Jonathon-Reilly/Kicad/README.md

# Basic Kicad Electronis Development Folder

This git repository contains a collection of information, tools and part librarys for setting up a basic PCB development envoirment
 using the open source EDA KiCad.

It includes content of official repositorys, personal creations as well as third party librarys.

My Content is licenced under the GPL V3.

All included or imported content is subject to its resprective licencing.
