Jonathon-Reilly/Kicad/kicad-resources/kicad-librarys/README.md

# Kicad-Librarys
**************

This Folder contains all library subfolders for symbols,footprints and 3D modells both user created and official kicad repository.

Official repository folders are name kicad-* and are added in via git submodule.

User created libray folders  are simply named for the resprective content (symbols,footprint,3D,templates).

Library folders of third partys are preceeded by the third partys name.
