Jonathon-Reilly/Kicad/kicad-resources/kicad-tools/eagle-to-kicad/examples/OLINUXINO/A10-A20-OLINUXINO-MICRO-4GB_Rev_D/kicad_files/report.txt

Info: Reading netlist file "/home/laudas/eagle/eagle-lbr2kicad/examples/OLINUXINO/A10-A20-OLINUXINO-MICRO-4GB_Rev_D/kicad_files/A10-A20-OLINUXINO-MICRO-4GB_Rev_D.net".

Info: Using references to match components and footprints.

* Warning: component 'VP_52': board footprint 'VPAC4', netlist footprint 'VPAD_VPAC4'

* Warning: component 'VP_53': board footprint 'VPAC3', netlist footprint 'VPAD_VPAC3'

* Warning: component 'VP_51': board footprint 'VPAC3', netlist footprint 'VPAD_VPAC3'

* Warning: component 'VP_50': board footprint 'VPAC3', netlist footprint 'VPAD_VPAC3'

* Warning: component 'VP_43': board footprint 'VPAC2', netlist footprint 'VPAD_VPAC2'

* Warning: component 'VP_8': board footprint 'VPAC1', netlist footprint 'VPAD_VPAC1'

* Warning: component 'VP_35': board footprint 'VPAC1', netlist footprint 'VPAD_VPAC1'

* Warning: component 'VP_17': board footprint 'VPAC1', netlist footprint 'VPAD_VPAC1'

* Warning: component 'VP_26': board footprint 'VPAC1', netlist footprint 'VPAD_VPAC1'

* Warning: component 'VP_29': board footprint 'VPAC0', netlist footprint 'VPAD_VPAC0'

* Warning: component 'VP_22': board footprint 'VPAC0', netlist footprint 'VPAD_VPAC0'

* Warning: component 'VP_23': board footprint 'VPAC0', netlist footprint 'VPAD_VPAC0'

* Warning: component 'VP_24': board footprint 'VPAC0', netlist footprint 'VPAD_VPAC0'

* Warning: component 'VP_25': board footprint 'VPAC0', netlist footprint 'VPAD_VPAC0'

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

* Warning: component 'FET2': board footprint 'SOT23', netlist footprint 'PENKO_SOT23'

* Warning: component 'FET3': board footprint 'SOT23', netlist footprint 'PENKO_SOT23'

* Warning: component 'FET4': board footprint 'SOT23', netlist footprint 'PENKO_SOT23'

* Warning: component 'UART0': board footprint 'HN1X4', netlist footprint 'PENKO_HN1X4'

* Warning: component '5V_PWR233': board footprint 'DW02S', netlist footprint 'PENKO_DW02S'

* Warning: component '5V_SATA_PWR233': board footprint 'DW02S', netlist footprint 'PENKO_DW02S'

* Warning: component 'LIPO_BAT233': board footprint 'DW02R', netlist footprint 'PENKO_DW02R'

* Warning: component 'U8': board footprint 'TSOP48', netlist footprint 'OLIMEX_IC_TSOP48'

* Warning: component 'U1': board footprint 'TFBGA441', netlist footprint 'OLIMEX_IC_TFBGA441'

* Warning: component 'U16': board footprint 'SOT23-6', netlist footprint 'OLIMEX_IC_SOT23-6'

* Warning: component 'U15': board footprint 'SOT23-5', netlist footprint 'OLIMEX_IC_SOT23-5'

* Warning: component 'U13': board footprint 'SOT23-5', netlist footprint 'OLIMEX_IC_SOT23-5'

* Warning: component 'U11': board footprint 'SOT23-5', netlist footprint 'OLIMEX_IC_SOT23-5'

* Warning: component 'U10': board footprint 'SOT23-5', netlist footprint 'OLIMEX_IC_SOT23-5'

* Warning: component 'U9': board footprint 'SOT23-5', netlist footprint 'OLIMEX_IC_SOT23-5'

* Warning: component 'U14': board footprint 'SOIC8', netlist footprint 'OLIMEX_IC_SOIC8'

* Warning: component 'U22': board footprint 'SLP2510P8', netlist footprint 'OLIMEX_IC_SLP2510P8'

* Warning: component 'U17': board footprint 'SLP2510P8', netlist footprint 'OLIMEX_IC_SLP2510P8'

* Warning: component 'U23': board footprint 'SLP2510P8', netlist footprint 'OLIMEX_IC_SLP2510P8'

* Warning: component 'U12': board footprint 'QFN48', netlist footprint 'OLIMEX_IC_QFN48'

* Warning: component 'U7': board footprint 'LQFP48', netlist footprint 'OLIMEX_IC_LQFP48'

* Warning: component 'U3': board footprint 'FBGA96_MEM', netlist footprint 'OLIMEX_IC_FBGA96_MEM'

* Warning: component 'U2': board footprint 'FBGA96_MEM', netlist footprint 'OLIMEX_IC_FBGA96_MEM'

* Warning: component 'VR1': board footprint 'SOT-23-5', netlist footprint 'OLIMEX_DISCRET_SOT-23-5'

* Warning: component 'RM4': board footprint 'R_MATRIX_4_0402_25X625', netlist footprint 'OLIMEX_DISCRET_R_MATRIX_4_0402_25X625'

* Warning: component 'RM5': board footprint 'R_MATRIX_4_0402_25X625', netlist footprint 'OLIMEX_DISCRET_R_MATRIX_4_0402_25X625'

* Warning: component 'RM6': board footprint 'R_MATRIX_4_0402_25X625', netlist footprint 'OLIMEX_DISCRET_R_MATRIX_4_0402_25X625'

* Warning: component 'RM7': board footprint 'R_MATRIX_4_0402_25X625', netlist footprint 'OLIMEX_DISCRET_R_MATRIX_4_0402_25X625'

* Warning: component 'RM8': board footprint 'R_MATRIX_4_0402_25X625', netlist footprint 'OLIMEX_DISCRET_R_MATRIX_4_0402_25X625'

* Warning: component 'RM19': board footprint 'R_MATRIX_4_0402_25X625', netlist footprint 'OLIMEX_DISCRET_R_MATRIX_4_0402_25X625'

* Warning: component 'RM3': board footprint 'R_MATRIX_4_0402_25X625', netlist footprint 'OLIMEX_DISCRET_R_MATRIX_4_0402_25X625'

* Warning: component 'RM2': board footprint 'R_MATRIX_4_0402_25X625', netlist footprint 'OLIMEX_DISCRET_R_MATRIX_4_0402_25X625'

* Warning: component 'RM16': board footprint 'R_MATRIX_4_0402_25X625', netlist footprint 'OLIMEX_DISCRET_R_MATRIX_4_0402_25X625'

* Warning: component 'RM17': board footprint 'R_MATRIX_4_0402_25X625', netlist footprint 'OLIMEX_DISCRET_R_MATRIX_4_0402_25X625'

* Warning: component 'RM18': board footprint 'R_MATRIX_4_0402_25X625', netlist footprint 'OLIMEX_DISCRET_R_MATRIX_4_0402_25X625'

* Warning: component 'RM1': board footprint 'R_MATRIX_4_0402_25X625', netlist footprint 'OLIMEX_DISCRET_R_MATRIX_4_0402_25X625'

* Warning: component 'RM21': board footprint 'R_MATRIX_4_0402_25X625', netlist footprint 'OLIMEX_DISCRET_R_MATRIX_4_0402_25X625'

* Warning: component 'RM20': board footprint 'R_MATRIX_4_0402_25X625', netlist footprint 'OLIMEX_DISCRET_R_MATRIX_4_0402_25X625'

* Warning: component 'RM9': board footprint 'R_MATRIX_4', netlist footprint 'OLIMEX_DISCRET_R_MATRIX_4'

* Warning: component 'RM10': board footprint 'R_MATRIX_4', netlist footprint 'OLIMEX_DISCRET_R_MATRIX_4'

* Warning: component 'RM13': board footprint 'R_MATRIX_4', netlist footprint 'OLIMEX_DISCRET_R_MATRIX_4'

* Warning: component 'RM14': board footprint 'R_MATRIX_4', netlist footprint 'OLIMEX_DISCRET_R_MATRIX_4'

* Warning: component 'RM15': board footprint 'R_MATRIX_4', netlist footprint 'OLIMEX_DISCRET_R_MATRIX_4'

* Warning: component 'RM25': board footprint 'R_MATRIX_4', netlist footprint 'OLIMEX_DISCRET_R_MATRIX_4'

* Warning: component 'RM24': board footprint 'R_MATRIX_4', netlist footprint 'OLIMEX_DISCRET_R_MATRIX_4'

* Warning: component 'D5': board footprint 'DO214AA', netlist footprint 'OLIMEX_DISCRET_DO214AA'

* Warning: component 'L13': board footprint 'CD32', netlist footprint 'OLIMEX_DISCRET_CD32'

* Warning: component 'L21': board footprint 'CD32', netlist footprint 'OLIMEX_DISCRET_CD32'

* Warning: component 'L20': board footprint 'CD32', netlist footprint 'OLIMEX_DISCRET_CD32'

* Warning: component 'L18': board footprint 'CD32', netlist footprint 'OLIMEX_DISCRET_CD32'

* Warning: component 'L14': board footprint 'CD32', netlist footprint 'OLIMEX_DISCRET_CD32'

* Warning: component 'L12': board footprint 'CD32', netlist footprint 'OLIMEX_DISCRET_CD32'

* Warning: component 'L19': board footprint '8X8MM_3131', netlist footprint 'OLIMEX_DISCRET_8X8MM_3131'

* Warning: component 'R24': board footprint '0603_0R', netlist footprint 'OLIMEX_DISCRET_0603_0R'

* Warning: component 'R34': board footprint '0603_0R', netlist footprint 'OLIMEX_DISCRET_0603_0R'

* Warning: component 'R69': board footprint '0603_0R', netlist footprint 'OLIMEX_DISCRET_0603_0R'

* Warning: component 'R87': board footprint '0603_0R', netlist footprint 'OLIMEX_DISCRET_0603_0R'

* Warning: component 'USB_HOST233': board footprint 'USB_TWO_LEVEL', netlist footprint 'OLIMEX_CONNECTORS_USB_TWO_LEVEL'

* Warning: component 'USB_OTG233': board footprint 'USB_MINI_9PIN', netlist footprint 'OLIMEX_CONNECTORS_USB_MINI_9PIN'

* Warning: component 'SD/MMC1': board footprint 'TFC-WPAPR-08', netlist footprint 'OLIMEX_CONNECTORS_TFC-WPAPR-08'

* Warning: component 'SD/MMC2': board footprint 'SD_CARD', netlist footprint 'OLIMEX_CONNECTORS_SD_CARD'

* Warning: component 'SATA233': board footprint 'SATA-PWA-07', netlist footprint 'OLIMEX_CONNECTORS_SATA-PWA-07'

* Warning: component 'LAN233': board footprint 'RJLBC-060TC1_MILLING', netlist footprint 'OLIMEX_CONNECTORS_RJLBC-060TC1_MILLING'

* Warning: component 'HDMI233': board footprint 'HDMI-SWM-19', netlist footprint 'OLIMEX_CONNECTORS_HDMI-SWM-19'

* Warning: component 'NAND_E233': board footprint 'SJ_1_SMALLER_CLOSE_10MILS', netlist footprint 'JUMPER_SJ_1_SMALLER_CLOSE_10MILS'

* Warning: component '5V_E_SATA233': board footprint 'SJ_1_SMALLER', netlist footprint 'JUMPER_SJ_1_SMALLER'

* Warning: component 'VPS+233': board footprint 'SJ_1_SMALLER', netlist footprint 'JUMPER_SJ_1_SMALLER'

* Warning: component 'VPS-233': board footprint 'SJ_1_SMALLER', netlist footprint 'JUMPER_SJ_1_SMALLER'

* Warning: component '5V_E233': board footprint 'SJ_1_SMALLER', netlist footprint 'JUMPER_SJ_1_SMALLER'

* Warning: component 'MIC2': board footprint 'JP1', netlist footprint 'JUMPER_JP1'

* Warning: component 'GND_PIN233': board footprint 'TEST_PAD40%2f70%2fSQUARE', netlist footprint 'GOGO_TEST_PAD40_70_SQUARE'

* Warning: component 'GND233': board footprint 'TESTPAD_40-ROUND', netlist footprint 'GOGO_TESTPAD_40-ROUND'

* Warning: component '5VEXT233': board footprint 'TESTPAD_40-ROUND', netlist footprint 'GOGO_TESTPAD_40-ROUND'

* Warning: component 'IPSOUT233': board footprint 'TESTPAD_40-ROUND', netlist footprint 'GOGO_TESTPAD_40-ROUND'

* Warning: component '+5V233': board footprint 'TESTPAD_40-ROUND', netlist footprint 'GOGO_TESTPAD_40-ROUND'

* Warning: component '3.3V233': board footprint 'TESTPAD_40-ROUND', netlist footprint 'GOGO_TESTPAD_40-ROUND'

* Warning: component 'BAT233': board footprint 'TESTPAD_40-ROUND', netlist footprint 'GOGO_TESTPAD_40-ROUND'

* Warning: component '3.0VA233': board footprint 'TESTPAD_40-ROUND', netlist footprint 'GOGO_TESTPAD_40-ROUND'

* Warning: component '2.5V233': board footprint 'TESTPAD_40-ROUND', netlist footprint 'GOGO_TESTPAD_40-ROUND'

* Warning: component '1.5V233': board footprint 'TESTPAD_40-ROUND', netlist footprint 'GOGO_TESTPAD_40-ROUND'

* Warning: component '1.2V_INT233': board footprint 'TESTPAD_40-ROUND', netlist footprint 'GOGO_TESTPAD_40-ROUND'

* Warning: component '1.2V_CPU233': board footprint 'TESTPAD_40-ROUND', netlist footprint 'GOGO_TESTPAD_40-ROUND'

* Warning: component 'ODT1': board footprint 'TESTPAD_40-ROUND', netlist footprint 'GOGO_TESTPAD_40-ROUND'

* Warning: component 'SCKE1': board footprint 'TESTPAD_40-ROUND', netlist footprint 'GOGO_TESTPAD_40-ROUND'

* Warning: component 'ENTER233': board footprint 'SW_TAKT3X4', netlist footprint 'GOGO_SW_TAKT3X4'

* Warning: component 'MENU233': board footprint 'SW_TAKT3X4', netlist footprint 'GOGO_SW_TAKT3X4'

* Warning: component 'ESC233': board footprint 'SW_TAKT3X4', netlist footprint 'GOGO_SW_TAKT3X4'

* Warning: component 'PWR_BUT233': board footprint 'SW_TAKT3X4', netlist footprint 'GOGO_SW_TAKT3X4'

* Warning: component 'VOL+233': board footprint 'SW_TAKT3X4', netlist footprint 'GOGO_SW_TAKT3X4'

* Warning: component 'HOME233': board footprint 'SW_TAKT3X4', netlist footprint 'GOGO_SW_TAKT3X4'

* Warning: component 'VOL-233': board footprint 'SW_TAKT3X4', netlist footprint 'GOGO_SW_TAKT3X4'

* Warning: component 'SEARCH233': board footprint 'SW_TAKT3X4', netlist footprint 'GOGO_SW_TAKT3X4'

* Warning: component 'RESET233': board footprint 'SW_TAKT3X4', netlist footprint 'GOGO_SW_TAKT3X4'

* Warning: component 'RECOVERY233': board footprint 'SW_TAKT3X4', netlist footprint 'GOGO_SW_TAKT3X4'

* Warning: component 'D3': board footprint 'SOD-123', netlist footprint 'GOGO_SOD-123'

* Warning: component 'D1': board footprint 'SOD-123', netlist footprint 'GOGO_SOD-123'

* Warning: component 'U6': board footprint 'SO-08MN', netlist footprint 'GOGO_SO-08MN'

* Warning: component 'PWR233': board footprint 'PWR_JACK_UNI_MILLING', netlist footprint 'GOGO_PWR_JACK_UNI_MILLING'

* Warning: component 'HEADPHONES233': board footprint 'PJ-W47S-05D2-LF_5PIN_V2', netlist footprint 'GOGO_PJ-W47S-05D2-LF_5PIN_V2'

* Warning: component 'MIC_IN233': board footprint 'PJ-W47S-05D2-LF_5PIN_V2', netlist footprint 'GOGO_PJ-W47S-05D2-LF_5PIN_V2'

* Warning: component 'D4': board footprint 'MLL-41', netlist footprint 'GOGO_MLL-41'

* Warning: component 'FUSE1': board footprint '1206', netlist footprint 'GOGO_1206'

* Warning: component 'CHGLED233': board footprint 'LED-0603', netlist footprint 'DOUBLE-SIDE_LED-0603'

* Warning: component 'PWR_LED233': board footprint 'LED-0603', netlist footprint 'DOUBLE-SIDE_LED-0603'

* Warning: component 'LED1': board footprint 'LED-0603', netlist footprint 'DOUBLE-SIDE_LED-0603'

* Warning: component 'VGA233': board footprint 'CON1.27MM-6-SMALL_ICSP', netlist footprint 'DOUBLE-SIDE_CON1.27MM-6-SMALL_ICSP'

* Warning: component 'Q2': board footprint 'TC26H_3_REPAIR_SMD', netlist footprint 'CRYSTAL_TC26H_3_REPAIR_SMD'

* Warning: component 'Q3': board footprint 'HCX-4S', netlist footprint 'CRYSTAL_HCX-4S'

* Warning: component 'Q1': board footprint 'HCX-4S', netlist footprint 'CRYSTAL_HCX-4S'

* Warning: component 'LCD_CON233': board footprint 'ML40-MALE(GBH-254-SMT-40)', netlist footprint 'CON-HARTING-ML_ML40-MALE(GBH-254-SMT-40)'

* Warning: component 'GPIO-1': board footprint 'ML40-MALE(GBH-254-SMT-40)', netlist footprint 'CON-HARTING-ML_ML40-MALE(GBH-254-SMT-40)'

* Warning: component 'GPIO-2': board footprint 'ML40-MALE(GBH-254-SMT-40)', netlist footprint 'CON-HARTING-ML_ML40-MALE(GBH-254-SMT-40)'

* Warning: component 'GPIO-3': board footprint 'ML40-MALE(GBH-254-SMT-40)', netlist footprint 'CON-HARTING-ML_ML40-MALE(GBH-254-SMT-40)'

* Warning: component 'UEXT2': board footprint 'ML10_S', netlist footprint 'CON-HARTING-ML_ML10_S'

* Warning: component 'UEXT1': board footprint 'ML10_S', netlist footprint 'CON-HARTING-ML_ML10_S'

Info: Checking netlist component footprint "+5V233:/55DE2AE3:GOGO_TESTPAD_40-ROUND".

Info: Changing component path "+5V233:" to "/55DE2AE3".

Changing component "+5V233:/55DE2AE3" pin "1" net name from "+5V" to "/+5V".

Info: Checking netlist component footprint "1.2V_CPU233:/55DE2BAB:GOGO_TESTPAD_40-ROUND".

Info: Changing component path "1.2V_CPU233:" to "/55DE2BAB".

Changing component "1.2V_CPU233:/55DE2BAB" pin "1" net name from "VCC/2" to "/VCC/2".

Info: Checking netlist component footprint "1.2V_INT233:/55DE2C73:GOGO_TESTPAD_40-ROUND".

Info: Changing component path "1.2V_INT233:" to "/55DE2C73".

Changing component "1.2V_INT233:/55DE2C73" pin "1" net name from "VCCINT" to "/VCCINT".

Info: Checking netlist component footprint "1.5V233:/55DE2D3B:GOGO_TESTPAD_40-ROUND".

Info: Changing component path "1.5V233:" to "/55DE2D3B".

Changing component "1.5V233:/55DE2D3B" pin "1" net name from "V+" to "/V+".

Info: Checking netlist component footprint "2.5V233:/55DE2F93:GOGO_TESTPAD_40-ROUND".

Info: Changing component path "2.5V233:" to "/55DE2F93".

Changing component "2.5V233:/55DE2F93" pin "1" net name from "VDD" to "/VDD".

Info: Checking netlist component footprint "3.0VA233:/55DE305B:GOGO_TESTPAD_40-ROUND".

Info: Changing component path "3.0VA233:" to "/55DE305B".

Changing component "3.0VA233:/55DE305B" pin "1" net name from "VPP" to "/VPP".

Info: Checking netlist component footprint "3.3V233:/55DE3123:GOGO_TESTPAD_40-ROUND".

Info: Changing component path "3.3V233:" to "/55DE3123".

Changing component "3.3V233:/55DE3123" pin "1" net name from "VCC" to "/VCC".

Info: Checking netlist component footprint "5VEXT233:/55DE31EB:GOGO_TESTPAD_40-ROUND".

Info: Changing component path "5VEXT233:" to "/55DE31EB".

Changing component "5VEXT233:/55DE31EB" pin "1" net name from "+15V" to "/+15V".

Info: Checking netlist component footprint "5V_E233:/55DE32B3:JUMPER_SJ_1_SMALLER".

Info: Changing component path "5V_E233:" to "/55DE32B3".

Changing component "5V_E233:/55DE32B3" pin "1" net name from "+15V" to "/+15V".

Changing component "5V_E233:/55DE32B3" pin "2" net name from "+5V" to "/+5V".

Info: Checking netlist component footprint "5V_E_SATA233:/55DE337B:JUMPER_SJ_1_SMALLER".

Changing component "5V_E_SATA233:" value from "" to "~".

Info: Changing component path "5V_E_SATA233:" to "/55DE337B".

Changing component "5V_E_SATA233:/55DE337B" pin "1" net name from "+5V" to "/+5V".

Changing component "5V_E_SATA233:/55DE337B" pin "2" net name from "N$24" to "/N$24".

Info: Checking netlist component footprint "5V_PWR233:/55DE3443:PENKO_DW02S".

Info: Changing component path "5V_PWR233:" to "/55DE3443".

Changing component "5V_PWR233:/55DE3443" pin "1" net name from "+5V" to "/+5V".

Changing component "5V_PWR233:/55DE3443" pin "2" net name from "GND" to "/GND".

Info: Checking netlist component footprint "5V_SATA_PWR233:/55DE350B:PENKO_DW02S".

Info: Changing component path "5V_SATA_PWR233:" to "/55DE350B".

Changing component "5V_SATA_PWR233:/55DE350B" pin "1" net name from "N$24" to "/N$24".

Changing component "5V_SATA_PWR233:/55DE350B" pin "2" net name from "GND" to "/GND".

Info: Checking netlist component footprint "BAT233:/55DE35D3:GOGO_TESTPAD_40-ROUND".

Info: Changing component path "BAT233:" to "/55DE35D3".

Changing component "BAT233:/55DE35D3" pin "1" net name from "+24V" to "/+24V".

Info: Checking netlist component footprint "C1:/55DE369B:RCL_C0603_DWS".

Info: Changing component path "C1:" to "/55DE369B".

Changing component "C1:/55DE369B" pin "1" net name from "V+" to "/V+".

Changing component "C1:/55DE369B" pin "2" net name from "CPU-REF" to "/CPU-REF".

Info: Checking netlist component footprint "C2:/55DE3763:RCL_C0402_TI".

Info: Changing component path "C2:" to "/55DE3763".

Changing component "C2:/55DE3763" pin "1" net name from "GND" to "/GND".

Changing component "C2:/55DE3763" pin "2" net name from "V+" to "/V+".

Info: Checking netlist component footprint "C3:/55DE382B:RCL_C0402_TI".

Info: Changing component path "C3:" to "/55DE382B".

Changing component "C3:/55DE382B" pin "1" net name from "GND" to "/GND".

Changing component "C3:/55DE382B" pin "2" net name from "V+" to "/V+".

Info: Checking netlist component footprint "C4:/55DE38F3:RCL_C0603_DWS".

Info: Changing component path "C4:" to "/55DE38F3".

Changing component "C4:/55DE38F3" pin "1" net name from "GND" to "/GND".

Changing component "C4:/55DE38F3" pin "2" net name from "V+" to "/V+".

Info: Checking netlist component footprint "C5:/55DE39BB:RCL_C0402_TI".

Info: Changing component path "C5:" to "/55DE39BB".

Changing component "C5:/55DE39BB" pin "1" net name from "GND" to "/GND".

Changing component "C5:/55DE39BB" pin "2" net name from "V+" to "/V+".

Info: Checking netlist component footprint "C6:/55DE3A83:RCL_C0603_DWS".

Info: Changing component path "C6:" to "/55DE3A83".

Changing component "C6:/55DE3A83" pin "1" net name from "GND" to "/GND".

Changing component "C6:/55DE3A83" pin "2" net name from "V+" to "/V+".

Info: Checking netlist component footprint "C7:/55DE3B4B:RCL_C0402_TI".

Info: Changing component path "C7:" to "/55DE3B4B".

Changing component "C7:/55DE3B4B" pin "1" net name from "GND" to "/GND".

Changing component "C7:/55DE3B4B" pin "2" net name from "V+" to "/V+".

Info: Checking netlist component footprint "C8:/55DE3C13:RCL_C0603_DWS".

Info: Changing component path "C8:" to "/55DE3C13".

Changing component "C8:/55DE3C13" pin "1" net name from "GND" to "/GND".

Changing component "C8:/55DE3C13" pin "2" net name from "V+" to "/V+".

Info: Checking netlist component footprint "C9:/55DE3CDB:RCL_C0603_DWS".

Info: Changing component path "C9:" to "/55DE3CDB".

Changing component "C9:/55DE3CDB" pin "1" net name from "GND" to "/GND".

Changing component "C9:/55DE3CDB" pin "2" net name from "V+" to "/V+".

Info: Checking netlist component footprint "C10:/55DE3DA3:RCL_C0402_TI".

Info: Changing component path "C10:" to "/55DE3DA3".

Changing component "C10:/55DE3DA3" pin "1" net name from "GND" to "/GND".

Changing component "C10:/55DE3DA3" pin "2" net name from "V+" to "/V+".

Info: Checking netlist component footprint "C11:/55DE3E6B:RCL_C0402_TI".

Info: Changing component path "C11:" to "/55DE3E6B".

Changing component "C11:/55DE3E6B" pin "1" net name from "GND" to "/GND".

Changing component "C11:/55DE3E6B" pin "2" net name from "V+" to "/V+".

Info: Checking netlist component footprint "C12:/55DE3F33:RCL_C0603_DWS".

Info: Changing component path "C12:" to "/55DE3F33".

Changing component "C12:/55DE3F33" pin "1" net name from "GND" to "/GND".

Changing component "C12:/55DE3F33" pin "2" net name from "CPU-REF" to "/CPU-REF".

Info: Checking netlist component footprint "C13:/55DE3FFB:RCL_C0603_DWS".

Info: Changing component path "C13:" to "/55DE3FFB".

Changing component "C13:/55DE3FFB" pin "1" net name from "GND" to "/GND".

Changing component "C13:/55DE3FFB" pin "2" net name from "N$197" to "/N$197".

Info: Checking netlist component footprint "C14:/55DE40C3:RCL_C0402_TI".

Info: Changing component path "C14:" to "/55DE40C3".

Changing component "C14:/55DE40C3" pin "1" net name from "GND" to "/GND".

Changing component "C14:/55DE40C3" pin "2" net name from "N$197" to "/N$197".

Info: Checking netlist component footprint "C15:/55DE418B:RCL_C0402_TI".

Info: Changing component path "C15:" to "/55DE418B".

Changing component "C15:/55DE418B" pin "1" net name from "GND" to "/GND".

Changing component "C15:/55DE418B" pin "2" net name from "N$197" to "/N$197".

Info: Checking netlist component footprint "C16:/55DE4253:RCL_C0603_DWS".

Info: Changing component path "C16:" to "/55DE4253".

Changing component "C16:/55DE4253" pin "1" net name from "GND" to "/GND".

Changing component "C16:/55DE4253" pin "2" net name from "N$197" to "/N$197".

Info: Checking netlist component footprint "C17:/55DE431B:RCL_C0603_DWS".

Info: Changing component path "C17:" to "/55DE431B".

Changing component "C17:/55DE431B" pin "1" net name from "V+" to "/V+".

Changing component "C17:/55DE431B" pin "2" net name from "DDR_VREF" to "/DDR_VREF".

Info: Checking netlist component footprint "C18:/55DE43E3:RCL_C0402_TI".

Info: Changing component path "C18:" to "/55DE43E3".

Changing component "C18:/55DE43E3" pin "1" net name from "GND" to "/GND".

Changing component "C18:/55DE43E3" pin "2" net name from "VCCINT" to "/VCCINT".

Info: Checking netlist component footprint "C19:/55DE44AB:RCL_C0402_TI".

Info: Changing component path "C19:" to "/55DE44AB".

Changing component "C19:/55DE44AB" pin "1" net name from "GND" to "/GND".

Changing component "C19:/55DE44AB" pin "2" net name from "VCCINT" to "/VCCINT".

Info: Checking netlist component footprint "C20:/55DE4573:RCL_C0603_DWS".

Info: Changing component path "C20:" to "/55DE4573".

Changing component "C20:/55DE4573" pin "1" net name from "GND" to "/GND".

Changing component "C20:/55DE4573" pin "2" net name from "VCCINT" to "/VCCINT".

Info: Checking netlist component footprint "C21:/55DE463B:RCL_C0402_TI".

Info: Changing component path "C21:" to "/55DE463B".

Changing component "C21:/55DE463B" pin "1" net name from "GND" to "/GND".

Changing component "C21:/55DE463B" pin "2" net name from "VCCINT" to "/VCCINT".

Info: Checking netlist component footprint "C22:/55DE4703:RCL_C0402_TI".

Info: Changing component path "C22:" to "/55DE4703".

Changing component "C22:/55DE4703" pin "1" net name from "GND" to "/GND".

Changing component "C22:/55DE4703" pin "2" net name from "VCCINT" to "/VCCINT".

Info: Checking netlist component footprint "C23:/55DE47CB:RCL_C0402_TI".

Info: Changing component path "C23:" to "/55DE47CB".

Changing component "C23:/55DE47CB" pin "1" net name from "GND" to "/GND".

Changing component "C23:/55DE47CB" pin "2" net name from "VCCINT" to "/VCCINT".

Info: Checking netlist component footprint "C24:/55DE4893:RCL_C0402_TI".

Info: Changing component path "C24:" to "/55DE4893".

Changing component "C24:/55DE4893" pin "1" net name from "GND" to "/GND".

Changing component "C24:/55DE4893" pin "2" net name from "VCCINT" to "/VCCINT".

Info: Checking netlist component footprint "C25:/55DE495B:RCL_C0402_TI".

Info: Changing component path "C25:" to "/55DE495B".

Changing component "C25:/55DE495B" pin "1" net name from "GND" to "/GND".

Changing component "C25:/55DE495B" pin "2" net name from "VCCINT" to "/VCCINT".

Info: Checking netlist component footprint "C26:/55DE4A23:RCL_C0402_TI".

Info: Changing component path "C26:" to "/55DE4A23".

Changing component "C26:/55DE4A23" pin "1" net name from "GND" to "/GND".

Changing component "C26:/55DE4A23" pin "2" net name from "VCCINT" to "/VCCINT".

Info: Checking netlist component footprint "C27:/55DE4AEB:RCL_C0402_TI".

Info: Changing component path "C27:" to "/55DE4AEB".

Changing component "C27:/55DE4AEB" pin "1" net name from "GND" to "/GND".

Changing component "C27:/55DE4AEB" pin "2" net name from "VCCINT" to "/VCCINT".

Info: Checking netlist component footprint "C28:/55DE4BB3:RCL_C0603_DWS".

Info: Changing component path "C28:" to "/55DE4BB3".

Changing component "C28:/55DE4BB3" pin "1" net name from "GND" to "/GND".

Changing component "C28:/55DE4BB3" pin "2" net name from "V+" to "/V+".

Info: Checking netlist component footprint "C29:/55DE4C7B:RCL_C0603_DWS".

Info: Changing component path "C29:" to "/55DE4C7B".

Changing component "C29:/55DE4C7B" pin "1" net name from "GND" to "/GND".

Changing component "C29:/55DE4C7B" pin "2" net name from "V+" to "/V+".

Info: Checking netlist component footprint "C30:/55DE4D43:RCL_C0603_DWS".

Info: Changing component path "C30:" to "/55DE4D43".

Changing component "C30:/55DE4D43" pin "1" net name from "GND" to "/GND".

Changing component "C30:/55DE4D43" pin "2" net name from "V+" to "/V+".

Info: Checking netlist component footprint "C31:/55DE4E0B:RCL_C0603_DWS".

Info: Changing component path "C31:" to "/55DE4E0B".

Changing component "C31:/55DE4E0B" pin "1" net name from "GND" to "/GND".

Changing component "C31:/55DE4E0B" pin "2" net name from "V+" to "/V+".

Info: Checking netlist component footprint "C32:/55DE4ED3:RCL_C0603_DWS".

Info: Changing component path "C32:" to "/55DE4ED3".

Changing component "C32:/55DE4ED3" pin "1" net name from "GND" to "/GND".

Changing component "C32:/55DE4ED3" pin "2" net name from "V+" to "/V+".

Info: Checking netlist component footprint "C33:/55DE4F9B:RCL_C0603_DWS".

Info: Changing component path "C33:" to "/55DE4F9B".

Changing component "C33:/55DE4F9B" pin "1" net name from "GND" to "/GND".

Changing component "C33:/55DE4F9B" pin "2" net name from "V+" to "/V+".

Info: Checking netlist component footprint "C34:/55DE5063:RCL_C0603_DWS".

Info: Changing component path "C34:" to "/55DE5063".

Changing component "C34:/55DE5063" pin "1" net name from "GND" to "/GND".

Changing component "C34:/55DE5063" pin "2" net name from "V+" to "/V+".

Info: Checking netlist component footprint "C35:/55DE512B:RCL_C0603_DWS".

Info: Changing component path "C35:" to "/55DE512B".

Changing component "C35:/55DE512B" pin "1" net name from "GND" to "/GND".

Changing component "C35:/55DE512B" pin "2" net name from "DDR_VREF" to "/DDR_VREF".

Info: Checking netlist component footprint "C36:/55DE51F3:RCL_C0603_DWS".

Info: Changing component path "C36:" to "/55DE51F3".

Changing component "C36:/55DE51F3" pin "1" net name from "GND" to "/GND".

Changing component "C36:/55DE51F3" pin "2" net name from "V+" to "/V+".

Info: Checking netlist component footprint "C37:/55DE52BB:RCL_C0603_DWS".

Info: Changing component path "C37:" to "/55DE52BB".

Changing component "C37:/55DE52BB" pin "1" net name from "GND" to "/GND".

Changing component "C37:/55DE52BB" pin "2" net name from "V+" to "/V+".

Info: Checking netlist component footprint "C38:/55DE5383:RCL_C0603_DWS".

Info: Changing component path "C38:" to "/55DE5383".

Changing component "C38:/55DE5383" pin "1" net name from "GND" to "/GND".

Changing component "C38:/55DE5383" pin "2" net name from "V+" to "/V+".

Info: Checking netlist component footprint "C39:/55DE544B:RCL_C0603_DWS".

Info: Changing component path "C39:" to "/55DE544B".

Changing component "C39:/55DE544B" pin "1" net name from "GND" to "/GND".

Changing component "C39:/55DE544B" pin "2" net name from "V+" to "/V+".

Info: Checking netlist component footprint "C40:/55DE5513:RCL_C0603_DWS".

Info: Changing component path "C40:" to "/55DE5513".

Changing component "C40:/55DE5513" pin "1" net name from "GND" to "/GND".

Changing component "C40:/55DE5513" pin "2" net name from "V+" to "/V+".

Info: Checking netlist component footprint "C41:/55DE55DB:RCL_C0603_DWS".

Info: Changing component path "C41:" to "/55DE55DB".

Changing component "C41:/55DE55DB" pin "1" net name from "GND" to "/GND".

Changing component "C41:/55DE55DB" pin "2" net name from "V+" to "/V+".

Info: Checking netlist component footprint "C42:/55DE56A3:RCL_C0603_DWS".

Info: Changing component path "C42:" to "/55DE56A3".

Changing component "C42:/55DE56A3" pin "1" net name from "GND" to "/GND".

Changing component "C42:/55DE56A3" pin "2" net name from "V+" to "/V+".

Info: Checking netlist component footprint "C43:/55DE576B:RCL_C0603_DWS".

Info: Changing component path "C43:" to "/55DE576B".

Changing component "C43:/55DE576B" pin "1" net name from "GND" to "/GND".

Changing component "C43:/55DE576B" pin "2" net name from "V+" to "/V+".

Info: Checking netlist component footprint "C44:/55DE5833:RCL_C0603_DWS".

Info: Changing component path "C44:" to "/55DE5833".

Changing component "C44:/55DE5833" pin "1" net name from "GND" to "/GND".

Changing component "C44:/55DE5833" pin "2" net name from "V+" to "/V+".

Info: Checking netlist component footprint "C45:/55DE58FB:RCL_C0603_DWS".

Info: Changing component path "C45:" to "/55DE58FB".

Changing component "C45:/55DE58FB" pin "1" net name from "GND" to "/GND".

Changing component "C45:/55DE58FB" pin "2" net name from "V+" to "/V+".

Info: Checking netlist component footprint "C46:/55DE59C3:RCL_C0603_DWS".

Info: Changing component path "C46:" to "/55DE59C3".

Changing component "C46:/55DE59C3" pin "1" net name from "GND" to "/GND".

Changing component "C46:/55DE59C3" pin "2" net name from "V+" to "/V+".

Info: Checking netlist component footprint "C47:/55DE5A8B:RCL_C0603_DWS".

Info: Changing component path "C47:" to "/55DE5A8B".

Changing component "C47:/55DE5A8B" pin "1" net name from "GND" to "/GND".

Changing component "C47:/55DE5A8B" pin "2" net name from "V+" to "/V+".

Info: Checking netlist component footprint "C48:/55DE5B53:RCL_C0603_DWS".

Info: Changing component path "C48:" to "/55DE5B53".

Changing component "C48:/55DE5B53" pin "1" net name from "GND" to "/GND".

Changing component "C48:/55DE5B53" pin "2" net name from "V+" to "/V+".

Info: Checking netlist component footprint "C49:/55DE5C1B:RCL_C0603_DWS".

Info: Changing component path "C49:" to "/55DE5C1B".

Changing component "C49:/55DE5C1B" pin "1" net name from "GND" to "/GND".

Changing component "C49:/55DE5C1B" pin "2" net name from "V+" to "/V+".

Info: Checking netlist component footprint "C50:/55DE5CE3:RCL_C0603_DWS".

Info: Changing component path "C50:" to "/55DE5CE3".

Changing component "C50:/55DE5CE3" pin "1" net name from "GND" to "/GND".

Changing component "C50:/55DE5CE3" pin "2" net name from "V+" to "/V+".

Info: Checking netlist component footprint "C51:/55DE5DAB:RCL_C0603_DWS".

Info: Changing component path "C51:" to "/55DE5DAB".

Changing component "C51:/55DE5DAB" pin "1" net name from "GND" to "/GND".

Changing component "C51:/55DE5DAB" pin "2" net name from "V+" to "/V+".

Info: Checking netlist component footprint "C52:/55DE5E73:RCL_C0603_DWS".

Info: Changing component path "C52:" to "/55DE5E73".

Changing component "C52:/55DE5E73" pin "1" net name from "GND" to "/GND".

Changing component "C52:/55DE5E73" pin "2" net name from "V+" to "/V+".

Info: Checking netlist component footprint "C53:/55DE5F3B:RCL_C0603_DWS".

Info: Changing component path "C53:" to "/55DE5F3B".

Changing component "C53:/55DE5F3B" pin "1" net name from "GND" to "/GND".

Changing component "C53:/55DE5F3B" pin "2" net name from "V+" to "/V+".

Info: Checking netlist component footprint "C54:/55DE6003:RCL_C0603_DWS".

Info: Changing component path "C54:" to "/55DE6003".

Changing component "C54:/55DE6003" pin "1" net name from "GND" to "/GND".

Changing component "C54:/55DE6003" pin "2" net name from "V+" to "/V+".

Info: Checking netlist component footprint "C55:/55DE60CB:RCL_C0603_DWS".

Info: Changing component path "C55:" to "/55DE60CB".

Changing component "C55:/55DE60CB" pin "1" net name from "GND" to "/GND".

Changing component "C55:/55DE60CB" pin "2" net name from "V+" to "/V+".

Info: Checking netlist component footprint "C56:/55DE6193:RCL_C0603_DWS".

Info: Changing component path "C56:" to "/55DE6193".

Changing component "C56:/55DE6193" pin "1" net name from "GND" to "/GND".

Changing component "C56:/55DE6193" pin "2" net name from "SD_VCC1" to "/SD_VCC1".

Info: Checking netlist component footprint "C57:/55DE625B:RCL_C0402_TI".

Info: Changing component path "C57:" to "/55DE625B".

Changing component "C57:/55DE625B" pin "1" net name from "GND" to "/GND".

Changing component "C57:/55DE625B" pin "2" net name from "VCC/2" to "/VCC/2".

Info: Checking netlist component footprint "C58:/55DE6323:RCL_C0603_DWS".

Info: Changing component path "C58:" to "/55DE6323".

Changing component "C58:/55DE6323" pin "1" net name from "GND" to "/GND".

Changing component "C58:/55DE6323" pin "2" net name from "VCC/2" to "/VCC/2".

Info: Checking netlist component footprint "C59:/55DE63EB:RCL_C0402_TI".

Info: Changing component path "C59:" to "/55DE63EB".

Changing component "C59:/55DE63EB" pin "1" net name from "GND" to "/GND".

Changing component "C59:/55DE63EB" pin "2" net name from "VCC/2" to "/VCC/2".

Info: Checking netlist component footprint "C60:/55DE64B3:RCL_C0402_TI".

Info: Changing component path "C60:" to "/55DE64B3".

Changing component "C60:/55DE64B3" pin "1" net name from "GND" to "/GND".

Changing component "C60:/55DE64B3" pin "2" net name from "VCC/2" to "/VCC/2".

Info: Checking netlist component footprint "C61:/55DE657B:RCL_C0402_TI".

Info: Changing component path "C61:" to "/55DE657B".

Changing component "C61:/55DE657B" pin "1" net name from "GND" to "/GND".

Changing component "C61:/55DE657B" pin "2" net name from "VCC/2" to "/VCC/2".

Info: Checking netlist component footprint "C62:/55DE6643:RCL_C0402_TI".

Info: Changing component path "C62:" to "/55DE6643".

Changing component "C62:/55DE6643" pin "1" net name from "GND" to "/GND".

Changing component "C62:/55DE6643" pin "2" net name from "VCC/2" to "/VCC/2".

Info: Checking netlist component footprint "C63:/55DE670B:RCL_C0603_DWS".

Info: Changing component path "C63:" to "/55DE670B".

Changing component "C63:/55DE670B" pin "1" net name from "GND" to "/GND".

Changing component "C63:/55DE670B" pin "2" net name from "N$21" to "/N$21".

Info: Checking netlist component footprint "C64:/55DE67D3:RCL_C0603_DWS".

Info: Changing component path "C64:" to "/55DE67D3".

Changing component "C64:/55DE67D3" pin "1" net name from "GND" to "/GND".

Changing component "C64:/55DE67D3" pin "2" net name from "N$21" to "/N$21".

Info: Checking netlist component footprint "C65:/55DE689B:RCL_C0603_DWS".

Info: Changing component path "C65:" to "/55DE689B".

Changing component "C65:/55DE689B" pin "1" net name from "GND" to "/GND".

Changing component "C65:/55DE689B" pin "2" net name from "N$67" to "/N$67".

Info: Checking netlist component footprint "C66:/55DE6963:RCL_C0603_DWS".

Info: Changing component path "C66:" to "/55DE6963".

Changing component "C66:/55DE6963" pin "1" net name from "GND" to "/GND".

Changing component "C66:/55DE6963" pin "2" net name from "N$67" to "/N$67".

Info: Checking netlist component footprint "C67:/55DE6A2B:RCL_C0603_DWS".

Info: Changing component path "C67:" to "/55DE6A2B".

Changing component "C67:/55DE6A2B" pin "1" net name from "GND" to "/GND".

Changing component "C67:/55DE6A2B" pin "2" net name from "N$67" to "/N$67".

Info: Checking netlist component footprint "C68:/55DE6AF3:RCL_C0402_TI".

Info: Changing component path "C68:" to "/55DE6AF3".

Changing component "C68:/55DE6AF3" pin "1" net name from "GND" to "/GND".

Changing component "C68:/55DE6AF3" pin "2" net name from "VCC" to "/VCC".

Info: Checking netlist component footprint "C69:/55DE6BBB:RCL_C0402_TI".

Info: Changing component path "C69:" to "/55DE6BBB".

Changing component "C69:/55DE6BBB" pin "1" net name from "GND" to "/GND".

Changing component "C69:/55DE6BBB" pin "2" net name from "VCC" to "/VCC".

Info: Checking netlist component footprint "C70:/55DE6C83:RCL_C0402_TI".

Info: Changing component path "C70:" to "/55DE6C83".

Changing component "C70:/55DE6C83" pin "1" net name from "GND" to "/GND".

Changing component "C70:/55DE6C83" pin "2" net name from "VCC" to "/VCC".

Info: Checking netlist component footprint "C71:/55DE6D4B:RCL_C0603_DWS".

Info: Changing component path "C71:" to "/55DE6D4B".

Changing component "C71:/55DE6D4B" pin "1" net name from "GND" to "/GND".

Changing component "C71:/55DE6D4B" pin "2" net name from "CPU-REF" to "/CPU-REF".

Info: Checking netlist component footprint "C72:/55DE6E13:RCL_C0603_DWS".

Info: Changing component path "C72:" to "/55DE6E13".

Changing component "C72:/55DE6E13" pin "1" net name from "GND" to "/GND".

Changing component "C72:/55DE6E13" pin "2" net name from "XTALI1" to "/XTALI1".

Info: Checking netlist component footprint "C73:/55DE6EDB:RCL_C0603_DWS".

Info: Changing component path "C73:" to "/55DE6EDB".

Changing component "C73:/55DE6EDB" pin "1" net name from "GND" to "/GND".

Changing component "C73:/55DE6EDB" pin "2" net name from "XTALO1" to "/XTALO1".

Info: Checking netlist component footprint "C74:/55DE6FA3:RCL_C0603_DWS".

Info: Changing component path "C74:" to "/55DE6FA3".

Changing component "C74:/55DE6FA3" pin "1" net name from "N$55" to "/N$55".

Changing component "C74:/55DE6FA3" pin "2" net name from "GND" to "/GND".

Info: Checking netlist component footprint "C75:/55DE706B:RCL_C0603_DWS".

Info: Changing component path "C75:" to "/55DE706B".

Changing component "C75:/55DE706B" pin "1" net name from "N$56" to "/N$56".

Changing component "C75:/55DE706B" pin "2" net name from "GND" to "/GND".

Info: Checking netlist component footprint "C76:/55DE7133:RCL_C0603_DWS".

Info: Changing component path "C76:" to "/55DE7133".

Changing component "C76:/55DE7133" pin "1" net name from "N$56" to "/N$56".

Changing component "C76:/55DE7133" pin "2" net name from "GND" to "/GND".

Info: Checking netlist component footprint "C77:/55DE71FB:RCL_C0402_TI".

Info: Changing component path "C77:" to "/55DE71FB".

Changing component "C77:/55DE71FB" pin "1" net name from "GND" to "/GND".

Changing component "C77:/55DE71FB" pin "2" net name from "VCC" to "/VCC".

Info: Checking netlist component footprint "C78:/55DE72C3:RCL_C0402_TI".

Info: Changing component path "C78:" to "/55DE72C3".

Changing component "C78:/55DE72C3" pin "1" net name from "GND" to "/GND".

Changing component "C78:/55DE72C3" pin "2" net name from "VCC" to "/VCC".

Info: Checking netlist component footprint "C79:/55DE738B:RCL_C0402_TI".

Info: Changing component path "C79:" to "/55DE738B".

Changing component "C79:/55DE738B" pin "1" net name from "GND" to "/GND".

Changing component "C79:/55DE738B" pin "2" net name from "VCC" to "/VCC".

Info: Checking netlist component footprint "C80:/55DE7453:RCL_C0402_TI".

Info: Changing component path "C80:" to "/55DE7453".

Changing component "C80:/55DE7453" pin "1" net name from "GND" to "/GND".

Changing component "C80:/55DE7453" pin "2" net name from "VCC" to "/VCC".

Info: Checking netlist component footprint "C81:/55DE751B:RCL_C0603_DWS".

Info: Changing component path "C81:" to "/55DE751B".

Changing component "C81:/55DE751B" pin "1" net name from "GND" to "/GND".

Changing component "C81:/55DE751B" pin "2" net name from "VCC" to "/VCC".

Info: Checking netlist component footprint "C82:/55DE75E3:RCL_C0402_TI".

Info: Changing component path "C82:" to "/55DE75E3".

Changing component "C82:/55DE75E3" pin "1" net name from "GND" to "/GND".

Changing component "C82:/55DE75E3" pin "2" net name from "VCC" to "/VCC".

Info: Checking netlist component footprint "C83:/55DE76AB:RCL_C0402_TI".

Info: Changing component path "C83:" to "/55DE76AB".

Changing component "C83:/55DE76AB" pin "1" net name from "GND" to "/GND".

Changing component "C83:/55DE76AB" pin "2" net name from "VCC" to "/VCC".

Info: Checking netlist component footprint "C84:/55DE7773:RCL_C0402_TI".

Info: Changing component path "C84:" to "/55DE7773".

Changing component "C84:/55DE7773" pin "1" net name from "GND" to "/GND".

Changing component "C84:/55DE7773" pin "2" net name from "VCC" to "/VCC".

Info: Checking netlist component footprint "C85:/55DE783B:RCL_C0402_TI".

Info: Changing component path "C85:" to "/55DE783B".

Changing component "C85:/55DE783B" pin "1" net name from "GND" to "/GND".

Changing component "C85:/55DE783B" pin "2" net name from "VCC" to "/VCC".

Info: Checking netlist component footprint "C86:/55DE7903:RCL_C0402_TI".

Info: Changing component path "C86:" to "/55DE7903".

Changing component "C86:/55DE7903" pin "1" net name from "GND" to "/GND".

Changing component "C86:/55DE7903" pin "2" net name from "LDO3_2.8V" to "/LDO3_2.8V".

Info: Checking netlist component footprint "C87:/55DE79CB:RCL_C0402_TI".

Info: Changing component path "C87:" to "/55DE79CB".

Changing component "C87:/55DE79CB" pin "1" net name from "GND" to "/GND".

Changing component "C87:/55DE79CB" pin "2" net name from "LDO4_2.8V" to "/LDO4_2.8V".

Info: Checking netlist component footprint "C88:/55DE7A93:RCL_C0603_DWS".

Info: Changing component path "C88:" to "/55DE7A93".

Changing component "C88:/55DE7A93" pin "1" net name from "GND" to "/GND".

Changing component "C88:/55DE7A93" pin "2" net name from "N$124" to "/N$124".

Info: Checking netlist component footprint "C89:/55DE7B5B:RCL_C0603_DWS".

Info: Changing component path "C89:" to "/55DE7B5B".

Changing component "C89:/55DE7B5B" pin "1" net name from "GND" to "/GND".

Changing component "C89:/55DE7B5B" pin "2" net name from "VCC" to "/VCC".

Info: Checking netlist component footprint "C90:/55DE7C23:RCL_C0603_DWS".

Info: Changing component path "C90:" to "/55DE7C23".

Changing component "C90:/55DE7C23" pin "1" net name from "GND" to "/GND".

Changing component "C90:/55DE7C23" pin "2" net name from "VCC" to "/VCC".

Info: Checking netlist component footprint "C91:/55DE7CEB:RCL_C0603_DWS".

Info: Changing component path "C91:" to "/55DE7CEB".

Changing component "C91:/55DE7CEB" pin "1" net name from "GND" to "/GND".

Changing component "C91:/55DE7CEB" pin "2" net name from "RESET_N" to "/RESET_N".

Info: Checking netlist component footprint "C92:/55DE7DB3:RCL_C0603_DWS".

Info: Changing component path "C92:" to "/55DE7DB3".

Changing component "C92:/55DE7DB3" pin "1" net name from "GND" to "/GND".

Changing component "C92:/55DE7DB3" pin "2" net name from "N$32" to "/N$32".

Info: Checking netlist component footprint "C93:/55DE7E7B:RCL_C0603_DWS".

Info: Changing component path "C93:" to "/55DE7E7B".

Changing component "C93:/55DE7E7B" pin "1" net name from "GND" to "/GND".

Changing component "C93:/55DE7E7B" pin "2" net name from "N$56" to "/N$56".

Info: Checking netlist component footprint "C94:/55DE7F43:RCL_C0603_DWS".

Info: Changing component path "C94:" to "/55DE7F43".

Changing component "C94:/55DE7F43" pin "1" net name from "GND" to "/GND".

Changing component "C94:/55DE7F43" pin "2" net name from "RESET_N" to "/RESET_N".

Info: Checking netlist component footprint "C95:/55DE800B:RCL_C0603_DWS".

Info: Changing component path "C95:" to "/55DE800B".

Changing component "C95:/55DE800B" pin "1" net name from "GND" to "/GND".

Changing component "C95:/55DE800B" pin "2" net name from "N$47" to "/N$47".

Info: Checking netlist component footprint "C96:/55DE80D3:RCL_C0603_DWS".

Info: Changing component path "C96:" to "/55DE80D3".

Changing component "C96:/55DE80D3" pin "1" net name from "GND" to "/GND".

Changing component "C96:/55DE80D3" pin "2" net name from "N$33" to "/N$33".

Info: Checking netlist component footprint "C97:/55DE819B:RCL_C0603_DWS".

Info: Changing component path "C97:" to "/55DE819B".

Changing component "C97:/55DE819B" pin "1" net name from "GND" to "/GND".

Changing component "C97:/55DE819B" pin "2" net name from "N$86" to "/N$86".

Info: Checking netlist component footprint "C98:/55DE8263:RCL_C0603_DWS".

Info: Changing component path "C98:" to "/55DE8263".

Changing component "C98:/55DE8263" pin "1" net name from "GND" to "/GND".

Changing component "C98:/55DE8263" pin "2" net name from "N$116" to "/N$116".

Info: Checking netlist component footprint "C99:/55DE832B:RCL_C0603_DWS".

Info: Changing component path "C99:" to "/55DE832B".

Changing component "C99:/55DE832B" pin "1" net name from "GND" to "/GND".

Changing component "C99:/55DE832B" pin "2" net name from "XTALI" to "/XTALI".

Info: Checking netlist component footprint "C100:/55DE83F3:RCL_C0603_DWS".

Info: Changing component path "C100:" to "/55DE83F3".

Changing component "C100:/55DE83F3" pin "1" net name from "GND" to "/GND".

Changing component "C100:/55DE83F3" pin "2" net name from "XTALO" to "/XTALO".

Info: Checking netlist component footprint "C101:/55DE84BB:RCL_C0603_DWS".

Info: Changing component path "C101:" to "/55DE84BB".

Changing component "C101:/55DE84BB" pin "1" net name from "GND" to "/GND".

Changing component "C101:/55DE84BB" pin "2" net name from "VDD_RTC" to "/VDD_RTC".

Info: Checking netlist component footprint "C102:/55DE8583:RCL_C0402_TI".

Info: Changing component path "C102:" to "/55DE8583".

Changing component "C102:/55DE8583" pin "1" net name from "GND" to "/GND".

Changing component "C102:/55DE8583" pin "2" net name from "VDD_RTC" to "/VDD_RTC".

Info: Checking netlist component footprint "C103:/55DE864B:RCL_C0603_DWS".

Info: Changing component path "C103:" to "/55DE864B".

Changing component "C103:/55DE864B" pin "1" net name from "GND" to "/GND".

Changing component "C103:/55DE864B" pin "2" net name from "SD_VCC" to "/SD_VCC".

Info: Checking netlist component footprint "C104:/55DE8713:RCL_C0603_DWS".

Info: Changing component path "C104:" to "/55DE8713".

Changing component "C104:/55DE8713" pin "1" net name from "GND" to "/GND".

Changing component "C104:/55DE8713" pin "2" net name from "SD_VCC" to "/SD_VCC".

Info: Checking netlist component footprint "C105:/55DE87DB:RCL_C0603_DWS".

Info: Changing component path "C105:" to "/55DE87DB".

Changing component "C105:/55DE87DB" pin "1" net name from "GND" to "/GND".

Changing component "C105:/55DE87DB" pin "2" net name from "N$85" to "/N$85".

Info: Checking netlist component footprint "C106:/55DE88A3:RCL_C0402_TI".

Info: Changing component path "C106:" to "/55DE88A3".

Changing component "C106:/55DE88A3" pin "1" net name from "GND" to "/GND".

Changing component "C106:/55DE88A3" pin "2" net name from "N$85" to "/N$85".

Info: Checking netlist component footprint "C107:/55DE896B:RCL_C0402_TI".

Info: Changing component path "C107:" to "/55DE896B".

Changing component "C107:/55DE896B" pin "1" net name from "GND" to "/GND".

Changing component "C107:/55DE896B" pin "2" net name from "N$115" to "/N$115".

Info: Checking netlist component footprint "C108:/55DE8A33:RCL_C0402_TI".

Info: Changing component path "C108:" to "/55DE8A33".

Changing component "C108:/55DE8A33" pin "1" net name from "GND" to "/GND".

Changing component "C108:/55DE8A33" pin "2" net name from "N$121" to "/N$121".

Info: Checking netlist component footprint "C109:/55DE8AFB:RCL_C0603_DWS".

Info: Changing component path "C109:" to "/55DE8AFB".

Changing component "C109:/55DE8AFB" pin "1" net name from "GND" to "/GND".

Changing component "C109:/55DE8AFB" pin "2" net name from "VPP" to "/VPP".

Info: Checking netlist component footprint "C110:/55DE8BC3:RCL_C0603_DWS".

Info: Changing component path "C110:" to "/55DE8BC3".

Changing component "C110:/55DE8BC3" pin "1" net name from "MICM" to "/MICM".

Changing component "C110:/55DE8BC3" pin "2" net name from "N$133" to "/N$133".

Info: Checking netlist component footprint "C111:/55DE8C8B:RCL_C0603_DWS".

Info: Changing component path "C111:" to "/55DE8C8B".

Changing component "C111:/55DE8C8B" pin "1" net name from "GNDA" to "/GNDA".

Changing component "C111:/55DE8C8B" pin "2" net name from "N$176" to "/N$176".

Info: Checking netlist component footprint "C112:/55DE8D53:RCL_C0603_DWS".

Info: Changing component path "C112:" to "/55DE8D53".

Changing component "C112:/55DE8D53" pin "1" net name from "GNDA" to "/GNDA".

Changing component "C112:/55DE8D53" pin "2" net name from "N$176" to "/N$176".

Info: Checking netlist component footprint "C113:/55DE8E1B:RCL_C0603_DWS".

Info: Changing component path "C113:" to "/55DE8E1B".

Changing component "C113:/55DE8E1B" pin "1" net name from "GNDA" to "/GNDA".

Changing component "C113:/55DE8E1B" pin "2" net name from "N$122" to "/N$122".

Info: Checking netlist component footprint "C114:/55DE8EE3:RCL_C0603_DWS".

Info: Changing component path "C114:" to "/55DE8EE3".

Changing component "C114:/55DE8EE3" pin "1" net name from "GNDA" to "/GNDA".

Changing component "C114:/55DE8EE3" pin "2" net name from "N$122" to "/N$122".

Info: Checking netlist component footprint "C115:/55DE8FAB:RCL_C0603_DWS".

Info: Changing component path "C115:" to "/55DE8FAB".

Changing component "C115:/55DE8FAB" pin "1" net name from "GND" to "/GND".

Changing component "C115:/55DE8FAB" pin "2" net name from "SD_VCC1" to "/SD_VCC1".

Info: Checking netlist component footprint "C116:/55DE9073:RCL_C0603_DWS".

Info: Changing component path "C116:" to "/55DE9073".

Changing component "C116:/55DE9073" pin "1" net name from "N$20" to "/N$20".

Changing component "C116:/55DE9073" pin "2" net name from "GND" to "/GND".

Info: Checking netlist component footprint "C117:/55DE913B:RCL_C0603_DWS".

Info: Changing component path "C117:" to "/55DE913B".

Changing component "C117:/55DE913B" pin "1" net name from "GND" to "/GND".

Changing component "C117:/55DE913B" pin "2" net name from "VCC" to "/VCC".

Info: Checking netlist component footprint "C118:/55DE9203:RCL_C0603_DWS".

Info: Changing component path "C118:" to "/55DE9203".

Changing component "C118:/55DE9203" pin "1" net name from "GND" to "/GND".

Changing component "C118:/55DE9203" pin "2" net name from "VCC" to "/VCC".

Info: Checking netlist component footprint "C119:/55DE92CB:RCL_C0603_DWS".

Info: Changing component path "C119:" to "/55DE92CB".

Changing component "C119:/55DE92CB" pin "1" net name from "GND" to "/GND".

Changing component "C119:/55DE92CB" pin "2" net name from "VCC" to "/VCC".

Info: Checking netlist component footprint "C120:/55DE9393:RCL_C0603_DWS".

Info: Changing component path "C120:" to "/55DE9393".

Changing component "C120:/55DE9393" pin "1" net name from "GND" to "/GND".

Changing component "C120:/55DE9393" pin "2" net name from "N$1" to "/N$1".

Info: Checking netlist component footprint "C121:/55DE945B:RCL_C0603_DWS".

Info: Changing component path "C121:" to "/55DE945B".

Changing component "C121:/55DE945B" pin "1" net name from "GND" to "/GND".

Changing component "C121:/55DE945B" pin "2" net name from "N$1" to "/N$1".

Info: Checking netlist component footprint "C122:/55DE9523:RCL_C0603_DWS".

Info: Changing component path "C122:" to "/55DE9523".

Changing component "C122:/55DE9523" pin "1" net name from "USB0-VBUSDET" to "/USB0-VBUSDET".

Changing component "C122:/55DE9523" pin "2" net name from "GND" to "/GND".

Info: Checking netlist component footprint "C123:/55DE95EB:RCL_E2_5-6_3".

Info: Changing component path "C123:" to "/55DE95EB".

Changing component "C123:/55DE95EB" pin "-" net name from "GND" to "/GND".

Changing component "C123:/55DE95EB" pin "+" net name from "N$100" to "/N$100".

Info: Checking netlist component footprint "C124:/55DE96B3:RCL_C0603_DWS".

Info: Changing component path "C124:" to "/55DE96B3".

Changing component "C124:/55DE96B3" pin "1" net name from "+5V_OTG_PWR" to "/+5V_OTG_PWR".

Changing component "C124:/55DE96B3" pin "2" net name from "GND" to "/GND".

Info: Checking netlist component footprint "C125:/55DE977B:RCL_C0603_DWS".

Info: Changing component path "C125:" to "/55DE977B".

Changing component "C125:/55DE977B" pin "1" net name from "+5V" to "/+5V".

Changing component "C125:/55DE977B" pin "2" net name from "GND" to "/GND".

Info: Checking netlist component footprint "C126:/55DE9843:RCL_E2_5-6_3".

Info: Changing component path "C126:" to "/55DE9843".

Changing component "C126:/55DE9843" pin "-" net name from "GND" to "/GND".

Changing component "C126:/55DE9843" pin "+" net name from "N$192" to "/N$192".

Info: Checking netlist component footprint "C127:/55DE990B:RCL_C0603_DWS".

Info: Changing component path "C127:" to "/55DE990B".

Changing component "C127:/55DE990B" pin "1" net name from "GND" to "/GND".

Changing component "C127:/55DE990B" pin "2" net name from "TPX1" to "/TPX1".

Info: Checking netlist component footprint "C128:/55DE99D3:RCL_C0603_DWS".

Info: Changing component path "C128:" to "/55DE99D3".

Changing component "C128:/55DE99D3" pin "1" net name from "+5V" to "/+5V".

Changing component "C128:/55DE99D3" pin "2" net name from "GND" to "/GND".

Info: Checking netlist component footprint "C129:/55DE9A9B:RCL_C0603_DWS".

Info: Changing component path "C129:" to "/55DE9A9B".

Changing component "C129:/55DE9A9B" pin "1" net name from "GND" to "/GND".

Changing component "C129:/55DE9A9B" pin "2" net name from "TPX2" to "/TPX2".

Info: Checking netlist component footprint "C130:/55DE9B63:RCL_C0603_DWS".

Info: Changing component path "C130:" to "/55DE9B63".

Changing component "C130:/55DE9B63" pin "1" net name from "N$111" to "/N$111".

Changing component "C130:/55DE9B63" pin "2" net name from "GND" to "/GND".

Info: Checking netlist component footprint "C131:/55DE9C2B:RCL_C0603_DWS".

Info: Changing component path "C131:" to "/55DE9C2B".

Changing component "C131:/55DE9C2B" pin "1" net name from "GND" to "/GND".

Changing component "C131:/55DE9C2B" pin "2" net name from "TPY1" to "/TPY1".

Info: Checking netlist component footprint "C132:/55DE9CF3:RCL_C0603_DWS".

Info: Changing component path "C132:" to "/55DE9CF3".

Changing component "C132:/55DE9CF3" pin "1" net name from "GND" to "/GND".

Changing component "C132:/55DE9CF3" pin "2" net name from "TPY2" to "/TPY2".

Info: Checking netlist component footprint "C133:/55DE9DBB:RCL_C0603_DWS".

Info: Changing component path "C133:" to "/55DE9DBB".

Changing component "C133:/55DE9DBB" pin "1" net name from "GND" to "/GND".

Changing component "C133:/55DE9DBB" pin "2" net name from "N$102" to "/N$102".

Info: Checking netlist component footprint "C134:/55DE9E83:RCL_C0402_TI".

Info: Changing component path "C134:" to "/55DE9E83".

Changing component "C134:/55DE9E83" pin "1" net name from "GND" to "/GND".

Changing component "C134:/55DE9E83" pin "2" net name from "N$102" to "/N$102".

Info: Checking netlist component footprint "C135:/55DE9F4B:RCL_E2_5-6_3".

Info: Changing component path "C135:" to "/55DE9F4B".

Changing component "C135:/55DE9F4B" pin "-" net name from "GND" to "/GND".

Changing component "C135:/55DE9F4B" pin "+" net name from "N$195" to "/N$195".

Info: Checking netlist component footprint "C136:/55DEA013:RCL_C0603_DWS".

Info: Changing component path "C136:" to "/55DEA013".

Changing component "C136:/55DEA013" pin "1" net name from "+5V" to "/+5V".

Changing component "C136:/55DEA013" pin "2" net name from "GND" to "/GND".

Info: Checking netlist component footprint "C137:/55DEA0DB:RCL_C0603_DWS".

Info: Changing component path "C137:" to "/55DEA0DB".

Changing component "C137:/55DEA0DB" pin "1" net name from "N$194" to "/N$194".

Changing component "C137:/55DEA0DB" pin "2" net name from "GND" to "/GND".

Info: Checking netlist component footprint "C138:/55DEA1A3:RCL_C0603_DWS".

Info: Changing component path "C138:" to "/55DEA1A3".

Changing component "C138:/55DEA1A3" pin "1" net name from "GND" to "/GND".

Changing component "C138:/55DEA1A3" pin "2" net name from "N$105" to "/N$105".

Info: Checking netlist component footprint "C139:/55DEA26B:RCL_C0402_TI".

Info: Changing component path "C139:" to "/55DEA26B".

Changing component "C139:/55DEA26B" pin "1" net name from "GND" to "/GND".

Changing component "C139:/55DEA26B" pin "2" net name from "N$105" to "/N$105".

Info: Checking netlist component footprint "C140:/55DEA333:RCL_C0402_TI".

Info: Changing component path "C140:" to "/55DEA333".

Changing component "C140:/55DEA333" pin "1" net name from "SATA-TXP" to "/SATA-TXP".

Changing component "C140:/55DEA333" pin "2" net name from "N$106" to "/N$106".

Info: Checking netlist component footprint "C141:/55DEA3FB:RCL_C0402_TI".

Info: Changing component path "C141:" to "/55DEA3FB".

Changing component "C141:/55DEA3FB" pin "1" net name from "SATA-TXM" to "/SATA-TXM".

Changing component "C141:/55DEA3FB" pin "2" net name from "N$112" to "/N$112".

Info: Checking netlist component footprint "C142:/55DEA4C3:RCL_C0402_TI".

Info: Changing component path "C142:" to "/55DEA4C3".

Changing component "C142:/55DEA4C3" pin "1" net name from "SATA-RXM" to "/SATA-RXM".

Changing component "C142:/55DEA4C3" pin "2" net name from "N$113" to "/N$113".

Info: Checking netlist component footprint "C143:/55DEA58B:RCL_C0402_TI".

Info: Changing component path "C143:" to "/55DEA58B".

Changing component "C143:/55DEA58B" pin "1" net name from "SATA-RXP" to "/SATA-RXP".

Changing component "C143:/55DEA58B" pin "2" net name from "N$114" to "/N$114".

Info: Checking netlist component footprint "C144:/55DEA653:RCL_C0603_DWS".

Info: Changing component path "C144:" to "/55DEA653".

Changing component "C144:/55DEA653" pin "1" net name from "N$14" to "/N$14".

Changing component "C144:/55DEA653" pin "2" net name from "GND" to "/GND".

Info: Checking netlist component footprint "C145:/55DEA71B:RCL_C0603_DWS".

Info: Changing component path "C145:" to "/55DEA71B".

Changing component "C145:/55DEA71B" pin "1" net name from "GND" to "/GND".

Changing component "C145:/55DEA71B" pin "2" net name from "IPSOUT" to "/IPSOUT".

Info: Checking netlist component footprint "C146:/55DEA7E3:RCL_C0603_DWS".

Info: Changing component path "C146:" to "/55DEA7E3".

Changing component "C146:/55DEA7E3" pin "1" net name from "GND" to "/GND".

Changing component "C146:/55DEA7E3" pin "2" net name from "N$9" to "/N$9".

Info: Checking netlist component footprint "C147:/55DEA8AB:RCL_C0603_DWS".

Info: Changing component path "C147:" to "/55DEA8AB".

Changing component "C147:/55DEA8AB" pin "1" net name from "MICM" to "/MICM".

Changing component "C147:/55DEA8AB" pin "2" net name from "N$187" to "/N$187".

Info: Checking netlist component footprint "C148:/55DEA973:RCL_C0603_DWS".

Info: Changing component path "C148:" to "/55DEA973".

Changing component "C148:/55DEA973" pin "1" net name from "MICM" to "/MICM".

Changing component "C148:/55DEA973" pin "2" net name from "VMIC" to "/VMIC".

Info: Checking netlist component footprint "C149:/55DEAA3B:RCL_C0603_DWS".

Info: Changing component path "C149:" to "/55DEAA3B".

Changing component "C149:/55DEAA3B" pin "1" net name from "GND" to "/GND".

Changing component "C149:/55DEAA3B" pin "2" net name from "N$134" to "/N$134".

Info: Checking netlist component footprint "C150:/55DEAB03:RCL_C0603_DWS".

Info: Changing component path "C150:" to "/55DEAB03".

Changing component "C150:/55DEAB03" pin "1" net name from "N$128" to "/N$128".

Changing component "C150:/55DEAB03" pin "2" net name from "+24V" to "/+24V".

Info: Checking netlist component footprint "C151:/55DEABCB:RCL_C0603_DWS".

Info: Changing component path "C151:" to "/55DEABCB".

Changing component "C151:/55DEABCB" pin "1" net name from "N$128" to "/N$128".

Changing component "C151:/55DEABCB" pin "2" net name from "GND" to "/GND".

Info: Checking netlist component footprint "C152:/55DEAC93:RCL_C0603_DWS".

Info: Changing component path "C152:" to "/55DEAC93".

Changing component "C152:/55DEAC93" pin "1" net name from "+24V" to "/+24V".

Changing component "C152:/55DEAC93" pin "2" net name from "GND" to "/GND".

Info: Checking netlist component footprint "C153:/55DEAD5B:RCL_C0402_TI".

Info: Changing component path "C153:" to "/55DEAD5B".

Changing component "C153:/55DEAD5B" pin "1" net name from "N$79" to "/N$79".

Changing component "C153:/55DEAD5B" pin "2" net name from "GND" to "/GND".

Info: Checking netlist component footprint "C154:/55DEAE23:RCL_C0402_TI".

Info: Changing component path "C154:" to "/55DEAE23".

Changing component "C154:/55DEAE23" pin "1" net name from "N$80" to "/N$80".

Changing component "C154:/55DEAE23" pin "2" net name from "GND" to "/GND".

Info: Checking netlist component footprint "C155:/55DEAEEB:RCL_C0402_TI".

Info: Changing component path "C155:" to "/55DEAEEB".

Changing component "C155:/55DEAEEB" pin "1" net name from "N$78" to "/N$78".

Changing component "C155:/55DEAEEB" pin "2" net name from "GND" to "/GND".

Info: Checking netlist component footprint "C156:/55DEAFB3:RCL_C0603_DWS".

Info: Changing component path "C156:" to "/55DEAFB3".

Changing component "C156:/55DEAFB3" pin "1" net name from "IPSOUT" to "/IPSOUT".

Changing component "C156:/55DEAFB3" pin "2" net name from "GND" to "/GND".

Info: Checking netlist component footprint "C157:/55DEB07B:RCL_C0603_DWS".

Info: Changing component path "C157:" to "/55DEB07B".

Changing component "C157:/55DEB07B" pin "1" net name from "GND" to "/GND".

Changing component "C157:/55DEB07B" pin "2" net name from "N$78" to "/N$78".

Info: Checking netlist component footprint "C158:/55DEB143:RCL_C0603_DWS".

Info: Changing component path "C158:" to "/55DEB143".

Changing component "C158:/55DEB143" pin "1" net name from "GND" to "/GND".

Changing component "C158:/55DEB143" pin "2" net name from "N$135" to "/N$135".

Info: Checking netlist component footprint "C159:/55DEB20B:RCL_C0603_DWS".

Info: Changing component path "C159:" to "/55DEB20B".

Changing component "C159:/55DEB20B" pin "1" net name from "VCC/2" to "/VCC/2".

Changing component "C159:/55DEB20B" pin "2" net name from "GND" to "/GND".

Info: Checking netlist component footprint "C160:/55DEB2D3:RCL_C0603_DWS".

Info: Changing component path "C160:" to "/55DEB2D3".

Changing component "C160:/55DEB2D3" pin "1" net name from "VCC/2" to "/VCC/2".

Changing component "C160:/55DEB2D3" pin "2" net name from "GND" to "/GND".

Info: Checking netlist component footprint "C161:/55DEB39B:RCL_C0603_DWS".

Info: Changing component path "C161:" to "/55DEB39B".

Changing component "C161:/55DEB39B" pin "1" net name from "N$16" to "/N$16".

Changing component "C161:/55DEB39B" pin "2" net name from "MICIN1" to "/MICIN1".

Info: Checking netlist component footprint "C162:/55DEB463:RCL_C0603_DWS".

Info: Changing component path "C162:" to "/55DEB463".

Changing component "C162:/55DEB463" pin "1" net name from "IPSOUT" to "/IPSOUT".

Changing component "C162:/55DEB463" pin "2" net name from "GND" to "/GND".

Info: Checking netlist component footprint "C163:/55DEB52B:RCL_C0603_DWS".

Info: Changing component path "C163:" to "/55DEB52B".

Changing component "C163:/55DEB52B" pin "1" net name from "GND" to "/GND".

Changing component "C163:/55DEB52B" pin "2" net name from "N$16" to "/N$16".

Info: Checking netlist component footprint "C164:/55DEB5F3:RCL_C0603_DWS".

Info: Changing component path "C164:" to "/55DEB5F3".

Changing component "C164:/55DEB5F3" pin "1" net name from "VCCINT" to "/VCCINT".

Changing component "C164:/55DEB5F3" pin "2" net name from "GND" to "/GND".

Info: Checking netlist component footprint "C165:/55DEB6BB:RCL_C0603_DWS".

Info: Changing component path "C165:" to "/55DEB6BB".

Changing component "C165:/55DEB6BB" pin "1" net name from "VCCINT" to "/VCCINT".

Changing component "C165:/55DEB6BB" pin "2" net name from "GND" to "/GND".

Info: Checking netlist component footprint "C166:/55DEB783:RCL_C0603_DWS".

Info: Changing component path "C166:" to "/55DEB783".

Changing component "C166:/55DEB783" pin "1" net name from "IPSOUT" to "/IPSOUT".

Changing component "C166:/55DEB783" pin "2" net name from "GND" to "/GND".

Info: Checking netlist component footprint "C167:/55DEB84B:RCL_C0603_DWS".

Info: Changing component path "C167:" to "/55DEB84B".

Changing component "C167:/55DEB84B" pin "1" net name from "GND" to "/GND".

Changing component "C167:/55DEB84B" pin "2" net name from "VINT" to "/VINT".

Info: Checking netlist component footprint "C168:/55DEB913:RCL_C0603_DWS".

Info: Changing component path "C168:" to "/55DEB913".

Changing component "C168:/55DEB913" pin "1" net name from "GND" to "/GND".

Changing component "C168:/55DEB913" pin "2" net name from "N$191" to "/N$191".

Info: Checking netlist component footprint "C169:/55DEB9DB:RCL_C0402_TI".

Info: Changing component path "C169:" to "/55DEB9DB".

Changing component "C169:/55DEB9DB" pin "1" net name from "GND" to "/GND".

Changing component "C169:/55DEB9DB" pin "2" net name from "N$191" to "/N$191".

Info: Checking netlist component footprint "C170:/55DEBAA3:RCL_C0603_DWS".

Info: Changing component path "C170:" to "/55DEBAA3".

Changing component "C170:/55DEBAA3" pin "1" net name from "GND" to "/GND".

Changing component "C170:/55DEBAA3" pin "2" net name from "N$44" to "/N$44".

Info: Checking netlist component footprint "C171:/55DEBB6B:RCL_C0603_DWS".

Info: Changing component path "C171:" to "/55DEBB6B".

Changing component "C171:/55DEBB6B" pin "1" net name from "GND" to "/GND".

Changing component "C171:/55DEBB6B" pin "2" net name from "N$34" to "/N$34".

Info: Checking netlist component footprint "C172:/55DEBC33:RCL_C0603_DWS".

Info: Changing component path "C172:" to "/55DEBC33".

Changing component "C172:/55DEBC33" pin "1" net name from "VDD_RTC" to "/VDD_RTC".

Changing component "C172:/55DEBC33" pin "2" net name from "GND" to "/GND".

Info: Checking netlist component footprint "C173:/55DEBCFB:RCL_C0603_DWS".

Info: Changing component path "C173:" to "/55DEBCFB".

Changing component "C173:/55DEBCFB" pin "1" net name from "GND" to "/GND".

Changing component "C173:/55DEBCFB" pin "2" net name from "N$196" to "/N$196".

Info: Checking netlist component footprint "C174:/55DEBDC3:RCL_C0603_DWS".

Info: Changing component path "C174:" to "/55DEBDC3".

Changing component "C174:/55DEBDC3" pin "1" net name from "GND" to "/GND".

Changing component "C174:/55DEBDC3" pin "2" net name from "N$132" to "/N$132".

Info: Checking netlist component footprint "C175:/55DEBE8B:RCL_C0402_TI".

Info: Changing component path "C175:" to "/55DEBE8B".

Changing component "C175:/55DEBE8B" pin "1" net name from "GND" to "/GND".

Changing component "C175:/55DEBE8B" pin "2" net name from "N$196" to "/N$196".

Info: Checking netlist component footprint "C176:/55DEBF53:RCL_C0603_DWS".

Info: Changing component path "C176:" to "/55DEBF53".

Changing component "C176:/55DEBF53" pin "1" net name from "GND" to "/GND".

Changing component "C176:/55DEBF53" pin "2" net name from "N$35" to "/N$35".

Info: Checking netlist component footprint "C177:/55DEC01B:RCL_C0603_DWS".

Info: Changing component path "C177:" to "/55DEC01B".

Changing component "C177:/55DEC01B" pin "1" net name from "GND" to "/GND".

Changing component "C177:/55DEC01B" pin "2" net name from "IPSOUT" to "/IPSOUT".

Info: Checking netlist component footprint "C178:/55DEC0E3:RCL_C0603_DWS".

Info: Changing component path "C178:" to "/55DEC0E3".

Changing component "C178:/55DEC0E3" pin "1" net name from "N$28" to "/N$28".

Changing component "C178:/55DEC0E3" pin "2" net name from "GND" to "/GND".

Info: Checking netlist component footprint "C179:/55DEC1AB:RCL_C0603_DWS".

Info: Changing component path "C179:" to "/55DEC1AB".

Changing component "C179:/55DEC1AB" pin "1" net name from "LDO3_2.8V" to "/LDO3_2.8V".

Changing component "C179:/55DEC1AB" pin "2" net name from "GND" to "/GND".

Info: Checking netlist component footprint "C180:/55DEC273:RCL_C0603_DWS".

Info: Changing component path "C180:" to "/55DEC273".

Changing component "C180:/55DEC273" pin "1" net name from "IPSOUT" to "/IPSOUT".

Changing component "C180:/55DEC273" pin "2" net name from "GND" to "/GND".

Info: Checking netlist component footprint "C181:/55DEC33B:RCL_C0603_DWS".

Info: Changing component path "C181:" to "/55DEC33B".

Changing component "C181:/55DEC33B" pin "1" net name from "GND" to "/GND".

Changing component "C181:/55DEC33B" pin "2" net name from "TVIN0" to "/TVIN0".

Info: Checking netlist component footprint "C182:/55DEC403:RCL_C0603_DWS".

Info: Changing component path "C182:" to "/55DEC403".

Changing component "C182:/55DEC403" pin "1" net name from "GND" to "/GND".

Changing component "C182:/55DEC403" pin "2" net name from "N$139" to "/N$139".

Info: Checking netlist component footprint "C183:/55DEC4CB:RCL_C0603_DWS".

Info: Changing component path "C183:" to "/55DEC4CB".

Changing component "C183:/55DEC4CB" pin "1" net name from "GND" to "/GND".

Changing component "C183:/55DEC4CB" pin "2" net name from "TVIN1" to "/TVIN1".

Info: Checking netlist component footprint "C184:/55DEC593:RCL_C0402_TI".

Info: Changing component path "C184:" to "/55DEC593".

Changing component "C184:/55DEC593" pin "1" net name from "N$222" to "/N$222".

Changing component "C184:/55DEC593" pin "2" net name from "GND" to "/GND".

Info: Checking netlist component footprint "C185:/55DEC65B:RCL_C0603_DWS".

Info: Changing component path "C185:" to "/55DEC65B".

Changing component "C185:/55DEC65B" pin "1" net name from "GND" to "/GND".

Changing component "C185:/55DEC65B" pin "2" net name from "TVIN2" to "/TVIN2".

Info: Checking netlist component footprint "C186:/55DEC723:RCL_C0603_DWS".

Info: Changing component path "C186:" to "/55DEC723".

Changing component "C186:/55DEC723" pin "1" net name from "GND" to "/GND".

Changing component "C186:/55DEC723" pin "2" net name from "N$222" to "/N$222".

Info: Checking netlist component footprint "C187:/55DEC7EB:RCL_C0603_DWS".

Info: Changing component path "C187:" to "/55DEC7EB".

Changing component "C187:/55DEC7EB" pin "1" net name from "LDO4_2.8V" to "/LDO4_2.8V".

Changing component "C187:/55DEC7EB" pin "2" net name from "GND" to "/GND".

Info: Checking netlist component footprint "C188:/55DEC8B3:RCL_C0603_DWS".

Info: Changing component path "C188:" to "/55DEC8B3".

Changing component "C188:/55DEC8B3" pin "1" net name from "GND" to "/GND".

Changing component "C188:/55DEC8B3" pin "2" net name from "TVIN3" to "/TVIN3".

Info: Checking netlist component footprint "C189:/55DEC97B:RCL_C0402_TI".

Info: Changing component path "C189:" to "/55DEC97B".

Changing component "C189:/55DEC97B" pin "1" net name from "N$221" to "/N$221".

Changing component "C189:/55DEC97B" pin "2" net name from "GND" to "/GND".

Info: Checking netlist component footprint "C190:/55DECA43:RCL_C0603_DWS".

Info: Changing component path "C190:" to "/55DECA43".

Changing component "C190:/55DECA43" pin "1" net name from "GND" to "/GND".

Changing component "C190:/55DECA43" pin "2" net name from "N$221" to "/N$221".

Info: Checking netlist component footprint "C191:/55DECB0B:RCL_C0402_TI".

Info: Changing component path "C191:" to "/55DECB0B".

Changing component "C191:/55DECB0B" pin "1" net name from "N$220" to "/N$220".

Changing component "C191:/55DECB0B" pin "2" net name from "GND" to "/GND".

Info: Checking netlist component footprint "C192:/55DECBD3:RCL_C0603_DWS".

Info: Changing component path "C192:" to "/55DECBD3".

Changing component "C192:/55DECBD3" pin "1" net name from "GND" to "/GND".

Changing component "C192:/55DECBD3" pin "2" net name from "N$42" to "/N$42".

Info: Checking netlist component footprint "C193:/55DECC9B:RCL_C0603_DWS".

Info: Changing component path "C193:" to "/55DECC9B".

Changing component "C193:/55DECC9B" pin "1" net name from "GND" to "/GND".

Changing component "C193:/55DECC9B" pin "2" net name from "N$220" to "/N$220".

Info: Checking netlist component footprint "C194:/55DECD63:RCL_C0603_DWS".

Info: Changing component path "C194:" to "/55DECD63".

Changing component "C194:/55DECD63" pin "1" net name from "IPSOUT" to "/IPSOUT".

Changing component "C194:/55DECD63" pin "2" net name from "GND" to "/GND".

Info: Checking netlist component footprint "C195:/55DECE2B:RCL_C0603_DWS".

Info: Changing component path "C195:" to "/55DECE2B".

Changing component "C195:/55DECE2B" pin "1" net name from "V+" to "/V+".

Changing component "C195:/55DECE2B" pin "2" net name from "N$19" to "/N$19".

Info: Checking netlist component footprint "C196:/55DECEF3:RCL_C0603_DWS".

Info: Changing component path "C196:" to "/55DECEF3".

Changing component "C196:/55DECEF3" pin "1" net name from "GND" to "/GND".

Changing component "C196:/55DECEF3" pin "2" net name from "N$223" to "/N$223".

Info: Checking netlist component footprint "C197:/55DECFBB:RCL_C0603_DWS".

Info: Changing component path "C197:" to "/55DECFBB".

Changing component "C197:/55DECFBB" pin "1" net name from "GND" to "/GND".

Changing component "C197:/55DECFBB" pin "2" net name from "N$24" to "/N$24".

Info: Checking netlist component footprint "C198:/55DED083:RCL_C0603_DWS".

Info: Changing component path "C198:" to "/55DED083".

Changing component "C198:/55DED083" pin "1" net name from "V+" to "/V+".

Changing component "C198:/55DED083" pin "2" net name from "GND" to "/GND".

Info: Checking netlist component footprint "C199:/55DED14B:RCL_C0603_DWS".

Info: Changing component path "C199:" to "/55DED14B".

Changing component "C199:/55DED14B" pin "1" net name from "V+" to "/V+".

Changing component "C199:/55DED14B" pin "2" net name from "GND" to "/GND".

Info: Checking netlist component footprint "C200:/55DED213:RCL_C0402_TI".

Info: Changing component path "C200:" to "/55DED213".

Changing component "C200:/55DED213" pin "1" net name from "N$46" to "/N$46".

Changing component "C200:/55DED213" pin "2" net name from "N$50" to "/N$50".

Info: Checking netlist component footprint "C201:/55DED2DB:RCL_C0603_DWS".

Info: Changing component path "C201:" to "/55DED2DB".

Changing component "C201:/55DED2DB" pin "1" net name from "N$60" to "/N$60".

Changing component "C201:/55DED2DB" pin "2" net name from "N$61" to "/N$61".

Info: Checking netlist component footprint "C202:/55DED3A3:RCL_E5-10_5".

Info: Changing component path "C202:" to "/55DED3A3".

Changing component "C202:/55DED3A3" pin "+" net name from "N$31" to "/N$31".

Changing component "C202:/55DED3A3" pin "-" net name from "GND" to "/GND".

Info: Checking netlist component footprint "C203:/55DED46B:RCL_C0603_DWS".

Info: Changing component path "C203:" to "/55DED46B".

Changing component "C203:/55DED46B" pin "1" net name from "N$36" to "/N$36".

Changing component "C203:/55DED46B" pin "2" net name from "GND" to "/GND".

Info: Checking netlist component footprint "C204:/55DED533:RCL_C0603_DWS".

Info: Changing component path "C204:" to "/55DED533".

Changing component "C204:/55DED533" pin "1" net name from "+15V" to "/+15V".

Changing component "C204:/55DED533" pin "2" net name from "GND" to "/GND".

Info: Checking netlist component footprint "C205:/55DED5FB:RCL_C0603_DWS".

Info: Changing component path "C205:" to "/55DED5FB".

Changing component "C205:/55DED5FB" pin "1" net name from "+15V" to "/+15V".

Changing component "C205:/55DED5FB" pin "2" net name from "GND" to "/GND".

Info: Checking netlist component footprint "C206:/55DED6C3:RCL_C0603_DWS".

Info: Changing component path "C206:" to "/55DED6C3".

Changing component "C206:/55DED6C3" pin "1" net name from "N$23" to "/N$23".

Changing component "C206:/55DED6C3" pin "2" net name from "GND" to "/GND".

Info: Checking netlist component footprint "C207:/55DED78B:RCL_C0603_DWS".

Info: Changing component path "C207:" to "/55DED78B".

Changing component "C207:/55DED78B" pin "1" net name from "IPSOUT" to "/IPSOUT".

Changing component "C207:/55DED78B" pin "2" net name from "GND" to "/GND".

Info: Checking netlist component footprint "C208:/55DED853:RCL_C0603_DWS".

Info: Changing component path "C208:" to "/55DED853".

Changing component "C208:/55DED853" pin "1" net name from "VCC" to "/VCC".

Changing component "C208:/55DED853" pin "2" net name from "N$66" to "/N$66".

Info: Checking netlist component footprint "C209:/55DED91B:RCL_C0603_DWS".

Info: Changing component path "C209:" to "/55DED91B".

Changing component "C209:/55DED91B" pin "1" net name from "GND" to "/GND".

Changing component "C209:/55DED91B" pin "2" net name from "+24V" to "/+24V".

Info: Checking netlist component footprint "C210:/55DED9E3:RCL_C0603_DWS".

Info: Changing component path "C210:" to "/55DED9E3".

Changing component "C210:/55DED9E3" pin "1" net name from "GND" to "/GND".

Changing component "C210:/55DED9E3" pin "2" net name from "IPSOUT" to "/IPSOUT".

Info: Checking netlist component footprint "C211:/55DEDAAB:RCL_C0603_DWS".

Info: Changing component path "C211:" to "/55DEDAAB".

Changing component "C211:/55DEDAAB" pin "1" net name from "VCC" to "/VCC".

Changing component "C211:/55DEDAAB" pin "2" net name from "GND" to "/GND".

Info: Checking netlist component footprint "C212:/55DEDB73:RCL_C0603_DWS".

Info: Changing component path "C212:" to "/55DEDB73".

Changing component "C212:/55DEDB73" pin "1" net name from "VCC" to "/VCC".

Changing component "C212:/55DEDB73" pin "2" net name from "GND" to "/GND".

Info: Checking netlist component footprint "C213:/55DEDC3B:RCL_C0603_DWS".

Info: Changing component path "C213:" to "/55DEDC3B".

Changing component "C213:/55DEDC3B" pin "1" net name from "GND" to "/GND".

Changing component "C213:/55DEDC3B" pin "2" net name from "N$24" to "/N$24".

Info: Checking netlist component footprint "C214:/55DEDD03:RCL_C0603_DWS".

Info: Changing component path "C214:" to "/55DEDD03".

Changing component "C214:/55DEDD03" pin "1" net name from "GND" to "/GND".

Changing component "C214:/55DEDD03" pin "2" net name from "+5V" to "/+5V".

Info: Checking netlist component footprint "C215:/55DEDDCB:RCL_C0603_DWS".

Info: Changing component path "C215:" to "/55DEDDCB".

Changing component "C215:/55DEDDCB" pin "1" net name from "GND" to "/GND".

Changing component "C215:/55DEDDCB" pin "2" net name from "+5V" to "/+5V".

Info: Checking netlist component footprint "C216:/55DEDE93:RCL_C0603_DWS".

Info: Changing component path "C216:" to "/55DEDE93".

Changing component "C216:/55DEDE93" pin "1" net name from "N$17" to "/N$17".

Changing component "C216:/55DEDE93" pin "2" net name from "GND" to "/GND".

Info: Checking netlist component footprint "C218:/55DEDF5B:RCL_C0603_DWS".

Info: Changing component path "C218:" to "/55DEDF5B".

Changing component "C218:/55DEDF5B" pin "1" net name from "LRADC0" to "/LRADC0".

Changing component "C218:/55DEDF5B" pin "2" net name from "GND" to "/GND".

Info: Checking netlist component footprint "C219:/55DEE023:RCL_C0603_DWS".

Info: Changing component path "C219:" to "/55DEE023".

Changing component "C219:/55DEE023" pin "1" net name from "VCC" to "/VCC".

Changing component "C219:/55DEE023" pin "2" net name from "GND" to "/GND".

Info: Checking netlist component footprint "C220:/55DEE0EB:RCL_C0603_DWS".

Info: Changing component path "C220:" to "/55DEE0EB".

Changing component "C220:/55DEE0EB" pin "1" net name from "VDD" to "/VDD".

Changing component "C220:/55DEE0EB" pin "2" net name from "GND" to "/GND".

Info: Checking netlist component footprint "C221:/55DEE1B3:RCL_C0603_DWS".

Info: Changing component path "C221:" to "/55DEE1B3".

Changing component "C221:/55DEE1B3" pin "1" net name from "VDD" to "/VDD".

Changing component "C221:/55DEE1B3" pin "2" net name from "GND" to "/GND".

Info: Checking netlist component footprint "C224:/55DEE27B:RCL_C0603_DWS".

Info: Changing component path "C224:" to "/55DEE27B".

Changing component "C224:/55DEE27B" pin "1" net name from "GND" to "/GND".

Changing component "C224:/55DEE27B" pin "2" net name from "V+" to "/V+".

Info: Checking netlist component footprint "C225:/55DEE343:RCL_C0603_DWS".

Info: Changing component path "C225:" to "/55DEE343".

Changing component "C225:/55DEE343" pin "1" net name from "GND" to "/GND".

Changing component "C225:/55DEE343" pin "2" net name from "V+" to "/V+".

Info: Checking netlist component footprint "C226:/55DEE40B:RCL_C0603_DWS".

Info: Changing component path "C226:" to "/55DEE40B".

Changing component "C226:/55DEE40B" pin "1" net name from "GND" to "/GND".

Changing component "C226:/55DEE40B" pin "2" net name from "V+" to "/V+".

Info: Checking netlist component footprint "C227:/55DEE4D3:RCL_C0603_DWS".

Info: Changing component path "C227:" to "/55DEE4D3".

Changing component "C227:/55DEE4D3" pin "1" net name from "GND" to "/GND".

Changing component "C227:/55DEE4D3" pin "2" net name from "V+" to "/V+".

Info: Checking netlist component footprint "C228:/55DEE59B:RCL_C0603_DWS".

Info: Changing component path "C228:" to "/55DEE59B".

Changing component "C228:/55DEE59B" pin "1" net name from "GND" to "/GND".

Changing component "C228:/55DEE59B" pin "2" net name from "V+" to "/V+".

Info: Checking netlist component footprint "C229:/55DEE663:RCL_C0603_DWS".

Info: Changing component path "C229:" to "/55DEE663".

Changing component "C229:/55DEE663" pin "1" net name from "GND" to "/GND".

Changing component "C229:/55DEE663" pin "2" net name from "V+" to "/V+".

Info: Checking netlist component footprint "C230:/55DEE72B:RCL_C0603_DWS".

Info: Changing component path "C230:" to "/55DEE72B".

Changing component "C230:/55DEE72B" pin "1" net name from "GND" to "/GND".

Changing component "C230:/55DEE72B" pin "2" net name from "V+" to "/V+".

Info: Checking netlist component footprint "C231:/55DEE7F3:RCL_C0603_DWS".

Info: Changing component path "C231:" to "/55DEE7F3".

Changing component "C231:/55DEE7F3" pin "1" net name from "GND" to "/GND".

Changing component "C231:/55DEE7F3" pin "2" net name from "V+" to "/V+".

Info: Checking netlist component footprint "C232:/55DEE8BB:RCL_C0603_DWS".

Info: Changing component path "C232:" to "/55DEE8BB".

Changing component "C232:/55DEE8BB" pin "1" net name from "GND" to "/GND".

Changing component "C232:/55DEE8BB" pin "2" net name from "V+" to "/V+".

Info: Checking netlist component footprint "CHGLED233:/55DEE983:DOUBLE-SIDE_LED-0603".

Info: Changing component path "CHGLED233:" to "/55DEE983".

Changing component "CHGLED233:/55DEE983" pin "C" net name from "N$43" to "/N$43".

Changing component "CHGLED233:/55DEE983" pin "A" net name from "IPSOUT" to "/IPSOUT".

Info: Checking netlist component footprint "D1:/55DEEA4B:GOGO_SOD-123".

Info: Changing component path "D1:" to "/55DEEA4B".

Changing component "D1:/55DEEA4B" pin "C" net name from "N$10" to "/N$10".

Changing component "D1:/55DEEA4B" pin "A" net name from "VCC" to "/VCC".

Info: Checking netlist component footprint "D3:/55DEEB13:GOGO_SOD-123".

Info: Changing component path "D3:" to "/55DEEB13".

Changing component "D3:/55DEEB13" pin "C" net name from "N$7" to "/N$7".

Changing component "D3:/55DEEB13" pin "A" net name from "UART0-RX" to "/UART0-RX".

Info: Checking netlist component footprint "D4:/55DEEBDB:GOGO_MLL-41".

Info: Changing component path "D4:" to "/55DEEBDB".

Changing component "D4:/55DEEBDB" pin "K" net name from "+5V" to "/+5V".

Changing component "D4:/55DEEBDB" pin "A" net name from "+15V" to "/+15V".

Info: Checking netlist component footprint "D5:/55DEECA3:OLIMEX_DISCRET_DO214AA".

Info: Changing component path "D5:" to "/55DEECA3".

Changing component "D5:/55DEECA3" pin "C" net name from "N$31" to "/N$31".

Changing component "D5:/55DEECA3" pin "A" net name from "GND" to "/GND".

Info: Checking netlist component footprint "D6:/55DEED6B:SEMICON-SMD-IPC_MELF-MLL41".

Info: Changing component path "D6:" to "/55DEED6B".

Changing component "D6:/55DEED6B" pin "1" net name from "N$23" to "/N$23".

Changing component "D6:/55DEED6B" pin "2" net name from "N$123" to "/N$123".

Info: Checking netlist component footprint "ENTER233:/55DEEE33:GOGO_SW_TAKT3X4".

Info: Changing component path "ENTER233:" to "/55DEEE33".

Changing component "ENTER233:/55DEEE33" pin "1_1" net name from "ENTER_BUT" to "/ENTER_BUT".

Changing component "ENTER233:/55DEEE33" pin "2_1" net name from "GND" to "/GND".

Info: Checking netlist component footprint "ESC233:/55DEEEFB:GOGO_SW_TAKT3X4".

Info: Changing component path "ESC233:" to "/55DEEEFB".

Changing component "ESC233:/55DEEEFB" pin "1_1" net name from "ESC_BUT" to "/ESC_BUT".

Changing component "ESC233:/55DEEEFB" pin "2_1" net name from "GND" to "/GND".

Info: Checking netlist component footprint "FET1:/55DEEFC3:PENKO_SOT23".

Info: Changing component path "FET1:" to "/55DEEFC3".

Changing component "FET1:/55DEEFC3" pin "3" net name from "N$23" to "/N$23".

Changing component "FET1:/55DEEFC3" pin "2" net name from "+5V" to "/+5V".

Changing component "FET1:/55DEEFC3" pin "1" net name from "+15V" to "/+15V".

Info: Checking netlist component footprint "FET2:/55DEF08B:PENKO_SOT23".

Info: Changing component path "FET2:" to "/55DEF08B".

Changing component "FET2:/55DEF08B" pin "3" net name from "VGA_VSYNC" to "/VGA_VSYNC".

Changing component "FET2:/55DEF08B" pin "2" net name from "GND" to "/GND".

Changing component "FET2:/55DEF08B" pin "1" net name from "N$11" to "/N$11".

Info: Checking netlist component footprint "FET3:/55DEF153:PENKO_SOT23".

Info: Changing component path "FET3:" to "/55DEF153".

Changing component "FET3:/55DEF153" pin "3" net name from "VGA_HSYNC" to "/VGA_HSYNC".

Changing component "FET3:/55DEF153" pin "2" net name from "GND" to "/GND".

Changing component "FET3:/55DEF153" pin "1" net name from "N$27" to "/N$27".

Info: Checking netlist component footprint "FET4:/55DEF21B:PENKO_SOT23".

Info: Changing component path "FET4:" to "/55DEF21B".

Changing component "FET4:/55DEF21B" pin "3" net name from "N$24" to "/N$24".

Changing component "FET4:/55DEF21B" pin "2" net name from "+5V" to "/+5V".

Changing component "FET4:/55DEF21B" pin "1" net name from "N$18" to "/N$18".

Info: Checking netlist component footprint "FUSE1:/55DEF2E3:GOGO_1206".

Info: Changing component path "FUSE1:" to "/55DEF2E3".

Changing component "FUSE1:/55DEF2E3" pin "1" net name from "+5V" to "/+5V".

Changing component "FUSE1:/55DEF2E3" pin "2" net name from "HDMI_5V_SOURCE" to "/HDMI_5V_SOURCE".

Info: Checking netlist component footprint "GND233:/55DF3C53:GOGO_TESTPAD_40-ROUND".

Info: Changing component path "GND233:" to "/55DF3C53".

Changing component "GND233:/55DF3C53" pin "1" net name from "GND" to "/GND".

Info: Checking netlist component footprint "GND_PIN233:/55DF3D1B:GOGO_TEST_PAD40_70_SQUARE".

Info: Changing component path "GND_PIN233:" to "/55DF3D1B".

Changing component "GND_PIN233:/55DF3D1B" pin "P$1" net name from "GND" to "/GND".

Info: Checking netlist component footprint "GPIO-1:/55DF3DE3:CON-HARTING-ML_ML40-MALE(GBH-254-SMT-40)".

Info: Changing component path "GPIO-1:" to "/55DF3DE3".

Changing component "GPIO-1:/55DF3DE3" pin "1" net name from "+5V" to "/+5V".

Changing component "GPIO-1:/55DF3DE3" pin "2" net name from "GND" to "/GND".

Changing component "GPIO-1:/55DF3DE3" pin "3" net name from "VCC" to "/VCC".

Changing component "GPIO-1:/55DF3DE3" pin "4" net name from "GND" to "/GND".

Changing component "GPIO-1:/55DF3DE3" pin "5" net name from "PG0" to "/PG0".

Changing component "GPIO-1:/55DF3DE3" pin "6" net name from "VOL+_BUT" to "/VOL+_BUT".

Changing component "GPIO-1:/55DF3DE3" pin "7" net name from "PG1" to "/PG1".

Changing component "GPIO-1:/55DF3DE3" pin "8" net name from "VOL-_BUT" to "/VOL-_BUT".

Changing component "GPIO-1:/55DF3DE3" pin "9" net name from "PG2" to "/PG2".

Changing component "GPIO-1:/55DF3DE3" pin "10" net name from "MENU_BUT" to "/MENU_BUT".

Changing component "GPIO-1:/55DF3DE3" pin "11" net name from "PG3" to "/PG3".

Changing component "GPIO-1:/55DF3DE3" pin "12" net name from "SEARCH_BUT" to "/SEARCH_BUT".

Changing component "GPIO-1:/55DF3DE3" pin "13" net name from "PG4" to "/PG4".

Changing component "GPIO-1:/55DF3DE3" pin "14" net name from "HOME_BUT" to "/HOME_BUT".

Changing component "GPIO-1:/55DF3DE3" pin "15" net name from "PG5" to "/PG5".

Changing component "GPIO-1:/55DF3DE3" pin "16" net name from "ESC_BUT" to "/ESC_BUT".

Changing component "GPIO-1:/55DF3DE3" pin "17" net name from "PG6" to "/PG6".

Changing component "GPIO-1:/55DF3DE3" pin "18" net name from "ENTER_BUT" to "/ENTER_BUT".

Changing component "GPIO-1:/55DF3DE3" pin "19" net name from "PG7" to "/PG7".

Changing component "GPIO-1:/55DF3DE3" pin "20" net name from "TVOUT3" to "/TVOUT3".

Changing component "GPIO-1:/55DF3DE3" pin "21" net name from "PG8" to "/PG8".

Changing component "GPIO-1:/55DF3DE3" pin "22" net name from "TVIN0" to "/TVIN0".

Changing component "GPIO-1:/55DF3DE3" pin "23" net name from "PG9" to "/PG9".

Changing component "GPIO-1:/55DF3DE3" pin "24" net name from "TVIN1" to "/TVIN1".

Changing component "GPIO-1:/55DF3DE3" pin "25" net name from "PG10" to "/PG10".

Changing component "GPIO-1:/55DF3DE3" pin "26" net name from "TVIN2" to "/TVIN2".

Changing component "GPIO-1:/55DF3DE3" pin "27" net name from "PG11" to "/PG11".

Changing component "GPIO-1:/55DF3DE3" pin "28" net name from "TVIN3" to "/TVIN3".

Changing component "GPIO-1:/55DF3DE3" pin "29" net name from "VGA_HSYNC" to "/VGA_HSYNC".

Changing component "GPIO-1:/55DF3DE3" pin "30" net name from "LINEINR" to "/LINEINR".

Changing component "GPIO-1:/55DF3DE3" pin "31" net name from "VGA_VSYNC" to "/VGA_VSYNC".

Changing component "GPIO-1:/55DF3DE3" pin "32" net name from "LINEINL" to "/LINEINL".

Changing component "GPIO-1:/55DF3DE3" pin "33" net name from "VGA-G" to "/VGA-G".

Changing component "GPIO-1:/55DF3DE3" pin "34" net name from "FMINR" to "/FMINR".

Changing component "GPIO-1:/55DF3DE3" pin "35" net name from "VGA-B" to "/VGA-B".

Changing component "GPIO-1:/55DF3DE3" pin "36" net name from "FMINL" to "/FMINL".

Changing component "GPIO-1:/55DF3DE3" pin "37" net name from "VGA-R" to "/VGA-R".

Changing component "GPIO-1:/55DF3DE3" pin "38" net name from "MIC1OUTP" to "/MIC1OUTP".

Changing component "GPIO-1:/55DF3DE3" pin "39" net name from "LRADC1" to "/LRADC1".

Changing component "GPIO-1:/55DF3DE3" pin "40" net name from "MIC1OUTN" to "/MIC1OUTN".

Info: Checking netlist component footprint "GPIO-2:/55DF3EAB:CON-HARTING-ML_ML40-MALE(GBH-254-SMT-40)".

Info: Changing component path "GPIO-2:" to "/55DF3EAB".

Changing component "GPIO-2:/55DF3EAB" pin "1" net name from "+5V" to "/+5V".

Changing component "GPIO-2:/55DF3EAB" pin "2" net name from "GND" to "/GND".

Changing component "GPIO-2:/55DF3EAB" pin "3" net name from "VCC" to "/VCC".

Changing component "GPIO-2:/55DF3EAB" pin "4" net name from "GND" to "/GND".

Changing component "GPIO-2:/55DF3EAB" pin "5" net name from "TWI0-SCK" to "/TWI0-SCK".

Changing component "GPIO-2:/55DF3EAB" pin "6" net name from "PE0" to "/PE0".

Changing component "GPIO-2:/55DF3EAB" pin "7" net name from "TWI0-SDA" to "/TWI0-SDA".

Changing component "GPIO-2:/55DF3EAB" pin "8" net name from "PE1" to "/PE1".

Changing component "GPIO-2:/55DF3EAB" pin "9" net name from "PI0" to "/PI0".

Changing component "GPIO-2:/55DF3EAB" pin "10" net name from "PE2" to "/PE2".

Changing component "GPIO-2:/55DF3EAB" pin "11" net name from "PI1" to "/PI1".

Changing component "GPIO-2:/55DF3EAB" pin "12" net name from "PE3" to "/PE3".

Changing component "GPIO-2:/55DF3EAB" pin "13" net name from "PI2" to "/PI2".

Changing component "GPIO-2:/55DF3EAB" pin "14" net name from "PE4" to "/PE4".

Changing component "GPIO-2:/55DF3EAB" pin "15" net name from "PI3" to "/PI3".

Changing component "GPIO-2:/55DF3EAB" pin "16" net name from "PE5" to "/PE5".

Changing component "GPIO-2:/55DF3EAB" pin "17" net name from "PI10" to "/PI10".

Changing component "GPIO-2:/55DF3EAB" pin "18" net name from "PE6" to "/PE6".

Changing component "GPIO-2:/55DF3EAB" pin "19" net name from "PI11" to "/PI11".

Changing component "GPIO-2:/55DF3EAB" pin "20" net name from "PE7" to "/PE7".

Changing component "GPIO-2:/55DF3EAB" pin "21" net name from "PC3/NCE1" to "/PC3/NCE1".

Changing component "GPIO-2:/55DF3EAB" pin "22" net name from "PE8" to "/PE8".

Changing component "GPIO-2:/55DF3EAB" pin "23" net name from "PC7/NRB1" to "/PC7/NRB1".

Changing component "GPIO-2:/55DF3EAB" pin "24" net name from "PE9" to "/PE9".

Changing component "GPIO-2:/55DF3EAB" pin "25" net name from "PC16" to "/PC16".

Changing component "GPIO-2:/55DF3EAB" pin "26" net name from "PE10" to "/PE10".

Changing component "GPIO-2:/55DF3EAB" pin "27" net name from "PC17" to "/PC17".

Changing component "GPIO-2:/55DF3EAB" pin "28" net name from "PE11" to "/PE11".

Changing component "GPIO-2:/55DF3EAB" pin "29" net name from "PC18" to "/PC18".

Changing component "GPIO-2:/55DF3EAB" pin "30" net name from "PI14" to "/PI14".

Changing component "GPIO-2:/55DF3EAB" pin "31" net name from "PC23" to "/PC23".

Changing component "GPIO-2:/55DF3EAB" pin "32" net name from "PI15" to "/PI15".

Changing component "GPIO-2:/55DF3EAB" pin "33" net name from "PC24/NQS" to "/PC24/NQS".

Changing component "GPIO-2:/55DF3EAB" pin "34" net name from "UART0-RX" to "/UART0-RX".

Changing component "GPIO-2:/55DF3EAB" pin "35" net name from "GPIO1" to "/GPIO1".

Changing component "GPIO-2:/55DF3EAB" pin "36" net name from "UART0-TX" to "/UART0-TX".

Changing component "GPIO-2:/55DF3EAB" pin "37" net name from "GPIO2" to "/GPIO2".

Changing component "GPIO-2:/55DF3EAB" pin "38" net name from "NMI_N" to "/NMI_N".

Changing component "GPIO-2:/55DF3EAB" pin "39" net name from "GPIO3" to "/GPIO3".

Changing component "GPIO-2:/55DF3EAB" pin "40" net name from "RESET_N" to "/RESET_N".

Info: Checking netlist component footprint "GPIO-3:/55DF3F73:CON-HARTING-ML_ML40-MALE(GBH-254-SMT-40)".

Info: Changing component path "GPIO-3:" to "/55DF3F73".

Changing component "GPIO-3:/55DF3F73" pin "1" net name from "+5V" to "/+5V".

Changing component "GPIO-3:/55DF3F73" pin "2" net name from "GND" to "/GND".

Changing component "GPIO-3:/55DF3F73" pin "3" net name from "VCC" to "/VCC".

Changing component "GPIO-3:/55DF3F73" pin "4" net name from "GND" to "/GND".

Changing component "GPIO-3:/55DF3F73" pin "5" net name from "PH0" to "/PH0".

Changing component "GPIO-3:/55DF3F73" pin "6" net name from "PB3" to "/PB3".

Changing component "GPIO-3:/55DF3F73" pin "7" net name from "PH2/LED" to "/PH2/LED".

Changing component "GPIO-3:/55DF3F73" pin "8" net name from "PB4" to "/PB4".

Changing component "GPIO-3:/55DF3F73" pin "9" net name from "PH7" to "/PH7".

Changing component "GPIO-3:/55DF3F73" pin "10" net name from "PB5" to "/PB5".

Changing component "GPIO-3:/55DF3F73" pin "11" net name from "PH9" to "/PH9".

Changing component "GPIO-3:/55DF3F73" pin "12" net name from "PB6" to "/PB6".

Changing component "GPIO-3:/55DF3F73" pin "13" net name from "PH10" to "/PH10".

Changing component "GPIO-3:/55DF3F73" pin "14" net name from "PB7" to "/PB7".

Changing component "GPIO-3:/55DF3F73" pin "15" net name from "PH11/SDC3-DET#" to "/PH11/SDC3-DET#".

Changing component "GPIO-3:/55DF3F73" pin "16" net name from "PB8/SATA-PWR-EN" to "/PB8/SATA-PWR-EN".

Changing component "GPIO-3:/55DF3F73" pin "17" net name from "PH12" to "/PH12".

Changing component "GPIO-3:/55DF3F73" pin "18" net name from "PB10" to "/PB10".

Changing component "GPIO-3:/55DF3F73" pin "19" net name from "PH13" to "/PH13".

Changing component "GPIO-3:/55DF3F73" pin "20" net name from "PB11" to "/PB11".

Changing component "GPIO-3:/55DF3F73" pin "21" net name from "PH14" to "/PH14".

Changing component "GPIO-3:/55DF3F73" pin "22" net name from "PB12" to "/PB12".

Changing component "GPIO-3:/55DF3F73" pin "23" net name from "PH15" to "/PH15".

Changing component "GPIO-3:/55DF3F73" pin "24" net name from "PB13" to "/PB13".

Changing component "GPIO-3:/55DF3F73" pin "25" net name from "PH16" to "/PH16".

Changing component "GPIO-3:/55DF3F73" pin "26" net name from "PB14" to "/PB14".

Changing component "GPIO-3:/55DF3F73" pin "27" net name from "PH17" to "/PH17".

Changing component "GPIO-3:/55DF3F73" pin "28" net name from "PB15" to "/PB15".

Changing component "GPIO-3:/55DF3F73" pin "29" net name from "PH18" to "/PH18".

Changing component "GPIO-3:/55DF3F73" pin "30" net name from "PB16" to "/PB16".

Changing component "GPIO-3:/55DF3F73" pin "31" net name from "PH19" to "/PH19".

Changing component "GPIO-3:/55DF3F73" pin "32" net name from "PB17" to "/PB17".

Changing component "GPIO-3:/55DF3F73" pin "33" net name from "PH20" to "/PH20".

Changing component "GPIO-3:/55DF3F73" pin "34" net name from "PH24" to "/PH24".

Changing component "GPIO-3:/55DF3F73" pin "35" net name from "PH21" to "/PH21".

Changing component "GPIO-3:/55DF3F73" pin "36" net name from "PH25" to "/PH25".

Changing component "GPIO-3:/55DF3F73" pin "37" net name from "PH22" to "/PH22".

Changing component "GPIO-3:/55DF3F73" pin "38" net name from "PH26" to "/PH26".

Changing component "GPIO-3:/55DF3F73" pin "39" net name from "PH23" to "/PH23".

Changing component "GPIO-3:/55DF3F73" pin "40" net name from "PH27" to "/PH27".

Info: Checking netlist component footprint "HDMI233:/55DF403B:OLIMEX_CONNECTORS_HDMI-SWM-19".

Info: Changing component path "HDMI233:" to "/55DF403B".

Changing component "HDMI233:/55DF403B" pin "SH1" net name from "GND" to "/GND".

Changing component "HDMI233:/55DF403B" pin "SH2" net name from "GND" to "/GND".

Changing component "HDMI233:/55DF403B" pin "SH4" net name from "GND" to "/GND".

Changing component "HDMI233:/55DF403B" pin "SH3" net name from "GND" to "/GND".

Changing component "HDMI233:/55DF403B" pin "1" net name from "HTX2P" to "/HTX2P".

Changing component "HDMI233:/55DF403B" pin "2" net name from "GND" to "/GND".

Changing component "HDMI233:/55DF403B" pin "3" net name from "HTX2N" to "/HTX2N".

Changing component "HDMI233:/55DF403B" pin "4" net name from "HTX1P" to "/HTX1P".

Changing component "HDMI233:/55DF403B" pin "5" net name from "GND" to "/GND".

Changing component "HDMI233:/55DF403B" pin "6" net name from "HTX1N" to "/HTX1N".

Changing component "HDMI233:/55DF403B" pin "7" net name from "HTX0P" to "/HTX0P".

Changing component "HDMI233:/55DF403B" pin "8" net name from "GND" to "/GND".

Changing component "HDMI233:/55DF403B" pin "9" net name from "HTX0N" to "/HTX0N".

Changing component "HDMI233:/55DF403B" pin "10" net name from "HTXCP" to "/HTXCP".

Changing component "HDMI233:/55DF403B" pin "11" net name from "GND" to "/GND".

Changing component "HDMI233:/55DF403B" pin "12" net name from "HTXCN" to "/HTXCN".

Changing component "HDMI233:/55DF403B" pin "13" net name from "HCEC" to "/HCEC".

Changing component "HDMI233:/55DF403B" pin "14" net name from "" to "Net-(HDMI233-Pad14)".

Changing component "HDMI233:/55DF403B" pin "15" net name from "HSCL" to "/HSCL".

Changing component "HDMI233:/55DF403B" pin "16" net name from "HSDA" to "/HSDA".

Changing component "HDMI233:/55DF403B" pin "17" net name from "GND" to "/GND".

Changing component "HDMI233:/55DF403B" pin "18" net name from "HDMI_5V_SOURCE" to "/HDMI_5V_SOURCE".

Changing component "HDMI233:/55DF403B" pin "19" net name from "HHPD" to "/HHPD".

Info: Checking netlist component footprint "HEADPHONES233:/55DF4103:GOGO_PJ-W47S-05D2-LF_5PIN_V2".

Info: Changing component path "HEADPHONES233:" to "/55DF4103".

Changing component "HEADPHONES233:/55DF4103" pin "1" net name from "" to "Net-(HEADPHONES233-Pad1)".

Changing component "HEADPHONES233:/55DF4103" pin "5" net name from "N$22" to "/N$22".

Changing component "HEADPHONES233:/55DF4103" pin "2" net name from "N$25" to "/N$25".

Changing component "HEADPHONES233:/55DF4103" pin "3" net name from "N$26" to "/N$26".

Changing component "HEADPHONES233:/55DF4103" pin "4" net name from "" to "Net-(HEADPHONES233-Pad4)".

Info: Checking netlist component footprint "HOME233:/55DF41CB:GOGO_SW_TAKT3X4".

Info: Changing component path "HOME233:" to "/55DF41CB".

Changing component "HOME233:/55DF41CB" pin "1_1" net name from "HOME_BUT" to "/HOME_BUT".

Changing component "HOME233:/55DF41CB" pin "2_1" net name from "GND" to "/GND".

Info: Checking netlist component footprint "IPSOUT233:/55DF4293:GOGO_TESTPAD_40-ROUND".

Info: Changing component path "IPSOUT233:" to "/55DF4293".

Changing component "IPSOUT233:/55DF4293" pin "1" net name from "IPSOUT" to "/IPSOUT".

Info: Checking netlist component footprint "L1:/55DF435B:RCL_L0805_5MIL_DWS".

Info: Changing component path "L1:" to "/55DF435B".

Changing component "L1:/55DF435B" pin "1" net name from "N$21" to "/N$21".

Changing component "L1:/55DF435B" pin "2" net name from "VCC" to "/VCC".

Info: Checking netlist component footprint "L2:/55DF4423:RCL_L0805_5MIL_DWS".

Info: Changing component path "L2:" to "/55DF4423".

Changing component "L2:/55DF4423" pin "1" net name from "N$67" to "/N$67".

Changing component "L2:/55DF4423" pin "2" net name from "VCC" to "/VCC".

Info: Checking netlist component footprint "L3:/55DF44EB:RCL_L0805_5MIL_DWS".

Info: Changing component path "L3:" to "/55DF44EB".

Changing component "L3:/55DF44EB" pin "1" net name from "N$55" to "/N$55".

Changing component "L3:/55DF44EB" pin "2" net name from "N$56" to "/N$56".

Info: Checking netlist component footprint "L4:/55DF45B3:RCL_L0805_5MIL_DWS".

Info: Changing component path "L4:" to "/55DF45B3".

Changing component "L4:/55DF45B3" pin "1" net name from "VCC" to "/VCC".

Changing component "L4:/55DF45B3" pin "2" net name from "SD_VCC" to "/SD_VCC".

Info: Checking netlist component footprint "L5:/55DF467B:RCL_L0805_5MIL_DWS".

Info: Changing component path "L5:" to "/55DF467B".

Changing component "L5:/55DF467B" pin "1" net name from "VCC" to "/VCC".

Changing component "L5:/55DF467B" pin "2" net name from "SD_VCC1" to "/SD_VCC1".

Info: Checking netlist component footprint "L6:/55DF4743:RCL_L0805_5MIL_DWS".

Info: Changing component path "L6:" to "/55DF4743".

Changing component "L6:/55DF4743" pin "1" net name from "+5V_OTG_PWR" to "/+5V_OTG_PWR".

Changing component "L6:/55DF4743" pin "2" net name from "N$100" to "/N$100".

Info: Checking netlist component footprint "L7:/55DF480B:RCL_L0805_5MIL_DWS".

Info: Changing component path "L7:" to "/55DF480B".

Changing component "L7:/55DF480B" pin "1" net name from "GND" to "/GND".

Changing component "L7:/55DF480B" pin "2" net name from "N$266" to "/N$266".

Info: Checking netlist component footprint "L8:/55DF48D3:RCL_L0805_5MIL_DWS".

Info: Changing component path "L8:" to "/55DF48D3".

Changing component "L8:/55DF48D3" pin "1" net name from "N$192" to "/N$192".

Changing component "L8:/55DF48D3" pin "2" net name from "N$111" to "/N$111".

Info: Checking netlist component footprint "L10:/55DF499B:RCL_L0805_5MIL_DWS".

Info: Changing component path "L10:" to "/55DF499B".

Changing component "L10:/55DF499B" pin "1" net name from "N$195" to "/N$195".

Changing component "L10:/55DF499B" pin "2" net name from "N$194" to "/N$194".

Info: Checking netlist component footprint "L11:/55DF4A63:RCL_L0805_5MIL_DWS".

Info: Changing component path "L11:" to "/55DF4A63".

Changing component "L11:/55DF4A63" pin "1" net name from "GND" to "/GND".

Changing component "L11:/55DF4A63" pin "2" net name from "N$193" to "/N$193".

Info: Checking netlist component footprint "L12:/55DF4B2B:OLIMEX_DISCRET_CD32".

Info: Changing component path "L12:" to "/55DF4B2B".

Changing component "L12:/55DF4B2B" pin "1" net name from "N$127" to "/N$127".

Changing component "L12:/55DF4B2B" pin "2" net name from "N$128" to "/N$128".

Info: Checking netlist component footprint "L13:/55DF4BF3:OLIMEX_DISCRET_CD32".

Info: Changing component path "L13:" to "/55DF4BF3".

Changing component "L13:/55DF4BF3" pin "1" net name from "N$130" to "/N$130".

Changing component "L13:/55DF4BF3" pin "2" net name from "VCC/2" to "/VCC/2".

Info: Checking netlist component footprint "L14:/55DF4CBB:OLIMEX_DISCRET_CD32".

Info: Changing component path "L14:" to "/55DF4CBB".

Changing component "L14:/55DF4CBB" pin "1" net name from "N$131" to "/N$131".

Changing component "L14:/55DF4CBB" pin "2" net name from "VCCINT" to "/VCCINT".

Info: Checking netlist component footprint "L15:/55DF4D83:RCL_L0805_5MIL_DWS".

Info: Changing component path "L15:" to "/55DF4D83".

Changing component "L15:/55DF4D83" pin "1" net name from "HPOUTR" to "/HPOUTR".

Changing component "L15:/55DF4D83" pin "2" net name from "N$26" to "/N$26".

Info: Checking netlist component footprint "L16:/55DF4E4B:RCL_L0805_5MIL_DWS".

Info: Changing component path "L16:" to "/55DF4E4B".

Changing component "L16:/55DF4E4B" pin "1" net name from "HPOUTL" to "/HPOUTL".

Changing component "L16:/55DF4E4B" pin "2" net name from "N$25" to "/N$25".

Info: Checking netlist component footprint "L17:/55DF4F13:RCL_L0805_5MIL_DWS".

Info: Changing component path "L17:" to "/55DF4F13".

Changing component "L17:/55DF4F13" pin "1" net name from "HPCOM" to "/HPCOM".

Changing component "L17:/55DF4F13" pin "2" net name from "N$22" to "/N$22".

Info: Checking netlist component footprint "L18:/55DF4FDB:OLIMEX_DISCRET_CD32".

Info: Changing component path "L18:" to "/55DF4FDB".

Changing component "L18:/55DF4FDB" pin "1" net name from "N$8" to "/N$8".

Changing component "L18:/55DF4FDB" pin "2" net name from "V+" to "/V+".

Info: Checking netlist component footprint "L19:/55DF50A3:OLIMEX_DISCRET_8X8MM_3131".

Info: Changing component path "L19:" to "/55DF50A3".

Changing component "L19:/55DF50A3" pin "1" net name from "N$50" to "/N$50".

Changing component "L19:/55DF50A3" pin "2" net name from "+15V" to "/+15V".

Info: Checking netlist component footprint "L20:/55DF516B:OLIMEX_DISCRET_CD32".

Info: Changing component path "L20:" to "/55DF516B".

Changing component "L20:/55DF516B" pin "1" net name from "IPSOUT" to "/IPSOUT".

Changing component "L20:/55DF516B" pin "2" net name from "N$123" to "/N$123".

Info: Checking netlist component footprint "L21:/55DF5233:OLIMEX_DISCRET_CD32".

Info: Changing component path "L21:" to "/55DF5233".

Changing component "L21:/55DF5233" pin "1" net name from "N$64" to "/N$64".

Changing component "L21:/55DF5233" pin "2" net name from "VCC" to "/VCC".

Info: Checking netlist component footprint "LAN233:/55DF52FB:OLIMEX_CONNECTORS_RJLBC-060TC1_MILLING".

Info: Changing component path "LAN233:" to "/55DF52FB".

Changing component "LAN233:/55DF52FB" pin "1" net name from "N$39" to "/N$39".

Changing component "LAN233:/55DF52FB" pin "3" net name from "N$56" to "/N$56".

Changing component "LAN233:/55DF52FB" pin "7" net name from "N$41" to "/N$41".

Changing component "LAN233:/55DF52FB" pin "2" net name from "N$40" to "/N$40".

Changing component "LAN233:/55DF52FB" pin "6" net name from "" to "Net-(LAN233-Pad6)".

Changing component "LAN233:/55DF52FB" pin "8" net name from "N$45" to "/N$45".

Changing component "LAN233:/55DF52FB" pin "KY" net name from "N$57" to "/N$57".

Changing component "LAN233:/55DF52FB" pin "AG" net name from "VCC" to "/VCC".

Changing component "LAN233:/55DF52FB" pin "AY" net name from "N$54" to "/N$54".

Changing component "LAN233:/55DF52FB" pin "KG" net name from "N$53" to "/N$53".

Changing component "LAN233:/55DF52FB" pin "GND1" net name from "GND" to "/GND".

Changing component "LAN233:/55DF52FB" pin "GND2" net name from "GND" to "/GND".

Info: Checking netlist component footprint "LCD_CON233:/55DF53C3:CON-HARTING-ML_ML40-MALE(GBH-254-SMT-40)".

Info: Changing component path "LCD_CON233:" to "/55DF53C3".

Changing component "LCD_CON233:/55DF53C3" pin "1" net name from "+5V" to "/+5V".

Changing component "LCD_CON233:/55DF53C3" pin "2" net name from "GND" to "/GND".

Changing component "LCD_CON233:/55DF53C3" pin "3" net name from "VCC" to "/VCC".

Changing component "LCD_CON233:/55DF53C3" pin "4" net name from "GND" to "/GND".

Changing component "LCD_CON233:/55DF53C3" pin "5" net name from "LCD_D16" to "/LCD_D16".

Changing component "LCD_CON233:/55DF53C3" pin "6" net name from "LCD_D17" to "/LCD_D17".

Changing component "LCD_CON233:/55DF53C3" pin "7" net name from "LCD_D18" to "/LCD_D18".

Changing component "LCD_CON233:/55DF53C3" pin "8" net name from "LCD_D19" to "/LCD_D19".

Changing component "LCD_CON233:/55DF53C3" pin "9" net name from "LCD_D20" to "/LCD_D20".

Changing component "LCD_CON233:/55DF53C3" pin "10" net name from "LCD_D21" to "/LCD_D21".

Changing component "LCD_CON233:/55DF53C3" pin "11" net name from "LCD_D22" to "/LCD_D22".

Changing component "LCD_CON233:/55DF53C3" pin "12" net name from "LCD_D23" to "/LCD_D23".

Changing component "LCD_CON233:/55DF53C3" pin "13" net name from "LCD_D8" to "/LCD_D8".

Changing component "LCD_CON233:/55DF53C3" pin "14" net name from "LCD_D9" to "/LCD_D9".

Changing component "LCD_CON233:/55DF53C3" pin "15" net name from "LCD_D10" to "/LCD_D10".

Changing component "LCD_CON233:/55DF53C3" pin "16" net name from "LCD_D11" to "/LCD_D11".

Changing component "LCD_CON233:/55DF53C3" pin "17" net name from "LCD_D12" to "/LCD_D12".

Changing component "LCD_CON233:/55DF53C3" pin "18" net name from "LCD_D13" to "/LCD_D13".

Changing component "LCD_CON233:/55DF53C3" pin "19" net name from "LCD_D14" to "/LCD_D14".

Changing component "LCD_CON233:/55DF53C3" pin "20" net name from "LCD_D15" to "/LCD_D15".

Changing component "LCD_CON233:/55DF53C3" pin "21" net name from "LCD_D0" to "/LCD_D0".

Changing component "LCD_CON233:/55DF53C3" pin "22" net name from "LCD_D1" to "/LCD_D1".

Changing component "LCD_CON233:/55DF53C3" pin "23" net name from "LCD_D2" to "/LCD_D2".

Changing component "LCD_CON233:/55DF53C3" pin "24" net name from "LCD_D3" to "/LCD_D3".

Changing component "LCD_CON233:/55DF53C3" pin "25" net name from "LCD_D4" to "/LCD_D4".

Changing component "LCD_CON233:/55DF53C3" pin "26" net name from "LCD_D5" to "/LCD_D5".

Changing component "LCD_CON233:/55DF53C3" pin "27" net name from "LCD_D6" to "/LCD_D6".

Changing component "LCD_CON233:/55DF53C3" pin "28" net name from "LCD_D7" to "/LCD_D7".

Changing component "LCD_CON233:/55DF53C3" pin "29" net name from "LCD_HSYNC" to "/LCD_HSYNC".

Changing component "LCD_CON233:/55DF53C3" pin "30" net name from "LCD_VSYNC" to "/LCD_VSYNC".

Changing component "LCD_CON233:/55DF53C3" pin "31" net name from "LCD_CLK" to "/LCD_CLK".

Changing component "LCD_CON233:/55DF53C3" pin "32" net name from "LCD_DE" to "/LCD_DE".

Changing component "LCD_CON233:/55DF53C3" pin "33" net name from "N$229" to "/N$229".

Changing component "LCD_CON233:/55DF53C3" pin "34" net name from "N$230" to "/N$230".

Changing component "LCD_CON233:/55DF53C3" pin "35" net name from "LCD_PWR" to "/LCD_PWR".

Changing component "LCD_CON233:/55DF53C3" pin "36" net name from "PB2/PWM0" to "/PB2/PWM0".

Changing component "LCD_CON233:/55DF53C3" pin "37" net name from "TPX1" to "/TPX1".

Changing component "LCD_CON233:/55DF53C3" pin "38" net name from "TPX2" to "/TPX2".

Changing component "LCD_CON233:/55DF53C3" pin "39" net name from "TPY1" to "/TPY1".

Changing component "LCD_CON233:/55DF53C3" pin "40" net name from "TPY2" to "/TPY2".

Info: Checking netlist component footprint "LED1:/55DF548B:DOUBLE-SIDE_LED-0603".

Info: Changing component path "LED1:" to "/55DF548B".

Changing component "LED1:/55DF548B" pin "C" net name from "GND" to "/GND".

Changing component "LED1:/55DF548B" pin "A" net name from "N$231" to "/N$231".

Info: Checking netlist component footprint "LIPO_BAT233:/55DF5553:PENKO_DW02R".

Info: Changing component path "LIPO_BAT233:" to "/55DF5553".

Changing component "LIPO_BAT233:/55DF5553" pin "1" net name from "+24V" to "/+24V".

Changing component "LIPO_BAT233:/55DF5553" pin "2" net name from "GND" to "/GND".

Info: Checking netlist component footprint "MENU233:/55DF561B:GOGO_SW_TAKT3X4".

Info: Changing component path "MENU233:" to "/55DF561B".

Changing component "MENU233:/55DF561B" pin "1_1" net name from "MENU_BUT" to "/MENU_BUT".

Changing component "MENU233:/55DF561B" pin "2_1" net name from "GND" to "/GND".

Info: Checking netlist component footprint "MIC2:/55DF56E3:JUMPER_JP1".

Info: Changing component path "MIC2:" to "/55DF56E3".

Changing component "MIC2:/55DF56E3" pin "1" net name from "MICIN2" to "/MICIN2".

Changing component "MIC2:/55DF56E3" pin "2" net name from "GNDA" to "/GNDA".

Info: Checking netlist component footprint "MIC_IN233:/55DF57AB:GOGO_PJ-W47S-05D2-LF_5PIN_V2".

Info: Changing component path "MIC_IN233:" to "/55DF57AB".

Changing component "MIC_IN233:/55DF57AB" pin "1" net name from "" to "Net-(MIC_IN233-Pad1)".

Changing component "MIC_IN233:/55DF57AB" pin "5" net name from "GND" to "/GND".

Changing component "MIC_IN233:/55DF57AB" pin "2" net name from "N$16" to "/N$16".

Changing component "MIC_IN233:/55DF57AB" pin "3" net name from "N$16" to "/N$16".

Changing component "MIC_IN233:/55DF57AB" pin "4" net name from "" to "Net-(MIC_IN233-Pad4)".

Info: Checking netlist component footprint "NAND_E233:/55DF5873:JUMPER_SJ_1_SMALLER_CLOSE_10MILS".

Info: Changing component path "NAND_E233:" to "/55DF5873".

Changing component "NAND_E233:/55DF5873" pin "1" net name from "N$232" to "/N$232".

Changing component "NAND_E233:/55DF5873" pin "2" net name from "NCE0" to "/NCE0".

Info: Checking netlist component footprint "ODT1:/55DF593B:GOGO_TESTPAD_40-ROUND".

Info: Changing component path "ODT1:" to "/55DF593B".

Changing component "ODT1:/55DF593B" pin "1" net name from "ODT1" to "/ODT1".

Info: Checking netlist component footprint "PWR233:/55DF66E7:GOGO_PWR_JACK_UNI_MILLING".

Info: Changing component path "PWR233:" to "/55DF66E7".

Changing component "PWR233:/55DF66E7" pin "+" net name from "N$31" to "/N$31".

Changing component "PWR233:/55DF66E7" pin "-" net name from "GND" to "/GND".

Changing component "PWR233:/55DF66E7" pin "--" net name from "GND" to "/GND".

Info: Checking netlist component footprint "PWR_BUT233:/55DF67AF:GOGO_SW_TAKT3X4".

Info: Changing component path "PWR_BUT233:" to "/55DF67AF".

Changing component "PWR_BUT233:/55DF67AF" pin "1_1" net name from "N$38" to "/N$38".

Changing component "PWR_BUT233:/55DF67AF" pin "2_1" net name from "GND" to "/GND".

Info: Checking netlist component footprint "PWR_LED233:/55DF6877:DOUBLE-SIDE_LED-0603".

Info: Changing component path "PWR_LED233:" to "/55DF6877".

Changing component "PWR_LED233:/55DF6877" pin "C" net name from "GND" to "/GND".

Changing component "PWR_LED233:/55DF6877" pin "A" net name from "N$129" to "/N$129".

Info: Checking netlist component footprint "Q1:/55DF693F:CRYSTAL_HCX-4S".

Info: Changing component path "Q1:" to "/55DF693F".

Changing component "Q1:/55DF693F" pin "1" net name from "XTALO1" to "/XTALO1".

Changing component "Q1:/55DF693F" pin "2" net name from "XTALI1" to "/XTALI1".

Info: Checking netlist component footprint "Q2:/55DF6A07:CRYSTAL_TC26H_3_REPAIR_SMD".

Info: Changing component path "Q2:" to "/55DF6A07".

Changing component "Q2:/55DF6A07" pin "GND" net name from "GND" to "/GND".

Changing component "Q2:/55DF6A07" pin "1" net name from "N$86" to "/N$86".

Changing component "Q2:/55DF6A07" pin "2" net name from "N$116" to "/N$116".

Info: Checking netlist component footprint "Q3:/55DF6ACF:CRYSTAL_HCX-4S".

Info: Changing component path "Q3:" to "/55DF6ACF".

Changing component "Q3:/55DF6ACF" pin "1" net name from "XTALO" to "/XTALO".

Changing component "Q3:/55DF6ACF" pin "2" net name from "XTALI" to "/XTALI".

Info: Checking netlist component footprint "R1:/55DF6B97:RCL_R0603_5MIL_DWS".

Info: Changing component path "R1:" to "/55DF6B97".

Changing component "R1:/55DF6B97" pin "1" net name from "CPU-REF" to "/CPU-REF".

Changing component "R1:/55DF6B97" pin "2" net name from "V+" to "/V+".

Info: Checking netlist component footprint "R2:/55DF6C5F:RCL_R0603_5MIL_DWS".

Info: Changing component path "R2:" to "/55DF6C5F".

Changing component "R2:/55DF6C5F" pin "1" net name from "GND" to "/GND".

Changing component "R2:/55DF6C5F" pin "2" net name from "CPU-REF" to "/CPU-REF".

Info: Checking netlist component footprint "R3:/55DF6D27:RCL_R0603_5MIL_DWS".

Info: Changing component path "R3:" to "/55DF6D27".

Changing component "R3:/55DF6D27" pin "1" net name from "N$197" to "/N$197".

Changing component "R3:/55DF6D27" pin "2" net name from "VCCINT" to "/VCCINT".

Info: Checking netlist component footprint "R4:/55DF6DEF:RCL_R0603_5MIL_DWS".

Info: Changing component path "R4:" to "/55DF6DEF".

Changing component "R4:/55DF6DEF" pin "1" net name from "DDR3_RST" to "/DDR3_RST".

Changing component "R4:/55DF6DEF" pin "2" net name from "V+" to "/V+".

Info: Checking netlist component footprint "R5:/55DF6EB7:RCL_R0603_5MIL_DWS".

Info: Changing component path "R5:" to "/55DF6EB7".

Changing component "R5:/55DF6EB7" pin "1" net name from "DDR_VREF" to "/DDR_VREF".

Changing component "R5:/55DF6EB7" pin "2" net name from "CPU-REF" to "/CPU-REF".

Info: Checking netlist component footprint "R6:/55DF6F7F:RCL_R0603_5MIL_DWS".

Info: Changing component path "R6:" to "/55DF6F7F".

Changing component "R6:/55DF6F7F" pin "1" net name from "DDR_VREF" to "/DDR_VREF".

Changing component "R6:/55DF6F7F" pin "2" net name from "V+" to "/V+".

Info: Checking netlist component footprint "R7:/55DF7047:RCL_R0603_5MIL_DWS".

Info: Changing component path "R7:" to "/55DF7047".

Changing component "R7:/55DF7047" pin "1" net name from "GND" to "/GND".

Changing component "R7:/55DF7047" pin "2" net name from "N$3" to "/N$3".

Info: Checking netlist component footprint "R8:/55DF710F:RCL_R0603_5MIL_DWS".

Info: Changing component path "R8:" to "/55DF710F".

Changing component "R8:/55DF710F" pin "1" net name from "GND" to "/GND".

Changing component "R8:/55DF710F" pin "2" net name from "DDR_VREF" to "/DDR_VREF".

Info: Checking netlist component footprint "R9:/55DF71D7:RCL_R0603_5MIL_DWS".

Info: Changing component path "R9:" to "/55DF71D7".

Changing component "R9:/55DF71D7" pin "1" net name from "GND" to "/GND".

Changing component "R9:/55DF71D7" pin "2" net name from "N$5" to "/N$5".

Info: Checking netlist component footprint "R10:/55DF729F:RCL_R0603_5MIL_DWS".

Info: Changing component path "R10:" to "/55DF729F".

Changing component "R10:/55DF729F" pin "1" net name from "SDC3-CMD" to "/SDC3-CMD".

Changing component "R10:/55DF729F" pin "2" net name from "VCC" to "/VCC".

Info: Checking netlist component footprint "R11:/55DF7367:RCL_R0603_5MIL_DWS".

Info: Changing component path "R11:" to "/55DF7367".

Changing component "R11:/55DF7367" pin "1" net name from "SDC3-D3" to "/SDC3-D3".

Changing component "R11:/55DF7367" pin "2" net name from "VCC" to "/VCC".

Info: Checking netlist component footprint "R12:/55DF742F:RCL_R0402_TI".

Info: Changing component path "R12:" to "/55DF742F".

Changing component "R12:/55DF742F" pin "1" net name from "DDR3_RST" to "/DDR3_RST".

Changing component "R12:/55DF742F" pin "2" net name from "SRST" to "/SRST".

Info: Checking netlist component footprint "R13:/55DF74F7:RCL_R0603_5MIL_DWS".

Info: Changing component path "R13:" to "/55DF74F7".

Changing component "R13:/55DF74F7" pin "1" net name from "VCC" to "/VCC".

Changing component "R13:/55DF74F7" pin "2" net name from "TWI1-SCK" to "/TWI1-SCK".

Info: Checking netlist component footprint "R14:/55DF75BF:RCL_R0603_5MIL_DWS".

Info: Changing component path "R14:" to "/55DF75BF".

Changing component "R14:/55DF75BF" pin "1" net name from "TWI1-SDA" to "/TWI1-SDA".

Changing component "R14:/55DF75BF" pin "2" net name from "VCC" to "/VCC".

Info: Checking netlist component footprint "R15:/55DF7687:RCL_R0402_TI".

Info: Changing component path "R15:" to "/55DF7687".

Changing component "R15:/55DF7687" pin "1" net name from "DDR3_ODT" to "/DDR3_ODT".

Changing component "R15:/55DF7687" pin "2" net name from "ODT0" to "/ODT0".

Info: Checking netlist component footprint "R16:/55DF774F:RCL_R0603_5MIL_DWS".

Info: Changing component path "R16:" to "/55DF774F".

Changing component "R16:/55DF774F" pin "1" net name from "GND" to "/GND".

Changing component "R16:/55DF774F" pin "2" net name from "N$2" to "/N$2".

Info: Checking netlist component footprint "R17:/55DF7817:RCL_R0603_5MIL_DWS".

Info: Changing component path "R17:" to "/55DF7817".

Changing component "R17:/55DF7817" pin "1" net name from "+5V_OTG_PWR" to "/+5V_OTG_PWR".

Changing component "R17:/55DF7817" pin "2" net name from "GPIO1" to "/GPIO1".

Info: Checking netlist component footprint "R18:/55DF78DF:RCL_R0603_5MIL_DWS".

Info: Changing component path "R18:" to "/55DF78DF".

Changing component "R18:/55DF78DF" pin "1" net name from "VCC" to "/VCC".

Changing component "R18:/55DF78DF" pin "2" net name from "NRB0" to "/NRB0".

Info: Checking netlist component footprint "R19:/55DF79A7:RCL_R0603_5MIL_DWS".

Info: Changing component path "R19:" to "/55DF79A7".

Changing component "R19:/55DF79A7" pin "1" net name from "VCC" to "/VCC".

Changing component "R19:/55DF79A7" pin "2" net name from "N$232" to "/N$232".

Info: Checking netlist component footprint "R20:/55DF7A6F:RCL_R0603_5MIL_DWS".

Info: Changing component path "R20:" to "/55DF7A6F".

Changing component "R20:/55DF7A6F" pin "1" net name from "GND" to "/GND".

Changing component "R20:/55DF7A6F" pin "2" net name from "N$6" to "/N$6".

Info: Checking netlist component footprint "R21:/55DF7B37:RCL_R0603_5MIL_DWS".

Info: Changing component path "R21:" to "/55DF7B37".

Changing component "R21:/55DF7B37" pin "1" net name from "VCC" to "/VCC".

Changing component "R21:/55DF7B37" pin "2" net name from "N$124" to "/N$124".

Info: Checking netlist component footprint "R22:/55DF7BFF:RCL_R0603_5MIL_DWS".

Info: Changing component path "R22:" to "/55DF7BFF".

Changing component "R22:/55DF7BFF" pin "1" net name from "N$53" to "/N$53".

Changing component "R22:/55DF7BFF" pin "2" net name from "N$68" to "/N$68".

Info: Checking netlist component footprint "R23:/55DF7CC7:RCL_R0603_5MIL_DWS".

Info: Changing component path "R23:" to "/55DF7CC7".

Changing component "R23:/55DF7CC7" pin "1" net name from "N$84" to "/N$84".

Changing component "R23:/55DF7CC7" pin "2" net name from "VDD" to "/VDD".

Info: Checking netlist component footprint "R24:/55DF7D8F:OLIMEX_DISCRET_0603_0R".

Info: Changing component path "R24:" to "/55DF7D8F".

Changing component "R24:/55DF7D8F" pin "1" net name from "GND" to "/GND".

Changing component "R24:/55DF7D8F" pin "2" net name from "N$84" to "/N$84".

Info: Checking netlist component footprint "R25:/55DF7E57:RCL_R0603_5MIL_DWS".

Info: Changing component path "R25:" to "/55DF7E57".

Changing component "R25:/55DF7E57" pin "1" net name from "EPHY-RST#" to "/EPHY-RST#".

Changing component "R25:/55DF7E57" pin "2" net name from "N$32" to "/N$32".

Info: Checking netlist component footprint "R26:/55DF7F1F:RCL_R0603_5MIL_DWS".

Info: Changing component path "R26:" to "/55DF7F1F".

Changing component "R26:/55DF7F1F" pin "1" net name from "N$57" to "/N$57".

Changing component "R26:/55DF7F1F" pin "2" net name from "GND" to "/GND".

Info: Checking netlist component footprint "R27:/55DF7FE7:RCL_R0603_5MIL_DWS".

Info: Changing component path "R27:" to "/55DF7FE7".

Changing component "R27:/55DF7FE7" pin "1" net name from "NMI_N" to "/NMI_N".

Changing component "R27:/55DF7FE7" pin "2" net name from "N$10" to "/N$10".

Info: Checking netlist component footprint "R28:/55DF80AF:RCL_R0603_5MIL_DWS".

Info: Changing component path "R28:" to "/55DF80AF".

Changing component "R28:/55DF80AF" pin "1" net name from "RESET_N" to "/RESET_N".

Changing component "R28:/55DF80AF" pin "2" net name from "VCC" to "/VCC".

Info: Checking netlist component footprint "R29:/55DF8177:RCL_R0603_5MIL_DWS".

Info: Changing component path "R29:" to "/55DF8177".

Changing component "R29:/55DF8177" pin "1" net name from "SD0-D3" to "/SD0-D3".

Changing component "R29:/55DF8177" pin "2" net name from "VCC" to "/VCC".

Info: Checking netlist component footprint "R30:/55DF823F:RCL_R0603_5MIL_DWS".

Info: Changing component path "R30:" to "/55DF823F".

Changing component "R30:/55DF823F" pin "1" net name from "SD0-CMD" to "/SD0-CMD".

Changing component "R30:/55DF823F" pin "2" net name from "VCC" to "/VCC".

Info: Checking netlist component footprint "R31:/55DF8307:RCL_R0603_5MIL_DWS".

Info: Changing component path "R31:" to "/55DF8307".

Changing component "R31:/55DF8307" pin "1" net name from "N$85" to "/N$85".

Changing component "R31:/55DF8307" pin "2" net name from "VCC" to "/VCC".

Info: Checking netlist component footprint "R32:/55DF83CF:RCL_R0603_5MIL_DWS".

Info: Changing component path "R32:" to "/55DF83CF".

Changing component "R32:/55DF83CF" pin "1" net name from "PH2/LED" to "/PH2/LED".

Changing component "R32:/55DF83CF" pin "2" net name from "N$231" to "/N$231".

Info: Checking netlist component footprint "R33:/55DF8497:RCL_R0603_5MIL_DWS".

Info: Changing component path "R33:" to "/55DF8497".

Changing component "R33:/55DF8497" pin "1" net name from "N$58" to "/N$58".

Changing component "R33:/55DF8497" pin "2" net name from "GND" to "/GND".

Info: Checking netlist component footprint "R34:/55DF855F:OLIMEX_DISCRET_0603_0R".

Info: Changing component path "R34:" to "/55DF855F".

Changing component "R34:/55DF855F" pin "1" net name from "GNDA" to "/GNDA".

Changing component "R34:/55DF855F" pin "2" net name from "MICM" to "/MICM".

Info: Checking netlist component footprint "R35:/55DF8627:RCL_R0603_5MIL_DWS".

Info: Changing component path "R35:" to "/55DF8627".

Changing component "R35:/55DF8627" pin "1" net name from "N$190" to "/N$190".

Changing component "R35:/55DF8627" pin "2" net name from "GND" to "/GND".

Info: Checking netlist component footprint "R36:/55DF86EF:RCL_R0603_5MIL_DWS".

Info: Changing component path "R36:" to "/55DF86EF".

Changing component "R36:/55DF86EF" pin "1" net name from "N$176" to "/N$176".

Changing component "R36:/55DF86EF" pin "2" net name from "GNDA" to "/GNDA".

Info: Checking netlist component footprint "R37:/55DF87B7:RCL_R0603_5MIL_DWS".

Info: Changing component path "R37:" to "/55DF87B7".

Changing component "R37:/55DF87B7" pin "1" net name from "HSCL" to "/HSCL".

Changing component "R37:/55DF87B7" pin "2" net name from "+5V" to "/+5V".

Info: Checking netlist component footprint "R38:/55DF887F:RCL_R0603_5MIL_DWS".

Info: Changing component path "R38:" to "/55DF887F".

Changing component "R38:/55DF887F" pin "1" net name from "N$161" to "/N$161".

Changing component "R38:/55DF887F" pin "2" net name from "PH11/SDC3-DET#" to "/PH11/SDC3-DET#".

Info: Checking netlist component footprint "R39:/55DF8947:RCL_R0603_5MIL_DWS".

Info: Changing component path "R39:" to "/55DF8947".

Changing component "R39:/55DF8947" pin "1" net name from "HSDA" to "/HSDA".

Changing component "R39:/55DF8947" pin "2" net name from "+5V" to "/+5V".

Info: Checking netlist component footprint "R40:/55DF8A0F:RCL_R0603_5MIL_DWS".

Info: Changing component path "R40:" to "/55DF8A0F".

Changing component "R40:/55DF8A0F" pin "1" net name from "HHPD" to "/HHPD".

Changing component "R40:/55DF8A0F" pin "2" net name from "GND" to "/GND".

Info: Checking netlist component footprint "R41:/55DF8AD7:RCL_R0603_5MIL_DWS".

Info: Changing component path "R41:" to "/55DF8AD7".

Changing component "R41:/55DF8AD7" pin "1" net name from "+5V" to "/+5V".

Changing component "R41:/55DF8AD7" pin "2" net name from "VGA_VSYNC" to "/VGA_VSYNC".

Info: Checking netlist component footprint "R42:/55DF8B9F:RCL_R0603_5MIL_DWS".

Info: Changing component path "R42:" to "/55DF8B9F".

Changing component "R42:/55DF8B9F" pin "1" net name from "USB0-VBUSDET" to "/USB0-VBUSDET".

Changing component "R42:/55DF8B9F" pin "2" net name from "N$100" to "/N$100".

Info: Checking netlist component footprint "R43:/55DF8C67:RCL_R0603_5MIL_DWS".

Info: Changing component path "R43:" to "/55DF8C67".

Changing component "R43:/55DF8C67" pin "1" net name from "LCD_VSYNC" to "/LCD_VSYNC".

Changing component "R43:/55DF8C67" pin "2" net name from "N$11" to "/N$11".

Info: Checking netlist component footprint "R44:/55DF8D2F:RCL_R0603_5MIL_DWS".

Info: Changing component path "R44:" to "/55DF8D2F".

Changing component "R44:/55DF8D2F" pin "1" net name from "GND" to "/GND".

Changing component "R44:/55DF8D2F" pin "2" net name from "USB0-DRV" to "/USB0-DRV".

Info: Checking netlist component footprint "R45:/55DF8DF7:RCL_R0603_5MIL_DWS".

Info: Changing component path "R45:" to "/55DF8DF7".

Changing component "R45:/55DF8DF7" pin "1" net name from "GND" to "/GND".

Changing component "R45:/55DF8DF7" pin "2" net name from "N$99" to "/N$99".

Info: Checking netlist component footprint "R46:/55DF8EBF:RCL_R0603_5MIL_DWS".

Info: Changing component path "R46:" to "/55DF8EBF".

Changing component "R46:/55DF8EBF" pin "1" net name from "GND" to "/GND".

Changing component "R46:/55DF8EBF" pin "2" net name from "USB0-VBUSDET" to "/USB0-VBUSDET".

Info: Checking netlist component footprint "R47:/55DF8F87:RCL_R0603_5MIL_DWS".

Info: Changing component path "R47:" to "/55DF8F87".

Changing component "R47:/55DF8F87" pin "1" net name from "GND" to "/GND".

Changing component "R47:/55DF8F87" pin "2" net name from "USB1-DRV" to "/USB1-DRV".

Info: Checking netlist component footprint "R48:/55DF904F:RCL_R0603_5MIL_DWS".

Info: Changing component path "R48:" to "/55DF904F".

Changing component "R48:/55DF904F" pin "1" net name from "GND" to "/GND".

Changing component "R48:/55DF904F" pin "2" net name from "N$101" to "/N$101".

Info: Checking netlist component footprint "R49:/55DF9117:RCL_R0603_5MIL_DWS".

Info: Changing component path "R49:" to "/55DF9117".

Changing component "R49:/55DF9117" pin "1" net name from "N$229" to "/N$229".

Changing component "R49:/55DF9117" pin "2" net name from "PB3" to "/PB3".

Info: Checking netlist component footprint "R50:/55DF91DF:RCL_R0603_5MIL_DWS".

Info: Changing component path "R50:" to "/55DF91DF".

Changing component "R50:/55DF91DF" pin "1" net name from "N$230" to "/N$230".

Changing component "R50:/55DF91DF" pin "2" net name from "PB4" to "/PB4".

Info: Checking netlist component footprint "R51:/55DF92A7:RCL_R0603_5MIL_DWS".

Info: Changing component path "R51:" to "/55DF92A7".

Changing component "R51:/55DF92A7" pin "1" net name from "N$102" to "/N$102".

Changing component "R51:/55DF92A7" pin "2" net name from "VCC" to "/VCC".

Info: Checking netlist component footprint "R52:/55DF936F:RCL_R0603_5MIL_DWS".

Info: Changing component path "R52:" to "/55DF936F".

Changing component "R52:/55DF936F" pin "1" net name from "VCC" to "/VCC".

Changing component "R52:/55DF936F" pin "2" net name from "USB0-IDDET" to "/USB0-IDDET".

Info: Checking netlist component footprint "R53:/55DF9437:RCL_R0603_5MIL_DWS".

Info: Changing component path "R53:" to "/55DF9437".

Changing component "R53:/55DF9437" pin "1" net name from "N$105" to "/N$105".

Changing component "R53:/55DF9437" pin "2" net name from "VCCINT" to "/VCCINT".

Info: Checking netlist component footprint "R54:/55DF94FF:RCL_R0603_5MIL_DWS".

Info: Changing component path "R54:" to "/55DF94FF".

Changing component "R54:/55DF94FF" pin "1" net name from "GND" to "/GND".

Changing component "R54:/55DF94FF" pin "2" net name from "USB2-DRV" to "/USB2-DRV".

Info: Checking netlist component footprint "R55:/55DF95C7:RCL_R0603_5MIL_DWS".

Info: Changing component path "R55:" to "/55DF95C7".

Changing component "R55:/55DF95C7" pin "1" net name from "GND" to "/GND".

Changing component "R55:/55DF95C7" pin "2" net name from "N$137" to "/N$137".

Info: Checking netlist component footprint "R56:/55DF968F:RCL_R0603_5MIL_DWS".

Info: Changing component path "R56:" to "/55DF968F".

Changing component "R56:/55DF968F" pin "1" net name from "GPIO1" to "/GPIO1".

Changing component "R56:/55DF968F" pin "2" net name from "GND" to "/GND".

Info: Checking netlist component footprint "R57:/55DF9757:RCL_R0603_5MIL_DWS".

Info: Changing component path "R57:" to "/55DF9757".

Changing component "R57:/55DF9757" pin "1" net name from "N$187" to "/N$187".

Changing component "R57:/55DF9757" pin "2" net name from "VMIC" to "/VMIC".

Info: Checking netlist component footprint "R58:/55DF981F:RCL_R0603_5MIL_DWS".

Info: Changing component path "R58:" to "/55DF981F".

Changing component "R58:/55DF981F" pin "1" net name from "GND" to "/GND".

Changing component "R58:/55DF981F" pin "2" net name from "N$125" to "/N$125".

Info: Checking netlist component footprint "R59:/55DF98E7:RCL_R1206_5MIL_WS".

Info: Changing component path "R59:" to "/55DF98E7".

Changing component "R59:/55DF98E7" pin "1" net name from "N$128" to "/N$128".

Changing component "R59:/55DF98E7" pin "2" net name from "+24V" to "/+24V".

Info: Checking netlist component footprint "R60:/55DF99AF:RCL_R0603_5MIL_DWS".

Info: Changing component path "R60:" to "/55DF99AF".

Changing component "R60:/55DF99AF" pin "1" net name from "VCC" to "/VCC".

Changing component "R60:/55DF99AF" pin "2" net name from "N$78" to "/N$78".

Info: Checking netlist component footprint "R61:/55DF9A77:RCL_R0603_5MIL_DWS".

Info: Changing component path "R61:" to "/55DF9A77".

Changing component "R61:/55DF9A77" pin "1" net name from "N$187" to "/N$187".

Changing component "R61:/55DF9A77" pin "2" net name from "N$16" to "/N$16".

Info: Checking netlist component footprint "R62:/55DF9B3F:RCL_R0603_5MIL_DWS".

Info: Changing component path "R62:" to "/55DF9B3F".

Changing component "R62:/55DF9B3F" pin "1" net name from "N$134" to "/N$134".

Changing component "R62:/55DF9B3F" pin "2" net name from "+15V" to "/+15V".

Info: Checking netlist component footprint "R63:/55DF9C07:RCL_R0603_5MIL_DWS".

Info: Changing component path "R63:" to "/55DF9C07".

Changing component "R63:/55DF9C07" pin "1" net name from "N$135" to "/N$135".

Changing component "R63:/55DF9C07" pin "2" net name from "+5V_OTG_PWR" to "/+5V_OTG_PWR".

Info: Checking netlist component footprint "R64:/55DF9CCF:RCL_R0603_5MIL_DWS".

Info: Changing component path "R64:" to "/55DF9CCF".

Changing component "R64:/55DF9CCF" pin "1" net name from "GND" to "/GND".

Changing component "R64:/55DF9CCF" pin "2" net name from "N$119" to "/N$119".

Info: Checking netlist component footprint "R65:/55DF9D97:RCL_R0603_5MIL_DWS".

Info: Changing component path "R65:" to "/55DF9D97".

Changing component "R65:/55DF9D97" pin "1" net name from "N$43" to "/N$43".

Changing component "R65:/55DF9D97" pin "2" net name from "N$4" to "/N$4".

Info: Checking netlist component footprint "R66:/55DF9E5F:RCL_R0603_5MIL_DWS".

Info: Changing component path "R66:" to "/55DF9E5F".

Changing component "R66:/55DF9E5F" pin "1" net name from "N$191" to "/N$191".

Changing component "R66:/55DF9E5F" pin "2" net name from "VDD" to "/VDD".

Info: Checking netlist component footprint "R67:/55DF9F27:RCL_R0603_5MIL_DWS".

Info: Changing component path "R67:" to "/55DF9F27".

Changing component "R67:/55DF9F27" pin "1" net name from "GND" to "/GND".

Changing component "R67:/55DF9F27" pin "2" net name from "N$120" to "/N$120".

Info: Checking netlist component footprint "R68:/55DF9FEF:RCL_R0603_5MIL_DWS".

Info: Changing component path "R68:" to "/55DF9FEF".

Changing component "R68:/55DF9FEF" pin "1" net name from "N$196" to "/N$196".

Changing component "R68:/55DF9FEF" pin "2" net name from "VCCINT" to "/VCCINT".

Info: Checking netlist component footprint "R69:/55DFA0B7:OLIMEX_DISCRET_0603_0R".

Info: Changing component path "R69:" to "/55DFA0B7".

Changing component "R69:/55DFA0B7" pin "1" net name from "VPP" to "/VPP".

Changing component "R69:/55DFA0B7" pin "2" net name from "N$28" to "/N$28".

Info: Checking netlist component footprint "R70:/55DFA17F:RCL_R0603_5MIL_DWS".

Info: Changing component path "R70:" to "/55DFA17F".

Changing component "R70:/55DFA17F" pin "1" net name from "N$38" to "/N$38".

Changing component "R70:/55DFA17F" pin "2" net name from "N$139" to "/N$139".

Info: Checking netlist component footprint "R71:/55DFA247:RCL_R0603_5MIL_DWS".

Info: Changing component path "R71:" to "/55DFA247".

Changing component "R71:/55DFA247" pin "1" net name from "VDD" to "/VDD".

Changing component "R71:/55DFA247" pin "2" net name from "N$222" to "/N$222".

Info: Checking netlist component footprint "R72:/55DFA30F:RCL_R0603_5MIL_DWS".

Info: Changing component path "R72:" to "/55DFA30F".

Changing component "R72:/55DFA30F" pin "1" net name from "VCC" to "/VCC".

Changing component "R72:/55DFA30F" pin "2" net name from "N$221" to "/N$221".

Info: Checking netlist component footprint "R73:/55DFA3D7:RCL_R0603_5MIL_DWS".

Info: Changing component path "R73:" to "/55DFA3D7".

Changing component "R73:/55DFA3D7" pin "1" net name from "GND" to "/GND".

Changing component "R73:/55DFA3D7" pin "2" net name from "N$140" to "/N$140".

Info: Checking netlist component footprint "R74:/55DFA49F:RCL_R0603_5MIL_DWS".

Info: Changing component path "R74:" to "/55DFA49F".

Changing component "R74:/55DFA49F" pin "1" net name from "VCC" to "/VCC".

Changing component "R74:/55DFA49F" pin "2" net name from "N$220" to "/N$220".

Info: Checking netlist component footprint "R75:/55DFA567:RCL_R0603_5MIL_DWS".

Info: Changing component path "R75:" to "/55DFA567".

Changing component "R75:/55DFA567" pin "1" net name from "TWI0-SCK" to "/TWI0-SCK".

Changing component "R75:/55DFA567" pin "2" net name from "VCC" to "/VCC".

Info: Checking netlist component footprint "R76:/55DFA62F:RCL_R0603_5MIL_DWS".

Info: Changing component path "R76:" to "/55DFA62F".

Changing component "R76:/55DFA62F" pin "1" net name from "TWI0-SDA" to "/TWI0-SDA".

Changing component "R76:/55DFA62F" pin "2" net name from "VCC" to "/VCC".

Info: Checking netlist component footprint "R77:/55DFA6F7:RCL_R0603_5MIL_DWS".

Info: Changing component path "R77:" to "/55DFA6F7".

Changing component "R77:/55DFA6F7" pin "1" net name from "V+" to "/V+".

Changing component "R77:/55DFA6F7" pin "2" net name from "N$19" to "/N$19".

Info: Checking netlist component footprint "R78:/55DFA7BF:RCL_R0603_5MIL_DWS".

Info: Changing component path "R78:" to "/55DFA7BF".

Changing component "R78:/55DFA7BF" pin "1" net name from "N$19" to "/N$19".

Changing component "R78:/55DFA7BF" pin "2" net name from "GND" to "/GND".

Info: Checking netlist component footprint "R79:/55DFA887:RCL_R0603_5MIL_DWS".

Info: Changing component path "R79:" to "/55DFA887".

Changing component "R79:/55DFA887" pin "1" net name from "N$31" to "/N$31".

Changing component "R79:/55DFA887" pin "2" net name from "N$37" to "/N$37".

Info: Checking netlist component footprint "R80:/55DFA94F:RCL_R0603_5MIL_DWS".

Info: Changing component path "R80:" to "/55DFA94F".

Changing component "R80:/55DFA94F" pin "1" net name from "N$62" to "/N$62".

Changing component "R80:/55DFA94F" pin "2" net name from "+15V" to "/+15V".

Info: Checking netlist component footprint "R81:/55DFAA17:RCL_R0603_5MIL_DWS".

Info: Changing component path "R81:" to "/55DFAA17".

Changing component "R81:/55DFAA17" pin "1" net name from "+15V" to "/+15V".

Changing component "R81:/55DFAA17" pin "2" net name from "N$129" to "/N$129".

Info: Checking netlist component footprint "R82:/55DFAADF:RCL_R0603_5MIL_DWS".

Info: Changing component path "R82:" to "/55DFAADF".

Changing component "R82:/55DFAADF" pin "1" net name from "TWI1-SCK" to "/TWI1-SCK".

Changing component "R82:/55DFAADF" pin "2" net name from "VCC" to "/VCC".

Info: Checking netlist component footprint "R83:/55DFABA7:RCL_R0603_5MIL_DWS".

Info: Changing component path "R83:" to "/55DFABA7".

Changing component "R83:/55DFABA7" pin "1" net name from "TWI1-SDA" to "/TWI1-SDA".

Changing component "R83:/55DFABA7" pin "2" net name from "VCC" to "/VCC".

Info: Checking netlist component footprint "R84:/55DFAC6F:RCL_R0603_5MIL_DWS".

Info: Changing component path "R84:" to "/55DFAC6F".

Changing component "R84:/55DFAC6F" pin "1" net name from "SPI1-CS0" to "/SPI1-CS0".

Changing component "R84:/55DFAC6F" pin "2" net name from "VCC" to "/VCC".

Info: Checking netlist component footprint "R85:/55DFAD37:RCL_R0603_5MIL_DWS".

Info: Changing component path "R85:" to "/55DFAD37".

Changing component "R85:/55DFAD37" pin "1" net name from "N$61" to "/N$61".

Changing component "R85:/55DFAD37" pin "2" net name from "GND" to "/GND".

Info: Checking netlist component footprint "R86:/55DFADFF:RCL_R0603_5MIL_DWS".

Info: Changing component path "R86:" to "/55DFADFF".

Changing component "R86:/55DFADFF" pin "1" net name from "N$62" to "/N$62".

Changing component "R86:/55DFADFF" pin "2" net name from "GND" to "/GND".

Info: Checking netlist component footprint "R87:/55DFAEC7:OLIMEX_DISCRET_0603_0R".

Info: Changing component path "R87:" to "/55DFAEC7".

Changing component "R87:/55DFAEC7" pin "1" net name from "GND" to "/GND".

Changing component "R87:/55DFAEC7" pin "2" net name from "GNDA" to "/GNDA".

Info: Checking netlist component footprint "R88:/55DFAF8F:RCL_R0603_5MIL_DWS".

Info: Changing component path "R88:" to "/55DFAF8F".

Changing component "R88:/55DFAF8F" pin "1" net name from "N$126" to "/N$126".

Changing component "R88:/55DFAF8F" pin "2" net name from "N$23" to "/N$23".

Info: Checking netlist component footprint "R89:/55DFB057:RCL_R0603_5MIL_DWS".

Info: Changing component path "R89:" to "/55DFB057".

Changing component "R89:/55DFB057" pin "1" net name from "VCC" to "/VCC".

Changing component "R89:/55DFB057" pin "2" net name from "N$66" to "/N$66".

Info: Checking netlist component footprint "R90:/55DFB11F:RCL_R0603_5MIL_DWS".

Info: Changing component path "R90:" to "/55DFB11F".

Changing component "R90:/55DFB11F" pin "1" net name from "N$126" to "/N$126".

Changing component "R90:/55DFB11F" pin "2" net name from "GND" to "/GND".

Info: Checking netlist component footprint "R91:/55DFB1E7:RCL_R0603_5MIL_DWS".

Info: Changing component path "R91:" to "/55DFB1E7".

Changing component "R91:/55DFB1E7" pin "1" net name from "VPP" to "/VPP".

Changing component "R91:/55DFB1E7" pin "2" net name from "LRADC0" to "/LRADC0".

Info: Checking netlist component footprint "R92:/55DFB2AF:RCL_R0603_5MIL_DWS".

Info: Changing component path "R92:" to "/55DFB2AF".

Changing component "R92:/55DFB2AF" pin "1" net name from "N$66" to "/N$66".

Changing component "R92:/55DFB2AF" pin "2" net name from "GND" to "/GND".

Info: Checking netlist component footprint "R93:/55DFB377:RCL_R0603_5MIL_DWS".

Info: Changing component path "R93:" to "/55DFB377".

Changing component "R93:/55DFB377" pin "1" net name from "TWI2-SCK" to "/TWI2-SCK".

Changing component "R93:/55DFB377" pin "2" net name from "VCC" to "/VCC".

Info: Checking netlist component footprint "R94:/55DFB43F:RCL_R0603_5MIL_DWS".

Info: Changing component path "R94:" to "/55DFB43F".

Changing component "R94:/55DFB43F" pin "1" net name from "TWI2-SDA" to "/TWI2-SDA".

Changing component "R94:/55DFB43F" pin "2" net name from "VCC" to "/VCC".

Info: Checking netlist component footprint "R95:/55DFB507:RCL_R0603_5MIL_DWS".

Info: Changing component path "R95:" to "/55DFB507".

Changing component "R95:/55DFB507" pin "1" net name from "SPI2-CS0" to "/SPI2-CS0".

Changing component "R95:/55DFB507" pin "2" net name from "VCC" to "/VCC".

Info: Checking netlist component footprint "R96:/55DFB5CF:RCL_R0603_5MIL_DWS".

Info: Changing component path "R96:" to "/55DFB5CF".

Changing component "R96:/55DFB5CF" pin "1" net name from "LRADC0" to "/LRADC0".

Changing component "R96:/55DFB5CF" pin "2" net name from "VOL+_BUT" to "/VOL+_BUT".

Info: Checking netlist component footprint "R97:/55DFB697:RCL_R0603_5MIL_DWS".

Info: Changing component path "R97:" to "/55DFB697".

Changing component "R97:/55DFB697" pin "1" net name from "VOL+_BUT" to "/VOL+_BUT".

Changing component "R97:/55DFB697" pin "2" net name from "VOL-_BUT" to "/VOL-_BUT".

Info: Checking netlist component footprint "R98:/55DFB75F:RCL_R0603_5MIL_DWS".

Info: Changing component path "R98:" to "/55DFB75F".

Changing component "R98:/55DFB75F" pin "1" net name from "VOL-_BUT" to "/VOL-_BUT".

Changing component "R98:/55DFB75F" pin "2" net name from "MENU_BUT" to "/MENU_BUT".

Info: Checking netlist component footprint "R99:/55DFB827:RCL_R0603_5MIL_DWS".

Info: Changing component path "R99:" to "/55DFB827".

Changing component "R99:/55DFB827" pin "1" net name from "MENU_BUT" to "/MENU_BUT".

Changing component "R99:/55DFB827" pin "2" net name from "SEARCH_BUT" to "/SEARCH_BUT".

Info: Checking netlist component footprint "R100:/55DFB8EF:RCL_R0603_5MIL_DWS".

Info: Changing component path "R100:" to "/55DFB8EF".

Changing component "R100:/55DFB8EF" pin "1" net name from "SEARCH_BUT" to "/SEARCH_BUT".

Changing component "R100:/55DFB8EF" pin "2" net name from "HOME_BUT" to "/HOME_BUT".

Info: Checking netlist component footprint "R101:/55DFB9B7:RCL_R0603_5MIL_DWS".

Info: Changing component path "R101:" to "/55DFB9B7".

Changing component "R101:/55DFB9B7" pin "1" net name from "HOME_BUT" to "/HOME_BUT".

Changing component "R101:/55DFB9B7" pin "2" net name from "ESC_BUT" to "/ESC_BUT".

Info: Checking netlist component footprint "R102:/55DFBA7F:RCL_R0603_5MIL_DWS".

Info: Changing component path "R102:" to "/55DFBA7F".

Changing component "R102:/55DFBA7F" pin "1" net name from "ESC_BUT" to "/ESC_BUT".

Changing component "R102:/55DFBA7F" pin "2" net name from "ENTER_BUT" to "/ENTER_BUT".

Info: Checking netlist component footprint "R103:/55DFBB47:RCL_R0603_5MIL_DWS".

Info: Changing component path "R103:" to "/55DFBB47".

Changing component "R103:/55DFBB47" pin "1" net name from "LCD_HSYNC" to "/LCD_HSYNC".

Changing component "R103:/55DFBB47" pin "2" net name from "N$27" to "/N$27".

Info: Checking netlist component footprint "R104:/55DFBC0F:RCL_R0603_5MIL_DWS".

Info: Changing component path "R104:" to "/55DFBC0F".

Changing component "R104:/55DFBC0F" pin "1" net name from "+5V" to "/+5V".

Changing component "R104:/55DFBC0F" pin "2" net name from "VGA_HSYNC" to "/VGA_HSYNC".

Info: Checking netlist component footprint "R105:/55DFBCD7:RCL_R0603_5MIL_DWS".

Info: Changing component path "R105:" to "/55DFBCD7".

Changing component "R105:/55DFBCD7" pin "1" net name from "UART0-RX" to "/UART0-RX".

Changing component "R105:/55DFBCD7" pin "2" net name from "VCC" to "/VCC".

Info: Checking netlist component footprint "R106:/55DFBD9F:RCL_R0402_TI".

Info: Changing component path "R106:" to "/55DFBD9F".

Changing component "R106:/55DFBD9F" pin "1" net name from "SDQS0" to "/SDQS0".

Changing component "R106:/55DFBD9F" pin "2" net name from "DDR3_SDQS0" to "/DDR3_SDQS0".

Info: Checking netlist component footprint "R107:/55DFBE67:RCL_R0402_TI".

Info: Changing component path "R107:" to "/55DFBE67".

Changing component "R107:/55DFBE67" pin "1" net name from "SDQS0_N" to "/SDQS0_N".

Changing component "R107:/55DFBE67" pin "2" net name from "DDR3_SDQS0#" to "/DDR3_SDQS0#".

Info: Checking netlist component footprint "R108:/55DFBF2F:RCL_R0402_TI".

Info: Changing component path "R108:" to "/55DFBF2F".

Changing component "R108:/55DFBF2F" pin "1" net name from "SDQS1" to "/SDQS1".

Changing component "R108:/55DFBF2F" pin "2" net name from "DDR3_SDQS1" to "/DDR3_SDQS1".

Info: Checking netlist component footprint "R109:/55DFBFF7:RCL_R0402_TI".

Info: Changing component path "R109:" to "/55DFBFF7".

Changing component "R109:/55DFBFF7" pin "1" net name from "SDQS1_N" to "/SDQS1_N".

Changing component "R109:/55DFBFF7" pin "2" net name from "DDR3_SDQS1#" to "/DDR3_SDQS1#".

Info: Checking netlist component footprint "R110:/55DFC0BF:RCL_R0402_TI".

Info: Changing component path "R110:" to "/55DFC0BF".

Changing component "R110:/55DFC0BF" pin "1" net name from "SDQM0" to "/SDQM0".

Changing component "R110:/55DFC0BF" pin "2" net name from "DDR3_SDQM0" to "/DDR3_SDQM0".

Info: Checking netlist component footprint "R111:/55DFC187:RCL_R0402_TI".

Info: Changing component path "R111:" to "/55DFC187".

Changing component "R111:/55DFC187" pin "1" net name from "SDQM1" to "/SDQM1".

Changing component "R111:/55DFC187" pin "2" net name from "DDR3_SDQM1" to "/DDR3_SDQM1".

Info: Checking netlist component footprint "R112:/55DFC24F:RCL_R0402_TI".

Info: Changing component path "R112:" to "/55DFC24F".

Changing component "R112:/55DFC24F" pin "1" net name from "SDQM2" to "/SDQM2".

Changing component "R112:/55DFC24F" pin "2" net name from "DDR3_SDQM2" to "/DDR3_SDQM2".

Info: Checking netlist component footprint "R113:/55DFC317:RCL_R0402_TI".

Info: Changing component path "R113:" to "/55DFC317".

Changing component "R113:/55DFC317" pin "1" net name from "SDQM3" to "/SDQM3".

Changing component "R113:/55DFC317" pin "2" net name from "DDR3_SDQM3" to "/DDR3_SDQM3".

Info: Checking netlist component footprint "R114:/55DFC3DF:RCL_R0402_TI".

Info: Changing component path "R114:" to "/55DFC3DF".

Changing component "R114:/55DFC3DF" pin "1" net name from "SDQS2" to "/SDQS2".

Changing component "R114:/55DFC3DF" pin "2" net name from "DDR3_SDQS2" to "/DDR3_SDQS2".

Info: Checking netlist component footprint "R115:/55DFC4A7:RCL_R0402_TI".

Info: Changing component path "R115:" to "/55DFC4A7".

Changing component "R115:/55DFC4A7" pin "1" net name from "SDQS2_N" to "/SDQS2_N".

Changing component "R115:/55DFC4A7" pin "2" net name from "DDR3_SDQS2#" to "/DDR3_SDQS2#".

Info: Checking netlist component footprint "R116:/55DFC56F:RCL_R0402_TI".

Info: Changing component path "R116:" to "/55DFC56F".

Changing component "R116:/55DFC56F" pin "1" net name from "SDQS3" to "/SDQS3".

Changing component "R116:/55DFC56F" pin "2" net name from "DDR3_SDQS3" to "/DDR3_SDQS3".

Info: Checking netlist component footprint "R117:/55DFC637:RCL_R0402_TI".

Info: Changing component path "R117:" to "/55DFC637".

Changing component "R117:/55DFC637" pin "1" net name from "SDQS3_N" to "/SDQS3_N".

Changing component "R117:/55DFC637" pin "2" net name from "DDR3_SDQS3#" to "/DDR3_SDQS3#".

Info: Checking netlist component footprint "R118:/55DFC6FF:RCL_R0402_TI".

Info: Changing component path "R118:" to "/55DFC6FF".

Changing component "R118:/55DFC6FF" pin "1" net name from "CLK" to "/CLK".

Changing component "R118:/55DFC6FF" pin "2" net name from "SCK" to "/SCK".

Info: Checking netlist component footprint "R119:/55DFC7C7:RCL_R0402_TI".

Info: Changing component path "R119:" to "/55DFC7C7".

Changing component "R119:/55DFC7C7" pin "1" net name from "CLKN" to "/CLKN".

Changing component "R119:/55DFC7C7" pin "2" net name from "SCK#" to "/SCK#".

Info: Checking netlist component footprint "R120:/55DFC88F:RCL_R0603_5MIL_DWS".

Info: Changing component path "R120:" to "/55DFC88F".

Changing component "R120:/55DFC88F" pin "1" net name from "N$12" to "/N$12".

Changing component "R120:/55DFC88F" pin "2" net name from "GND" to "/GND".

Info: Checking netlist component footprint "R121:/55DFC957:RCL_R0603_5MIL_DWS".

Info: Changing component path "R121:" to "/55DFC957".

Changing component "R121:/55DFC957" pin "1" net name from "VCC" to "/VCC".

Changing component "R121:/55DFC957" pin "2" net name from "PC7/NRB1" to "/PC7/NRB1".

Info: Checking netlist component footprint "R122:/55DFCA1F:RCL_R0402_TI".

Info: Changing component path "R122:" to "/55DFCA1F".

Changing component "R122:/55DFCA1F" pin "1" net name from "NDQ0" to "/NDQ0".

Changing component "R122:/55DFCA1F" pin "2" net name from "TSD_D0" to "/TSD_D0".

Info: Checking netlist component footprint "R123:/55DFCAE7:RCL_R0402_TI".

Info: Changing component path "R123:" to "/55DFCAE7".

Changing component "R123:/55DFCAE7" pin "1" net name from "NDQ1" to "/NDQ1".

Changing component "R123:/55DFCAE7" pin "2" net name from "TSD_D1" to "/TSD_D1".

Info: Checking netlist component footprint "R124:/55DFCBAF:RCL_R0402_TI".

Info: Changing component path "R124:" to "/55DFCBAF".

Changing component "R124:/55DFCBAF" pin "1" net name from "NDQ2" to "/NDQ2".

Changing component "R124:/55DFCBAF" pin "2" net name from "TSD_D2" to "/TSD_D2".

Info: Checking netlist component footprint "R125:/55DFCC77:RCL_R0402_TI".

Info: Changing component path "R125:" to "/55DFCC77".

Changing component "R125:/55DFCC77" pin "1" net name from "VCC" to "/VCC".

Changing component "R125:/55DFCC77" pin "2" net name from "TSD_D2" to "/TSD_D2".

Info: Checking netlist component footprint "R126:/55DFCD3F:RCL_R0402_TI".

Info: Changing component path "R126:" to "/55DFCD3F".

Changing component "R126:/55DFCD3F" pin "1" net name from "NDQ3" to "/NDQ3".

Changing component "R126:/55DFCD3F" pin "2" net name from "TSD_D3" to "/TSD_D3".

Info: Checking netlist component footprint "R127:/55DFCE07:RCL_R0402_TI".

Info: Changing component path "R127:" to "/55DFCE07".

Changing component "R127:/55DFCE07" pin "1" net name from "PC7/NRB1" to "/PC7/NRB1".

Changing component "R127:/55DFCE07" pin "2" net name from "TSD_CLK" to "/TSD_CLK".

Info: Checking netlist component footprint "R128:/55DFCECF:RCL_R0402_TI".

Info: Changing component path "R128:" to "/55DFCECF".

Changing component "R128:/55DFCECF" pin "1" net name from "NRB0" to "/NRB0".

Changing component "R128:/55DFCECF" pin "2" net name from "TSD_CMD" to "/TSD_CMD".

Info: Checking netlist component footprint "R129:/55DFCF97:RCL_R0402_TI".

Info: Changing component path "R129:" to "/55DFCF97".

Changing component "R129:/55DFCF97" pin "1" net name from "PC24/NQS" to "/PC24/NQS".

Changing component "R129:/55DFCF97" pin "2" net name from "NAND_DQS" to "/NAND_DQS".

Info: Checking netlist component footprint "R130:/55DFD05F:RCL_R0402_TI".

Info: Changing component path "R130:" to "/55DFD05F".

Changing component "R130:/55DFD05F" pin "1" net name from "VCC" to "/VCC".

Changing component "R130:/55DFD05F" pin "2" net name from "N$20" to "/N$20".

Info: Checking netlist component footprint "R131:/55DFD127:RCL_R0402_TI".

Info: Changing component path "R131:" to "/55DFD127".

Changing component "R131:/55DFD127" pin "1" net name from "NRBO/NRB1" to "/NRBO/NRB1".

Changing component "R131:/55DFD127" pin "2" net name from "NRB0" to "/NRB0".

Info: Checking netlist component footprint "R132:/55DFD18C:RCL_R0402_TI".

Info: Changing component path "R132:" to "/55DFD18C".

Changing component "R132:/55DFD18C" pin "1" net name from "NRBO/NRB1" to "/NRBO/NRB1".

Changing component "R132:/55DFD18C" pin "2" net name from "PC7/NRB1" to "/PC7/NRB1".

Info: Checking netlist component footprint "R133:/55DFD254:RCL_R0402_TI".

Info: Changing component path "R133:" to "/55DFD254".

Changing component "R133:/55DFD254" pin "1" net name from "N$44" to "/N$44".

Changing component "R133:/55DFD254" pin "2" net name from "HPOUTR" to "/HPOUTR".

Info: Checking netlist component footprint "R134:/55DFD31C:RCL_R0402_TI".

Info: Changing component path "R134:" to "/55DFD31C".

Changing component "R134:/55DFD31C" pin "1" net name from "N$34" to "/N$34".

Changing component "R134:/55DFD31C" pin "2" net name from "HPOUTL" to "/HPOUTL".

Info: Checking netlist component footprint "R135:/55DFD3E4:RCL_R0402_TI".

Info: Changing component path "R135:" to "/55DFD3E4".

Changing component "R135:/55DFD3E4" pin "1" net name from "N$35" to "/N$35".

Changing component "R135:/55DFD3E4" pin "2" net name from "HPCOM" to "/HPCOM".

Info: Checking netlist component footprint "R136:/55DFD4AC:RCL_R0603_5MIL_DWS".

Info: Changing component path "R136:" to "/55DFD4AC".

Changing component "R136:/55DFD4AC" pin "1" net name from "N$17" to "/N$17".

Changing component "R136:/55DFD4AC" pin "2" net name from "PB8/SATA-PWR-EN" to "/PB8/SATA-PWR-EN".

Info: Checking netlist component footprint "R137:/55DFD574:RCL_R0603_5MIL_DWS".

Info: Changing component path "R137:" to "/55DFD574".

Changing component "R137:/55DFD574" pin "1" net name from "+5V" to "/+5V".

Changing component "R137:/55DFD574" pin "2" net name from "N$18" to "/N$18".

Info: Checking netlist component footprint "R138:/55DFD63C:RCL_R0603_5MIL_DWS".

Info: Changing component path "R138:" to "/55DFD63C".

Changing component "R138:/55DFD63C" pin "1" net name from "GND" to "/GND".

Changing component "R138:/55DFD63C" pin "2" net name from "N$17" to "/N$17".

Info: Checking netlist component footprint "RECOVERY233:/55DFD704:GOGO_SW_TAKT3X4".

Info: Changing component path "RECOVERY233:" to "/55DFD704".

Changing component "RECOVERY233:/55DFD704" pin "1_1" net name from "GND" to "/GND".

Changing component "RECOVERY233:/55DFD704" pin "2_1" net name from "UBOOT_SEL" to "/UBOOT_SEL".

Info: Checking netlist component footprint "RESET233:/55DFD7CC:GOGO_SW_TAKT3X4".

Info: Changing component path "RESET233:" to "/55DFD7CC".

Changing component "RESET233:/55DFD7CC" pin "1_1" net name from "IPSOUT" to "/IPSOUT".

Changing component "RESET233:/55DFD7CC" pin "2_1" net name from "N$140" to "/N$140".

Info: Checking netlist component footprint "RM1:/55DFD894:OLIMEX_DISCRET_R_MATRIX_4_0402_25X625".

Info: Changing component path "RM1:" to "/55DFD894".

Changing component "RM1:/55DFD894" pin "1.1" net name from "DQ7" to "/DQ7".

Changing component "RM1:/55DFD894" pin "1.2" net name from "SDQ7" to "/SDQ7".

Changing component "RM1:/55DFD894" pin "2.1" net name from "DQ0" to "/DQ0".

Changing component "RM1:/55DFD894" pin "2.2" net name from "SDQ0" to "/SDQ0".

Changing component "RM1:/55DFD894" pin "4.2" net name from "SDQ5" to "/SDQ5".

Changing component "RM1:/55DFD894" pin "4.1" net name from "DQ5" to "/DQ5".

Changing component "RM1:/55DFD894" pin "3.2" net name from "SDQ2" to "/SDQ2".

Changing component "RM1:/55DFD894" pin "3.1" net name from "DQ2" to "/DQ2".

Info: Checking netlist component footprint "RM2:/55DFDA88:OLIMEX_DISCRET_R_MATRIX_4_0402_25X625".

Info: Changing component path "RM2:" to "/55DFDA88".

Changing component "RM2:/55DFDA88" pin "1.1" net name from "DQ6" to "/DQ6".

Changing component "RM2:/55DFDA88" pin "1.2" net name from "SDQ6" to "/SDQ6".

Changing component "RM2:/55DFDA88" pin "2.1" net name from "DQ1" to "/DQ1".

Changing component "RM2:/55DFDA88" pin "2.2" net name from "SDQ1" to "/SDQ1".

Changing component "RM2:/55DFDA88" pin "4.2" net name from "SDQ4" to "/SDQ4".

Changing component "RM2:/55DFDA88" pin "4.1" net name from "DQ4" to "/DQ4".

Changing component "RM2:/55DFDA88" pin "3.2" net name from "SDQ3" to "/SDQ3".

Changing component "RM2:/55DFDA88" pin "3.1" net name from "DQ3" to "/DQ3".

Info: Checking netlist component footprint "RM3:/55DFDC7C:OLIMEX_DISCRET_R_MATRIX_4_0402_25X625".

Info: Changing component path "RM3:" to "/55DFDC7C".

Changing component "RM3:/55DFDC7C" pin "1.1" net name from "DQ15" to "/DQ15".

Changing component "RM3:/55DFDC7C" pin "1.2" net name from "SDQ15" to "/SDQ15".

Changing component "RM3:/55DFDC7C" pin "2.1" net name from "DQ8" to "/DQ8".

Changing component "RM3:/55DFDC7C" pin "2.2" net name from "SDQ8" to "/SDQ8".

Changing component "RM3:/55DFDC7C" pin "4.2" net name from "SDQ13" to "/SDQ13".

Changing component "RM3:/55DFDC7C" pin "4.1" net name from "DQ13" to "/DQ13".

Changing component "RM3:/55DFDC7C" pin "3.2" net name from "SDQ10" to "/SDQ10".

Changing component "RM3:/55DFDC7C" pin "3.1" net name from "DQ10" to "/DQ10".

Info: Checking netlist component footprint "RM4:/55DFDE70:OLIMEX_DISCRET_R_MATRIX_4_0402_25X625".

Info: Changing component path "RM4:" to "/55DFDE70".

Changing component "RM4:/55DFDE70" pin "1.1" net name from "DQ14" to "/DQ14".

Changing component "RM4:/55DFDE70" pin "1.2" net name from "SDQ14" to "/SDQ14".

Changing component "RM4:/55DFDE70" pin "2.1" net name from "DQ9" to "/DQ9".

Changing component "RM4:/55DFDE70" pin "2.2" net name from "SDQ9" to "/SDQ9".

Changing component "RM4:/55DFDE70" pin "4.2" net name from "SDQ12" to "/SDQ12".

Changing component "RM4:/55DFDE70" pin "4.1" net name from "DQ12" to "/DQ12".

Changing component "RM4:/55DFDE70" pin "3.2" net name from "SDQ11" to "/SDQ11".

Changing component "RM4:/55DFDE70" pin "3.1" net name from "DQ11" to "/DQ11".

Info: Checking netlist component footprint "RM5:/55DFE064:OLIMEX_DISCRET_R_MATRIX_4_0402_25X625".

Info: Changing component path "RM5:" to "/55DFE064".

Changing component "RM5:/55DFE064" pin "1.1" net name from "DQ23" to "/DQ23".

Changing component "RM5:/55DFE064" pin "1.2" net name from "SDQ23" to "/SDQ23".

Changing component "RM5:/55DFE064" pin "2.1" net name from "DQ16" to "/DQ16".

Changing component "RM5:/55DFE064" pin "2.2" net name from "SDQ16" to "/SDQ16".

Changing component "RM5:/55DFE064" pin "4.2" net name from "SDQ21" to "/SDQ21".

Changing component "RM5:/55DFE064" pin "4.1" net name from "DQ21" to "/DQ21".

Changing component "RM5:/55DFE064" pin "3.2" net name from "SDQ18" to "/SDQ18".

Changing component "RM5:/55DFE064" pin "3.1" net name from "DQ18" to "/DQ18".

Info: Checking netlist component footprint "RM6:/55DFE258:OLIMEX_DISCRET_R_MATRIX_4_0402_25X625".

Info: Changing component path "RM6:" to "/55DFE258".

Changing component "RM6:/55DFE258" pin "1.1" net name from "DQ22" to "/DQ22".

Changing component "RM6:/55DFE258" pin "1.2" net name from "SDQ22" to "/SDQ22".

Changing component "RM6:/55DFE258" pin "2.1" net name from "DQ17" to "/DQ17".

Changing component "RM6:/55DFE258" pin "2.2" net name from "SDQ17" to "/SDQ17".

Changing component "RM6:/55DFE258" pin "4.2" net name from "SDQ20" to "/SDQ20".

Changing component "RM6:/55DFE258" pin "4.1" net name from "DQ20" to "/DQ20".

Changing component "RM6:/55DFE258" pin "3.2" net name from "SDQ19" to "/SDQ19".

Changing component "RM6:/55DFE258" pin "3.1" net name from "DQ19" to "/DQ19".

Info: Checking netlist component footprint "RM7:/55DFE44C:OLIMEX_DISCRET_R_MATRIX_4_0402_25X625".

Info: Changing component path "RM7:" to "/55DFE44C".

Changing component "RM7:/55DFE44C" pin "1.1" net name from "DQ31" to "/DQ31".

Changing component "RM7:/55DFE44C" pin "1.2" net name from "SDQ31" to "/SDQ31".

Changing component "RM7:/55DFE44C" pin "2.1" net name from "DQ24" to "/DQ24".

Changing component "RM7:/55DFE44C" pin "2.2" net name from "SDQ24" to "/SDQ24".

Changing component "RM7:/55DFE44C" pin "4.2" net name from "SDQ29" to "/SDQ29".

Changing component "RM7:/55DFE44C" pin "4.1" net name from "DQ29" to "/DQ29".

Changing component "RM7:/55DFE44C" pin "3.2" net name from "SDQ26" to "/SDQ26".

Changing component "RM7:/55DFE44C" pin "3.1" net name from "DQ26" to "/DQ26".

Info: Checking netlist component footprint "RM8:/55DFE640:OLIMEX_DISCRET_R_MATRIX_4_0402_25X625".

Info: Changing component path "RM8:" to "/55DFE640".

Changing component "RM8:/55DFE640" pin "1.1" net name from "DQ30" to "/DQ30".

Changing component "RM8:/55DFE640" pin "1.2" net name from "SDQ30" to "/SDQ30".

Changing component "RM8:/55DFE640" pin "2.1" net name from "DQ25" to "/DQ25".

Changing component "RM8:/55DFE640" pin "2.2" net name from "SDQ25" to "/SDQ25".

Changing component "RM8:/55DFE640" pin "4.2" net name from "SDQ28" to "/SDQ28".

Changing component "RM8:/55DFE640" pin "4.1" net name from "DQ28" to "/DQ28".

Changing component "RM8:/55DFE640" pin "3.2" net name from "SDQ27" to "/SDQ27".

Changing component "RM8:/55DFE640" pin "3.1" net name from "DQ27" to "/DQ27".

Info: Checking netlist component footprint "RM9:/55DFE834:OLIMEX_DISCRET_R_MATRIX_4".

Info: Changing component path "RM9:" to "/55DFE834".

Changing component "RM9:/55DFE834" pin "1.1" net name from "VCC" to "/VCC".

Changing component "RM9:/55DFE834" pin "1.2" net name from "N$68" to "/N$68".

Changing component "RM9:/55DFE834" pin "2.1" net name from "GND" to "/GND".

Changing component "RM9:/55DFE834" pin "2.2" net name from "N$49" to "/N$49".

Changing component "RM9:/55DFE834" pin "4.2" net name from "N$54" to "/N$54".

Changing component "RM9:/55DFE834" pin "4.1" net name from "GND" to "/GND".

Changing component "RM9:/55DFE834" pin "3.2" net name from "N$51" to "/N$51".

Changing component "RM9:/55DFE834" pin "3.1" net name from "GND" to "/GND".

Info: Checking netlist component footprint "RM10:/55DFEA28:OLIMEX_DISCRET_R_MATRIX_4".

Info: Changing component path "RM10:" to "/55DFEA28".

Changing component "RM10:/55DFEA28" pin "1.1" net name from "EMDIO" to "/EMDIO".

Changing component "RM10:/55DFEA28" pin "1.2" net name from "VCC" to "/VCC".

Changing component "RM10:/55DFEA28" pin "2.1" net name from "N$32" to "/N$32".

Changing component "RM10:/55DFEA28" pin "2.2" net name from "VCC" to "/VCC".

Changing component "RM10:/55DFEA28" pin "3.2" net name from "GND" to "/GND".

Changing component "RM10:/55DFEA28" pin "3.1" net name from "N$13" to "/N$13".

Info: Checking netlist component footprint "RM13:/55DFEBB8:OLIMEX_DISCRET_R_MATRIX_4".

Info: Changing component path "RM13:" to "/55DFEBB8".

Changing component "RM13:/55DFEBB8" pin "1.1" net name from "N$33" to "/N$33".

Changing component "RM13:/55DFEBB8" pin "1.2" net name from "N$45" to "/N$45".

Changing component "RM13:/55DFEBB8" pin "2.1" net name from "N$33" to "/N$33".

Changing component "RM13:/55DFEBB8" pin "2.2" net name from "N$41" to "/N$41".

Changing component "RM13:/55DFEBB8" pin "4.2" net name from "N$39" to "/N$39".

Changing component "RM13:/55DFEBB8" pin "4.1" net name from "N$47" to "/N$47".

Changing component "RM13:/55DFEBB8" pin "3.2" net name from "N$40" to "/N$40".

Changing component "RM13:/55DFEBB8" pin "3.1" net name from "N$47" to "/N$47".

Info: Checking netlist component footprint "RM14:/55DFEDAC:OLIMEX_DISCRET_R_MATRIX_4".

Info: Changing component path "RM14:" to "/55DFEDAC".

Changing component "RM14:/55DFEDAC" pin "1.1" net name from "VCC" to "/VCC".

Changing component "RM14:/55DFEDAC" pin "1.2" net name from "SD0-D2" to "/SD0-D2".

Changing component "RM14:/55DFEDAC" pin "2.1" net name from "VCC" to "/VCC".

Changing component "RM14:/55DFEDAC" pin "2.2" net name from "SD0-D0" to "/SD0-D0".

Changing component "RM14:/55DFEDAC" pin "4.2" net name from "SD0-DET#" to "/SD0-DET#".

Changing component "RM14:/55DFEDAC" pin "4.1" net name from "VCC" to "/VCC".

Changing component "RM14:/55DFEDAC" pin "3.2" net name from "SD0-D1" to "/SD0-D1".

Changing component "RM14:/55DFEDAC" pin "3.1" net name from "VCC" to "/VCC".

Info: Checking netlist component footprint "RM15:/55DFEFA0:OLIMEX_DISCRET_R_MATRIX_4".

Info: Changing component path "RM15:" to "/55DFEFA0".

Changing component "RM15:/55DFEFA0" pin "1.1" net name from "SDC3-D1" to "/SDC3-D1".

Changing component "RM15:/55DFEFA0" pin "1.2" net name from "VCC" to "/VCC".

Changing component "RM15:/55DFEFA0" pin "2.1" net name from "SDC3-D0" to "/SDC3-D0".

Changing component "RM15:/55DFEFA0" pin "2.2" net name from "VCC" to "/VCC".

Changing component "RM15:/55DFEFA0" pin "4.2" net name from "VCC" to "/VCC".

Changing component "RM15:/55DFEFA0" pin "4.1" net name from "PH11/SDC3-DET#" to "/PH11/SDC3-DET#".

Changing component "RM15:/55DFEFA0" pin "3.2" net name from "VCC" to "/VCC".

Changing component "RM15:/55DFEFA0" pin "3.1" net name from "SDC3-D2" to "/SDC3-D2".

Info: Checking netlist component footprint "RM16:/55DFF194:OLIMEX_DISCRET_R_MATRIX_4_0402_25X625".

Info: Changing component path "RM16:" to "/55DFF194".

Changing component "RM16:/55DFF194" pin "1.1" net name from "DDR3_SA13" to "/DDR3_SA13".

Changing component "RM16:/55DFF194" pin "1.2" net name from "SA13" to "/SA13".

Changing component "RM16:/55DFF194" pin "2.1" net name from "DDR3_SA4" to "/DDR3_SA4".

Changing component "RM16:/55DFF194" pin "2.2" net name from "SA4" to "/SA4".

Changing component "RM16:/55DFF194" pin "4.2" net name from "SA15" to "/SA15".

Changing component "RM16:/55DFF194" pin "4.1" net name from "DDR3_SA15" to "/DDR3_SA15".

Changing component "RM16:/55DFF194" pin "3.2" net name from "SA8" to "/SA8".

Changing component "RM16:/55DFF194" pin "3.1" net name from "DDR3_SA8" to "/DDR3_SA8".

Info: Checking netlist component footprint "RM17:/55DFF388:OLIMEX_DISCRET_R_MATRIX_4_0402_25X625".

Info: Changing component path "RM17:" to "/55DFF388".

Changing component "RM17:/55DFF388" pin "1.1" net name from "DDR3_SCS0" to "/DDR3_SCS0".

Changing component "RM17:/55DFF388" pin "1.2" net name from "SCS0" to "/SCS0".

Changing component "RM17:/55DFF388" pin "2.1" net name from "DDR3_SA6" to "/DDR3_SA6".

Changing component "RM17:/55DFF388" pin "2.2" net name from "SA6" to "/SA6".

Changing component "RM17:/55DFF388" pin "4.2" net name from "SA0" to "/SA0".

Changing component "RM17:/55DFF388" pin "4.1" net name from "DDR3_SA0" to "/DDR3_SA0".

Changing component "RM17:/55DFF388" pin "3.2" net name from "SA11" to "/SA11".

Changing component "RM17:/55DFF388" pin "3.1" net name from "DDR3_SA11" to "/DDR3_SA11".

Info: Checking netlist component footprint "RM18:/55DFF57C:OLIMEX_DISCRET_R_MATRIX_4_0402_25X625".

Info: Changing component path "RM18:" to "/55DFF57C".

Changing component "RM18:/55DFF57C" pin "1.1" net name from "DDR3_SWE" to "/DDR3_SWE".

Changing component "RM18:/55DFF57C" pin "1.2" net name from "WEN" to "/WEN".

Changing component "RM18:/55DFF57C" pin "2.1" net name from "DDR3_SRAS" to "/DDR3_SRAS".

Changing component "RM18:/55DFF57C" pin "2.2" net name from "RASN" to "/RASN".

Changing component "RM18:/55DFF57C" pin "4.2" net name from "SA2" to "/SA2".

Changing component "RM18:/55DFF57C" pin "4.1" net name from "DDR3_SA2" to "/DDR3_SA2".

Changing component "RM18:/55DFF57C" pin "3.2" net name from "CASN" to "/CASN".

Changing component "RM18:/55DFF57C" pin "3.1" net name from "DDR3_SCAS" to "/DDR3_SCAS".

Info: Checking netlist component footprint "RM19:/55DFF770:OLIMEX_DISCRET_R_MATRIX_4_0402_25X625".

Info: Changing component path "RM19:" to "/55DFF770".

Changing component "RM19:/55DFF770" pin "1.1" net name from "DDR3_SA12" to "/DDR3_SA12".

Changing component "RM19:/55DFF770" pin "1.2" net name from "SA12" to "/SA12".

Changing component "RM19:/55DFF770" pin "2.1" net name from "DDR3_SA9" to "/DDR3_SA9".

Changing component "RM19:/55DFF770" pin "2.2" net name from "SA9" to "/SA9".

Changing component "RM19:/55DFF770" pin "4.2" net name from "SA1" to "/SA1".

Changing component "RM19:/55DFF770" pin "4.1" net name from "DDR3_SA1" to "/DDR3_SA1".

Changing component "RM19:/55DFF770" pin "3.2" net name from "SA14" to "/SA14".

Changing component "RM19:/55DFF770" pin "3.1" net name from "DDR3_SA14" to "/DDR3_SA14".

Info: Checking netlist component footprint "RM20:/55DFF964:OLIMEX_DISCRET_R_MATRIX_4_0402_25X625".

Info: Changing component path "RM20:" to "/55DFF964".

Changing component "RM20:/55DFF964" pin "1.1" net name from "DDR3_SA7" to "/DDR3_SA7".

Changing component "RM20:/55DFF964" pin "1.2" net name from "SA7" to "/SA7".

Changing component "RM20:/55DFF964" pin "2.1" net name from "DDR3_SA3" to "/DDR3_SA3".

Changing component "RM20:/55DFF964" pin "2.2" net name from "SA3" to "/SA3".

Changing component "RM20:/55DFF964" pin "4.2" net name from "SA5" to "/SA5".

Changing component "RM20:/55DFF964" pin "4.1" net name from "DDR3_SA5" to "/DDR3_SA5".

Changing component "RM20:/55DFF964" pin "3.2" net name from "CKE" to "/CKE".

Changing component "RM20:/55DFF964" pin "3.1" net name from "SCKE0" to "/SCKE0".

Info: Checking netlist component footprint "RM21:/55DFFB58:OLIMEX_DISCRET_R_MATRIX_4_0402_25X625".

Info: Changing component path "RM21:" to "/55DFFB58".

Changing component "RM21:/55DFFB58" pin "1.1" net name from "DDR3_SBA0" to "/DDR3_SBA0".

Changing component "RM21:/55DFFB58" pin "1.2" net name from "BA0" to "/BA0".

Changing component "RM21:/55DFFB58" pin "2.1" net name from "DDR3_SBA2" to "/DDR3_SBA2".

Changing component "RM21:/55DFFB58" pin "2.2" net name from "BA2" to "/BA2".

Changing component "RM21:/55DFFB58" pin "4.2" net name from "BA1" to "/BA1".

Changing component "RM21:/55DFFB58" pin "4.1" net name from "DDR3_SBA1" to "/DDR3_SBA1".

Changing component "RM21:/55DFFB58" pin "3.2" net name from "SA10" to "/SA10".

Changing component "RM21:/55DFFB58" pin "3.1" net name from "DDR3_SA10" to "/DDR3_SA10".

Info: Checking netlist component footprint "RM24:/55DFFD4C:OLIMEX_DISCRET_R_MATRIX_4".

Info: Changing component path "RM24:" to "/55DFFD4C".

Changing component "RM24:/55DFFD4C" pin "2.1" net name from "GND" to "/GND".

Changing component "RM24:/55DFFD4C" pin "2.2" net name from "VGA-R" to "/VGA-R".

Changing component "RM24:/55DFFD4C" pin "4.2" net name from "VGA-G" to "/VGA-G".

Changing component "RM24:/55DFFD4C" pin "4.1" net name from "GND" to "/GND".

Changing component "RM24:/55DFFD4C" pin "3.2" net name from "VGA-B" to "/VGA-B".

Changing component "RM24:/55DFFD4C" pin "3.1" net name from "GND" to "/GND".

Info: Checking netlist component footprint "RM25:/55DFFEDC:OLIMEX_DISCRET_R_MATRIX_4".

Info: Changing component path "RM25:" to "/55DFFEDC".

Changing component "RM25:/55DFFEDC" pin "1.1" net name from "PB17" to "/PB17".

Changing component "RM25:/55DFFEDC" pin "1.2" net name from "VCC" to "/VCC".

Changing component "RM25:/55DFFEDC" pin "2.1" net name from "PB15" to "/PB15".

Changing component "RM25:/55DFFEDC" pin "2.2" net name from "VCC" to "/VCC".

Changing component "RM25:/55DFFEDC" pin "3.2" net name from "VCC" to "/VCC".

Changing component "RM25:/55DFFEDC" pin "3.1" net name from "PB14" to "/PB14".

Info: Checking netlist component footprint "SATA233:/55E0006C:OLIMEX_CONNECTORS_SATA-PWA-07".

Info: Changing component path "SATA233:" to "/55E0006C".

Changing component "SATA233:/55E0006C" pin "1" net name from "GND" to "/GND".

Changing component "SATA233:/55E0006C" pin "2" net name from "N$106" to "/N$106".

Changing component "SATA233:/55E0006C" pin "3" net name from "N$112" to "/N$112".

Changing component "SATA233:/55E0006C" pin "4" net name from "GND" to "/GND".

Changing component "SATA233:/55E0006C" pin "5" net name from "N$113" to "/N$113".

Changing component "SATA233:/55E0006C" pin "6" net name from "N$114" to "/N$114".

Changing component "SATA233:/55E0006C" pin "7" net name from "GND" to "/GND".

Info: Checking netlist component footprint "SCKE1:/55E00134:GOGO_TESTPAD_40-ROUND".

Info: Changing component path "SCKE1:" to "/55E00134".

Changing component "SCKE1:/55E00134" pin "1" net name from "SCKE1" to "/SCKE1".

Info: Checking netlist component footprint "SD/MMC1:/55E001FC:OLIMEX_CONNECTORS_TFC-WPAPR-08".

Info: Changing component path "SD/MMC1:" to "/55E001FC".

Changing component "SD/MMC1:/55E001FC" pin "8" net name from "SD0-D1" to "/SD0-D1".

Changing component "SD/MMC1:/55E001FC" pin "7" net name from "SD0-D0" to "/SD0-D0".

Changing component "SD/MMC1:/55E001FC" pin "6" net name from "GND" to "/GND".

Changing component "SD/MMC1:/55E001FC" pin "5" net name from "SD0-CLK" to "/SD0-CLK".

Changing component "SD/MMC1:/55E001FC" pin "4" net name from "SD_VCC" to "/SD_VCC".

Changing component "SD/MMC1:/55E001FC" pin "3" net name from "SD0-CMD" to "/SD0-CMD".

Changing component "SD/MMC1:/55E001FC" pin "2" net name from "SD0-D3" to "/SD0-D3".

Changing component "SD/MMC1:/55E001FC" pin "1" net name from "SD0-D2" to "/SD0-D2".

Changing component "SD/MMC1:/55E001FC" pin "10" net name from "N$58" to "/N$58".

Changing component "SD/MMC1:/55E001FC" pin "11" net name from "N$58" to "/N$58".

Changing component "SD/MMC1:/55E001FC" pin "12" net name from "N$58" to "/N$58".

Changing component "SD/MMC1:/55E001FC" pin "13" net name from "N$58" to "/N$58".

Changing component "SD/MMC1:/55E001FC" pin "9" net name from "SD0-DET#" to "/SD0-DET#".

Info: Checking netlist component footprint "SD/MMC2:/55E002C4:OLIMEX_CONNECTORS_SD_CARD".

Info: Changing component path "SD/MMC2:" to "/55E002C4".

Changing component "SD/MMC2:/55E002C4" pin "4" net name from "SD_VCC1" to "/SD_VCC1".

Changing component "SD/MMC2:/55E002C4" pin "5" net name from "SDC3-CLK" to "/SDC3-CLK".

Changing component "SD/MMC2:/55E002C4" pin "6" net name from "GND" to "/GND".

Changing component "SD/MMC2:/55E002C4" pin "7" net name from "SDC3-D0" to "/SDC3-D0".

Changing component "SD/MMC2:/55E002C4" pin "8" net name from "SDC3-D1" to "/SDC3-D1".

Changing component "SD/MMC2:/55E002C4" pin "WP" net name from "GND" to "/GND".

Changing component "SD/MMC2:/55E002C4" pin "3" net name from "GND" to "/GND".

Changing component "SD/MMC2:/55E002C4" pin "CD" net name from "N$161" to "/N$161".

Changing component "SD/MMC2:/55E002C4" pin "2" net name from "SDC3-CMD" to "/SDC3-CMD".

Changing component "SD/MMC2:/55E002C4" pin "1" net name from "SDC3-D3" to "/SDC3-D3".

Changing component "SD/MMC2:/55E002C4" pin "9" net name from "SDC3-D2" to "/SDC3-D2".

Changing component "SD/MMC2:/55E002C4" pin "SH1" net name from "GND" to "/GND".

Changing component "SD/MMC2:/55E002C4" pin "SH2" net name from "GND" to "/GND".

Info: Checking netlist component footprint "SEARCH233:/55E0038C:GOGO_SW_TAKT3X4".

Info: Changing component path "SEARCH233:" to "/55E0038C".

Changing component "SEARCH233:/55E0038C" pin "1_1" net name from "SEARCH_BUT" to "/SEARCH_BUT".

Changing component "SEARCH233:/55E0038C" pin "2_1" net name from "GND" to "/GND".

Info: Checking netlist component footprint "T1:/55E00454:SEMICON-SMD-IPC_SOT23".

Info: Changing component path "T1:" to "/55E00454".

Changing component "T1:/55E00454" pin "3" net name from "N$18" to "/N$18".

Changing component "T1:/55E00454" pin "2" net name from "GND" to "/GND".

Changing component "T1:/55E00454" pin "1" net name from "N$17" to "/N$17".

Info: Checking netlist component footprint "U1:/55E0051C:OLIMEX_IC_TFBGA441".

Info: Changing component path "U1:" to "/55E0051C".

Changing component "U1:/55E0051C" pin "A1" net name from "PH15" to "/PH15".

Changing component "U1:/55E0051C" pin "A2" net name from "PH13" to "/PH13".

Changing component "U1:/55E0051C" pin "A3" net name from "PH10" to "/PH10".

Changing component "U1:/55E0051C" pin "A4" net name from "USB1-DRV" to "/USB1-DRV".

Changing component "U1:/55E0051C" pin "A5" net name from "USB2-DRV" to "/USB2-DRV".

Changing component "U1:/55E0051C" pin "A6" net name from "PH0" to "/PH0".

Changing component "U1:/55E0051C" pin "A7" net name from "UART0-TX" to "/UART0-TX".

Changing component "U1:/55E0051C" pin "A8" net name from "TWI1-SCK" to "/TWI1-SCK".

Changing component "U1:/55E0051C" pin "A9" net name from "PB16" to "/PB16".

Changing component "U1:/55E0051C" pin "A10" net name from "PB14" to "/PB14".

Changing component "U1:/55E0051C" pin "A11" net name from "PB8/SATA-PWR-EN" to "/PB8/SATA-PWR-EN".

Changing component "U1:/55E0051C" pin "A12" net name from "PB6" to "/PB6".

Changing component "U1:/55E0051C" pin "A13" net name from "PB4" to "/PB4".

Changing component "U1:/55E0051C" pin "A14" net name from "PB2/PWM0" to "/PB2/PWM0".

Changing component "U1:/55E0051C" pin "A15" net name from "TWI0-SCK" to "/TWI0-SCK".

Changing component "U1:/55E0051C" pin "A16" net name from "SDC3-D2" to "/SDC3-D2".

Changing component "U1:/55E0051C" pin "A17" net name from "SDC3-D0" to "/SDC3-D0".

Changing component "U1:/55E0051C" pin "A18" net name from "SDC3-CMD" to "/SDC3-CMD".

Changing component "U1:/55E0051C" pin "A19" net name from "PI2" to "/PI2".

Changing component "U1:/55E0051C" pin "A20" net name from "PI0" to "/PI0".

Changing component "U1:/55E0051C" pin "A21" net name from "PE11" to "/PE11".

Changing component "U1:/55E0051C" pin "A22" net name from "PE9" to "/PE9".

Changing component "U1:/55E0051C" pin "A23" net name from "PE8" to "/PE8".

Changing component "U1:/55E0051C" pin "B1" net name from "PH16" to "/PH16".

Changing component "U1:/55E0051C" pin "B2" net name from "PH14" to "/PH14".

Changing component "U1:/55E0051C" pin "B3" net name from "PH11/SDC3-DET#" to "/PH11/SDC3-DET#".

Changing component "U1:/55E0051C" pin "B4" net name from "PH7" to "/PH7".

Changing component "U1:/55E0051C" pin "B5" net name from "USB0-IDDET" to "/USB0-IDDET".

Changing component "U1:/55E0051C" pin "B6" net name from "SD0-DET#" to "/SD0-DET#".

Changing component "U1:/55E0051C" pin "B7" net name from "UART0-RX" to "/UART0-RX".

Changing component "U1:/55E0051C" pin "B8" net name from "TWI1-SDA" to "/TWI1-SDA".

Changing component "U1:/55E0051C" pin "B9" net name from "PB17" to "/PB17".

Changing component "U1:/55E0051C" pin "B10" net name from "PB15" to "/PB15".

Changing component "U1:/55E0051C" pin "B11" net name from "PB13" to "/PB13".

Changing component "U1:/55E0051C" pin "B12" net name from "PB7" to "/PB7".

Changing component "U1:/55E0051C" pin "B13" net name from "PB5" to "/PB5".

Changing component "U1:/55E0051C" pin "B14" net name from "PB3" to "/PB3".

Changing component "U1:/55E0051C" pin "B15" net name from "TWI0-SDA" to "/TWI0-SDA".

Changing component "U1:/55E0051C" pin "B16" net name from "SDC3-D3" to "/SDC3-D3".

Changing component "U1:/55E0051C" pin "B17" net name from "SDC3-D1" to "/SDC3-D1".

Changing component "U1:/55E0051C" pin "B18" net name from "SDC3-CLK" to "/SDC3-CLK".

Changing component "U1:/55E0051C" pin "B19" net name from "PI3" to "/PI3".

Changing component "U1:/55E0051C" pin "B20" net name from "PI1" to "/PI1".

Changing component "U1:/55E0051C" pin "B21" net name from "PE10" to "/PE10".

Changing component "U1:/55E0051C" pin "B22" net name from "PE7" to "/PE7".

Changing component "U1:/55E0051C" pin "B23" net name from "PE6" to "/PE6".

Changing component "U1:/55E0051C" pin "C1" net name from "PH17" to "/PH17".

Changing component "U1:/55E0051C" pin "C2" net name from "PH18" to "/PH18".

Changing component "U1:/55E0051C" pin "C3" net name from "PH12" to "/PH12".

Changing component "U1:/55E0051C" pin "C4" net name from "LCD_PWR" to "/LCD_PWR".

Changing component "U1:/55E0051C" pin "C5" net name from "USB0-VBUSDET" to "/USB0-VBUSDET".

Changing component "U1:/55E0051C" pin "C6" net name from "PH2/LED" to "/PH2/LED".

Changing component "U1:/55E0051C" pin "C7" net name from "TWI2-SDA" to "/TWI2-SDA".

Changing component "U1:/55E0051C" pin "C8" net name from "TWI2-SCK" to "/TWI2-SCK".

Changing component "U1:/55E0051C" pin "C9" net name from "PB12" to "/PB12".

Changing component "U1:/55E0051C" pin "C10" net name from "PB11" to "/PB11".

Changing component "U1:/55E0051C" pin "C11" net name from "PB10" to "/PB10".

Changing component "U1:/55E0051C" pin "C12" net name from "USB0-DRV" to "/USB0-DRV".

Changing component "U1:/55E0051C" pin "C13" net name from "EPHY-RST#" to "/EPHY-RST#".

Changing component "U1:/55E0051C" pin "C14" net name from "RESET_N" to "/RESET_N".

Changing component "U1:/55E0051C" pin "C15" net name from "PI14" to "/PI14".

Changing component "U1:/55E0051C" pin "C16" net name from "UART6-TX" to "/UART6-TX".

Changing component "U1:/55E0051C" pin "C17" net name from "PI10" to "/PI10".

Changing component "U1:/55E0051C" pin "C18" net name from "PG11" to "/PG11".

Changing component "U1:/55E0051C" pin "C19" net name from "PG9" to "/PG9".

Changing component "U1:/55E0051C" pin "C20" net name from "PG7" to "/PG7".

Changing component "U1:/55E0051C" pin "C21" net name from "PG5" to "/PG5".

Changing component "U1:/55E0051C" pin "C22" net name from "PE5" to "/PE5".

Changing component "U1:/55E0051C" pin "C23" net name from "PE4" to "/PE4".

Changing component "U1:/55E0051C" pin "D1" net name from "PH19" to "/PH19".

Changing component "U1:/55E0051C" pin "D2" net name from "PH20" to "/PH20".

Changing component "U1:/55E0051C" pin "D3" net name from "PH21" to "/PH21".

Changing component "U1:/55E0051C" pin "D4" net name from "PH9" to "/PH9".

Changing component "U1:/55E0051C" pin "D5" net name from "ERXD3" to "/ERXD3".

Changing component "U1:/55E0051C" pin "D6" net name from "ERXD1" to "/ERXD1".

Changing component "U1:/55E0051C" pin "D7" net name from "ETXD3" to "/ETXD3".

Changing component "U1:/55E0051C" pin "D8" net name from "ETXD1" to "/ETXD1".

Changing component "U1:/55E0051C" pin "D9" net name from "ERXCK" to "/ERXCK".

Changing component "U1:/55E0051C" pin "D10" net name from "ERXDV" to "/ERXDV".

Changing component "U1:/55E0051C" pin "D11" net name from "EMDIO" to "/EMDIO".

Changing component "U1:/55E0051C" pin "D12" net name from "ETXCK" to "/ETXCK".

Changing component "U1:/55E0051C" pin "D13" net name from "ECOL" to "/ECOL".

Changing component "U1:/55E0051C" pin "D14" net name from "SPI1-MISO" to "/SPI1-MISO".

Changing component "U1:/55E0051C" pin "D15" net name from "PI15" to "/PI15".

Changing component "U1:/55E0051C" pin "D16" net name from "UART6-RX" to "/UART6-RX".

Changing component "U1:/55E0051C" pin "D17" net name from "PI11" to "/PI11".

Changing component "U1:/55E0051C" pin "D18" net name from "PG10" to "/PG10".

Changing component "U1:/55E0051C" pin "D19" net name from "PG8" to "/PG8".

Changing component "U1:/55E0051C" pin "D20" net name from "PG4" to "/PG4".

Changing component "U1:/55E0051C" pin "D21" net name from "PG3" to "/PG3".

Changing component "U1:/55E0051C" pin "D22" net name from "PE3" to "/PE3".

Changing component "U1:/55E0051C" pin "D23" net name from "PE2" to "/PE2".

Changing component "U1:/55E0051C" pin "E1" net name from "PH22" to "/PH22".

Changing component "U1:/55E0051C" pin "E2" net name from "PH23" to "/PH23".

Changing component "U1:/55E0051C" pin "E3" net name from "PH24" to "/PH24".

Changing component "U1:/55E0051C" pin "E4" net name from "PH25" to "/PH25".

Changing component "U1:/55E0051C" pin "E5" net name from "ERXD2" to "/ERXD2".

Changing component "U1:/55E0051C" pin "E6" net name from "ERXD0" to "/ERXD0".

Changing component "U1:/55E0051C" pin "E7" net name from "ETXD2" to "/ETXD2".

Changing component "U1:/55E0051C" pin "E8" net name from "ETXD0" to "/ETXD0".

Changing component "U1:/55E0051C" pin "E9" net name from "ERXERR" to "/ERXERR".

Changing component "U1:/55E0051C" pin "E10" net name from "EMDC" to "/EMDC".

Changing component "U1:/55E0051C" pin "E11" net name from "ETXEN" to "/ETXEN".

Changing component "U1:/55E0051C" pin "E12" net name from "ECRS" to "/ECRS".

Changing component "U1:/55E0051C" pin "E13" net name from "UART7-RX" to "/UART7-RX".

Changing component "U1:/55E0051C" pin "E14" net name from "UART7-TX" to "/UART7-TX".

Changing component "U1:/55E0051C" pin "E15" net name from "SPI1-MOSI" to "/SPI1-MOSI".

Changing component "U1:/55E0051C" pin "E16" net name from "SPI1-CLK" to "/SPI1-CLK".

Changing component "U1:/55E0051C" pin "E17" net name from "SPI1-CS0" to "/SPI1-CS0".

Changing component "U1:/55E0051C" pin "E18" net name from "LDO4_2.8V" to "/LDO4_2.8V".

Changing component "U1:/55E0051C" pin "E19" net name from "PG6" to "/PG6".

Changing component "U1:/55E0051C" pin "E20" net name from "PG2" to "/PG2".

Changing component "U1:/55E0051C" pin "E21" net name from "PG1" to "/PG1".

Changing component "U1:/55E0051C" pin "E22" net name from "PE1" to "/PE1".

Changing component "U1:/55E0051C" pin "E23" net name from "PE0" to "/PE0".

Changing component "U1:/55E0051C" pin "F1" net name from "N$86" to "/N$86".

Changing component "U1:/55E0051C" pin "F2" net name from "N$116" to "/N$116".

Changing component "U1:/55E0051C" pin "F3" net name from "PH26" to "/PH26".

Changing component "U1:/55E0051C" pin "F4" net name from "PH27" to "/PH27".

Changing component "U1:/55E0051C" pin "F5" net name from "NMI_N" to "/NMI_N".

Changing component "U1:/55E0051C" pin "F19" net name from "LDO3_2.8V" to "/LDO3_2.8V".

Changing component "U1:/55E0051C" pin "F20" net name from "PG0" to "/PG0".

Changing component "U1:/55E0051C" pin "F21" net name from "PC24/NQS" to "/PC24/NQS".

Changing component "U1:/55E0051C" pin "F22" net name from "PC18" to "/PC18".

Changing component "U1:/55E0051C" pin "F23" net name from "PC17" to "/PC17".

Changing component "U1:/55E0051C" pin "G1" net name from "DDR3_SDQM3" to "/DDR3_SDQM3".

Changing component "U1:/55E0051C" pin "G2" net name from "SDQ30" to "/SDQ30".

Changing component "U1:/55E0051C" pin "G3" net name from "GND" to "/GND".

Changing component "U1:/55E0051C" pin "G4" net name from "GND" to "/GND".

Changing component "U1:/55E0051C" pin "G5" net name from "V+" to "/V+".

Changing component "U1:/55E0051C" pin "G19" net name from "PC23" to "/PC23".

Changing component "U1:/55E0051C" pin "G20" net name from "NDQ7" to "/NDQ7".

Changing component "U1:/55E0051C" pin "G21" net name from "NDQ6" to "/NDQ6".

Changing component "U1:/55E0051C" pin "G22" net name from "NDQ3" to "/NDQ3".

Changing component "U1:/55E0051C" pin "G23" net name from "NDQ2" to "/NDQ2".

Changing component "U1:/55E0051C" pin "H1" net name from "SDQ25" to "/SDQ25".

Changing component "U1:/55E0051C" pin "H2" net name from "SDQ27" to "/SDQ27".

Changing component "U1:/55E0051C" pin "H3" net name from "CPU-REF" to "/CPU-REF".

Changing component "U1:/55E0051C" pin "H4" net name from "CPU-REF" to "/CPU-REF".

Changing component "U1:/55E0051C" pin "H5" net name from "V+" to "/V+".

Changing component "U1:/55E0051C" pin "H8" net name from "VCC" to "/VCC".

Changing component "U1:/55E0051C" pin "H9" net name from "VCC" to "/VCC".

Changing component "U1:/55E0051C" pin "H10" net name from "VCC" to "/VCC".

Changing component "U1:/55E0051C" pin "H11" net name from "VCC/2" to "/VCC/2".

Changing component "U1:/55E0051C" pin "H12" net name from "VCC/2" to "/VCC/2".

Changing component "U1:/55E0051C" pin "H13" net name from "VCC/2" to "/VCC/2".

Changing component "U1:/55E0051C" pin "H14" net name from "VCC/2" to "/VCC/2".

Changing component "U1:/55E0051C" pin "H15" net name from "VCC" to "/VCC".

Changing component "U1:/55E0051C" pin "H16" net name from "GND" to "/GND".

Changing component "U1:/55E0051C" pin "H19" net name from "VCC" to "/VCC".

Changing component "U1:/55E0051C" pin "H20" net name from "NDQ5" to "/NDQ5".

Changing component "U1:/55E0051C" pin "H21" net name from "NDQ4" to "/NDQ4".

Changing component "U1:/55E0051C" pin "H22" net name from "NDQ1" to "/NDQ1".

Changing component "U1:/55E0051C" pin "H23" net name from "NDQ0" to "/NDQ0".

Changing component "U1:/55E0051C" pin "J1" net name from "SDQ28" to "/SDQ28".

Changing component "U1:/55E0051C" pin "J2" net name from "DDR3_SDQS3#" to "/DDR3_SDQS3#".

Changing component "U1:/55E0051C" pin "J3" net name from "ODT1" to "/ODT1".

Changing component "U1:/55E0051C" pin "J4" net name from "SCKE1" to "/SCKE1".

Changing component "U1:/55E0051C" pin "J5" net name from "GND" to "/GND".

Changing component "U1:/55E0051C" pin "J8" net name from "VCC" to "/VCC".

Changing component "U1:/55E0051C" pin "J9" net name from "VCC" to "/VCC".

Changing component "U1:/55E0051C" pin "J10" net name from "VCC" to "/VCC".

Changing component "U1:/55E0051C" pin "J11" net name from "GND" to "/GND".

Changing component "U1:/55E0051C" pin "J12" net name from "VCC/2" to "/VCC/2".

Changing component "U1:/55E0051C" pin "J13" net name from "VCC/2" to "/VCC/2".

Changing component "U1:/55E0051C" pin "J14" net name from "VCC" to "/VCC".

Changing component "U1:/55E0051C" pin "J15" net name from "VCCINT" to "/VCCINT".

Changing component "U1:/55E0051C" pin "J16" net name from "VCCINT" to "/VCCINT".

Changing component "U1:/55E0051C" pin "J19" net name from "VCC" to "/VCC".

Changing component "U1:/55E0051C" pin "J20" net name from "SPI2-MISO" to "/SPI2-MISO".

Changing component "U1:/55E0051C" pin "J21" net name from "SPI2-MOSI" to "/SPI2-MOSI".

Changing component "U1:/55E0051C" pin "J22" net name from "PC7/NRB1" to "/PC7/NRB1".

Changing component "U1:/55E0051C" pin "J23" net name from "NRB0" to "/NRB0".

Changing component "U1:/55E0051C" pin "K1" net name from "DDR3_SDQS3" to "/DDR3_SDQS3".

Changing component "U1:/55E0051C" pin "K2" net name from "SDQ31" to "/SDQ31".

Changing component "U1:/55E0051C" pin "K3" net name from "DDR3_SBA0" to "/DDR3_SBA0".

Changing component "U1:/55E0051C" pin "K4" net name from "DDR3_SBA2" to "/DDR3_SBA2".

Changing component "U1:/55E0051C" pin "K5" net name from "GND" to "/GND".

Changing component "U1:/55E0051C" pin "K8" net name from "VDD_RTC" to "/VDD_RTC".

Changing component "U1:/55E0051C" pin "K9" net name from "VCCINT" to "/VCCINT".

Changing component "U1:/55E0051C" pin "K10" net name from "VCCINT" to "/VCCINT".

Changing component "U1:/55E0051C" pin "K11" net name from "GND" to "/GND".

Changing component "U1:/55E0051C" pin "K12" net name from "GND" to "/GND".

Changing component "U1:/55E0051C" pin "K13" net name from "GND" to "/GND".

Changing component "U1:/55E0051C" pin "K14" net name from "GND" to "/GND".

Changing component "U1:/55E0051C" pin "K15" net name from "VCCINT" to "/VCCINT".

Changing component "U1:/55E0051C" pin "K16" net name from "N$105" to "/N$105".

Changing component "U1:/55E0051C" pin "K19" net name from "SD0-D2" to "/SD0-D2".

Changing component "U1:/55E0051C" pin "K20" net name from "SD0-D3" to "/SD0-D3".

Changing component "U1:/55E0051C" pin "K21" net name from "SPI2-CLK" to "/SPI2-CLK".

Changing component "U1:/55E0051C" pin "K22" net name from "NRE" to "/NRE".

Changing component "U1:/55E0051C" pin "K23" net name from "NCE0" to "/NCE0".

Changing component "U1:/55E0051C" pin "L1" net name from "SDQ24" to "/SDQ24".

Changing component "U1:/55E0051C" pin "L2" net name from "SDQ26" to "/SDQ26".

Changing component "U1:/55E0051C" pin "L3" net name from "DDR3_SA10" to "/DDR3_SA10".

Changing component "U1:/55E0051C" pin "L4" net name from "DDR3_SBA1" to "/DDR3_SBA1".

Changing component "U1:/55E0051C" pin "L5" net name from "V+" to "/V+".

Changing component "U1:/55E0051C" pin "L8" net name from "VCCINT" to "/VCCINT".

Changing component "U1:/55E0051C" pin "L9" net name from "VCCINT" to "/VCCINT".

Changing component "U1:/55E0051C" pin "L10" net name from "GND" to "/GND".

Changing component "U1:/55E0051C" pin "L11" net name from "GND" to "/GND".

Changing component "U1:/55E0051C" pin "L12" net name from "GND" to "/GND".

Changing component "U1:/55E0051C" pin "L13" net name from "GND" to "/GND".

Changing component "U1:/55E0051C" pin "L14" net name from "GND" to "/GND".

Changing component "U1:/55E0051C" pin "L15" net name from "N$102" to "/N$102".

Changing component "U1:/55E0051C" pin "L16" net name from "N$102" to "/N$102".

Changing component "U1:/55E0051C" pin "L19" net name from "SD0-CMD" to "/SD0-CMD".

Changing component "U1:/55E0051C" pin "L20" net name from "SD0-CLK" to "/SD0-CLK".

Changing component "U1:/55E0051C" pin "L21" net name from "SPI2-CS0" to "/SPI2-CS0".

Changing component "U1:/55E0051C" pin "L22" net name from "PC3/NCE1" to "/PC3/NCE1".

Changing component "U1:/55E0051C" pin "L23" net name from "NCLE" to "/NCLE".

Changing component "U1:/55E0051C" pin "M1" net name from "SDQ29" to "/SDQ29".

Changing component "U1:/55E0051C" pin "M2" net name from "SDQ23" to "/SDQ23".

Changing component "U1:/55E0051C" pin "M3" net name from "DDR3_SA7" to "/DDR3_SA7".

Changing component "U1:/55E0051C" pin "M4" net name from "DDR3_SA3" to "/DDR3_SA3".

Changing component "U1:/55E0051C" pin "M5" net name from "V+" to "/V+".

Changing component "U1:/55E0051C" pin "M8" net name from "N$197" to "/N$197".

Changing component "U1:/55E0051C" pin "M9" net name from "GND" to "/GND".

Changing component "U1:/55E0051C" pin "M10" net name from "GND" to "/GND".

Changing component "U1:/55E0051C" pin "M11" net name from "GND" to "/GND".

Changing component "U1:/55E0051C" pin "M12" net name from "GND" to "/GND".

Changing component "U1:/55E0051C" pin "M13" net name from "GND" to "/GND".

Changing component "U1:/55E0051C" pin "M14" net name from "GND" to "/GND".

Changing component "U1:/55E0051C" pin "M15" net name from "N$196" to "/N$196".

Changing component "U1:/55E0051C" pin "M16" net name from "N$196" to "/N$196".

Changing component "U1:/55E0051C" pin "M19" net name from "SD0-D0" to "/SD0-D0".

Changing component "U1:/55E0051C" pin "M20" net name from "SD0-D1" to "/SD0-D1".

Changing component "U1:/55E0051C" pin "M21" net name from "PC16" to "/PC16".

Changing component "U1:/55E0051C" pin "M22" net name from "NALE" to "/NALE".

Changing component "U1:/55E0051C" pin "M23" net name from "NWE" to "/NWE".

Changing component "U1:/55E0051C" pin "N1" net name from "SDQ16" to "/SDQ16".

Changing component "U1:/55E0051C" pin "N2" net name from "SDQ18" to "/SDQ18".

Changing component "U1:/55E0051C" pin "N3" net name from "SCKE0" to "/SCKE0".

Changing component "U1:/55E0051C" pin "N4" net name from "DDR3_SA5" to "/DDR3_SA5".

Changing component "U1:/55E0051C" pin "N5" net name from "GND" to "/GND".

Changing component "U1:/55E0051C" pin "N8" net name from "ADBG" to "/ADBG".

Changing component "U1:/55E0051C" pin "N9" net name from "N$197" to "/N$197".

Changing component "U1:/55E0051C" pin "N10" net name from "GND" to "/GND".

Changing component "U1:/55E0051C" pin "N11" net name from "GND" to "/GND".

Changing component "U1:/55E0051C" pin "N12" net name from "GND" to "/GND".

Changing component "U1:/55E0051C" pin "N13" net name from "GND" to "/GND".

Changing component "U1:/55E0051C" pin "N14" net name from "GND" to "/GND".

Changing component "U1:/55E0051C" pin "N15" net name from "N$191" to "/N$191".

Changing component "U1:/55E0051C" pin "N16" net name from "N$191" to "/N$191".

Changing component "U1:/55E0051C" pin "N19" net name from "VCC" to "/VCC".

Changing component "U1:/55E0051C" pin "N20" net name from "UDM0" to "/UDM0".

Changing component "U1:/55E0051C" pin "N21" net name from "UDP0" to "/UDP0".

Changing component "U1:/55E0051C" pin "N22" net name from "XTALO" to "/XTALO".

Changing component "U1:/55E0051C" pin "N23" net name from "XTALI" to "/XTALI".

Changing component "U1:/55E0051C" pin "P1" net name from "SDQ21" to "/SDQ21".

Changing component "U1:/55E0051C" pin "P2" net name from "DDR3_SDQS2#" to "/DDR3_SDQS2#".

Changing component "U1:/55E0051C" pin "P3" net name from "DDR3_SA12" to "/DDR3_SA12".

Changing component "U1:/55E0051C" pin "P4" net name from "DDR3_SA9" to "/DDR3_SA9".

Changing component "U1:/55E0051C" pin "P5" net name from "GND" to "/GND".

Changing component "U1:/55E0051C" pin "P8" net name from "SDBG0" to "/SDBG0".

Changing component "U1:/55E0051C" pin "P9" net name from "N$197" to "/N$197".

Changing component "U1:/55E0051C" pin "P10" net name from "GND" to "/GND".

Changing component "U1:/55E0051C" pin "P11" net name from "GND" to "/GND".

Changing component "U1:/55E0051C" pin "P12" net name from "GND" to "/GND".

Changing component "U1:/55E0051C" pin "P13" net name from "GND" to "/GND".

Changing component "U1:/55E0051C" pin "P14" net name from "GND" to "/GND".

Changing component "U1:/55E0051C" pin "P15" net name from "GND" to "/GND".

Changing component "U1:/55E0051C" pin "P16" net name from "N$85" to "/N$85".

Changing component "U1:/55E0051C" pin "P19" net name from "" to "Net-(U1-PadP19)".

Changing component "U1:/55E0051C" pin "P20" net name from "UDM1" to "/UDM1".

Changing component "U1:/55E0051C" pin "P21" net name from "UDP1" to "/UDP1".

Changing component "U1:/55E0051C" pin "P22" net name from "HHPD" to "/HHPD".

Changing component "U1:/55E0051C" pin "P23" net name from "HCEC" to "/HCEC".

Changing component "U1:/55E0051C" pin "R1" net name from "DDR3_SDQS2" to "/DDR3_SDQS2".

Changing component "U1:/55E0051C" pin "R2" net name from "DDR3_SDQM2" to "/DDR3_SDQM2".

Changing component "U1:/55E0051C" pin "R3" net name from "DDR3_SA14" to "/DDR3_SA14".

Changing component "U1:/55E0051C" pin "R4" net name from "DDR3_SA1" to "/DDR3_SA1".

Changing component "U1:/55E0051C" pin "R5" net name from "V+" to "/V+".

Changing component "U1:/55E0051C" pin "R8" net name from "SDBG1" to "/SDBG1".

Changing component "U1:/55E0051C" pin "R9" net name from "VCCINT" to "/VCCINT".

Changing component "U1:/55E0051C" pin "R10" net name from "VCCINT" to "/VCCINT".

Changing component "U1:/55E0051C" pin "R11" net name from "GND" to "/GND".

Changing component "U1:/55E0051C" pin "R12" net name from "GND" to "/GND".

Changing component "U1:/55E0051C" pin "R13" net name from "GND" to "/GND".

Changing component "U1:/55E0051C" pin "R14" net name from "N$79" to "/N$79".

Changing component "U1:/55E0051C" pin "R15" net name from "N$121" to "/N$121".

Changing component "U1:/55E0051C" pin "R16" net name from "" to "Net-(U1-PadR16)".

Changing component "U1:/55E0051C" pin "R19" net name from "" to "Net-(U1-PadR19)".

Changing component "U1:/55E0051C" pin "R20" net name from "UDM2" to "/UDM2".

Changing component "U1:/55E0051C" pin "R21" net name from "UDP2" to "/UDP2".

Changing component "U1:/55E0051C" pin "R22" net name from "HSDA" to "/HSDA".

Changing component "U1:/55E0051C" pin "R23" net name from "HSCL" to "/HSCL".

Changing component "U1:/55E0051C" pin "T1" net name from "SDQ22" to "/SDQ22".

Changing component "U1:/55E0051C" pin "T2" net name from "SDQ17" to "/SDQ17".

Changing component "U1:/55E0051C" pin "T3" net name from "DDR3_SWE" to "/DDR3_SWE".

Changing component "U1:/55E0051C" pin "T4" net name from "DDR3_SRAS" to "/DDR3_SRAS".

Changing component "U1:/55E0051C" pin "T5" net name from "V+" to "/V+".

Changing component "U1:/55E0051C" pin "T8" net name from "VCCINT" to "/VCCINT".

Changing component "U1:/55E0051C" pin "T9" net name from "N$84" to "/N$84".

Changing component "U1:/55E0051C" pin "T10" net name from "N$190" to "/N$190".

Changing component "U1:/55E0051C" pin "T11" net name from "GND" to "/GND".

Changing component "U1:/55E0051C" pin "T12" net name from "GND" to "/GND".

Changing component "U1:/55E0051C" pin "T13" net name from "N$78" to "/N$78".

Changing component "U1:/55E0051C" pin "T14" net name from "N$80" to "/N$80".

Changing component "U1:/55E0051C" pin "T15" net name from "" to "Net-(U1-PadT15)".

Changing component "U1:/55E0051C" pin "T16" net name from "N$115" to "/N$115".

Changing component "U1:/55E0051C" pin "T19" net name from "VPP" to "/VPP".

Changing component "U1:/55E0051C" pin "T20" net name from "SATA-TXP" to "/SATA-TXP".

Changing component "U1:/55E0051C" pin "T21" net name from "SATA-TXM" to "/SATA-TXM".

Changing component "U1:/55E0051C" pin "T22" net name from "HTX2N" to "/HTX2N".

Changing component "U1:/55E0051C" pin "T23" net name from "HTX2P" to "/HTX2P".

Changing component "U1:/55E0051C" pin "U1" net name from "SDQ19" to "/SDQ19".

Changing component "U1:/55E0051C" pin "U2" net name from "SDQ20" to "/SDQ20".

Changing component "U1:/55E0051C" pin "U3" net name from "DDR3_SCAS" to "/DDR3_SCAS".

Changing component "U1:/55E0051C" pin "U4" net name from "DDR3_SA2" to "/DDR3_SA2".

Changing component "U1:/55E0051C" pin "U5" net name from "GND" to "/GND".

Changing component "U1:/55E0051C" pin "U19" net name from "GND" to "/GND".

Changing component "U1:/55E0051C" pin "U20" net name from "SATA-RXM" to "/SATA-RXM".

Changing component "U1:/55E0051C" pin "U21" net name from "SATA-RXP" to "/SATA-RXP".

Changing component "U1:/55E0051C" pin "U22" net name from "HTX1N" to "/HTX1N".

Changing component "U1:/55E0051C" pin "U23" net name from "HTX1P" to "/HTX1P".

Changing component "U1:/55E0051C" pin "V1" net name from "SCK" to "/SCK".

Changing component "U1:/55E0051C" pin "V2" net name from "SCK#" to "/SCK#".

Changing component "U1:/55E0051C" pin "V3" net name from "DDR3_SCS0" to "/DDR3_SCS0".

Changing component "U1:/55E0051C" pin "V4" net name from "DDR3_SA6" to "/DDR3_SA6".

Changing component "U1:/55E0051C" pin "V5" net name from "GND" to "/GND".

Changing component "U1:/55E0051C" pin "V19" net name from "GND" to "/GND".

Changing component "U1:/55E0051C" pin "V20" net name from "N$176" to "/N$176".

Changing component "U1:/55E0051C" pin "V21" net name from "N$119" to "/N$119".

Changing component "U1:/55E0051C" pin "V22" net name from "HTX0N" to "/HTX0N".

Changing component "U1:/55E0051C" pin "V23" net name from "HTX0P" to "/HTX0P".

Changing component "U1:/55E0051C" pin "W1" net name from "DDR3_SDQM1" to "/DDR3_SDQM1".

Changing component "U1:/55E0051C" pin "W2" net name from "SDQ14" to "/SDQ14".

Changing component "U1:/55E0051C" pin "W3" net name from "DDR3_SA11" to "/DDR3_SA11".

Changing component "U1:/55E0051C" pin "W4" net name from "DDR3_SA0" to "/DDR3_SA0".

Changing component "U1:/55E0051C" pin "W5" net name from "V+" to "/V+".

Changing component "U1:/55E0051C" pin "W6" net name from "V+" to "/V+".

Changing component "U1:/55E0051C" pin "W7" net name from "V+" to "/V+".

Changing component "U1:/55E0051C" pin "W8" net name from "UBOOT_SEL" to "/UBOOT_SEL".

Changing component "U1:/55E0051C" pin "W9" net name from "GND" to "/GND".

Changing component "U1:/55E0051C" pin "W10" net name from "GND" to "/GND".

Changing component "U1:/55E0051C" pin "W11" net name from "GND" to "/GND".

Changing component "U1:/55E0051C" pin "W12" net name from "VCC" to "/VCC".

Changing component "U1:/55E0051C" pin "W13" net name from "VCC" to "/VCC".

Changing component "U1:/55E0051C" pin "W14" net name from "VCC" to "/VCC".

Changing component "U1:/55E0051C" pin "W15" net name from "N$221" to "/N$221".

Changing component "U1:/55E0051C" pin "W16" net name from "N$220" to "/N$220".

Changing component "U1:/55E0051C" pin "W17" net name from "N$222" to "/N$222".

Changing component "U1:/55E0051C" pin "W18" net name from "GND" to "/GND".

Changing component "U1:/55E0051C" pin "W19" net name from "HPOUTR" to "/HPOUTR".

Changing component "U1:/55E0051C" pin "W20" net name from "N$133" to "/N$133".

Changing component "U1:/55E0051C" pin "W21" net name from "N$122" to "/N$122".

Changing component "U1:/55E0051C" pin "W22" net name from "HTXCN" to "/HTXCN".

Changing component "U1:/55E0051C" pin "W23" net name from "HTXCP" to "/HTXCP".

Changing component "U1:/55E0051C" pin "AA1" net name from "SDQ12" to "/SDQ12".

Changing component "U1:/55E0051C" pin "AA2" net name from "DDR3_SDQS1#" to "/DDR3_SDQS1#".

Changing component "U1:/55E0051C" pin "AA3" net name from "DDR3_SA8" to "/DDR3_SA8".

Changing component "U1:/55E0051C" pin "AA4" net name from "DDR3_SA15" to "/DDR3_SA15".

Changing component "U1:/55E0051C" pin "AA5" net name from "ODT0" to "/ODT0".

Changing component "U1:/55E0051C" pin "AA6" net name from "SRST" to "/SRST".

Changing component "U1:/55E0051C" pin "AA7" net name from "N$2" to "/N$2".

Changing component "U1:/55E0051C" pin "AA8" net name from "CPU-REF" to "/CPU-REF".

Changing component "U1:/55E0051C" pin "AA9" net name from "LCD_DE" to "/LCD_DE".

Changing component "U1:/55E0051C" pin "AA10" net name from "LCD_D21" to "/LCD_D21".

Changing component "U1:/55E0051C" pin "AA11" net name from "LCD_D19" to "/LCD_D19".

Changing component "U1:/55E0051C" pin "AA12" net name from "LCD_D17" to "/LCD_D17".

Changing component "U1:/55E0051C" pin "AA13" net name from "LCD_D15" to "/LCD_D15".

Changing component "U1:/55E0051C" pin "AA14" net name from "LCD_D13" to "/LCD_D13".

Changing component "U1:/55E0051C" pin "AA15" net name from "LCD_D11" to "/LCD_D11".

Changing component "U1:/55E0051C" pin "AA16" net name from "N$42" to "/N$42".

Changing component "U1:/55E0051C" pin "AA17" net name from "TVIN2" to "/TVIN2".

Changing component "U1:/55E0051C" pin "AA18" net name from "GND" to "/GND".

Changing component "U1:/55E0051C" pin "AA19" net name from "HPCOM" to "/HPCOM".

Changing component "U1:/55E0051C" pin "AA20" net name from "HPCOM" to "/HPCOM".

Changing component "U1:/55E0051C" pin "AA21" net name from "VMIC" to "/VMIC".

Changing component "U1:/55E0051C" pin "AA22" net name from "TPX2" to "/TPX2".

Changing component "U1:/55E0051C" pin "AA23" net name from "TPY2" to "/TPY2".

Changing component "U1:/55E0051C" pin "Y1" net name from "SDQ9" to "/SDQ9".

Changing component "U1:/55E0051C" pin "Y2" net name from "SDQ11" to "/SDQ11".

Changing component "U1:/55E0051C" pin "Y3" net name from "DDR3_SA13" to "/DDR3_SA13".

Changing component "U1:/55E0051C" pin "Y4" net name from "DDR3_SA4" to "/DDR3_SA4".

Changing component "U1:/55E0051C" pin "Y5" net name from "CPU-REF" to "/CPU-REF".

Changing component "U1:/55E0051C" pin "Y6" net name from "V+" to "/V+".

Changing component "U1:/55E0051C" pin "Y7" net name from "GND" to "/GND".

Changing component "U1:/55E0051C" pin "Y8" net name from "GND" to "/GND".

Changing component "U1:/55E0051C" pin "Y9" net name from "LCD_CLK" to "/LCD_CLK".

Changing component "U1:/55E0051C" pin "Y10" net name from "LCD_D20" to "/LCD_D20".

Changing component "U1:/55E0051C" pin "Y11" net name from "LCD_D18" to "/LCD_D18".

Changing component "U1:/55E0051C" pin "Y12" net name from "LCD_D16" to "/LCD_D16".

Changing component "U1:/55E0051C" pin "Y13" net name from "LCD_D14" to "/LCD_D14".

Changing component "U1:/55E0051C" pin "Y14" net name from "LCD_D12" to "/LCD_D12".

Changing component "U1:/55E0051C" pin "Y15" net name from "LCD_D10" to "/LCD_D10".

Changing component "U1:/55E0051C" pin "Y16" net name from "N$223" to "/N$223".

Changing component "U1:/55E0051C" pin "Y17" net name from "TVIN3" to "/TVIN3".

Changing component "U1:/55E0051C" pin "Y18" net name from "GND" to "/GND".

Changing component "U1:/55E0051C" pin "Y19" net name from "HPOUTL" to "/HPOUTL".

Changing component "U1:/55E0051C" pin "Y20" net name from "FMINL" to "/FMINL".

Changing component "U1:/55E0051C" pin "Y21" net name from "FMINR" to "/FMINR".

Changing component "U1:/55E0051C" pin "Y22" net name from "TPX1" to "/TPX1".

Changing component "U1:/55E0051C" pin "Y23" net name from "TPY1" to "/TPY1".

Changing component "U1:/55E0051C" pin "AB1" net name from "DDR3_SDQS1" to "/DDR3_SDQS1".

Changing component "U1:/55E0051C" pin "AB2" net name from "SDQ8" to "/SDQ8".

Changing component "U1:/55E0051C" pin "AB3" net name from "SDQ13" to "/SDQ13".

Changing component "U1:/55E0051C" pin "AB4" net name from "SDQ0" to "/SDQ0".

Changing component "U1:/55E0051C" pin "AB5" net name from "SDQ5" to "/SDQ5".

Changing component "U1:/55E0051C" pin "AB6" net name from "DDR3_SDQS0" to "/DDR3_SDQS0".

Changing component "U1:/55E0051C" pin "AB7" net name from "SDQ6" to "/SDQ6".

Changing component "U1:/55E0051C" pin "AB8" net name from "SDQ3" to "/SDQ3".

Changing component "U1:/55E0051C" pin "AB9" net name from "LCD_HSYNC" to "/LCD_HSYNC".

Changing component "U1:/55E0051C" pin "AB10" net name from "LCD_D22" to "/LCD_D22".

Changing component "U1:/55E0051C" pin "AB11" net name from "LCD_D8" to "/LCD_D8".

Changing component "U1:/55E0051C" pin "AB12" net name from "LCD_D6" to "/LCD_D6".

Changing component "U1:/55E0051C" pin "AB13" net name from "LCD_D4" to "/LCD_D4".

Changing component "U1:/55E0051C" pin "AB14" net name from "LCD_D2" to "/LCD_D2".

Changing component "U1:/55E0051C" pin "AB15" net name from "LCD_D0" to "/LCD_D0".

Changing component "U1:/55E0051C" pin "AB16" net name from "VGA-B" to "/VGA-B".

Changing component "U1:/55E0051C" pin "AB17" net name from "TVOUT3" to "/TVOUT3".

Changing component "U1:/55E0051C" pin "AB18" net name from "TVIN1" to "/TVIN1".

Changing component "U1:/55E0051C" pin "AB19" net name from "VCC" to "/VCC".

Changing component "U1:/55E0051C" pin "AB20" net name from "LINEINL" to "/LINEINL".

Changing component "U1:/55E0051C" pin "AB21" net name from "LINEINR" to "/LINEINR".

Changing component "U1:/55E0051C" pin "AB22" net name from "LRADC1" to "/LRADC1".

Changing component "U1:/55E0051C" pin "AB23" net name from "LRADC0" to "/LRADC0".

Changing component "U1:/55E0051C" pin "AC1" net name from "SDQ15" to "/SDQ15".

Changing component "U1:/55E0051C" pin "AC2" net name from "SDQ10" to "/SDQ10".

Changing component "U1:/55E0051C" pin "AC3" net name from "SDQ7" to "/SDQ7".

Changing component "U1:/55E0051C" pin "AC4" net name from "SDQ2" to "/SDQ2".

Changing component "U1:/55E0051C" pin "AC5" net name from "DDR3_SDQS0#" to "/DDR3_SDQS0#".

Changing component "U1:/55E0051C" pin "AC6" net name from "DDR3_SDQM0" to "/DDR3_SDQM0".

Changing component "U1:/55E0051C" pin "AC7" net name from "SDQ1" to "/SDQ1".

Changing component "U1:/55E0051C" pin "AC8" net name from "SDQ4" to "/SDQ4".

Changing component "U1:/55E0051C" pin "AC9" net name from "LCD_VSYNC" to "/LCD_VSYNC".

Changing component "U1:/55E0051C" pin "AC10" net name from "LCD_D23" to "/LCD_D23".

Changing component "U1:/55E0051C" pin "AC11" net name from "LCD_D9" to "/LCD_D9".

Changing component "U1:/55E0051C" pin "AC12" net name from "LCD_D7" to "/LCD_D7".

Changing component "U1:/55E0051C" pin "AC13" net name from "LCD_D5" to "/LCD_D5".

Changing component "U1:/55E0051C" pin "AC14" net name from "LCD_D3" to "/LCD_D3".

Changing component "U1:/55E0051C" pin "AC15" net name from "LCD_D1" to "/LCD_D1".

Changing component "U1:/55E0051C" pin "AC16" net name from "VGA-G" to "/VGA-G".

Changing component "U1:/55E0051C" pin "AC17" net name from "VGA-R" to "/VGA-R".

Changing component "U1:/55E0051C" pin "AC18" net name from "TVIN0" to "/TVIN0".

Changing component "U1:/55E0051C" pin "AC19" net name from "N$1" to "/N$1".

Changing component "U1:/55E0051C" pin "AC20" net name from "MICIN1" to "/MICIN1".

Changing component "U1:/55E0051C" pin "AC21" net name from "MICIN2" to "/MICIN2".

Changing component "U1:/55E0051C" pin "AC22" net name from "MIC1OUTP" to "/MIC1OUTP".

Changing component "U1:/55E0051C" pin "AC23" net name from "MIC1OUTN" to "/MIC1OUTN".

Info: Checking netlist component footprint "U2:/55E005E4:OLIMEX_IC_FBGA96_MEM".

Info: Changing component path "U2:" to "/55E005E4".

Changing component "U2:/55E005E4" pin "A1" net name from "V+" to "/V+".

Changing component "U2:/55E005E4" pin "A2" net name from "DQ13" to "/DQ13".

Changing component "U2:/55E005E4" pin "A3" net name from "DQ15" to "/DQ15".

Changing component "U2:/55E005E4" pin "A7" net name from "DQ12" to "/DQ12".

Changing component "U2:/55E005E4" pin "A8" net name from "V+" to "/V+".

Changing component "U2:/55E005E4" pin "A9" net name from "GND" to "/GND".

Changing component "U2:/55E005E4" pin "B1" net name from "GND" to "/GND".

Changing component "U2:/55E005E4" pin "B2" net name from "V+" to "/V+".

Changing component "U2:/55E005E4" pin "B3" net name from "GND" to "/GND".

Changing component "U2:/55E005E4" pin "B7" net name from "SDQS1_N" to "/SDQS1_N".

Changing component "U2:/55E005E4" pin "B8" net name from "DQ14" to "/DQ14".

Changing component "U2:/55E005E4" pin "B9" net name from "GND" to "/GND".

Changing component "U2:/55E005E4" pin "C1" net name from "V+" to "/V+".

Changing component "U2:/55E005E4" pin "C2" net name from "DQ11" to "/DQ11".

Changing component "U2:/55E005E4" pin "C3" net name from "DQ9" to "/DQ9".

Changing component "U2:/55E005E4" pin "C7" net name from "SDQS1" to "/SDQS1".

Changing component "U2:/55E005E4" pin "C8" net name from "DQ10" to "/DQ10".

Changing component "U2:/55E005E4" pin "C9" net name from "V+" to "/V+".

Changing component "U2:/55E005E4" pin "D1" net name from "GND" to "/GND".

Changing component "U2:/55E005E4" pin "D2" net name from "V+" to "/V+".

Changing component "U2:/55E005E4" pin "D3" net name from "SDQM1" to "/SDQM1".

Changing component "U2:/55E005E4" pin "D7" net name from "DQ8" to "/DQ8".

Changing component "U2:/55E005E4" pin "D8" net name from "GND" to "/GND".

Changing component "U2:/55E005E4" pin "D9" net name from "V+" to "/V+".

Changing component "U2:/55E005E4" pin "E1" net name from "GND" to "/GND".

Changing component "U2:/55E005E4" pin "E2" net name from "GND" to "/GND".

Changing component "U2:/55E005E4" pin "E3" net name from "DQ0" to "/DQ0".

Changing component "U2:/55E005E4" pin "E7" net name from "SDQM0" to "/SDQM0".

Changing component "U2:/55E005E4" pin "E8" net name from "GND" to "/GND".

Changing component "U2:/55E005E4" pin "E9" net name from "V+" to "/V+".

Changing component "U2:/55E005E4" pin "F1" net name from "V+" to "/V+".

Changing component "U2:/55E005E4" pin "F2" net name from "DQ2" to "/DQ2".

Changing component "U2:/55E005E4" pin "F3" net name from "SDQS0" to "/SDQS0".

Changing component "U2:/55E005E4" pin "F7" net name from "DQ1" to "/DQ1".

Changing component "U2:/55E005E4" pin "F8" net name from "DQ3" to "/DQ3".

Changing component "U2:/55E005E4" pin "F9" net name from "GND" to "/GND".

Changing component "U2:/55E005E4" pin "G1" net name from "GND" to "/GND".

Changing component "U2:/55E005E4" pin "G2" net name from "DQ6" to "/DQ6".

Changing component "U2:/55E005E4" pin "G3" net name from "SDQS0_N" to "/SDQS0_N".

Changing component "U2:/55E005E4" pin "G7" net name from "V+" to "/V+".

Changing component "U2:/55E005E4" pin "G8" net name from "GND" to "/GND".

Changing component "U2:/55E005E4" pin "G9" net name from "GND" to "/GND".

Changing component "U2:/55E005E4" pin "H1" net name from "DDR_VREF" to "/DDR_VREF".

Changing component "U2:/55E005E4" pin "H2" net name from "V+" to "/V+".

Changing component "U2:/55E005E4" pin "H3" net name from "DQ4" to "/DQ4".

Changing component "U2:/55E005E4" pin "H7" net name from "DQ7" to "/DQ7".

Changing component "U2:/55E005E4" pin "H8" net name from "DQ5" to "/DQ5".

Changing component "U2:/55E005E4" pin "H9" net name from "V+" to "/V+".

Changing component "U2:/55E005E4" pin "J1" net name from "" to "Net-(U2-PadJ1)".

Changing component "U2:/55E005E4" pin "J2" net name from "GND" to "/GND".

Changing component "U2:/55E005E4" pin "J3" net name from "RASN" to "/RASN".

Changing component "U2:/55E005E4" pin "J7" net name from "CLK" to "/CLK".

Changing component "U2:/55E005E4" pin "J8" net name from "GND" to "/GND".

Changing component "U2:/55E005E4" pin "J9" net name from "" to "Net-(U2-PadJ9)".

Changing component "U2:/55E005E4" pin "K1" net name from "DDR3_ODT" to "/DDR3_ODT".

Changing component "U2:/55E005E4" pin "K2" net name from "V+" to "/V+".

Changing component "U2:/55E005E4" pin "K3" net name from "CASN" to "/CASN".

Changing component "U2:/55E005E4" pin "K7" net name from "CLKN" to "/CLKN".

Changing component "U2:/55E005E4" pin "K8" net name from "V+" to "/V+".

Changing component "U2:/55E005E4" pin "K9" net name from "CKE" to "/CKE".

Changing component "U2:/55E005E4" pin "L1" net name from "" to "Net-(U2-PadL1)".

Changing component "U2:/55E005E4" pin "L2" net name from "SCS0" to "/SCS0".

Changing component "U2:/55E005E4" pin "L3" net name from "WEN" to "/WEN".

Changing component "U2:/55E005E4" pin "L7" net name from "SA10" to "/SA10".

Changing component "U2:/55E005E4" pin "L8" net name from "N$3" to "/N$3".

Changing component "U2:/55E005E4" pin "L9" net name from "" to "Net-(U2-PadL9)".

Changing component "U2:/55E005E4" pin "M1" net name from "GND" to "/GND".

Changing component "U2:/55E005E4" pin "M2" net name from "BA0" to "/BA0".

Changing component "U2:/55E005E4" pin "M3" net name from "BA2" to "/BA2".

Changing component "U2:/55E005E4" pin "M7" net name from "SA15" to "/SA15".

Changing component "U2:/55E005E4" pin "M8" net name from "DDR_VREF" to "/DDR_VREF".

Changing component "U2:/55E005E4" pin "M9" net name from "GND" to "/GND".

Changing component "U2:/55E005E4" pin "N1" net name from "V+" to "/V+".

Changing component "U2:/55E005E4" pin "N2" net name from "SA3" to "/SA3".

Changing component "U2:/55E005E4" pin "N3" net name from "SA0" to "/SA0".

Changing component "U2:/55E005E4" pin "N7" net name from "SA12" to "/SA12".

Changing component "U2:/55E005E4" pin "N8" net name from "BA1" to "/BA1".

Changing component "U2:/55E005E4" pin "N9" net name from "V+" to "/V+".

Changing component "U2:/55E005E4" pin "P1" net name from "GND" to "/GND".

Changing component "U2:/55E005E4" pin "P2" net name from "SA5" to "/SA5".

Changing component "U2:/55E005E4" pin "P3" net name from "SA2" to "/SA2".

Changing component "U2:/55E005E4" pin "P7" net name from "SA1" to "/SA1".

Changing component "U2:/55E005E4" pin "P8" net name from "SA4" to "/SA4".

Changing component "U2:/55E005E4" pin "P9" net name from "GND" to "/GND".

Changing component "U2:/55E005E4" pin "R1" net name from "V+" to "/V+".

Changing component "U2:/55E005E4" pin "R2" net name from "SA7" to "/SA7".

Changing component "U2:/55E005E4" pin "R3" net name from "SA9" to "/SA9".

Changing component "U2:/55E005E4" pin "R7" net name from "SA11" to "/SA11".

Changing component "U2:/55E005E4" pin "R8" net name from "SA6" to "/SA6".

Changing component "U2:/55E005E4" pin "R9" net name from "V+" to "/V+".

Changing component "U2:/55E005E4" pin "T1" net name from "GND" to "/GND".

Changing component "U2:/55E005E4" pin "T2" net name from "DDR3_RST" to "/DDR3_RST".

Changing component "U2:/55E005E4" pin "T3" net name from "SA13" to "/SA13".

Changing component "U2:/55E005E4" pin "T7" net name from "SA14" to "/SA14".

Changing component "U2:/55E005E4" pin "T8" net name from "SA8" to "/SA8".

Changing component "U2:/55E005E4" pin "T9" net name from "GND" to "/GND".

Info: Checking netlist component footprint "U3:/55E006AC:OLIMEX_IC_FBGA96_MEM".

Info: Changing component path "U3:" to "/55E006AC".

Changing component "U3:/55E006AC" pin "A1" net name from "V+" to "/V+".

Changing component "U3:/55E006AC" pin "A2" net name from "DQ29" to "/DQ29".

Changing component "U3:/55E006AC" pin "A3" net name from "DQ31" to "/DQ31".

Changing component "U3:/55E006AC" pin "A7" net name from "DQ28" to "/DQ28".

Changing component "U3:/55E006AC" pin "A8" net name from "V+" to "/V+".

Changing component "U3:/55E006AC" pin "A9" net name from "GND" to "/GND".

Changing component "U3:/55E006AC" pin "B1" net name from "GND" to "/GND".

Changing component "U3:/55E006AC" pin "B2" net name from "V+" to "/V+".

Changing component "U3:/55E006AC" pin "B3" net name from "GND" to "/GND".

Changing component "U3:/55E006AC" pin "B7" net name from "SDQS3_N" to "/SDQS3_N".

Changing component "U3:/55E006AC" pin "B8" net name from "DQ30" to "/DQ30".

Changing component "U3:/55E006AC" pin "B9" net name from "GND" to "/GND".

Changing component "U3:/55E006AC" pin "C1" net name from "V+" to "/V+".

Changing component "U3:/55E006AC" pin "C2" net name from "DQ27" to "/DQ27".

Changing component "U3:/55E006AC" pin "C3" net name from "DQ25" to "/DQ25".

Changing component "U3:/55E006AC" pin "C7" net name from "SDQS3" to "/SDQS3".

Changing component "U3:/55E006AC" pin "C8" net name from "DQ26" to "/DQ26".

Changing component "U3:/55E006AC" pin "C9" net name from "V+" to "/V+".

Changing component "U3:/55E006AC" pin "D1" net name from "GND" to "/GND".

Changing component "U3:/55E006AC" pin "D2" net name from "V+" to "/V+".

Changing component "U3:/55E006AC" pin "D3" net name from "SDQM3" to "/SDQM3".

Changing component "U3:/55E006AC" pin "D7" net name from "DQ24" to "/DQ24".

Changing component "U3:/55E006AC" pin "D8" net name from "GND" to "/GND".

Changing component "U3:/55E006AC" pin "D9" net name from "V+" to "/V+".

Changing component "U3:/55E006AC" pin "E1" net name from "GND" to "/GND".

Changing component "U3:/55E006AC" pin "E2" net name from "GND" to "/GND".

Changing component "U3:/55E006AC" pin "E3" net name from "DQ16" to "/DQ16".

Changing component "U3:/55E006AC" pin "E7" net name from "SDQM2" to "/SDQM2".

Changing component "U3:/55E006AC" pin "E8" net name from "GND" to "/GND".

Changing component "U3:/55E006AC" pin "E9" net name from "V+" to "/V+".

Changing component "U3:/55E006AC" pin "F1" net name from "V+" to "/V+".

Changing component "U3:/55E006AC" pin "F2" net name from "DQ18" to "/DQ18".

Changing component "U3:/55E006AC" pin "F3" net name from "SDQS2" to "/SDQS2".

Changing component "U3:/55E006AC" pin "F7" net name from "DQ17" to "/DQ17".

Changing component "U3:/55E006AC" pin "F8" net name from "DQ19" to "/DQ19".

Changing component "U3:/55E006AC" pin "F9" net name from "GND" to "/GND".

Changing component "U3:/55E006AC" pin "G1" net name from "GND" to "/GND".

Changing component "U3:/55E006AC" pin "G2" net name from "DQ22" to "/DQ22".

Changing component "U3:/55E006AC" pin "G3" net name from "SDQS2_N" to "/SDQS2_N".

Changing component "U3:/55E006AC" pin "G7" net name from "V+" to "/V+".

Changing component "U3:/55E006AC" pin "G8" net name from "GND" to "/GND".

Changing component "U3:/55E006AC" pin "G9" net name from "GND" to "/GND".

Changing component "U3:/55E006AC" pin "H1" net name from "DDR_VREF" to "/DDR_VREF".

Changing component "U3:/55E006AC" pin "H2" net name from "V+" to "/V+".

Changing component "U3:/55E006AC" pin "H3" net name from "DQ20" to "/DQ20".

Changing component "U3:/55E006AC" pin "H7" net name from "DQ23" to "/DQ23".

Changing component "U3:/55E006AC" pin "H8" net name from "DQ21" to "/DQ21".

Changing component "U3:/55E006AC" pin "H9" net name from "V+" to "/V+".

Changing component "U3:/55E006AC" pin "J1" net name from "" to "Net-(U3-PadJ1)".

Changing component "U3:/55E006AC" pin "J2" net name from "GND" to "/GND".

Changing component "U3:/55E006AC" pin "J3" net name from "RASN" to "/RASN".

Changing component "U3:/55E006AC" pin "J7" net name from "CLK" to "/CLK".

Changing component "U3:/55E006AC" pin "J8" net name from "GND" to "/GND".

Changing component "U3:/55E006AC" pin "J9" net name from "" to "Net-(U3-PadJ9)".

Changing component "U3:/55E006AC" pin "K1" net name from "DDR3_ODT" to "/DDR3_ODT".

Changing component "U3:/55E006AC" pin "K2" net name from "V+" to "/V+".

Changing component "U3:/55E006AC" pin "K3" net name from "CASN" to "/CASN".

Changing component "U3:/55E006AC" pin "K7" net name from "CLKN" to "/CLKN".

Changing component "U3:/55E006AC" pin "K8" net name from "V+" to "/V+".

Changing component "U3:/55E006AC" pin "K9" net name from "CKE" to "/CKE".

Changing component "U3:/55E006AC" pin "L1" net name from "" to "Net-(U3-PadL1)".

Changing component "U3:/55E006AC" pin "L2" net name from "SCS0" to "/SCS0".

Changing component "U3:/55E006AC" pin "L3" net name from "WEN" to "/WEN".

Changing component "U3:/55E006AC" pin "L7" net name from "SA10" to "/SA10".

Changing component "U3:/55E006AC" pin "L8" net name from "N$5" to "/N$5".

Changing component "U3:/55E006AC" pin "L9" net name from "" to "Net-(U3-PadL9)".

Changing component "U3:/55E006AC" pin "M1" net name from "GND" to "/GND".

Changing component "U3:/55E006AC" pin "M2" net name from "BA0" to "/BA0".

Changing component "U3:/55E006AC" pin "M3" net name from "BA2" to "/BA2".

Changing component "U3:/55E006AC" pin "M7" net name from "SA15" to "/SA15".

Changing component "U3:/55E006AC" pin "M8" net name from "DDR_VREF" to "/DDR_VREF".

Changing component "U3:/55E006AC" pin "M9" net name from "GND" to "/GND".

Changing component "U3:/55E006AC" pin "N1" net name from "V+" to "/V+".

Changing component "U3:/55E006AC" pin "N2" net name from "SA3" to "/SA3".

Changing component "U3:/55E006AC" pin "N3" net name from "SA0" to "/SA0".

Changing component "U3:/55E006AC" pin "N7" net name from "SA12" to "/SA12".

Changing component "U3:/55E006AC" pin "N8" net name from "BA1" to "/BA1".

Changing component "U3:/55E006AC" pin "N9" net name from "V+" to "/V+".

Changing component "U3:/55E006AC" pin "P1" net name from "GND" to "/GND".

Changing component "U3:/55E006AC" pin "P2" net name from "SA5" to "/SA5".

Changing component "U3:/55E006AC" pin "P3" net name from "SA2" to "/SA2".

Changing component "U3:/55E006AC" pin "P7" net name from "SA1" to "/SA1".

Changing component "U3:/55E006AC" pin "P8" net name from "SA4" to "/SA4".

Changing component "U3:/55E006AC" pin "P9" net name from "GND" to "/GND".

Changing component "U3:/55E006AC" pin "R1" net name from "V+" to "/V+".

Changing component "U3:/55E006AC" pin "R2" net name from "SA7" to "/SA7".

Changing component "U3:/55E006AC" pin "R3" net name from "SA9" to "/SA9".

Changing component "U3:/55E006AC" pin "R7" net name from "SA11" to "/SA11".

Changing component "U3:/55E006AC" pin "R8" net name from "SA6" to "/SA6".

Changing component "U3:/55E006AC" pin "R9" net name from "V+" to "/V+".

Changing component "U3:/55E006AC" pin "T1" net name from "GND" to "/GND".

Changing component "U3:/55E006AC" pin "T2" net name from "DDR3_RST" to "/DDR3_RST".

Changing component "U3:/55E006AC" pin "T3" net name from "SA13" to "/SA13".

Changing component "U3:/55E006AC" pin "T7" net name from "SA14" to "/SA14".

Changing component "U3:/55E006AC" pin "T8" net name from "SA8" to "/SA8".

Changing component "U3:/55E006AC" pin "T9" net name from "GND" to "/GND".

Info: Checking netlist component footprint "U6:/55E00774:GOGO_SO-08MN".

Info: Changing component path "U6:" to "/55E00774".

Changing component "U6:/55E00774" pin "2" net name from "GND" to "/GND".

Changing component "U6:/55E00774" pin "7" net name from "GND" to "/GND".

Changing component "U6:/55E00774" pin "1" net name from "GND" to "/GND".

Changing component "U6:/55E00774" pin "3" net name from "GND" to "/GND".

Changing component "U6:/55E00774" pin "4" net name from "GND" to "/GND".

Changing component "U6:/55E00774" pin "8" net name from "VCC" to "/VCC".

Changing component "U6:/55E00774" pin "6" net name from "TWI1-SCK" to "/TWI1-SCK".

Changing component "U6:/55E00774" pin "5" net name from "TWI1-SDA" to "/TWI1-SDA".

Info: Checking netlist component footprint "U7:/55E0083C:OLIMEX_IC_LQFP48".

Info: Changing component path "U7:" to "/55E0083C".

Changing component "U7:/55E0083C" pin "1" net name from "ECOL" to "/ECOL".

Changing component "U7:/55E0083C" pin "2" net name from "ETXEN" to "/ETXEN".

Changing component "U7:/55E0083C" pin "3" net name from "ETXD3" to "/ETXD3".

Changing component "U7:/55E0083C" pin "4" net name from "ETXD2" to "/ETXD2".

Changing component "U7:/55E0083C" pin "5" net name from "ETXD1" to "/ETXD1".

Changing component "U7:/55E0083C" pin "6" net name from "ETXD0" to "/ETXD0".

Changing component "U7:/55E0083C" pin "7" net name from "ETXCK" to "/ETXCK".

Changing component "U7:/55E0083C" pin "8" net name from "N$55" to "/N$55".

Changing component "U7:/55E0083C" pin "9" net name from "N$68" to "/N$68".

Changing component "U7:/55E0083C" pin "10" net name from "N$49" to "/N$49".

Changing component "U7:/55E0083C" pin "11" net name from "GND" to "/GND".

Changing component "U7:/55E0083C" pin "12" net name from "N$51" to "/N$51".

Changing component "U7:/55E0083C" pin "13" net name from "N$54" to "/N$54".

Changing component "U7:/55E0083C" pin "14" net name from "N$67" to "/N$67".

Changing component "U7:/55E0083C" pin "15" net name from "N$13" to "/N$13".

Changing component "U7:/55E0083C" pin "16" net name from "ERXCK" to "/ERXCK".

Changing component "U7:/55E0083C" pin "17" net name from "GND" to "/GND".

Changing component "U7:/55E0083C" pin "18" net name from "ERXD3" to "/ERXD3".

Changing component "U7:/55E0083C" pin "19" net name from "ERXD2" to "/ERXD2".

Changing component "U7:/55E0083C" pin "20" net name from "ERXD1" to "/ERXD1".

Changing component "U7:/55E0083C" pin "21" net name from "ERXD0" to "/ERXD0".

Changing component "U7:/55E0083C" pin "22" net name from "ERXDV" to "/ERXDV".

Changing component "U7:/55E0083C" pin "23" net name from "ECRS" to "/ECRS".

Changing component "U7:/55E0083C" pin "24" net name from "ERXERR" to "/ERXERR".

Changing component "U7:/55E0083C" pin "25" net name from "EMDC" to "/EMDC".

Changing component "U7:/55E0083C" pin "26" net name from "EMDIO" to "/EMDIO".

Changing component "U7:/55E0083C" pin "27" net name from "" to "Net-(U7-Pad27)".

Changing component "U7:/55E0083C" pin "28" net name from "N$6" to "/N$6".

Changing component "U7:/55E0083C" pin "29" net name from "GND" to "/GND".

Changing component "U7:/55E0083C" pin "30" net name from "N$45" to "/N$45".

Changing component "U7:/55E0083C" pin "31" net name from "N$41" to "/N$41".

Changing component "U7:/55E0083C" pin "32" net name from "N$56" to "/N$56".

Changing component "U7:/55E0083C" pin "33" net name from "N$40" to "/N$40".

Changing component "U7:/55E0083C" pin "34" net name from "N$39" to "/N$39".

Changing component "U7:/55E0083C" pin "35" net name from "GND" to "/GND".

Changing component "U7:/55E0083C" pin "36" net name from "N$21" to "/N$21".

Changing component "U7:/55E0083C" pin "37" net name from "VCC" to "/VCC".

Changing component "U7:/55E0083C" pin "38" net name from "VCC" to "/VCC".

Changing component "U7:/55E0083C" pin "39" net name from "VCC" to "/VCC".

Changing component "U7:/55E0083C" pin "40" net name from "GND" to "/GND".

Changing component "U7:/55E0083C" pin "41" net name from "VCC" to "/VCC".

Changing component "U7:/55E0083C" pin "42" net name from "N$32" to "/N$32".

Changing component "U7:/55E0083C" pin "43" net name from "GND" to "/GND".

Changing component "U7:/55E0083C" pin "44" net name from "VCC" to "/VCC".

Changing component "U7:/55E0083C" pin "45" net name from "GND" to "/GND".

Changing component "U7:/55E0083C" pin "46" net name from "XTALI1" to "/XTALI1".

Changing component "U7:/55E0083C" pin "47" net name from "XTALO1" to "/XTALO1".

Changing component "U7:/55E0083C" pin "48" net name from "N$67" to "/N$67".

Info: Checking netlist component footprint "U8:/55E00904:OLIMEX_IC_TSOP48".

Info: Changing component path "U8:" to "/55E00904".

Changing component "U8:/55E00904" pin "1" net name from "VCC" to "/VCC".

Changing component "U8:/55E00904" pin "2" net name from "GND" to "/GND".

Changing component "U8:/55E00904" pin "3" net name from "" to "Net-(U8-Pad3)".

Changing component "U8:/55E00904" pin "4" net name from "PC7/NRB1" to "/PC7/NRB1".

Changing component "U8:/55E00904" pin "5" net name from "PC7/NRB1" to "/PC7/NRB1".

Changing component "U8:/55E00904" pin "6" net name from "NRBO/NRB1" to "/NRBO/NRB1".

Changing component "U8:/55E00904" pin "7" net name from "NRB0" to "/NRB0".

Changing component "U8:/55E00904" pin "8" net name from "NRE" to "/NRE".

Changing component "U8:/55E00904" pin "9" net name from "N$232" to "/N$232".

Changing component "U8:/55E00904" pin "10" net name from "PC3/NCE1" to "/PC3/NCE1".

Changing component "U8:/55E00904" pin "11" net name from "" to "Net-(U8-Pad11)".

Changing component "U8:/55E00904" pin "12" net name from "VCC" to "/VCC".

Changing component "U8:/55E00904" pin "13" net name from "GND" to "/GND".

Changing component "U8:/55E00904" pin "14" net name from "" to "Net-(U8-Pad14)".

Changing component "U8:/55E00904" pin "15" net name from "" to "Net-(U8-Pad15)".

Changing component "U8:/55E00904" pin "16" net name from "NCLE" to "/NCLE".

Changing component "U8:/55E00904" pin "17" net name from "NALE" to "/NALE".

Changing component "U8:/55E00904" pin "18" net name from "NWE" to "/NWE".

Changing component "U8:/55E00904" pin "19" net name from "N$124" to "/N$124".

Changing component "U8:/55E00904" pin "20" net name from "" to "Net-(U8-Pad20)".

Changing component "U8:/55E00904" pin "21" net name from "" to "Net-(U8-Pad21)".

Changing component "U8:/55E00904" pin "22" net name from "" to "Net-(U8-Pad22)".

Changing component "U8:/55E00904" pin "23" net name from "GND" to "/GND".

Changing component "U8:/55E00904" pin "24" net name from "VCC" to "/VCC".

Changing component "U8:/55E00904" pin "25" net name from "GND" to "/GND".

Changing component "U8:/55E00904" pin "26" net name from "N$14" to "/N$14".

Changing component "U8:/55E00904" pin "27" net name from "TSD_D3" to "/TSD_D3".

Changing component "U8:/55E00904" pin "28" net name from "N$20" to "/N$20".

Changing component "U8:/55E00904" pin "29" net name from "NDQ0" to "/NDQ0".

Changing component "U8:/55E00904" pin "30" net name from "NDQ1" to "/NDQ1".

Changing component "U8:/55E00904" pin "31" net name from "NDQ2" to "/NDQ2".

Changing component "U8:/55E00904" pin "32" net name from "NDQ3" to "/NDQ3".

Changing component "U8:/55E00904" pin "33" net name from "TSD_CMD" to "/TSD_CMD".

Changing component "U8:/55E00904" pin "34" net name from "VCC" to "/VCC".

Changing component "U8:/55E00904" pin "35" net name from "NAND_DQS" to "/NAND_DQS".

Changing component "U8:/55E00904" pin "36" net name from "GND" to "/GND".

Changing component "U8:/55E00904" pin "37" net name from "VCC" to "/VCC".

Changing component "U8:/55E00904" pin "38" net name from "N$69" to "/N$69".

Changing component "U8:/55E00904" pin "39" net name from "VCC" to "/VCC".

Changing component "U8:/55E00904" pin "40" net name from "TSD_CLK" to "/TSD_CLK".

Changing component "U8:/55E00904" pin "41" net name from "NDQ4" to "/NDQ4".

Changing component "U8:/55E00904" pin "42" net name from "NDQ5" to "/NDQ5".

Changing component "U8:/55E00904" pin "43" net name from "NDQ6" to "/NDQ6".

Changing component "U8:/55E00904" pin "44" net name from "NDQ7" to "/NDQ7".

Changing component "U8:/55E00904" pin "45" net name from "TSD_D2" to "/TSD_D2".

Changing component "U8:/55E00904" pin "46" net name from "TSD_D1" to "/TSD_D1".

Changing component "U8:/55E00904" pin "47" net name from "TSD_D0" to "/TSD_D0".

Changing component "U8:/55E00904" pin "48" net name from "GND" to "/GND".

Info: Checking netlist component footprint "U9:/55E009CC:OLIMEX_IC_SOT23-5".

Info: Changing component path "U9:" to "/55E009CC".

Changing component "U9:/55E009CC" pin "1" net name from "N$100" to "/N$100".

Changing component "U9:/55E009CC" pin "2" net name from "GND" to "/GND".

Changing component "U9:/55E009CC" pin "3" net name from "N$99" to "/N$99".

Changing component "U9:/55E009CC" pin "4" net name from "USB0-DRV" to "/USB0-DRV".

Changing component "U9:/55E009CC" pin "5" net name from "+5V" to "/+5V".

Info: Checking netlist component footprint "U10:/55E00A94:OLIMEX_IC_SOT23-5".

Info: Changing component path "U10:" to "/55E00A94".

Changing component "U10:/55E00A94" pin "1" net name from "N$192" to "/N$192".

Changing component "U10:/55E00A94" pin "2" net name from "GND" to "/GND".

Changing component "U10:/55E00A94" pin "3" net name from "N$101" to "/N$101".

Changing component "U10:/55E00A94" pin "4" net name from "USB1-DRV" to "/USB1-DRV".

Changing component "U10:/55E00A94" pin "5" net name from "+5V" to "/+5V".

Info: Checking netlist component footprint "U11:/55E00B5C:OLIMEX_IC_SOT23-5".

Info: Changing component path "U11:" to "/55E00B5C".

Changing component "U11:/55E00B5C" pin "1" net name from "N$195" to "/N$195".

Changing component "U11:/55E00B5C" pin "2" net name from "GND" to "/GND".

Changing component "U11:/55E00B5C" pin "3" net name from "N$137" to "/N$137".

Changing component "U11:/55E00B5C" pin "4" net name from "USB2-DRV" to "/USB2-DRV".

Changing component "U11:/55E00B5C" pin "5" net name from "+5V" to "/+5V".

Info: Checking netlist component footprint "U12:/55E00C24:OLIMEX_IC_QFN48".

Info: Changing component path "U12:" to "/55E00C24".

Changing component "U12:/55E00C24" pin "N1" net name from "GND" to "Net-(U12-PadN1)".

Changing component "U12:/55E00C24" pin "N2" net name from "GND" to "Net-(U12-PadN1)".

Changing component "U12:/55E00C24" pin "N3" net name from "GND" to "Net-(U12-PadN1)".

Changing component "U12:/55E00C24" pin "N4" net name from "GND" to "Net-(U12-PadN1)".

Changing component "U12:/55E00C24" pin "N5" net name from "GND" to "Net-(U12-PadN1)".

Changing component "U12:/55E00C24" pin "N6" net name from "GND" to "Net-(U12-PadN1)".

Changing component "U12:/55E00C24" pin "N7" net name from "GND" to "Net-(U12-PadN1)".

Changing component "U12:/55E00C24" pin "N8" net name from "GND" to "Net-(U12-PadN1)".

Changing component "U12:/55E00C24" pin "N9" net name from "GND" to "Net-(U12-PadN1)".

Changing component "U12:/55E00C24" pin "N10" net name from "GND" to "Net-(U12-PadN1)".

Changing component "U12:/55E00C24" pin "N11" net name from "GND" to "Net-(U12-PadN1)".

Changing component "U12:/55E00C24" pin "N12" net name from "GND" to "Net-(U12-PadN1)".

Changing component "U12:/55E00C24" pin "N13" net name from "GND" to "Net-(U12-PadN1)".

Changing component "U12:/55E00C24" pin "N14" net name from "GND" to "Net-(U12-PadN1)".

Changing component "U12:/55E00C24" pin "N15" net name from "GND" to "Net-(U12-PadN1)".

Changing component "U12:/55E00C24" pin "N16" net name from "GND" to "Net-(U12-PadN1)".

Changing component "U12:/55E00C24" pin "N17" net name from "GND" to "Net-(U12-PadN1)".

Changing component "U12:/55E00C24" pin "1" net name from "TWI0-SDA" to "/TWI0-SDA".

Changing component "U12:/55E00C24" pin "2" net name from "TWI0-SCK" to "/TWI0-SCK".

Changing component "U12:/55E00C24" pin "3" net name from "GPIO3" to "/GPIO3".

Changing component "U12:/55E00C24" pin "4" net name from "N$140" to "/N$140".

Changing component "U12:/55E00C24" pin "5" net name from "GPIO2" to "/GPIO2".

Changing component "U12:/55E00C24" pin "6" net name from "USB0-DRV" to "/USB0-DRV".

Changing component "U12:/55E00C24" pin "7" net name from "IPSOUT" to "/IPSOUT".

Changing component "U12:/55E00C24" pin "8" net name from "N$130" to "/N$130".

Changing component "U12:/55E00C24" pin "9" net name from "GND" to "/GND".

Changing component "U12:/55E00C24" pin "10" net name from "VCC/2" to "/VCC/2".

Changing component "U12:/55E00C24" pin "11" net name from "LDO4_2.8V" to "/LDO4_2.8V".

Changing component "U12:/55E00C24" pin "12" net name from "N$28" to "/N$28".

Changing component "U12:/55E00C24" pin "13" net name from "IPSOUT" to "/IPSOUT".

Changing component "U12:/55E00C24" pin "14" net name from "IPSOUT" to "/IPSOUT".

Changing component "U12:/55E00C24" pin "15" net name from "N$131" to "/N$131".

Changing component "U12:/55E00C24" pin "16" net name from "GND" to "/GND".

Changing component "U12:/55E00C24" pin "17" net name from "VCCINT" to "/VCCINT".

Changing component "U12:/55E00C24" pin "18" net name from "GPIO1" to "/GPIO1".

Changing component "U12:/55E00C24" pin "19" net name from "N$9" to "/N$9".

Changing component "U12:/55E00C24" pin "20" net name from "EXTEN" to "/EXTEN".

Changing component "U12:/55E00C24" pin "21" net name from "IPSOUT" to "/IPSOUT".

Changing component "U12:/55E00C24" pin "22" net name from "GND" to "/GND".

Changing component "U12:/55E00C24" pin "23" net name from "N$120" to "/N$120".

Changing component "U12:/55E00C24" pin "24" net name from "N$132" to "/N$132".

Changing component "U12:/55E00C24" pin "25" net name from "RESET_N" to "/RESET_N".

Changing component "U12:/55E00C24" pin "26" net name from "VINT" to "/VINT".

Changing component "U12:/55E00C24" pin "27" net name from "N$12" to "/N$12".

Changing component "U12:/55E00C24" pin "28" net name from "VDD_RTC" to "/VDD_RTC".

Changing component "U12:/55E00C24" pin "29" net name from "" to "Net-(U12-Pad29)".

Changing component "U12:/55E00C24" pin "30" net name from "" to "Net-(U12-Pad30)".

Changing component "U12:/55E00C24" pin "31" net name from "+5V_OTG_PWR" to "/+5V_OTG_PWR".

Changing component "U12:/55E00C24" pin "32" net name from "+15V" to "/+15V".

Changing component "U12:/55E00C24" pin "33" net name from "+15V" to "/+15V".

Changing component "U12:/55E00C24" pin "34" net name from "IPSOUT" to "/IPSOUT".

Changing component "U12:/55E00C24" pin "35" net name from "IPSOUT" to "/IPSOUT".

Changing component "U12:/55E00C24" pin "36" net name from "N$4" to "/N$4".

Changing component "U12:/55E00C24" pin "37" net name from "N$125" to "/N$125".

Changing component "U12:/55E00C24" pin "38" net name from "+24V" to "/+24V".

Changing component "U12:/55E00C24" pin "39" net name from "+24V" to "/+24V".

Changing component "U12:/55E00C24" pin "40" net name from "IPSOUT" to "/IPSOUT".

Changing component "U12:/55E00C24" pin "41" net name from "LDO3_2.8V" to "/LDO3_2.8V".

Changing component "U12:/55E00C24" pin "42" net name from "+24V" to "/+24V".

Changing component "U12:/55E00C24" pin "43" net name from "N$128" to "/N$128".

Changing component "U12:/55E00C24" pin "44" net name from "IPSOUT" to "/IPSOUT".

Changing component "U12:/55E00C24" pin "45" net name from "N$127" to "/N$127".

Changing component "U12:/55E00C24" pin "46" net name from "GND" to "/GND".

Changing component "U12:/55E00C24" pin "47" net name from "N$139" to "/N$139".

Changing component "U12:/55E00C24" pin "48" net name from "NMI_N" to "/NMI_N".

Changing component "U12:/55E00C24" pin "VSS" net name from "GND" to "/GND".

Info: Checking netlist component footprint "U13:/55E00CEC:OLIMEX_IC_SOT23-5".

Info: Changing component path "U13:" to "/55E00CEC".

Changing component "U13:/55E00CEC" pin "1" net name from "VPP" to "/VPP".

Changing component "U13:/55E00CEC" pin "2" net name from "GND" to "/GND".

Changing component "U13:/55E00CEC" pin "3" net name from "N$8" to "/N$8".

Changing component "U13:/55E00CEC" pin "4" net name from "IPSOUT" to "/IPSOUT".

Changing component "U13:/55E00CEC" pin "5" net name from "N$19" to "/N$19".

Info: Checking netlist component footprint "U14:/55E00DB4:OLIMEX_IC_SOIC8".

Info: Changing component path "U14:" to "/55E00DB4".

Changing component "U14:/55E00DB4" pin "2" net name from "N$31" to "/N$31".

Changing component "U14:/55E00DB4" pin "7" net name from "N$37" to "/N$37".

Changing component "U14:/55E00DB4" pin "1" net name from "N$46" to "/N$46".

Changing component "U14:/55E00DB4" pin "3" net name from "N$50" to "/N$50".

Changing component "U14:/55E00DB4" pin "4" net name from "GND" to "/GND".

Changing component "U14:/55E00DB4" pin "8" net name from "N$36" to "/N$36".

Changing component "U14:/55E00DB4" pin "6" net name from "N$60" to "/N$60".

Changing component "U14:/55E00DB4" pin "5" net name from "N$62" to "/N$62".

Info: Checking netlist component footprint "U15:/55E00E7C:OLIMEX_IC_SOT23-5".

Info: Changing component path "U15:" to "/55E00E7C".

Changing component "U15:/55E00E7C" pin "1" net name from "EXTEN" to "/EXTEN".

Changing component "U15:/55E00E7C" pin "2" net name from "GND" to "/GND".

Changing component "U15:/55E00E7C" pin "3" net name from "N$64" to "/N$64".

Changing component "U15:/55E00E7C" pin "4" net name from "IPSOUT" to "/IPSOUT".

Changing component "U15:/55E00E7C" pin "5" net name from "N$66" to "/N$66".

Info: Checking netlist component footprint "U16:/55E00F44:OLIMEX_IC_SOT23-6".

Info: Changing component path "U16:" to "/55E00F44".

Changing component "U16:/55E00F44" pin "1" net name from "N$123" to "/N$123".

Changing component "U16:/55E00F44" pin "2" net name from "GND" to "/GND".

Changing component "U16:/55E00F44" pin "3" net name from "N$126" to "/N$126".

Changing component "U16:/55E00F44" pin "4" net name from "EXTEN" to "/EXTEN".

Changing component "U16:/55E00F44" pin "5" net name from "IPSOUT" to "/IPSOUT".

Changing component "U16:/55E00F44" pin "6" net name from "" to "Net-(U16-Pad6)".

Info: Checking netlist component footprint "U17:/55E0100C:OLIMEX_IC_SLP2510P8".

Info: Changing component path "U17:" to "/55E0100C".

Changing component "U17:/55E0100C" pin "1" net name from "HTX2P" to "/HTX2P".

Changing component "U17:/55E0100C" pin "2" net name from "HTX2N" to "/HTX2N".

Changing component "U17:/55E0100C" pin "4" net name from "HTX1P" to "/HTX1P".

Changing component "U17:/55E0100C" pin "5" net name from "HTX1N" to "/HTX1N".

Changing component "U17:/55E0100C" pin "10" net name from "HTX2P" to "/HTX2P".

Changing component "U17:/55E0100C" pin "9" net name from "HTX2N" to "/HTX2N".

Changing component "U17:/55E0100C" pin "7" net name from "HTX1P" to "/HTX1P".

Changing component "U17:/55E0100C" pin "6" net name from "HTX1N" to "/HTX1N".

Changing component "U17:/55E0100C" pin "3" net name from "GND" to "/GND".

Changing component "U17:/55E0100C" pin "8" net name from "GND" to "/GND".

Info: Checking netlist component footprint "U22:/55E010D4:OLIMEX_IC_SLP2510P8".

Info: Changing component path "U22:" to "/55E010D4".

Changing component "U22:/55E010D4" pin "1" net name from "HTX0P" to "/HTX0P".

Changing component "U22:/55E010D4" pin "2" net name from "HTX0N" to "/HTX0N".

Changing component "U22:/55E010D4" pin "4" net name from "HTXCP" to "/HTXCP".

Changing component "U22:/55E010D4" pin "5" net name from "HTXCN" to "/HTXCN".

Changing component "U22:/55E010D4" pin "10" net name from "HTX0P" to "/HTX0P".

Changing component "U22:/55E010D4" pin "9" net name from "HTX0N" to "/HTX0N".

Changing component "U22:/55E010D4" pin "7" net name from "HTXCP" to "/HTXCP".

Changing component "U22:/55E010D4" pin "6" net name from "HTXCN" to "/HTXCN".

Changing component "U22:/55E010D4" pin "3" net name from "GND" to "/GND".

Changing component "U22:/55E010D4" pin "8" net name from "GND" to "/GND".

Info: Checking netlist component footprint "U23:/55E0119C:OLIMEX_IC_SLP2510P8".

Info: Changing component path "U23:" to "/55E0119C".

Changing component "U23:/55E0119C" pin "1" net name from "HCEC" to "/HCEC".

Changing component "U23:/55E0119C" pin "2" net name from "HSCL" to "/HSCL".

Changing component "U23:/55E0119C" pin "4" net name from "HSDA" to "/HSDA".

Changing component "U23:/55E0119C" pin "5" net name from "HHPD" to "/HHPD".

Changing component "U23:/55E0119C" pin "10" net name from "HCEC" to "/HCEC".

Changing component "U23:/55E0119C" pin "9" net name from "HSCL" to "/HSCL".

Changing component "U23:/55E0119C" pin "7" net name from "HSDA" to "/HSDA".

Changing component "U23:/55E0119C" pin "6" net name from "HHPD" to "/HHPD".

Changing component "U23:/55E0119C" pin "3" net name from "GND" to "/GND".

Changing component "U23:/55E0119C" pin "8" net name from "GND" to "/GND".

Info: Checking netlist component footprint "UART0:/55E01264:PENKO_HN1X4".

Info: Changing component path "UART0:" to "/55E01264".

Changing component "UART0:/55E01264" pin "1" net name from "VCC" to "/VCC".

Changing component "UART0:/55E01264" pin "2" net name from "UART0-TX" to "/UART0-TX".

Changing component "UART0:/55E01264" pin "3" net name from "N$7" to "/N$7".

Changing component "UART0:/55E01264" pin "4" net name from "GND" to "/GND".

Info: Checking netlist component footprint "UEXT1:/55E0132C:CON-HARTING-ML_ML10_S".

Info: Changing component path "UEXT1:" to "/55E0132C".

Changing component "UEXT1:/55E0132C" pin "1" net name from "VCC" to "/VCC".

Changing component "UEXT1:/55E0132C" pin "2" net name from "GND" to "/GND".

Changing component "UEXT1:/55E0132C" pin "3" net name from "UART6-TX" to "/UART6-TX".

Changing component "UEXT1:/55E0132C" pin "4" net name from "UART6-RX" to "/UART6-RX".

Changing component "UEXT1:/55E0132C" pin "5" net name from "TWI2-SCK" to "/TWI2-SCK".

Changing component "UEXT1:/55E0132C" pin "6" net name from "TWI2-SDA" to "/TWI2-SDA".

Changing component "UEXT1:/55E0132C" pin "7" net name from "SPI2-MISO" to "/SPI2-MISO".

Changing component "UEXT1:/55E0132C" pin "8" net name from "SPI2-MOSI" to "/SPI2-MOSI".

Changing component "UEXT1:/55E0132C" pin "9" net name from "SPI2-CLK" to "/SPI2-CLK".

Changing component "UEXT1:/55E0132C" pin "10" net name from "SPI2-CS0" to "/SPI2-CS0".

Info: Checking netlist component footprint "UEXT2:/55E013F4:CON-HARTING-ML_ML10_S".

Info: Changing component path "UEXT2:" to "/55E013F4".

Changing component "UEXT2:/55E013F4" pin "1" net name from "VCC" to "/VCC".

Changing component "UEXT2:/55E013F4" pin "2" net name from "GND" to "/GND".

Changing component "UEXT2:/55E013F4" pin "3" net name from "UART7-TX" to "/UART7-TX".

Changing component "UEXT2:/55E013F4" pin "4" net name from "UART7-RX" to "/UART7-RX".

Changing component "UEXT2:/55E013F4" pin "5" net name from "TWI1-SCK" to "/TWI1-SCK".

Changing component "UEXT2:/55E013F4" pin "6" net name from "TWI1-SDA" to "/TWI1-SDA".

Changing component "UEXT2:/55E013F4" pin "7" net name from "SPI1-MISO" to "/SPI1-MISO".

Changing component "UEXT2:/55E013F4" pin "8" net name from "SPI1-MOSI" to "/SPI1-MOSI".

Changing component "UEXT2:/55E013F4" pin "9" net name from "SPI1-CLK" to "/SPI1-CLK".

Changing component "UEXT2:/55E013F4" pin "10" net name from "SPI1-CS0" to "/SPI1-CS0".

Info: Checking netlist component footprint "USB_HOST233:/55E014BC:OLIMEX_CONNECTORS_USB_TWO_LEVEL".

Info: Changing component path "USB_HOST233:" to "/55E014BC".

Changing component "USB_HOST233:/55E014BC" pin "2.2" net name from "UDM2" to "/UDM2".

Changing component "USB_HOST233:/55E014BC" pin "2.1" net name from "N$194" to "/N$194".

Changing component "USB_HOST233:/55E014BC" pin "2.3" net name from "UDP2" to "/UDP2".

Changing component "USB_HOST233:/55E014BC" pin "2.4" net name from "GND" to "/GND".

Changing component "USB_HOST233:/55E014BC" pin "1.2" net name from "UDM1" to "/UDM1".

Changing component "USB_HOST233:/55E014BC" pin "1.1" net name from "N$111" to "/N$111".

Changing component "USB_HOST233:/55E014BC" pin "1.3" net name from "UDP1" to "/UDP1".

Changing component "USB_HOST233:/55E014BC" pin "1.4" net name from "GND" to "/GND".

Changing component "USB_HOST233:/55E014BC" pin "GND1" net name from "N$193" to "/N$193".

Changing component "USB_HOST233:/55E014BC" pin "GND2" net name from "N$193" to "/N$193".

Changing component "USB_HOST233:/55E014BC" pin "GND4" net name from "N$193" to "/N$193".

Changing component "USB_HOST233:/55E014BC" pin "GND3" net name from "N$193" to "/N$193".

Info: Checking netlist component footprint "USB_OTG233:/55E01584:OLIMEX_CONNECTORS_USB_MINI_9PIN".

Info: Changing component path "USB_OTG233:" to "/55E01584".

Changing component "USB_OTG233:/55E01584" pin "VBUS" net name from "+5V_OTG_PWR" to "/+5V_OTG_PWR".

Changing component "USB_OTG233:/55E01584" pin "D-" net name from "UDM0" to "/UDM0".

Changing component "USB_OTG233:/55E01584" pin "D+" net name from "UDP0" to "/UDP0".

Changing component "USB_OTG233:/55E01584" pin "ID" net name from "USB0-IDDET" to "/USB0-IDDET".

Changing component "USB_OTG233:/55E01584" pin "GND" net name from "GND" to "/GND".

Changing component "USB_OTG233:/55E01584" pin "GND1" net name from "N$266" to "/N$266".

Changing component "USB_OTG233:/55E01584" pin "GND3" net name from "N$266" to "/N$266".

Changing component "USB_OTG233:/55E01584" pin "GND2" net name from "N$266" to "/N$266".

Changing component "USB_OTG233:/55E01584" pin "GND4" net name from "N$266" to "/N$266".

Info: Checking netlist component footprint "VGA233:/55E02A9C:DOUBLE-SIDE_CON1.27MM-6-SMALL_ICSP".

Info: Changing component path "VGA233:" to "/55E02A9C".

Changing component "VGA233:/55E02A9C" pin "3" net name from "VGA-G" to "/VGA-G".

Changing component "VGA233:/55E02A9C" pin "4" net name from "VGA_VSYNC" to "/VGA_VSYNC".

Changing component "VGA233:/55E02A9C" pin "2" net name from "VGA-B" to "/VGA-B".

Changing component "VGA233:/55E02A9C" pin "1" net name from "VGA-R" to "/VGA-R".

Changing component "VGA233:/55E02A9C" pin "5" net name from "VGA_HSYNC" to "/VGA_HSYNC".

Changing component "VGA233:/55E02A9C" pin "6" net name from "GND" to "/GND".

Info: Checking netlist component footprint "VOL+233:/55E02B64:GOGO_SW_TAKT3X4".

Info: Changing component path "VOL+233:" to "/55E02B64".

Changing component "VOL+233:/55E02B64" pin "1_1" net name from "VOL+_BUT" to "/VOL+_BUT".

Changing component "VOL+233:/55E02B64" pin "2_1" net name from "GND" to "/GND".

Info: Checking netlist component footprint "VOL-233:/55E02C2C:GOGO_SW_TAKT3X4".

Info: Changing component path "VOL-233:" to "/55E02C2C".

Changing component "VOL-233:/55E02C2C" pin "1_1" net name from "VOL-_BUT" to "/VOL-_BUT".

Changing component "VOL-233:/55E02C2C" pin "2_1" net name from "GND" to "/GND".

Info: Checking netlist component footprint "VPS+233:/55E02CF4:JUMPER_SJ_1_SMALLER".

Info: Changing component path "VPS+233:" to "/55E02CF4".

Changing component "VPS+233:/55E02CF4" pin "1" net name from "VCC" to "/VCC".

Changing component "VPS+233:/55E02CF4" pin "2" net name from "N$69" to "/N$69".

Info: Checking netlist component footprint "VPS-233:/55E02DBC:JUMPER_SJ_1_SMALLER".

Info: Changing component path "VPS-233:" to "/55E02DBC".

Changing component "VPS-233:/55E02DBC" pin "1" net name from "GND" to "/GND".

Changing component "VPS-233:/55E02DBC" pin "2" net name from "N$69" to "/N$69".

Info: Checking netlist component footprint "VP_0:/55E02E84:VPAD_VPAC0".

Info: Changing component path "VP_0:" to "/55E02E84".

Changing component "VP_0:/55E02E84" pin "VP" net name from "GND" to "/GND".

Info: Checking netlist component footprint "VP_1:/55E02F4C:VPAD_VPAC0".

Info: Changing component path "VP_1:" to "/55E02F4C".

Changing component "VP_1:/55E02F4C" pin "VP" net name from "GND" to "/GND".

Info: Checking netlist component footprint "VP_2:/55E03014:VPAD_VPAC0".

Info: Changing component path "VP_2:" to "/55E03014".

Changing component "VP_2:/55E03014" pin "VP" net name from "GND" to "/GND".

Info: Checking netlist component footprint "VP_3:/55E030DC:VPAD_VPAC0".

Info: Changing component path "VP_3:" to "/55E030DC".

Changing component "VP_3:/55E030DC" pin "VP" net name from "GND" to "/GND".

Info: Checking netlist component footprint "VP_4:/55E031A4:VPAD_VPAC0".

Info: Changing component path "VP_4:" to "/55E031A4".

Changing component "VP_4:/55E031A4" pin "VP" net name from "GND" to "/GND".

Info: Checking netlist component footprint "VP_5:/55E0326C:VPAD_VPAC0".

Info: Changing component path "VP_5:" to "/55E0326C".

Changing component "VP_5:/55E0326C" pin "VP" net name from "GND" to "/GND".

Info: Checking netlist component footprint "VP_6:/55E03334:VPAD_VPAC0".

Info: Changing component path "VP_6:" to "/55E03334".

Changing component "VP_6:/55E03334" pin "VP" net name from "GND" to "/GND".

Info: Checking netlist component footprint "VP_7:/55E033FC:VPAD_VPAC0".

Info: Changing component path "VP_7:" to "/55E033FC".

Changing component "VP_7:/55E033FC" pin "VP" net name from "GND" to "/GND".

Info: Checking netlist component footprint "VP_8:/55E034C4:VPAD_VPAC1".

Info: Changing component path "VP_8:" to "/55E034C4".

Changing component "VP_8:/55E034C4" pin "VP" net name from "GND" to "/GND".

Info: Checking netlist component footprint "VP_9:/55E0358C:VPAD_VPAC0".

Info: Changing component path "VP_9:" to "/55E0358C".

Changing component "VP_9:/55E0358C" pin "VP" net name from "GND" to "/GND".

Info: Checking netlist component footprint "VP_10:/55E03654:VPAD_VPAC0".

Info: Changing component path "VP_10:" to "/55E03654".

Changing component "VP_10:/55E03654" pin "VP" net name from "GND" to "/GND".

Info: Checking netlist component footprint "VP_11:/55E0371C:VPAD_VPAC0".

Info: Changing component path "VP_11:" to "/55E0371C".

Changing component "VP_11:/55E0371C" pin "VP" net name from "GND" to "/GND".

Info: Checking netlist component footprint "VP_12:/55E037E4:VPAD_VPAC0".

Info: Changing component path "VP_12:" to "/55E037E4".

Changing component "VP_12:/55E037E4" pin "VP" net name from "GND" to "/GND".

Info: Checking netlist component footprint "VP_13:/55E038AC:VPAD_VPAC0".

Info: Changing component path "VP_13:" to "/55E038AC".

Changing component "VP_13:/55E038AC" pin "VP" net name from "GND" to "/GND".

Info: Checking netlist component footprint "VP_14:/55E03974:VPAD_VPAC0".

Info: Changing component path "VP_14:" to "/55E03974".

Changing component "VP_14:/55E03974" pin "VP" net name from "GND" to "/GND".

Info: Checking netlist component footprint "VP_15:/55E03A3C:VPAD_VPAC0".

Info: Changing component path "VP_15:" to "/55E03A3C".

Changing component "VP_15:/55E03A3C" pin "VP" net name from "GND" to "/GND".

Info: Checking netlist component footprint "VP_16:/55E03B04:VPAD_VPAC0".

Info: Changing component path "VP_16:" to "/55E03B04".

Changing component "VP_16:/55E03B04" pin "VP" net name from "GND" to "/GND".

Info: Checking netlist component footprint "VP_17:/55E03BCC:VPAD_VPAC1".

Info: Changing component path "VP_17:" to "/55E03BCC".

Changing component "VP_17:/55E03BCC" pin "VP" net name from "GND" to "/GND".

Info: Checking netlist component footprint "VP_18:/55E03C94:VPAD_VPAC0".

Info: Changing component path "VP_18:" to "/55E03C94".

Changing component "VP_18:/55E03C94" pin "VP" net name from "GND" to "/GND".

Info: Checking netlist component footprint "VP_19:/55E03D5C:VPAD_VPAC0".

Info: Changing component path "VP_19:" to "/55E03D5C".

Changing component "VP_19:/55E03D5C" pin "VP" net name from "GND" to "/GND".

Info: Checking netlist component footprint "VP_20:/55E03E24:VPAD_VPAC0".

Info: Changing component path "VP_20:" to "/55E03E24".

Changing component "VP_20:/55E03E24" pin "VP" net name from "GND" to "/GND".

Info: Checking netlist component footprint "VP_21:/55E03EEC:VPAD_VPAC0".

Info: Changing component path "VP_21:" to "/55E03EEC".

Changing component "VP_21:/55E03EEC" pin "VP" net name from "GND" to "/GND".

Info: Checking netlist component footprint "VP_22:/55E03FB4:VPAD_VPAC0".

Info: Changing component path "VP_22:" to "/55E03FB4".

Changing component "VP_22:/55E03FB4" pin "VP" net name from "GND" to "/GND".

Info: Checking netlist component footprint "VP_23:/55E0407C:VPAD_VPAC0".

Info: Changing component path "VP_23:" to "/55E0407C".

Changing component "VP_23:/55E0407C" pin "VP" net name from "GND" to "/GND".

Info: Checking netlist component footprint "VP_24:/55E04144:VPAD_VPAC0".

Info: Changing component path "VP_24:" to "/55E04144".

Changing component "VP_24:/55E04144" pin "VP" net name from "GND" to "/GND".

Info: Checking netlist component footprint "VP_25:/55E0420C:VPAD_VPAC0".

Info: Changing component path "VP_25:" to "/55E0420C".

Changing component "VP_25:/55E0420C" pin "VP" net name from "GND" to "/GND".

Info: Checking netlist component footprint "VP_26:/55E042D4:VPAD_VPAC1".

Info: Changing component path "VP_26:" to "/55E042D4".

Changing component "VP_26:/55E042D4" pin "VP" net name from "GND" to "/GND".

Info: Checking netlist component footprint "VP_27:/55E0439C:VPAD_VPAC0".

Info: Changing component path "VP_27:" to "/55E0439C".

Changing component "VP_27:/55E0439C" pin "VP" net name from "GND" to "/GND".

Info: Checking netlist component footprint "VP_28:/55E04464:VPAD_VPAC0".

Info: Changing component path "VP_28:" to "/55E04464".

Changing component "VP_28:/55E04464" pin "VP" net name from "GND" to "/GND".

Info: Checking netlist component footprint "VP_29:/55E0452C:VPAD_VPAC0".

Info: Changing component path "VP_29:" to "/55E0452C".

Changing component "VP_29:/55E0452C" pin "VP" net name from "GND" to "/GND".

Info: Checking netlist component footprint "VP_30:/55E045F4:VPAD_VPAC0".

Info: Changing component path "VP_30:" to "/55E045F4".

Changing component "VP_30:/55E045F4" pin "VP" net name from "GND" to "/GND".

Info: Checking netlist component footprint "VP_31:/55E046BC:VPAD_VPAC0".

Info: Changing component path "VP_31:" to "/55E046BC".

Changing component "VP_31:/55E046BC" pin "VP" net name from "GND" to "/GND".

Info: Checking netlist component footprint "VP_32:/55E04784:VPAD_VPAC0".

Info: Changing component path "VP_32:" to "/55E04784".

Changing component "VP_32:/55E04784" pin "VP" net name from "GND" to "/GND".

Info: Checking netlist component footprint "VP_33:/55E0484C:VPAD_VPAC0".

Info: Changing component path "VP_33:" to "/55E0484C".

Changing component "VP_33:/55E0484C" pin "VP" net name from "GND" to "/GND".

Info: Checking netlist component footprint "VP_34:/55E04914:VPAD_VPAC0".

Info: Changing component path "VP_34:" to "/55E04914".

Changing component "VP_34:/55E04914" pin "VP" net name from "GND" to "/GND".

Info: Checking netlist component footprint "VP_35:/55E049DC:VPAD_VPAC1".

Info: Changing component path "VP_35:" to "/55E049DC".

Changing component "VP_35:/55E049DC" pin "VP" net name from "GND" to "/GND".

Info: Checking netlist component footprint "VP_36:/55E04AA4:VPAD_VPAC0".

Info: Changing component path "VP_36:" to "/55E04AA4".

Changing component "VP_36:/55E04AA4" pin "VP" net name from "GND" to "/GND".

Info: Checking netlist component footprint "VP_37:/55E04B6C:VPAD_VPAC0".

Info: Changing component path "VP_37:" to "/55E04B6C".

Changing component "VP_37:/55E04B6C" pin "VP" net name from "GND" to "/GND".

Info: Checking netlist component footprint "VP_38:/55E04C34:VPAD_VPAC0".

Info: Changing component path "VP_38:" to "/55E04C34".

Changing component "VP_38:/55E04C34" pin "VP" net name from "GND" to "/GND".

Info: Checking netlist component footprint "VP_39:/55E04CFC:VPAD_VPAC0".

Info: Changing component path "VP_39:" to "/55E04CFC".

Changing component "VP_39:/55E04CFC" pin "VP" net name from "GND" to "/GND".

Info: Checking netlist component footprint "VP_40:/55E04DC4:VPAD_VPAC0".

Info: Changing component path "VP_40:" to "/55E04DC4".

Changing component "VP_40:/55E04DC4" pin "VP" net name from "GND" to "/GND".

Info: Checking netlist component footprint "VP_41:/55E04E8C:VPAD_VPAC0".

Info: Changing component path "VP_41:" to "/55E04E8C".

Changing component "VP_41:/55E04E8C" pin "VP" net name from "GND" to "/GND".

Info: Checking netlist component footprint "VP_42:/55E04F54:VPAD_VPAC0".

Info: Changing component path "VP_42:" to "/55E04F54".

Changing component "VP_42:/55E04F54" pin "VP" net name from "GND" to "/GND".

Info: Checking netlist component footprint "VP_43:/55E0501C:VPAD_VPAC2".

Info: Changing component path "VP_43:" to "/55E0501C".

Changing component "VP_43:/55E0501C" pin "VP" net name from "GND" to "/GND".

Info: Checking netlist component footprint "VP_44:/55E050E4:VPAD_VPAC0".

Info: Changing component path "VP_44:" to "/55E050E4".

Changing component "VP_44:/55E050E4" pin "VP" net name from "GND" to "/GND".

Info: Checking netlist component footprint "VP_45:/55E051AC:VPAD_VPAC0".

Info: Changing component path "VP_45:" to "/55E051AC".

Changing component "VP_45:/55E051AC" pin "VP" net name from "GND" to "/GND".

Info: Checking netlist component footprint "VP_46:/55E05274:VPAD_VPAC0".

Info: Changing component path "VP_46:" to "/55E05274".

Changing component "VP_46:/55E05274" pin "VP" net name from "GND" to "/GND".

Info: Checking netlist component footprint "VP_47:/55E0533C:VPAD_VPAC0".

Info: Changing component path "VP_47:" to "/55E0533C".

Changing component "VP_47:/55E0533C" pin "VP" net name from "GND" to "/GND".

Info: Checking netlist component footprint "VP_48:/55E05404:VPAD_VPAC0".

Info: Changing component path "VP_48:" to "/55E05404".

Changing component "VP_48:/55E05404" pin "VP" net name from "GND" to "/GND".

Info: Checking netlist component footprint "VP_49:/55E054CC:VPAD_VPAC0".

Info: Changing component path "VP_49:" to "/55E054CC".

Changing component "VP_49:/55E054CC" pin "VP" net name from "GND" to "/GND".

Info: Checking netlist component footprint "VP_50:/55E05594:VPAD_VPAC3".

Info: Changing component path "VP_50:" to "/55E05594".

Changing component "VP_50:/55E05594" pin "VP" net name from "GND" to "/GND".

Info: Checking netlist component footprint "VP_51:/55E0565C:VPAD_VPAC3".

Info: Changing component path "VP_51:" to "/55E0565C".

Changing component "VP_51:/55E0565C" pin "VP" net name from "GND" to "/GND".

Info: Checking netlist component footprint "VP_52:/55E05724:VPAD_VPAC4".

Info: Changing component path "VP_52:" to "/55E05724".

Changing component "VP_52:/55E05724" pin "VP" net name from "GND" to "/GND".

Info: Checking netlist component footprint "VP_53:/55E057EC:VPAD_VPAC3".

Info: Changing component path "VP_53:" to "/55E057EC".

Changing component "VP_53:/55E057EC" pin "VP" net name from "GND" to "/GND".

Info: Checking netlist component footprint "VP_54:/55E058B4:VPAD_VPAC0".

Info: Changing component path "VP_54:" to "/55E058B4".

Changing component "VP_54:/55E058B4" pin "VP" net name from "GND" to "/GND".

Info: Checking netlist component footprint "VP_55:/55E0597C:VPAD_VPAC0".

Info: Changing component path "VP_55:" to "/55E0597C".

Changing component "VP_55:/55E0597C" pin "VP" net name from "GND" to "/GND".

Info: Checking netlist component footprint "VP_56:/55E05A44:VPAD_VPAC0".

Info: Changing component path "VP_56:" to "/55E05A44".

Changing component "VP_56:/55E05A44" pin "VP" net name from "N$15" to "/N$15".

Info: Checking netlist component footprint "VR1:/55E05B0C:OLIMEX_DISCRET_SOT-23-5".

Info: Changing component path "VR1:" to "/55E05B0C".

Changing component "VR1:/55E05B0C" pin "1" net name from "VCC" to "/VCC".

Changing component "VR1:/55E05B0C" pin "2" net name from "GND" to "/GND".

Changing component "VR1:/55E05B0C" pin "3" net name from "VCC" to "/VCC".

Changing component "VR1:/55E05B0C" pin "5" net name from "VDD" to "/VDD".

Warning: Copper zone (net name 'GND'): net has no pads connected.
Warning: Copper zone (net name 'GND'): net has no pads connected.
Warning: Copper zone (net name 'GND'): net has no pads connected.
Warning: Copper zone (net name 'GND'): net has no pads connected.
Warning: Copper zone (net name 'VCC'): net has no pads connected.
Warning: Copper zone (net name 'VCC'): net has no pads connected.
Warning: Copper zone (net name 'V+'): net has no pads connected.
Warning: Copper zone (net name 'VCC/2'): net has no pads connected.
Warning: Copper zone (net name 'VCCINT'): net has no pads connected.
