Jonathon-Reilly/Kicad/kicad-resources/kicad-tools/eagle-to-kicad/examples/OLINUXINO/iMX233-OLinuXino-Micro_Rev_D/kicad_files/report.txt

Info: Reading netlist file "/home/laudas/eagle/eagle-lbr2kicad/examples/OLINUXINO/iMX233-OLinuXino-Micro_Rev_D/kicad_files/iMX233-OLinuXino-Micro_Rev_D.net".

Info: Using references to match components and footprints.

* Warning: component 'D2': board footprint 'SOT23C(BAT54S)', netlist footprint 'SEMICON-SMD-IPC_SOT23C(BAT54S)'

* Warning: component 'D4': board footprint 'SOT23C', netlist footprint 'SEMICON-SMD-IPC_SOT23C'

* Warning: component 'T1': board footprint 'SOT23', netlist footprint 'SEMICON-SMD-IPC_SOT23'

* Warning: component 'T2': board footprint 'SOT23', netlist footprint 'SEMICON-SMD-IPC_SOT23'

* Warning: component 'R12': board footprint 'R0603_5MIL_DWS', netlist footprint 'RCL_R0603_5MIL_DWS'

* Warning: component 'R22': board footprint 'R0603_5MIL_DWS', netlist footprint 'RCL_R0603_5MIL_DWS'

* Warning: component 'R21': board footprint 'R0603_5MIL_DWS', netlist footprint 'RCL_R0603_5MIL_DWS'

* Warning: component 'R20': board footprint 'R0603_5MIL_DWS', netlist footprint 'RCL_R0603_5MIL_DWS'

* Warning: component 'R19': board footprint 'R0603_5MIL_DWS', netlist footprint 'RCL_R0603_5MIL_DWS'

* Warning: component 'R18': board footprint 'R0603_5MIL_DWS', netlist footprint 'RCL_R0603_5MIL_DWS'

* Warning: component 'R17': board footprint 'R0603_5MIL_DWS', netlist footprint 'RCL_R0603_5MIL_DWS'

* Warning: component 'R16': board footprint 'R0603_5MIL_DWS', netlist footprint 'RCL_R0603_5MIL_DWS'

* Warning: component 'R15': board footprint 'R0603_5MIL_DWS', netlist footprint 'RCL_R0603_5MIL_DWS'

* Warning: component 'R14': board footprint 'R0603_5MIL_DWS', netlist footprint 'RCL_R0603_5MIL_DWS'

* Warning: component 'R13': board footprint 'R0603_5MIL_DWS', netlist footprint 'RCL_R0603_5MIL_DWS'

* Warning: component 'R25': board footprint 'R0603_5MIL_DWS', netlist footprint 'RCL_R0603_5MIL_DWS'

* Warning: component 'R11': board footprint 'R0603_5MIL_DWS', netlist footprint 'RCL_R0603_5MIL_DWS'

* Warning: component 'R10': board footprint 'R0603_5MIL_DWS', netlist footprint 'RCL_R0603_5MIL_DWS'

* Warning: component 'R2': board footprint 'R0603_5MIL_DWS', netlist footprint 'RCL_R0603_5MIL_DWS'

* Warning: component 'R3': board footprint 'R0603_5MIL_DWS', netlist footprint 'RCL_R0603_5MIL_DWS'

* Warning: component 'R4': board footprint 'R0603_5MIL_DWS', netlist footprint 'RCL_R0603_5MIL_DWS'

* Warning: component 'R5': board footprint 'R0603_5MIL_DWS', netlist footprint 'RCL_R0603_5MIL_DWS'

* Warning: component 'R9': board footprint 'R0603_5MIL_DWS', netlist footprint 'RCL_R0603_5MIL_DWS'

* Warning: component 'R7': board footprint 'R0603_5MIL_DWS', netlist footprint 'RCL_R0603_5MIL_DWS'

* Warning: component 'R8': board footprint 'R0603_5MIL_DWS', netlist footprint 'RCL_R0603_5MIL_DWS'

* Warning: component 'L1': board footprint 'L7078', netlist footprint 'RCL_L7078'

* Warning: component 'L2': board footprint 'L0805_5MIL_DWS', netlist footprint 'RCL_L0805_5MIL_DWS'

* Warning: component 'L3': board footprint 'L0805_5MIL_DWS', netlist footprint 'RCL_L0805_5MIL_DWS'

* Warning: component 'L4': board footprint 'L0805_5MIL_DWS', netlist footprint 'RCL_L0805_5MIL_DWS'

* Warning: component 'C51': board footprint 'E2,5-6,3', netlist footprint 'RCL_E2_5-6_3'

* Warning: component 'C50': board footprint 'E2,5-6,3', netlist footprint 'RCL_E2_5-6_3'

* Warning: component 'C48': board footprint 'E2,5-6,3', netlist footprint 'RCL_E2_5-6_3'

* Warning: component 'C3': board footprint 'C1206', netlist footprint 'RCL_C1206'

* Warning: component 'C18': board footprint 'C0603_DWS', netlist footprint 'RCL_C0603_DWS'

* Warning: component 'C14': board footprint 'C0603_DWS', netlist footprint 'RCL_C0603_DWS'

* Warning: component 'C15': board footprint 'C0603_DWS', netlist footprint 'RCL_C0603_DWS'

* Warning: component 'C16': board footprint 'C0603_DWS', netlist footprint 'RCL_C0603_DWS'

* Warning: component 'C17': board footprint 'C0603_DWS', netlist footprint 'RCL_C0603_DWS'

* Warning: component 'C21': board footprint 'C0603_DWS', netlist footprint 'RCL_C0603_DWS'

* Warning: component 'C19': board footprint 'C0603_DWS', netlist footprint 'RCL_C0603_DWS'

* Warning: component 'C20': board footprint 'C0603_DWS', netlist footprint 'RCL_C0603_DWS'

* Warning: component 'C25': board footprint 'C0603_DWS', netlist footprint 'RCL_C0603_DWS'

* Warning: component 'C13': board footprint 'C0603_DWS', netlist footprint 'RCL_C0603_DWS'

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

* Warning: component 'U2': board footprint '66TSOP-II', netlist footprint 'OLIMEX_IC_66TSOP-II'

* Warning: component 'VR1': board footprint 'SOT-23-5', netlist footprint 'OLIMEX_DISCRET_SOT-23-5'

* Warning: component 'T3': board footprint 'SOT-23', netlist footprint 'OLIMEX_DISCRET_SOT-23'

* Warning: component 'T4': board footprint 'SOT-23', netlist footprint 'OLIMEX_DISCRET_SOT-23'

* Warning: component 'RM1': board footprint 'R_MATRIX_4', netlist footprint 'OLIMEX_DISCRET_R_MATRIX_4'

* Warning: component 'RM2': board footprint 'R_MATRIX_4', netlist footprint 'OLIMEX_DISCRET_R_MATRIX_4'

* Warning: component 'RM3': board footprint 'R_MATRIX_4', netlist footprint 'OLIMEX_DISCRET_R_MATRIX_4'

* Warning: component 'D3': board footprint 'DO214AA', netlist footprint 'OLIMEX_DISCRET_DO214AA'

* Warning: component 'R1': board footprint '0603_0R', netlist footprint 'OLIMEX_DISCRET_0603_0R'

* Warning: component 'R26': board footprint '0603_0R', netlist footprint 'OLIMEX_DISCRET_0603_0R'

* Warning: component 'R6': board footprint '0603_0R', netlist footprint 'OLIMEX_DISCRET_0603_0R'

* Warning: component 'COMPOSITE_VIDEO135': board footprint 'VIDEO_CINCH', netlist footprint 'OLIMEX_CONNECTORS_VIDEO_CINCH'

* Warning: component 'USB_HOST135': board footprint 'USB_PN87520_HOST_PTH', netlist footprint 'OLIMEX_CONNECTORS_USB_PN87520_HOST_PTH'

* Warning: component 'SD/MMC135': board footprint 'TFC-WPAPR-08', netlist footprint 'OLIMEX_CONNECTORS_TFC-WPAPR-08'

* Warning: component 'SDA_HW/SDA_SW135': board footprint 'SJ_2_SMALL', netlist footprint 'JUMPER_SJ_2_SMALL'

* Warning: component 'CS_SW/CS_HW135': board footprint 'SJ_2_SMALL', netlist footprint 'JUMPER_SJ_2_SMALL'

* Warning: component 'SCL_HW/SCL_SW135': board footprint 'SJ_2_SMALL', netlist footprint 'JUMPER_SJ_2_SMALL'

* Warning: component 'D01_H135': board footprint 'SJ_1_SMALLER', netlist footprint 'JUMPER_SJ_1_SMALLER'

* Warning: component 'D03_H135': board footprint 'SJ_1_SMALLER', netlist footprint 'JUMPER_SJ_1_SMALLER'

* Warning: component 'D02_H135': board footprint 'SJ_1_SMALLER', netlist footprint 'JUMPER_SJ_1_SMALLER'

* Warning: component '3.3V_E135': board footprint 'SJ_1_SMALLER', netlist footprint 'JUMPER_SJ_1_SMALLER'

* Warning: component 'D00_H135': board footprint 'SJ_1_SMALLER', netlist footprint 'JUMPER_SJ_1_SMALLER'

* Warning: component '5V_E135': board footprint 'SJ-CLOSE', netlist footprint 'JUMPER_SJ-CLOSE'

* Warning: component 'RESET135': board footprint 'SW-TAKT_6X3.5_SMD', netlist footprint 'GOGO_SW-TAKT_6X3.5_SMD'

* Warning: component 'RECOVERY135': board footprint 'SW-TAKT_6X3.5_SMD', netlist footprint 'GOGO_SW-TAKT_6X3.5_SMD'

* Warning: component 'POWER135': board footprint 'SW-TAKT_6X3.5_SMD', netlist footprint 'GOGO_SW-TAKT_6X3.5_SMD'

* Warning: component 'PWR135': board footprint 'PWR_JACK_UNI_MILLING', netlist footprint 'GOGO_PWR_JACK_UNI_MILLING'

* Warning: component 'D1': board footprint 'MLL-41', netlist footprint 'GOGO_MLL-41'

* Warning: component 'LED1': board footprint 'LED-0603', netlist footprint 'DOUBLE-SIDE_LED-0603'

* Warning: component 'Q1': board footprint 'HC49%2fSMD2_THIN', netlist footprint 'CRYSTAL_HC49_SMD2_THIN'

Info: Checking netlist component footprint "3.3V_E135:/55E28C3D:JUMPER_SJ_1_SMALLER".

Info: Changing component path "3.3V_E135:" to "/55E28C3D".

Changing component "3.3V_E135:/55E28C3D" pin "1" net name from "N$2" to "/N$2".

Info: Checking netlist component footprint "5V_E135:/55E28D05:JUMPER_SJ-CLOSE".

Info: Changing component path "5V_E135:" to "/55E28D05".

Changing component "5V_E135:/55E28D05" pin "1" net name from "N$3" to "/N$3".

Info: Checking netlist component footprint "C1:/55E28DCD:RCL_C0603_DWS".

Info: Changing component path "C1:" to "/55E28DCD".

Changing component "C1:/55E28DCD" pin "2" net name from "DCDC_VDDD" to "/DCDC_VDDD".

Info: Checking netlist component footprint "C2:/55E28E95:RCL_C0603_DWS".

Info: Changing component path "C2:" to "/55E28E95".

Changing component "C2:/55E28E95" pin "2" net name from "DCDC_VDDD" to "/DCDC_VDDD".

Info: Checking netlist component footprint "C3:/55E28F5D:RCL_C1206".

Info: Changing component path "C3:" to "/55E28F5D".

Info: Checking netlist component footprint "C4:/55E29025:RCL_C0603_DWS".

Info: Changing component path "C4:" to "/55E29025".

Changing component "C4:/55E29025" pin "1" net name from "N$38" to "/N$38".

Info: Checking netlist component footprint "C5:/55E290ED:RCL_C0603_DWS".

Info: Changing component path "C5:" to "/55E290ED".

Info: Checking netlist component footprint "C6:/55E291B5:RCL_C0603_DWS".

Info: Changing component path "C6:" to "/55E291B5".

Info: Checking netlist component footprint "C7:/55E2927D:RCL_C0603_DWS".

Info: Changing component path "C7:" to "/55E2927D".

Info: Checking netlist component footprint "C8:/55E29345:RCL_C0603_DWS".

Info: Changing component path "C8:" to "/55E29345".

Info: Checking netlist component footprint "C9:/55E2940D:RCL_C0603_DWS".

Info: Changing component path "C9:" to "/55E2940D".

Changing component "C9:/55E2940D" pin "2" net name from "VDD4P2" to "/VDD4P2".

Info: Checking netlist component footprint "C10:/55E294D5:RCL_C0603_DWS".

Info: Changing component path "C10:" to "/55E294D5".

Changing component "C10:/55E294D5" pin "2" net name from "VDD4P2" to "/VDD4P2".

Info: Checking netlist component footprint "C11:/55E2959D:RCL_C0603_DWS".

Info: Changing component path "C11:" to "/55E2959D".

Info: Checking netlist component footprint "C12:/55E29665:RCL_C0603_DWS".

Info: Changing component path "C12:" to "/55E29665".

Info: Checking netlist component footprint "C13:/55E2972D:RCL_C0603_DWS".

Info: Changing component path "C13:" to "/55E2972D".

Changing component "C13:/55E2972D" pin "2" net name from "DCDC_VDDD" to "/DCDC_VDDD".

Info: Checking netlist component footprint "C14:/55E297F5:RCL_C0603_DWS".

Info: Changing component path "C14:" to "/55E297F5".

Changing component "C14:/55E297F5" pin "2" net name from "DCDC_VDDD" to "/DCDC_VDDD".

Info: Checking netlist component footprint "C15:/55E298BD:RCL_C0603_DWS".

Info: Changing component path "C15:" to "/55E298BD".

Changing component "C15:/55E298BD" pin "2" net name from "DCDC_VDDIO" to "/DCDC_VDDIO".

Info: Checking netlist component footprint "C16:/55E29985:RCL_C0603_DWS".

Info: Changing component path "C16:" to "/55E29985".

Changing component "C16:/55E29985" pin "2" net name from "DCDC_VDDIO" to "/DCDC_VDDIO".

Info: Checking netlist component footprint "C17:/55E29A4D:RCL_C0603_DWS".

Info: Changing component path "C17:" to "/55E29A4D".

Changing component "C17:/55E29A4D" pin "2" net name from "DCDC_VDDA" to "/DCDC_VDDA".

Info: Checking netlist component footprint "C18:/55E29B15:RCL_C0603_DWS".

Info: Changing component path "C18:" to "/55E29B15".

Changing component "C18:/55E29B15" pin "2" net name from "DCDC_VDDA" to "/DCDC_VDDA".

Info: Checking netlist component footprint "C19:/55E29BDD:RCL_C0603_DWS".

Info: Changing component path "C19:" to "/55E29BDD".

Info: Checking netlist component footprint "C20:/55E29CA5:RCL_C0603_DWS".

Info: Changing component path "C20:" to "/55E29CA5".

Info: Checking netlist component footprint "C21:/55E29D6D:RCL_C0603_DWS".

Info: Changing component path "C21:" to "/55E29D6D".

Info: Checking netlist component footprint "C22:/55E29E35:RCL_C0603_DWS".

Info: Changing component path "C22:" to "/55E29E35".

Changing component "C22:/55E29E35" pin "2" net name from "VDDXTAL" to "/VDDXTAL".

Info: Checking netlist component footprint "C23:/55E29EFD:RCL_C0603_DWS".

Info: Changing component path "C23:" to "/55E29EFD".

Changing component "C23:/55E29EFD" pin "2" net name from "XTALI" to "/XTALI".

Info: Checking netlist component footprint "C24:/55E29FC5:RCL_C0603_DWS".

Info: Changing component path "C24:" to "/55E29FC5".

Changing component "C24:/55E29FC5" pin "2" net name from "XTALO" to "/XTALO".

Info: Checking netlist component footprint "C25:/55E2A08D:RCL_C0603_DWS".

Info: Changing component path "C25:" to "/55E2A08D".

Changing component "C25:/55E2A08D" pin "2" net name from "DCDC_VDDA" to "/DCDC_VDDA".

Info: Checking netlist component footprint "C26:/55E2A155:RCL_C0603_DWS".

Info: Changing component path "C26:" to "/55E2A155".

Changing component "C26:/55E2A155" pin "2" net name from "N$25" to "/N$25".

Info: Checking netlist component footprint "C27:/55E2A21D:RCL_C0603_DWS".

Info: Changing component path "C27:" to "/55E2A21D".

Info: Checking netlist component footprint "C28:/55E2A2E5:RCL_C0603_DWS".

Info: Changing component path "C28:" to "/55E2A2E5".

Info: Checking netlist component footprint "C29:/55E2A3AD:RCL_C0603_DWS".

Info: Changing component path "C29:" to "/55E2A3AD".

Changing component "C29:/55E2A3AD" pin "2" net name from "SD_VCC" to "/SD_VCC".

Info: Checking netlist component footprint "C30:/55E2A475:RCL_C0603_DWS".

Info: Changing component path "C30:" to "/55E2A475".

Info: Checking netlist component footprint "C31:/55E2A53D:RCL_C0603_DWS".

Info: Changing component path "C31:" to "/55E2A53D".

Info: Checking netlist component footprint "C32:/55E2A605:RCL_C0603_DWS".

Info: Changing component path "C32:" to "/55E2A605".

Info: Checking netlist component footprint "C33:/55E2A6CD:RCL_C0603_DWS".

Info: Changing component path "C33:" to "/55E2A6CD".

Info: Checking netlist component footprint "C34:/55E2A795:RCL_C0603_DWS".

Info: Changing component path "C34:" to "/55E2A795".

Info: Checking netlist component footprint "C35:/55E2A85D:RCL_C0603_DWS".

Info: Changing component path "C35:" to "/55E2A85D".

Info: Checking netlist component footprint "C36:/55E2A925:RCL_C0603_DWS".

Info: Changing component path "C36:" to "/55E2A925".

Info: Checking netlist component footprint "C37:/55E2A9ED:RCL_C0603_DWS".

Info: Changing component path "C37:" to "/55E2A9ED".

Info: Checking netlist component footprint "C38:/55E2AAB5:RCL_C0603_DWS".

Info: Changing component path "C38:" to "/55E2AAB5".

Changing component "C38:/55E2AAB5" pin "2" net name from "N$7" to "/N$7".

Info: Checking netlist component footprint "C39:/55E2AB7D:RCL_C0603_DWS".

Info: Changing component path "C39:" to "/55E2AB7D".

Changing component "C39:/55E2AB7D" pin "2" net name from "N$7" to "/N$7".

Info: Checking netlist component footprint "C40:/55E2AC45:RCL_C0603_DWS".

Info: Changing component path "C40:" to "/55E2AC45".

Info: Checking netlist component footprint "C41:/55E2AD0D:RCL_C0603_DWS".

Info: Changing component path "C41:" to "/55E2AD0D".

Info: Checking netlist component footprint "C42:/55E2ADD5:RCL_C0603_DWS".

Info: Changing component path "C42:" to "/55E2ADD5".

Changing component "C42:/55E2ADD5" pin "2" net name from "DCDC_VDDIO" to "/DCDC_VDDIO".

Info: Checking netlist component footprint "C43:/55E2AE9D:RCL_C0603_DWS".

Info: Changing component path "C43:" to "/55E2AE9D".

Info: Checking netlist component footprint "C44:/55E2AF65:RCL_C0603_DWS".

Info: Changing component path "C44:" to "/55E2AF65".

Changing component "C44:/55E2AF65" pin "2" net name from "SD_VCC" to "/SD_VCC".

Info: Checking netlist component footprint "C45:/55E2B02D:RCL_C0603_DWS".

Info: Changing component path "C45:" to "/55E2B02D".

Changing component "C45:/55E2B02D" pin "2" net name from "N$19" to "/N$19".

Info: Checking netlist component footprint "C46:/55E2B0F5:RCL_C0603_DWS".

Info: Changing component path "C46:" to "/55E2B0F5".

Changing component "C46:/55E2B0F5" pin "2" net name from "N$18" to "/N$18".

Info: Checking netlist component footprint "C47:/55E2B1BD:RCL_C0603_DWS".

Info: Changing component path "C47:" to "/55E2B1BD".

Info: Checking netlist component footprint "C48:/55E2B285:RCL_E2_5-6_3".

Info: Changing component path "C48:" to "/55E2B285".

Changing component "C48:/55E2B285" pin "+" net name from "+5V_HOST_PWR" to "/+5V_HOST_PWR".

Info: Checking netlist component footprint "C49:/55E2B34D:RCL_C0603_DWS".

Info: Changing component path "C49:" to "/55E2B34D".

Changing component "C49:/55E2B34D" pin "1" net name from "N$4" to "/N$4".

Info: Checking netlist component footprint "C50:/55E2B415:RCL_E2_5-6_3".

Info: Changing component path "C50:" to "/55E2B415".

Changing component "C50:/55E2B415" pin "+" net name from "N$3" to "/N$3".

Info: Checking netlist component footprint "C51:/55E2B4DD:RCL_E2_5-6_3".

Info: Changing component path "C51:" to "/55E2B4DD".

Changing component "C51:/55E2B4DD" pin "+" net name from "N$3" to "/N$3".

Info: Checking netlist component footprint "COMPOSITE_VIDEO135:/55E2B5A5:OLIMEX_CONNECTORS_VIDEO_CINCH".

Info: Changing component path "COMPOSITE_VIDEO135:" to "/55E2B5A5".

Changing component "COMPOSITE_VIDEO135:/55E2B5A5" pin "IO" net name from "N$4" to "/N$4".

Changing component "COMPOSITE_VIDEO135:/55E2B5A5" pin "GNG3" net name from "" to "GND".

Changing component "COMPOSITE_VIDEO135:/55E2B5A5" pin "GNG3" net name from "" to "GND".

Info: Checking netlist component footprint "CON1:/55E2B66D:PENKO_HN1X30".

Info: Changing component path "CON1:" to "/55E2B66D".

Changing component "CON1:/55E2B66D" pin "3" net name from "PIN1/LCD_D00" to "/PIN1/LCD_D00".

Changing component "CON1:/55E2B66D" pin "4" net name from "PIN2/LCD_D01" to "/PIN2/LCD_D01".

Changing component "CON1:/55E2B66D" pin "5" net name from "PIN3/LCD_D02" to "/PIN3/LCD_D02".

Changing component "CON1:/55E2B66D" pin "6" net name from "PIN4/LCD_D03" to "/PIN4/LCD_D03".

Changing component "CON1:/55E2B66D" pin "7" net name from "PIN5/LCD_D04" to "/PIN5/LCD_D04".

Changing component "CON1:/55E2B66D" pin "8" net name from "PIN6/LCD_D05" to "/PIN6/LCD_D05".

Changing component "CON1:/55E2B66D" pin "9" net name from "PIN7/LCD_D06" to "/PIN7/LCD_D06".

Changing component "CON1:/55E2B66D" pin "10" net name from "PIN8/LCD_D07" to "/PIN8/LCD_D07".

Changing component "CON1:/55E2B66D" pin "11" net name from "PIN9/LCD_D08/SSP2_MISO" to "/PIN9/LCD_D08/SSP2_MISO".

Changing component "CON1:/55E2B66D" pin "12" net name from "PIN10/LCD_D09" to "/PIN10/LCD_D09".

Changing component "CON1:/55E2B66D" pin "13" net name from "PIN11/LCD_D10" to "/PIN11/LCD_D10".

Changing component "CON1:/55E2B66D" pin "14" net name from "PIN12/LCD_D11" to "/PIN12/LCD_D11".

Changing component "CON1:/55E2B66D" pin "15" net name from "PIN13/LCD_D12" to "/PIN13/LCD_D12".

Changing component "CON1:/55E2B66D" pin "16" net name from "PIN14/LCD_D13" to "/PIN14/LCD_D13".

Changing component "CON1:/55E2B66D" pin "17" net name from "PIN15/LCD_D14" to "/PIN15/LCD_D14".

Changing component "CON1:/55E2B66D" pin "18" net name from "PIN16/LCD_D15" to "/PIN16/LCD_D15".

Changing component "CON1:/55E2B66D" pin "19" net name from "PIN17/LCD_D16" to "/PIN17/LCD_D16".

Changing component "CON1:/55E2B66D" pin "20" net name from "PIN18/LCD_D17/USB_EN" to "/PIN18/LCD_D17/USB_EN".

Changing component "CON1:/55E2B66D" pin "21" net name from "PIN19/LCD_DOTCLK" to "/PIN19/LCD_DOTCLK".

Changing component "CON1:/55E2B66D" pin "22" net name from "PIN20/LCD_VSYNC" to "/PIN20/LCD_VSYNC".

Changing component "CON1:/55E2B66D" pin "23" net name from "PIN21/LCD_HSYNC/I2C_SDA" to "/PIN21/LCD_HSYNC/I2C_SDA".

Changing component "CON1:/55E2B66D" pin "24" net name from "PIN22/LCD_EN/I2C_SCL" to "/PIN22/LCD_EN/I2C_SCL".

Changing component "CON1:/55E2B66D" pin "25" net name from "PIN23/LCD_DISP" to "/PIN23/LCD_DISP".

Changing component "CON1:/55E2B66D" pin "26" net name from "PIN24/LCD_WR" to "/PIN24/LCD_WR".

Changing component "CON1:/55E2B66D" pin "27" net name from "PIN25/LCD_RS" to "/PIN25/LCD_RS".

Changing component "CON1:/55E2B66D" pin "28" net name from "PIN26/LCD_CS" to "/PIN26/LCD_CS".

Changing component "CON1:/55E2B66D" pin "30" net name from "N$2" to "/N$2".

Info: Checking netlist component footprint "CON2:/55E2B735:PENKO_HN1X30".

Info: Changing component path "CON2:" to "/55E2B735".

Changing component "CON2:/55E2B735" pin "5" net name from "AUART1_TXD" to "/AUART1_TXD".

Changing component "CON2:/55E2B735" pin "6" net name from "AUART1_RXD" to "/AUART1_RXD".

Changing component "CON2:/55E2B735" pin "7" net name from "I2C_SCL" to "/I2C_SCL".

Changing component "CON2:/55E2B735" pin "8" net name from "I2C_SDA" to "/I2C_SDA".

Changing component "CON2:/55E2B735" pin "9" net name from "PIN9/LCD_D08/SSP2_MISO" to "/PIN9/LCD_D08/SSP2_MISO".

Changing component "CON2:/55E2B735" pin "10" net name from "SSP2_MOSI" to "/SSP2_MOSI".

Changing component "CON2:/55E2B735" pin "11" net name from "SSP2_SCK" to "/SSP2_SCK".

Changing component "CON2:/55E2B735" pin "12" net name from "N$14" to "/CS_UEXT_GPIO".

Changing component "CON2:/55E2B735" pin "13" net name from "PWM0/DUART_RXD" to "/PWM0/DUART_RXD".

Changing component "CON2:/55E2B735" pin "14" net name from "PWM1/DUART_TXD" to "/PWM1/DUART_TXD".

Changing component "CON2:/55E2B735" pin "15" net name from "SJTAG_PSW" to "/SJTAG_PSW".

Changing component "CON2:/55E2B735" pin "16" net name from "HPL" to "/HPL".

Changing component "CON2:/55E2B735" pin "17" net name from "HPR" to "/HPR".

Changing component "CON2:/55E2B735" pin "18" net name from "HP_VGND" to "/HP_VGND".

Changing component "CON2:/55E2B735" pin "19" net name from "LIN1_INL" to "/LIN1_INL".

Changing component "CON2:/55E2B735" pin "20" net name from "LIN1_INR" to "/LIN1_INR".

Changing component "CON2:/55E2B735" pin "21" net name from "PIN34/MIC" to "/PIN34/MIC".

Changing component "CON2:/55E2B735" pin "22" net name from "PIN33/LRADC0" to "/PIN33/LRADC0".

Changing component "CON2:/55E2B735" pin "23" net name from "PIN32/LRADC1" to "/PIN32/LRADC1".

Changing component "CON2:/55E2B735" pin "24" net name from "PIN31" to "/PIN31".

Changing component "CON2:/55E2B735" pin "25" net name from "PIN30" to "/PIN30".

Changing component "CON2:/55E2B735" pin "26" net name from "PIN29/SOFT_SCL" to "/PIN29/SOFT_SCL".

Changing component "CON2:/55E2B735" pin "27" net name from "PIN28/SOFT_SDA" to "/PIN28/SOFT_SDA".

Changing component "CON2:/55E2B735" pin "28" net name from "PIN27/PWM2" to "/PIN27/PWM2".

Info: Checking netlist component footprint "CS_SW/CS_HW135:/55E2B7FD:JUMPER_SJ_2_SMALL".

Info: Changing component path "CS_SW/CS_HW135:" to "/55E2B7FD".

Changing component "CS_SW/CS_HW135:/55E2B7FD" pin "1" net name from "CS_UEXT" to "/CS_UEXT".

Changing component "CS_SW/CS_HW135:/55E2B7FD" pin "2" net name from "N$14" to "/CS_UEXT_GPIO".

Changing component "CS_SW/CS_HW135:/55E2B7FD" pin "3" net name from "PIN12/LCD_D11" to "/PIN12/LCD_D11".

Info: Checking netlist component footprint "D00_H135:/55E2B8C5:JUMPER_SJ_1_SMALLER".

Info: Changing component path "D00_H135:" to "/55E2B8C5".

Changing component "D00_H135:/55E2B8C5" pin "1" net name from "N$105" to "/N$105".

Info: Checking netlist component footprint "D1:/55E2B98D:GOGO_MLL-41".

Info: Changing component path "D1:" to "/55E2B98D".

Changing component "D1:/55E2B98D" pin "K" net name from "VDD4P2" to "/VDD4P2".

Info: Checking netlist component footprint "D01_H135:/55E2BA55:JUMPER_SJ_1_SMALLER".

Info: Changing component path "D01_H135:" to "/55E2BA55".

Changing component "D01_H135:/55E2BA55" pin "1" net name from "N$104" to "/N$104".

Info: Checking netlist component footprint "D2:/55E2BB1D:SEMICON-SMD-IPC_SOT23C(BAT54S)".

Info: Changing component path "D2:" to "/55E2BB1D".

Changing component "D2:/55E2BB1D" pin "3" net name from "N$4" to "/N$4".

Info: Checking netlist component footprint "D02_H135:/55E2BBE5:JUMPER_SJ_1_SMALLER".

Info: Changing component path "D02_H135:" to "/55E2BBE5".

Changing component "D02_H135:/55E2BBE5" pin "1" net name from "N$103" to "/N$103".

Info: Checking netlist component footprint "D3:/55E2BCAD:OLIMEX_DISCRET_DO214AA".

Info: Changing component path "D3:" to "/55E2BCAD".

Changing component "D3:/55E2BCAD" pin "C" net name from "N$3" to "/N$3".

Info: Checking netlist component footprint "D03_H135:/55E2BD75:JUMPER_SJ_1_SMALLER".

Info: Changing component path "D03_H135:" to "/55E2BD75".

Changing component "D03_H135:/55E2BD75" pin "1" net name from "N$101" to "/N$101".

Info: Checking netlist component footprint "D4:/55E2BE3D:SEMICON-SMD-IPC_SOT23C".

Info: Changing component path "D4:" to "/55E2BE3D".

Changing component "D4:/55E2BE3D" pin "3" net name from "CS_UEXT_GPIO" to "/N$11".

Changing component "D4:/55E2BE3D" pin "2" net name from "PWM0/DUART_RXD" to "/PWM0/DUART_RXD".

Changing component "D4:/55E2BE3D" pin "1" net name from "" to "Net-(D4-Pad1)".

Info: Checking netlist component footprint "FET1:/55E2BF05:PENKO_SOT23".

Info: Changing component path "FET1:" to "/55E2BF05".

Changing component "FET1:/55E2BF05" pin "2" net name from "N$3" to "/N$3".

Changing component "FET1:/55E2BF05" pin "1" net name from "N$9" to "/N$12".

Info: Checking netlist component footprint "JTAG135:/55E2CFD1:PENKO_WU08S".

Info: Changing component path "JTAG135:" to "/55E2CFD1".

Changing component "JTAG135:/55E2CFD1" pin "4" net name from "SSP1_SCK" to "/SSP1_SCK".

Changing component "JTAG135:/55E2CFD1" pin "2" net name from "SSP1_DATA0" to "/SSP1_DATA0".

Changing component "JTAG135:/55E2CFD1" pin "1" net name from "SSP1_DATA1" to "/SSP1_DATA1".

Changing component "JTAG135:/55E2CFD1" pin "5" net name from "SD_VCC" to "/SD_VCC".

Changing component "JTAG135:/55E2CFD1" pin "6" net name from "SSP1_CMD" to "/SSP1_CMD".

Changing component "JTAG135:/55E2CFD1" pin "7" net name from "SSP1_DATA3" to "/SSP1_DATA3".

Changing component "JTAG135:/55E2CFD1" pin "8" net name from "SSP1_DATA2" to "/SSP1_DATA2".

Info: Checking netlist component footprint "L1:/55E2D099:RCL_L7078".

Info: Changing component path "L1:" to "/55E2D099".

Changing component "L1:/55E2D099" pin "1" net name from "N$19" to "/N$19".

Changing component "L1:/55E2D099" pin "2" net name from "N$18" to "/N$18".

Info: Checking netlist component footprint "L2:/55E2D161:RCL_L0805_5MIL_DWS".

Info: Changing component path "L2:" to "/55E2D161".

Changing component "L2:/55E2D161" pin "1" net name from "+5V_HOST_PWR" to "/+5V_HOST_PWR".

Changing component "L2:/55E2D161" pin "2" net name from "N$5" to "/N$5".

Info: Checking netlist component footprint "L3:/55E2D229:RCL_L0805_5MIL_DWS".

Info: Changing component path "L3:" to "/55E2D229".

Changing component "L3:/55E2D229" pin "2" net name from "N$266" to "/N$266".

Info: Checking netlist component footprint "L4:/55E2D2F1:RCL_L0805_5MIL_DWS".

Info: Changing component path "L4:" to "/55E2D2F1".

Changing component "L4:/55E2D2F1" pin "2" net name from "SD_VCC" to "/SD_VCC".

Info: Checking netlist component footprint "LED1:/55E2D3B9:DOUBLE-SIDE_LED-0603".

Info: Changing component path "LED1:" to "/55E2D3B9".

Changing component "LED1:/55E2D3B9" pin "C" net name from "N$42" to "/N$42".

Changing component "LED1:/55E2D3B9" pin "A" net name from "LED1" to "/LED1".

Info: Checking netlist component footprint "POWER135:/55E2D931:GOGO_SW-TAKT_6X3.5_SMD".

Info: Changing component path "POWER135:" to "/55E2D931".

Changing component "POWER135:/55E2D931" pin "P$1" net name from "N$1" to "/N$1".

Changing component "POWER135:/55E2D931" pin "P$2" net name from "SJTAG_PSW" to "/SJTAG_PSW".

Info: Checking netlist component footprint "PWR135:/55E2D9F9:GOGO_PWR_JACK_UNI_MILLING".

Info: Changing component path "PWR135:" to "/55E2D9F9".

Changing component "PWR135:/55E2D9F9" pin "+" net name from "N$3" to "/N$3".

Info: Checking netlist component footprint "Q1:/55E2DAC1:CRYSTAL_HC49_SMD2_THIN".

Info: Changing component path "Q1:" to "/55E2DAC1".

Changing component "Q1:/55E2DAC1" pin "1" net name from "XTALO" to "/XTALO".

Changing component "Q1:/55E2DAC1" pin "2" net name from "XTALI" to "/XTALI".

Info: Checking netlist component footprint "R1:/55E2DB89:OLIMEX_DISCRET_0603_0R".

Info: Changing component path "R1:" to "/55E2DB89".

Changing component "R1:/55E2DB89" pin "2" net name from "DCDC_VDDIO" to "/DCDC_VDDIO".

Info: Checking netlist component footprint "R2:/55E2DC51:RCL_R0603_5MIL_DWS".

Info: Changing component path "R2:" to "/55E2DC51".

Changing component "R2:/55E2DC51" pin "2" net name from "N$42" to "/N$42".

Info: Checking netlist component footprint "R3:/55E2DD19:RCL_R0603_5MIL_DWS".

Info: Changing component path "R3:" to "/55E2DD19".

Changing component "R3:/55E2DD19" pin "2" net name from "N$6" to "/N$6".

Info: Checking netlist component footprint "R4:/55E2DDE1:RCL_R0603_5MIL_DWS".

Info: Changing component path "R4:" to "/55E2DDE1".

Changing component "R4:/55E2DDE1" pin "2" net name from "PIN18/LCD_D17/USB_EN" to "/PIN18/LCD_D17/USB_EN".

Info: Checking netlist component footprint "R5:/55E2DEA9:RCL_R0603_5MIL_DWS".

Info: Changing component path "R5:" to "/55E2DEA9".

Changing component "R5:/55E2DEA9" pin "1" net name from "N$8" to "/N$9".

Info: Checking netlist component footprint "R6:/55E2DF71:OLIMEX_DISCRET_0603_0R".

Info: Changing component path "R6:" to "/55E2DF71".

Changing component "R6:/55E2DF71" pin "1" net name from "N$1" to "/N$1".

Changing component "R6:/55E2DF71" pin "2" net name from "VDDXTAL" to "/VDDXTAL".

Info: Checking netlist component footprint "R7:/55E2E039:RCL_R0603_5MIL_DWS".

Info: Changing component path "R7:" to "/55E2E039".

Changing component "R7:/55E2E039" pin "1" net name from "PSWITCH" to "/PSWITCH".

Changing component "R7:/55E2E039" pin "2" net name from "SJTAG_PSW" to "/SJTAG_PSW".

Info: Checking netlist component footprint "R8:/55E2E101:RCL_R0603_5MIL_DWS".

Info: Changing component path "R8:" to "/55E2E101".

Changing component "R8:/55E2E101" pin "1" net name from "N$38" to "/N$38".

Changing component "R8:/55E2E101" pin "2" net name from "SJTAG_PSW" to "/SJTAG_PSW".

Info: Checking netlist component footprint "R9:/55E2E1C9:RCL_R0603_5MIL_DWS".

Info: Changing component path "R9:" to "/55E2E1C9".

Changing component "R9:/55E2E1C9" pin "1" net name from "N$43" to "/N$43".

Changing component "R9:/55E2E1C9" pin "2" net name from "RESET" to "/RESET".

Info: Checking netlist component footprint "R10:/55E2E291:RCL_R0603_5MIL_DWS".

Info: Changing component path "R10:" to "/55E2E291".

Changing component "R10:/55E2E291" pin "1" net name from "N$43" to "/N$43".

Info: Checking netlist component footprint "R11:/55E2E359:RCL_R0603_5MIL_DWS".

Info: Changing component path "R11:" to "/55E2E359".

Changing component "R11:/55E2E359" pin "1" net name from "I2C_SCL" to "/I2C_SCL".

Info: Checking netlist component footprint "R12:/55E2E421:RCL_R0603_5MIL_DWS".

Info: Changing component path "R12:" to "/55E2E421".

Changing component "R12:/55E2E421" pin "1" net name from "I2C_SDA" to "/I2C_SDA".

Info: Checking netlist component footprint "R13:/55E2E4E9:RCL_R0603_5MIL_DWS".

Info: Changing component path "R13:" to "/55E2E4E9".

Changing component "R13:/55E2E4E9" pin "1" net name from "N$14" to "/CS_UEXT_GPIO".

Info: Checking netlist component footprint "R14:/55E2E5B1:RCL_R0603_5MIL_DWS".

Info: Changing component path "R14:" to "/55E2E5B1".

Changing component "R14:/55E2E5B1" pin "2" net name from "PIN6/LCD_D05" to "/PIN6/LCD_D05".

Info: Checking netlist component footprint "R15:/55E2E679:RCL_R0603_5MIL_DWS".

Info: Changing component path "R15:" to "/55E2E679".

Changing component "R15:/55E2E679" pin "2" net name from "PIN25/LCD_RS" to "/PIN25/LCD_RS".

Info: Checking netlist component footprint "R16:/55E2E741:RCL_R0603_5MIL_DWS".

Info: Changing component path "R16:" to "/55E2E741".

Changing component "R16:/55E2E741" pin "1" net name from "CS" to "/CS".

Info: Checking netlist component footprint "R17:/55E2E809:RCL_R0603_5MIL_DWS".

Info: Changing component path "R17:" to "/55E2E809".

Changing component "R17:/55E2E809" pin "1" net name from "CLKN" to "/CLKN".

Changing component "R17:/55E2E809" pin "2" net name from "CLK" to "/CLK".

Info: Checking netlist component footprint "R18:/55E2E8D1:RCL_R0603_5MIL_DWS".

Info: Changing component path "R18:" to "/55E2E8D1".

Changing component "R18:/55E2E8D1" pin "1" net name from "N$7" to "/N$7".

Info: Checking netlist component footprint "R19:/55E2E999:RCL_R0603_5MIL_DWS".

Info: Changing component path "R19:" to "/55E2E999".

Changing component "R19:/55E2E999" pin "2" net name from "N$7" to "/N$7".

Info: Checking netlist component footprint "R20:/55E2EA61:RCL_R0603_5MIL_DWS".

Info: Changing component path "R20:" to "/55E2EA61".

Changing component "R20:/55E2EA61" pin "1" net name from "SSP1_DATA3" to "/SSP1_DATA3".

Info: Checking netlist component footprint "R21:/55E2EB29:RCL_R0603_5MIL_DWS".

Info: Changing component path "R21:" to "/55E2EB29".

Changing component "R21:/55E2EB29" pin "1" net name from "SSP1_CMD" to "/SSP1_CMD".

Info: Checking netlist component footprint "R22:/55E2EBF1:RCL_R0603_5MIL_DWS".

Info: Changing component path "R22:" to "/55E2EBF1".

Changing component "R22:/55E2EBF1" pin "2" net name from "PWM0/DUART_RXD" to "/PWM0/DUART_RXD".

Info: Checking netlist component footprint "R25:/55E2ECB9:RCL_R0603_5MIL_DWS".

Info: Changing component path "R25:" to "/55E2ECB9".

Changing component "R25:/55E2ECB9" pin "2" net name from "N$9" to "/N$12".

Info: Checking netlist component footprint "R26:/55E2ED81:OLIMEX_DISCRET_0603_0R".

Info: Changing component path "R26:" to "/55E2ED81".

Changing component "R26:/55E2ED81" pin "1" net name from "VDAC1" to "/VDAC1".

Changing component "R26:/55E2ED81" pin "2" net name from "N$4" to "/N$4".

Info: Checking netlist component footprint "RECOVERY135:/55E2EE49:GOGO_SW-TAKT_6X3.5_SMD".

Info: Changing component path "RECOVERY135:" to "/55E2EE49".

Changing component "RECOVERY135:/55E2EE49" pin "P$1" net name from "N$8" to "/N$9".

Changing component "RECOVERY135:/55E2EE49" pin "P$2" net name from "SJTAG_PSW" to "/SJTAG_PSW".

Info: Checking netlist component footprint "RESET135:/55E2EF11:GOGO_SW-TAKT_6X3.5_SMD".

Info: Changing component path "RESET135:" to "/55E2EF11".

Changing component "RESET135:/55E2EF11" pin "P$1" net name from "RESET" to "/RESET".

Info: Checking netlist component footprint "RM1:/55E2EFD9:OLIMEX_DISCRET_R_MATRIX_4".

Info: Changing component path "RM1:" to "/55E2EFD9".

Changing component "RM1:/55E2EFD9" pin "1.2" net name from "SJTAG_PSW" to "/SJTAG_PSW".

Changing component "RM1:/55E2EFD9" pin "2.1" net name from "SSP1_DATA2" to "/SSP1_DATA2".

Changing component "RM1:/55E2EFD9" pin "4.1" net name from "SSP1_DATA0" to "/SSP1_DATA0".

Changing component "RM1:/55E2EFD9" pin "3.1" net name from "SSP1_DATA1" to "/SSP1_DATA1".

Info: Checking netlist component footprint "RM2:/55E2F1CD:OLIMEX_DISCRET_R_MATRIX_4".

Info: Changing component path "RM2:" to "/55E2F1CD".

Changing component "RM2:/55E2F1CD" pin "1.1" net name from "PIN1/LCD_D00" to "/PIN1/LCD_D00".

Changing component "RM2:/55E2F1CD" pin "2.1" net name from "PIN2/LCD_D01" to "/PIN2/LCD_D01".

Changing component "RM2:/55E2F1CD" pin "4.1" net name from "PIN4/LCD_D03" to "/PIN4/LCD_D03".

Changing component "RM2:/55E2F1CD" pin "3.1" net name from "PIN3/LCD_D02" to "/PIN3/LCD_D02".

Info: Checking netlist component footprint "RM3:/55E2F295:OLIMEX_DISCRET_R_MATRIX_4".

Info: Changing component path "RM3:" to "/55E2F295".

Changing component "RM3:/55E2F295" pin "1.1" net name from "N$105" to "/N$105".

Changing component "RM3:/55E2F295" pin "1.2" net name from "PIN1/LCD_D00" to "/PIN1/LCD_D00".

Changing component "RM3:/55E2F295" pin "2.1" net name from "N$104" to "/N$104".

Changing component "RM3:/55E2F295" pin "2.2" net name from "PIN2/LCD_D01" to "/PIN2/LCD_D01".

Changing component "RM3:/55E2F295" pin "4.2" net name from "PIN4/LCD_D03" to "/PIN4/LCD_D03".

Changing component "RM3:/55E2F295" pin "4.1" net name from "N$101" to "/N$101".

Changing component "RM3:/55E2F295" pin "3.2" net name from "PIN3/LCD_D02" to "/PIN3/LCD_D02".

Changing component "RM3:/55E2F295" pin "3.1" net name from "N$103" to "/N$103".

Info: Checking netlist component footprint "SCL_HW/SCL_SW135:/55E2F35D:JUMPER_SJ_2_SMALL".

Info: Changing component path "SCL_HW/SCL_SW135:" to "/55E2F35D".

Changing component "SCL_HW/SCL_SW135:/55E2F35D" pin "1" net name from "PIN22/LCD_EN/I2C_SCL" to "/PIN22/LCD_EN/I2C_SCL".

Changing component "SCL_HW/SCL_SW135:/55E2F35D" pin "2" net name from "I2C_SCL" to "/I2C_SCL".

Changing component "SCL_HW/SCL_SW135:/55E2F35D" pin "3" net name from "PIN29/SOFT_SCL" to "/PIN29/SOFT_SCL".

Info: Checking netlist component footprint "SD/MMC135:/55E2F425:OLIMEX_CONNECTORS_TFC-WPAPR-08".

Info: Changing component path "SD/MMC135:" to "/55E2F425".

Changing component "SD/MMC135:/55E2F425" pin "8" net name from "SSP1_DATA1" to "/SSP1_DATA1".

Changing component "SD/MMC135:/55E2F425" pin "7" net name from "SSP1_DATA0" to "/SSP1_DATA0".

Changing component "SD/MMC135:/55E2F425" pin "5" net name from "SSP1_SCK" to "/SSP1_SCK".

Changing component "SD/MMC135:/55E2F425" pin "4" net name from "SD_VCC" to "/SD_VCC".

Changing component "SD/MMC135:/55E2F425" pin "3" net name from "SSP1_CMD" to "/SSP1_CMD".

Changing component "SD/MMC135:/55E2F425" pin "2" net name from "SSP1_DATA3" to "/SSP1_DATA3".

Changing component "SD/MMC135:/55E2F425" pin "1" net name from "SSP1_DATA2" to "/SSP1_DATA2".

Changing component "SD/MMC135:/55E2F425" pin "10" net name from "" to "Net-(SD/MMC135-Pad10)".

Changing component "SD/MMC135:/55E2F425" pin "11" net name from "" to "Net-(SD/MMC135-Pad10)".

Changing component "SD/MMC135:/55E2F425" pin "12" net name from "" to "Net-(SD/MMC135-Pad10)".

Changing component "SD/MMC135:/55E2F425" pin "13" net name from "" to "Net-(SD/MMC135-Pad10)".

Changing component "SD/MMC135:/55E2F425" pin "9" net name from "" to "Net-(SD/MMC135-Pad9)".

Info: Checking netlist component footprint "SDA_HW/SDA_SW135:/55E2F4ED:JUMPER_SJ_2_SMALL".

Info: Changing component path "SDA_HW/SDA_SW135:" to "/55E2F4ED".

Changing component "SDA_HW/SDA_SW135:/55E2F4ED" pin "1" net name from "PIN21/LCD_HSYNC/I2C_SDA" to "/PIN21/LCD_HSYNC/I2C_SDA".

Changing component "SDA_HW/SDA_SW135:/55E2F4ED" pin "2" net name from "I2C_SDA" to "/I2C_SDA".

Changing component "SDA_HW/SDA_SW135:/55E2F4ED" pin "3" net name from "PIN28/SOFT_SDA" to "/PIN28/SOFT_SDA".

Info: Checking netlist component footprint "SJTAG135:/55E2F5B5:PENKO_HN1X4".

Info: Changing component path "SJTAG135:" to "/55E2F5B5".

Changing component "SJTAG135:/55E2F5B5" pin "3" net name from "SJTAG_PSW" to "/SJTAG_PSW".

Changing component "SJTAG135:/55E2F5B5" pin "4" net name from "DEBUG" to "/DEBUG".

Info: Checking netlist component footprint "T1:/55E2F67D:SEMICON-SMD-IPC_SOT23".

Info: Changing component path "T1:" to "/55E2F67D".

Changing component "T1:/55E2F67D" pin "3" net name from "XTALO" to "/XTALO".

Info: Checking netlist component footprint "T2:/55E2F745:SEMICON-SMD-IPC_SOT23".

Info: Changing component path "T2:" to "/55E2F745".

Changing component "T2:/55E2F745" pin "3" net name from "XTALI" to "/XTALI".

Changing component "T2:/55E2F745" pin "1" net name from "N$43" to "/N$43".

Info: Checking netlist component footprint "T3:/55E2F80D:OLIMEX_DISCRET_SOT-23".

Info: Changing component path "T3:" to "/55E2F80D".

Changing component "T3:/55E2F80D" pin "3" net name from "N$9" to "/N$12".

Changing component "T3:/55E2F80D" pin "2" net name from "N$3" to "/N$3".

Changing component "T3:/55E2F80D" pin "1" net name from "N$12" to "/N$14".

Info: Checking netlist component footprint "T4:/55E2F8D5:OLIMEX_DISCRET_SOT-23".

Info: Changing component path "T4:" to "/55E2F8D5".

Changing component "T4:/55E2F8D5" pin "3" net name from "N$12" to "/N$14".

Changing component "T4:/55E2F8D5" pin "1" net name from "RESET" to "/RESET".

Info: Checking netlist component footprint "U1:/55E2F99D:OLIMEX_IC_TQFP128LD".

Info: Changing component path "U1:" to "/55E2F99D".

Changing component "U1:/55E2F99D" pin "1" net name from "DCDC_VDDD" to "/DCDC_VDDD".

Changing component "U1:/55E2F99D" pin "2" net name from "PIN1/LCD_D00" to "/PIN1/LCD_D00".

Changing component "U1:/55E2F99D" pin "3" net name from "PIN2/LCD_D01" to "/PIN2/LCD_D01".

Changing component "U1:/55E2F99D" pin "4" net name from "PIN3/LCD_D02" to "/PIN3/LCD_D02".

Changing component "U1:/55E2F99D" pin "5" net name from "PIN4/LCD_D03" to "/PIN4/LCD_D03".

Changing component "U1:/55E2F99D" pin "6" net name from "PIN5/LCD_D04" to "/PIN5/LCD_D04".

Changing component "U1:/55E2F99D" pin "7" net name from "PIN6/LCD_D05" to "/PIN6/LCD_D05".

Changing component "U1:/55E2F99D" pin "8" net name from "PIN7/LCD_D06" to "/PIN7/LCD_D06".

Changing component "U1:/55E2F99D" pin "9" net name from "PIN8/LCD_D07" to "/PIN8/LCD_D07".

Changing component "U1:/55E2F99D" pin "10" net name from "PIN26/LCD_CS" to "/PIN26/LCD_CS".

Changing component "U1:/55E2F99D" pin "11" net name from "PIN22/LCD_EN/I2C_SCL" to "/PIN22/LCD_EN/I2C_SCL".

Changing component "U1:/55E2F99D" pin "12" net name from "PIN23/LCD_DISP" to "/PIN23/LCD_DISP".

Changing component "U1:/55E2F99D" pin "13" net name from "PIN24/LCD_WR" to "/PIN24/LCD_WR".

Changing component "U1:/55E2F99D" pin "14" net name from "PIN25/LCD_RS" to "/PIN25/LCD_RS".

Changing component "U1:/55E2F99D" pin "15" net name from "PIN21/LCD_HSYNC/I2C_SDA" to "/PIN21/LCD_HSYNC/I2C_SDA".

Changing component "U1:/55E2F99D" pin "16" net name from "PIN20/LCD_VSYNC" to "/PIN20/LCD_VSYNC".

Changing component "U1:/55E2F99D" pin "17" net name from "PIN19/LCD_DOTCLK" to "/PIN19/LCD_DOTCLK".

Changing component "U1:/55E2F99D" pin "19" net name from "PIN17/LCD_D16" to "/PIN17/LCD_D16".

Changing component "U1:/55E2F99D" pin "20" net name from "PIN18/LCD_D17/USB_EN" to "/PIN18/LCD_D17/USB_EN".

Changing component "U1:/55E2F99D" pin "21" net name from "SSP2_MOSI" to "/SSP2_MOSI".

Changing component "U1:/55E2F99D" pin "22" net name from "PIN9/LCD_D08/SSP2_MISO" to "/PIN9/LCD_D08/SSP2_MISO".

Changing component "U1:/55E2F99D" pin "23" net name from "PIN10/LCD_D09" to "/PIN10/LCD_D09".

Changing component "U1:/55E2F99D" pin "24" net name from "PIN11/LCD_D10" to "/PIN11/LCD_D10".

Changing component "U1:/55E2F99D" pin "25" net name from "PIN12/LCD_D11" to "/PIN12/LCD_D11".

Changing component "U1:/55E2F99D" pin "26" net name from "PIN14/LCD_D13" to "/PIN14/LCD_D13".

Changing component "U1:/55E2F99D" pin "27" net name from "PIN13/LCD_D12" to "/PIN13/LCD_D12".

Changing component "U1:/55E2F99D" pin "28" net name from "PIN16/LCD_D15" to "/PIN16/LCD_D15".

Changing component "U1:/55E2F99D" pin "29" net name from "PIN15/LCD_D14" to "/PIN15/LCD_D14".

Changing component "U1:/55E2F99D" pin "31" net name from "PIN28/SOFT_SDA" to "/PIN28/SOFT_SDA".

Changing component "U1:/55E2F99D" pin "32" net name from "CS_UEXT" to "/CS_UEXT".

Changing component "U1:/55E2F99D" pin "33" net name from "SSP2_SCK" to "/SSP2_SCK".

Changing component "U1:/55E2F99D" pin "34" net name from "PIN29/SOFT_SCL" to "/PIN29/SOFT_SCL".

Changing component "U1:/55E2F99D" pin "36" net name from "CLK" to "/CLK".

Changing component "U1:/55E2F99D" pin "37" net name from "CLKN" to "/CLKN".

Changing component "U1:/55E2F99D" pin "39" net name from "DQS0" to "/DQS0".

Changing component "U1:/55E2F99D" pin "40" net name from "DQS1" to "/DQS1".

Changing component "U1:/55E2F99D" pin "41" net name from "D0" to "/D0".

Changing component "U1:/55E2F99D" pin "42" net name from "D2" to "/D2".

Changing component "U1:/55E2F99D" pin "43" net name from "D1" to "/D1".

Changing component "U1:/55E2F99D" pin "44" net name from "D3" to "/D3".

Changing component "U1:/55E2F99D" pin "46" net name from "DQM0" to "/DQM0".

Changing component "U1:/55E2F99D" pin "47" net name from "D4" to "/D4".

Changing component "U1:/55E2F99D" pin "48" net name from "D5" to "/D5".

Changing component "U1:/55E2F99D" pin "49" net name from "D6" to "/D6".

Changing component "U1:/55E2F99D" pin "50" net name from "D7" to "/D7".

Changing component "U1:/55E2F99D" pin "51" net name from "D8" to "/D8".

Changing component "U1:/55E2F99D" pin "52" net name from "D9" to "/D9".

Changing component "U1:/55E2F99D" pin "54" net name from "D10" to "/D10".

Changing component "U1:/55E2F99D" pin "55" net name from "D11" to "/D11".

Changing component "U1:/55E2F99D" pin "56" net name from "DQM1" to "/DQM1".

Changing component "U1:/55E2F99D" pin "57" net name from "D12" to "/D12".

Changing component "U1:/55E2F99D" pin "58" net name from "D13" to "/D13".

Changing component "U1:/55E2F99D" pin "59" net name from "D15" to "/D15".

Changing component "U1:/55E2F99D" pin "60" net name from "D14" to "/D14".

Changing component "U1:/55E2F99D" pin "61" net name from "CASN" to "/CASN".

Changing component "U1:/55E2F99D" pin "62" net name from "RASN" to "/RASN".

Changing component "U1:/55E2F99D" pin "63" net name from "CS" to "/CS".

Changing component "U1:/55E2F99D" pin "64" net name from "A12" to "/A12".

Changing component "U1:/55E2F99D" pin "65" net name from "A11" to "/A11".

Changing component "U1:/55E2F99D" pin "66" net name from "A10" to "/A10".

Changing component "U1:/55E2F99D" pin "67" net name from "A9" to "/A9".

Changing component "U1:/55E2F99D" pin "68" net name from "A8" to "/A8".

Changing component "U1:/55E2F99D" pin "69" net name from "A7" to "/A7".

Changing component "U1:/55E2F99D" pin "70" net name from "A6" to "/A6".

Changing component "U1:/55E2F99D" pin "71" net name from "A5" to "/A5".

Changing component "U1:/55E2F99D" pin "72" net name from "A4" to "/A4".

Changing component "U1:/55E2F99D" pin "73" net name from "A3" to "/A3".

Changing component "U1:/55E2F99D" pin "74" net name from "A2" to "/A2".

Changing component "U1:/55E2F99D" pin "75" net name from "A1" to "/A1".

Changing component "U1:/55E2F99D" pin "76" net name from "A0" to "/A0".

Changing component "U1:/55E2F99D" pin "77" net name from "WEN" to "/WEN".

Changing component "U1:/55E2F99D" pin "78" net name from "CKE" to "/CKE".

Changing component "U1:/55E2F99D" pin "79" net name from "BA0" to "/BA0".

Changing component "U1:/55E2F99D" pin "80" net name from "BA1" to "/BA1".

Changing component "U1:/55E2F99D" pin "81" net name from "PIN30" to "/PIN30".

Changing component "U1:/55E2F99D" pin "82" net name from "PIN31" to "/PIN31".

Changing component "U1:/55E2F99D" pin "83" net name from "SSP1_CMD" to "/SSP1_CMD".

Changing component "U1:/55E2F99D" pin "84" net name from "SSP1_DATA0" to "/SSP1_DATA0".

Changing component "U1:/55E2F99D" pin "85" net name from "SSP1_DATA1" to "/SSP1_DATA1".

Changing component "U1:/55E2F99D" pin "86" net name from "SSP1_DATA2" to "/SSP1_DATA2".

Changing component "U1:/55E2F99D" pin "87" net name from "SSP1_DATA3" to "/SSP1_DATA3".

Changing component "U1:/55E2F99D" pin "88" net name from "LED1" to "/LED1".

Changing component "U1:/55E2F99D" pin "89" net name from "DEBUG" to "/DEBUG".

Changing component "U1:/55E2F99D" pin "90" net name from "SSP1_SCK" to "/SSP1_SCK".

Changing component "U1:/55E2F99D" pin "91" net name from "PIN27/PWM2" to "/PIN27/PWM2".

Changing component "U1:/55E2F99D" pin "93" net name from "DCDC_VDDD" to "/DCDC_VDDD".

Changing component "U1:/55E2F99D" pin "94" net name from "DCDC_VDDD" to "/DCDC_VDDD".

Changing component "U1:/55E2F99D" pin "95" net name from "DCDC_VDDIO" to "/DCDC_VDDIO".

Changing component "U1:/55E2F99D" pin "96" net name from "DCDC_VDDA" to "/DCDC_VDDA".

Changing component "U1:/55E2F99D" pin "97" net name from "N$18" to "/N$18".

Changing component "U1:/55E2F99D" pin "99" net name from "N$19" to "/N$19".

Changing component "U1:/55E2F99D" pin "101" net name from "VDD4P2" to "/VDD4P2".

Changing component "U1:/55E2F99D" pin "104" net name from "VDAC1" to "/VDAC1".

Changing component "U1:/55E2F99D" pin "107" net name from "PIN32/LRADC1" to "/PIN32/LRADC1".

Changing component "U1:/55E2F99D" pin "108" net name from "PIN33/LRADC0" to "/PIN33/LRADC0".

Changing component "U1:/55E2F99D" pin "109" net name from "HPR" to "/HPR".

Changing component "U1:/55E2F99D" pin "110" net name from "DCDC_VDDA" to "/DCDC_VDDA".

Changing component "U1:/55E2F99D" pin "111" net name from "HP_VGND" to "/HP_VGND".

Changing component "U1:/55E2F99D" pin "113" net name from "HPL" to "/HPL".

Changing component "U1:/55E2F99D" pin "114" net name from "LIN1_INR" to "/LIN1_INR".

Changing component "U1:/55E2F99D" pin "115" net name from "LIN1_INL" to "/LIN1_INL".

Changing component "U1:/55E2F99D" pin "116" net name from "PIN34/MIC" to "/PIN34/MIC".

Changing component "U1:/55E2F99D" pin "117" net name from "N$25" to "/N$25".

Changing component "U1:/55E2F99D" pin "119" net name from "PSWITCH" to "/PSWITCH".

Changing component "U1:/55E2F99D" pin "120" net name from "VDDXTAL" to "/VDDXTAL".

Changing component "U1:/55E2F99D" pin "121" net name from "XTALO" to "/XTALO".

Changing component "U1:/55E2F99D" pin "122" net name from "XTALI" to "/XTALI".

Changing component "U1:/55E2F99D" pin "123" net name from "USB_DM" to "/USB_DM".

Changing component "U1:/55E2F99D" pin "124" net name from "USB_DP" to "/USB_DP".

Changing component "U1:/55E2F99D" pin "125" net name from "PWM0/DUART_RXD" to "/PWM0/DUART_RXD".

Changing component "U1:/55E2F99D" pin "126" net name from "PWM1/DUART_TXD" to "/PWM1/DUART_TXD".

Changing component "U1:/55E2F99D" pin "127" net name from "AUART1_TXD" to "/AUART1_TXD".

Changing component "U1:/55E2F99D" pin "128" net name from "AUART1_RXD" to "/AUART1_RXD".

Info: Checking netlist component footprint "U2:/55E2FA65:OLIMEX_IC_66TSOP-II".

Info: Changing component path "U2:" to "/55E2FA65".

Changing component "U2:/55E2FA65" pin "2" net name from "D0" to "/D0".

Changing component "U2:/55E2FA65" pin "4" net name from "D1" to "/D1".

Changing component "U2:/55E2FA65" pin "5" net name from "D2" to "/D2".

Changing component "U2:/55E2FA65" pin "7" net name from "D3" to "/D3".

Changing component "U2:/55E2FA65" pin "8" net name from "D4" to "/D4".

Changing component "U2:/55E2FA65" pin "10" net name from "D5" to "/D5".

Changing component "U2:/55E2FA65" pin "11" net name from "D6" to "/D6".

Changing component "U2:/55E2FA65" pin "13" net name from "D7" to "/D7".

Changing component "U2:/55E2FA65" pin "14" net name from "" to "Net-(U2-Pad14)".

Changing component "U2:/55E2FA65" pin "16" net name from "DQS0" to "/DQS0".

Changing component "U2:/55E2FA65" pin "17" net name from "" to "Net-(U2-Pad17)".

Changing component "U2:/55E2FA65" pin "19" net name from "" to "Net-(U2-Pad19)".

Changing component "U2:/55E2FA65" pin "20" net name from "DQM0" to "/DQM0".

Changing component "U2:/55E2FA65" pin "21" net name from "WEN" to "/WEN".

Changing component "U2:/55E2FA65" pin "22" net name from "CASN" to "/CASN".

Changing component "U2:/55E2FA65" pin "23" net name from "RASN" to "/RASN".

Changing component "U2:/55E2FA65" pin "24" net name from "CS" to "/CS".

Changing component "U2:/55E2FA65" pin "25" net name from "" to "Net-(U2-Pad25)".

Changing component "U2:/55E2FA65" pin "26" net name from "BA0" to "/BA0".

Changing component "U2:/55E2FA65" pin "27" net name from "BA1" to "/BA1".

Changing component "U2:/55E2FA65" pin "28" net name from "A10" to "/A10".

Changing component "U2:/55E2FA65" pin "29" net name from "A0" to "/A0".

Changing component "U2:/55E2FA65" pin "30" net name from "A1" to "/A1".

Changing component "U2:/55E2FA65" pin "31" net name from "A2" to "/A2".

Changing component "U2:/55E2FA65" pin "32" net name from "A3" to "/A3".

Changing component "U2:/55E2FA65" pin "35" net name from "A4" to "/A4".

Changing component "U2:/55E2FA65" pin "36" net name from "A5" to "/A5".

Changing component "U2:/55E2FA65" pin "37" net name from "A6" to "/A6".

Changing component "U2:/55E2FA65" pin "38" net name from "A7" to "/A7".

Changing component "U2:/55E2FA65" pin "39" net name from "A8" to "/A8".

Changing component "U2:/55E2FA65" pin "40" net name from "A9" to "/A9".

Changing component "U2:/55E2FA65" pin "41" net name from "A11" to "/A11".

Changing component "U2:/55E2FA65" pin "42" net name from "A12" to "/A12".

Changing component "U2:/55E2FA65" pin "43" net name from "" to "Net-(U2-Pad43)".

Changing component "U2:/55E2FA65" pin "44" net name from "CKE" to "/CKE".

Changing component "U2:/55E2FA65" pin "45" net name from "CLK" to "/CLK".

Changing component "U2:/55E2FA65" pin "46" net name from "CLKN" to "/CLKN".

Changing component "U2:/55E2FA65" pin "47" net name from "DQM1" to "/DQM1".

Changing component "U2:/55E2FA65" pin "49" net name from "N$7" to "/N$7".

Changing component "U2:/55E2FA65" pin "50" net name from "" to "Net-(U2-Pad50)".

Changing component "U2:/55E2FA65" pin "51" net name from "DQS1" to "/DQS1".

Changing component "U2:/55E2FA65" pin "53" net name from "" to "Net-(U2-Pad53)".

Changing component "U2:/55E2FA65" pin "54" net name from "D8" to "/D8".

Changing component "U2:/55E2FA65" pin "56" net name from "D9" to "/D9".

Changing component "U2:/55E2FA65" pin "57" net name from "D10" to "/D10".

Changing component "U2:/55E2FA65" pin "59" net name from "D11" to "/D11".

Changing component "U2:/55E2FA65" pin "60" net name from "D12" to "/D12".

Changing component "U2:/55E2FA65" pin "62" net name from "D13" to "/D13".

Changing component "U2:/55E2FA65" pin "63" net name from "D14" to "/D14".

Changing component "U2:/55E2FA65" pin "65" net name from "D15" to "/D15".

Info: Checking netlist component footprint "U3:/55E2FB2D:OLIMEX_IC_SOT23-5".

Info: Changing component path "U3:" to "/55E2FB2D".

Changing component "U3:/55E2FB2D" pin "1" net name from "N$5" to "/N$5".

Changing component "U3:/55E2FB2D" pin "3" net name from "N$6" to "/N$6".

Changing component "U3:/55E2FB2D" pin "4" net name from "PIN18/LCD_D17/USB_EN" to "/PIN18/LCD_D17/USB_EN".

Info: Checking netlist component footprint "USB_HOST135:/55E2FBF5:OLIMEX_CONNECTORS_USB_PN87520_HOST_PTH".

Info: Changing component path "USB_HOST135:" to "/55E2FBF5".

Changing component "USB_HOST135:/55E2FBF5" pin "3" net name from "USB_DP" to "/USB_DP".

Changing component "USB_HOST135:/55E2FBF5" pin "2" net name from "USB_DM" to "/USB_DM".

Changing component "USB_HOST135:/55E2FBF5" pin "1" net name from "+5V_HOST_PWR" to "/+5V_HOST_PWR".

Changing component "USB_HOST135:/55E2FBF5" pin "P$1" net name from "N$266" to "/N$266".

Changing component "USB_HOST135:/55E2FBF5" pin "P$2" net name from "N$266" to "/N$266".

Info: Checking netlist component footprint "U_DEBUG135:/55E2FCBD:PENKO_HN1X4".

Info: Changing component path "U_DEBUG135:" to "/55E2FCBD".

Changing component "U_DEBUG135:/55E2FCBD" pin "1" net name from "CS_UEXT_GPIO" to "/N$11".

Changing component "U_DEBUG135:/55E2FCBD" pin "2" net name from "PWM1/DUART_TXD" to "/PWM1/DUART_TXD".

Changing component "U_DEBUG135:/55E2FCBD" pin "4" net name from "DEBUG" to "/DEBUG".

Info: Checking netlist component footprint "VR1:/55E30361:OLIMEX_DISCRET_SOT-23-5".

Info: Changing component path "VR1:" to "/55E30361".

Remove single pad net "Net-(D4-Pad1)" on "D4" pad '1'

Remove single pad net "Net-(SD/MMC135-Pad9)" on "SD/MMC135" pad '9'

Remove single pad net "Net-(U2-Pad14)" on "U2" pad '14'

Remove single pad net "Net-(U2-Pad17)" on "U2" pad '17'

Remove single pad net "Net-(U2-Pad19)" on "U2" pad '19'

Remove single pad net "Net-(U2-Pad25)" on "U2" pad '25'

Remove single pad net "Net-(U2-Pad43)" on "U2" pad '43'

Remove single pad net "Net-(U2-Pad50)" on "U2" pad '50'

Remove single pad net "Net-(U2-Pad53)" on "U2" pad '53'

Warning: Copper zone (net name ''): net has no pads connected.
