Jonathon-Reilly/Kicad/kicad-resources/kicad-tools/Freerouting/mit KiCad 4.0.3-stable.PNG

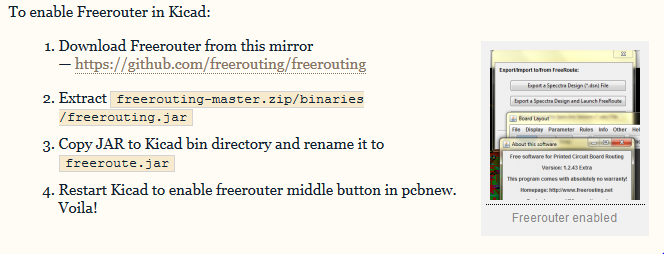
kicad-resources/kicad-tools/Freerouting/mit KiCad 4.0.3-stable.PNG
