Jonathon-Reilly/Kicad/kicad-resources/3D-cad-librarys/lumberg_2_5_MSF_03.stl

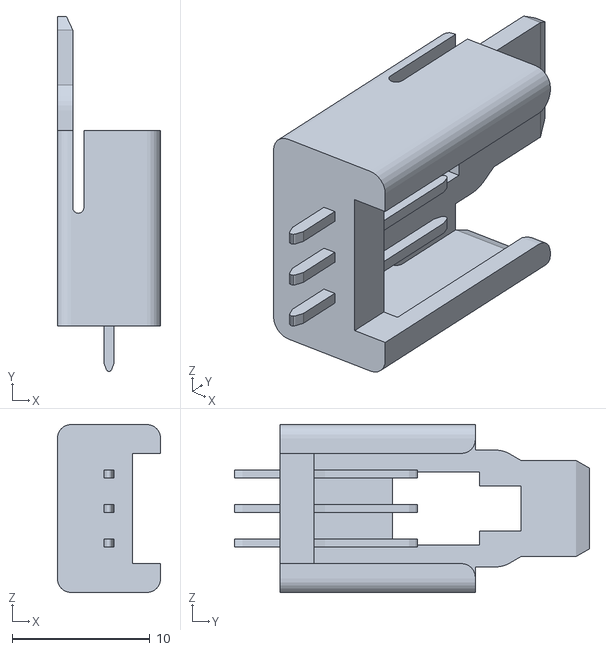
[picture p6: CAD file, 2017-08-08]
kicad-resources/3D-cad-librarys/lumberg_2_5_MSF_03.stl
7.50 x 25.8 x 12.2
