Jonathon-Reilly/Kicad/kicad-resources/kicad-librarys/o_shovah-3D/con-lumberg/lumberg_2_5_msfw_o_11.stp

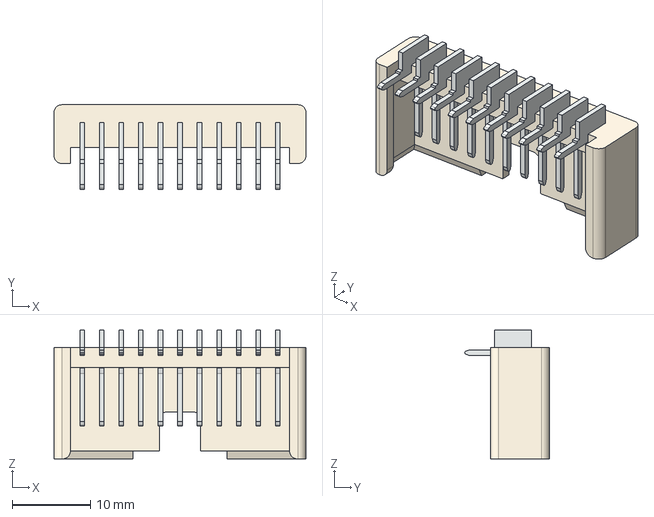
[picture p7: CAD file, 2017-08-08]
kicad-resources/kicad-librarys/o_shovah-3D/con-lumberg/lumberg_2_5_msfw_o_11.stp
32.2 x 10.8 x 16.4 mm
