Jonathon-Reilly/Kicad/kicad-resources/kicad-librarys/o_shovah-3D/connectors-[JS]/shfw10r_2stlf.stp

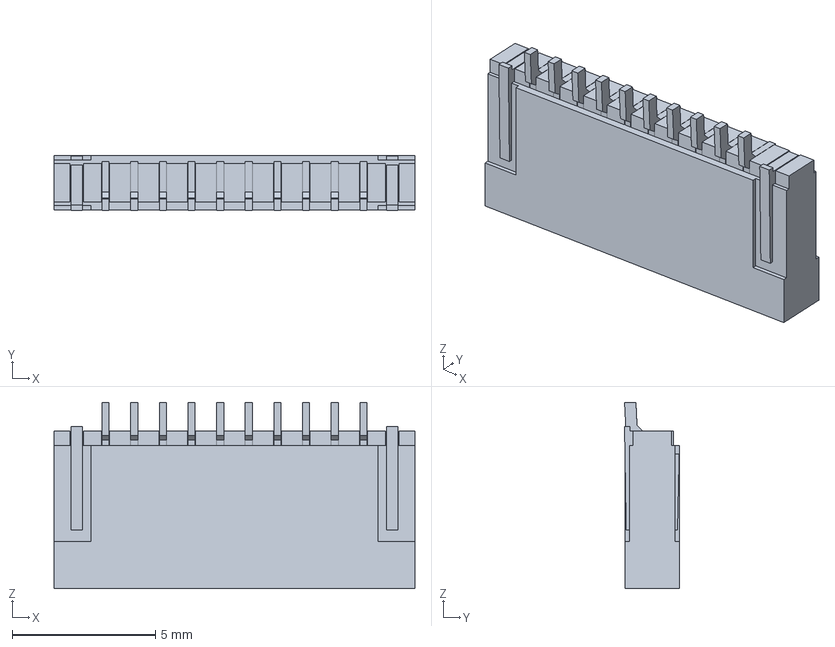
[picture p8: CAD file, 2018-03-31]
kicad-resources/kicad-librarys/o_shovah-3D/connectors-[JS]/shfw10r_2stlf.stp
12.6 x 1.92 x 6.50 mm
