Jonathon-Reilly/Kicad/kicad-resources/kicad-librarys/o_shovah-3D/crystals-[JS]/ceramic-resonator-smd-3mm2x1mm3-muratea-cstce.stp

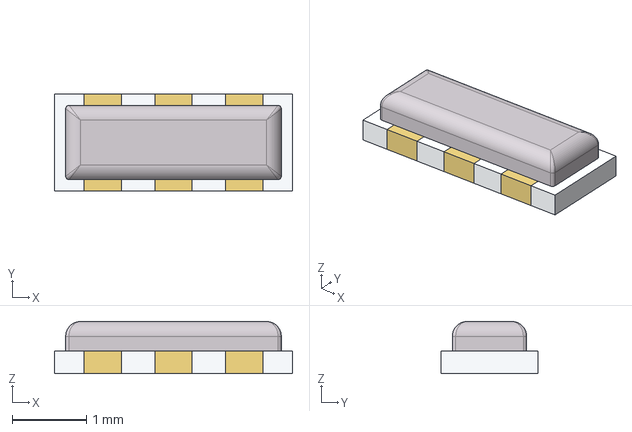
[picture p9: CAD file, 2017-08-08]
kicad-resources/kicad-librarys/o_shovah-3D/crystals-[JS]/ceramic-resonator-smd-3mm2x1mm3-muratea-cstce.stp
3.20 x 1.30 x 0.7 mm
