Jonathon-Reilly/Kicad/kicad-resources/kicad-librarys/o_shovah-3D/devices_[JS]/D2F_01FL.step

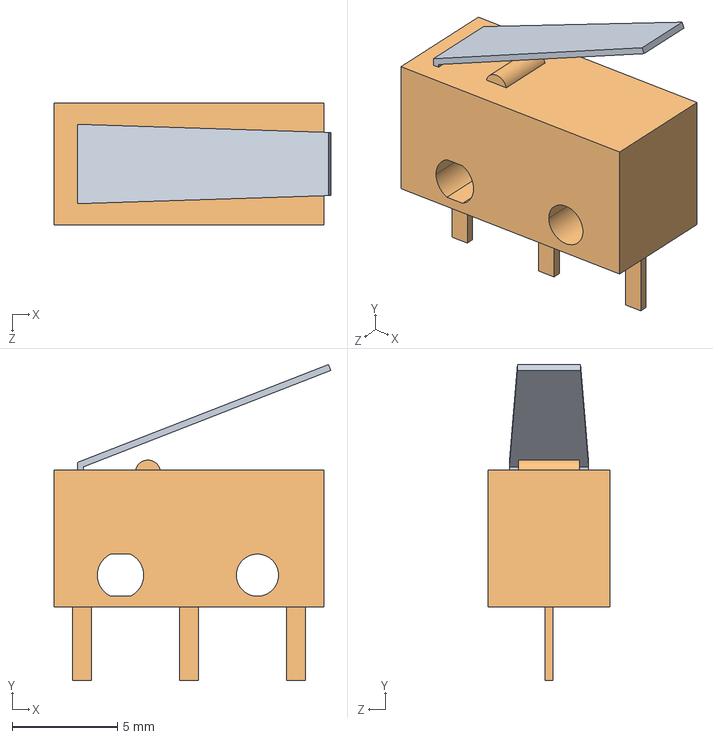
[picture p10: CAD file, 2018-03-31]
kicad-resources/kicad-librarys/o_shovah-3D/devices_[JS]/D2F_01FL.step
13.1 x 15.0 x 5.80 mm
D2F_01FL_ACTUATOR
D2F_01FL_BASE
