Jonathon-Reilly/Kicad/kicad-resources/kicad-librarys/o_shovah-3D/Ideale_Diode-[JS]/Ideale_Diode_25V_rev-00.stp

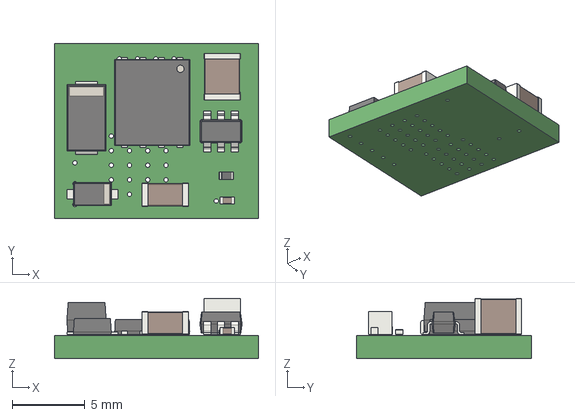
[picture p11: CAD file, 2018-03-31]
kicad-resources/kicad-librarys/o_shovah-3D/Ideale_Diode-[JS]/Ideale_Diode_25V_rev-00.stp
14.0 x 12.0 x 4.15 mm
