Jonathon-Reilly/Kicad/kicad-resources/kicad-librarys/o_shovah-3D/inductors_[JS]/1265.fcstd

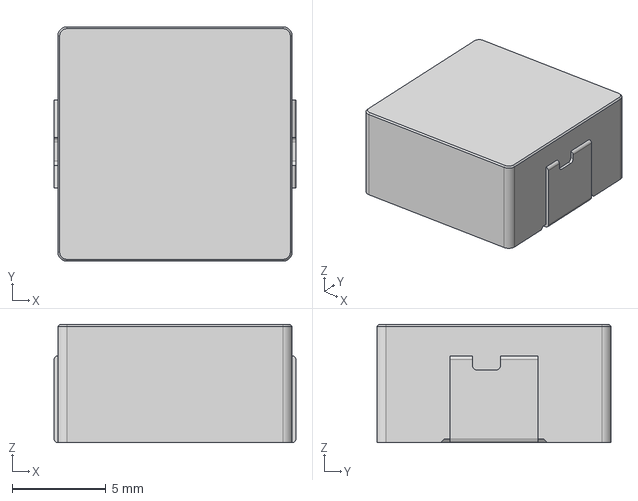
[picture p12: CAD file, 2017-08-08]
kicad-resources/kicad-librarys/o_shovah-3D/inductors_[JS]/1265.fcstd
12.9 x 12.5 x 6.30 mm
