Jonathon-Reilly/Kicad/kicad-resources/kicad-librarys/o_shovah-3D/JST-GH-[MS]/BM08B-GHS-TBT.STEP

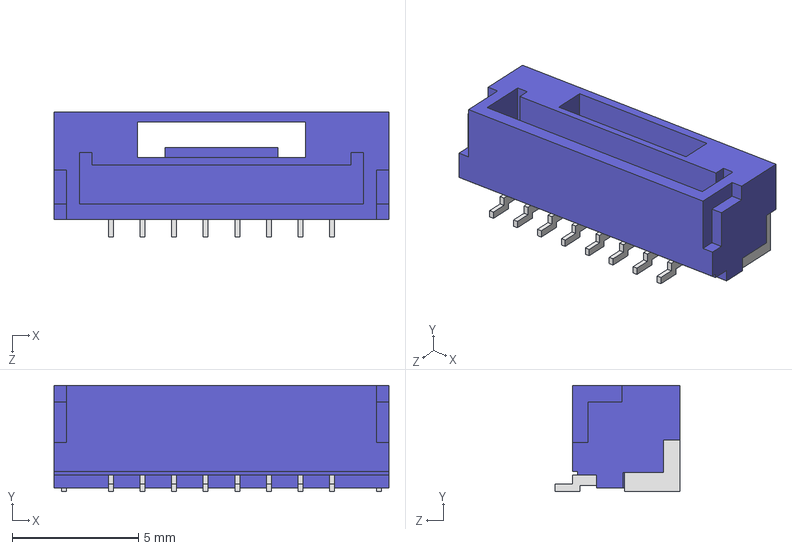
[picture p13: CAD file, 2017-10-23]
kicad-resources/kicad-librarys/o_shovah-3D/JST-GH-[MS]/BM08B-GHS-TBT.STEP
13.2 x 4.20 x 4.95 mm
