Jonathon-Reilly/Kicad/kicad-resources/kicad-librarys/o_shovah-3D/JST-PA-[JS]/B04B-PASK.STEP

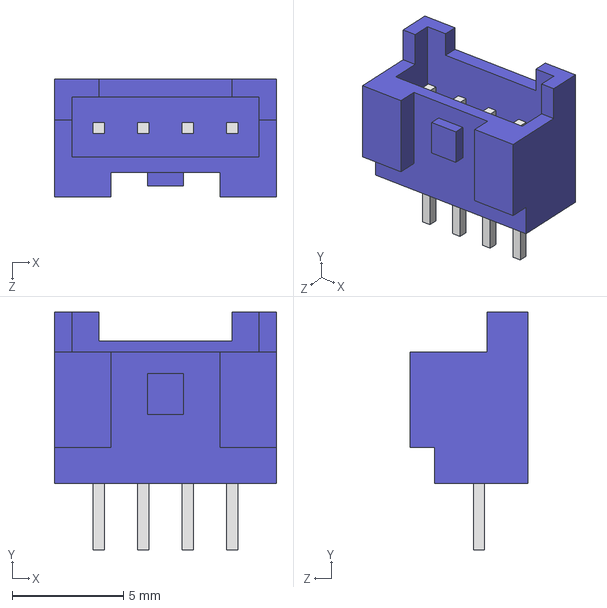
[picture p14: CAD file, 2018-03-06]
kicad-resources/kicad-librarys/o_shovah-3D/JST-PA-[JS]/B04B-PASK.STEP
10.0 x 10.7 x 5.30 mm
