Jonathon-Reilly/Kicad/kicad-resources/kicad-librarys/o_shovah-3D/Power-IC_[JS]/User Library-tsr-1.STEP

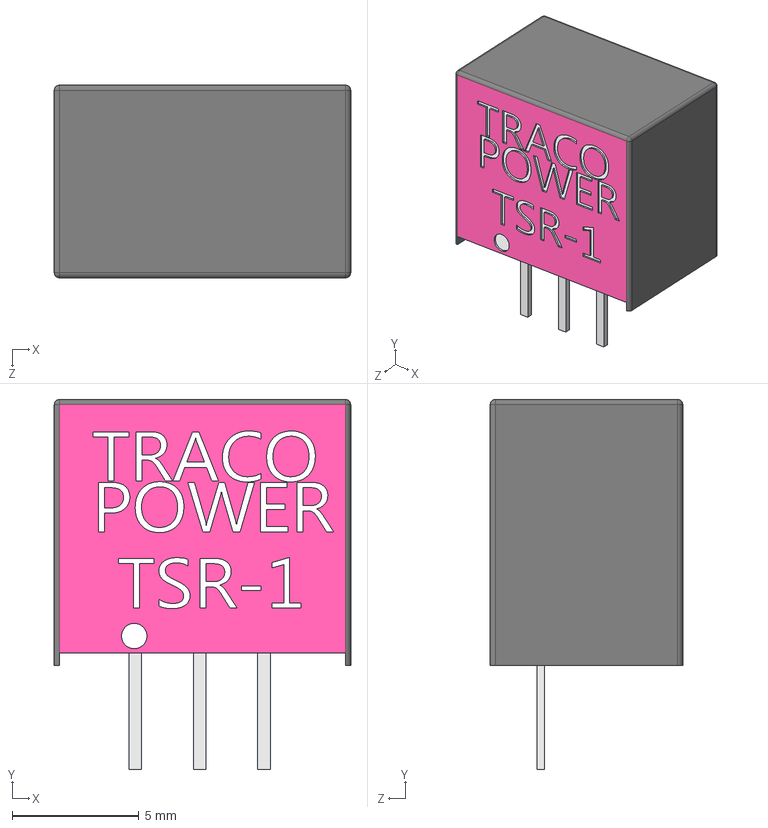
[picture p16: CAD file, 2018-03-31]
kicad-resources/kicad-librarys/o_shovah-3D/Power-IC_[JS]/User Library-tsr-1.STEP
11.7 x 14.6 x 7.60 mm
