Jonathon-Reilly/Kicad/kicad-resources/kicad-librarys/o_shovah-3D/PowerPole_[JS]/Powerpole 4P.stp

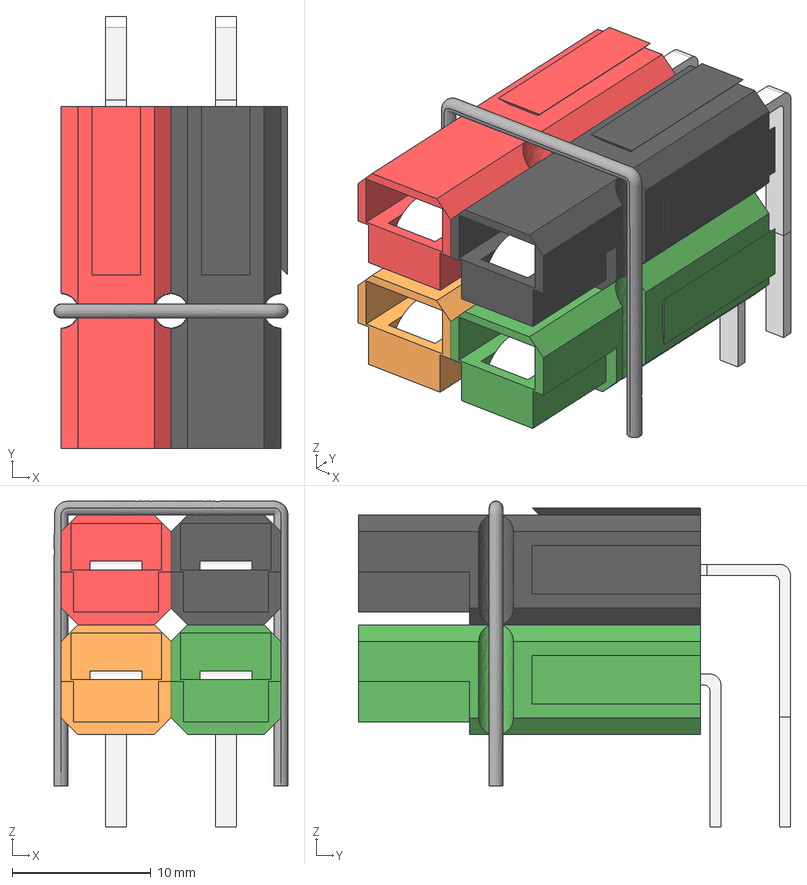
[picture p17: CAD file, 2018-03-31]
kicad-resources/kicad-librarys/o_shovah-3D/PowerPole_[JS]/Powerpole 4P.stp
16.8 x 31.1 x 23.5 mm
