Jonathon-Reilly/Kicad/kicad-resources/kicad-librarys/o_shovah-3D/UAV-Modules-[JS]/XT60 Stecker.stp

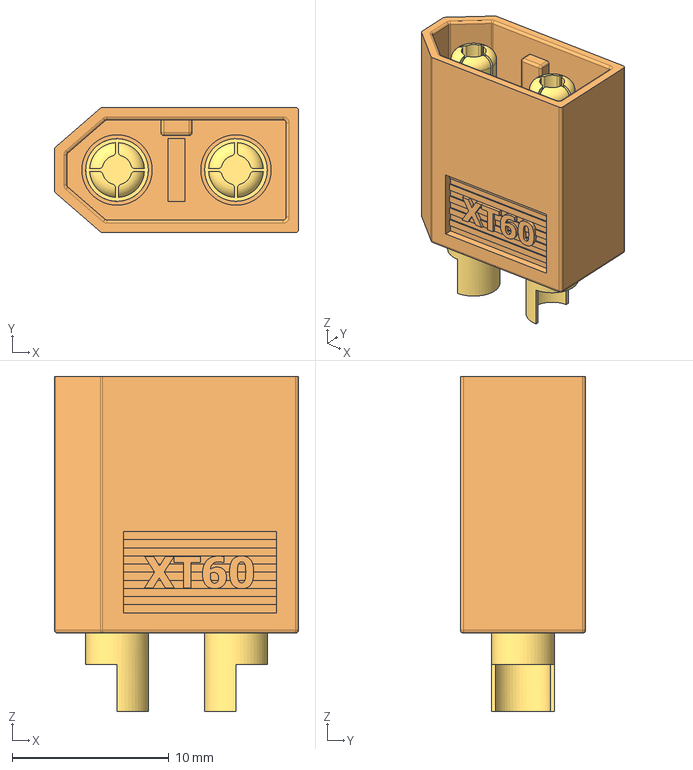
[picture p18: CAD file, 2017-10-13]
kicad-resources/kicad-librarys/o_shovah-3D/UAV-Modules-[JS]/XT60 Stecker.stp
15.6 x 8.00 x 21.4 mm
