Jonathon-Reilly/Kicad/kicad-resources/kicad-librarys/o_shovah-atomic-parts/pixhawk_2-cube/Pixhawk_2-Cube.stp

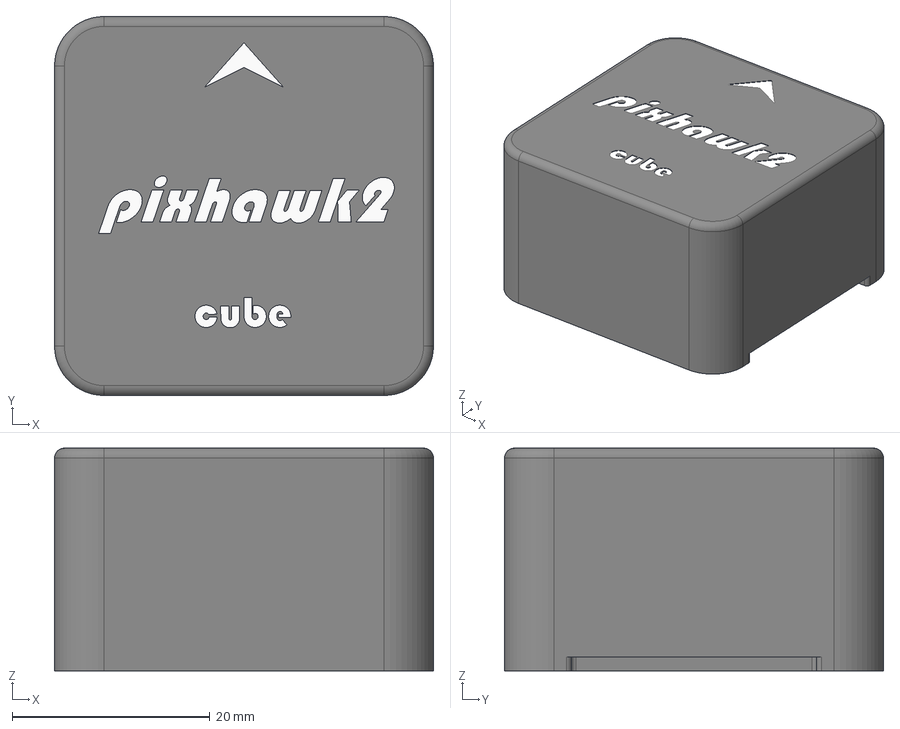
[picture p19: CAD file, 2018-03-31]
kicad-resources/kicad-librarys/o_shovah-atomic-parts/pixhawk_2-cube/Pixhawk_2-Cube.stp
38.3 x 38.3 x 22.5 mm
