Jonathon-Reilly/Kicad/kicad-resources/kicad-librarys/thirdparty-3D/web/3D-shapes/Conn_HRSE-SH12-xP-0.5-BOT/Conn_HRSE-SH12-15P-0.5-BOT.stp

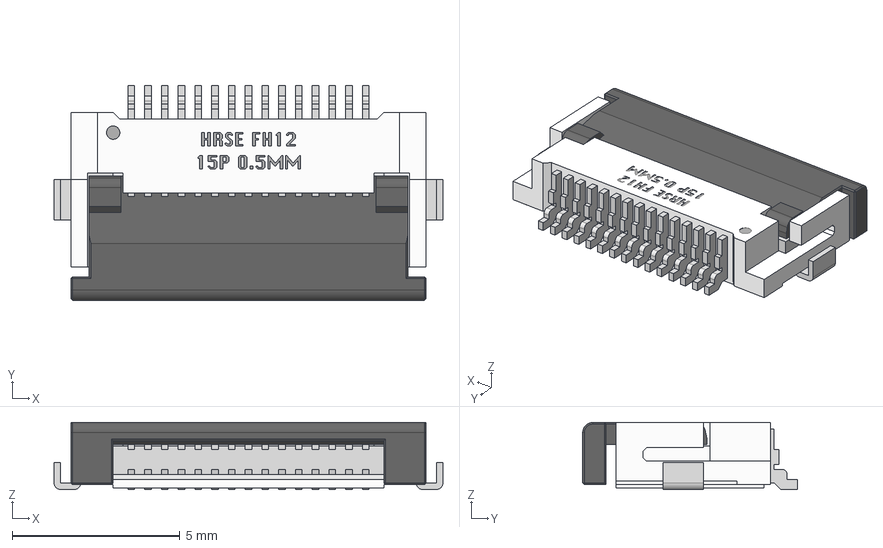
[picture p20: CAD file, 2018-03-31]
kicad-resources/kicad-librarys/thirdparty-3D/web/3D-shapes/Conn_HRSE-SH12-xP-0.5-BOT/Conn_HRSE-SH12-15P-0.5-BOT.stp
11.6 x 6.40 x 2.00 mm
