Jonathon-Reilly/Kicad/kicad-resources/kicad-librarys/thirdparty-3D/web/3D-shapes/Conn_JST-PH-xP-2.0-TOPandSIDE/Conn_PH-2.0_13P_TOP.stp

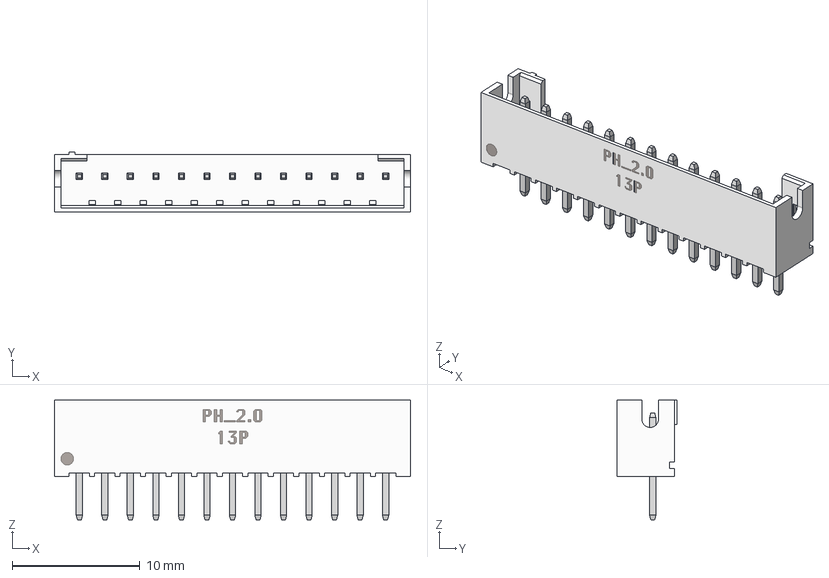
[picture p21: CAD file, 2018-03-31]
kicad-resources/kicad-librarys/thirdparty-3D/web/3D-shapes/Conn_JST-PH-xP-2.0-TOPandSIDE/Conn_PH-2.0_13P_TOP.stp
27.9 x 4.70 x 9.40 mm
