Jonathon-Reilly/Kicad/kicad-resources/kicad-librarys/thirdparty-3D/web/3D-shapes/Conn_others/Conn_USB-A-2.0_socket_right-angle.stp

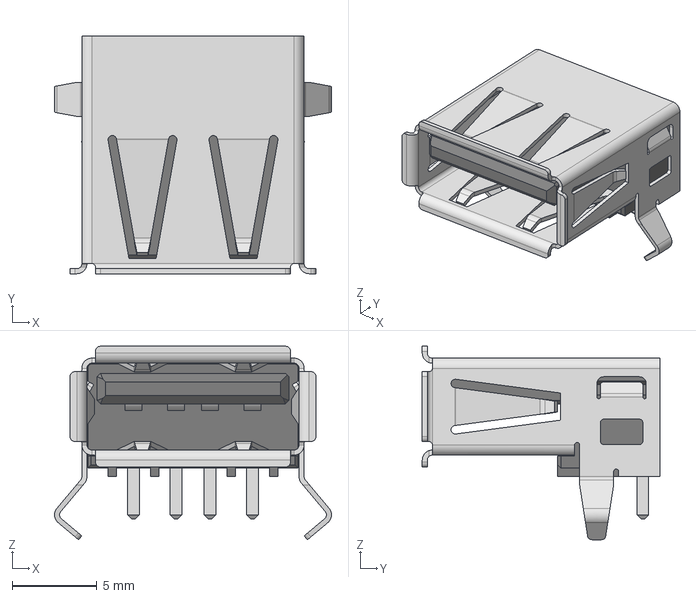
[picture p23: CAD file, 2018-03-31]
kicad-resources/kicad-librarys/thirdparty-3D/web/3D-shapes/Conn_others/Conn_USB-A-2.0_socket_right-angle.stp
16.3 x 14.0 x 11.4 mm
