Jonathon-Reilly/Kicad/kicad-resources/kicad-librarys/thirdparty-3D/web/3D-shapes/Conn_Universal-3.81-xP-TOPandSIDE/Conn_Universal-3.81-4P-SIDE.stp

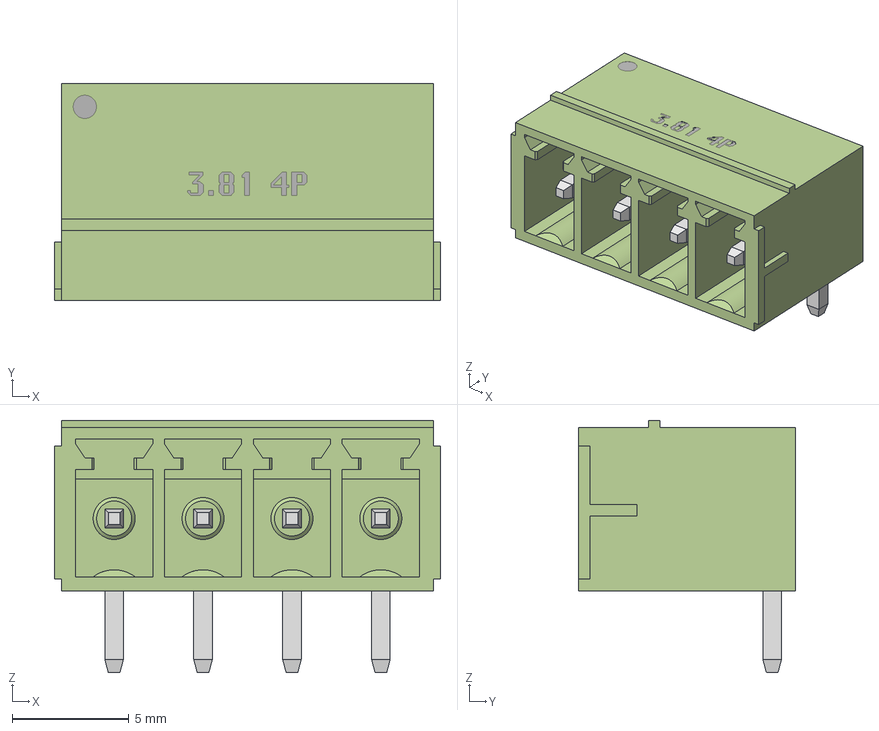
[picture p24: CAD file, 2018-03-31]
kicad-resources/kicad-librarys/thirdparty-3D/web/3D-shapes/Conn_Universal-3.81-xP-TOPandSIDE/Conn_Universal-3.81-4P-SIDE.stp
16.5 x 9.30 x 10.8 mm
