Jonathon-Reilly/Kicad/kicad-resources/kicad-librarys/thirdparty-3D/web/3D-shapes/Conn_Universal-5.08-xP-TOPandSIDE/Conn_Universal-5.08-6P-SIDE.stp

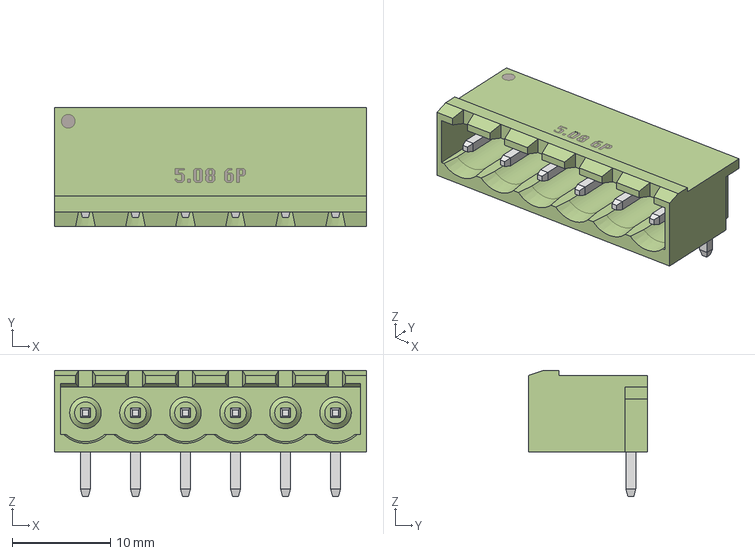
[picture p25: CAD file, 2018-03-31]
kicad-resources/kicad-librarys/thirdparty-3D/web/3D-shapes/Conn_Universal-5.08-xP-TOPandSIDE/Conn_Universal-5.08-6P-SIDE.stp
31.7 x 12.1 x 12.8 mm
