Jonathon-Reilly/Kicad/kicad-resources/kicad-librarys/thirdparty-3D/web/3D-shapes/Displays/Display_TJCTM24028-SPI.stp

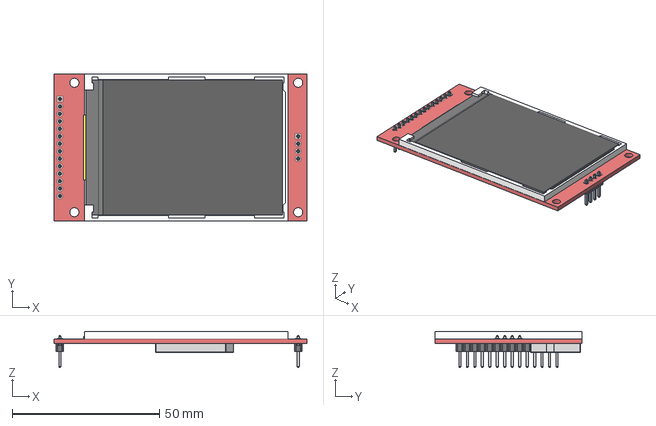
[picture p26: CAD file, 2018-03-31]
kicad-resources/kicad-librarys/thirdparty-3D/web/3D-shapes/Displays/Display_TJCTM24028-SPI.stp
86.0 x 50.0 x 12.3 mm
