Jonathon-Reilly/Kicad/kicad-resources/kicad-librarys/thirdparty-3D/web/3D-shapes/Modules/Module_LGA_2.5x2.5_Bosch-BME280.stp

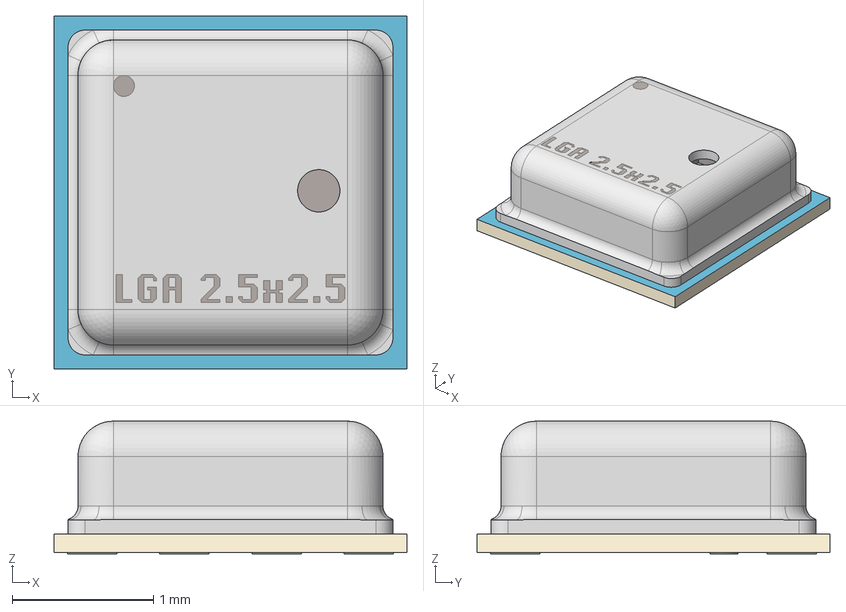
[picture p27: CAD file, 2018-03-31]
kicad-resources/kicad-librarys/thirdparty-3D/web/3D-shapes/Modules/Module_LGA_2.5x2.5_Bosch-BME280.stp
2.50 x 2.50 x 0.94 mm
