Jonathon-Reilly/Kicad/kicad-resources/kicad-librarys/thirdparty-3D/web/3D-shapes/SMD_DCDC-converters/RECOM_ROF-78Exx-0.5.stp

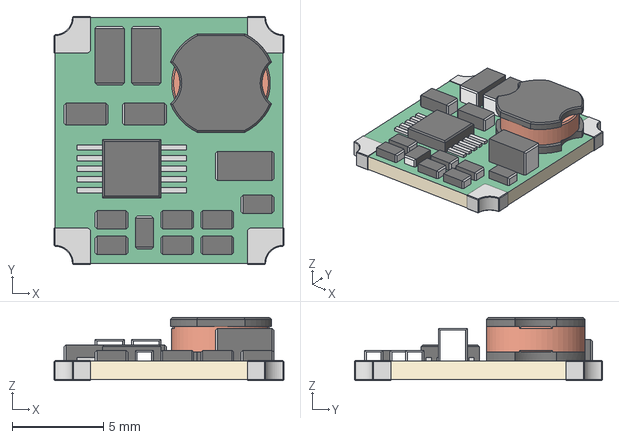
[picture p28: CAD file, 2018-03-31]
kicad-resources/kicad-librarys/thirdparty-3D/web/3D-shapes/SMD_DCDC-converters/RECOM_ROF-78Exx-0.5.stp
12.6 x 13.6 x 3.46 mm
