Jonathon-Reilly/Kicad/kicad-resources/kicad-librarys/thirdparty-3D/web/3D-shapes/SMD_Devices/Crystal_11.4x4.7x3.3.stp

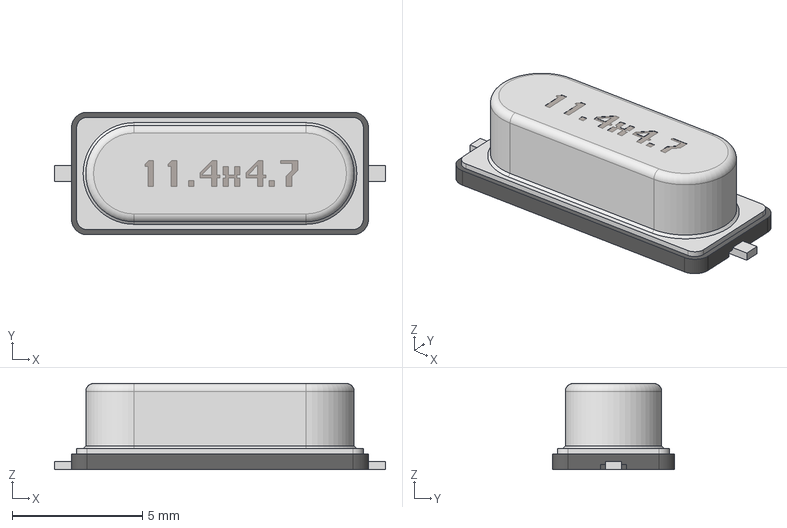
[picture p29: CAD file, 2018-03-31]
kicad-resources/kicad-librarys/thirdparty-3D/web/3D-shapes/SMD_Devices/Crystal_11.4x4.7x3.3.stp
12.7 x 4.70 x 3.30 mm
