Jonathon-Reilly/Kicad/kicad-resources/kicad-librarys/thirdparty-3D/web/3D-shapes/SMD_LEDs/PLCC-2.stp

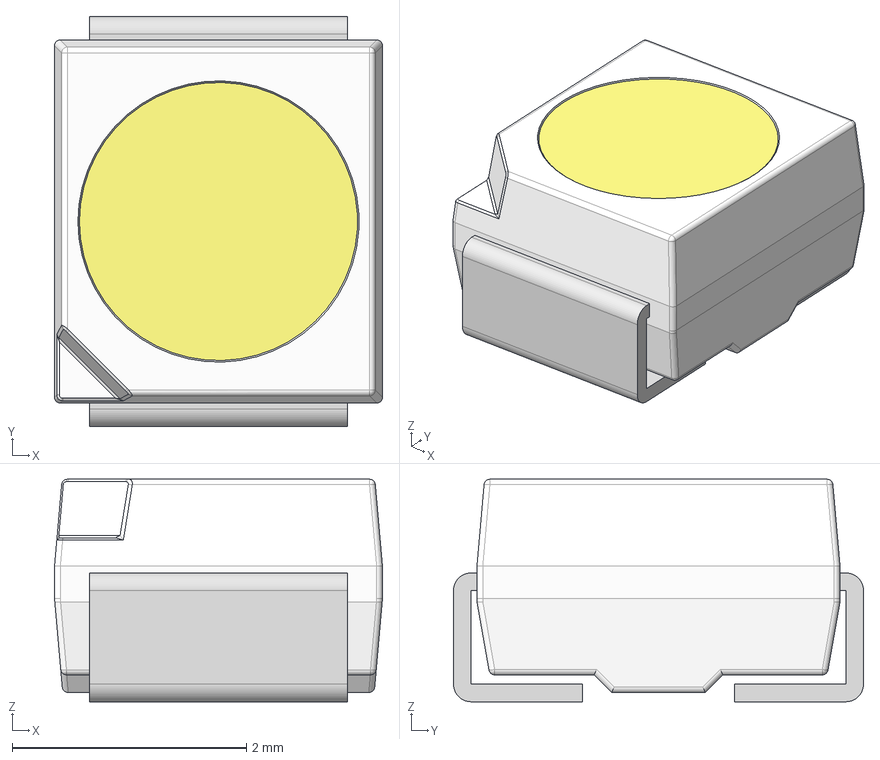
[picture p30: CAD file, 2018-03-31]
kicad-resources/kicad-librarys/thirdparty-3D/web/3D-shapes/SMD_LEDs/PLCC-2.stp
2.80 x 3.50 x 1.90 mm
