Jonathon-Reilly/Kicad/kicad-resources/kicad-librarys/thirdparty-3D/web/3D-shapes/SMD_SMDx_others/SO8-PowerPAK_wLABEL.stp

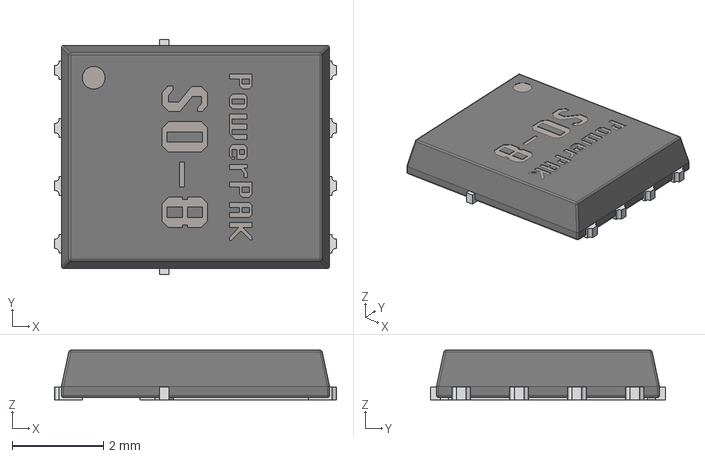
[picture p31: CAD file, 2018-03-31]
kicad-resources/kicad-librarys/thirdparty-3D/web/3D-shapes/SMD_SMDx_others/SO8-PowerPAK_wLABEL.stp
6.19 x 5.15 x 1.09 mm
