Jonathon-Reilly/Kicad/kicad-resources/kicad-librarys/thirdparty-3D/web/3D-shapes/SMD_SMx-series/SMC.stp

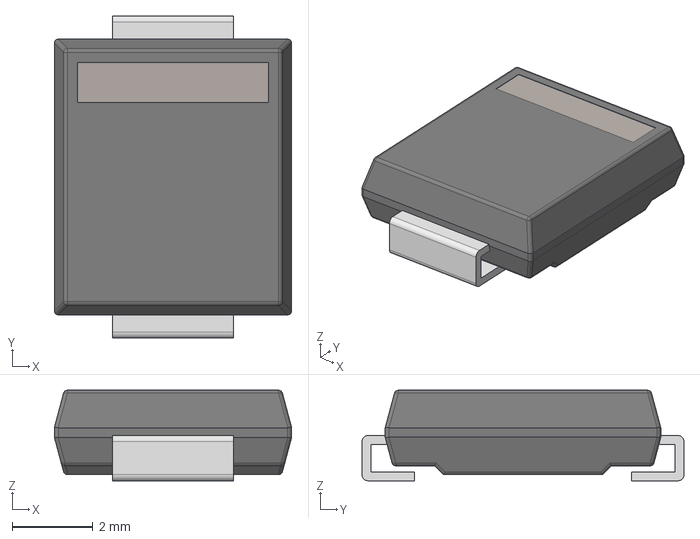
[picture p32: CAD file, 2018-03-31]
kicad-resources/kicad-librarys/thirdparty-3D/web/3D-shapes/SMD_SMx-series/SMC.stp
5.90 x 8.00 x 2.25 mm
