Jonathon-Reilly/Kicad/kicad-resources/kicad-librarys/thirdparty-3D/web/3D-shapes/SMD_SODx-series/SOD323F.stp

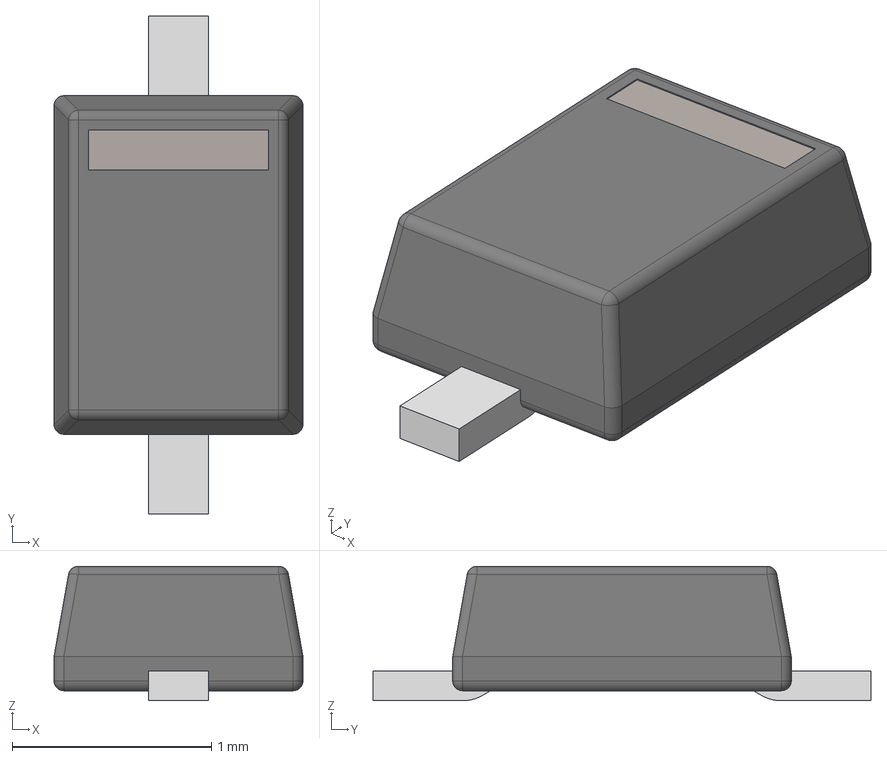
[picture p33: CAD file, 2018-03-31]
kicad-resources/kicad-librarys/thirdparty-3D/web/3D-shapes/SMD_SODx-series/SOD323F.stp
1.25 x 2.50 x 0.675 mm
