Jonathon-Reilly/Kicad/kicad-resources/kicad-librarys/thirdparty-3D/web/3D-shapes/SMD_SOTx-series/SOT23-3.stp

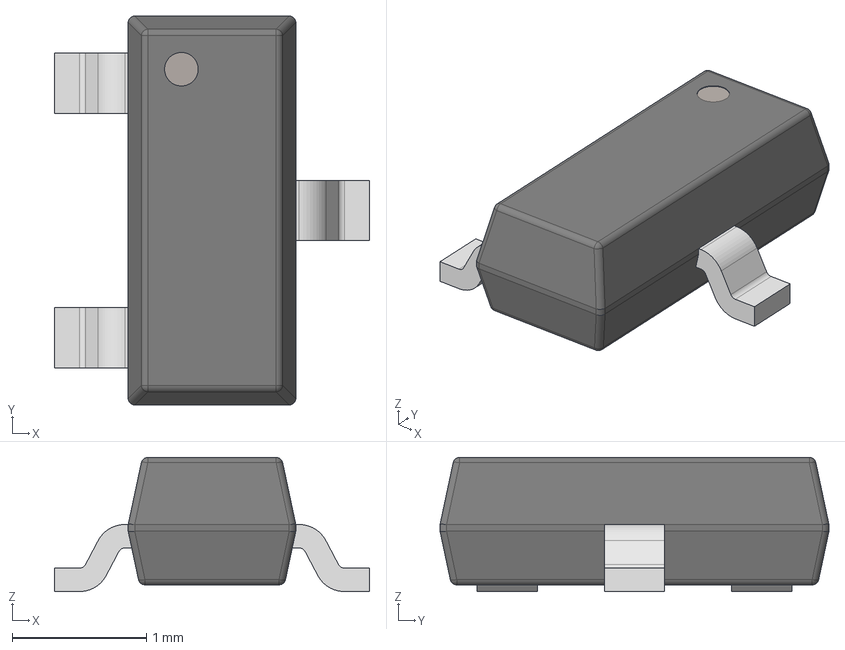
[picture p34: CAD file, 2018-03-31]
kicad-resources/kicad-librarys/thirdparty-3D/web/3D-shapes/SMD_SOTx-series/SOT23-3.stp
2.35 x 2.90 x 1.00 mm
