Jonathon-Reilly/Kicad/kicad-resources/kicad-librarys/thirdparty-3D/web/3D-shapes/Transformers/RM-8-LP_12pin.stp

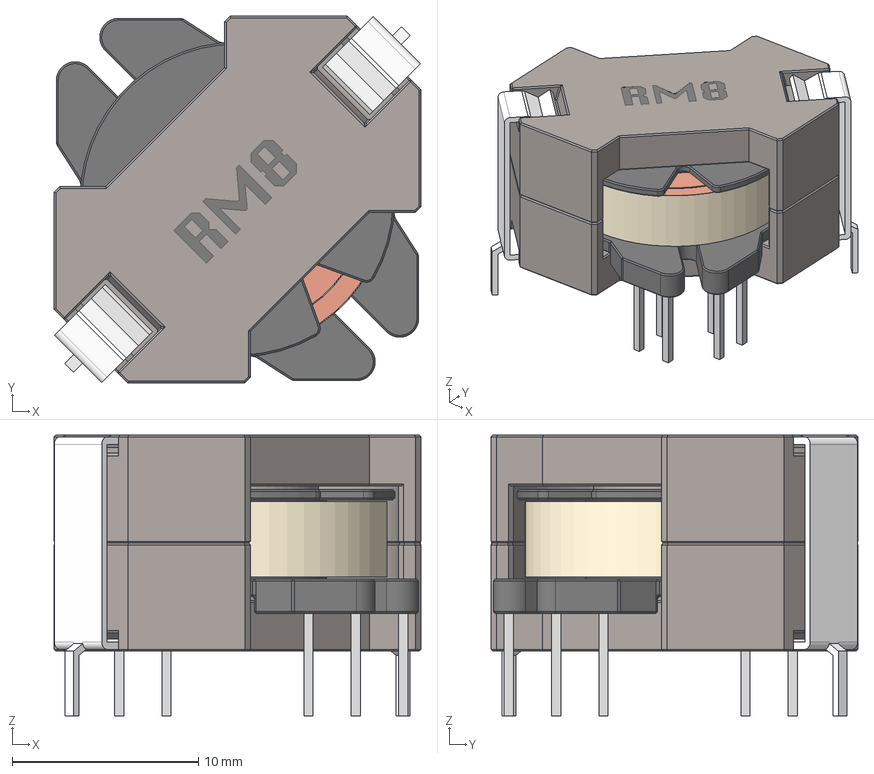
[picture p35: CAD file, 2018-03-31]
kicad-resources/kicad-librarys/thirdparty-3D/web/3D-shapes/Transformers/RM-8-LP_12pin.stp
19.7 x 19.7 x 15.1 mm
