Jonathon-Reilly/Kicad/kicad-resources/3D-cad-librarys/Lumberg_2_5_MSF_04.stl

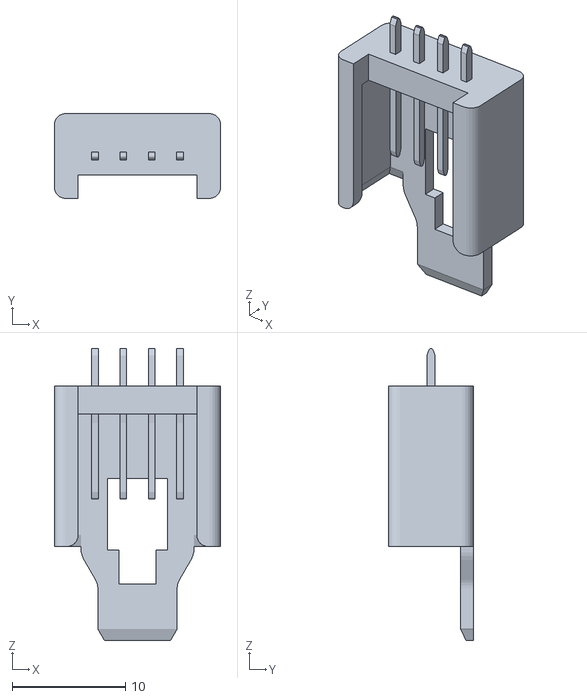
[picture p36: CAD file, 2017-08-08]
kicad-resources/3D-cad-librarys/Lumberg_2_5_MSF_04.stl
14.7 x 7.50 x 25.8
