Jonathon-Reilly/Kicad/kicad-resources/kicad-librarys/o_shovah-3D/con-lumberg/lumberg_2_5_msfw_o_03.stp

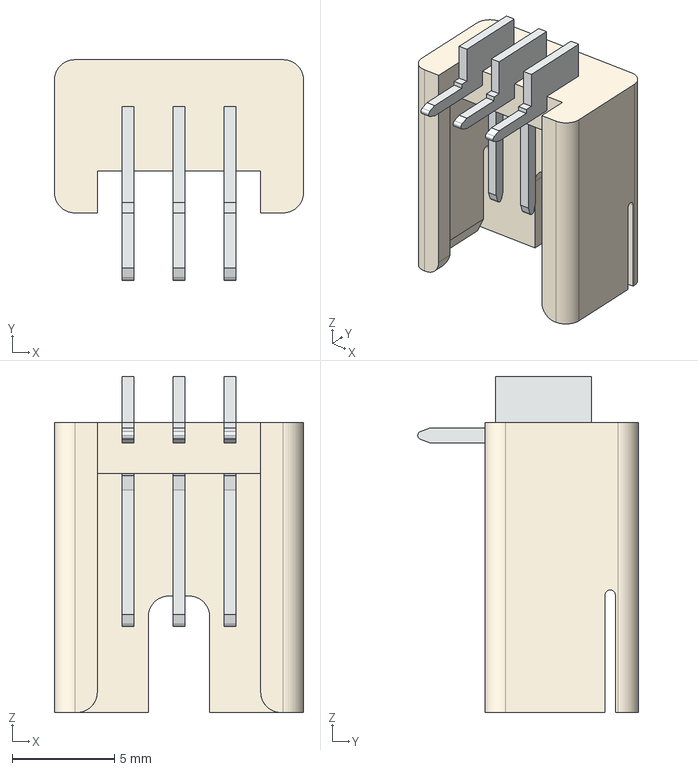
[picture p37: CAD file, 2017-08-08]
kicad-resources/kicad-librarys/o_shovah-3D/con-lumberg/lumberg_2_5_msfw_o_03.stp
12.2 x 10.8 x 16.4 mm
