Jonathon-Reilly/Kicad/kicad-resources/kicad-librarys/o_shovah-3D/devices_[JS]/D2F_01FL_A.step

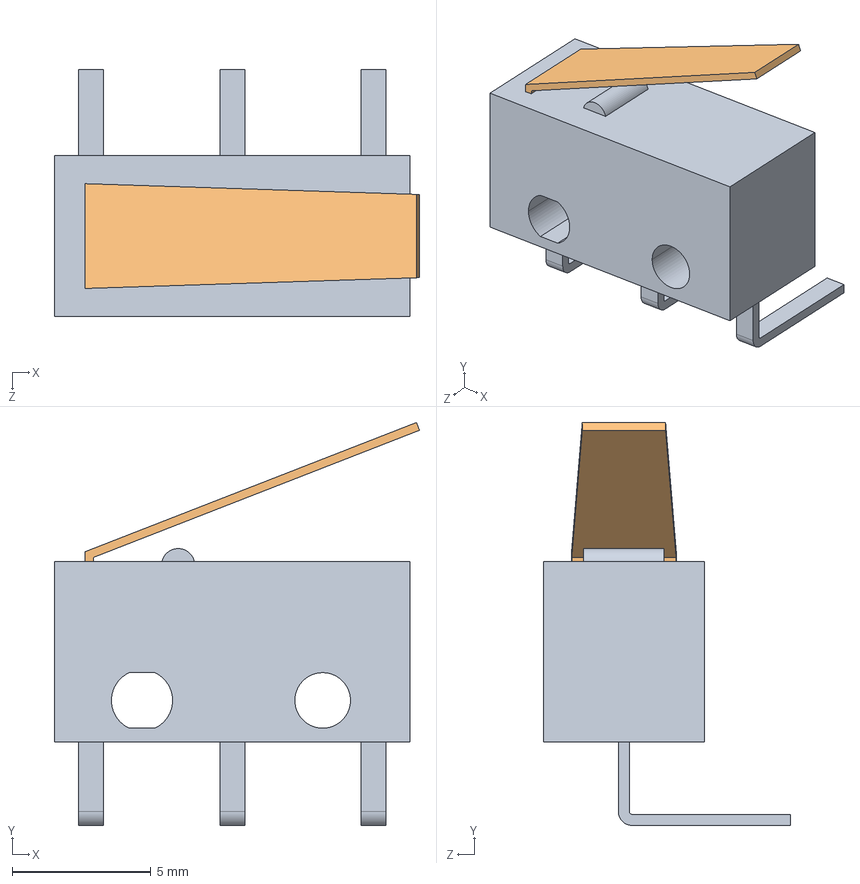
[picture p39: CAD file, 2018-03-31]
kicad-resources/kicad-librarys/o_shovah-3D/devices_[JS]/D2F_01FL_A.step
13.1 x 14.5 x 8.90 mm
D2F_01FL_A.BASE
D2F_01FL_A.ACTUATOR
