Jonathon-Reilly/Kicad/kicad-resources/kicad-librarys/o_shovah-3D/JST-PA-[JS]/S04B-PASK-2.STEP

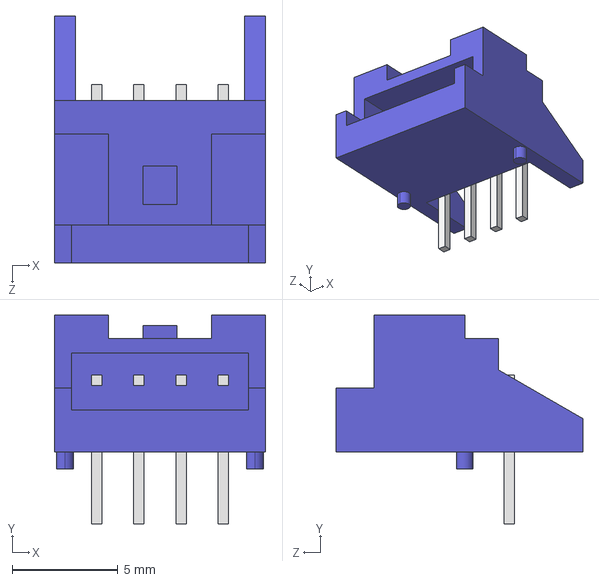
[picture p40: CAD file, 2018-02-26]
kicad-resources/kicad-librarys/o_shovah-3D/JST-PA-[JS]/S04B-PASK-2.STEP
10.0 x 9.90 x 11.7 mm
