Jonathon-Reilly/Kicad/kicad-resources/kicad-librarys/o_shovah-3D/JST-ZH-[MS]/B3B-ZR-3.4.STEP

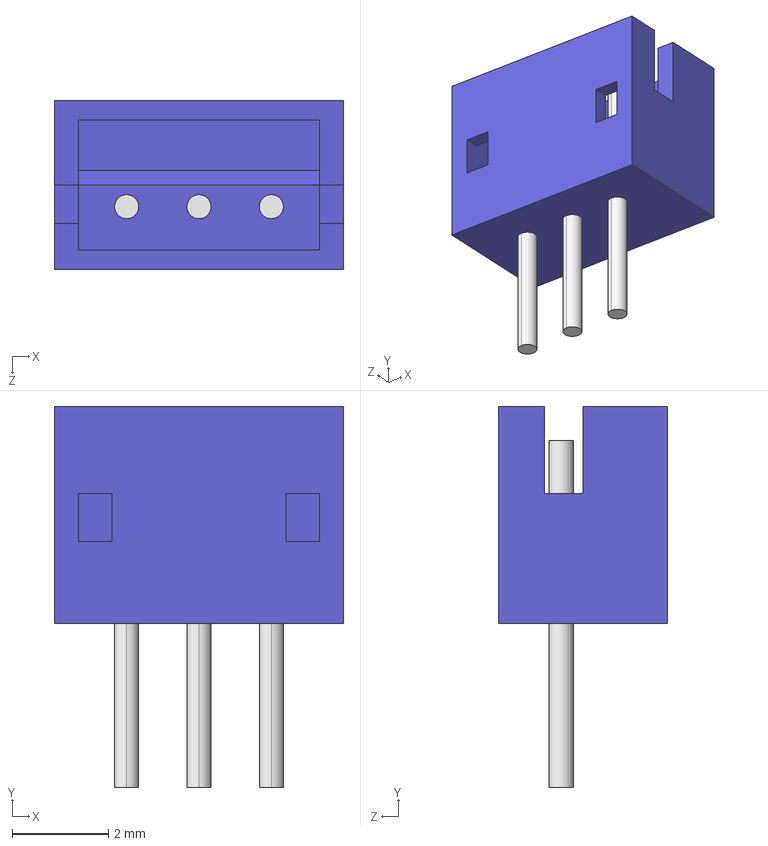
[picture p41: CAD file, 2017-10-18]
kicad-resources/kicad-librarys/o_shovah-3D/JST-ZH-[MS]/B3B-ZR-3.4.STEP
6.00 x 7.90 x 3.50 mm
