Jonathon-Reilly/Kicad/kicad-resources/kicad-librarys/o_shovah-3D/PowerPole_[JS]/Powerpole_2P.stp

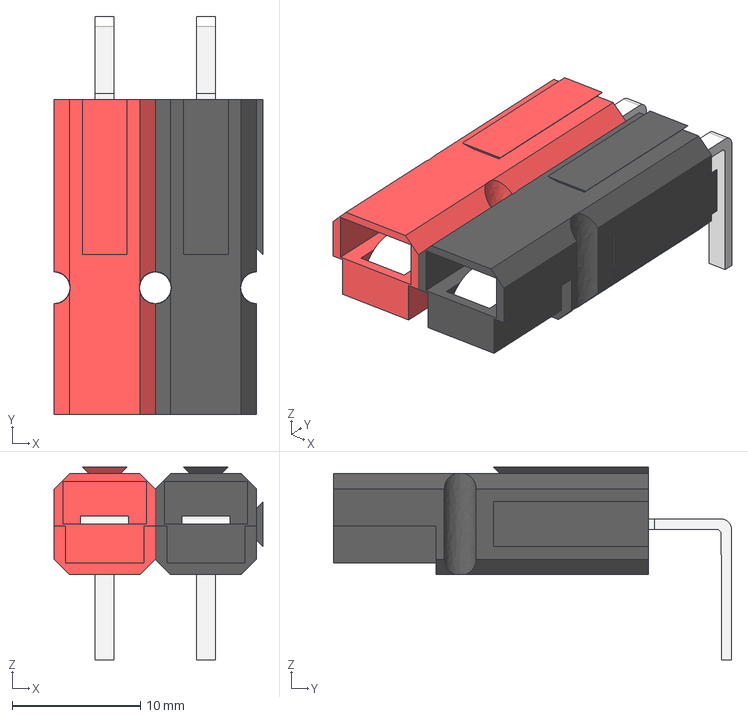
[picture p42: CAD file, 2017-08-08]
kicad-resources/kicad-librarys/o_shovah-3D/PowerPole_[JS]/Powerpole_2P.stp
16.3 x 31.1 x 15.0 mm
