Jonathon-Reilly/Kicad/kicad-resources/kicad-librarys/thirdparty-3D/web/3D-shapes/Conn_JST-SH-xP-1.0-TOPandSIDE/Conn_JST-SH-15P-1.0-TOP.stp

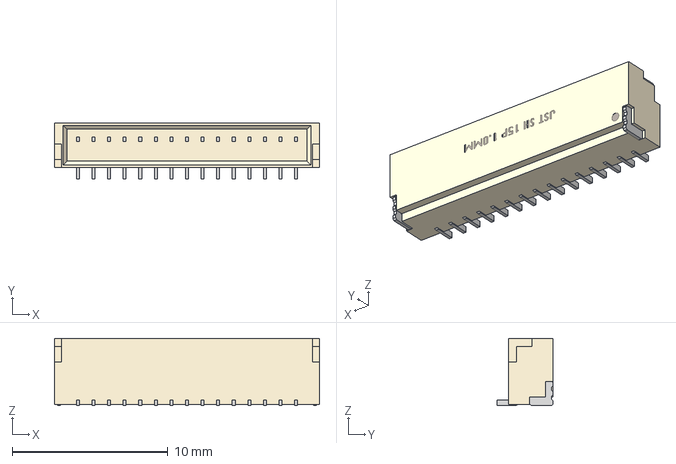
[picture p45: CAD file, 2018-03-31]
kicad-resources/kicad-librarys/thirdparty-3D/web/3D-shapes/Conn_JST-SH-xP-1.0-TOPandSIDE/Conn_JST-SH-15P-1.0-TOP.stp
17.0 x 3.60 x 4.30 mm
