Jonathon-Reilly/Kicad/kicad-resources/kicad-librarys/thirdparty-3D/web/3D-shapes/Conn_others/Conn_USB-micro-2.0_socket_right-angle.stp

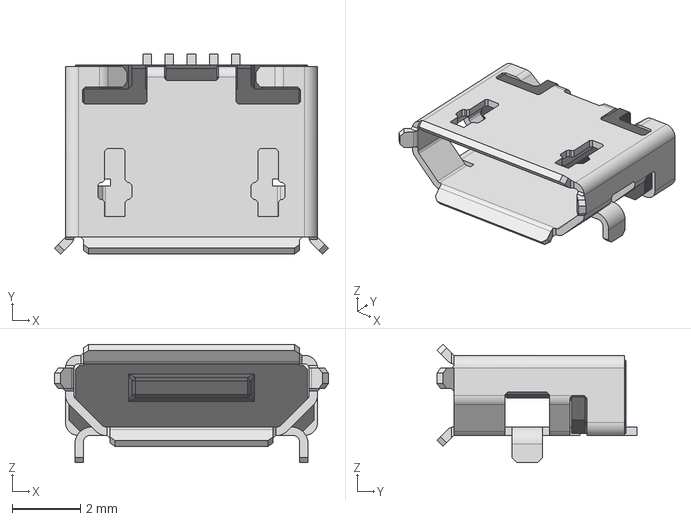
[picture p46: CAD file, 2018-03-31]
kicad-resources/kicad-librarys/thirdparty-3D/web/3D-shapes/Conn_others/Conn_USB-micro-2.0_socket_right-angle.stp
8.05 x 5.88 x 3.47 mm
