Jonathon-Reilly/Kicad/kicad-resources/kicad-librarys/thirdparty-3D/web/3D-shapes/Conn_Universal-3.81-xP-TOPandSIDE/Conn_Universal-3.81-6P-SIDE.stp

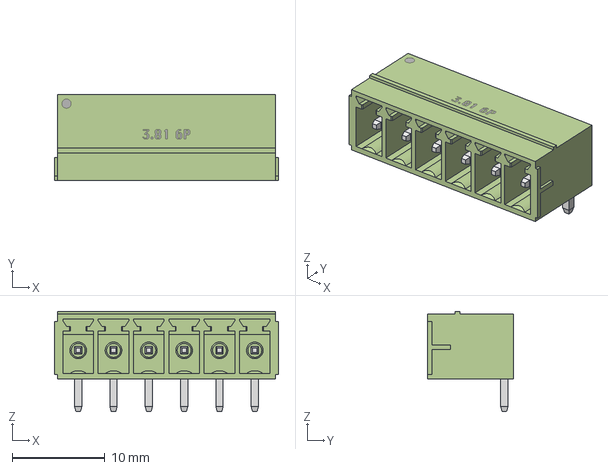
[picture p47: CAD file, 2018-03-31]
kicad-resources/kicad-librarys/thirdparty-3D/web/3D-shapes/Conn_Universal-3.81-xP-TOPandSIDE/Conn_Universal-3.81-6P-SIDE.stp
24.2 x 9.30 x 10.8 mm
