Jonathon-Reilly/Kicad/kicad-resources/kicad-librarys/thirdparty-3D/web/3D-shapes/Modules/Module_XBee-868LP.stp

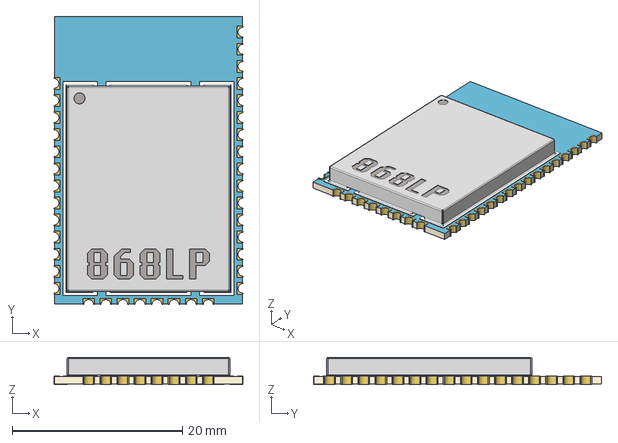
[picture p49: CAD file, 2018-03-31]
kicad-resources/kicad-librarys/thirdparty-3D/web/3D-shapes/Modules/Module_XBee-868LP.stp
22.2 x 33.8 x 3.20 mm
