Jonathon-Reilly/Kicad/kicad-resources/kicad-librarys/thirdparty-3D/web/3D-shapes/SMD_DCDC-converters/RECOM_R-78AAxx0.5-SMD_wLABEL.stp

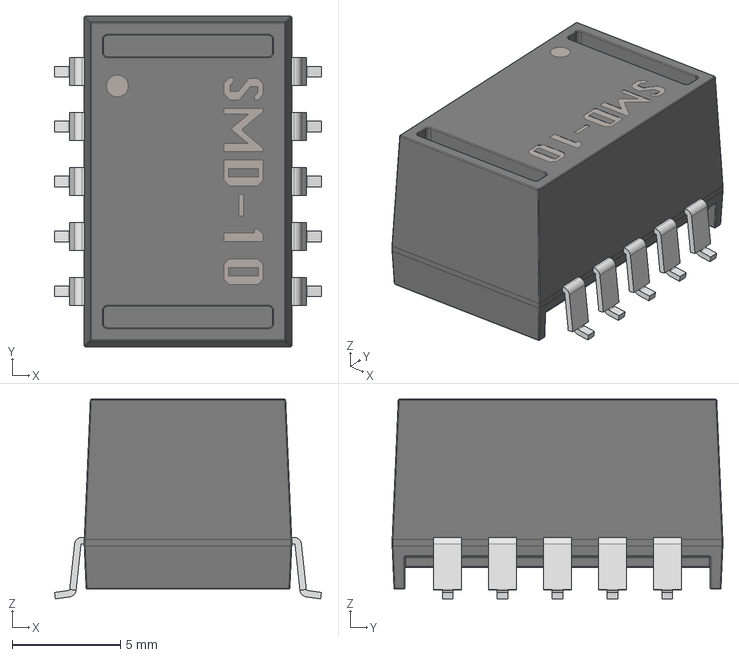
[picture p50: CAD file, 2018-03-31]
kicad-resources/kicad-librarys/thirdparty-3D/web/3D-shapes/SMD_DCDC-converters/RECOM_R-78AAxx0.5-SMD_wLABEL.stp
12.3 x 15.3 x 9.24 mm
