Jonathon-Reilly/Kicad/kicad-resources/kicad-librarys/thirdparty-3D/web/3D-shapes/SMD_Devices/MELF.stp

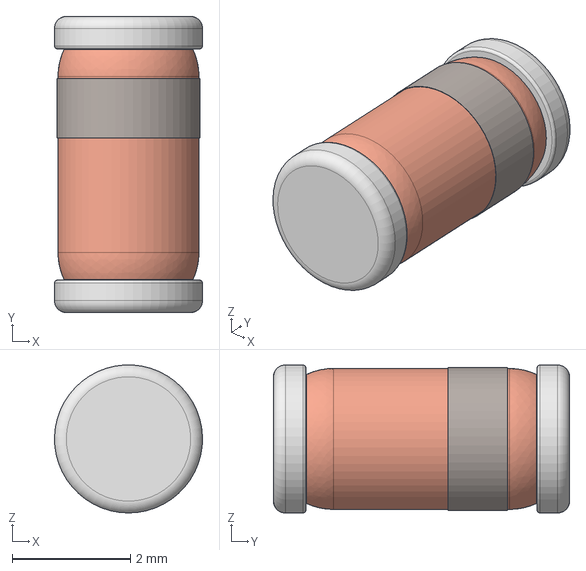
[picture p51: CAD file, 2018-03-31]
kicad-resources/kicad-librarys/thirdparty-3D/web/3D-shapes/SMD_Devices/MELF.stp
2.50 x 5.00 x 2.50 mm
