Jonathon-Reilly/Kicad/kicad-resources/kicad-librarys/thirdparty-3D/web/3D-shapes/SMD_SMDx_others/D2PAK-3_wLABEL.stp

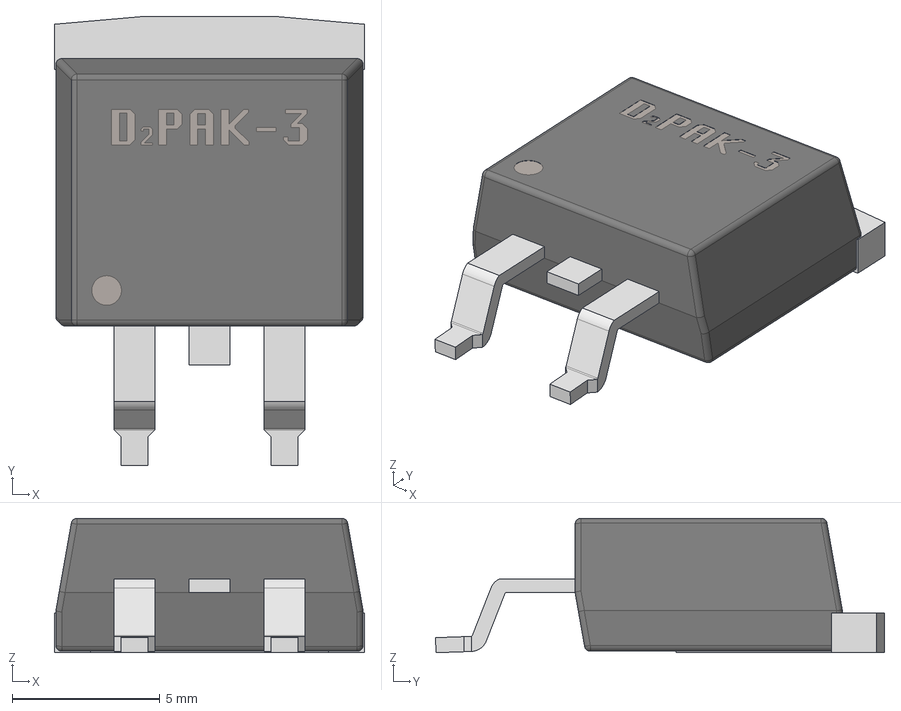
[picture p53: CAD file, 2018-03-31]
kicad-resources/kicad-librarys/thirdparty-3D/web/3D-shapes/SMD_SMDx_others/D2PAK-3_wLABEL.stp
10.5 x 15.2 x 4.55 mm
