Jonathon-Reilly/Kicad/kicad-resources/kicad-librarys/thirdparty-3D/web/3D-shapes/SMD_SMx-series/SMB_wLABEL.stp

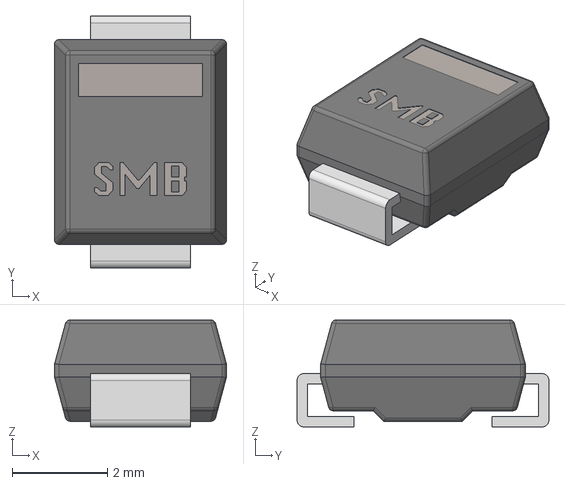
[picture p54: CAD file, 2018-03-31]
kicad-resources/kicad-librarys/thirdparty-3D/web/3D-shapes/SMD_SMx-series/SMB_wLABEL.stp
3.62 x 5.30 x 2.25 mm
