Jonathon-Reilly/Kicad/kicad-resources/kicad-librarys/thirdparty-3D/web/3D-shapes/SMD_SOTx-series/SOT457_wLABEL.stp

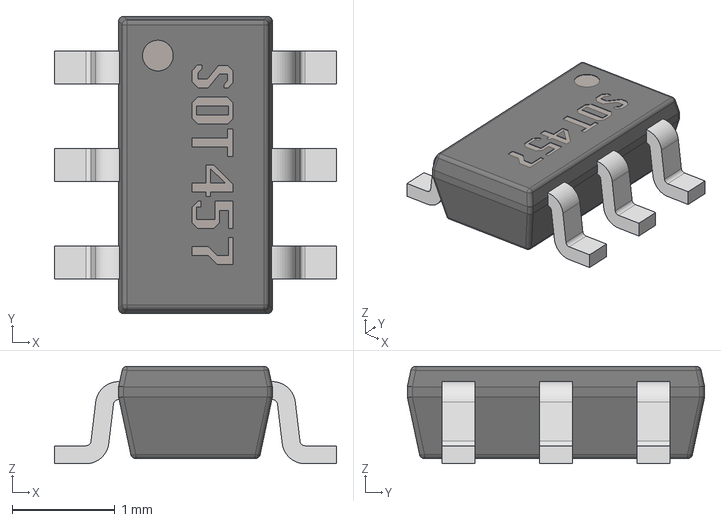
[picture p56: CAD file, 2018-03-31]
kicad-resources/kicad-librarys/thirdparty-3D/web/3D-shapes/SMD_SOTx-series/SOT457_wLABEL.stp
2.75 x 2.90 x 0.95 mm
