Jonathon-Reilly/Kicad/kicad-resources/kicad-librarys/thirdparty-3D/web/3D-shapes/Transformers/RM-5_6pin.stp

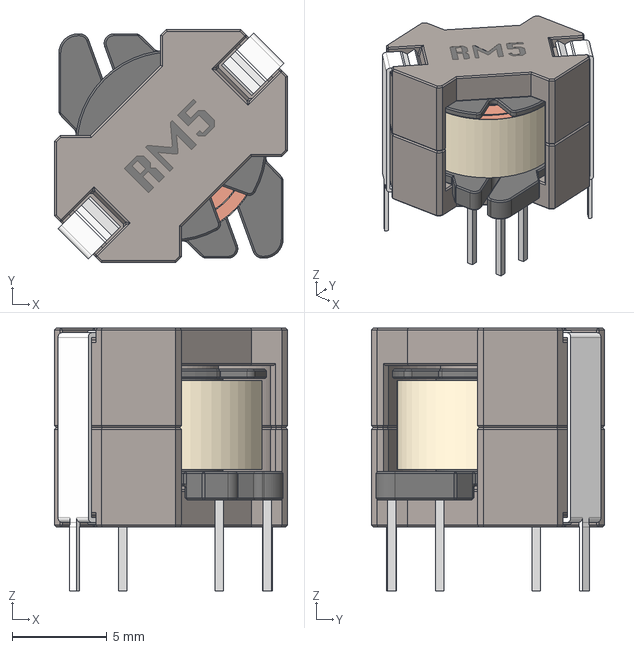
[picture p57: CAD file, 2018-03-31]
kicad-resources/kicad-librarys/thirdparty-3D/web/3D-shapes/Transformers/RM-5_6pin.stp
12.3 x 12.3 x 13.9 mm
