Jonathon-Reilly/Kicad/kicad-resources/3D-cad-librarys/XP_Power_IH0512D.stl

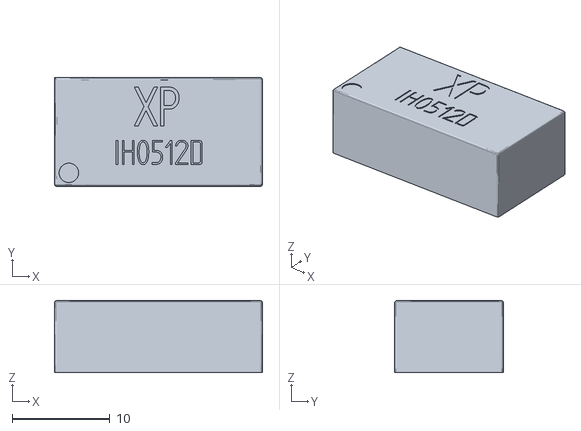
[picture p58: CAD file, 2017-08-08]
kicad-resources/3D-cad-librarys/XP_Power_IH0512D.stl
21.3 x 11.2 x 7.38
