Jonathon-Reilly/Kicad/kicad-resources/kicad-librarys/o_shovah-3D/con-lumberg/lumberg_2_5_msfw_o_10.stp

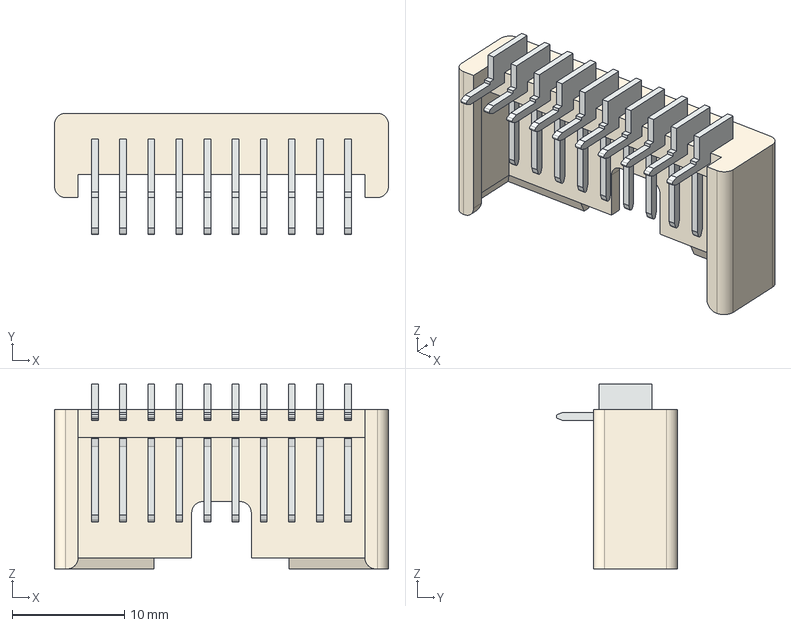
[picture p59: CAD file, 2017-08-08]
kicad-resources/kicad-librarys/o_shovah-3D/con-lumberg/lumberg_2_5_msfw_o_10.stp
29.7 x 10.8 x 16.5 mm
