Jonathon-Reilly/Kicad/kicad-resources/kicad-librarys/o_shovah-3D/connectors-[JS]/c-5-1634503-1-d-3d.stp

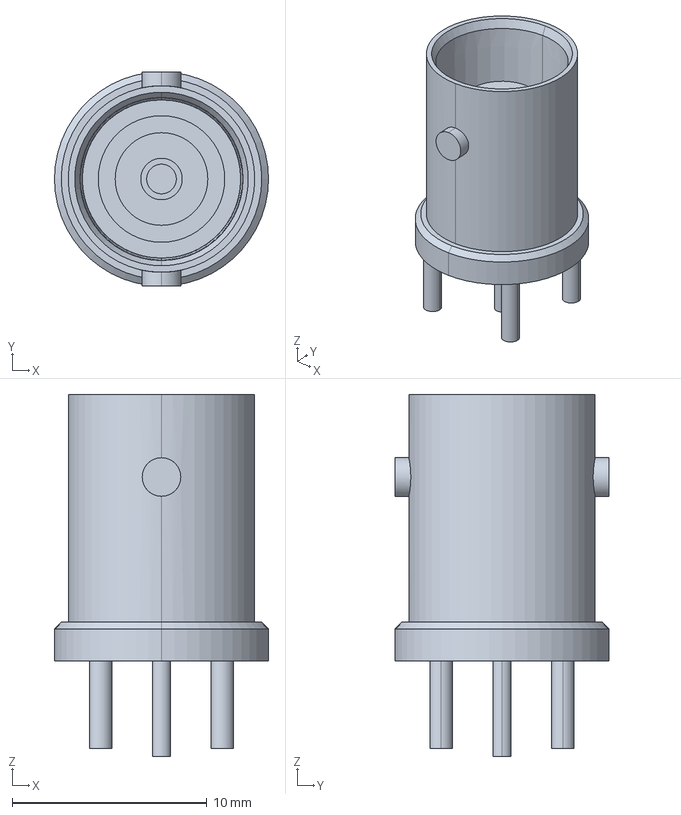
[picture p60: CAD file, 2018-03-31]
kicad-resources/kicad-librarys/o_shovah-3D/connectors-[JS]/c-5-1634503-1-d-3d.stp
11.0 x 11.0 x 18.6 mm
