Jonathon-Reilly/Kicad/kicad-resources/kicad-librarys/o_shovah-3D/devices_[JS]/PVSON-10.STEP

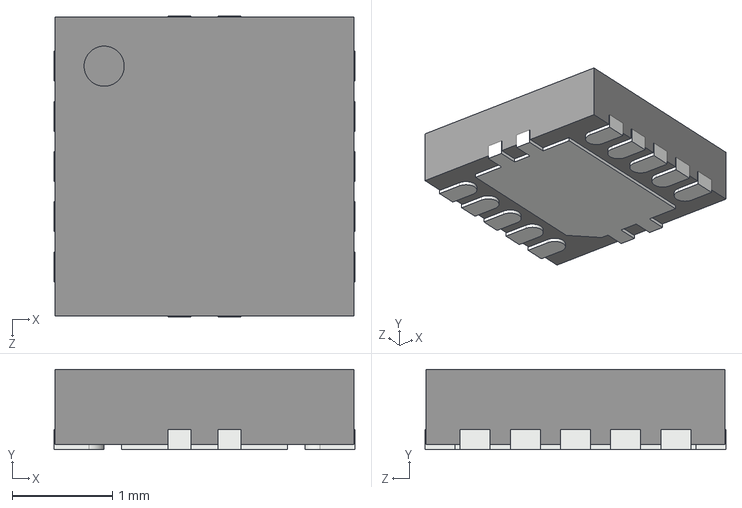
[picture p61: CAD file, 2018-03-31]
kicad-resources/kicad-librarys/o_shovah-3D/devices_[JS]/PVSON-10.STEP
3.00 x 0.8 x 3.00 mm
