Jonathon-Reilly/Kicad/kicad-resources/kicad-librarys/thirdparty-3D/web/3D-shapes/Conn_JST-SH-xP-1.0-TOPandSIDE/Conn_JST-SH-4P-1.0-SIDE.stp

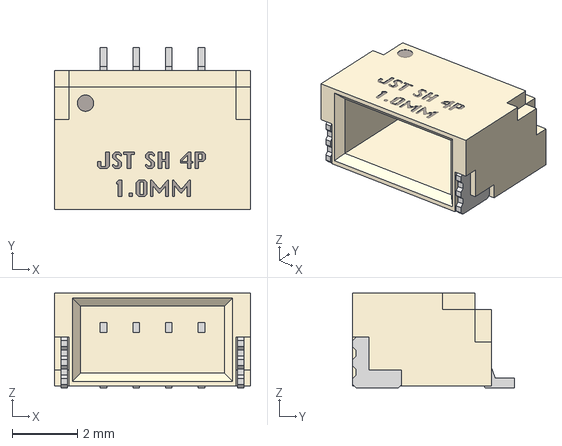
[picture p65: CAD file, 2018-03-31]
kicad-resources/kicad-librarys/thirdparty-3D/web/3D-shapes/Conn_JST-SH-xP-1.0-TOPandSIDE/Conn_JST-SH-4P-1.0-SIDE.stp
6.00 x 4.95 x 2.90 mm
