Jonathon-Reilly/Kicad/kicad-resources/kicad-librarys/thirdparty-3D/web/3D-shapes/Conn_Universal-3.81-xP-TOPandSIDE/Conn_Universal-3.81-8P-TOP.stp

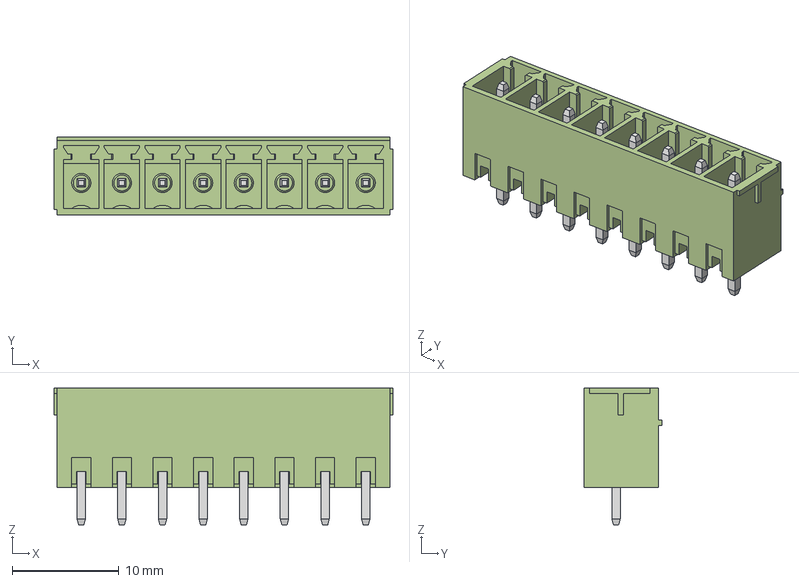
[picture p66: CAD file, 2018-03-31]
kicad-resources/kicad-librarys/thirdparty-3D/web/3D-shapes/Conn_Universal-3.81-xP-TOPandSIDE/Conn_Universal-3.81-8P-TOP.stp
31.8 x 7.30 x 12.8 mm
