Jonathon-Reilly/Kicad/kicad-resources/kicad-librarys/thirdparty-3D/web/3D-shapes/SMD_Devices/MELF_MINI.stp

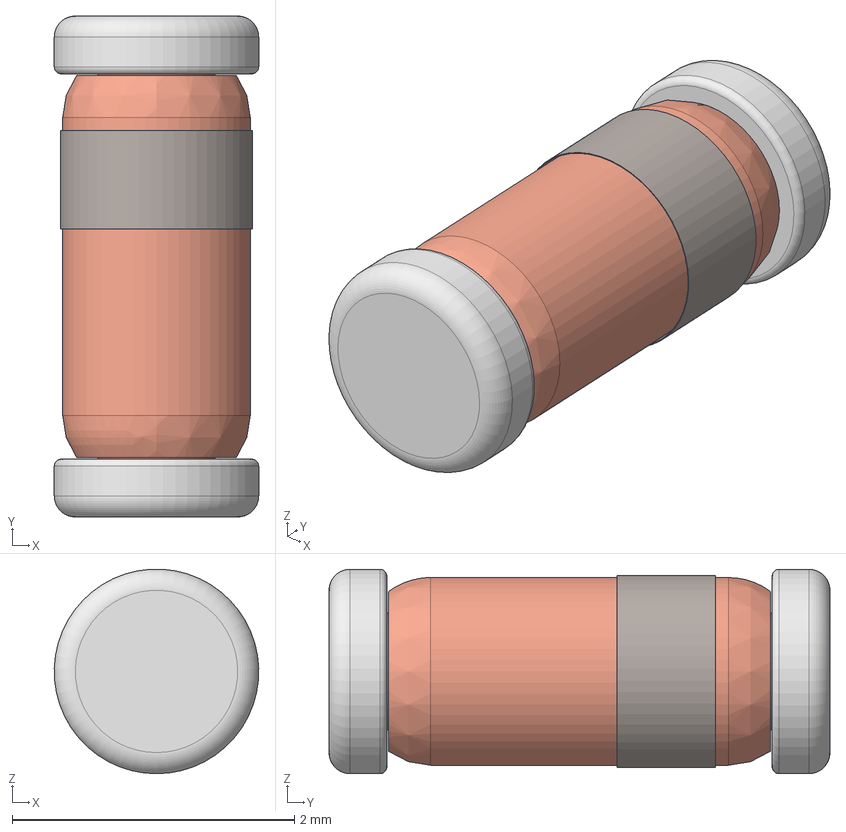
[picture p69: CAD file, 2018-03-31]
kicad-resources/kicad-librarys/thirdparty-3D/web/3D-shapes/SMD_Devices/MELF_MINI.stp
1.45 x 3.55 x 1.45 mm
