Jonathon-Reilly/Kicad/kicad-resources/kicad-librarys/thirdparty-3D/web/3D-shapes/SMD_LEDs/LED_0805.stp

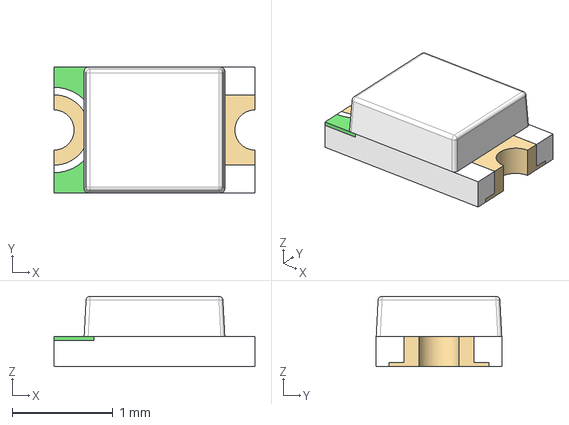
[picture p70: CAD file, 2018-03-06]
kicad-resources/kicad-librarys/thirdparty-3D/web/3D-shapes/SMD_LEDs/LED_0805.stp
2.00 x 1.25 x 0.7 mm
