Jonathon-Reilly/Kicad/kicad-resources/kicad-librarys/thirdparty-3D/web/3D-shapes/SMD_SMx-series/SMA.stp

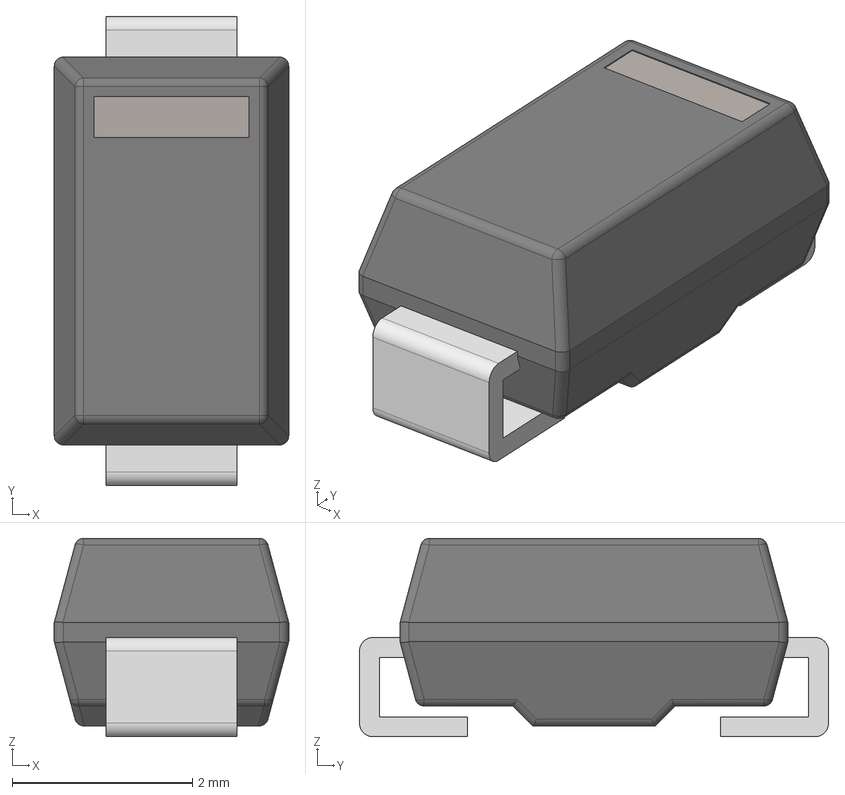
[picture p71: CAD file, 2018-03-31]
kicad-resources/kicad-librarys/thirdparty-3D/web/3D-shapes/SMD_SMx-series/SMA.stp
2.60 x 5.20 x 2.20 mm
