Jonathon-Reilly/Kicad/kicad-resources/kicad-librarys/thirdparty-3D/web/3D-shapes/SMD_SODx-series/SOD323.stp

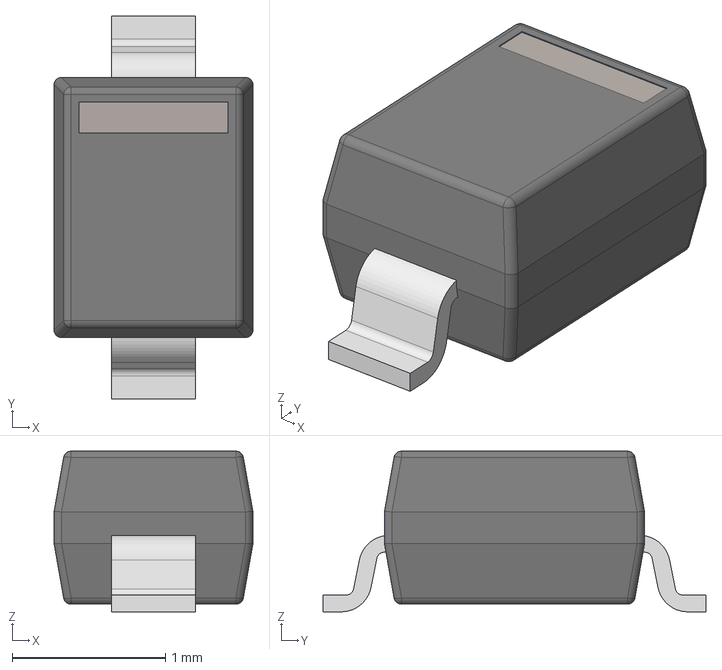
[picture p72: CAD file, 2018-03-31]
kicad-resources/kicad-librarys/thirdparty-3D/web/3D-shapes/SMD_SODx-series/SOD323.stp
1.30 x 2.50 x 1.05 mm
