Jonathon-Reilly/Kicad/kicad-resources/kicad-librarys/thirdparty-3D/web/3D-shapes/SMD_SOTx-series/SOT363_wLABEL.stp

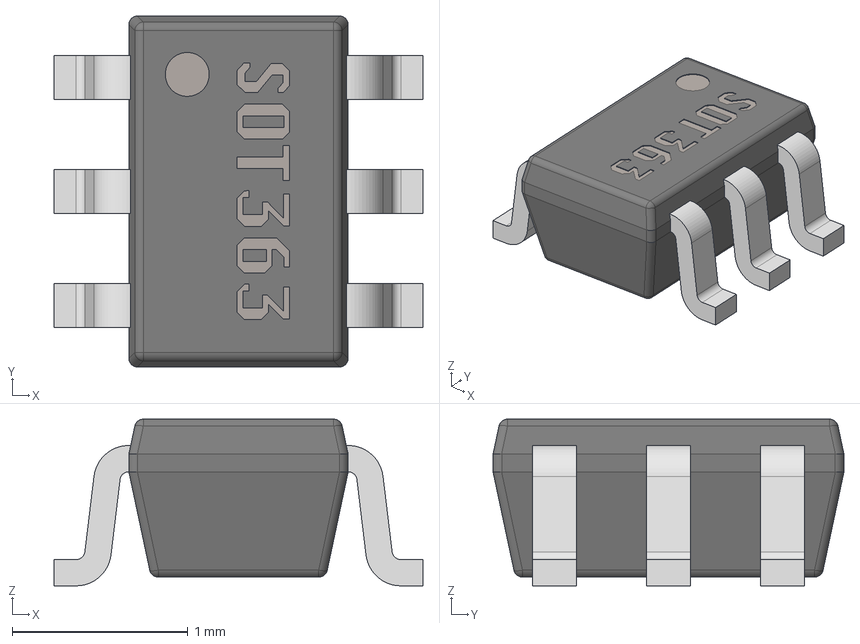
[picture p73: CAD file, 2018-03-31]
kicad-resources/kicad-librarys/thirdparty-3D/web/3D-shapes/SMD_SOTx-series/SOT363_wLABEL.stp
2.10 x 2.00 x 0.95 mm
