Jonathon-Reilly/Kicad/kicad-resources/kicad-librarys/thirdparty-3D/web/3D-shapes/Transformers/RM-8_12pin.stp

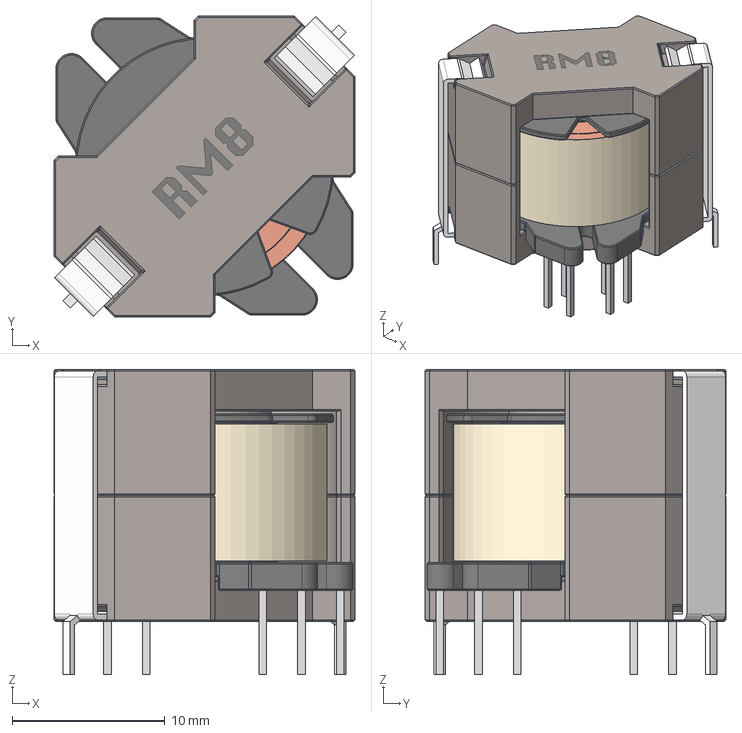
[picture p74: CAD file, 2018-03-31]
kicad-resources/kicad-librarys/thirdparty-3D/web/3D-shapes/Transformers/RM-8_12pin.stp
19.7 x 19.7 x 20.0 mm
