Jonathon-Reilly/Kicad/kicad-resources/kicad-librarys/o_shovah-3D/con-lumberg/lumberg_2_5_msf_o_11.stp

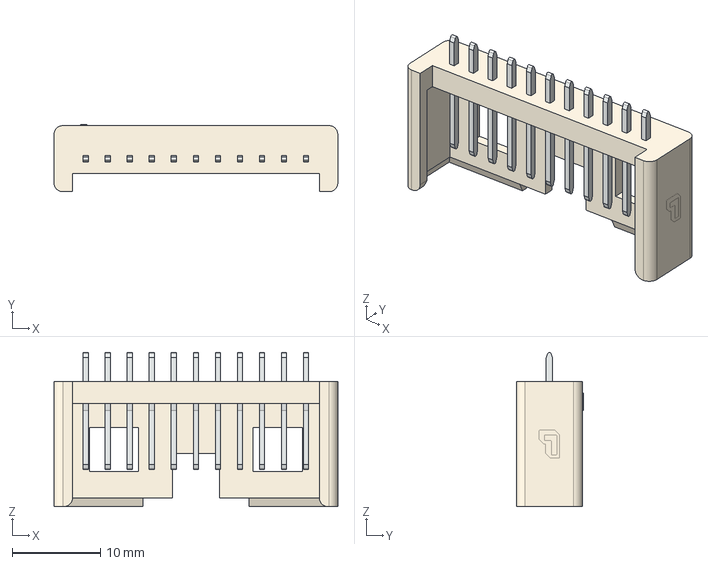
[picture p75: CAD file, 2017-08-08]
kicad-resources/kicad-librarys/o_shovah-3D/con-lumberg/lumberg_2_5_msf_o_11.stp
32.2 x 7.65 x 17.5 mm
