Jonathon-Reilly/Kicad/kicad-resources/kicad-librarys/thirdparty-3D/web/3D-shapes/Conn_Universal-3.81-xP-TOPandSIDE/Conn_Universal-3.81-7P-TOP.stp

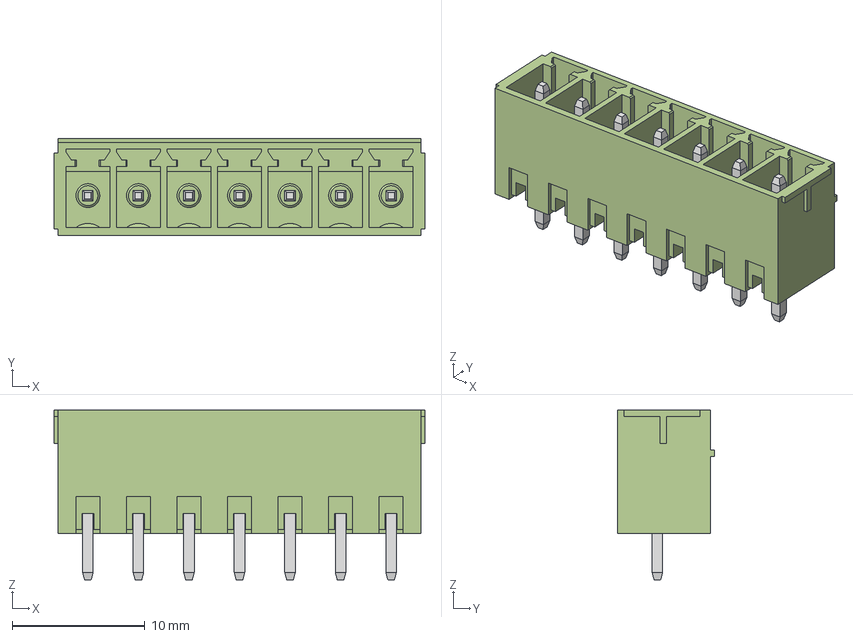
[picture p80: CAD file, 2018-03-31]
kicad-resources/kicad-librarys/thirdparty-3D/web/3D-shapes/Conn_Universal-3.81-xP-TOPandSIDE/Conn_Universal-3.81-7P-TOP.stp
28.0 x 7.30 x 12.8 mm
