Jonathon-Reilly/Kicad/kicad-resources/kicad-librarys/thirdparty-3D/web/3D-shapes/Modules/Module_AI-Thinkerer-ESP07.stp

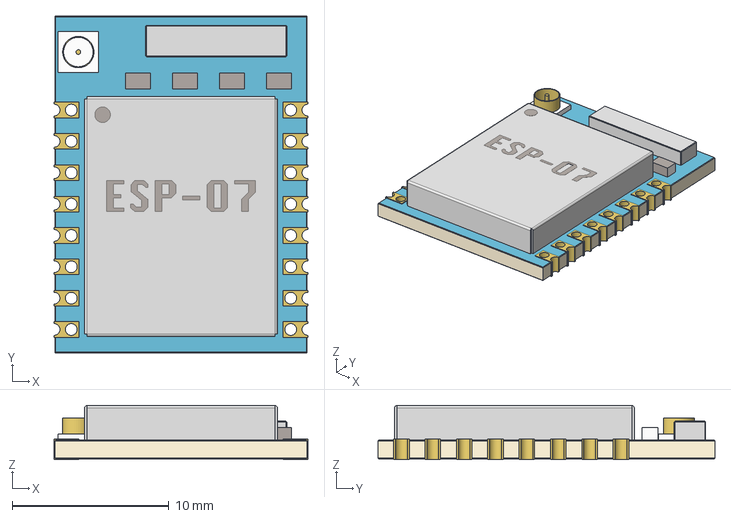
[picture p82: CAD file, 2018-03-31]
kicad-resources/kicad-librarys/thirdparty-3D/web/3D-shapes/Modules/Module_AI-Thinkerer-ESP07.stp
16.2 x 21.5 x 3.46 mm
