Jonathon-Reilly/Kicad/kicad-resources/kicad-librarys/thirdparty-3D/web/3D-shapes/SMD_Devices/Crystal_6.9x1.4x1.4.stp

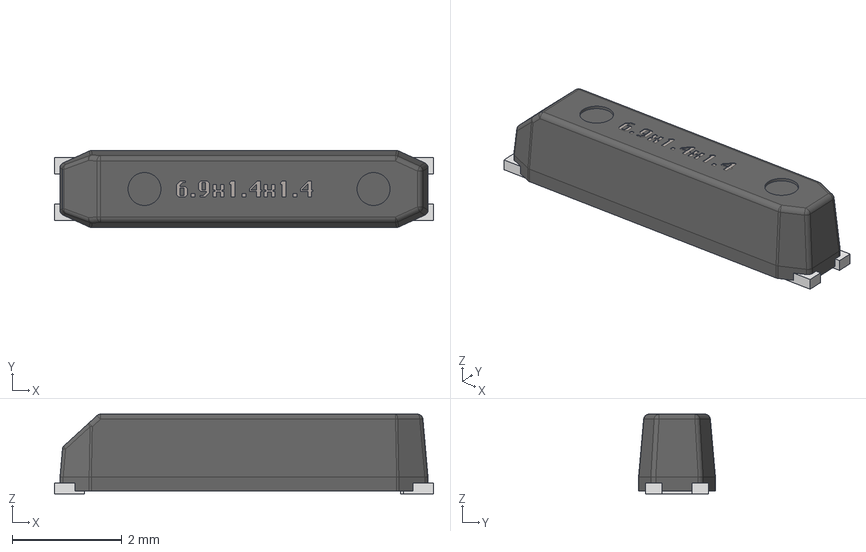
[picture p83: CAD file, 2018-03-31]
kicad-resources/kicad-librarys/thirdparty-3D/web/3D-shapes/SMD_Devices/Crystal_6.9x1.4x1.4.stp
6.90 x 1.40 x 1.45 mm
