Jonathon-Reilly/Kicad/kicad-resources/kicad-librarys/thirdparty-3D/web/3D-shapes/SMD_SMDx_others/DPAK-3.stp

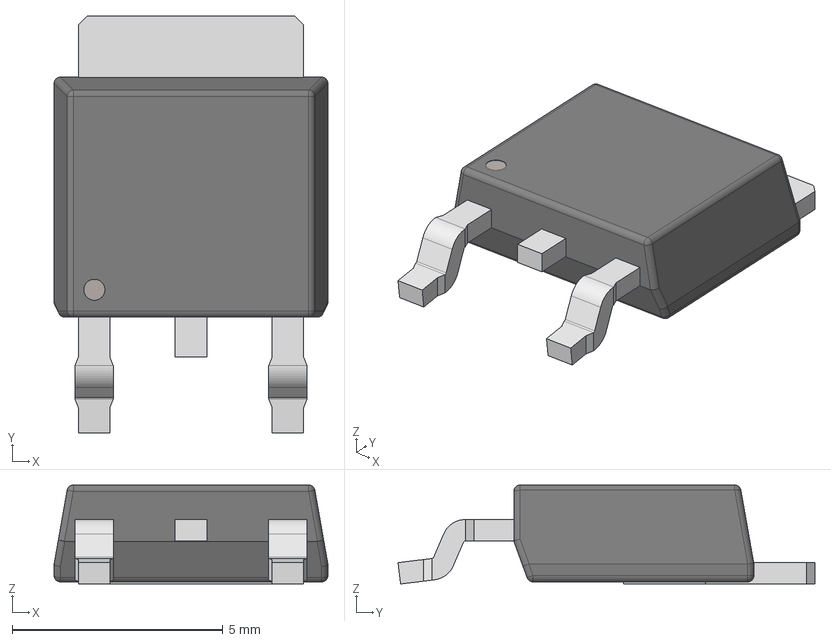
[picture p84: CAD file, 2018-03-31]
kicad-resources/kicad-librarys/thirdparty-3D/web/3D-shapes/SMD_SMDx_others/DPAK-3.stp
6.50 x 9.90 x 2.35 mm
