Jonathon-Reilly/Kicad/kicad-resources/kicad-librarys/thirdparty-3D/web/3D-shapes/Transformers/RM-7_8pin.stp

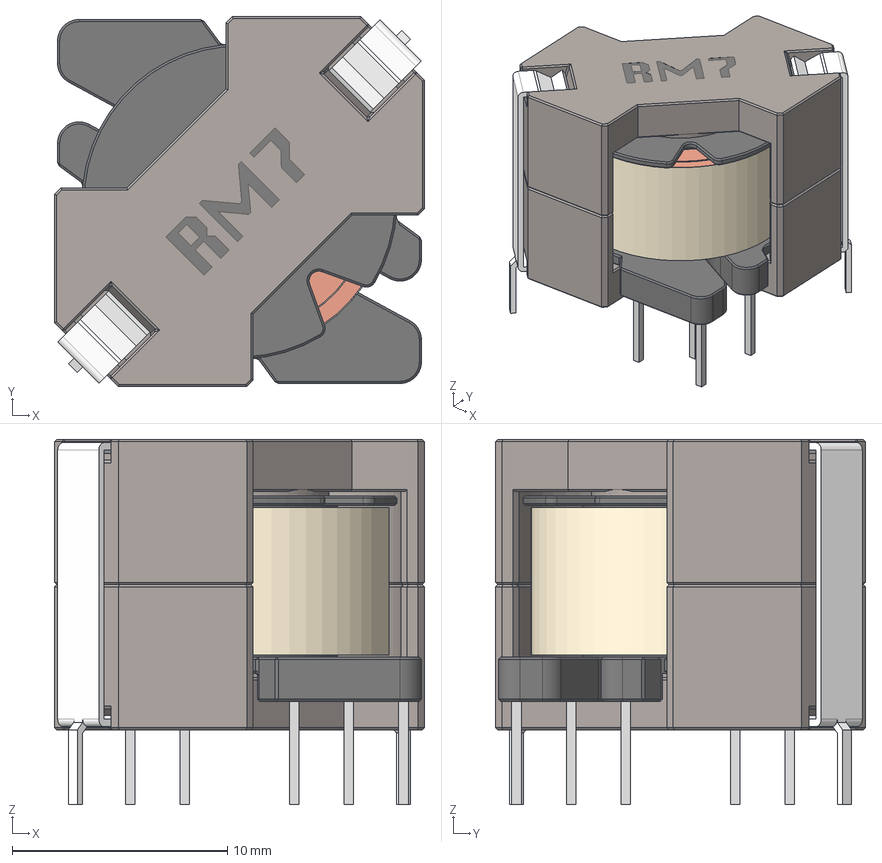
[picture p86: CAD file, 2018-03-31]
kicad-resources/kicad-librarys/thirdparty-3D/web/3D-shapes/Transformers/RM-7_8pin.stp
17.2 x 17.2 x 17.0 mm
