Jonathon-Reilly/Kicad/kicad-resources/kicad-librarys/o_shovah-3D/con-lumberg/lumberg_2_5_msf_o_05.stp

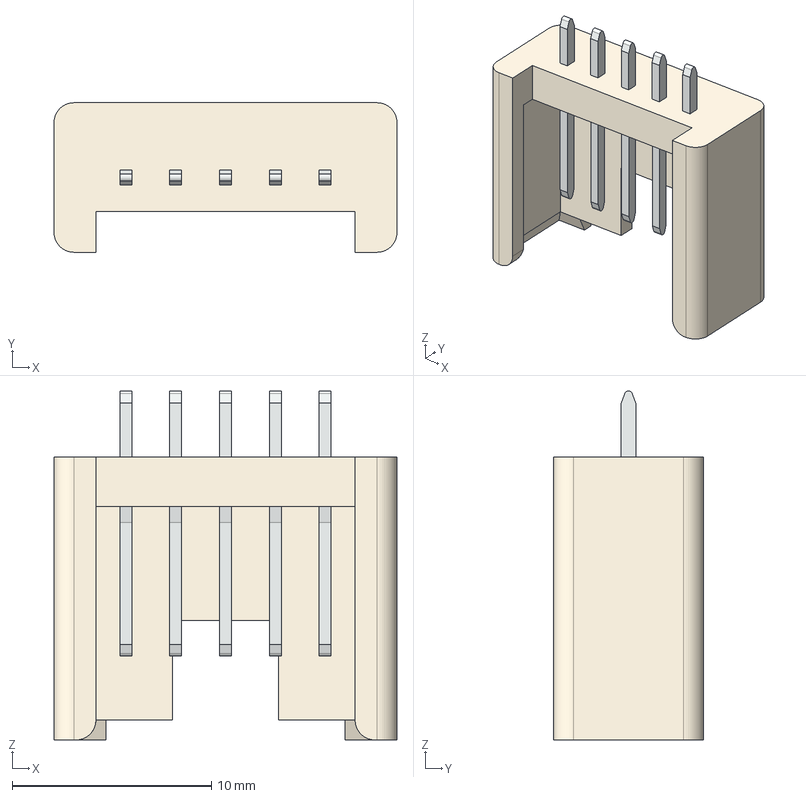
[picture p87: CAD file, 2017-08-08]
kicad-resources/kicad-librarys/o_shovah-3D/con-lumberg/lumberg_2_5_msf_o_05.stp
17.2 x 7.50 x 17.5 mm
