Jonathon-Reilly/Kicad/kicad-resources/kicad-librarys/o_shovah-3D/JST-PA-[JS]/B10B-PASK-1.STEP

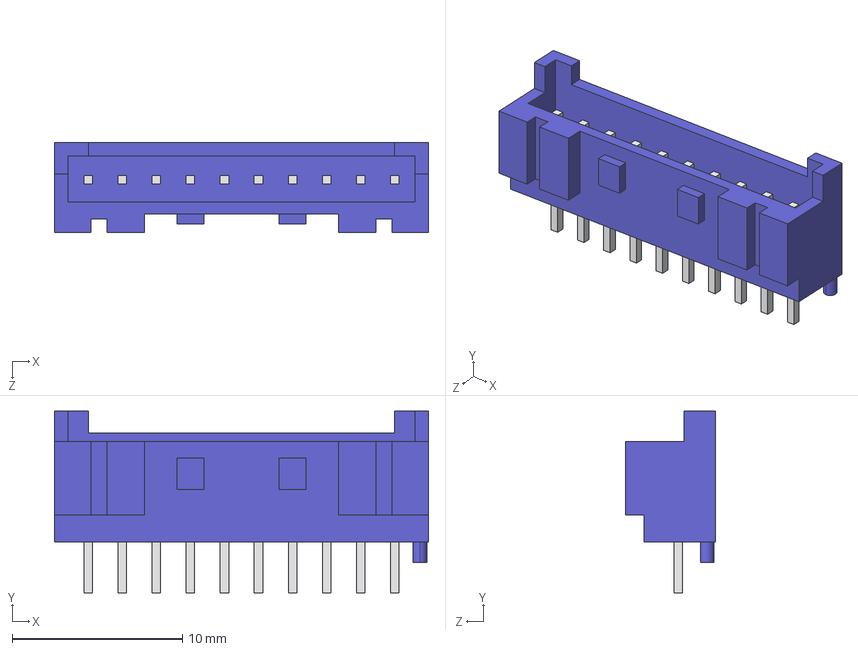
[picture p88: CAD file, 2017-10-18]
kicad-resources/kicad-librarys/o_shovah-3D/JST-PA-[JS]/B10B-PASK-1.STEP
22.0 x 10.7 x 5.30 mm
