Jonathon-Reilly/Kicad/kicad-resources/kicad-librarys/thirdparty-3D/web/3D-shapes/Conn_Universal-3.81-xP-TOPandSIDE/Conn_Universal-3.81-3P-TOP.stp

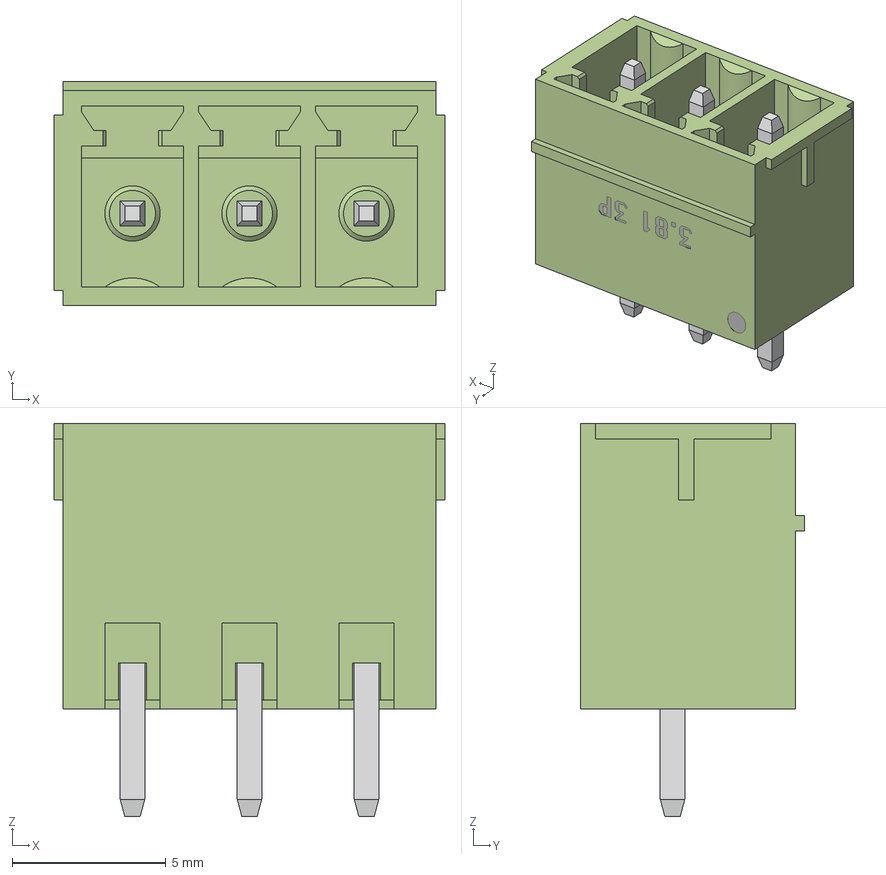
[picture p92: CAD file, 2018-03-31]
kicad-resources/kicad-librarys/thirdparty-3D/web/3D-shapes/Conn_Universal-3.81-xP-TOPandSIDE/Conn_Universal-3.81-3P-TOP.stp
12.7 x 7.30 x 12.8 mm
