Jonathon-Reilly/Kicad/kicad-resources/kicad-librarys/thirdparty-3D/web/3D-shapes/Conn_Universal-5.08-xP-TOPandSIDE/Conn_Universal-5.08-4P-TOP.stp

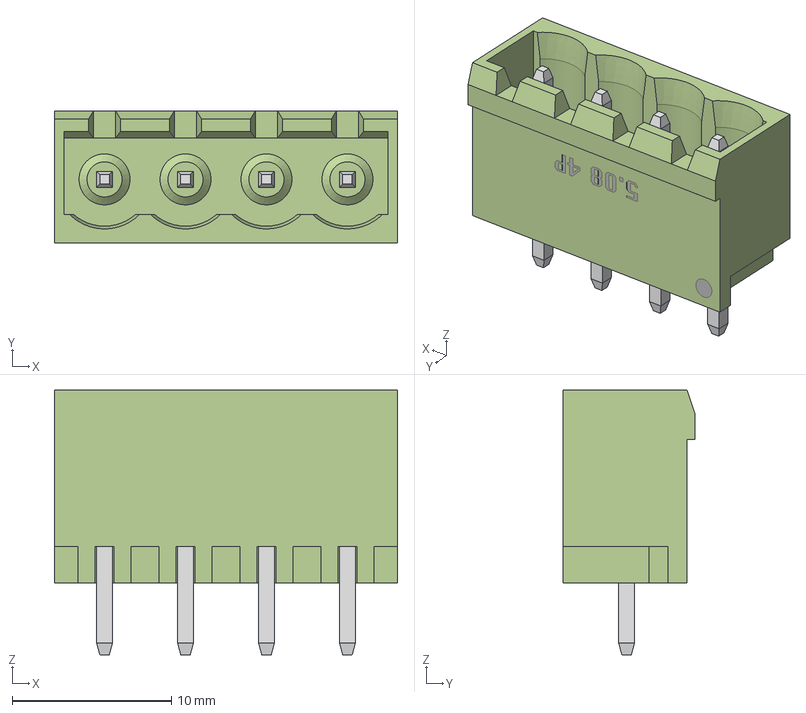
[picture p93: CAD file, 2018-03-31]
kicad-resources/kicad-librarys/thirdparty-3D/web/3D-shapes/Conn_Universal-5.08-xP-TOPandSIDE/Conn_Universal-5.08-4P-TOP.stp
21.5 x 8.30 x 16.6 mm
