Jonathon-Reilly/Kicad/kicad-resources/kicad-librarys/thirdparty-3D/web/3D-shapes/Modules/Module_Telit-SL869.stp

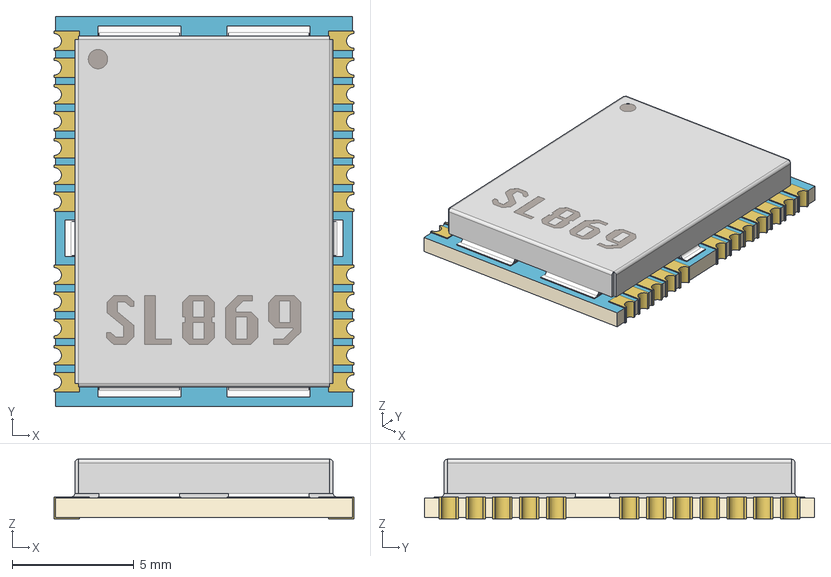
[picture p94: CAD file, 2018-03-31]
kicad-resources/kicad-librarys/thirdparty-3D/web/3D-shapes/Modules/Module_Telit-SL869.stp
12.3 x 16.0 x 2.45 mm
