Jonathon-Reilly/Kicad/kicad-resources/kicad-librarys/thirdparty-3D/web/3D-shapes/SMD_Devices/Crystal_3.2x2.5x1.0.stp

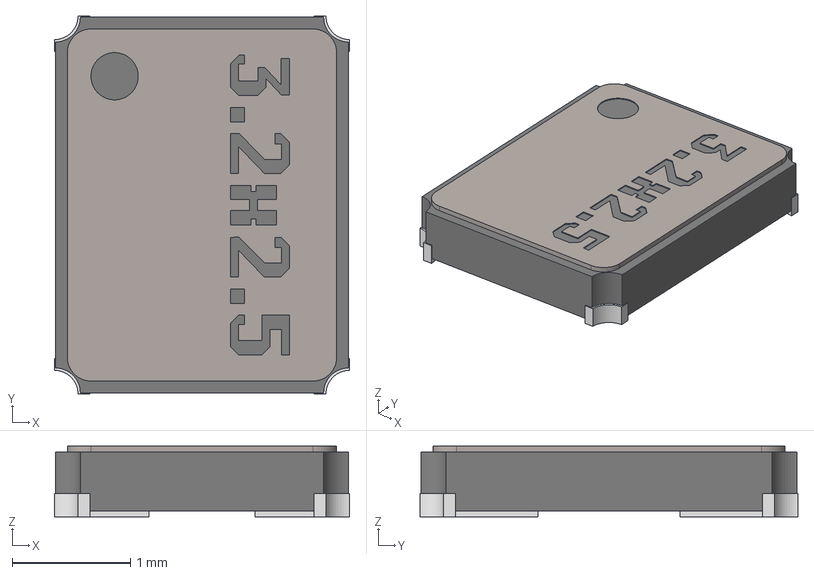
[picture p95: CAD file, 2018-03-31]
kicad-resources/kicad-librarys/thirdparty-3D/web/3D-shapes/SMD_Devices/Crystal_3.2x2.5x1.0.stp
2.50 x 3.20 x 0.6 mm
