Jonathon-Reilly/Kicad/kicad-resources/kicad-librarys/thirdparty-3D/web/3D-shapes/SMD_SMDx_others/VSSOP8-8P-0.50_wLABEL.stp

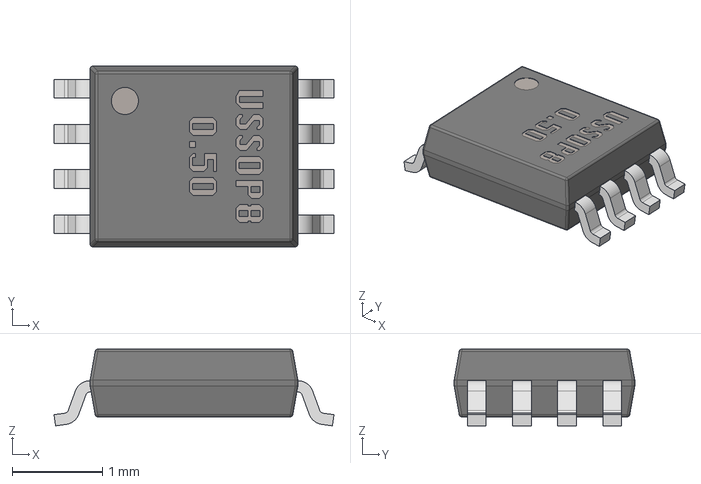
[picture p96: CAD file, 2018-03-31]
kicad-resources/kicad-librarys/thirdparty-3D/web/3D-shapes/SMD_SMDx_others/VSSOP8-8P-0.50_wLABEL.stp
3.10 x 2.00 x 0.85 mm
