Jonathon-Reilly/Kicad/kicad-resources/kicad-librarys/thirdparty-3D/web/3D-shapes/SMD_SODx-series/SOD123F.stp

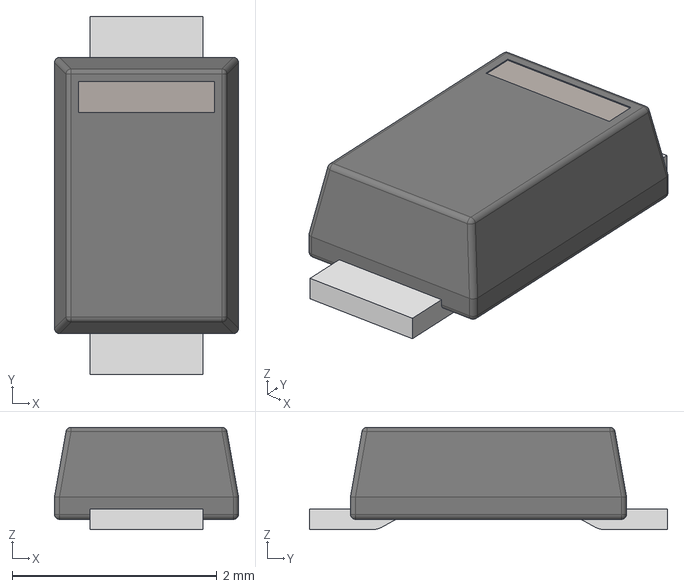
[picture p97: CAD file, 2018-03-31]
kicad-resources/kicad-librarys/thirdparty-3D/web/3D-shapes/SMD_SODx-series/SOD123F.stp
1.80 x 3.50 x 1.00 mm
