Jonathon-Reilly/Kicad/kicad-resources/kicad-librarys/thirdparty-3D/web/3D-shapes/SMD_SOTx-series/SOT89-5.stp

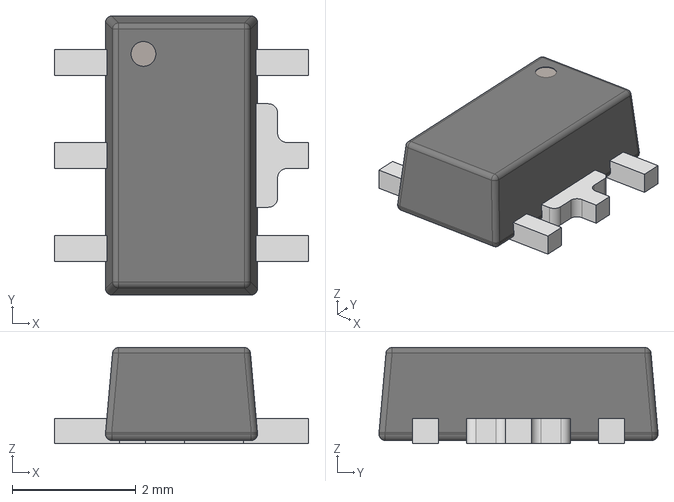
[picture p98: CAD file, 2018-03-31]
kicad-resources/kicad-librarys/thirdparty-3D/web/3D-shapes/SMD_SOTx-series/SOT89-5.stp
4.10 x 4.50 x 1.55 mm
