Jonathon-Reilly/Kicad/kicad-resources/kicad-librarys/thirdparty-3D/web/3D-shapes/Transformers/EFD20-10-7_8pin_pitch5mm.stp

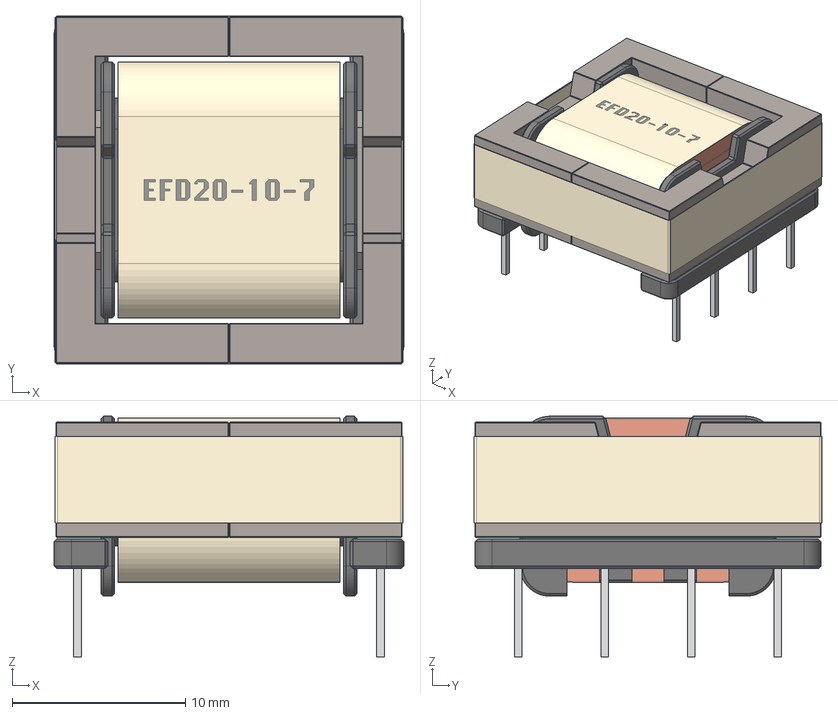
[picture p99: CAD file, 2018-03-31]
kicad-resources/kicad-librarys/thirdparty-3D/web/3D-shapes/Transformers/EFD20-10-7_8pin_pitch5mm.stp
20.2 x 20.1 x 13.9 mm
