Jonathon-Reilly/Kicad/kicad-resources/kicad-librarys/o_shovah-3D/JST-PA-[JS]/B09B-PASK-1.STEP

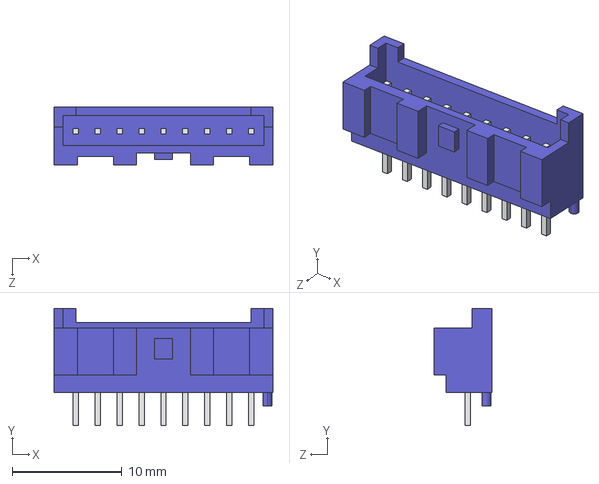
[picture p101: CAD file, 2017-10-18]
kicad-resources/kicad-librarys/o_shovah-3D/JST-PA-[JS]/B09B-PASK-1.STEP
20.0 x 10.7 x 5.30 mm
