Jonathon-Reilly/Kicad/kicad-resources/kicad-librarys/thirdparty-3D/web/3D-shapes/SMD_Devices/Switch.stp

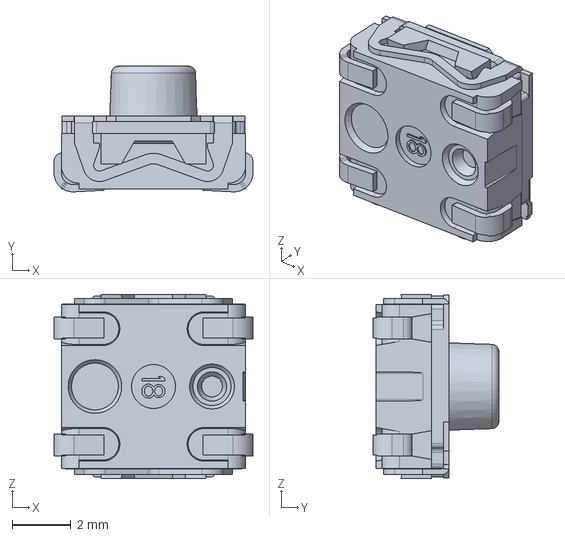
[picture p107: CAD file, 2018-03-06]
kicad-resources/kicad-librarys/thirdparty-3D/web/3D-shapes/SMD_Devices/Switch.stp
6.80 x 4.30 x 6.30 mm
