Jonathon-Reilly/Kicad/kicad-resources/kicad-librarys/thirdparty-3D/web/3D-shapes/SMD_SODx-series/SOD123_wLABEL.stp

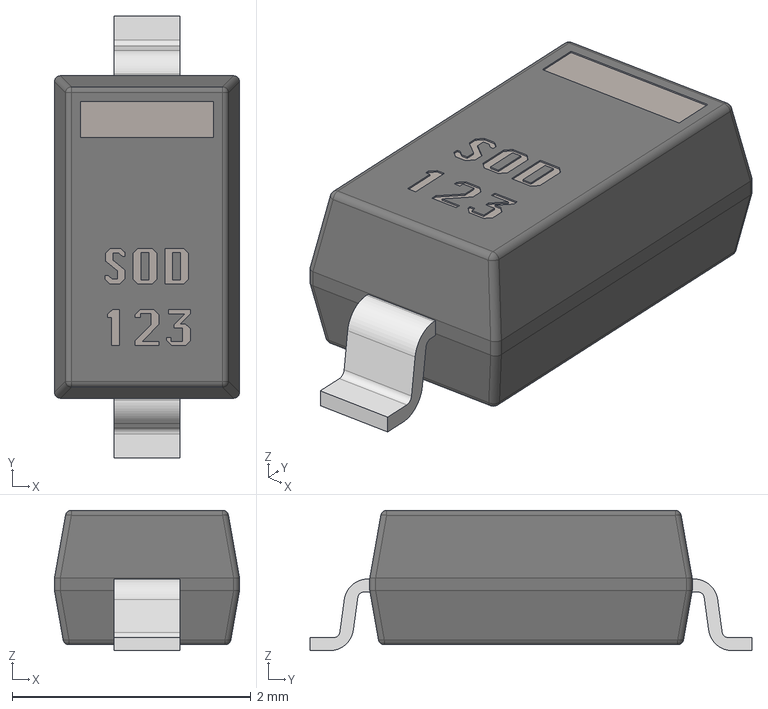
[picture p109: CAD file, 2018-03-31]
kicad-resources/kicad-librarys/thirdparty-3D/web/3D-shapes/SMD_SODx-series/SOD123_wLABEL.stp
1.55 x 3.70 x 1.18 mm
