Jonathon-Reilly/Kicad/kicad-resources/kicad-librarys/o_shovah-3D/JST-PA-[JS]/B03B-PASK-1.STEP

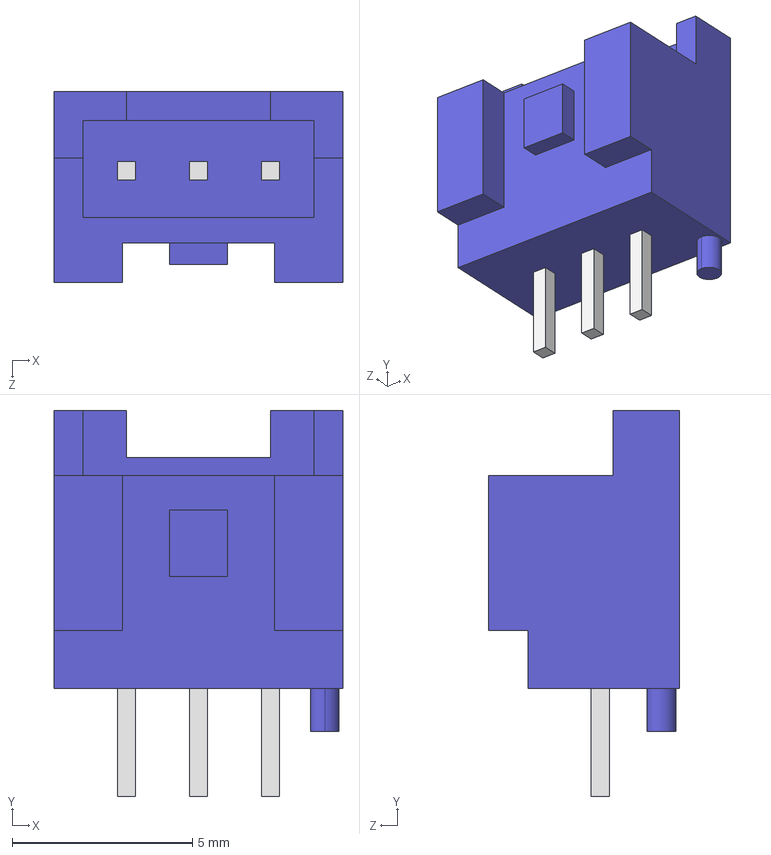
[picture p113: CAD file, 2017-10-18]
kicad-resources/kicad-librarys/o_shovah-3D/JST-PA-[JS]/B03B-PASK-1.STEP
8.00 x 10.7 x 5.30 mm
