Jonathon-Reilly/Kicad/kicad-resources/kicad-librarys/thirdparty-3D/web/3D-shapes/Transformers/EFD15-8-5_10pin_pitch3mm.stp

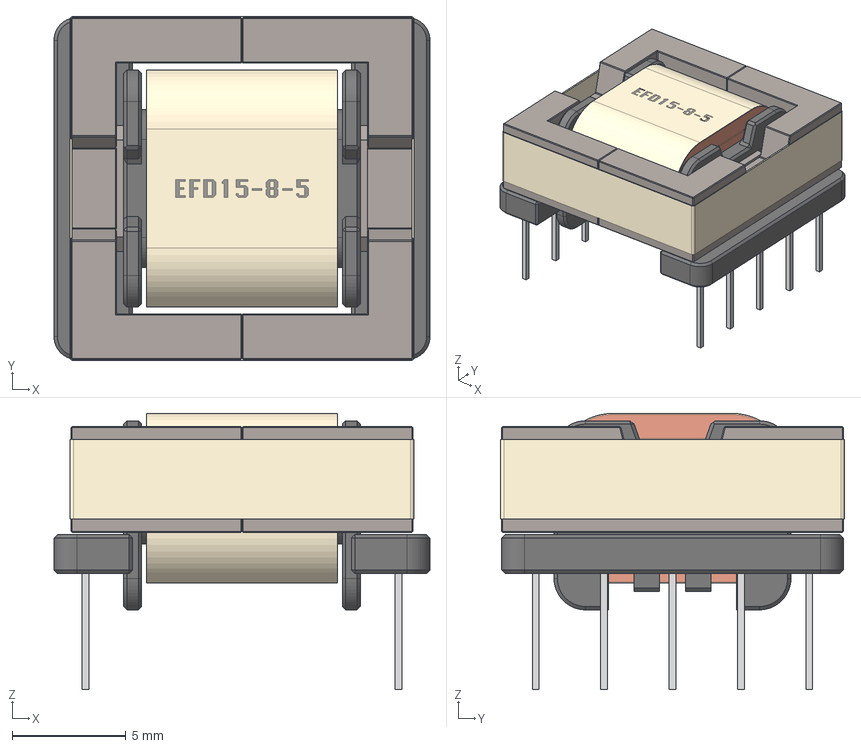
[picture p121: CAD file, 2018-03-31]
kicad-resources/kicad-librarys/thirdparty-3D/web/3D-shapes/Transformers/EFD15-8-5_10pin_pitch3mm.stp
16.5 x 15.1 x 12.1 mm
