Jonathon-Reilly/Kicad/kicad-resources/kicad-librarys/thirdparty-3D/web/3D-shapes/Transformers/RM-12-LP_12pin.stp

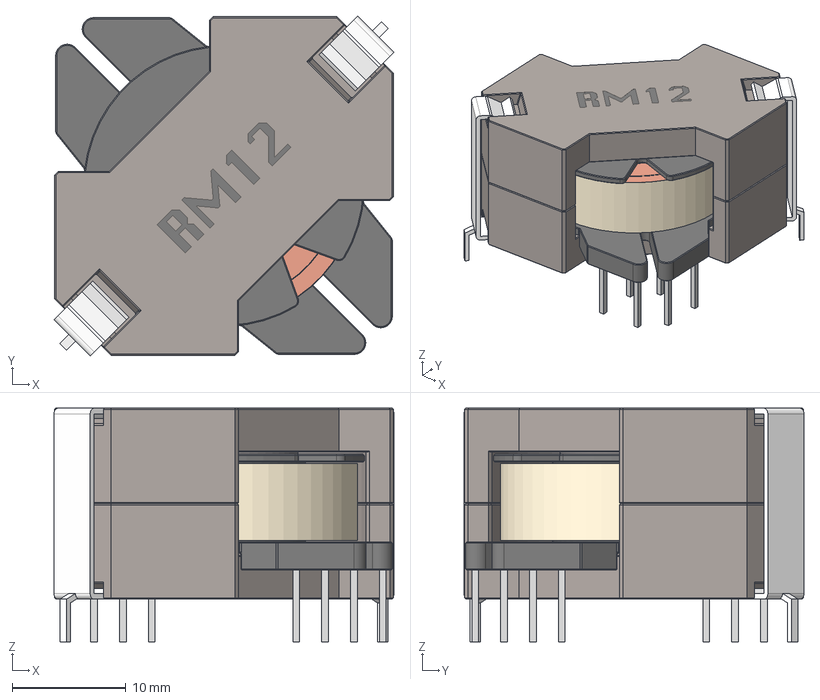
[picture p131: CAD file, 2018-03-31]
kicad-resources/kicad-librarys/thirdparty-3D/web/3D-shapes/Transformers/RM-12-LP_12pin.stp
29.9 x 29.9 x 20.6 mm
