Jonathon-Reilly/Kicad/kicad-resources/kicad-librarys/o_shovah-3D/JST-PA-[JS]/B02B-PAFYK-1A.STEP

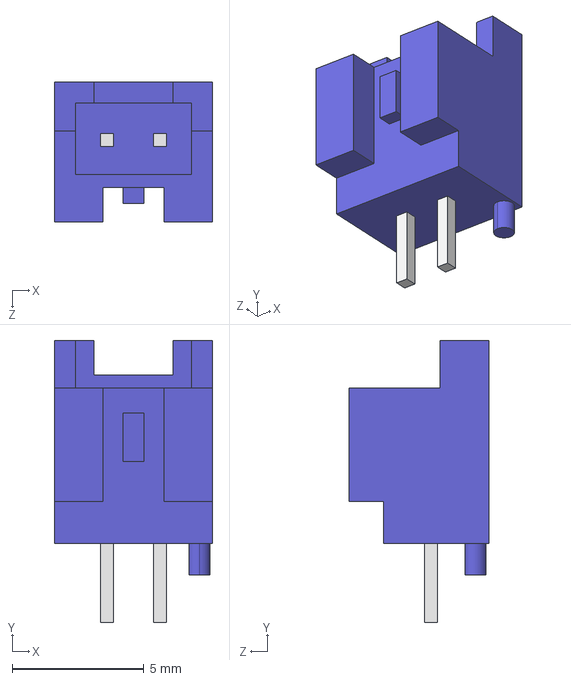
[picture p133: CAD file, 2017-10-13]
kicad-resources/kicad-librarys/o_shovah-3D/JST-PA-[JS]/B02B-PAFYK-1A.STEP
6.00 x 10.7 x 5.30 mm
