Jonathon-Reilly/Kicad/kicad-resources/kicad-librarys/thirdparty-3D/web/3D-shapes/SMD_SMDx_others/1212-8-PowerPAK_wLABEL.stp

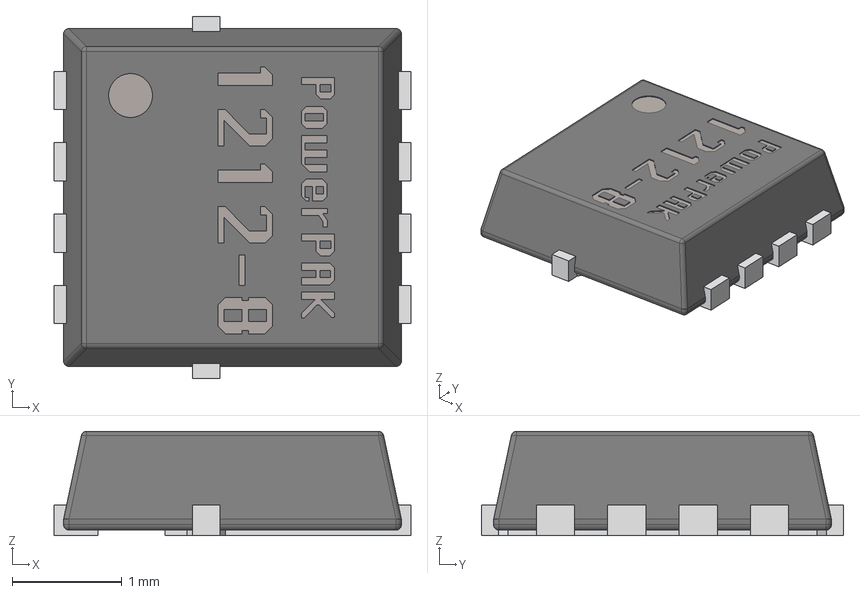
[picture p139: CAD file, 2018-03-31]
kicad-resources/kicad-librarys/thirdparty-3D/web/3D-shapes/SMD_SMDx_others/1212-8-PowerPAK_wLABEL.stp
3.25 x 3.30 x 0.95 mm
