Jonathon-Reilly/Kicad/kicad-resources/kicad-librarys/thirdparty-3D/web/3D-shapes/Transformers/EFD25-13-9_12pin_pitch4mm.stp

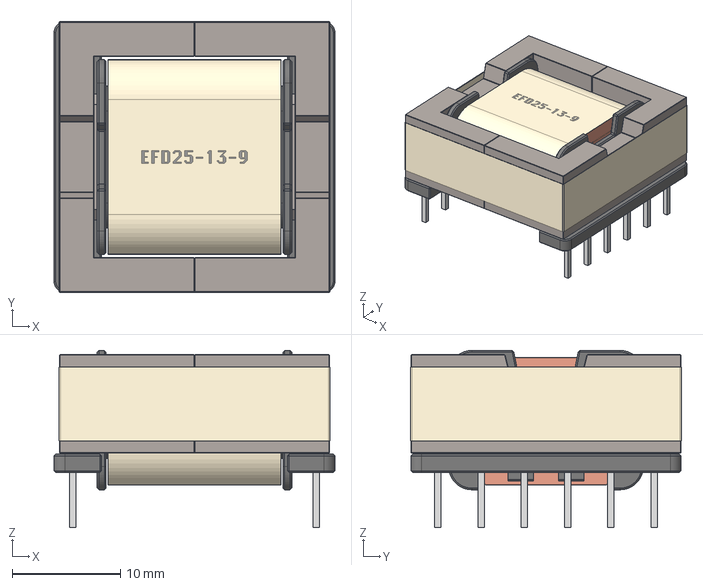
[picture p140: CAD file, 2018-03-31]
kicad-resources/kicad-librarys/thirdparty-3D/web/3D-shapes/Transformers/EFD25-13-9_12pin_pitch4mm.stp
26.0 x 25.1 x 16.4 mm
