Jonathon-Reilly/Kicad/kicad-resources/kicad-librarys/o_shovah-3D/JST-PA-[JS]/B04B-PASK-1.STEP

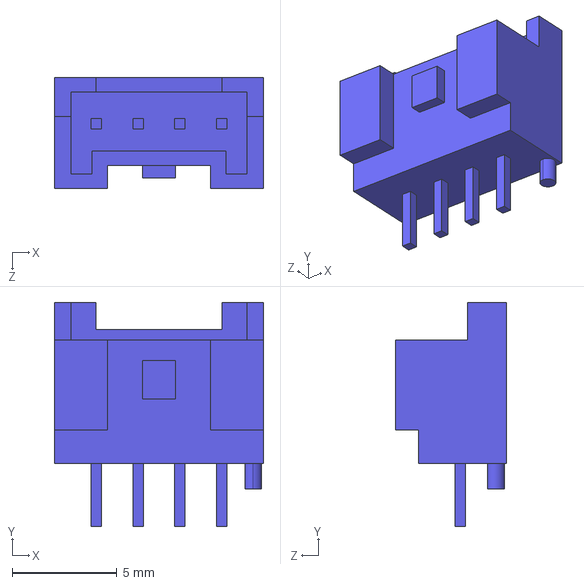
[picture p142: CAD file, 2017-10-13]
kicad-resources/kicad-librarys/o_shovah-3D/JST-PA-[JS]/B04B-PASK-1.STEP
10.0 x 10.7 x 5.30 mm
