Jonathon-Reilly/Kicad/(list of files, cad)

Other CAD files:
kicad-resources/kicad-librarys/o_shovah-3D/inductors_[JS]/SRP1265A.stp
kicad-resources/kicad-librarys/thirdparty-3D/web/3D-shapes/Displays/Display_TJCTM24028-SPI_wLABEL.stp
kicad-resources/kicad-librarys/thirdparty-3D/web/3D-shapes/SMD_DCDC-converters/RECOM_R-78AAxx0.5-SMD.stp
kicad-resources/kicad-librarys/thirdparty-3D/web/3D-shapes/SMD_SMDx_others/D2PAK-3.stp
kicad-resources/kicad-librarys/o_shovah-3D/connectors-[JS]/HFW_10_R-2ST_LF.step
kicad-resources/kicad-librarys/thirdparty-3D/web/3D-shapes/SMD_SMx-series/SMC_wLABEL.stp
kicad-resources/kicad-librarys/thirdparty-3D/web/3D-shapes/SMD_SODx-series/SOD323_wLABEL.stp
kicad-resources/kicad-librarys/thirdparty-3D/web/3D-shapes/SMD_SMx-series/SMB.stp
kicad-resources/kicad-librarys/thirdparty-3D/web/3D-shapes/SMD_SMx-series/SMA_wLABEL.stp
kicad-resources/kicad-librarys/thirdparty-3D/web/3D-shapes/SMD_SMDx_others/DPAK-3_wLABEL.stp
kicad-resources/kicad-librarys/thirdparty-3D/web/3D-shapes/SMD_SODx-series/SOD523.stp
kicad-resources/kicad-librarys/thirdparty-3D/web/3D-shapes/SMD_SODx-series/SOD123.stp
kicad-resources/kicad-librarys/thirdparty-3D/web/3D-shapes/SMD_SOTx-series/SOT23-4_wLABEL.stp
kicad-resources/kicad-librarys/o_shovah-3D/con-lumberg/lumberg_2_5_msf_03.stp
kicad-resources/kicad-librarys/o_shovah-3D/con-lumberg/lumberg_2_5_msf_04.stp
kicad-resources/kicad-librarys/o_shovah-3D/con-lumberg/lumberg_2_5_msf_05.stp
kicad-resources/kicad-librarys/o_shovah-3D/con-lumberg/lumberg_2_5_msf_07.stp
kicad-resources/kicad-librarys/o_shovah-3D/con-lumberg/lumberg_2_5_msf_08.stp
kicad-resources/kicad-librarys/o_shovah-3D/con-lumberg/lumberg_2_5_msf_09.stp
kicad-resources/kicad-librarys/o_shovah-3D/con-lumberg/lumberg_2_5_msf_10.stp
kicad-resources/kicad-librarys/o_shovah-3D/con-lumberg/lumberg_2_5_msf_11.stp
kicad-resources/kicad-librarys/o_shovah-3D/con-lumberg/lumberg_2_5_msf_12.stp
kicad-resources/kicad-librarys/o_shovah-3D/con-lumberg/lumberg_2_5_msf_o_02.stp
kicad-resources/kicad-librarys/o_shovah-3D/con-lumberg/lumberg_2_5_msf_o_03.stp
kicad-resources/kicad-librarys/o_shovah-3D/con-lumberg/lumberg_2_5_msf_o_04.stp
kicad-resources/kicad-librarys/o_shovah-3D/con-lumberg/lumberg_2_5_msf_o_07.stp
kicad-resources/kicad-librarys/o_shovah-3D/con-lumberg/lumberg_2_5_msf_o_08.stp
kicad-resources/kicad-librarys/o_shovah-3D/con-lumberg/lumberg_2_5_msf_o_09.stp
kicad-resources/kicad-librarys/o_shovah-3D/con-lumberg/lumberg_2_5_msf_o_10.stp
kicad-resources/kicad-librarys/o_shovah-3D/con-lumberg/lumberg_2_5_msf_o_12.stp
kicad-resources/kicad-librarys/o_shovah-3D/con-lumberg/lumberg_2_5_msf_o_14.stp
kicad-resources/kicad-librarys/o_shovah-3D/con-lumberg/lumberg_2_5_msfw_o_02.stp
kicad-resources/kicad-librarys/o_shovah-3D/con-lumberg/lumberg_2_5_msfw_o_04.stp
kicad-resources/kicad-librarys/o_shovah-3D/con-lumberg/lumberg_2_5_msfw_o_05.stp
kicad-resources/kicad-librarys/o_shovah-3D/con-lumberg/lumberg_2_5_msfw_o_06.stp
kicad-resources/kicad-librarys/o_shovah-3D/con-lumberg/lumberg_2_5_msfw_o_07.stp
kicad-resources/kicad-librarys/o_shovah-3D/con-lumberg/lumberg_2_5_msfw_o_09.stp
kicad-resources/kicad-librarys/o_shovah-3D/connectors-[JS]/694106106102.step
kicad-resources/kicad-librarys/o_shovah-3D/devices_[JS]/D2F-01FL-A.step
kicad-resources/kicad-librarys/o_shovah-3D/devices_[JS]/D2F-01FL.step
kicad-resources/kicad-librarys/thirdparty-3D/web/3D-shapes/Conn_HRSE-SH12-xP-0.5-BOT/Conn_HRSE-SH12-11P-0.5-BOT.stp
kicad-resources/kicad-librarys/thirdparty-3D/web/3D-shapes/Conn_HRSE-SH12-xP-0.5-BOT/Conn_HRSE-SH12-14P-0.5-BOT.stp
kicad-resources/kicad-librarys/thirdparty-3D/web/3D-shapes/Conn_HRSE-SH12-xP-0.5-BOT/Conn_HRSE-SH12-16P-0.5-BOT.stp
kicad-resources/kicad-librarys/thirdparty-3D/web/3D-shapes/Conn_HRSE-SH12-xP-0.5-BOT/Conn_HRSE-SH12-17-0.5-BOT.stp
kicad-resources/kicad-librarys/thirdparty-3D/web/3D-shapes/Conn_HRSE-SH12-xP-0.5-BOT/Conn_HRSE-SH12-19P-0.5-BOT.stp
kicad-resources/kicad-librarys/thirdparty-3D/web/3D-shapes/Conn_HRSE-SH12-xP-0.5-BOT/Conn_HRSE-SH12-20P-0.5-BOT.stp
kicad-resources/kicad-librarys/thirdparty-3D/web/3D-shapes/Conn_HRSE-SH12-xP-0.5-BOT/Conn_HRSE-SH12-24P-0.5-BOT.stp
kicad-resources/kicad-librarys/thirdparty-3D/web/3D-shapes/Conn_HRSE-SH12-xP-0.5-BOT/Conn_HRSE-SH12-26P-0.5-BOT.stp
kicad-resources/kicad-librarys/thirdparty-3D/web/3D-shapes/Conn_HRSE-SH12-xP-0.5-BOT/Conn_HRSE-SH12-28P-0.5-BOT.stp
kicad-resources/kicad-librarys/thirdparty-3D/web/3D-shapes/Conn_HRSE-SH12-xP-0.5-BOT/Conn_HRSE-SH12-30P-0.5-BOT.stp
kicad-resources/kicad-librarys/thirdparty-3D/web/3D-shapes/Conn_HRSE-SH12-xP-0.5-BOT/Conn_HRSE-SH12-32P-0.5-BOT.stp
kicad-resources/kicad-librarys/thirdparty-3D/web/3D-shapes/Conn_HRSE-SH12-xP-0.5-BOT/Conn_HRSE-SH12-34P-0.5-BOT.stp
kicad-resources/kicad-librarys/thirdparty-3D/web/3D-shapes/Conn_HRSE-SH12-xP-0.5-BOT/Conn_HRSE-SH12-35P-0.5-BOT.stp
kicad-resources/kicad-librarys/thirdparty-3D/web/3D-shapes/Conn_HRSE-SH12-xP-0.5-BOT/Conn_HRSE-SH12-36P-0.5-BOT.stp
kicad-resources/kicad-librarys/thirdparty-3D/web/3D-shapes/Conn_HRSE-SH12-xP-0.5-BOT/Conn_HRSE-SH12-45P-0.5-BOT.stp
kicad-resources/kicad-librarys/thirdparty-3D/web/3D-shapes/Conn_HRSE-SH12-xP-0.5-BOT/Conn_HRSE-SH12-50P-0.5-BOT.stp
kicad-resources/kicad-librarys/thirdparty-3D/web/3D-shapes/Conn_HRSE-SH12-xP-0.5-BOT/Conn_HRSE-SH12-8P-0.5-BOT.stp
kicad-resources/kicad-librarys/thirdparty-3D/web/3D-shapes/Conn_JST-PH-xP-2.0-TOPandSIDE/Conn_PH-2.0_12P_TOP.stp
kicad-resources/kicad-librarys/thirdparty-3D/web/3D-shapes/Conn_JST-PH-xP-2.0-TOPandSIDE/Conn_PH-2.0_14P_TOP.stp
kicad-resources/kicad-librarys/thirdparty-3D/web/3D-shapes/Conn_JST-PH-xP-2.0-TOPandSIDE/Conn_PH-2.0_15P_TOP.stp
kicad-resources/kicad-librarys/thirdparty-3D/web/3D-shapes/Conn_JST-PH-xP-2.0-TOPandSIDE/Conn_PH-2.0_16P_TOP.stp
kicad-resources/kicad-librarys/thirdparty-3D/web/3D-shapes/Conn_JST-PH-xP-2.0-TOPandSIDE/Conn_PH-2.0_5P_TOP.stp
kicad-resources/kicad-librarys/thirdparty-3D/web/3D-shapes/Conn_JST-PH-xP-2.0-TOPandSIDE/Conn_PH-2.0_7P_TOP.stp
kicad-resources/kicad-librarys/thirdparty-3D/web/3D-shapes/Conn_JST-SH-xP-1.0-TOPandSIDE/Conn_JST-SH-10P-1.0-SIDE.stp
kicad-resources/kicad-librarys/thirdparty-3D/web/3D-shapes/Conn_JST-SH-xP-1.0-TOPandSIDE/Conn_JST-SH-11P-1.0-TOP.stp
kicad-resources/kicad-librarys/thirdparty-3D/web/3D-shapes/Conn_JST-SH-xP-1.0-TOPandSIDE/Conn_JST-SH-12P-1.0-SIDE.stp
kicad-resources/kicad-librarys/thirdparty-3D/web/3D-shapes/Conn_JST-SH-xP-1.0-TOPandSIDE/Conn_JST-SH-13P-1.0-SIDE.stp
kicad-resources/kicad-librarys/thirdparty-3D/web/3D-shapes/Conn_JST-SH-xP-1.0-TOPandSIDE/Conn_JST-SH-13P-1.0-TOP.stp
kicad-resources/kicad-librarys/thirdparty-3D/web/3D-shapes/Conn_JST-SH-xP-1.0-TOPandSIDE/Conn_JST-SH-14P-1.0-SIDE.stp
kicad-resources/kicad-librarys/thirdparty-3D/web/3D-shapes/Conn_JST-SH-xP-1.0-TOPandSIDE/Conn_JST-SH-14P-1.0-TOP.stp
kicad-resources/kicad-librarys/thirdparty-3D/web/3D-shapes/Conn_JST-SH-xP-1.0-TOPandSIDE/Conn_JST-SH-15P-1.0-SIDE.stp
kicad-resources/kicad-librarys/thirdparty-3D/web/3D-shapes/Conn_JST-SH-xP-1.0-TOPandSIDE/Conn_JST-SH-2P-1.0-SIDE.stp
kicad-resources/kicad-librarys/thirdparty-3D/web/3D-shapes/Conn_JST-SH-xP-1.0-TOPandSIDE/Conn_JST-SH-2P-1.0-TOP.stp
kicad-resources/kicad-librarys/thirdparty-3D/web/3D-shapes/Conn_JST-SH-xP-1.0-TOPandSIDE/Conn_JST-SH-3P-1.0-SIDE.stp
kicad-resources/kicad-librarys/thirdparty-3D/web/3D-shapes/Conn_JST-SH-xP-1.0-TOPandSIDE/Conn_JST-SH-3P-1.0-TOP.stp
kicad-resources/kicad-librarys/thirdparty-3D/web/3D-shapes/Conn_JST-SH-xP-1.0-TOPandSIDE/Conn_JST-SH-5P-1.0-TOP.stp
kicad-resources/kicad-librarys/thirdparty-3D/web/3D-shapes/Conn_JST-SH-xP-1.0-TOPandSIDE/Conn_JST-SH-7P-1.0-SIDE.stp
kicad-resources/kicad-librarys/thirdparty-3D/web/3D-shapes/Conn_JST-SH-xP-1.0-TOPandSIDE/Conn_JST-SH-7P-1.0-TOP.stp
kicad-resources/kicad-librarys/thirdparty-3D/web/3D-shapes/Conn_JST-SH-xP-1.0-TOPandSIDE/Conn_JST-SH-8P-1.0-SIDE.stp
kicad-resources/kicad-librarys/thirdparty-3D/web/3D-shapes/Conn_JST-SH-xP-1.0-TOPandSIDE/Conn_JST-SH-8P-1.0-TOP.stp
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
