Jonathon-Reilly/Kicad/kicad-resources/kicad-tools/eagle-to-kicad/examples/OLINUXINO/iMX233-OLinuXino-NANO_Rev_B/kicad_files/iMX233-OLinuXino-NANO_Rev_B.kicad_pcb

## KiCad design kicad-resources/kicad-tools/eagle-to-kicad/examples/OLINUXINO/iMX233-OLinuXino-NANO_Rev_B/kicad_files/iMX233-OLinuXino-NANO_Rev_B.kicad_pcb (2017-08-08)

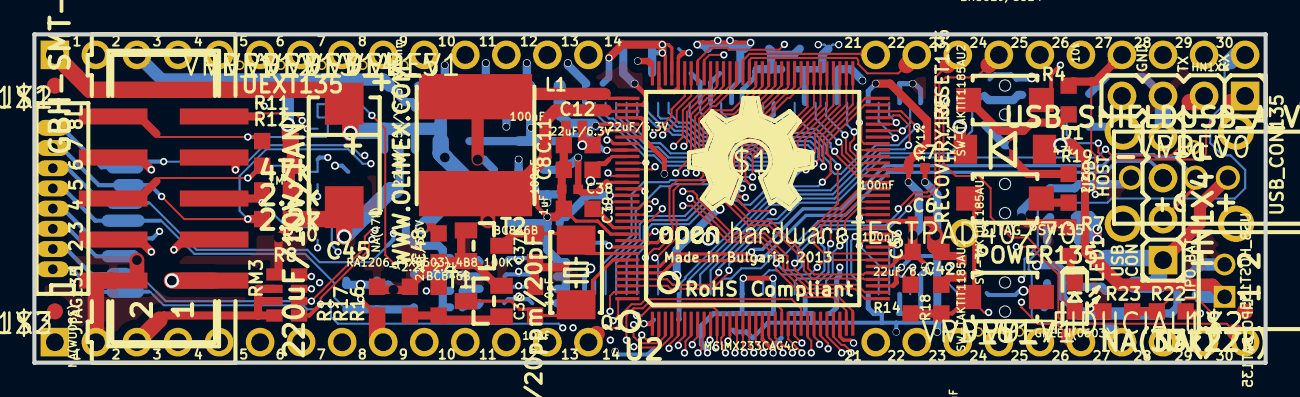
[picture p151: board iMX233-OLinuXino-NANO_Rev_B.kicad_pcb from above]

Board: 6 copper layers, 76.2 x 20.3 mm, 132 parts (0 on the bottom side), 136 nets.

Parts:
0, 3: Close; SJ_1_SMALLER
1, 2: Open; SJ_1_SMALLER
C1, C2, C3, C4, C5, C8, C9, C10, C11, C13, C15, C17, C26, C29, C31, C32, C40, C41, C43, C48, C49, C50, C51, C52, C53: 22uF/6.3V; C0603_DWS
C6, C7, C12, C14, C16, C18, C19, C20, C21, C22, C23, C24, C25, C27, C28, C30, C35, C38, C42: 100nF; C0402_TI
C33: NA(10pF); C0603_DWS
C34: 100pF; C0603_DWS
C36, C37: 10pF; C0603_DWS
C39: 1uF; C0603_DWS
C44: 47pF; C0603_DWS
C45: 220uF/10V/TANT; CT7343
C47: 100nF; C0603_DWS
CH/CS135: SCL_HW:Open/SCL_SW:Close; SJ_2_SMALLER
CON1, CON2: HN1X30_WITHOUT(15-20)
CSS/CSH135: CS_SW:Open/CS_HW:Close; SJ_2_SMALLER
D1: 1N5819/SS14; MLL-41
D2: BAT54C; SOT23C
D3: SMBJ6.0A; DO214AA
DH/DS135: SDA_HW:Open/SDA_SW:Close; SJ_2_SMALLER
JTAG135: NA(WU08S); WU08S
L1: 22uH/1.5A/YS75/7x8mm; L7078
L2: CL470nH/0805/1.76R/250mA; L0805_5MIL_DWS
L3: FB0805/600R/2A; L0805_5MIL_DWS
L4: FB0805/600R/200mA(201209-601); L0805_5MIL_DWS
LED1: GREEN(0603); LED-0603
LIPO_BAT135: CON2DW02R; DW02R
POWER135: SW-TAKTIT1185AU2; IT1185AU2
Q1: 4SB24.000F20E15/5x3.2mm/20ppm/20pF; HCX-4S
R1: NA(47k); R0603_5MIL_DWS
R2, R9, R19, R20, R21: 10k; R0603_5MIL_DWS
R3: NA(120R); R0603_5MIL_DWS
R4, R11: 47k; R0603_5MIL_DWS
R5, R6, R14, R18: 1k/1%; R0603_5MIL_DWS
R7, R10, R12, R16, R17: 2.2k; R0603_5MIL_DWS
R8: 1M; R0603_5MIL_DWS
R13: 4.7k; R0603_5MIL_DWS
R15: 0R(Board_Mounted); 0603_0R
R22: NA(22k); R0603_5MIL_DWS
R23: NA(33k); R0603_5MIL_DWS
RECOVERY135: SW-TAKTIT1185AU2; IT1185AU2
RESET135: SW-TAKTIT1185AU2; IT1185AU2
RM1: RA1206_(4X0603)_4B8_4.7K; R_MATRIX_4
RM2: RA1206_(4X0603)_4B8_47K; R_MATRIX_4
RM3: RA1206_(4X0603)_4B8_100K; R_MATRIX_4
SD135: MICRO_SD/MMC_NEW; TFR%2fC-MEM-CON
SJTAG_PSW135: TESTPAD40/70; TESTPAD
T1, T2: BC846B; SOT23
U1: HY5DU121622D(L)T(P)-J; 66TSOP-II
U2: MCIMX233CAG4C; TQFP128LD
U3: SY6280; SOT23-5
U$1, U$2, U$3, U$7, U$13, U$14: FIDUCIAL1X2; FIDUCIAL-1X2
U$4: ESD_SYMBOL
U$6: RECYCLE_BIN1%2f8
U$8: OLIMEX1_V
U$15: PB
U$18: LOGO-OPENHARDWARE_8X8
UEXT135: GBH-SMT-10; ML10_S
USB_CON135: HN1X4
USB_HOST135: USB_SHIELDUSB_A_VERTICAL; USB_A_VERTICAL_PTH
U_DEBUG135: HN1X4
VP_0: VPDEV0; VPAC0
VP_1, VP_2, VP_3, VP_4, VP_5, VP_6, VP_7: VPDEV1; VPAC1
VR1: AP1231-33; SOT-23-5

Connections:
+5V: C11.2, C12.2, C45.+, C47.1, C48.1, C49.1, C50.1, CON2.1, D3.C, R22.2, U2.102, U3.5, VR1.1, VR1.3
+24V: C29.2, C31.2, C32.2, C43.1, CON1.1, D1.A, LIPO_BAT135.1, U2.100, U2.103
/+5V_HOST_PWR: C52.1, C53.1, L3.1, USB_CON135.1, USB_HOST135.1
/A0: U1.29, U2.76
/A1: U1.30, U2.75
/A2: U1.31, U2.74
/A3: U1.32, U2.73
/A4: U1.35, U2.72
/A5: U1.36, U2.71
/A6: U1.37, U2.70
/A7: U1.38, U2.69
/A8: U1.39, U2.68
/A9: U1.40, U2.67
/A10: U1.28, U2.66
/A11: U1.41, U2.65
/A12: U1.42, U2.64
/AUART1_RXD: U2.128, UEXT135.4
/AUART1_TXD: U2.127, UEXT135.3
/BA0: U1.26, U2.79
/BA1: U1.27, U2.80
/CASN: U1.22, U2.61
/CKE: U1.44, U2.78
/CLK: R3.2, U1.45, U2.36
/CLKN: R3.1, U1.46, U2.37
/CS: R2.1, U1.24, U2.63
/CS_UEXT: CSS/CSH135.1, U2.32
/CS_UEXT_GPIO: CSS/CSH135.2, R11.1, UEXT135.10
/D0: U1.2, U2.41
/D1: U1.4, U2.43
/D2: U1.5, U2.42
/D3: U1.7, U2.44
/D4: U1.8, U2.47
/D5: U1.10, U2.48
/D6: U1.11, U2.49
/D7: U1.13, U2.50
/D8: U1.54, U2.51
/D9: U1.56, U2.52
/D10: U1.57, U2.54
/D11: U1.59, U2.55
/D12: U1.60, U2.57
/D13: U1.62, U2.58
/D14: U1.63, U2.60
/D15: U1.65, U2.59
/DCDC_VDDA: C26.2, C27.2, C38.2, U2.96, U2.110
/DCDC_VDDD: C1.2, C2.2, C13.2, C14.2, U2.1, U2.93, U2.94
/DEBUG: U2.89, U_DEBUG135.4
/DQM0: U1.20, U2.46
/DQM1: U1.47, U2.56
/DQS0: U1.16, U2.39
/DQS1: U1.51, U2.40
/HPL: CON2.7, U2.113
/HPR: CON2.8, U2.109
/HP_VGND: CON2.9, U2.111
/I2C_SCL: CH/CS135.2, R10.1, UEXT135.5
/I2C_SDA: DH/DS135.2, R12.1, UEXT135.6
/LED1: LED1.A, U2.88
/LIN1_INL: CON2.10, U2.115
/LIN1_INR: CON2.11, U2.114
/N$1: POWER135.1, R15.1
/N$3: L3.2, U3.1
/N$6: R20.2, U3.3
/N$7: C28.2, C30.2, R5.1, R6.2, U1.49
/N$9: R19.1, RECOVERY135.1
/N$11: D2.3, U_DEBUG135.1
/N$18: C33.2, L1.2, U2.97
/N$19: C34.2, L1.1, U2.99
/N$25: C39.2, U2.117
/N$38: C42.1, R18.1
/N$42: LED1.C, R7.2
/N$43: R16.1, R17.1, T1.1
/N$101: 3.1, RM1.4.1
/N$103: 2.1, RM1.3.1
/N$104: 1.1, RM1.2.1
/N$105: 0.1, RM1.1.1
/N$266: L4.2, USB_HOST135.P$3, USB_HOST135.P$4
/PIN1/LCD_D00: CON1.4, RM1.1.2, RM2.1.1, U2.2
/PIN2/LCD_D01: CON1.5, RM1.2.2, RM2.2.1, U2.3
/PIN3/LCD_D02: CON1.6, RM1.3.2, RM2.3.1, U2.4
/PIN4/LCD_D03: CON1.7, RM1.4.2, RM2.4.1, U2.5
/PIN5/LCD_D04: CON1.8, U2.6
/PIN6/LCD_D05: CON1.9, R1.2, U2.7
/PIN7/LCD_D06: CON1.10, U2.8
/PIN8/LCD_D07: CON1.11, U2.9
/PIN9/LCD_D08/SSP2_MISO: CON1.12, U2.22, UEXT135.7
/PIN10/LCD_D09: CON1.13, U2.23
/PIN11/LCD_D10: CON1.14, U2.24
/PIN12/LCD_D11: CON1.21, CSS/CSH135.3, U2.25
/PIN13/LCD_D12: CON1.22, U2.27
/PIN14/LCD_D13: CON1.23, U2.26
/PIN15/LCD_D14: CON1.24, U2.29
/PIN16/LCD_D15: CON1.25, U2.28
/PIN17/LCD_D16: CON1.26, U2.19
/PIN18/LCD_D17/USB_EN: CON1.27, R21.2, U2.20, U3.4
/PIN19/LCD_DOTCLK: CON2.30, U2.17
/PIN20/LCD_VSYNC: CON1.28, U2.16
/PIN21/LCD_HSYNC/I2C_SDA: CON1.29, DH/DS135.1, U2.15
/PIN22/LCD_EN/I2C_SCL: CH/CS135.1, CON1.30, U2.11
/PIN23/LCD_DISP: CON2.29, U2.12
/PIN24/LCD_WR: CON2.28, U2.13
/PIN25/LCD_RS: CON2.27, R4.2, U2.14
/PIN26/LCD_CS: CON2.26, U2.10
/PIN27/PWM2: CON2.25, U2.91
/PIN28/SOFT_SDA: CON2.24, DH/DS135.3, U2.31
/PIN29/SOFT_SCL: CH/CS135.3, CON2.23, U2.34
/PIN30: CON2.22, R22.1, R23.2, U2.81
/PIN31: CON2.21, U2.82
/PIN32/LRADC1: CON2.14, U2.107
/PIN33/LRADC0: CON2.13, U2.108
/PIN34/MIC: CON2.12, U2.116
/PSWITCH: R14.1, U2.119
/PWM0/DUART_RXD: CON2.4, D2.2, R13.2, U2.125
/PWM1/DUART_TXD: CON2.5, U2.126, U_DEBUG135.2
/RASN: U1.23, U2.62
/RESET: R16.2, RESET135.1
/SD_VCC: C40.2, C41.2, JTAG135.5, L2.2, SD135.4
/SJTAG_PSW: POWER135.2, R14.2, R18.2, RECOVERY135.2, RM3.1.2, SJTAG_PSW135.P$1
/SSP1_CMD: JTAG135.6, R9.1, SD135.3, U2.83
/SSP1_DATA0: JTAG135.2, RM3.3.2, SD135.7, U2.84
/SSP1_DATA1: JTAG135.1, RM3.4.2, SD135.8, U2.85
/SSP1_DATA2: JTAG135.8, RM3.2.2, SD135.1, U2.86
/SSP1_DATA3: JTAG135.7, R8.1, SD135.2, U2.87
/SSP1_SCK: JTAG135.4, SD135.5, U2.90
/SSP2_MOSI: U2.21, UEXT135.8
/SSP2_SCK: U2.33, UEXT135.9
/USB_DM: U2.123, USB_CON135.2, USB_HOST135.2
/USB_DP: U2.124, USB_CON135.3, USB_HOST135.3
/VDAC1: C44.1, CON2.6, U2.104
/VDD4P2: C9.2, C10.2, D1.K, U2.101
/VDDXTAL: C35.2, R15.2, U2.120
/WEN: U1.21, U2.77
/XTALI: C36.2, Q1.2, T1.3, U2.122
/XTALO: C37.2, Q1.1, T2.3, U2.121
GND: C1.1, C2.1, C3.1, C4.1, C5.1, C6.1, C7.1, C8.1, C9.1, C10.1, C11.1, C12.1, C13.1, C14.1, C15.1, C16.1, C17.1, C18.1, C19.1, C20.1, C21.1, C22.1, C23.1, C24.1, C25.1, C26.1, C27.1, C29.1, C30.1, C31.1, C32.1, C33.1, C34.1, C35.1, C36.1, C37.1, C38.1, C39.1, C40.1, C41.1, C42.2, C43.2, C44.2, C45.-, C47.2, C48.2, C49.2, C50.2, C51.2, C52.2, C53.2, CON1.2, CON2.2, D3.A, JTAG135.3, L4.1, LIPO_BAT135.2, R1.1, R6.1, R7.1, R8.2, R17.2, R20.1, R21.1, R23.1, RM2.1.2, RM2.2.2, RM2.3.2, RM2.4.2, RM3.1.1, SD135.6, T1.2, T2.1, T2.2, U1.6, U1.12, U1.34, U1.48, U1.52, U1.58, U1.64, U1.66, U2.30, U2.35, U2.98, U2.105, U2.112, U2.118, U3.2, UEXT135.2, USB_CON135.4, USB_HOST135.4, U_DEBUG135.3, VP_0.VP, VP_1.VP, VP_2.VP, VP_3.VP, VP_4.VP, VP_5.VP, VP_6.VP, VP_7.VP, VR1.2
V+: C5.2, C6.2, C7.2, C8.2, C18.2, C19.2, C20.2, C21.2, C22.2, C23.2, C24.2, C25.2, C28.1, R2.2, R5.2, U1.1, U1.3, U1.9, U1.15, U1.18, U1.33, U1.55, U1.61, U2.38, U2.45, U2.53, U2.106
VCC: 0.2, 1.2, 2.2, 3.2, C3.2, C4.2, C15.2, C16.2, C17.2, CON1.3, L2.1, R4.1, R9.2, R13.1, R19.2, RESET135.2, RM3.2.1, RM3.3.1, RM3.4.1, U2.18, U2.92, U2.95
VPP: C51.1, CON2.3, R10.2, R11.2, R12.2, UEXT135.1, VR1.5
