Jonathon-Reilly/Kicad/kicad-resources/kicad-tools/eagle-to-kicad/examples/RGB_LED_1.4/kicad_files/RGB LED 1.4.kicad_pcb

## KiCad design kicad-resources/kicad-tools/eagle-to-kicad/examples/RGB_LED_1.4/kicad_files/RGB LED 1.4.kicad_pcb (2017-08-08)

Schematic: RGB LED 1.4.sch

Parts:
C1, C2, C3: 0.1uF; CAP-PTH-SMALL
IC1, IC2, IC3: TLC9450NT; DIL28-3
JP2: ARDUINO POWER; 1X06_LOCK
JP3: ARDUINO ANALOG; 1X06_LOCK
JP4: ARDUINO D13-8; 1X08_LOCK
JP5: ARDUINO D7-0; 1X08_LOCK
JP11: 1X02_LOCK
JP12, JP13: 1X05_LOCK
JP20, JP21: 1X04_LOCK
LED11, LED12, LED13, LED14, LED21, LED22, LED23, LED24, LED31, LED32, LED33, LED34, LED41, LED42, LED43, LED44: LED-TRICOLOR-THROUGHHOLE
R1, R2, R3: 2K; 0309_12
R4: 10K; 0309_12
SW1, SW2, SW3: TACTILE-PTH
SWRESET45: RESET; TACTILE-PTH

Connections:
B11: IC3.28 (OUT0), LED11.GRN
B12: IC3.1 (OUT1), LED12.GRN
B13: IC3.2 (OUT2), LED13.GRN
B14: IC3.3 (OUT3), LED14.GRN
B21: IC3.4 (OUT4), LED21.GRN
B22: IC3.5 (OUT5), LED22.GRN
B23: IC3.6 (OUT6), LED23.GRN
B24: IC3.7 (OUT7), LED24.GRN
B31: IC3.8 (OUT8), LED31.GRN
B32: IC3.9 (OUT9), LED32.GRN
B33: IC3.10 (OUT10), LED33.GRN
B34: IC3.11 (OUT11), LED34.GRN
B41: IC3.12 (OUT12), LED41.GRN
B42: IC3.13 (OUT13), LED42.GRN
B43: IC3.14 (OUT14), LED43.GRN
B44: IC3.15 (OUT15), LED44.GRN
BLANK: IC1.23 (BLANK), IC2.23 (BLANK), IC3.23 (BLANK), JP4.3, JP21.3, R4.1
G11: IC2.28 (OUT0), LED11.BLU
G12: IC2.1 (OUT1), LED12.BLU
G13: IC2.2 (OUT2), LED13.BLU
G14: IC2.3 (OUT3), LED14.BLU
G21: IC2.4 (OUT4), LED21.BLU
G22: IC2.5 (OUT5), LED22.BLU
G23: IC2.6 (OUT6), LED23.BLU
G24: IC2.7 (OUT7), LED24.BLU
G31: IC2.8 (OUT8), LED31.BLU
G32: IC2.9 (OUT9), LED32.BLU
G33: IC2.10 (OUT10), LED33.BLU
G34: IC2.11 (OUT11), LED34.BLU
G41: IC2.12 (OUT12), LED41.BLU
G42: IC2.13 (OUT13), LED42.BLU
G43: IC2.14 (OUT14), LED43.BLU
G44: IC2.15 (OUT15), LED44.BLU
GND: C1.2, C2.2, C3.2, IC1.22 (GND), IC1.27 (VPRG), IC2.22 (GND), IC2.27 (VPRG), IC3.22 (GND), IC3.27 (VPRG), JP2.3, JP20.2, R1.1, R2.1, R3.1, SW1.3, SW1.4, SW2.3, SW2.4, SW3.3, SW3.4, SWRESET45.3, SWRESET45.4
GSCLK: IC1.18 (GSCLK), IC2.18 (GSCLK), IC3.18 (GSCLK), JP5.4, JP21.4
unnamed: IC1.17 (SOUT), IC2.26 (SIN)
unnamed: IC2.17 (SOUT), IC3.26 (SIN)
unnamed: JP12.3, SW1.1, SW1.2
unnamed: IC3.20 (IREF), R3.2
unnamed: IC2.20 (IREF), R2.2
unnamed: IC1.20 (IREF), R1.2
unnamed: JP12.4, SW2.1, SW2.2
unnamed: JP12.5, SW3.1, SW3.2
R11: IC1.28 (OUT0), LED11.RED
R12: IC1.1 (OUT1), LED12.RED
R13: IC1.2 (OUT2), LED13.RED
R14: IC1.3 (OUT3), LED14.RED
R21: IC1.4 (OUT4), LED21.RED
R22: IC1.5 (OUT5), LED22.RED
R23: IC1.6 (OUT6), LED23.RED
R24: IC1.7 (OUT7), LED24.RED
R31: IC1.8 (OUT8), LED31.RED
R32: IC1.9 (OUT9), LED32.RED
R33: IC1.10 (OUT10), LED33.RED
R34: IC1.11 (OUT11), LED34.RED
R41: IC1.12 (OUT12), LED41.RED
R42: IC1.13 (OUT13), LED42.RED
R43: IC1.14 (OUT14), LED43.RED
R44: IC1.15 (OUT15), LED44.RED
RESET: JP2.6, SWRESET45.1, SWRESET45.2
SCLK: IC1.25 (SCLK), IC2.25 (SCLK), IC3.25 (SCLK), JP12.2, JP21.1
SCLK_DEF: JP4.6, JP13.2
SIN: IC1.26 (SIN), JP12.1
SIN_DEF: JP4.4, JP13.1
SOUT: IC3.17 (SOUT), JP20.3
SW1_DEF: JP5.3, JP13.3
SW2_DEF: JP5.5, JP13.4
SW3_DEF: JP5.8, JP13.5
VCC: C1.1, C2.1, C3.1, IC1.19 (DCPRG), IC1.21 (VCC), IC2.19 (DCPRG), IC2.21 (VCC), IC3.19 (DCPRG), IC3.21 (VCC), JP2.4, JP11.1, JP20.4, R4.2
VLED: JP11.2, JP20.1, LED11.GND (A), LED12.GND (A), LED13.GND (A), LED14.GND (A), LED21.GND (A), LED22.GND (A), LED23.GND (A), LED24.GND (A), LED31.GND (A), LED32.GND (A), LED33.GND (A), LED34.GND (A), LED41.GND (A), LED42.GND (A), LED43.GND (A), LED44.GND (A)
XLAT: IC1.24 (XLAT), IC2.24 (XLAT), IC3.24 (XLAT), JP4.2, JP21.2

Notes on the sheet:
HTINK RGB Shield 1.3
(C) 2009, Ben Combee
Creative Commons Attribution-Share Alike 3.0 License
http://combee.net/rgbshield
Allows connecting other voltage to LEDs

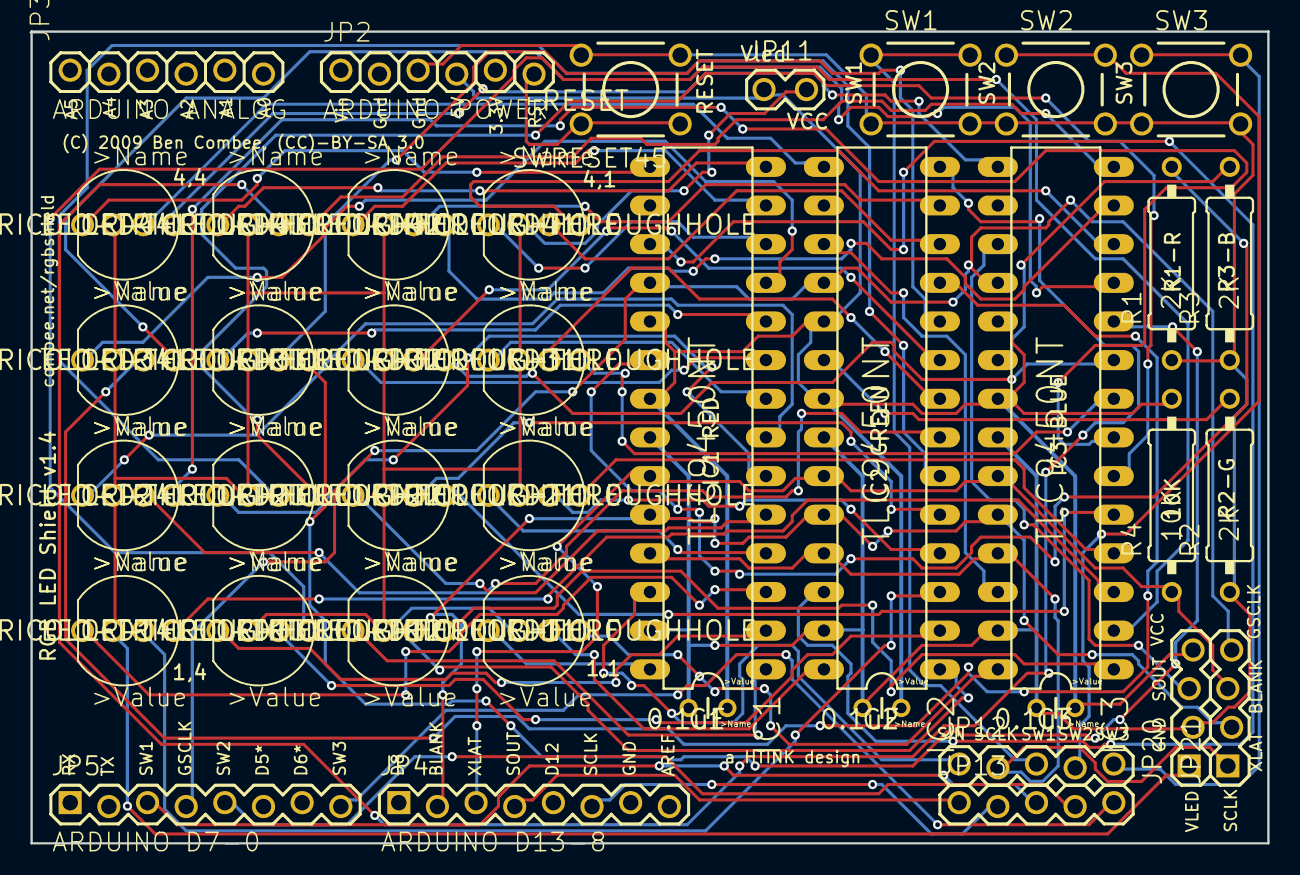
[picture p152: board RGB LED 1.4.kicad_pcb from above]

Board: 2 copper layers, 81.3 x 53.3 mm, 39 parts (0 on the bottom side), 71 nets.
