Jonathon-Reilly/Kicad/kicad-resources/kicad-tools/eagle-to-kicad/examples/OLINUXINO/iMX233-OLinuXino-Micro_Rev_D/kicad_files/iMX233-OLinuXino-Micro_Rev_D.kicad_pcb

## KiCad design kicad-resources/kicad-tools/eagle-to-kicad/examples/OLINUXINO/iMX233-OLinuXino-Micro_Rev_D/kicad_files/iMX233-OLinuXino-Micro_Rev_D.kicad_pcb (2017-08-08)

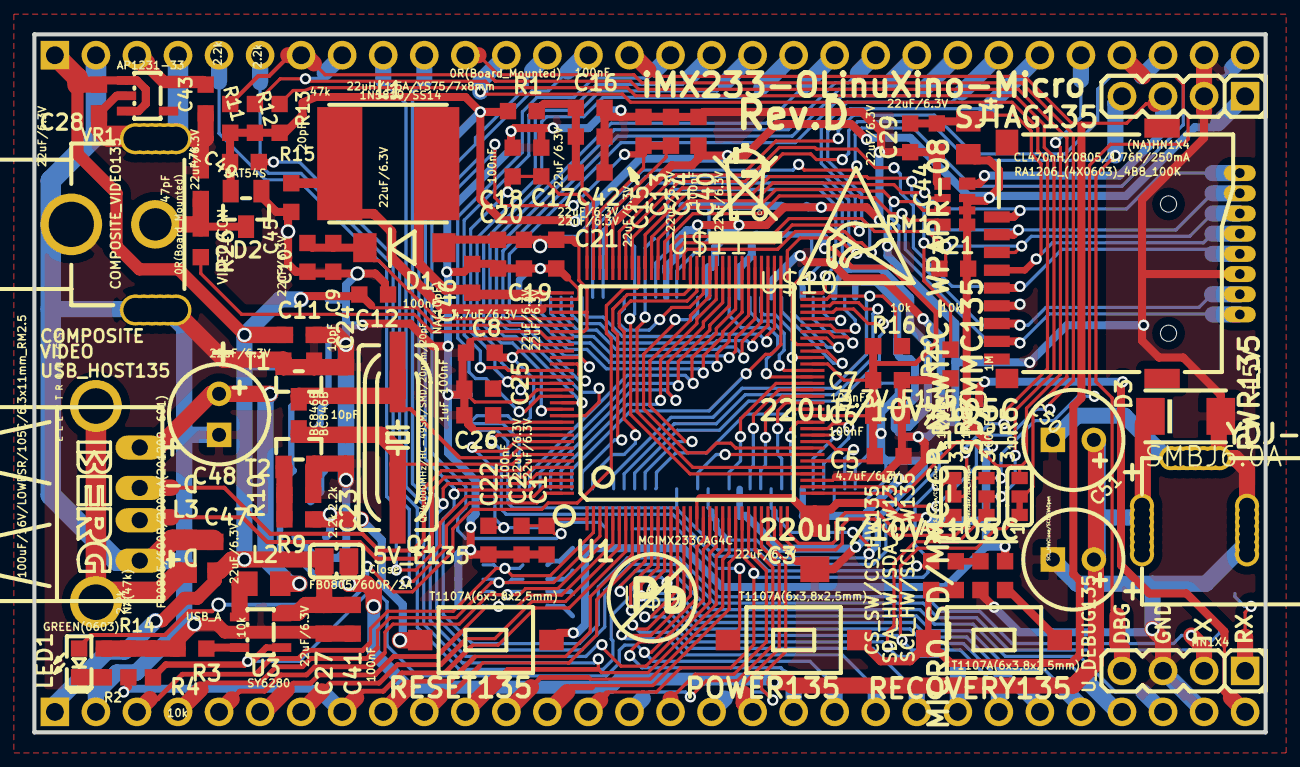
[picture p154: board iMX233-OLinuXino-Micro_Rev_D.kicad_pcb from above]

Board: 4 copper layers, 76.2 x 43.2 mm, 124 parts (0 on the bottom side), 143 nets.

Parts:
3.3V_E135: Open; SJ_1_SMALLER
5V_E135: Close; SJ-CLOSE
C1, C2, C9, C10, C11, C13, C15, C17, C19, C20, C21, C27, C28, C29, C40, C42, C43, C44, C47: 22uF/6.3V; C0603_DWS
C3: 22uF/6.3V; C1206
C4, C6, C7, C12, C14, C16, C18, C22, C25, C30, C31, C32, C33, C34, C35, C36, C37, C38, C39, C41: 100nF; C0603_DWS
C5, C8: 4.7uF/6.3V; C0603_DWS
C23, C24: 10pF; C0603_DWS
C26: 1uF; C0603_DWS
C45: 20pF; C0603_DWS
C46: NA(10pF); C0603_DWS
C48: 100uF/16V/LOWESR/105C/6.3x11mm_RM2.5; E2,5-6,3
C49: 47pF; C0603_DWS
C50, C51: 220uF/10V/105C; E2,5-6,3
COMPOSITE_VIDEO135: VIDEO_CON; VIDEO_CINCH
CON1, CON2: NA(HN1X30); HN1X30
CS_SW/CS_HW135: CS_SW:Open/CS_HW:Close; SJ_2_SMALL
D00_H135, D03_H135: Close; SJ_1_SMALLER
D1: 1N5819/SS14; MLL-41
D01_H135, D02_H135: Open; SJ_1_SMALLER
D2: BAT54S; SOT23C(BAT54S)
D3: SMBJ6.0A; DO214AA
D4: BAT54C; SOT23C
FET1: NA(IRLML6402); SOT23
JTAG135: NA(WU08S); WU08S
L1: 22uH/1.5A/YS75/7x8mm; L7078
L2: FB0805/600R/2A; L0805_5MIL_DWS
L3: FB0805/600R/200mA(201209-601); L0805_5MIL_DWS
L4: CL470nH/0805/1.76R/250mA; L0805_5MIL_DWS
LED1: GREEN(0603); LED-0603
POWER135: T1107A(6x3,8x2,5mm); SW-TAKT_6X3.5_SMD
PWR135: YDJ-1136; PWR_JACK_UNI_MILLING
Q1: Q24.000MHz/HC-49SM/SMD/20ppm/20pF; HC49%2fSMD2_THIN
R1, R6, R26: 0R(Board_Mounted); 0603_0R
R2, R9, R10, R11, R12: 2.2k; R0603_5MIL_DWS
R3, R4, R5, R16, R21: 10k; R0603_5MIL_DWS
R7, R8, R18, R19: 1k/1%; R0603_5MIL_DWS
R13, R15: 47k; R0603_5MIL_DWS
R14, R25: NA(47k); R0603_5MIL_DWS
R17: NA(120R); R0603_5MIL_DWS
R20: 1M; R0603_5MIL_DWS
R22: 4.7k; R0603_5MIL_DWS
RECOVERY135: T1107A(6x3,8x2,5mm); SW-TAKT_6X3.5_SMD
RESET135: T1107A(6x3,8x2,5mm); SW-TAKT_6X3.5_SMD
RM1: RA1206_(4X0603)_4B8_100K; R_MATRIX_4
RM2: RA1206_(4X0603)_4B8_47K; R_MATRIX_4
RM3: RA1206_(4X0603)_4B8_4.7K; R_MATRIX_4
SCL_HW/SCL_SW135: SCL_HW:Close/SCL_SW:Open; SJ_2_SMALL
SD/MMC135: MICRO_SD/MMC_CP_NEWTFC-WPAPR-08; TFC-WPAPR-08
SDA_HW/SDA_SW135: SDA_HW:Close/SDA_SW:Open; SJ_2_SMALL
SJTAG135: (NA)HN1X4; HN1X4
T1, T2: BC846B; SOT23
T3: NA(DTA114YKA); SOT-23
T4: NA(DTC114YKA); SOT-23
U1: MCIMX233CAG4C; TQFP128LD
U2: HY5DU121622D(L)T(P)-J; 66TSOP-II
U3: SY6280; SOT23-5
U$5: LOGO-OPENHARDWARE_8X8
U$8: OLIMEX1_V
U$9: PB
U$10: ESD_SYMBOL
U$11: RECYCLE_BIN1%2f8
U$12: ROHS
USB_HOST135: USB_A; USB_PN87520_HOST_PTH
U_DEBUG135: HN1X4
VR1: AP1231-33; SOT-23-5

Connections:
+5V: 5V_E135.2, C11.2, C12.2, C27.1, C28.1, C41.1, C47.1, CON1.1, CON2.1, FET1.3, U1.102, U3.5, VR1.1, VR1.3
+24V: C19.2, C20.2, C21.2, CON2.30, D1.A, U1.100, U1.103
/+5V_HOST_PWR: C48.+, L2.1, USB_HOST135.1
/A0: U1.76, U2.29
/A1: U1.75, U2.30
/A2: U1.74, U2.31
/A3: U1.73, U2.32
/A4: U1.72, U2.35
/A5: U1.71, U2.36
/A6: U1.70, U2.37
/A7: U1.69, U2.38
/A8: U1.68, U2.39
/A9: U1.67, U2.40
/A10: U1.66, U2.28
/A11: U1.65, U2.41
/A12: U1.64, U2.42
/AUART1_RXD: CON2.6, U1.128
/AUART1_TXD: CON2.5, U1.127
/BA0: U1.79, U2.26
/BA1: U1.80, U2.27
/CASN: U1.61, U2.22
/CKE: U1.78, U2.44
/CLK: R17.2, U1.36, U2.45
/CLKN: R17.1, U1.37, U2.46
/CS: R16.1, U1.63, U2.24
/CS_UEXT: CS_SW/CS_HW135.1, U1.32
/CS_UEXT_GPIO: CON2.12, CS_SW/CS_HW135.2, R13.1
/D0: U1.41, U2.2
/D1: U1.43, U2.4
/D2: U1.42, U2.5
/D3: U1.44, U2.7
/D4: U1.47, U2.8
/D5: U1.48, U2.10
/D6: U1.49, U2.11
/D7: U1.50, U2.13
/D8: U1.51, U2.54
/D9: U1.52, U2.56
/D10: U1.54, U2.57
/D11: U1.55, U2.59
/D12: U1.57, U2.60
/D13: U1.58, U2.62
/D14: U1.60, U2.63
/D15: U1.59, U2.65
/DCDC_VDDA: C17.2, C18.2, C25.2, U1.96, U1.110
/DCDC_VDDD: C1.2, C2.2, C13.2, C14.2, U1.1, U1.93, U1.94
/DCDC_VDDIO: C15.2, C16.2, C42.2, R1.2, U1.95
/DEBUG: SJTAG135.4, U1.89, U_DEBUG135.4
/DQM0: U1.46, U2.20
/DQM1: U1.56, U2.47
/DQS0: U1.39, U2.16
/DQS1: U1.40, U2.51
/HPL: CON2.16, U1.113
/HPR: CON2.17, U1.109
/HP_VGND: CON2.18, U1.111
/I2C_SCL: CON2.7, R11.1, SCL_HW/SCL_SW135.2
/I2C_SDA: CON2.8, R12.1, SDA_HW/SDA_SW135.2
/LED1: LED1.A, U1.88
/LIN1_INL: CON2.19, U1.115
/LIN1_INR: CON2.20, U1.114
/N$1: POWER135.P$1, R6.1
/N$2: 3.3V_E135.1, CON1.30
/N$3: 5V_E135.1, C50.+, C51.+, D3.C, FET1.2, PWR135.+, T3.2
/N$4: C49.1, COMPOSITE_VIDEO135.IO, D2.3, R26.2
/N$5: L2.2, U3.1
/N$6: R3.2, U3.3
/N$7: C38.2, C39.2, R18.1, R19.2, U2.49
/N$9: R5.1, RECOVERY135.P$1
/N$11: D4.3, U_DEBUG135.1
/N$12: FET1.1, R25.2, T3.3
/N$14: T3.1, T4.3
/N$18: C46.2, L1.2, U1.97
/N$19: C45.2, L1.1, U1.99
/N$25: C26.2, U1.117
/N$38: C4.1, R8.1
/N$42: LED1.C, R2.2
/N$43: R9.1, R10.1, T2.1
/N$101: D03_H135.1, RM3.4.1
/N$103: D02_H135.1, RM3.3.1
/N$104: D01_H135.1, RM3.2.1
/N$105: D00_H135.1, RM3.1.1
/N$266: L3.2, USB_HOST135.P$1, USB_HOST135.P$2
/PIN1/LCD_D00: CON1.3, RM2.1.1, RM3.1.2, U1.2
/PIN2/LCD_D01: CON1.4, RM2.2.1, RM3.2.2, U1.3
/PIN3/LCD_D02: CON1.5, RM2.3.1, RM3.3.2, U1.4
/PIN4/LCD_D03: CON1.6, RM2.4.1, RM3.4.2, U1.5
/PIN5/LCD_D04: CON1.7, U1.6
/PIN6/LCD_D05: CON1.8, R14.2, U1.7
/PIN7/LCD_D06: CON1.9, U1.8
/PIN8/LCD_D07: CON1.10, U1.9
/PIN9/LCD_D08/SSP2_MISO: CON1.11, CON2.9, U1.22
/PIN10/LCD_D09: CON1.12, U1.23
/PIN11/LCD_D10: CON1.13, U1.24
/PIN12/LCD_D11: CON1.14, CS_SW/CS_HW135.3, U1.25
/PIN13/LCD_D12: CON1.15, U1.27
/PIN14/LCD_D13: CON1.16, U1.26
/PIN15/LCD_D14: CON1.17, U1.29
/PIN16/LCD_D15: CON1.18, U1.28
/PIN17/LCD_D16: CON1.19, U1.19
/PIN18/LCD_D17/USB_EN: CON1.20, R4.2, U1.20, U3.4
/PIN19/LCD_DOTCLK: CON1.21, U1.17
/PIN20/LCD_VSYNC: CON1.22, U1.16
/PIN21/LCD_HSYNC/I2C_SDA: CON1.23, SDA_HW/SDA_SW135.1, U1.15
/PIN22/LCD_EN/I2C_SCL: CON1.24, SCL_HW/SCL_SW135.1, U1.11
/PIN23/LCD_DISP: CON1.25, U1.12
/PIN24/LCD_WR: CON1.26, U1.13
/PIN25/LCD_RS: CON1.27, R15.2, U1.14
/PIN26/LCD_CS: CON1.28, U1.10
/PIN27/PWM2: CON2.28, U1.91
/PIN28/SOFT_SDA: CON2.27, SDA_HW/SDA_SW135.3, U1.31
/PIN29/SOFT_SCL: CON2.26, SCL_HW/SCL_SW135.3, U1.34
/PIN30: CON2.25, U1.81
/PIN31: CON2.24, U1.82
/PIN32/LRADC1: CON2.23, U1.107
/PIN33/LRADC0: CON2.22, U1.108
/PIN34/MIC: CON2.21, U1.116
/PSWITCH: R7.1, U1.119
/PWM0/DUART_RXD: CON2.13, D4.2, R22.2, U1.125
/PWM1/DUART_TXD: CON2.14, U1.126, U_DEBUG135.2
/RASN: U1.62, U2.23
/RESET: R9.2, RESET135.P$1, T4.1
/SD_VCC: C29.2, C44.2, JTAG135.5, L4.2, SD/MMC135.4
/SJTAG_PSW: CON2.15, POWER135.P$2, R7.2, R8.2, RECOVERY135.P$2, RM1.1.2, SJTAG135.3
/SSP1_CMD: JTAG135.6, R21.1, SD/MMC135.3, U1.83
/SSP1_DATA0: JTAG135.2, RM1.4.1, SD/MMC135.7, U1.84
/SSP1_DATA1: JTAG135.1, RM1.3.1, SD/MMC135.8, U1.85
/SSP1_DATA2: JTAG135.8, RM1.2.1, SD/MMC135.1, U1.86
/SSP1_DATA3: JTAG135.7, R20.1, SD/MMC135.2, U1.87
/SSP1_SCK: JTAG135.4, SD/MMC135.5, U1.90
/SSP2_MOSI: CON2.10, U1.21
/SSP2_SCK: CON2.11, U1.33
/USB_DM: U1.123, USB_HOST135.2
/USB_DP: U1.124, USB_HOST135.3
/VDAC1: R26.1, U1.104
/VDD4P2: C9.2, C10.2, D1.K, U1.101
/VDDXTAL: C22.2, R6.2, U1.120
/WEN: U1.77, U2.21
/XTALI: C23.2, Q1.2, T2.3, U1.122
/XTALO: C24.2, Q1.1, T1.3, U1.121
GND: C1.1, C2.1, C3.1, C4.2, C5.1, C6.1, C7.1, C8.1, C9.1, C10.1, C11.1, C12.1, C13.1, C14.1, C15.1, C16.1, C17.1, C18.1, C19.1, C20.1, C21.1, C22.1, C23.1, C24.1, C25.1, C26.1, C27.2, C28.2, C29.1, C30.1, C31.1, C32.1, C33.1, C34.1, C35.1, C36.1, C37.1, C39.1, C40.1, C41.2, C42.1, C43.2, C44.1, C45.1, C46.1, C47.2, C48.-, C49.2, C50.-, C51.-, COMPOSITE_VIDEO135.GND1, COMPOSITE_VIDEO135.GND2, COMPOSITE_VIDEO135.GND3, COMPOSITE_VIDEO135.GNG3, CON1.2, CON1.29, CON2.2, CON2.4, CON2.29, D2.1, D3.A, JTAG135.3, L3.1, PWR135.-, PWR135.--, R2.1, R3.1, R4.1, R10.2, R14.1, R19.1, R20.2, R25.1, RM1.1.1, RM2.1.2, RM2.2.2, RM2.3.2, RM2.4.2, SD/MMC135.6, SJTAG135.2, T1.1, T1.2, T2.2, T4.2, U1.30, U1.35, U1.98, U1.105, U1.112, U1.118, U2.6, U2.12, U2.34, U2.48, U2.52, U2.58, U2.64, U2.66, U3.2, USB_HOST135.4, U_DEBUG135.3, VR1.2
unnamed: SD/MMC135.10, SD/MMC135.11, SD/MMC135.12, SD/MMC135.13
V+: C5.2, C6.2, C7.2, C8.2, C30.2, C31.2, C32.2, C33.2, C34.2, C35.2, C36.2, C37.2, C38.1, R16.2, R18.2, U1.38, U1.45, U1.53, U1.106, U2.1, U2.3, U2.9, U2.15, U2.18, U2.33, U2.55, U2.61
VCC: 3.3V_E135.2, C3.2, C40.2, D00_H135.2, D01_H135.2, D2.2, D02_H135.2, D03_H135.2, L4.1, R1.1, R5.2, R11.2, R12.2, R13.2, R15.1, R21.2, R22.1, RESET135.P$2, RM1.2.2, RM1.3.2, RM1.4.2, SJTAG135.1, U1.18, U1.92
VPP: C43.1, CON2.3, VR1.5
