Jonathon-Reilly/Kicad/kicad-resources/kicad-tools/eagle-to-kicad/examples/PIXHAWK/kicad_files/PX4FMUv2.4.kicad_pcb

## KiCad design kicad-resources/kicad-tools/eagle-to-kicad/examples/PIXHAWK/kicad_files/PX4FMUv2.4.kicad_pcb (2017-08-08)

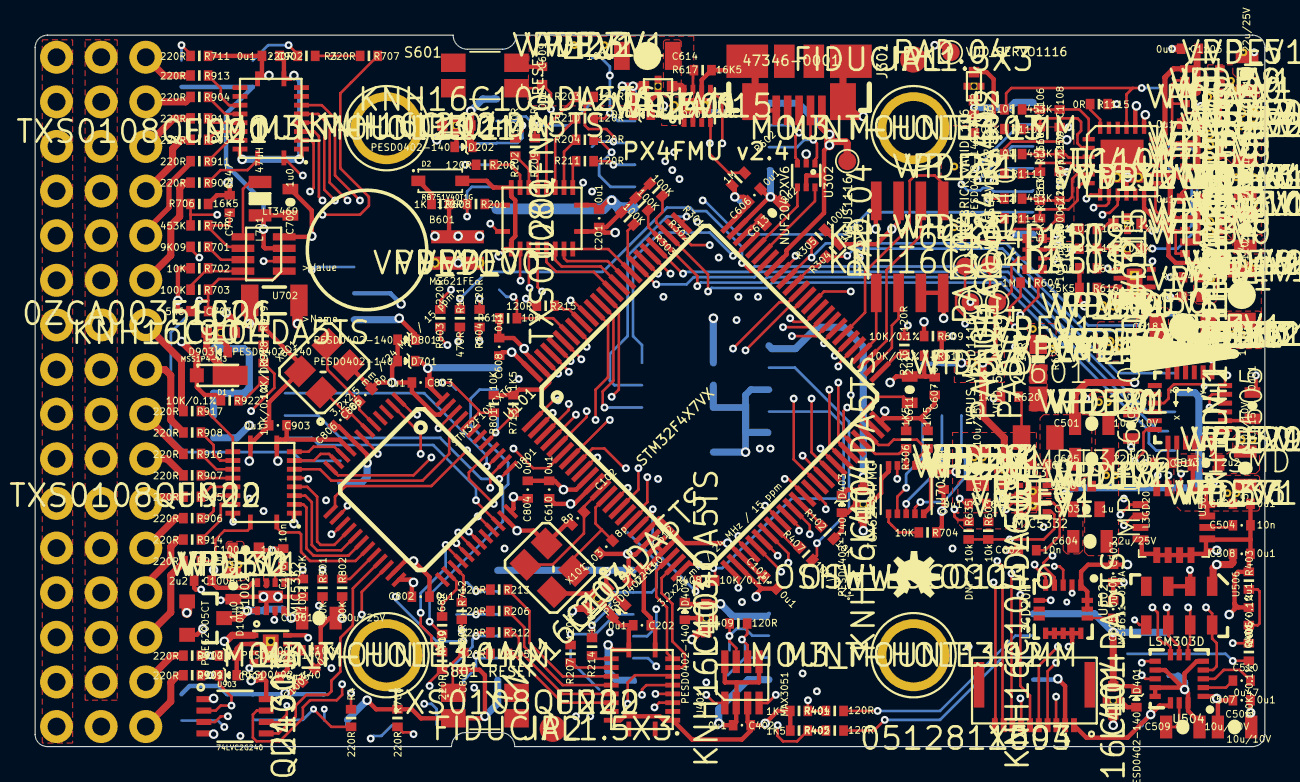
[picture p155: board PX4FMUv2.4.kicad_pcb from above]

Board: 6 copper layers, 70.0 x 40.5 mm, 354 parts (0 on the bottom side), 262 nets.

Parts:
!VBUS_VALID1116: PAD.04; PAD.04X.04
!VDD_BRICK_VALID1116: PAD.04; PAD.04X.04
!VDD_SERVO_VALID1116: PAD.04; PAD.04X.04
ADC_PR1116: PAD.04; PAD.04X.04
B601: MS621FE
C101, C201, C202, C401, C402, C502, C503, C507, C508, C514, C606, C607, C608, C609, C610, C612, C615, C616, C617, C701, C801, C802, C803, C804, C901, C902, C903, C1105, C1106, C1107: 0u1; 0402-CAP
C102, C103, C805, C806: 8p; 0402-CAP
C501, C506, C509, C511: 10u/10V; 0805-CAP
C504, C505, C602, C1002: 10n; 0402-CAP
C510, C704: 0u47; 0402-CAP
C512, C513, C611, C613: 2u2; 0603-CAP
C515: 0u01; 0603-CAP
C601, C1001: 10u/25V; 0805-CAP
C603: 1u; 0603-CAP
C604, C605, C1101, C1102, C1103: 22u/25V; 0805-CAP
C614, C618, C1104: 100u; 1206-CAP
C702, C1003: 1u0; 0603-CAP
C703: 5n6; 0402-CAP
C1004: 10u; 0603-CAP
C1005: 0u1F; 0402-CAP
C1008: 2u2; 0402-CAP
C1108, C1109, C1110: 1000p/25V; 0402-CAP
CAN_H1116: PAD.04; PAD.04X.04
CAN_L1116: PAD.04; PAD.04X.04
D1: MSS1P4-M3; MICROSMP
D2: RB751V40T1G; SOD323
D201, D202, D203, D401, D402, D403, D404, D701, D801, D901, D902, D903: PESD0402-140; 0402-TVS
D1001: PMEG2005CT; SOT23-3
F1001: 0ZCA0035FF2G; PTC-1206
FMU-BOOT1101: PAD.04; PAD.04X.04
GND1116, GND.1116: PAD.04; PAD.04X.04
IO-BOOT1101: PAD.04; PAD.04X.04
J201, J202, J203, J204, J601: DF13C-6P-1.25V
J301: 47346-0001; MOLEX-47346-0001
J302, J401, J405: DF13C-4P-1.25V
J402, J702: DF13C-3P-1.25V
J403: DF13C-7P-1.25V
J404: DF13C-5P-1.25V
J701: DF13C-2P-1.25V
J801: JST-ZH-3; JST-ZH-SMT-VERTICAL
J901: 3X16RA
JP1, JP2: FIDUCIAL1.5X3; FIDUCIAL-1.5X3
JX301, JX802: ARM_MINI_JTAG-SMT; FTSH-105-01-XXX-DV-K
JX801: HEADER-3X1BOARDEDGE-SHORT; HEADER_3X01_SMD_H_BOARD_EDGE_SHORT
L201, L202, L203, L401, L402, L403, L404, L603, L901, L1101, L1102: KNH16C104DA5TS; KYOCERA-KNH16-DA
L701: 47uH; 0805-IND
LED701, LED703: AMBER; 0603-LED
LED702, LED704: GREEN; 0603-LED
LED705: BLUE; 0603-LED
M3_MOUNT1101, M3_MOUNT1102, M3_MOUNT1103, M3_MOUNT1104: MOUNT-HOLE3.1MM; MOUNT-HOLE3.1
OSHW_LOGO1116: OSHW-LOGOS; OSHW-LOGO-S
Q601: MMBT3906LT1SMD; SOT23-BEC
R3, R4, R707, R708, R709, R711, R712, R803, R804, R902, R903, R904, R905, R906, R907, R908, R909, R910, R911, R912, R913, R914, R915, R916, R917: 220R; 0402-RES
R101: 470R; 0402-RES
R102, R611, R615, R702, R704, R801, R802, R901, R1002: 10K; 0402-RES
R201, R202, R203, R204, R205, R206, R207, R208, R209, R210, R211, R212, R213, R214, R215, R216, R404, R405, R409: 120R; 0402-RES
R301, R302, R303, R304, R305, R703, R1001: 100K; 0402-RES
R306, R307, R401, R402, R713: 1K5; 0402-RES
R403, R406, R407, R408, R609, R610, R918, R919, R922, R1101, R1102: 10K/0.1%; 0402-RES
R602, R604, R1103, R1104: 1M; 0402-RES
R603: 10k; 0402-RES
R608: 1K; 0402-RES
R616: 25K5; 0402-RES
R617, R706: 16K5; 0402-RES
R620: 1k8; 0402-RES
R621: 10R; 0603-RES
R635: DNP / 10k; 0402-RES
R701: 9K09; 0402-RES
R705, R1105, R1109, R1112: 453K; 0402-RES
R710: 68R; 0402-RES
R1106, R1110, R1113: 56K; 0402-RES
R1107, R1111, R1114: 105K; 0402-RES
R1115: 0R; 0402-RES
RN1101: 1M; EXB28V
S1RX1116, S1TX1116, S2RX1116, S2TX1116, S3RX1116, S3TX1116, S4RX1116, S4TX1116, S5_RX1116, S5_TX1116: PAD.04; PAD.04X.04
S601, S801: RESET; EVQP7J01K
U101: STM32F4X7VX; TQFP100
U102: FM25V01; SO08
U201, U202, U901, U902: TXS0108QFN20; QFN20-RGY
U301: 2908-05WB-MG; MICROSD
U302: NUF2042XV6; SOT563-6
U401: MAX3051; SOT23-8
U501: L3GD20; L3G4200DH-MAN
U502: L3GD20H; LGA-16L
U504: LSM303D; LGA-16L
U505: MPU-6000; QFN-24
U506: MS5611-01BA
U601, U602: BQ24315; QFN8-DSG
U603, U1002: MIC5332; MLF-8-EPAD
U701: TCA62724FMG; SON10
U702: LT3469; SOT23-8
U703: LRTB GFTG-T7AW-1+V7A7-29+R5T9-49-L; 6-PLCC
U801: STM32F10XCXT6; TQFP48
U903: 74LVC2G240; TSSOP8_SOT505-2
U1001: BQ24313; QFN8-DSG
U1101: LTC4417; MO-220
U1102, U1103, U1104: NTHD4102PT1G; 1206-8
VBUS1116: PAD.04; PAD.04X.04
VDDA_3V1101: PAD.04; PAD.04X.04
VDD_3V1101, VDD_5V_BRICK1116, VDD_5V_IN1116: PAD.04; PAD.04X.04
VDD_SERVO1116: PAD.04; PAD.04X.04
VP_0, VP_1, VP_2, VP_3, VP_33, VP_34, VP_35, VP_41, VP_42, VP_43, VP_51, VP_52, VP_53, VP_54, VP_55, VP_56, VP_57, VP_58, VP_59, VP_60, VP_61: VPDEV0; VPAC0
VP_4, VP_5, VP_6, VP_7, VP_8, VP_9, VP_10, VP_11, VP_12, VP_13, VP_14, VP_15, VP_16, VP_17, VP_18, VP_19, VP_20, VP_21, VP_22, VP_23, VP_24, VP_25, VP_26, VP_27, VP_28, VP_29, VP_30, VP_31, VP_32, VP_36, VP_37, VP_39, VP_40, VP_44, VP_45, VP_46, VP_47, VP_48, VP_49, VP_50: VPDEV1; VPAC1
VP_38: VPDEV2; VPAC2
X101, X801: 3.2x2.5 mm / 24 MHz / 15 ppm; OSCILLATOR-3.2X2.5
X503: 0512811094; 51281-1094

Connections:
!ACCEL_MAG_CS: U101.9, U504.8, X503.6
!BARO_CS: U101.88, U506.5
!FMU-LED_AMBER: R707.P$1, U101.43
!FRAM_CS: U101.57, U102.1
!GYRO_CS: U101.7, U501.5, U502.5, X503.7
!IO-LED_AMBER: R709.P$1, U801.28
!IO-LED_BLUE: R712.P$1, U801.27
!IO-LED_SAFETY: R710.P$2, U801.26
!MPU_CS: U101.17, U505.8
!SBUS_OUTPUT_EN: U801.40, U903.7
!SPI_EXT_NSS: J403.5, U101.3
!VBUS_VALID: !VBUS_VALID1116.P$1, RN1101.2, U101.15, U1101.P$9
!VDD_5V_HIPOWER_OC: R602.P$1, U101.41, U601.4
!VDD_5V_PERIPH_EN: R615.P$1, U101.67, U601.5, U602.5
!VDD_5V_PERIPH_OC: R604.P$1, U101.46, U602.4
!VDD_BRICK_VALID: !VDD_BRICK_VALID1116.P$1, RN1101.4, U101.91, U1101.P$7
!VDD_SERVO_VALID: !VDD_SERVO_VALID1116.P$1, RN1101.3, U101.93, U1101.P$8
ACCEL_DRDY: U101.90, U504.11, X503.3
ALARM: R701.P$2, U101.77
BATT_CURRENT_SENS: R1101.P$1, U101.26
BATT_CURRENT_SENS_PROT: J601.3, L1101.P$1, R1104.P$1
BATT_VOLTAGE_SENS: R1102.P$1, U101.25
BATT_VOLTAGE_SENS_PROT: J601.4, L1102.P$1, R1103.P$1
CAN1_RX: U101.81, U401.4
CAN1_TX: U101.82, U401.1
CAN2_RX: R216.P$1, U101.51
CAN2_TX: R215.P$1, U101.92
CAN_H: CAN_H1116.P$1, J405.2, R409.P$1, U401.7
CAN_L: CAN_L1116.P$1, J405.3, R409.P$2, U401.6
FMU-!RESET: C609.P$2, R635.P$1, S601.A1, U101.14, U603.3, U701.4
FMU-BOOT0: FMU-BOOT1101.P$1, R611.P$2, U101.94
FMU-CH1: U101.45, U901.7
FMU-CH1-PROT: J901.46, R913.P$2
FMU-CH2: U101.44, U901.6
FMU-CH3: U101.42, U901.5
FMU-CH4: U101.40, U901.4
FMU-CH5: U101.60, U901.3
FMU-CH6: U101.61, U901.1
FMU-CH6-PROT: J901.31, R902.P$2
FMU-I2C1_SCL: R401.P$1, R404.P$1, U101.95
FMU-I2C1_SDA: R402.P$1, R405.P$1, U101.96
FMU-I2C2_SCL: R306.P$1, U101.47, U701.3
FMU-I2C2_SDA: R307.P$1, U101.48, U701.2
FMU-SWCLK: JX301.4, U101.76
FMU-SWDIO: JX301.2, U101.72
FMU-SWO: JX301.6, U101.89
FMU-UART4_RX: U101.24, U202.8
FMU-UART4_TX: U101.23, U202.9
FMU-UART7_RX: U101.38, U202.4
FMU-UART7_TX: U101.39, U202.5
FMU-UART8_RX: U101.97, U202.6
FMU-UART8_TX: U101.98, U202.7
FMU-USART2_CTS: U101.84, U201.9
FMU-USART2_RTS: U101.85, U201.8
FMU-USART2_RX: U101.87, U201.6
FMU-USART2_TX: U101.86, U201.7
FMU-USART3_CTS: U101.58, U201.3
FMU-USART3_RTS: U101.59, U201.1
FMU-USART3_RX: U101.56, U201.4
FMU-USART3_TX: U101.55, U201.5
FMU-VDD_3V3: C101.P$1, C201.P$1, C202.P$1, C402.P$1, C603.P$1, C604.P$1, C606.P$1, C607.P$1, C608.P$1, C610.P$1, C612.P$1, C616.P$1, C701.P$1, C902.P$1, D2.A, JX301.1, R301.P$2, R302.P$2, R303.P$2, R304.P$2, R305.P$2, R306.P$2, R307.P$2, R401.P$2, R402.P$2, R602.P$2, R604.P$2, U101.11, U101.19, U101.21, U101.22, U101.28, U101.50, U101.75, U101.100, U102.3, U102.7, U102.8, U201.2, U201.10, U201.19, U202.2, U202.10, U202.19, U301.4, U401.3, U603.7, U701.1, U701.10, U901.2, U901.10, U901.19, VDD_3V1101.P$1
FMU-VDD_5V5: C601.P$1, C615.P$1, L603.P$2, R603.P$1, U603.1, U603.4
FMU_AUX_ADC1: R408.P$1, U101.18
FMU_AUX_ADC1_PROT: J404.4, R408.P$2
FMU_AUX_ADC2: R407.P$1, U101.33
FMU_AUX_ADC2_PROT: J404.2, R407.P$2
FRAM_MISO: U101.53, U102.2
FRAM_MOSI: U101.54, U102.5
FRAM_SCK: U101.52, U102.6
GND: B601.2, C101.P$2, C102.P$2, C103.P$1, C201.P$2, C202.P$2, C401.P$2, C402.P$2, C501.P$2, C502.P$2, C503.P$2, C504.P$2, C505.P$2, C506.P$2, C507.P$2, C508.P$2, C509.P$2, C511.P$2, C512.P$2, C513.P$2, C514.P$2, C515.P$2, C601.P$2, C602.P$1, C603.P$2, C604.P$2, C605.P$2, C606.P$2, C607.P$2, C608.P$2, C609.P$1, C610.P$2, C611.P$2, C612.P$2, C613.P$2, C614.P$2, C615.P$2, C616.P$2, C617.P$2, C618.P$2, C701.P$2, C702.P$2, C703.P$2, C704.P$2, C801.P$1, C802.P$2, C803.P$2, C804.P$2, C805.P$2, C806.P$1, C901.P$2, C902.P$2, C903.P$2, C1001.P$2, C1002.P$2, C1003.P$2, C1004.P$2, C1005.P$2, C1008.P$2, C1101.P$2, C1102.P$2, C1103.P$2, C1104.P$2, C1105.P$2, C1106.P$2, C1107.P$2, C1108.P$2, C1109.P$2, C1110.P$2, D201.A, D202.A, D203.A, D401.A, D402.A, D403.A, D404.A, D701.A, D801.A, D901.A, D902.A, D903.A, GND1116.P$1, GND.1116.P$1, J201.6, J202.6, J203.6, J204.6, J301.GND, J301.GND1, J301.GND2, J301.GND3, J301.GND4, J302.4, J401.4, J402.3, J403.7, J404.3, J404.5, J405.4, J601.5, J601.6, J701.2, J801.P$2, J901.3, J901.6, J901.9, J901.12, J901.15, J901.18, J901.21, J901.24, J901.27, J901.30, J901.33, J901.36, J901.39, J901.42, J901.45, J901.48, JX301.3, JX301.5, JX301.9, JX801.3, JX802.3, JX802.5, JX802.9, L201.P$3, L201.P$4, L201.P$5, L202.P$3, L202.P$4, L202.P$5, L203.P$3, L203.P$4, L203.P$5, L401.P$3, L401.P$4, L401.P$5, L402.P$3, L402.P$4, L402.P$5, L403.P$3, L403.P$4, L403.P$5, L404.P$3, L404.P$4, L404.P$5, L603.P$3, L603.P$4, L603.P$5, L901.P$3, L901.P$4, L901.P$5, L1101.P$3, L1101.P$4, L1101.P$5, L1102.P$3, L1102.P$4, L1102.P$5, R102.P$2, R403.P$1, R610.P$2, R611.P$1, R615.P$2, R616.P$2, R617.P$2, R621.1, R702.P$2, R704.P$1, R706.P$2, R708.P$1, R711.P$1, R713.P$2, R801.P$2, R802.P$2, R919.P$1, R1001.P$1, R1002.P$1, R1103.P$2, R1104.P$2, R1107.P$2, R1111.P$2, R1114.P$2, R1115.P$1, S601.B3, S801.B3, U101.10, U101.20, U101.27, U101.74, U101.99, U102.4, U201.11, U202.11, U301.6, U302.2, U401.2, U401.5, U401.8, U501.8, U501.9, U501.10, U501.11, U501.12, U501.13, U502.9, U502.10, U502.11, U502.12, U502.13, U504.5, U504.10, U504.12, U504.13, U504.16, U505.1, U505.18, U506.2, U506.3, U601.2, U601.6, U601.GND, U601.P$2, U601.P$3, U602.2, U602.6, U602.GND, U602.P$2, U602.P$3, U603.2, U603.GND, U701.5, U702.4, U801.8, U801.23, U801.35, U801.47, U901.11, U902.11, U903.1, U903.4, U1001.2, U1001.5, U1001.6, U1001.GND, U1001.P$2, U1001.P$3, U1002.2, U1002.GND, U1101.P$10, U1101.P$25, VP_0.VP, VP_1.VP, VP_2.VP, VP_3.VP, VP_4.VP, VP_5.VP, VP_6.VP, VP_7.VP, VP_8.VP, VP_9.VP, VP_10.VP, VP_11.VP, VP_12.VP, VP_13.VP, VP_14.VP, VP_15.VP, VP_16.VP, VP_17.VP, VP_18.VP, VP_19.VP, VP_20.VP, VP_21.VP, VP_22.VP, VP_23.VP, VP_24.VP, VP_25.VP, VP_26.VP, VP_27.VP, VP_28.VP, VP_29.VP, VP_30.VP, X101.2, X101.4, X503.2, X801.2, X801.4
GPIO_EXT_1: J403.6, U101.8
GYRO_DRDY: U101.35, U501.6, U502.6, X503.5
IO-!RESET: C801.P$2, S801.A1, U801.7, U1002.3
IO-!VDD_SERVO_IN_FAULT: U801.38, U1001.4
IO-BOOT0: IO-BOOT1101.P$1, R801.P$1, U801.44
IO-BOOT1: R802.P$1, U801.20
IO-CH1: U801.10, U902.9
IO-CH1-PROT: J901.28, R917.P$2
IO-CH2: U801.11, U902.8
IO-CH3: U801.45, U902.7
IO-CH4: U801.46, U902.6
IO-CH5: U801.16, U902.5
IO-CH6: U801.17, U902.4
IO-CH7: U801.18, U902.3
IO-CH8: U801.19, U902.1
IO-CH8-PROT: J901.7, R905.P$2
IO-SWCLK: JX802.4, U801.37
IO-SWDIO: JX802.2, U801.34
IO-SWO: JX802.6, U801.39
IO-USART1_RX: J801.P$3, JX801.2, U801.31
IO-USART1_TX: JX801.1, R101.P$2, U801.30
IO-VDD_3V3: C802.P$1, C803.P$1, C804.P$1, C901.P$1, C903.P$1, C1003.P$1, C1004.P$1, D701.C, J702.1, JX802.1, U801.9, U801.24, U801.36, U801.48, U902.2, U902.10, U902.19, U903.8, U1002.7, VP_31.VP, VP_32.VP
IO-VDD_5V5: C1001.P$1, C1005.P$1, D1001.3, J901.2, LED702.A, LED703.A, LED705.A, U1002.1, U1002.4
MAG_DRDY: U101.36, U504.9, X503.4
MPU_DRDY: U101.62, U505.12
unnamed: C103.P$2, U101.13, X101.1
unnamed: C102.P$1, U101.12, X101.3
unnamed: R918.P$2, R922.P$1
unnamed: D1001.2, U1001.8
unnamed: D201.C, J201.1, L201.P$2
unnamed: C509.P$1, U504.15
unnamed: LED704.C, R711.P$2
unnamed: C613.P$1, U101.73
unnamed: LED705.C, R712.P$2
unnamed: C510.P$1, U504.2
unnamed: C602.P$2, U603.6
unnamed: C611.P$1, U101.49
unnamed: R3.P$1, R707.P$2
unnamed: J203.4, R215.P$2
unnamed: R803.P$1, U801.12
unnamed: R804.P$1, U801.13
unnamed: C510.P$2, U504.3
unnamed: C806.P$2, U801.6, X801.1
unnamed: J203.5, R216.P$2
unnamed: R1001.P$2, U1001.7
unnamed: D2.C, R608.P$2
unnamed: C805.P$1, U801.5, X801.3
unnamed: R101.P$1, U101.69
unnamed: R705.P$2, R706.P$1, U702.2
unnamed: R702.P$1, R703.P$2, U702.8
unnamed: LED701.C, R3.P$2
unnamed: C703.P$1, J701.1, R703.P$1, U702.1
unnamed: R701.P$1, U702.7
unnamed: LED702.C, R708.P$2
unnamed: C505.P$1, U502.14
unnamed: J901.10, R914.P$2
unnamed: L701.P$2, U702.5
unnamed: J401.2, R404.P$2
unnamed: R616.P$1, U602.7
unnamed: C504.P$1, U501.14
unnamed: C704.P$1, R705.P$1, U702.6
unnamed: J401.3, R405.P$2
unnamed: D902.C, R901.P$2, R910.P$1, U903.3
unnamed: R4.P$1, R709.P$2
unnamed: LED703.C, R4.P$2
unnamed: D402.C, J403.1, L402.P$2
unnamed: D401.C, J401.1, J402.1, L401.P$2
unnamed: R905.P$1, U902.20
unnamed: R914.P$1, U902.18
unnamed: R906.P$1, U902.17
unnamed: D1001.1, F1001.2
unnamed: C1108.P$1, R1105.P$2, R1106.P$1, U1101.P$1
unnamed: D404.C, J405.1, L403.P$2
unnamed: R915.P$1, U902.16
unnamed: C512.P$1, U505.10
unnamed: C515.P$1, U505.20
unnamed: R907.P$1, U902.15
unnamed: R1106.P$2, R1107.P$1, U1101.P$2
unnamed: C1109.P$1, R1109.P$2, R1110.P$1, U1101.P$3
unnamed: R1110.P$2, R1111.P$1, U1101.P$4
unnamed: J702.2, R710.P$1
unnamed: R916.P$1, U902.14
unnamed: R908.P$1, U902.13
unnamed: R917.P$1, U902.12
unnamed: R902.P$1, U901.20
unnamed: R911.P$1, U901.18
unnamed: R903.P$1, U901.17
unnamed: R912.P$1, U901.16
unnamed: R904.P$1, U901.15
unnamed: R913.P$1, U901.14
unnamed: R1113.P$2, R1114.P$1, U1101.P$6
unnamed: J901.34, R911.P$2
unnamed: C1110.P$1, R1112.P$2, R1113.P$1, U1101.P$5
unnamed: R201.P$1, U201.20
unnamed: J901.13, R906.P$2
unnamed: J901.16, R915.P$2
unnamed: J901.19, R907.P$2
unnamed: J901.22, R916.P$2
unnamed: J901.25, R908.P$2
unnamed: J901.37, R903.P$2
unnamed: J901.40, R912.P$2
unnamed: J901.43, R904.P$2
unnamed: Q601.C, R621.2
unnamed: Q601.B, R620.P$1
unnamed: R208.P$1, U201.18
unnamed: R202.P$1, U201.17
unnamed: R209.P$1, U201.16
unnamed: R203.P$1, U201.15
unnamed: R210.P$1, U201.14
unnamed: R204.P$1, U201.13
unnamed: R211.P$1, U201.12
unnamed: R207.P$1, U202.13
unnamed: R214.P$1, U202.12
unnamed: R205.P$1, U202.17
unnamed: R212.P$1, U202.16
unnamed: R206.P$1, U202.15
unnamed: R213.P$1, U202.14
unnamed: R704.P$2, U701.6
unnamed: R617.P$1, U601.7
unnamed: C1105.P$1, U1101.P$18, U1102.P$1, U1102.P$3
unnamed: D403.C, J404.1, L404.P$2
unnamed: J901.4, R910.P$2
unnamed: D203.C, J203.1, J204.1, L203.P$2
unnamed: D202.C, J202.1, L202.P$2
unnamed: L1102.P$2, R1102.P$2
unnamed: L1101.P$2, R1101.P$2
unnamed: C1002.P$1, U1002.6
unnamed: R1115.P$2, U1101.P$24
unnamed: C1106.P$1, U1101.P$16, U1103.P$1, U1103.P$3
unnamed: C1107.P$1, U1101.P$14, U1104.P$1, U1104.P$3
unnamed: U1101.P$13, U1104.P$2, U1104.P$4
unnamed: D903.C, L901.P$1
unnamed: U1101.P$15, U1103.P$2, U1103.P$4
unnamed: U1101.P$17, U1102.P$2, U1102.P$4
OTG_DM1: J301.D-, J302.3, U302.1
OTG_DP1: J301.D+, J302.2, U302.3
OTG_FS_DM: U101.70, U302.6
OTG_FS_DP: U101.71, U302.4
PB2-BOOT1: R102.P$1, U101.37
PPM-SBUS-PROT: J901.1, R909.P$2
PPM_INPUT: D901.C, R909.P$1, U801.29, U903.2
PRESSURE_SENS: C401.P$1, R403.P$2, R406.P$1, U101.34
PRESSURE_SENS_IN: ADC_PR1116.P$1, J402.2, R406.P$2
RGB_LED_3: U701.9, U703.C1
RGB_LED_4: U701.8, U703.C2
RGB_LED_14: U701.7, U703.C3
RSSI_IN: R901.P$1, U801.15, U801.33
SAFETY: J702.3, R713.P$1, U801.41
SBUS_INPUT: U801.22, U903.6
SBUS_OUTPUT: U801.21, U903.5
SDIO_CK: U101.80, U301.5
SDIO_CMD: R303.P$1, U101.83, U301.3
SDIO_D0: R304.P$1, U101.65, U301.7
SDIO_D1: R305.P$1, U101.66, U301.8
SDIO_D2: R301.P$1, U101.78, U301.1
SDIO_D3: R302.P$1, U101.79, U301.2
SERIAL1_CTS: J201.4, R211.P$2
SERIAL1_RTS: J201.5, R204.P$2
SERIAL1_RX: J201.3, R203.P$2, S1RX1116.P$1
SERIAL1_TX: J201.2, R210.P$2, S1TX1116.P$1
SERIAL2_CTS: J202.4, R208.P$2
SERIAL2_RTS: J202.5, R201.P$2
SERIAL2_RX: J202.3, R202.P$2, S2RX1116.P$1
SERIAL2_TX: J202.2, R209.P$2, S2TX1116.P$1
SERIAL3_RX: J203.3, R207.P$2, S3RX1116.P$1
SERIAL3_TX: J203.2, R214.P$2, S3TX1116.P$1
SERIAL4_RX: J204.3, R206.P$2, S4RX1116.P$1
SERIAL4_TX: J204.2, R213.P$2, S4TX1116.P$1
SERIAL5_RX: J204.5, R205.P$2, S5_RX1116.P$1
SERIAL5_TX: J204.4, R212.P$2, S5_TX1116.P$1
SERIAL_FMU_TO_IO: R804.P$2, U101.63
SERIAL_IO_TO_FMU: R803.P$2, U101.64
SPI_EXT_MISO: J403.3, U101.4
SPI_EXT_MOSI: J403.4, U101.5
SPI_EXT_SCK: J403.2, U101.1
SPI_INT_MISO: U101.31, U501.4, U502.4, U504.7, U505.9, U506.6, X503.9
SPI_INT_MOSI: U101.32, U501.3, U502.3, U504.6, U505.24, U506.7, X503.8
SPI_INT_SCK: U101.30, U501.2, U502.2, U504.4, U505.23, U506.8, X503.10
VBAT: B601.1, R608.P$1, U101.6, U801.1
VBUS: C1103.P$1, J301.VBUS, J302.1, R1112.P$1, U101.68, U302.5, U1101.P$19, U1104.P$7, U1104.P$8, VBUS1116.P$1, VP_33.VP, VP_34.VP, VP_35.VP
VDD_3V3_SENSORS: C501.P$1, C502.P$1, C503.P$1, C506.P$1, C507.P$1, C508.P$1, C511.P$1, C513.P$1, C514.P$1, C605.P$1, C617.P$1, Q601.E, U501.1, U501.15, U501.16, U502.1, U502.15, U502.16, U504.1, U504.14, U505.13, U506.1, U603.8, VDDA_3V1101.P$1, VP_36.VP, VP_37.VP, X503.1
VDD_3V3_SENSORS_EN: R603.P$2, R620.P$2, R635.P$2, U101.2, U603.5
VDD_3V3_SPEKTRUM: C1008.P$1, D801.C, J801.P$1, U1002.8
VDD_3V3_SPEKTRUM_EN: R1002.P$2, U801.2, U1002.5
VDD_5V_BRICK: C1101.P$1, J601.1, J601.2, R1105.P$1, U1101.P$21, U1102.P$7, U1102.P$8, VDD_5V_BRICK1116.P$1, VP_38.VP, VP_39.VP, VP_40.VP
VDD_5V_HIPOWER: C614.P$1, L201.P$1, U601.8
VDD_5V_IN: C702.P$1, C1104.P$1, F1001.1, L603.P$1, L701.P$1, LED701.A, LED704.A, R609.P$2, RN1101.5, RN1101.6, RN1101.7, U601.1, U602.1, U702.3, U703.A1, U703.A2, U703.A3, U1101.P$12, U1102.P$5, U1102.P$6, U1103.P$5, U1103.P$6, U1104.P$5, U1104.P$6, VDD_5V_IN1116.P$1, VP_41.VP, VP_42.VP, VP_43.VP, VP_44.VP, VP_45.VP, VP_46.VP, VP_47.VP, VP_48.VP, VP_49.VP, VP_50.VP, VP_51.VP, VP_52.VP, VP_53.VP
VDD_5V_PERIPH: C618.P$1, L202.P$1, L203.P$1, L401.P$1, L402.P$1, L403.P$1, L404.P$1, U602.8, VP_54.VP, VP_55.VP, VP_56.VP, VP_57.VP, VP_58.VP
VDD_5V_SENS: R609.P$1, R610.P$1, U101.29
VDD_SERVO: C1102.P$1, J901.5, J901.8, J901.11, J901.14, J901.17, J901.20, J901.23, J901.26, J901.29, J901.32, J901.35, J901.38, J901.41, J901.44, J901.47, R922.P$2, R1109.P$1, U1101.P$20, U1103.P$7, U1103.P$8, VDD_SERVO1116.P$1, VP_59.VP, VP_60.VP, VP_61.VP
VDD_SERVO_IN: L901.P$2, U1001.1
VDD_SERVO_SENS: R918.P$1, R919.P$2, U801.14
