Jonathon-Reilly/Kicad/kicad-resources/kicad-tools/eagle-to-kicad/examples/PIXHAWK/eagle_original_files/PX4FMUv2.4.brd

## EAGLE design kicad-resources/kicad-tools/eagle-to-kicad/examples/PIXHAWK/eagle_original_files/PX4FMUv2.4.brd (2017-08-08)

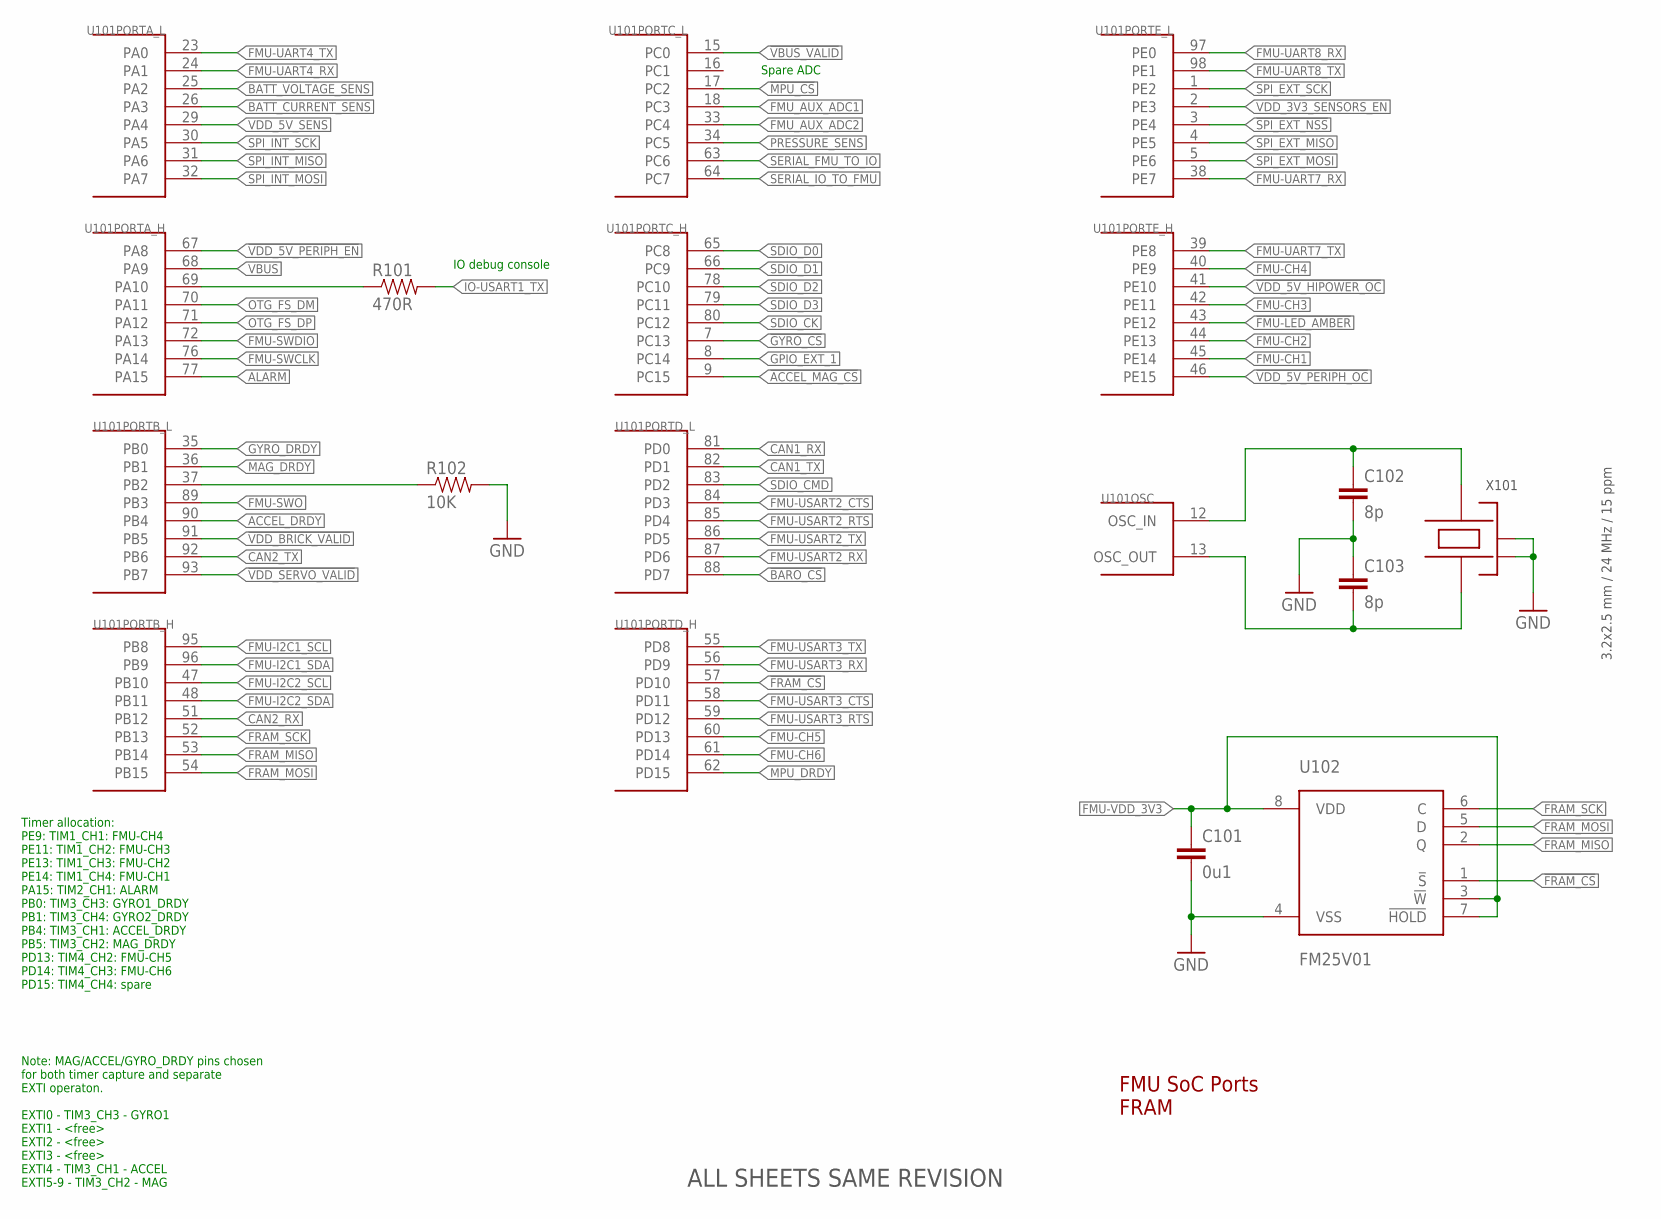
[picture p158: schematic PX4FMUv2.4.sch, sheet 1]

Parts:
C101: 0u1; 0402-CAP; PARTNO CC0402ZRY5V7BB104
C102, C103: 8p; 0402-CAP; PARTNO C1005C0G1H080C
R101: 470R; 0402-RES; PARTNO RC0402FR-07470RL
R102: 10K; 0402-RES; PARTNO RC0402FR-0710KL
U101: STM32F4X7VX; TQFP100; PARTNO STM32F427VI
U102: FM25V01; SO08; PARTNO FM25V01-G
X101: 3.2x2.5 mm / 24 MHz / 15 ppm; OSCILLATOR-3.2X2.5; PARTNO NX3225SA-24.000000MHZ

Connections:
!ACCEL_MAG_CS: U101.9 (PC15); also elsewhere on the board
!BARO_CS: U101.88 (PD7); also elsewhere on the board
!FMU-LED_AMBER: U101.43 (PE12); also elsewhere on the board
!FRAM_CS: U101.57 (PD10), U102.1 (!S)
!GYRO_CS: U101.7 (PC13); also elsewhere on the board
!MPU_CS: U101.17 (PC2); also elsewhere on the board
!SPI_EXT_NSS: U101.3 (PE4); also elsewhere on the board
!VBUS_VALID: U101.15 (PC0); also elsewhere on the board
!VDD_5V_HIPOWER_OC: U101.41 (PE10); also elsewhere on the board
!VDD_5V_PERIPH_EN: U101.67 (PA8); also elsewhere on the board
!VDD_5V_PERIPH_OC: U101.46 (PE15); also elsewhere on the board
!VDD_BRICK_VALID: U101.91 (PB5); also elsewhere on the board
!VDD_SERVO_VALID: U101.93 (PB7); also elsewhere on the board
ACCEL_DRDY: U101.90 (PB4); also elsewhere on the board
ALARM: U101.77 (PA15); also elsewhere on the board
BATT_CURRENT_SENS: U101.26 (PA3); also elsewhere on the board
BATT_VOLTAGE_SENS: U101.25 (PA2); also elsewhere on the board
CAN1_RX: U101.81 (PD0); also elsewhere on the board
CAN1_TX: U101.82 (PD1); also elsewhere on the board
CAN2_RX: U101.51 (PB12); also elsewhere on the board
CAN2_TX: U101.92 (PB6); also elsewhere on the board
FMU-CH1: U101.45 (PE14); also elsewhere on the board
FMU-CH2: U101.44 (PE13); also elsewhere on the board
FMU-CH3: U101.42 (PE11); also elsewhere on the board
FMU-CH4: U101.40 (PE9); also elsewhere on the board
FMU-CH5: U101.60 (PD13); also elsewhere on the board
FMU-CH6: U101.61 (PD14); also elsewhere on the board
FMU-I2C1_SCL: U101.95 (PB8); also elsewhere on the board
FMU-I2C1_SDA: U101.96 (PB9); also elsewhere on the board
FMU-I2C2_SCL: U101.47 (PB10); also elsewhere on the board
FMU-I2C2_SDA: U101.48 (PB11); also elsewhere on the board
FMU-SWCLK: U101.76 (PA14); also elsewhere on the board
FMU-SWDIO: U101.72 (PA13); also elsewhere on the board
FMU-SWO: U101.89 (PB3); also elsewhere on the board
FMU-UART4_RX: U101.24 (PA1); also elsewhere on the board
FMU-UART4_TX: U101.23 (PA0); also elsewhere on the board
FMU-UART7_RX: U101.38 (PE7); also elsewhere on the board
FMU-UART7_TX: U101.39 (PE8); also elsewhere on the board
FMU-UART8_RX: U101.97 (PE0); also elsewhere on the board
FMU-UART8_TX: U101.98 (PE1); also elsewhere on the board
FMU-USART2_CTS: U101.84 (PD3); also elsewhere on the board
FMU-USART2_RTS: U101.85 (PD4); also elsewhere on the board
FMU-USART2_RX: U101.87 (PD6); also elsewhere on the board
FMU-USART2_TX: U101.86 (PD5); also elsewhere on the board
FMU-USART3_CTS: U101.58 (PD11); also elsewhere on the board
FMU-USART3_RTS: U101.59 (PD12); also elsewhere on the board
FMU-USART3_RX: U101.56 (PD9); also elsewhere on the board
FMU-USART3_TX: U101.55 (PD8); also elsewhere on the board
FMU-VDD_3V3: C101.P$1 (1), U102.3 (!W), U102.7 (!HOLD), U102.8 (VDD); also elsewhere on the board
FMU_AUX_ADC1: U101.18 (PC3); also elsewhere on the board
FMU_AUX_ADC2: U101.33 (PC4); also elsewhere on the board
FRAM_MISO: U101.53 (PB14), U102.2 (Q)
FRAM_MOSI: U101.54 (PB15), U102.5 (D)
FRAM_SCK: U101.52 (PB13), U102.6 (C)
GND: C101.P$2 (2), C102.P$2 (2), C103.P$1 (1), R102.P$2 (2), U102.4 (VSS), X101.2 (NC_2), X101.4 (NC_4); also elsewhere on the board
GPIO_EXT_1: U101.8 (PC14); also elsewhere on the board
GYRO_DRDY: U101.35 (PB0); also elsewhere on the board
IO-USART1_TX: R101.P$2 (2); also elsewhere on the board
MAG_DRDY: U101.36 (PB1); also elsewhere on the board
MPU_DRDY: U101.62 (PD15); also elsewhere on the board
unnamed: C103.P$2 (2), U101.13 (OSC_OUT), X101.1
unnamed: C102.P$1 (1), U101.12 (OSC_IN), X101.3
unnamed: R101.P$1 (1), U101.69 (PA10)
OTG_FS_DM: U101.70 (PA11); also elsewhere on the board
OTG_FS_DP: U101.71 (PA12); also elsewhere on the board
PB2-BOOT1: R102.P$1 (1), U101.37 (PB2)
PRESSURE_SENS: U101.34 (PC5); also elsewhere on the board
SDIO_CK: U101.80 (PC12); also elsewhere on the board
SDIO_CMD: U101.83 (PD2); also elsewhere on the board
SDIO_D0: U101.65 (PC8); also elsewhere on the board
SDIO_D1: U101.66 (PC9); also elsewhere on the board
SDIO_D2: U101.78 (PC10); also elsewhere on the board
SDIO_D3: U101.79 (PC11); also elsewhere on the board
SERIAL_FMU_TO_IO: U101.63 (PC6); also elsewhere on the board
SERIAL_IO_TO_FMU: U101.64 (PC7); also elsewhere on the board
SPI_EXT_MISO: U101.4 (PE5); also elsewhere on the board
SPI_EXT_MOSI: U101.5 (PE6); also elsewhere on the board
SPI_EXT_SCK: U101.1 (PE2); also elsewhere on the board
SPI_INT_MISO: U101.31 (PA6); also elsewhere on the board
SPI_INT_MOSI: U101.32 (PA7); also elsewhere on the board
SPI_INT_SCK: U101.30 (PA5); also elsewhere on the board
VBUS: U101.68 (PA9); also elsewhere on the board
VDD_3V3_SENSORS_EN: U101.2 (PE3); also elsewhere on the board
VDD_5V_SENS: U101.29 (PA4); also elsewhere on the board

Notes on the sheet:
FMU SoC Ports FRAM
Note: MAG/ACCEL/GYRO_DRDY pins chosen for both timer capture and separate EXTI operaton. EXTI0 - TIM3_CH3 - GYRO1 EXTI1 - <free> EXTI2 - <free> EXTI3 - <free> EXTI4 - TIM3_CH1 - ACCEL EXTI5-9 - TIM3_CH2 - MAG
Timer allocation: PE9: TIM1_CH1: FMU-CH4 PE11: TIM1_CH2: FMU-CH3 PE13: TIM1_CH3: FMU-CH2 PE14: TIM1_CH4: FMU-CH1 PA15: TIM2_CH1: ALARM PB0: TIM3_CH3: GYRO1_DRDY PB1: TIM3_CH4: GYRO2_DRDY PB4: TIM3_CH1: ACCEL_DRDY PB5: TIM3_CH2: MAG_DRDY PD13: TIM4_CH2: FMU-CH5 PD14: TIM4_CH3: FMU-CH6 PD15: TIM4_CH4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
IO debug console
Spare ADC
ALL SHEETS SAME REVISION

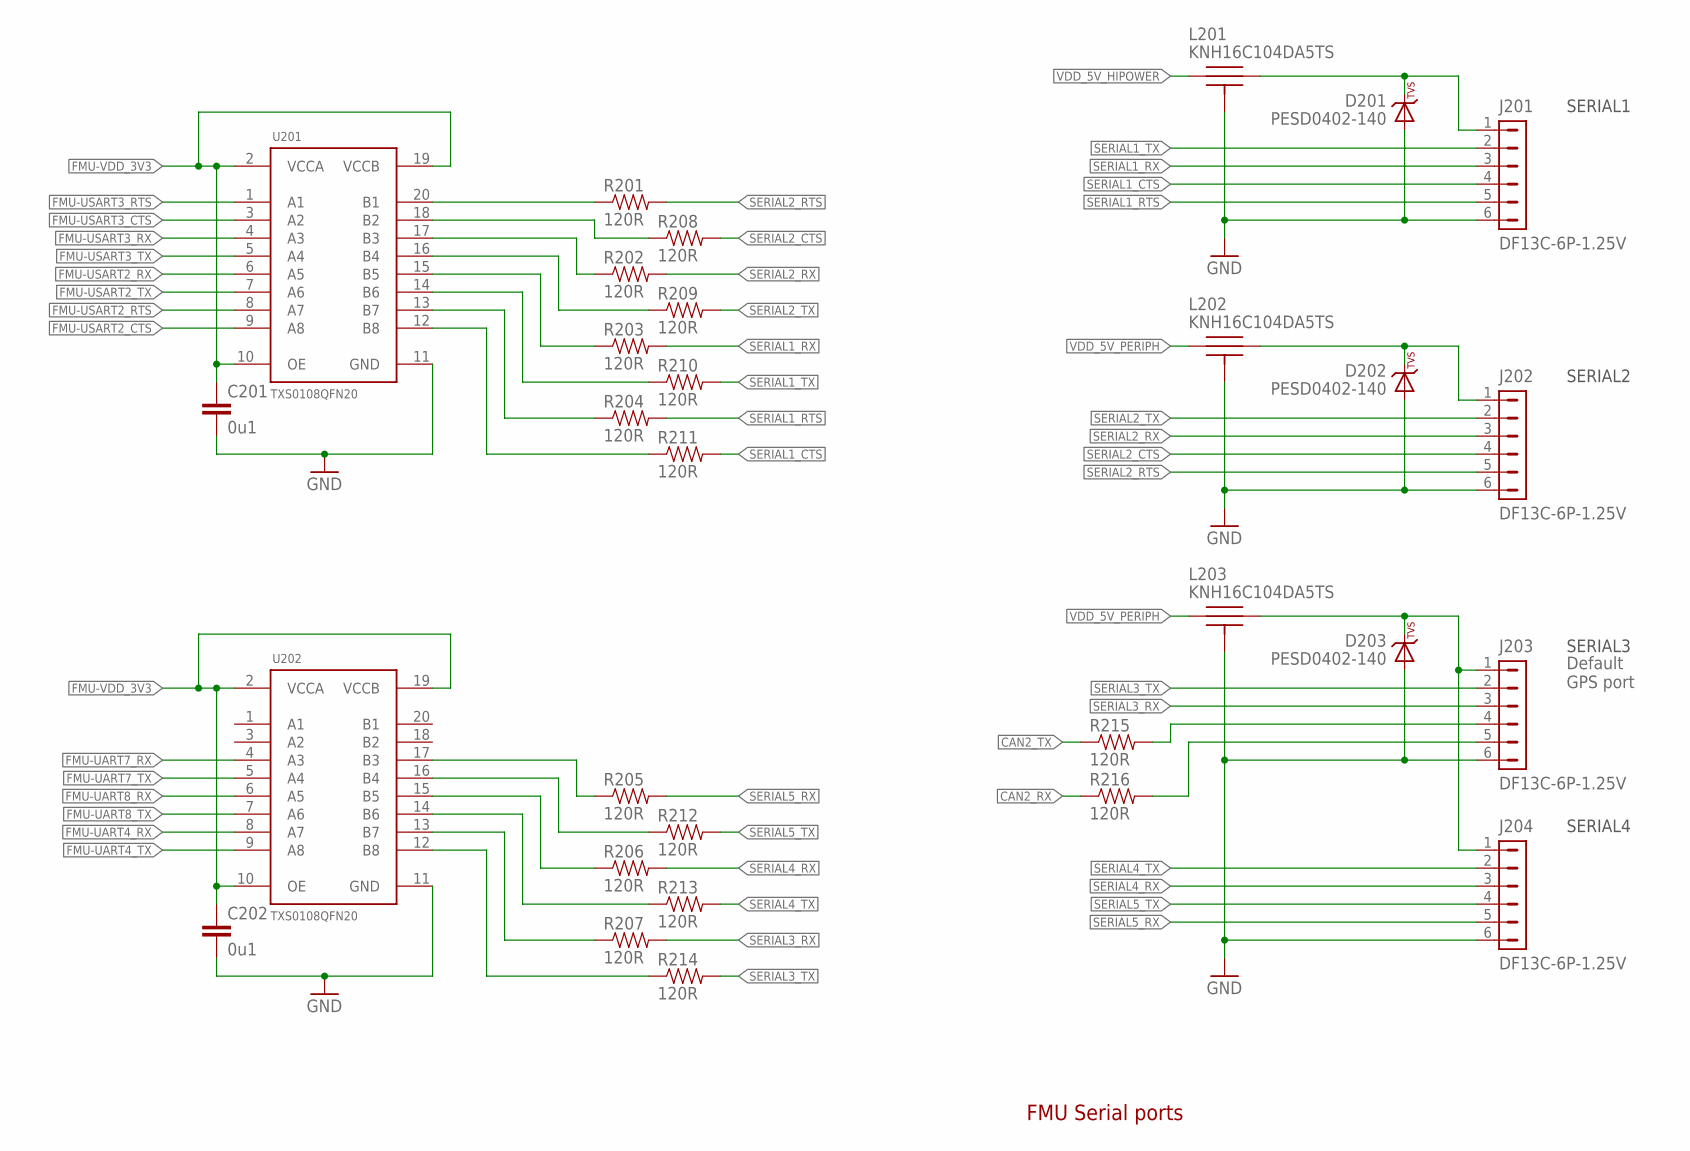
[picture p159: schematic PX4FMUv2.4.sch, sheet 2]

Parts:
C201, C202: 0u1; 0402-CAP; PARTNO CC0402ZRY5V7BB104
D201, D202, D203: PESD0402-140; 0402-TVS; PARTNO PESD0402-140
J201, J202, J203, J204: DF13C-6P-1.25V; PARTNO DF13C-6P-1.25V(20)
L201, L202, L203: KNH16C104DA5TS; KYOCERA-KNH16-DA; PARTNO KNH16C104DA5TS
R201, R202, R203, R204, R205, R206, R207, R208, R209, R210, R211, R212, R213, R214, R215, R216: 120R; 0402-RES; PARTNO RC0402FR-07120RL
U201, U202: TXS0108QFN20; QFN20-RGY; PARTNO TXS0108ERGYR

Connections:
CAN2_RX: R216.P$1 (1); also elsewhere on the board
CAN2_TX: R215.P$1 (1); also elsewhere on the board
FMU-UART4_RX: U202.8 (A7); also elsewhere on the board
FMU-UART4_TX: U202.9 (A8); also elsewhere on the board
FMU-UART7_RX: U202.4 (A3); also elsewhere on the board
FMU-UART7_TX: U202.5 (A4); also elsewhere on the board
FMU-UART8_RX: U202.6 (A5); also elsewhere on the board
FMU-UART8_TX: U202.7 (A6); also elsewhere on the board
FMU-USART2_CTS: U201.9 (A8); also elsewhere on the board
FMU-USART2_RTS: U201.8 (A7); also elsewhere on the board
FMU-USART2_RX: U201.6 (A5); also elsewhere on the board
FMU-USART2_TX: U201.7 (A6); also elsewhere on the board
FMU-USART3_CTS: U201.3 (A2); also elsewhere on the board
FMU-USART3_RTS: U201.1 (A1); also elsewhere on the board
FMU-USART3_RX: U201.4 (A3); also elsewhere on the board
FMU-USART3_TX: U201.5 (A4); also elsewhere on the board
FMU-VDD_3V3: C201.P$1 (1), C202.P$1 (1), U201.2 (VCCA), U201.10 (OE), U201.19 (VCCB), U202.2 (VCCA), U202.10 (OE), U202.19 (VCCB); also elsewhere on the board
GND: C201.P$2 (2), C202.P$2 (2), D201.A, D202.A, D203.A, J201.6, J202.6, J203.6, J204.6, L201.P$3, L201.P$4, L201.P$5, L202.P$3, L202.P$4, L202.P$5, L203.P$3, L203.P$4, L203.P$5, U201.11 (GND), U202.11 (GND); also elsewhere on the board
unnamed: D201.C, J201.1, L201.P$2
unnamed: J203.4, R215.P$2 (2)
unnamed: J203.5, R216.P$2 (2)
unnamed: R201.P$1 (1), U201.20 (B1)
unnamed: R208.P$1 (1), U201.18 (B2)
unnamed: R202.P$1 (1), U201.17 (B3)
unnamed: R209.P$1 (1), U201.16 (B4)
unnamed: R203.P$1 (1), U201.15 (B5)
unnamed: R210.P$1 (1), U201.14 (B6)
unnamed: R204.P$1 (1), U201.13 (B7)
unnamed: R211.P$1 (1), U201.12 (B8)
unnamed: R207.P$1 (1), U202.13 (B7)
unnamed: R214.P$1 (1), U202.12 (B8)
unnamed: R205.P$1 (1), U202.17 (B3)
unnamed: R212.P$1 (1), U202.16 (B4)
unnamed: R206.P$1 (1), U202.15 (B5)
unnamed: R213.P$1 (1), U202.14 (B6)
unnamed: D203.C, J203.1, J204.1, L203.P$2
unnamed: D202.C, J202.1, L202.P$2
SERIAL1_CTS: J201.4, R211.P$2 (2)
SERIAL1_RTS: J201.5, R204.P$2 (2)
SERIAL1_RX: J201.3, R203.P$2 (2); also elsewhere on the board
SERIAL1_TX: J201.2, R210.P$2 (2); also elsewhere on the board
SERIAL2_CTS: J202.4, R208.P$2 (2)
SERIAL2_RTS: J202.5, R201.P$2 (2)
SERIAL2_RX: J202.3, R202.P$2 (2); also elsewhere on the board
SERIAL2_TX: J202.2, R209.P$2 (2); also elsewhere on the board
SERIAL3_RX: J203.3, R207.P$2 (2); also elsewhere on the board
SERIAL3_TX: J203.2, R214.P$2 (2); also elsewhere on the board
SERIAL4_RX: J204.3, R206.P$2 (2); also elsewhere on the board
SERIAL4_TX: J204.2, R213.P$2 (2); also elsewhere on the board
SERIAL5_RX: J204.5, R205.P$2 (2); also elsewhere on the board
SERIAL5_TX: J204.4, R212.P$2 (2); also elsewhere on the board
VDD_5V_HIPOWER: L201.P$1; also elsewhere on the board
VDD_5V_PERIPH: L202.P$1, L203.P$1; also elsewhere on the board

Notes on the sheet:
FMU Serial ports
SERIAL2
SERIAL1
SERIAL3
SERIAL4
Default GPS port

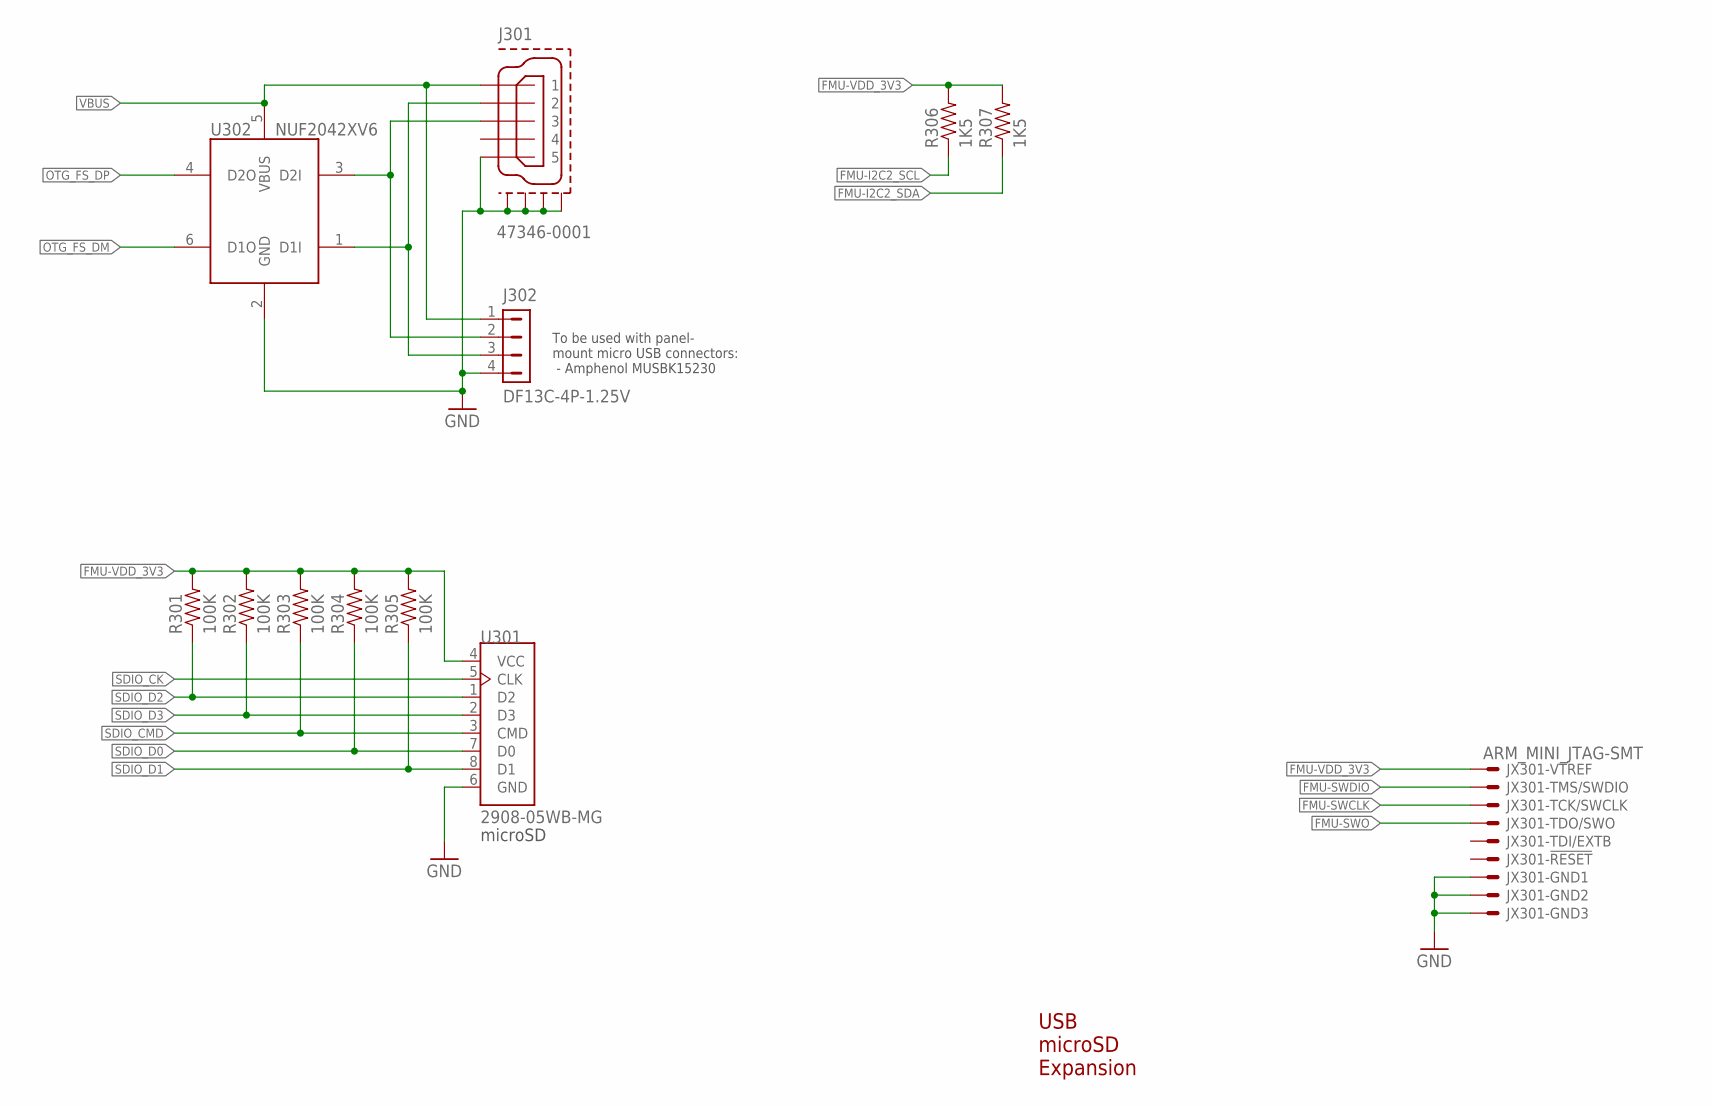
[picture p160: schematic PX4FMUv2.4.sch, sheet 3]

Parts:
J301: 47346-0001; MOLEX-47346-0001; PARTNO 47346-0001
J302: DF13C-4P-1.25V; PARTNO DF13C-4P-1.25V(20)
JX301: ARM_MINI_JTAG-SMT; FTSH-105-01-XXX-DV-K; PARTNO M50-3900542
R301, R302, R303, R304, R305: 100K; 0402-RES; PARTNO RC0402FR-07100KL
R306, R307: 1K5; 0402-RES; PARTNO RC0402FR-071K5L
U301: 2908-05WB-MG; MICROSD; PARTNO 2908-05WB-MG
U302: NUF2042XV6; SOT563-6; PARTNO NUF2042XV6T1G

Connections:
FMU-I2C2_SCL: R306.P$1 (1); also elsewhere on the board
FMU-I2C2_SDA: R307.P$1 (1); also elsewhere on the board
FMU-SWCLK: JX301.4; also elsewhere on the board
FMU-SWDIO: JX301.2; also elsewhere on the board
FMU-SWO: JX301.6; also elsewhere on the board
FMU-VDD_3V3: JX301.1, R301.P$2 (2), R302.P$2 (2), R303.P$2 (2), R304.P$2 (2), R305.P$2 (2), R306.P$2 (2), R307.P$2 (2), U301.4 (VCC); also elsewhere on the board
GND: J301.GND (5), J301.GND1, J301.GND2, J301.GND3, J301.GND4, J302.4, JX301.3, JX301.5, JX301.9, U301.6 (GND), U302.2 (GND); also elsewhere on the board
OTG_DM1: J301.D- (2), J302.3, U302.1 (D1I)
OTG_DP1: J301.D+ (3), J302.2, U302.3 (D2I)
OTG_FS_DM: U302.6 (D1O); also elsewhere on the board
OTG_FS_DP: U302.4 (D2O); also elsewhere on the board
SDIO_CK: U301.5 (CLK); also elsewhere on the board
SDIO_CMD: R303.P$1 (1), U301.3 (CMD); also elsewhere on the board
SDIO_D0: R304.P$1 (1), U301.7 (D0); also elsewhere on the board
SDIO_D1: R305.P$1 (1), U301.8 (D1); also elsewhere on the board
SDIO_D2: R301.P$1 (1), U301.1 (D2); also elsewhere on the board
SDIO_D3: R302.P$1 (1), U301.2 (D3); also elsewhere on the board
VBUS: J301.VBUS (1), J302.1, U302.5 (VBUS); also elsewhere on the board

Notes on the sheet:
USB microSD Expansion
microSD
To be used with panel- mount micro USB connectors: - Amphenol MUSBK15230

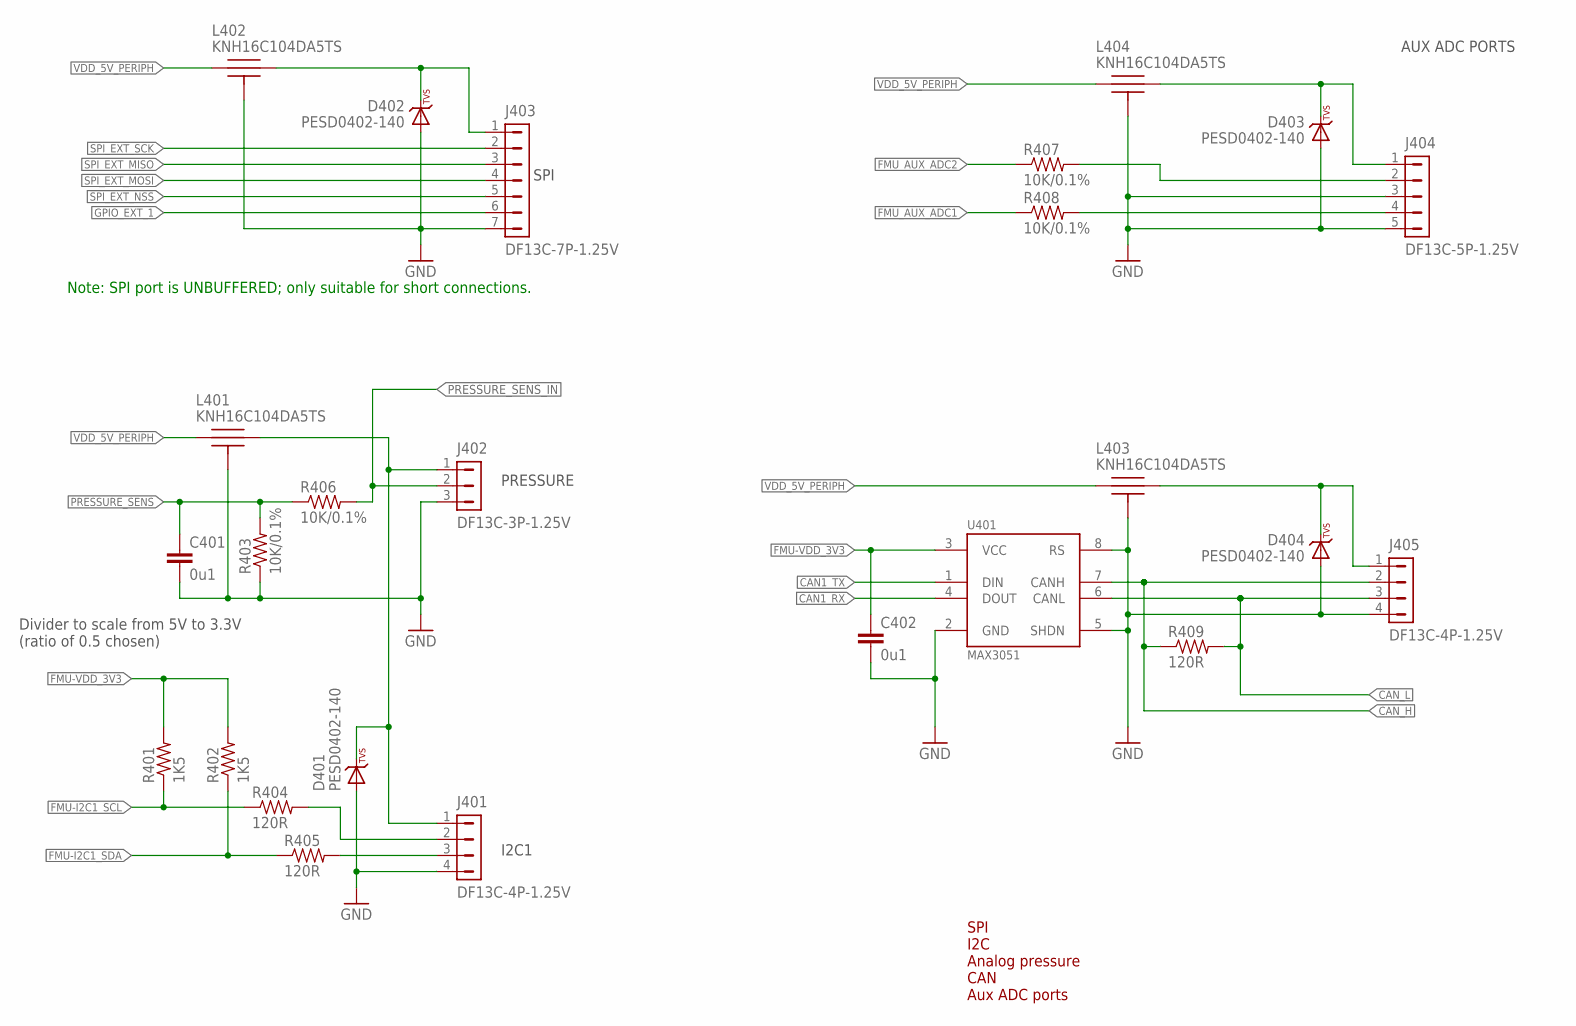
[picture p161: schematic PX4FMUv2.4.sch, sheet 4]

Parts:
C401, C402: 0u1; 0402-CAP; PARTNO CC0402ZRY5V7BB104
D401, D402, D403, D404: PESD0402-140; 0402-TVS; PARTNO PESD0402-140
J401, J405: DF13C-4P-1.25V; PARTNO DF13C-4P-1.25V(20)
J402: DF13C-3P-1.25V; PARTNO DF13C-3P-1.25V(20)
J403: DF13C-7P-1.25V; PARTNO DF13C-7P-1.25V(20)
J404: DF13C-5P-1.25V; PARTNO DF13C-5P-1.25V(20)
L401, L402, L403, L404: KNH16C104DA5TS; KYOCERA-KNH16-DA; PARTNO KNH16C104DA5TS
R401, R402: 1K5; 0402-RES; PARTNO RC0402FR-071K5L
R403, R406, R407, R408: 10K/0.1%; 0402-RES; PARTNO ERA-2AEB103X
R404, R405, R409: 120R; 0402-RES; PARTNO RC0402FR-07120RL
U401: MAX3051; SOT23-8; PARTNO MAX3051EKA

Connections:
!SPI_EXT_NSS: J403.5; also elsewhere on the board
CAN1_RX: U401.4 (DOUT); also elsewhere on the board
CAN1_TX: U401.1 (DIN); also elsewhere on the board
CAN_H: J405.2, R409.P$1 (1), U401.7 (CANH); also elsewhere on the board
CAN_L: J405.3, R409.P$2 (2), U401.6 (CANL); also elsewhere on the board
FMU-I2C1_SCL: R401.P$1 (1), R404.P$1 (1); also elsewhere on the board
FMU-I2C1_SDA: R402.P$1 (1), R405.P$1 (1); also elsewhere on the board
FMU-VDD_3V3: C402.P$1 (1), R401.P$2 (2), R402.P$2 (2), U401.3 (VCC); also elsewhere on the board
FMU_AUX_ADC1: R408.P$1 (1); also elsewhere on the board
FMU_AUX_ADC1_PROT: J404.4, R408.P$2 (2)
FMU_AUX_ADC2: R407.P$1 (1); also elsewhere on the board
FMU_AUX_ADC2_PROT: J404.2, R407.P$2 (2)
GND: C401.P$2 (2), C402.P$2 (2), D401.A, D402.A, D403.A, D404.A, J401.4, J402.3, J403.7, J404.3, J404.5, J405.4, L401.P$3, L401.P$4, L401.P$5, L402.P$3, L402.P$4, L402.P$5, L403.P$3, L403.P$4, L403.P$5, L404.P$3, L404.P$4, L404.P$5, R403.P$1 (1), U401.2 (GND), U401.5 (SHDN), U401.8 (RS); also elsewhere on the board
GPIO_EXT_1: J403.6; also elsewhere on the board
unnamed: J401.2, R404.P$2 (2)
unnamed: J401.3, R405.P$2 (2)
unnamed: D402.C, J403.1, L402.P$2
unnamed: D401.C, J401.1, J402.1, L401.P$2
unnamed: D404.C, J405.1, L403.P$2
unnamed: D403.C, J404.1, L404.P$2
PRESSURE_SENS: C401.P$1 (1), R403.P$2 (2), R406.P$1 (1); also elsewhere on the board
PRESSURE_SENS_IN: J402.2, R406.P$2 (2); also elsewhere on the board
SPI_EXT_MISO: J403.3; also elsewhere on the board
SPI_EXT_MOSI: J403.4; also elsewhere on the board
SPI_EXT_SCK: J403.2; also elsewhere on the board
VDD_5V_PERIPH: L401.P$1, L402.P$1, L403.P$1, L404.P$1; also elsewhere on the board

Notes on the sheet:
SPI
PRESSURE
I2C1
AUX ADC PORTS
SPI I2C Analog pressure CAN Aux ADC ports
Note: SPI port is UNBUFFERED; only suitable for short connections.
Divider to scale from 5V to 3.3V (ratio of 0.5 chosen)
