Jonathon-Reilly/Kicad/kicad-resources/kicad-tools/eagle-to-kicad/examples/PIXHAWK/eagle_original_files/PX4FMUv2.4.brd

## EAGLE design kicad-resources/kicad-tools/eagle-to-kicad/examples/PIXHAWK/eagle_original_files/PX4FMUv2.4.brd (continued)

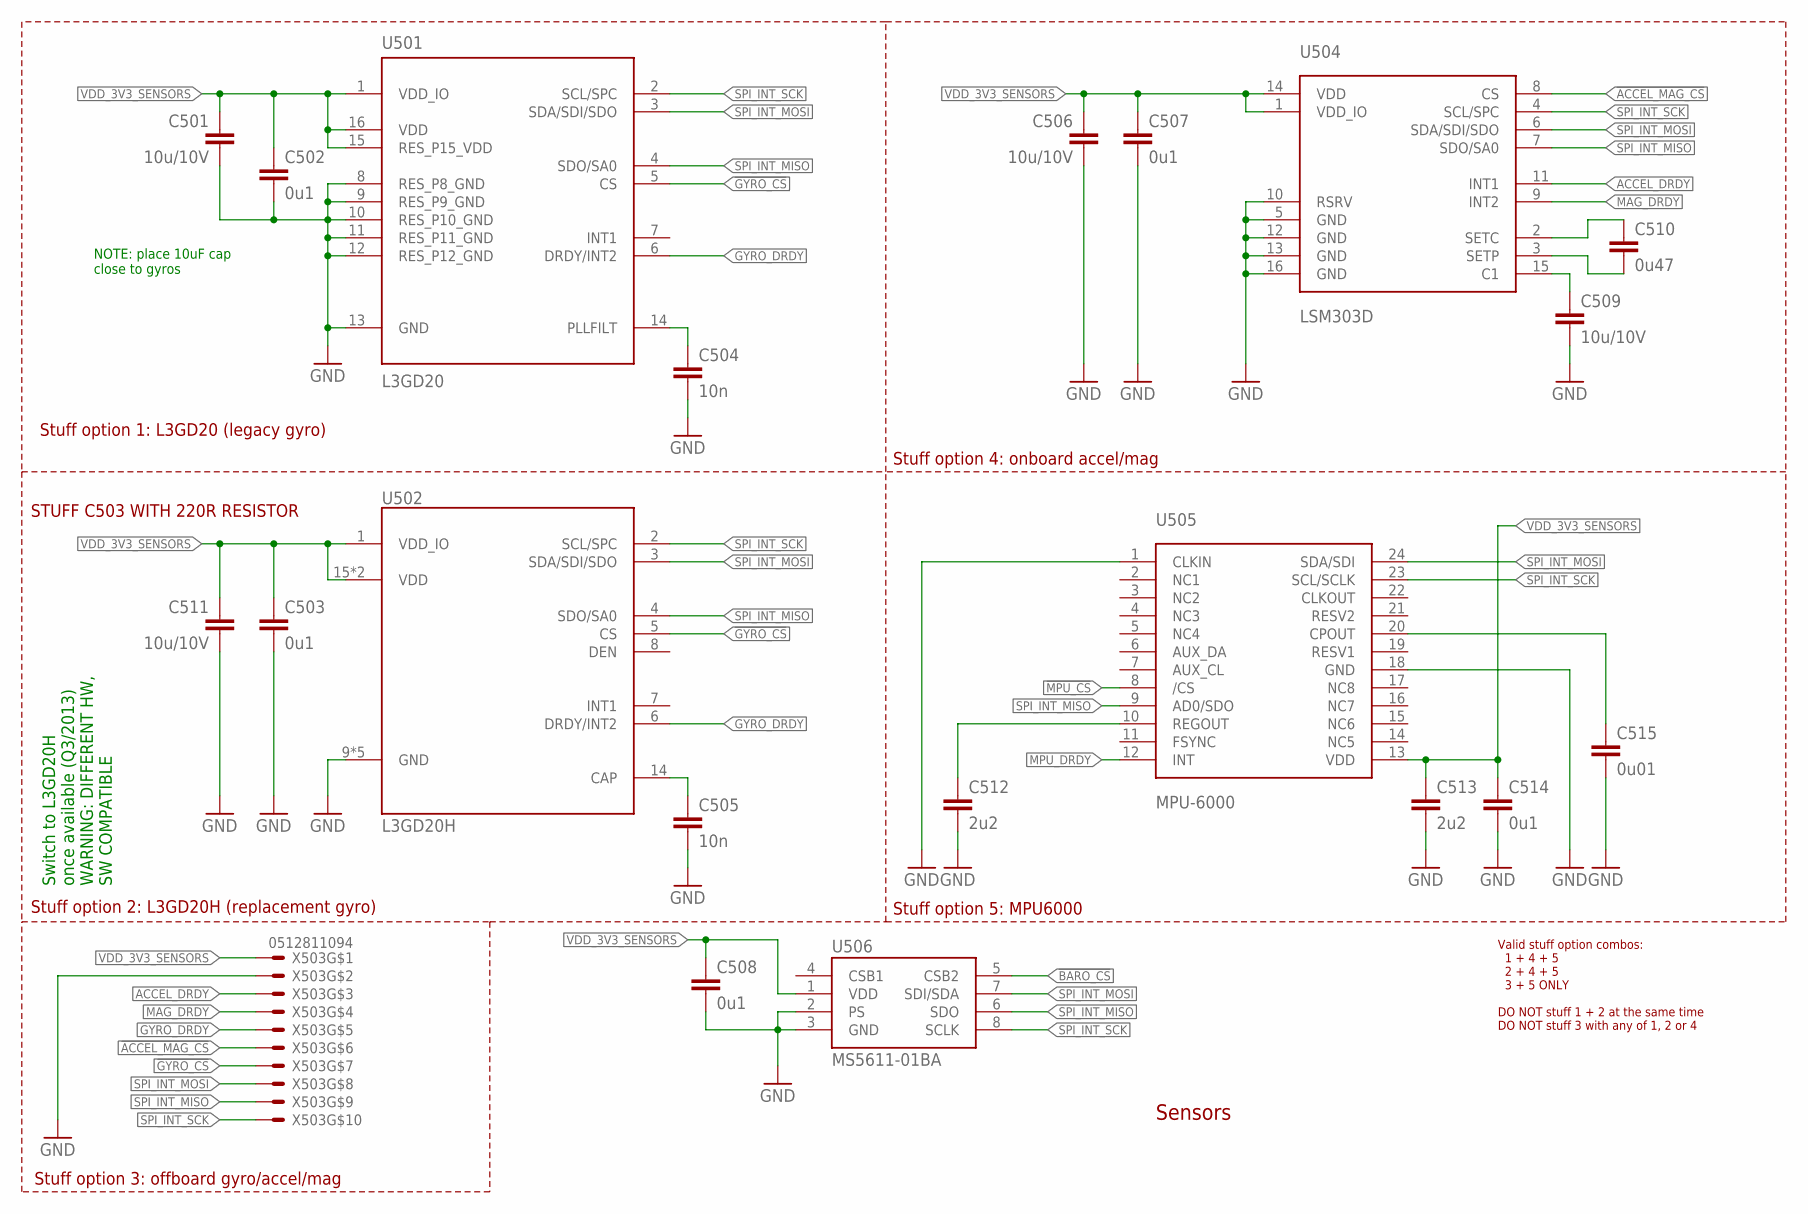
[picture p162: schematic PX4FMUv2.4.sch, sheet 5]

Parts:
C501, C506, C509, C511: 10u/10V; 0805-CAP; PARTNO CC0805ZKY5V6BB106
C502, C503, C507, C508, C514: 0u1; 0402-CAP; PARTNO CC0402ZRY5V7BB104
C504, C505: 10n; 0402-CAP; PARTNO CC0402KRX7R7BB103
C510: 0u47; 0402-CAP; PARTNO C1005X5R1C474K050BC
C512, C513: 2u2; 0603-CAP; PARTNO CC0402ZRY5V7BB104
C515: 0u01; 0603-CAP; PARTNO GRM155R71E103JA01J
U501: L3GD20; L3G4200DH-MAN; PARTNO L3GD20
U502: L3GD20H; LGA-16L; PARTNO L3GD20H
U504: LSM303D; LGA-16L; PARTNO LSM303D
U505: MPU-6000; QFN-24; PARTNO MPU-6000
U506: MS5611-01BA; PARTNO MS5611-01BA
X503: 0512811094; 51281-1094; PARTNO 0781191109

Connections:
!ACCEL_MAG_CS: U504.8 (CS), X503.6; also elsewhere on the board
!BARO_CS: U506.5 (CSB2); also elsewhere on the board
!GYRO_CS: U501.5 (CS), U502.5 (CS), X503.7; also elsewhere on the board
!MPU_CS: U505.8 (/CS); also elsewhere on the board
ACCEL_DRDY: U504.11 (INT1), X503.3; also elsewhere on the board
GND: C501.P$2 (2), C502.P$2 (2), C503.P$2 (2), C504.P$2 (2), C505.P$2 (2), C506.P$2 (2), C507.P$2 (2), C508.P$2 (2), C509.P$2 (2), C511.P$2 (2), C512.P$2 (2), C513.P$2 (2), C514.P$2 (2), C515.P$2 (2), U501.8 (RES_P8_GND), U501.9 (RES_P9_GND), U501.10 (RES_P10_GND), U501.11 (RES_P11_GND), U501.12 (RES_P12_GND), U501.13 (GND), U502.9 (GND), U502.10 (GND), U502.11 (GND), U502.12 (GND), U502.13 (GND), U504.5 (GND), U504.10 (RSRV), U504.12 (GND), U504.13 (GND), U504.16 (GND), U505.1 (CLKIN), U505.18 (GND), U506.2 (PS), U506.3 (GND), X503.2; also elsewhere on the board
GYRO_DRDY: U501.6 (DRDY/INT2), U502.6 (DRDY/INT2), X503.5; also elsewhere on the board
MAG_DRDY: U504.9 (INT2), X503.4; also elsewhere on the board
MPU_DRDY: U505.12 (INT); also elsewhere on the board
unnamed: C509.P$1 (1), U504.15 (C1)
unnamed: C510.P$1 (1), U504.2 (SETC)
unnamed: C510.P$2 (2), U504.3 (SETP)
unnamed: C505.P$1 (1), U502.14 (CAP)
unnamed: C504.P$1 (1), U501.14 (PLLFILT)
unnamed: C512.P$1 (1), U505.10 (REGOUT)
unnamed: C515.P$1 (1), U505.20 (CPOUT)
SPI_INT_MISO: U501.4 (SDO/SA0), U502.4 (SDO/SA0), U504.7 (SDO/SA0), U505.9 (AD0/SDO), U506.6 (SDO), X503.9; also elsewhere on the board
SPI_INT_MOSI: U501.3 (SDA/SDI/SDO), U502.3 (SDA/SDI/SDO), U504.6 (SDA/SDI/SDO), U505.24 (SDA/SDI), U506.7 (SDI/SDA), X503.8; also elsewhere on the board
SPI_INT_SCK: U501.2 (SCL/SPC), U502.2 (SCL/SPC), U504.4 (SCL/SPC), U505.23 (SCL/SCLK), U506.8 (SCLK), X503.10; also elsewhere on the board
VDD_3V3_SENSORS: C501.P$1 (1), C502.P$1 (1), C503.P$1 (1), C506.P$1 (1), C507.P$1 (1), C508.P$1 (1), C511.P$1 (1), C513.P$1 (1), C514.P$1 (1), U501.1 (VDD_IO), U501.15 (RES_P15_VDD), U501.16 (VDD), U502.1 (VDD_IO), U502.15 (VDD), U502.16 (VDD), U504.1 (VDD_IO), U504.14 (VDD), U505.13 (VDD), U506.1 (VDD), X503.1; also elsewhere on the board

Notes on the sheet:
Sensors
Switch to L3GD20H once available (Q3/2013) WARNING: DIFFERENT HW, SW COMPATIBLE
NOTE: place 10uF cap close to gyros
Stuff option 1: L3GD20 (legacy gyro)
Stuff option 2: L3GD20H (replacement gyro)
Stuff option 4: onboard accel/mag
Valid stuff option combos: 1 + 4 + 5 2 + 4 + 5 3 + 5 ONLY DO NOT stuff 1 + 2 at the same time DO NOT stuff 3 with any of 1, 2 or 4
Stuff option 5: MPU6000
Stuff option 3: offboard gyro/accel/mag
STUFF C503 WITH 220R RESISTOR

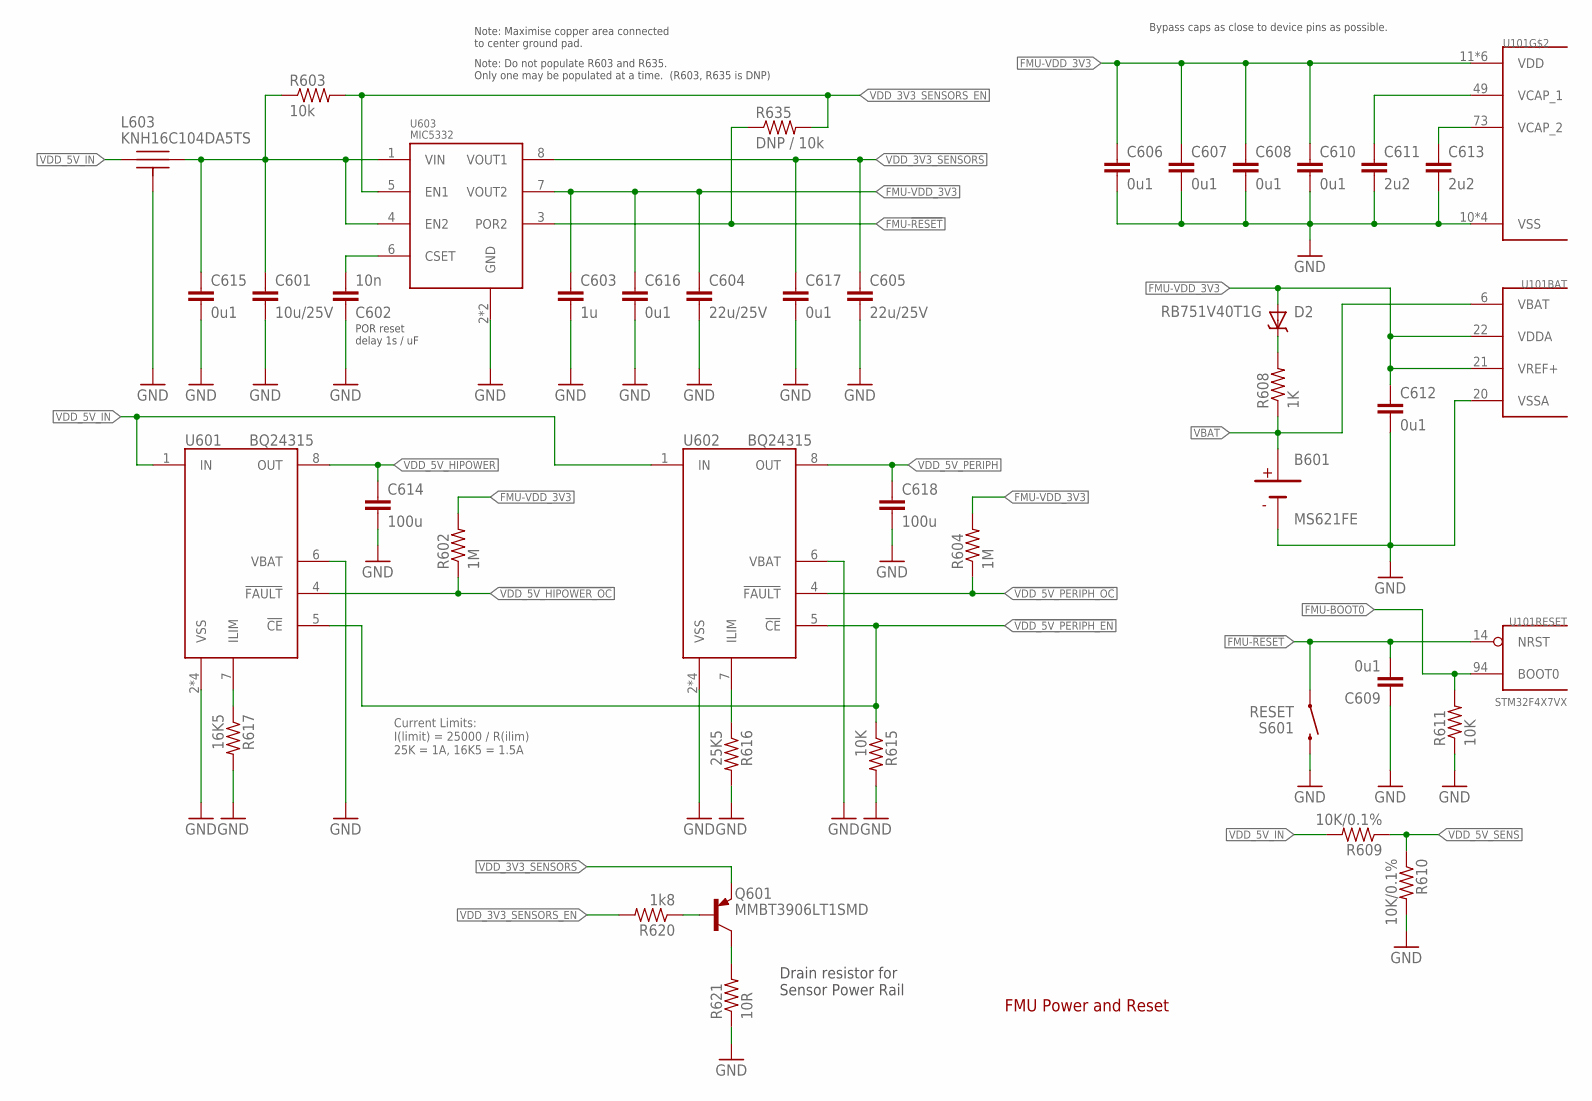
[picture p163: schematic PX4FMUv2.4.sch, sheet 6]

Parts:
B601: MS621FE; PARTNO MS621FE-FL11E
C601: 10u/25V; 0805-CAP; PARTNO CL21A106KAYNNNE
C602: 10n; 0402-CAP; PARTNO CC0402KRX7R7BB103
C603: 1u; 0603-CAP; PARTNO CC0603ZRY5V7BB105
C604, C605: 22u/25V; 0805-CAP; PARTNO CL21A226MAQNNNE
C606, C607, C608, C609, C610, C612, C615, C616, C617: 0u1; 0402-CAP; PARTNO CC0402ZRY5V7BB104
C611, C613: 2u2; 0603-CAP; PARTNO C1608Y5V1C225Z
C614, C618: 100u; 1206-CAP; PARTNO C3216X5R1A107M160AC
D2: RB751V40T1G; SOD323; PARTNO RB751V40T1G
L603: KNH16C104DA5TS; KYOCERA-KNH16-DA; PARTNO KNH16C104DA5TS
Q601: MMBT3906LT1SMD; SOT23-BEC; PARTNO MMBT 3906 LT1
R602, R604: 1M; 0402-RES; PARTNO RC0402FR-071ML
R603: 10k; 0402-RES; PARTNO RC0402FR-0710KL
R608: 1K; 0402-RES; PARTNO RC0402FR-071KL
R609, R610: 10K/0.1%; 0402-RES; PARTNO ERA-2AEB103X
R611, R615: 10K; 0402-RES; PARTNO RC0402FR-0710KL
R616: 25K5; 0402-RES; PARTNO RMCF0402FT25K5
R617: 16K5; 0402-RES; PARTNO RMCF0402FT16K5
R620: 1k8; 0402-RES; PARTNO RC1005F182CS
R621: 10R; 0603-RES; PARTNO RC1608J100CS
R635: DNP / 10k; 0402-RES; PARTNO RC0402FR-0710KL
S601: RESET; EVQP7J01K; PARTNO EVQP7J01K
U101: STM32F4X7VX; TQFP100; PARTNO STM32F427VI
U601, U602: BQ24315; QFN8-DSG; PARTNO BQ24315DSGR
U603: MIC5332; MLF-8-EPAD; PARTNO MIC5332-SSYMT

Connections:
!VDD_5V_HIPOWER_OC: R602.P$1 (1), U601.4 (!FAULT); also elsewhere on the board
!VDD_5V_PERIPH_EN: R615.P$1 (1), U601.5 (!CE), U602.5 (!CE); also elsewhere on the board
!VDD_5V_PERIPH_OC: R604.P$1 (1), U602.4 (!FAULT); also elsewhere on the board
FMU-!RESET: C609.P$2 (2), R635.P$1 (1), S601.A1 (1), U101.14 (NRST), U603.3 (POR2); also elsewhere on the board
FMU-BOOT0: R611.P$2 (2), U101.94 (BOOT0); also elsewhere on the board
FMU-VDD_3V3: C603.P$1 (1), C604.P$1 (1), C606.P$1 (1), C607.P$1 (1), C608.P$1 (1), C610.P$1 (1), C612.P$1 (1), C616.P$1 (1), D2.A, R602.P$2 (2), R604.P$2 (2), U101.11 (VDD), U101.19 (VDD), U101.21 (VREF+), U101.22 (VDDA), U101.28 (VDD), U101.50 (VDD), U101.75 (VDD), U101.100 (VDD), U603.7 (VOUT2); also elsewhere on the board
FMU-VDD_5V5: C601.P$1 (1), C615.P$1 (1), L603.P$2, R603.P$1 (1), U603.1 (VIN), U603.4 (EN2)
GND: B601.2 (NEG), C601.P$2 (2), C602.P$1 (1), C603.P$2 (2), C604.P$2 (2), C605.P$2 (2), C606.P$2 (2), C607.P$2 (2), C608.P$2 (2), C609.P$1 (1), C610.P$2 (2), C611.P$2 (2), C612.P$2 (2), C613.P$2 (2), C614.P$2 (2), C615.P$2 (2), C616.P$2 (2), C617.P$2 (2), C618.P$2 (2), L603.P$3, L603.P$4, L603.P$5, R610.P$2 (2), R611.P$1 (1), R615.P$2 (2), R616.P$2 (2), R617.P$2 (2), R621.1, S601.B3 (2), U101.10 (VSS), U101.20 (VSSA), U101.27 (VSS), U101.74 (VSS), U101.99 (VSS), U601.2 (VSS), U601.6 (VBAT), U601.GND (VSS), U601.P$2 (VSS), U601.P$3 (VSS), U602.2 (VSS), U602.6 (VBAT), U602.GND (VSS), U602.P$2 (VSS), U602.P$3 (VSS), U603.2 (GND), U603.GND; also elsewhere on the board
unnamed: C613.P$1 (1), U101.73 (VCAP_2)
unnamed: C602.P$2 (2), U603.6 (CSET)
unnamed: C611.P$1 (1), U101.49 (VCAP_1)
unnamed: D2.C, R608.P$2 (2)
unnamed: R616.P$1 (1), U602.7 (ILIM)
unnamed: Q601.C, R621.2
unnamed: Q601.B, R620.P$1 (1)
unnamed: R617.P$1 (1), U601.7 (ILIM)
VBAT: B601.1 (POS), R608.P$1 (1), U101.6 (VBAT); also elsewhere on the board
VDD_3V3_SENSORS: C605.P$1 (1), C617.P$1 (1), Q601.E, U603.8 (VOUT1); also elsewhere on the board
VDD_3V3_SENSORS_EN: R603.P$2 (2), R620.P$2 (2), R635.P$2 (2), U603.5 (EN1); also elsewhere on the board
VDD_5V_HIPOWER: C614.P$1 (1), U601.8 (OUT); also elsewhere on the board
VDD_5V_IN: L603.P$1, R609.P$2 (2), U601.1 (IN), U602.1 (IN); also elsewhere on the board
VDD_5V_PERIPH: C618.P$1 (1), U602.8 (OUT); also elsewhere on the board
VDD_5V_SENS: R609.P$1 (1), R610.P$1 (1); also elsewhere on the board

Notes on the sheet:
FMU Power and Reset
Bypass caps as close to device pins as possible.
Note: Maximise copper area connected to center ground pad.
POR reset delay 1s / uF
Current Limits: I(limit) = 25000 / R(ilim) 25K = 1A, 16K5 = 1.5A
Drain resistor for Sensor Power Rail
Note: Do not populate R603 and R635. Only one may be populated at a time. (R603, R635 is DNP)

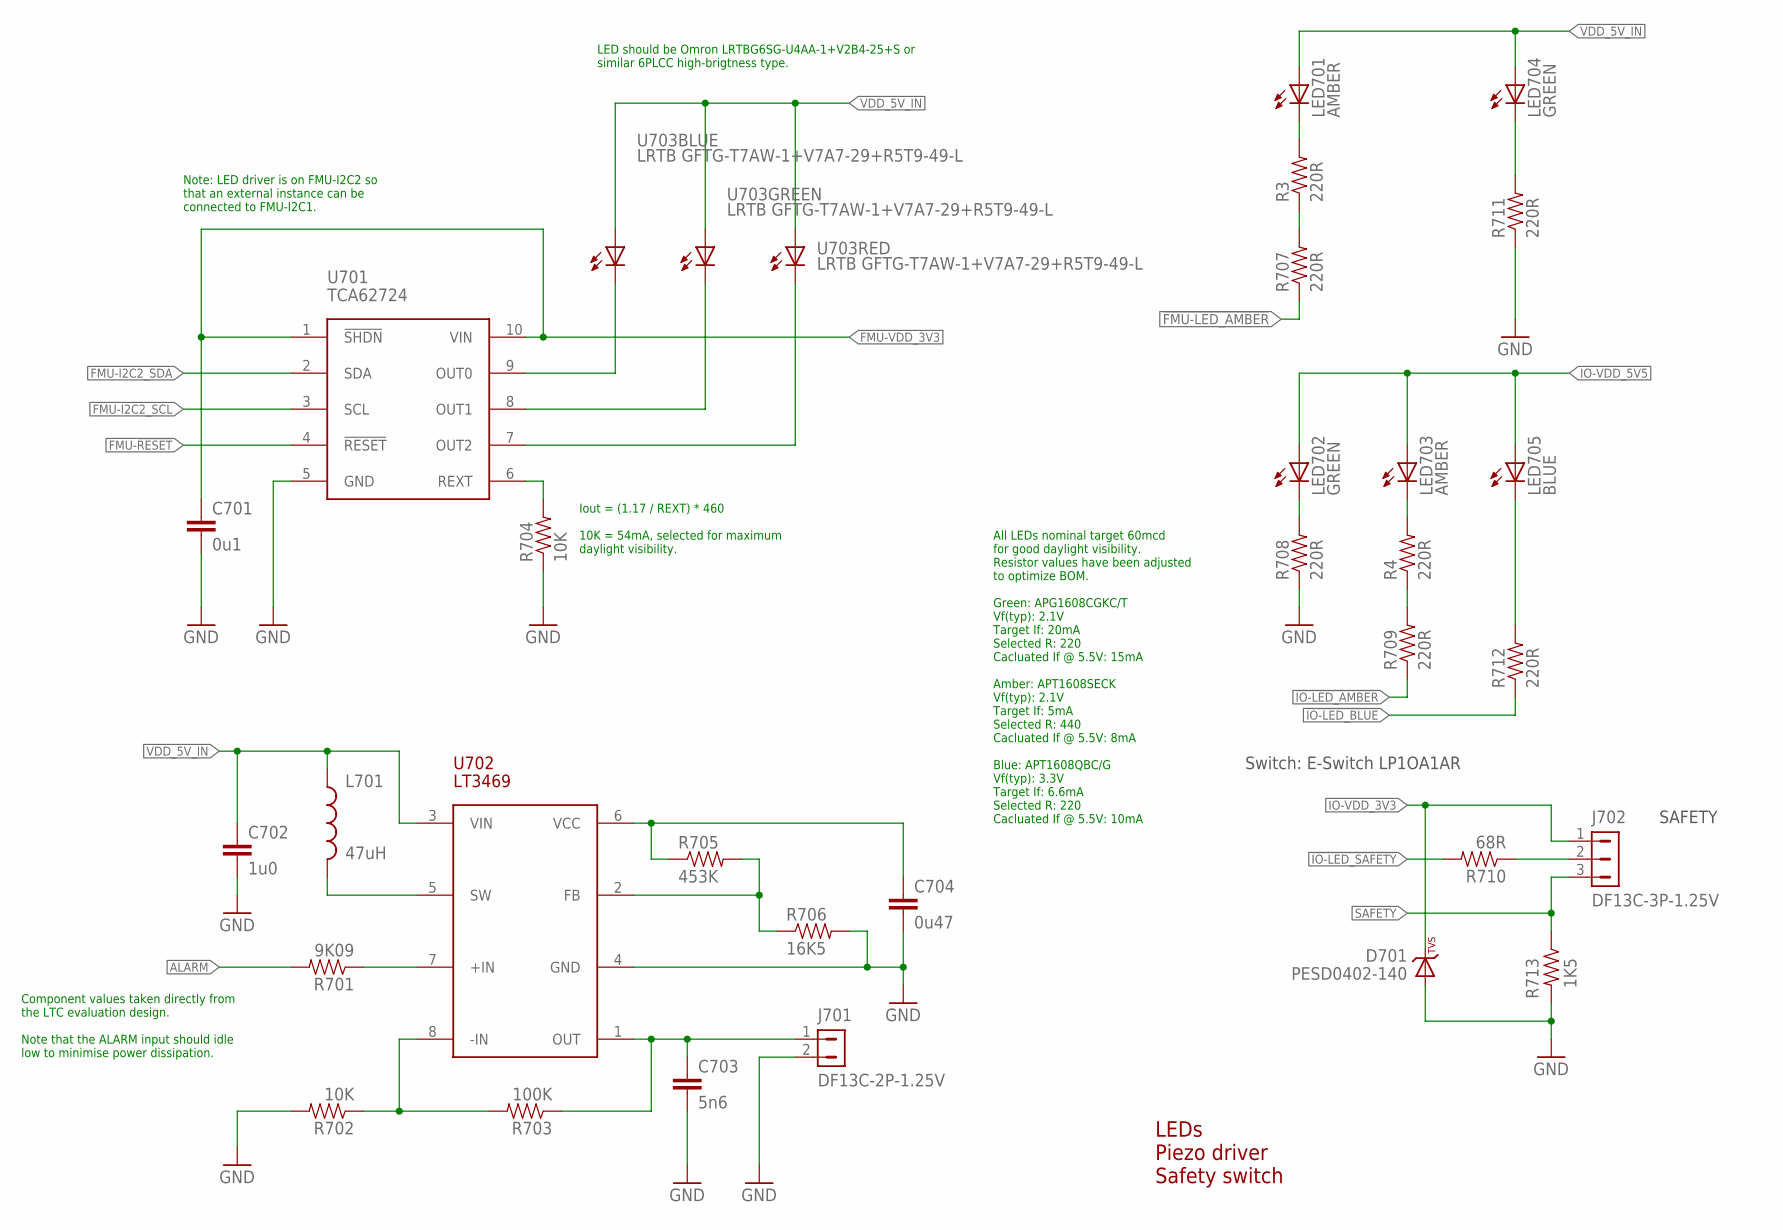
[picture p164: schematic PX4FMUv2.4.sch, sheet 7]

Parts:
C701: 0u1; 0402-CAP; PARTNO CC0402ZRY5V7BB104
C702: 1u0; 0603-CAP; PARTNO CC0603ZRY5V7BB105
C703: 5n6; 0402-CAP; PARTNO CC0402KRX7R7BB562
C704: 0u47; 0402-CAP; PARTNO C1005X5R1C474K050BC
D701: PESD0402-140; 0402-TVS; PARTNO PESD0402-140
J701: DF13C-2P-1.25V; PARTNO DF13C-2P-1.25V(20)
J702: DF13C-3P-1.25V; PARTNO DF13C-3P-1.25V(20)
L701: 47uH; 0805-IND; PARTNO MLZ2012M470W
LED701, LED703: AMBER; 0603-LED; PARTNO APTD1608SECK
LED702, LED704: GREEN; 0603-LED; PARTNO APTD1608CGCK
LED705: BLUE; 0603-LED; PARTNO APTD1608QBC/D
R3, R4, R707, R708, R709, R711, R712: 220R; 0402-RES; PARTNO RC0402FR-07220RL
R701: 9K09; 0402-RES; PARTNO RMCF0402FT9K09
R702, R704: 10K; 0402-RES; PARTNO RC0402FR-0710KL
R703: 100K; 0402-RES; PARTNO RC0402FR-07100KL
R705: 453K; 0402-RES; PARTNO RMCF0402FT453K
R706: 16K5; 0402-RES; PARTNO RMCF0402FT16K5
R710: 68R; 0402-RES; PARTNO ERJ-2GEJ680X
R713: 1K5; 0402-RES; PARTNO RC0402FR-071K5L
U701: TCA62724FMG; SON10; PARTNO TCA62724FMG
U702: LT3469; SOT23-8; PARTNO LT3469ETS8
U703: LRTB GFTG-T7AW-1+V7A7-29+R5T9-49-L; 6-PLCC; PARTNO LRTB GFTG-T7AW-1+V7A7-29+R5T9-49-L

Connections:
!FMU-LED_AMBER: R707.P$1 (1); also elsewhere on the board
!IO-LED_AMBER: R709.P$1 (1); also elsewhere on the board
!IO-LED_BLUE: R712.P$1 (1); also elsewhere on the board
!IO-LED_SAFETY: R710.P$2 (2); also elsewhere on the board
ALARM: R701.P$2 (2); also elsewhere on the board
FMU-!RESET: U701.4 (!RESET); also elsewhere on the board
FMU-I2C2_SCL: U701.3 (SCL); also elsewhere on the board
FMU-I2C2_SDA: U701.2 (SDA); also elsewhere on the board
FMU-VDD_3V3: C701.P$1 (1), U701.1 (!SHDN), U701.10 (VIN); also elsewhere on the board
GND: C701.P$2 (2), C702.P$2 (2), C703.P$2 (2), C704.P$2 (2), D701.A, J701.2, R702.P$2 (2), R704.P$1 (1), R706.P$2 (2), R708.P$1 (1), R711.P$1 (1), R713.P$2 (2), U701.5 (GND), U702.4 (GND); also elsewhere on the board
IO-VDD_3V3: D701.C, J702.1; also elsewhere on the board
IO-VDD_5V5: LED702.A, LED703.A, LED705.A; also elsewhere on the board
unnamed: LED704.C, R711.P$2 (2)
unnamed: LED705.C, R712.P$2 (2)
unnamed: R3.P$1 (1), R707.P$2 (2)
unnamed: R705.P$2 (2), R706.P$1 (1), U702.2 (FB)
unnamed: R702.P$1 (1), R703.P$2 (2), U702.8 (-IN)
unnamed: LED701.C, R3.P$2 (2)
unnamed: C703.P$1 (1), J701.1, R703.P$1 (1), U702.1 (OUT)
unnamed: R701.P$1 (1), U702.7 (+IN)
unnamed: LED702.C, R708.P$2 (2)
unnamed: L701.P$2 (2), U702.5 (SW)
unnamed: C704.P$1 (1), R705.P$1 (1), U702.6 (VCC)
unnamed: R4.P$1 (1), R709.P$2 (2)
unnamed: LED703.C, R4.P$2 (2)
unnamed: J702.2, R710.P$1 (1)
unnamed: R704.P$2 (2), U701.6 (REXT)
RGB_LED_3: U701.9 (OUT0), U703.C1 (C)
RGB_LED_4: U701.8 (OUT1), U703.C2 (C)
RGB_LED_14: U701.7 (OUT2), U703.C3 (C)
SAFETY: J702.3, R713.P$1 (1); also elsewhere on the board
VDD_5V_IN: C702.P$1 (1), L701.P$1 (1), LED701.A, LED704.A, U702.3 (VIN), U703.A1 (A), U703.A2 (A), U703.A3 (A); also elsewhere on the board

Notes on the sheet:
LEDs Piezo driver Safety switch
Switch: E-Switch LP1OA1AR
SAFETY
LED should be Omron LRTBG6SG-U4AA-1+V2B4-25+S or similar 6PLCC high-brigtness type.
Iout = (1.17 / REXT) * 460 10K = 54mA, selected for maximum daylight visibility.
Note: LED driver is on FMU-I2C2 so that an external instance can be connected to FMU-I2C1.
All LEDs nominal target 60mcd for good daylight visibility. Resistor values have been adjusted to optimize BOM. Green: APG1608CGKC/T Vf(typ): 2.1V Target If: 20mA Selected R: 220 Cacluated If @ 5.5V: 15mA Amber: APT1608SECK Vf(typ): 2.1V Target If: 5mA Selected R: 440 Cacluated If @ 5.5V: 8mA Blue: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
Component values taken directly from the LTC evaluation design. Note that the ALARM input should idle low to minimise power dissipation.

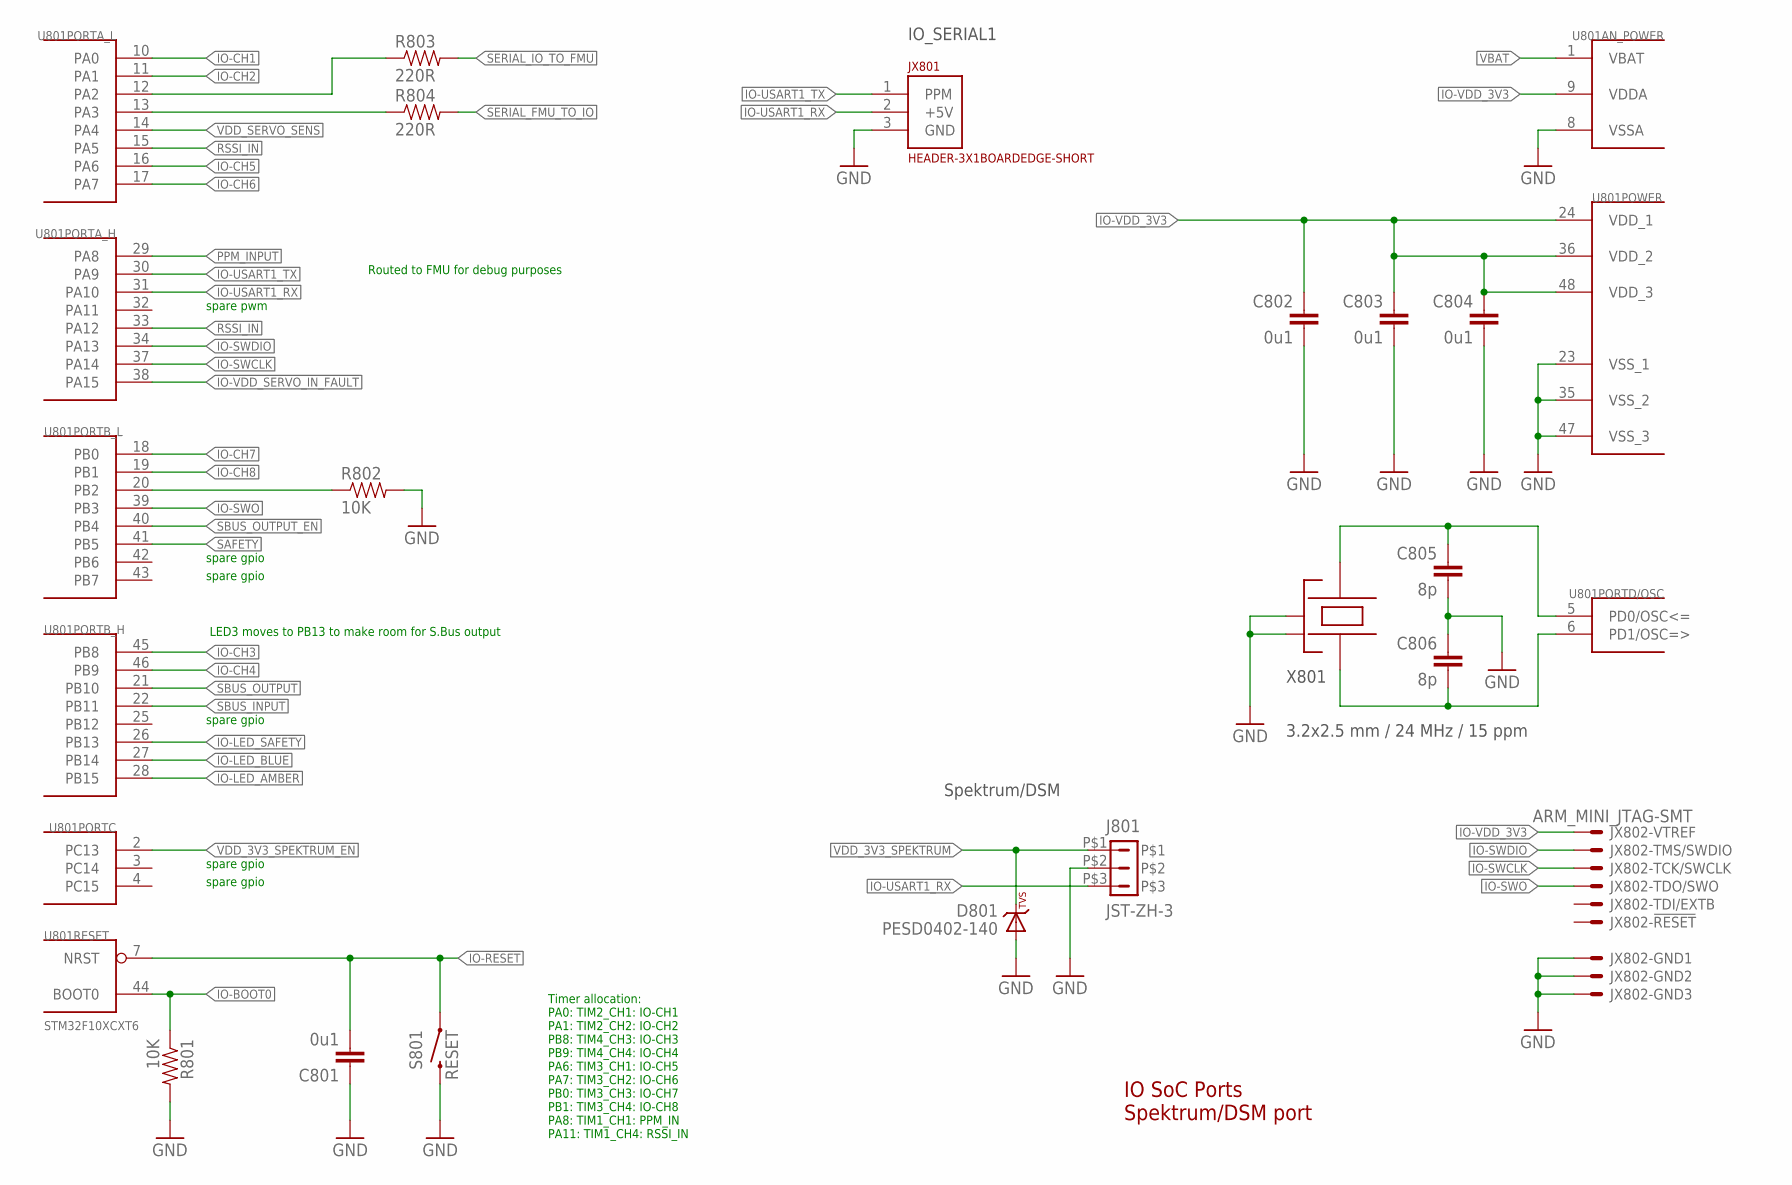
[picture p165: schematic PX4FMUv2.4.sch, sheet 8]

Parts:
C801, C802, C803, C804: 0u1; 0402-CAP; PARTNO CC0402ZRY5V7BB104
C805, C806: 8p; 0402-CAP; PARTNO C1005C0G1H080C
D801: PESD0402-140; 0402-TVS; PARTNO PESD0402-140
J801: JST-ZH-3; JST-ZH-SMT-VERTICAL; PARTNO B3B-ZR-SM4-TF (LF)(SN)(P)
JX801: HEADER-3X1BOARDEDGE-SHORT; HEADER_3X01_SMD_H_BOARD_EDGE_SHORT
JX802: ARM_MINI_JTAG-SMT; FTSH-105-01-XXX-DV-K; PARTNO M50-3900542
R801, R802: 10K; 0402-RES; PARTNO RC0402FR-0710KL
R803, R804: 220R; 0402-RES; PARTNO RC0402FR-07220RL
S801: RESET; EVQP7J01K; PARTNO EVQP7J01K
U801: STM32F10XCXT6; TQFP48; PARTNO STM32F100C8T6B
X801: 3.2x2.5 mm / 24 MHz / 15 ppm; OSCILLATOR-3.2X2.5; PARTNO NX3225SA-24.000000MHZ

Connections:
!IO-LED_AMBER: U801.28 (PB15); also elsewhere on the board
!IO-LED_BLUE: U801.27 (PB14); also elsewhere on the board
!IO-LED_SAFETY: U801.26 (PB13); also elsewhere on the board
!SBUS_OUTPUT_EN: U801.40 (PB4); also elsewhere on the board
GND: C801.P$1 (1), C802.P$2 (2), C803.P$2 (2), C804.P$2 (2), C805.P$2 (2), C806.P$1 (1), D801.A, J801.P$2, JX801.3 (GND), JX802.3, JX802.5, JX802.9, R801.P$2 (2), R802.P$2 (2), S801.B3 (2), U801.8 (VSSA), U801.23 (VSS_1), U801.35 (VSS_2), U801.47 (VSS_3), X801.2 (NC_2), X801.4 (NC_4); also elsewhere on the board
IO-!RESET: C801.P$2 (2), S801.A1 (1), U801.7 (NRST); also elsewhere on the board
IO-!VDD_SERVO_IN_FAULT: U801.38 (PA15); also elsewhere on the board
IO-BOOT0: R801.P$1 (1), U801.44 (BOOT0); also elsewhere on the board
IO-BOOT1: R802.P$1 (1), U801.20 (PB2)
IO-CH1: U801.10 (PA0); also elsewhere on the board
IO-CH2: U801.11 (PA1); also elsewhere on the board
IO-CH3: U801.45 (PB8); also elsewhere on the board
IO-CH4: U801.46 (PB9); also elsewhere on the board
IO-CH5: U801.16 (PA6); also elsewhere on the board
IO-CH6: U801.17 (PA7); also elsewhere on the board
IO-CH7: U801.18 (PB0); also elsewhere on the board
IO-CH8: U801.19 (PB1); also elsewhere on the board
IO-SWCLK: JX802.4, U801.37 (PA14)
IO-SWDIO: JX802.2, U801.34 (PA13)
IO-SWO: JX802.6, U801.39 (PB3)
IO-USART1_RX: J801.P$3, JX801.2 (+5V), U801.31 (PA10)
IO-USART1_TX: JX801.1 (PPM), U801.30 (PA9); also elsewhere on the board
IO-VDD_3V3: C802.P$1 (1), C803.P$1 (1), C804.P$1 (1), JX802.1, U801.9 (VDDA), U801.24 (VDD_1), U801.36 (VDD_2), U801.48 (VDD_3); also elsewhere on the board
unnamed: R803.P$1 (1), U801.12 (PA2)
unnamed: R804.P$1 (1), U801.13 (PA3)
unnamed: C806.P$2 (2), U801.6 (PD1/OSC=>), X801.1
unnamed: C805.P$1 (1), U801.5 (PD0/OSC<=), X801.3
PPM_INPUT: U801.29 (PA8); also elsewhere on the board
RSSI_IN: U801.15 (PA5), U801.33 (PA12); also elsewhere on the board
SAFETY: U801.41 (PB5); also elsewhere on the board
SBUS_INPUT: U801.22 (PB11); also elsewhere on the board
SBUS_OUTPUT: U801.21 (PB10); also elsewhere on the board
SERIAL_FMU_TO_IO: R804.P$2 (2); also elsewhere on the board
SERIAL_IO_TO_FMU: R803.P$2 (2); also elsewhere on the board
VBAT: U801.1 (VBAT); also elsewhere on the board
VDD_3V3_SPEKTRUM: D801.C, J801.P$1; also elsewhere on the board
VDD_3V3_SPEKTRUM_EN: U801.2 (PC13); also elsewhere on the board
VDD_SERVO_SENS: U801.14 (PA4); also elsewhere on the board

Notes on the sheet:
IO SoC Ports Spektrum/DSM port
LED3 moves to PB13 to make room for S.Bus output
Routed to FMU for debug purposes
IO_SERIAL1
Spektrum/DSM
Timer allocation: PA0: TIM2_CH1: IO-CH1 PA1: TIM2_CH2: IO-CH2 PB8: TIM4_CH3: IO-CH3 PB9: TIM4_CH4: IO-CH4 PA6: TIM3_CH1: IO-CH5 PA7: TIM3_CH2: IO-CH6 PB0: TIM3_CH3: IO-CH7 PB1: TIM3_CH4: IO-CH8 PA8: TIM1_CH1: PPM_IN PA11: TIM1_CH4: RSSI_IN
spare pwm
spare gpio

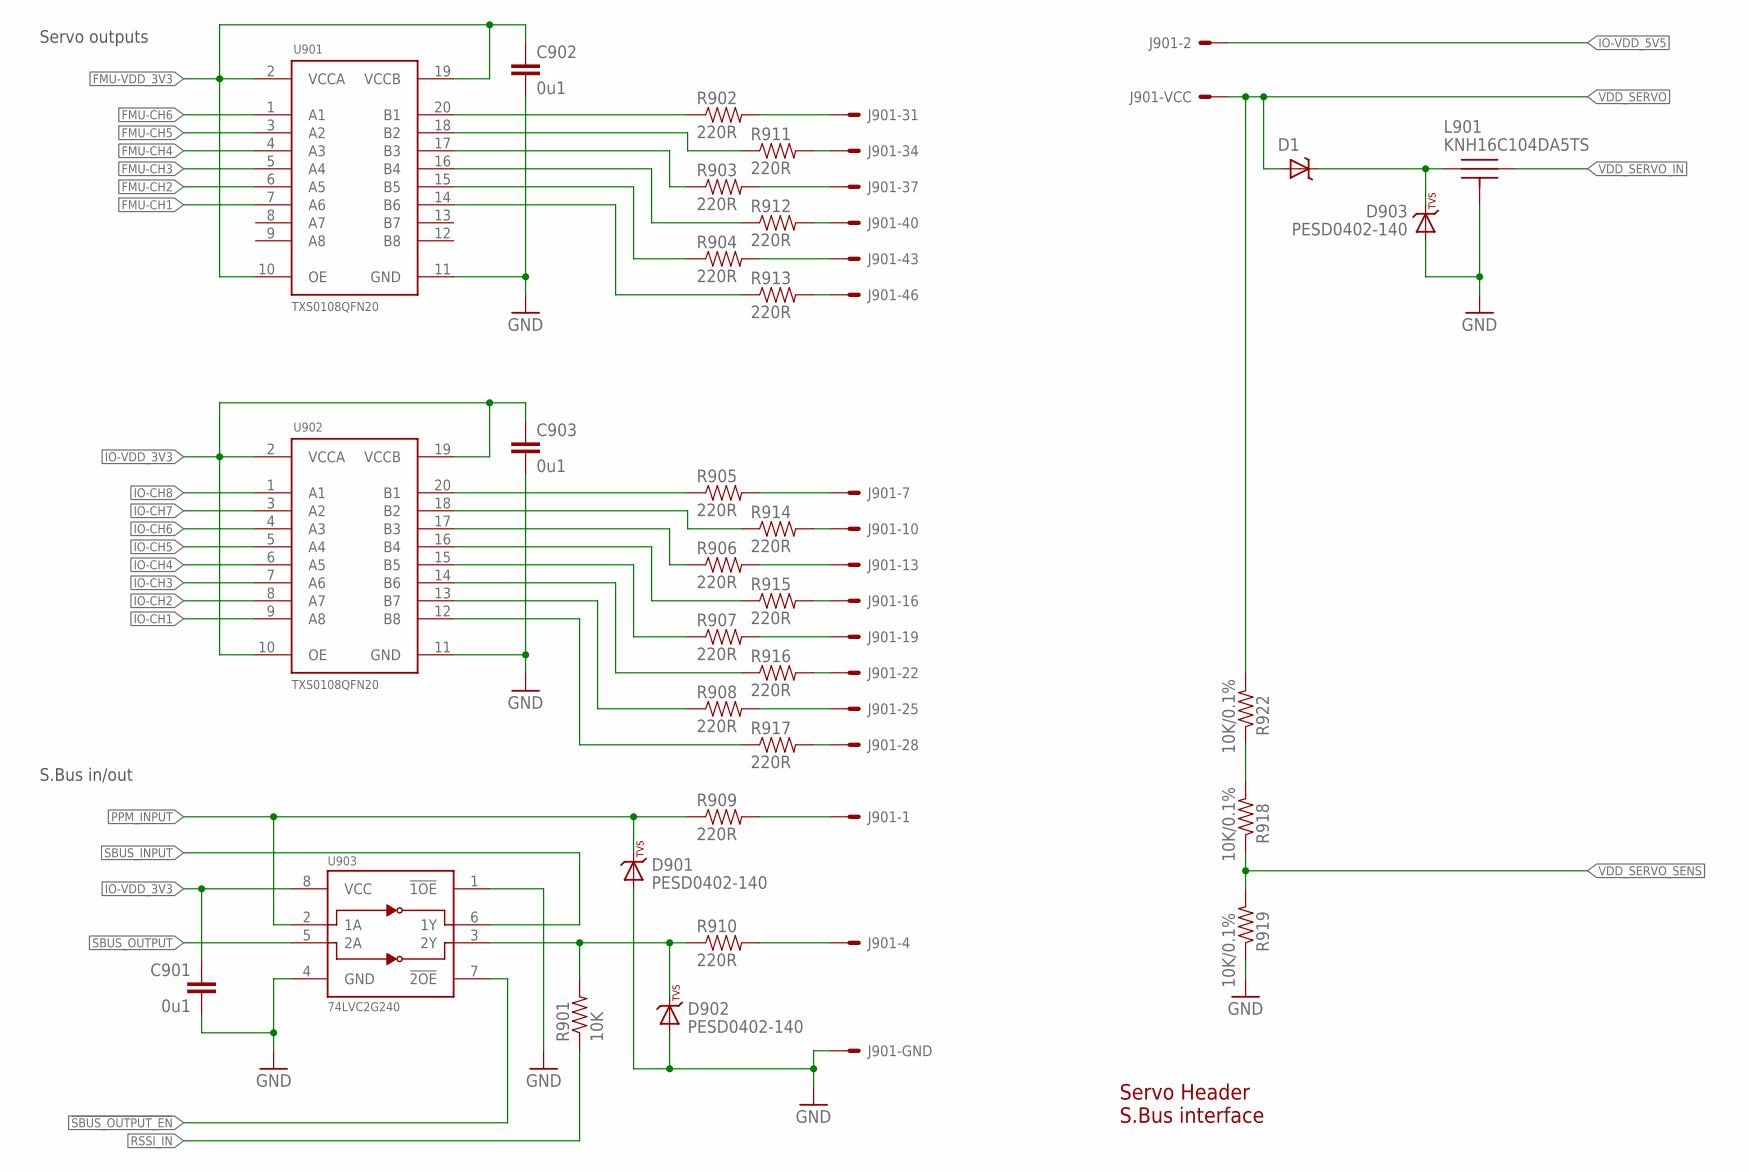
[picture p166: schematic PX4FMUv2.4.sch, sheet 9]

Parts:
C901, C902, C903: 0u1; 0402-CAP; PARTNO CC0402ZRY5V7BB104
D1: MSS1P4-M3; MICROSMP; PARTNO MSS1P4-M3/89A
D901, D902, D903: PESD0402-140; 0402-TVS; PARTNO PESD0402-140
J901: HEADER-3X163X16RA; 3X16RA
L901: KNH16C104DA5TS; KYOCERA-KNH16-DA; PARTNO KNH16C104DA5TS
R901: 10K; 0402-RES; PARTNO RC0402FR-0710KL
R902, R903, R904, R905, R906, R907, R908, R909, R910, R911, R912, R913, R914, R915, R916, R917: 220R; 0402-RES; PARTNO RC0402FR-07220RL
R918, R919, R922: 10K/0.1%; 0402-RES; PARTNO ERA-2AEB103X
U901, U902: TXS0108QFN20; QFN20-RGY; PARTNO TXS0108ERGYR
U903: 74LVC2G240; TSSOP8_SOT505-2; PARTNO 74LVC2G240DP,125

Connections:
!SBUS_OUTPUT_EN: U903.7 (!2OE); also elsewhere on the board
FMU-CH1: U901.7 (A6); also elsewhere on the board
FMU-CH1-PROT: J901.46, R913.P$2 (2)
FMU-CH2: U901.6 (A5); also elsewhere on the board
FMU-CH3: U901.5 (A4); also elsewhere on the board
FMU-CH4: U901.4 (A3); also elsewhere on the board
FMU-CH5: U901.3 (A2); also elsewhere on the board
FMU-CH6: U901.1 (A1); also elsewhere on the board
FMU-CH6-PROT: J901.31, R902.P$2 (2)
FMU-VDD_3V3: C902.P$1 (1), U901.2 (VCCA), U901.10 (OE), U901.19 (VCCB); also elsewhere on the board
GND: C901.P$2 (2), C902.P$2 (2), C903.P$2 (2), D901.A, D902.A, D903.A, J901.3, J901.6, J901.9, J901.12, J901.15, J901.18, J901.21, J901.24, J901.27, J901.30, J901.33, J901.36, J901.39, J901.42, J901.45, J901.48, L901.P$3, L901.P$4, L901.P$5, R919.P$1 (1), U901.11 (GND), U902.11 (GND), U903.1 (!1OE), U903.4 (GND); also elsewhere on the board
IO-CH1: U902.9 (A8); also elsewhere on the board
IO-CH1-PROT: J901.28, R917.P$2 (2)
IO-CH2: U902.8 (A7); also elsewhere on the board
IO-CH3: U902.7 (A6); also elsewhere on the board
IO-CH4: U902.6 (A5); also elsewhere on the board
IO-CH5: U902.5 (A4); also elsewhere on the board
IO-CH6: U902.4 (A3); also elsewhere on the board
IO-CH7: U902.3 (A2); also elsewhere on the board
IO-CH8: U902.1 (A1); also elsewhere on the board
IO-CH8-PROT: J901.7, R905.P$2 (2)
IO-VDD_3V3: C901.P$1 (1), C903.P$1 (1), U902.2 (VCCA), U902.10 (OE), U902.19 (VCCB), U903.8 (VCC); also elsewhere on the board
IO-VDD_5V5: J901.2; also elsewhere on the board
unnamed: R918.P$2 (2), R922.P$1 (1)
unnamed: J901.10, R914.P$2 (2)
unnamed: D902.C, R901.P$2 (2), R910.P$1 (1), U903.3 (2Y)
unnamed: R905.P$1 (1), U902.20 (B1)
unnamed: R914.P$1 (1), U902.18 (B2)
unnamed: R906.P$1 (1), U902.17 (B3)
unnamed: R915.P$1 (1), U902.16 (B4)
unnamed: R907.P$1 (1), U902.15 (B5)
unnamed: R916.P$1 (1), U902.14 (B6)
unnamed: R908.P$1 (1), U902.13 (B7)
unnamed: R917.P$1 (1), U902.12 (B8)
unnamed: R902.P$1 (1), U901.20 (B1)
unnamed: R911.P$1 (1), U901.18 (B2)
unnamed: R903.P$1 (1), U901.17 (B3)
unnamed: R912.P$1 (1), U901.16 (B4)
unnamed: R904.P$1 (1), U901.15 (B5)
unnamed: R913.P$1 (1), U901.14 (B6)
unnamed: J901.34, R911.P$2 (2)
unnamed: J901.13, R906.P$2 (2)
unnamed: J901.16, R915.P$2 (2)
unnamed: J901.19, R907.P$2 (2)
unnamed: J901.22, R916.P$2 (2)
unnamed: J901.25, R908.P$2 (2)
unnamed: J901.37, R903.P$2 (2)
unnamed: J901.40, R912.P$2 (2)
unnamed: J901.43, R904.P$2 (2)
unnamed: J901.4, R910.P$2 (2)
unnamed: D1.CATHODE (C), D903.C, L901.P$1
PPM-SBUS-PROT: J901.1, R909.P$2 (2)
PPM_INPUT: D901.C, R909.P$1 (1), U903.2 (1A); also elsewhere on the board
RSSI_IN: R901.P$1 (1); also elsewhere on the board
SBUS_INPUT: U903.6 (1Y); also elsewhere on the board
SBUS_OUTPUT: U903.5 (2A); also elsewhere on the board
VDD_SERVO: D1.ANODE (A), J901.5, J901.8, J901.11, J901.14, J901.17, J901.20, J901.23, J901.26, J901.29, J901.32, J901.35, J901.38, J901.41, J901.44, J901.47, R922.P$2 (2); also elsewhere on the board
VDD_SERVO_IN: L901.P$2; also elsewhere on the board
VDD_SERVO_SENS: R918.P$1 (1), R919.P$2 (2); also elsewhere on the board

Notes on the sheet:
Servo Header S.Bus interface
S.Bus in/out
Servo outputs
