Jonathon-Reilly/Kicad/kicad-resources/kicad-tools/eagle-to-kicad/examples/PIXHAWK/eagle_original_files/PX4FMUv2.4.brd

## EAGLE design kicad-resources/kicad-tools/eagle-to-kicad/examples/PIXHAWK/eagle_original_files/PX4FMUv2.4.brd (continued)

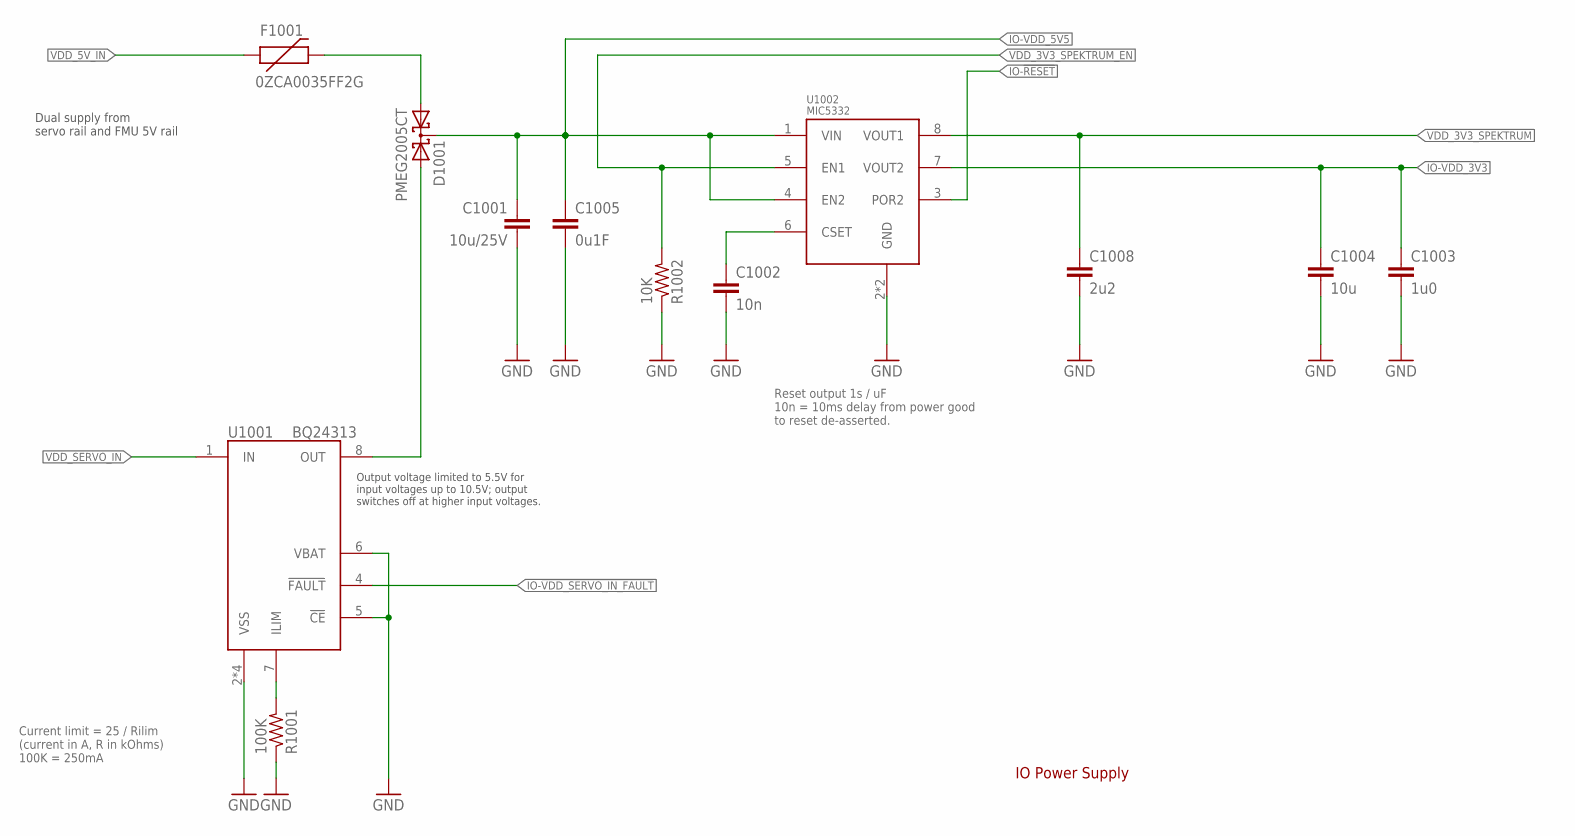
[picture p167: schematic PX4FMUv2.4.sch, sheet 10]

Parts:
C1001: 10u/25V; 0805-CAP; PARTNO CL21A106KAYNNNE
C1002: 10n; 0402-CAP; PARTNO CC0402KRX7R7BB103
C1003: 1u0; 0603-CAP; PARTNO CC0603ZRY5V7BB105
C1004: 10u; 0603-CAP; PARTNO CC0603ZRY5V7BB105
C1005: 0u1F; 0402-CAP; PARTNO CC0402ZRY5V7BB104
C1008: 2u2; 0402-CAP; PARTNO CC0603ZRY5V7BB105
D1001: PMEG2005CT; SOT23-3; PARTNO PMEG2005CT
F1001: 0ZCA0035FF2G; PTC-1206; PARTNO 0ZCA0035FF2G
R1001: 100K; 0402-RES; PARTNO RC0402FR-07100KL
R1002: 10K; 0402-RES; PARTNO RC0402FR-0710KL
U1001: BQ24313; QFN8-DSG; PARTNO BQ24313DSGT
U1002: MIC5332; MLF-8-EPAD; PARTNO MIC5332-SSYMT

Connections:
GND: C1001.P$2 (2), C1002.P$2 (2), C1003.P$2 (2), C1004.P$2 (2), C1005.P$2 (2), C1008.P$2 (2), R1001.P$1 (1), R1002.P$1 (1), U1001.2 (VSS), U1001.5 (!CE), U1001.6 (VBAT), U1001.GND (VSS), U1001.P$2 (VSS), U1001.P$3 (VSS), U1002.2 (GND), U1002.GND; also elsewhere on the board
IO-!RESET: U1002.3 (POR2); also elsewhere on the board
IO-!VDD_SERVO_IN_FAULT: U1001.4 (!FAULT); also elsewhere on the board
IO-VDD_3V3: C1003.P$1 (1), C1004.P$1 (1), U1002.7 (VOUT2); also elsewhere on the board
IO-VDD_5V5: C1001.P$1 (1), C1005.P$1 (1), D1001.3 (CC), U1002.1 (VIN), U1002.4 (EN2); also elsewhere on the board
unnamed: D1001.2 (A2), U1001.8 (OUT)
unnamed: R1001.P$2 (2), U1001.7 (ILIM)
unnamed: D1001.1 (A1), F1001.2
unnamed: C1002.P$1 (1), U1002.6 (CSET)
VDD_3V3_SPEKTRUM: C1008.P$1 (1), U1002.8 (VOUT1); also elsewhere on the board
VDD_3V3_SPEKTRUM_EN: R1002.P$2 (2), U1002.5 (EN1); also elsewhere on the board
VDD_5V_IN: F1001.1; also elsewhere on the board
VDD_SERVO_IN: U1001.1 (IN); also elsewhere on the board

Notes on the sheet:
Dual supply from servo rail and FMU 5V rail
Current limit = 25 / Rilim (current in A, R in kOhms) 100K = 250mA
IO Power Supply
Reset output 1s / uF 10n = 10ms delay from power good to reset de-asserted.
Output voltage limited to 5.5V for input voltages up to 10.5V; output switches off at higher input voltages.

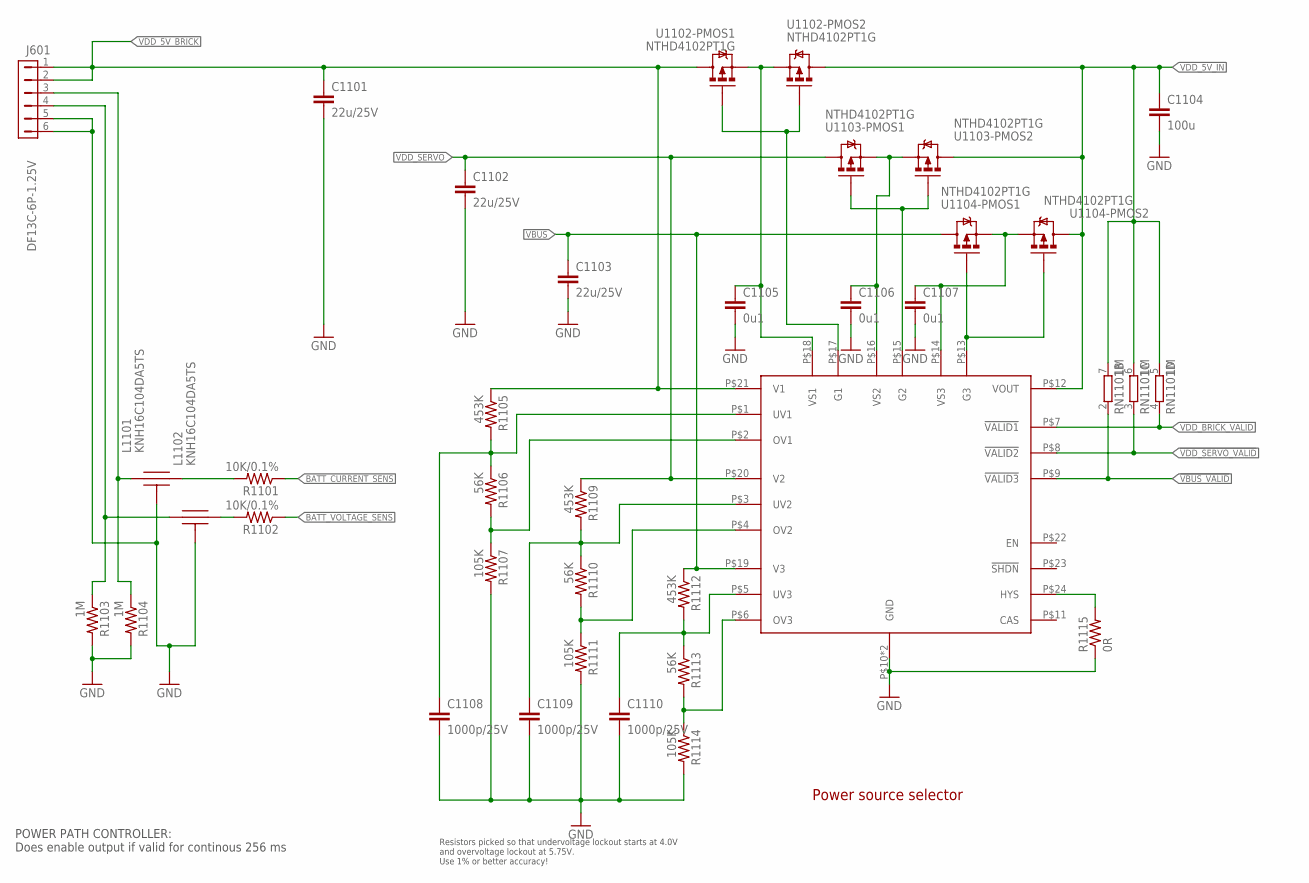
[picture p168: schematic PX4FMUv2.4.sch, sheet 11]

Parts:
C1101, C1102, C1103: 22u/25V; 0805-CAP; PARTNO CL21A226MAQNNNE
C1104: 100u; 1206-CAP; PARTNO C3216X5R1A107M160AC
C1105, C1106, C1107: 0u1; 0402-CAP; PARTNO CC0402ZRY5V7BB104
C1108, C1109, C1110: 1000p/25V; 0402-CAP; PARTNO GRM1555C1E102JA01D
J601: DF13C-6P-1.25V; PARTNO DF13C-6P-1.25V(20)
L1101, L1102: KNH16C104DA5TS; KYOCERA-KNH16-DA; PARTNO KNH16C104DA5TS
R1101, R1102: 10K/0.1%; 0402-RES; PARTNO ERA-2AEB103X
R1103, R1104: 1M; 0402-RES; PARTNO RC0402FR-071ML
R1105, R1109, R1112: 453K; 0402-RES; PARTNO RMCF0402FT453K
R1106, R1110, R1113: 56K; 0402-RES; PARTNO ERA-2AEB563X
R1107, R1111, R1114: 105K; 0402-RES; PARTNO ERJ-2RKF1053X
R1115: 0R; 0402-RES; PARTNO ERJ-2GE0R00X
RN1101: 1M; EXB28V; PARTNO EXB-28V105JX
U1101: LTC4417; MO-220; PARTNO LTC4417IUF#PBF
U1102, U1103, U1104: NTHD4102PT1G; 1206-8; PARTNO NTHD4102PT1G

Connections:
!VBUS_VALID: RN1101.2 (1), U1101.P$9 (!VALID3); also elsewhere on the board
!VDD_BRICK_VALID: RN1101.4 (1), U1101.P$7 (!VALID1); also elsewhere on the board
!VDD_SERVO_VALID: RN1101.3 (1), U1101.P$8 (!VALID2); also elsewhere on the board
BATT_CURRENT_SENS: R1101.P$1 (1); also elsewhere on the board
BATT_CURRENT_SENS_PROT: J601.3, L1101.P$1, R1104.P$1 (1)
BATT_VOLTAGE_SENS: R1102.P$1 (1); also elsewhere on the board
BATT_VOLTAGE_SENS_PROT: J601.4, L1102.P$1, R1103.P$1 (1)
GND: C1101.P$2 (2), C1102.P$2 (2), C1103.P$2 (2), C1104.P$2 (2), C1105.P$2 (2), C1106.P$2 (2), C1107.P$2 (2), C1108.P$2 (2), C1109.P$2 (2), C1110.P$2 (2), J601.5, J601.6, L1101.P$3, L1101.P$4, L1101.P$5, L1102.P$3, L1102.P$4, L1102.P$5, R1103.P$2 (2), R1104.P$2 (2), R1107.P$2 (2), R1111.P$2 (2), R1114.P$2 (2), R1115.P$1 (1), U1101.P$10 (GND), U1101.P$25 (GND); also elsewhere on the board
unnamed: C1108.P$1 (1), R1105.P$2 (2), R1106.P$1 (1), U1101.P$1 (UV1)
unnamed: R1106.P$2 (2), R1107.P$1 (1), U1101.P$2 (OV1)
unnamed: C1109.P$1 (1), R1109.P$2 (2), R1110.P$1 (1), U1101.P$3 (UV2)
unnamed: R1110.P$2 (2), R1111.P$1 (1), U1101.P$4 (OV2)
unnamed: R1113.P$2 (2), R1114.P$1 (1), U1101.P$6 (OV3)
unnamed: C1110.P$1 (1), R1112.P$2 (2), R1113.P$1 (1), U1101.P$5 (UV3)
unnamed: C1105.P$1 (1), U1101.P$18 (VS1), U1102.P$1 (S), U1102.P$3 (S)
unnamed: L1102.P$2, R1102.P$2 (2)
unnamed: L1101.P$2, R1101.P$2 (2)
unnamed: R1115.P$2 (2), U1101.P$24 (HYS)
unnamed: C1106.P$1 (1), U1101.P$16 (VS2), U1103.P$1 (S), U1103.P$3 (S)
unnamed: C1107.P$1 (1), U1101.P$14 (VS3), U1104.P$1 (S), U1104.P$3 (S)
unnamed: U1101.P$13 (G3), U1104.P$2 (G), U1104.P$4 (G)
unnamed: U1101.P$15 (G2), U1103.P$2 (G), U1103.P$4 (G)
unnamed: U1101.P$17 (G1), U1102.P$2 (G), U1102.P$4 (G)
VBUS: C1103.P$1 (1), R1112.P$1 (1), U1101.P$19 (V3), U1104.P$7 (D), U1104.P$8 (D); also elsewhere on the board
VDD_5V_BRICK: C1101.P$1 (1), J601.1, J601.2, R1105.P$1 (1), U1101.P$21 (V1), U1102.P$7 (D), U1102.P$8 (D); also elsewhere on the board
VDD_5V_IN: C1104.P$1 (1), RN1101.5 (2), RN1101.6 (2), RN1101.7 (2), U1101.P$12 (VOUT), U1102.P$5 (D), U1102.P$6 (D), U1103.P$5 (D), U1103.P$6 (D), U1104.P$5 (D), U1104.P$6 (D); also elsewhere on the board
VDD_SERVO: C1102.P$1 (1), R1109.P$1 (1), U1101.P$20 (V2), U1103.P$7 (D), U1103.P$8 (D); also elsewhere on the board

Notes on the sheet:
Power source selector
Resistors picked so that undervoltage lockout starts at 4.0V and overvoltage lockout at 5.75V. Use 1% or better accuracy!
POWER PATH CONTROLLER: Does enable output if valid for continous 256 ms

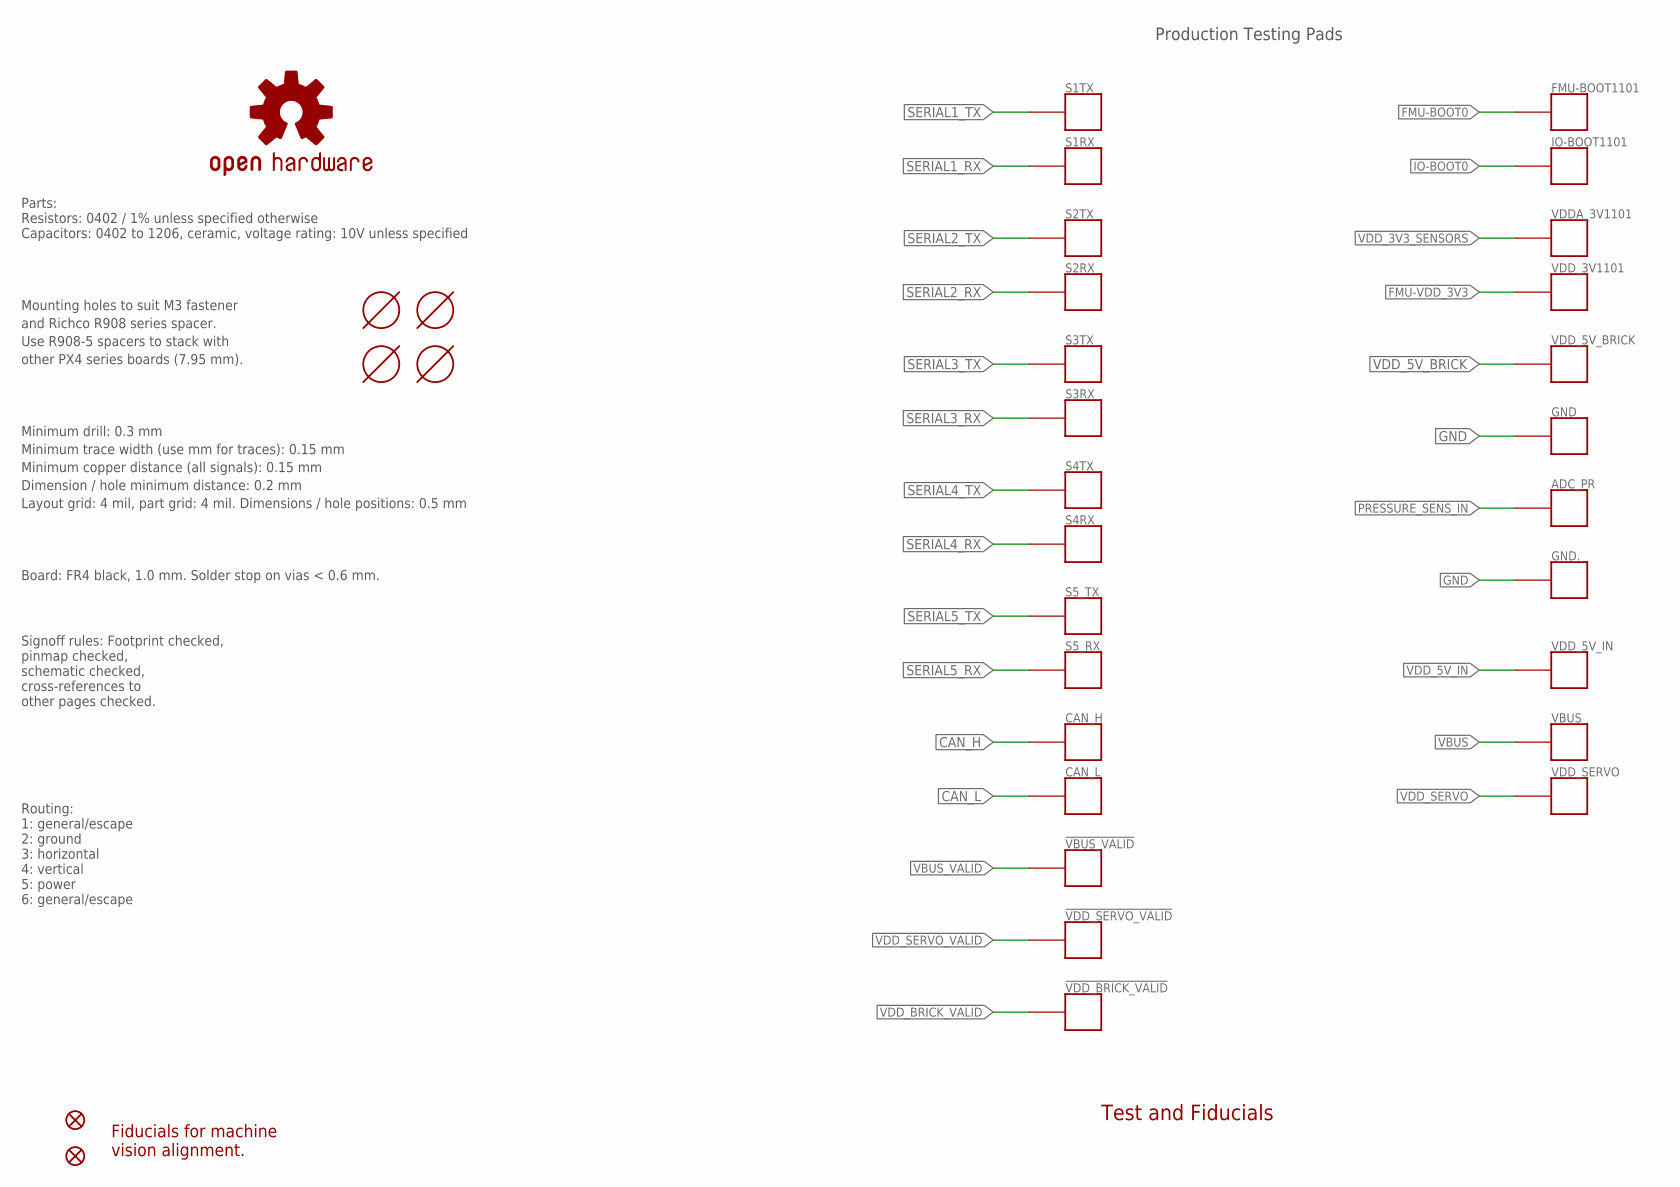
[picture p169: schematic PX4FMUv2.4.sch, sheet 12]

Parts:
!VBUS_VALID: PAD.04; PAD.04X.04; PARTNO *
!VDD_BRICK_VALID: PAD.04; PAD.04X.04; PARTNO *
!VDD_SERVO_VALID: PAD.04; PAD.04X.04; PARTNO *
ADC_PR: PAD.04; PAD.04X.04; PARTNO *
CAN_H: PAD.04; PAD.04X.04; PARTNO *
CAN_L: PAD.04; PAD.04X.04; PARTNO *
FMU-BOOT1101: PAD.04; PAD.04X.04; PARTNO *
GND, GND.: PAD.04; PAD.04X.04; PARTNO *
IO-BOOT1101: PAD.04; PAD.04X.04; PARTNO *
JP1, JP2: FIDUCIAL1.5X3; FIDUCIAL-1.5X3; PARTNO *
M3_MOUNT1101, M3_MOUNT1102, M3_MOUNT1103, M3_MOUNT1104: MOUNT-HOLE3.1MM; MOUNT-HOLE3.1; PARTNO *
OSHW_LOGO: OSHW-LOGOS; OSHW-LOGO-S; PARTNO *
S1RX, S1TX, S2RX, S2TX, S3RX, S3TX, S4RX, S4TX, S5_RX, S5_TX: PAD.04; PAD.04X.04; PARTNO *
VBUS: PAD.04; PAD.04X.04; PARTNO *
VDDA_3V1101: PAD.04; PAD.04X.04; PARTNO *
VDD_3V1101, VDD_5V_BRICK, VDD_5V_IN: PAD.04; PAD.04X.04; PARTNO *
VDD_SERVO: PAD.04; PAD.04X.04; PARTNO *

Connections:
!VBUS_VALID: !VBUS_VALID.P$1; also elsewhere on the board
!VDD_BRICK_VALID: !VDD_BRICK_VALID.P$1; also elsewhere on the board
!VDD_SERVO_VALID: !VDD_SERVO_VALID.P$1; also elsewhere on the board
CAN_H: CAN_H.P$1; also elsewhere on the board
CAN_L: CAN_L.P$1; also elsewhere on the board
FMU-BOOT0: FMU-BOOT1101.P$1; also elsewhere on the board
FMU-VDD_3V3: VDD_3V1101.P$1; also elsewhere on the board
GND: GND.P$1, GND..P$1; also elsewhere on the board
IO-BOOT0: IO-BOOT1101.P$1; also elsewhere on the board
PRESSURE_SENS_IN: ADC_PR.P$1; also elsewhere on the board
SERIAL1_RX: S1RX.P$1; also elsewhere on the board
SERIAL1_TX: S1TX.P$1; also elsewhere on the board
SERIAL2_RX: S2RX.P$1; also elsewhere on the board
SERIAL2_TX: S2TX.P$1; also elsewhere on the board
SERIAL3_RX: S3RX.P$1; also elsewhere on the board
SERIAL3_TX: S3TX.P$1; also elsewhere on the board
SERIAL4_RX: S4RX.P$1; also elsewhere on the board
SERIAL4_TX: S4TX.P$1; also elsewhere on the board
SERIAL5_RX: S5_RX.P$1; also elsewhere on the board
SERIAL5_TX: S5_TX.P$1; also elsewhere on the board
VBUS: VBUS.P$1; also elsewhere on the board
VDD_3V3_SENSORS: VDDA_3V1101.P$1; also elsewhere on the board
VDD_5V_BRICK: VDD_5V_BRICK.P$1; also elsewhere on the board
VDD_5V_IN: VDD_5V_IN.P$1; also elsewhere on the board
VDD_SERVO: VDD_SERVO.P$1; also elsewhere on the board

Notes on the sheet:
Mounting holes to suit M3 fastener
and Richco R908 series spacer.
Use R908-5 spacers to stack with
other PX4 series boards (7.95 mm).
Production Testing Pads
Test and Fiducials
Minimum drill: 0.3 mm
Minimum trace width (use mm for traces): 0.15 mm
Minimum copper distance (all signals): 0.15 mm
Dimension / hole minimum distance: 0.2 mm
Layout grid: 4 mil, part grid: 4 mil. Dimensions / hole positions: 0.5 mm
Board: FR4 black, 1.0 mm. Solder stop on vias < 0.6 mm.
Signoff rules: Footprint checked, pinmap checked, schematic checked, cross-references to other pages checked.
Routing: 1: general/escape 2: ground 3: horizontal 4: vertical 5: power 6: general/escape
Fiducials for machine vision alignment.
Parts: Resistors: 0402 / 1% unless specified otherwise Capacitors: 0402 to 1206, ceramic, voltage rating: 10V unless specified

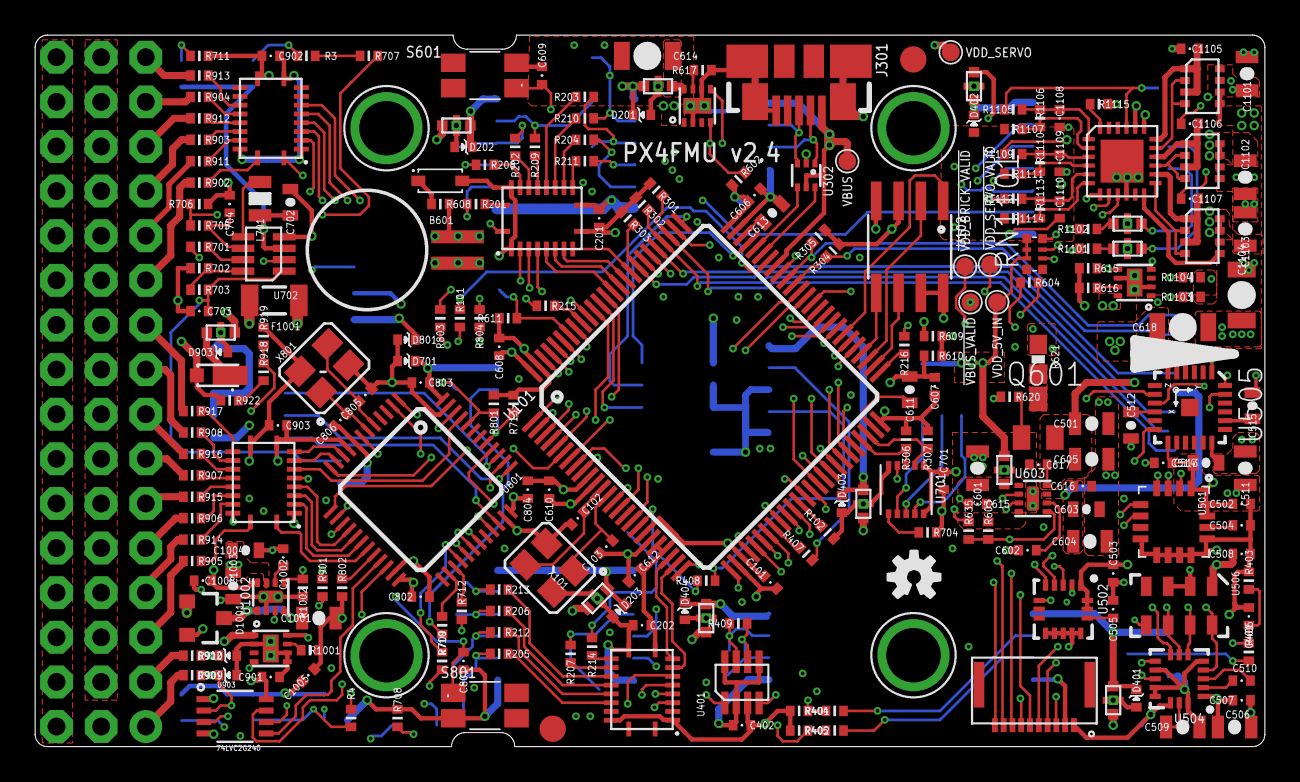
[picture p170: board PX4FMUv2.4.brd from above]

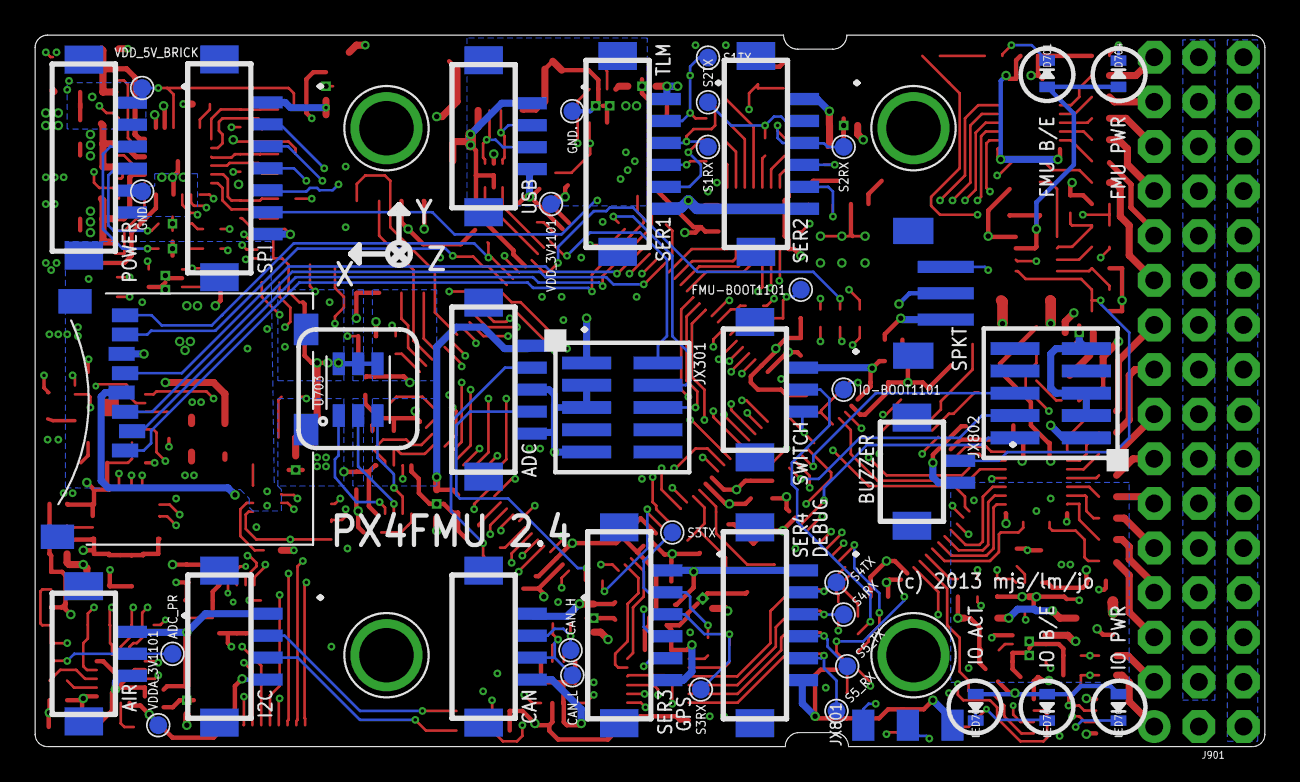
[picture p171: board PX4FMUv2.4.brd from below]

Board: 6 copper layers, 70.0 x 40.5 mm, 292 parts (45 on the bottom side), 262 nets.
