Jonathon-Reilly/Kicad/kicad-resources/kicad-tools/eagle-to-kicad/examples/OLINUXINO/A10-A20-OLINUXINO-MICRO-4GB_Rev_D/eagle_original_files/A10-A20-OLINUXINO-MICRO-4GB_Rev_D.brd

## EAGLE design kicad-resources/kicad-tools/eagle-to-kicad/examples/OLINUXINO/A10-A20-OLINUXINO-MICRO-4GB_Rev_D/eagle_original_files/A10-A20-OLINUXINO-MICRO-4GB_Rev_D.brd (continued)

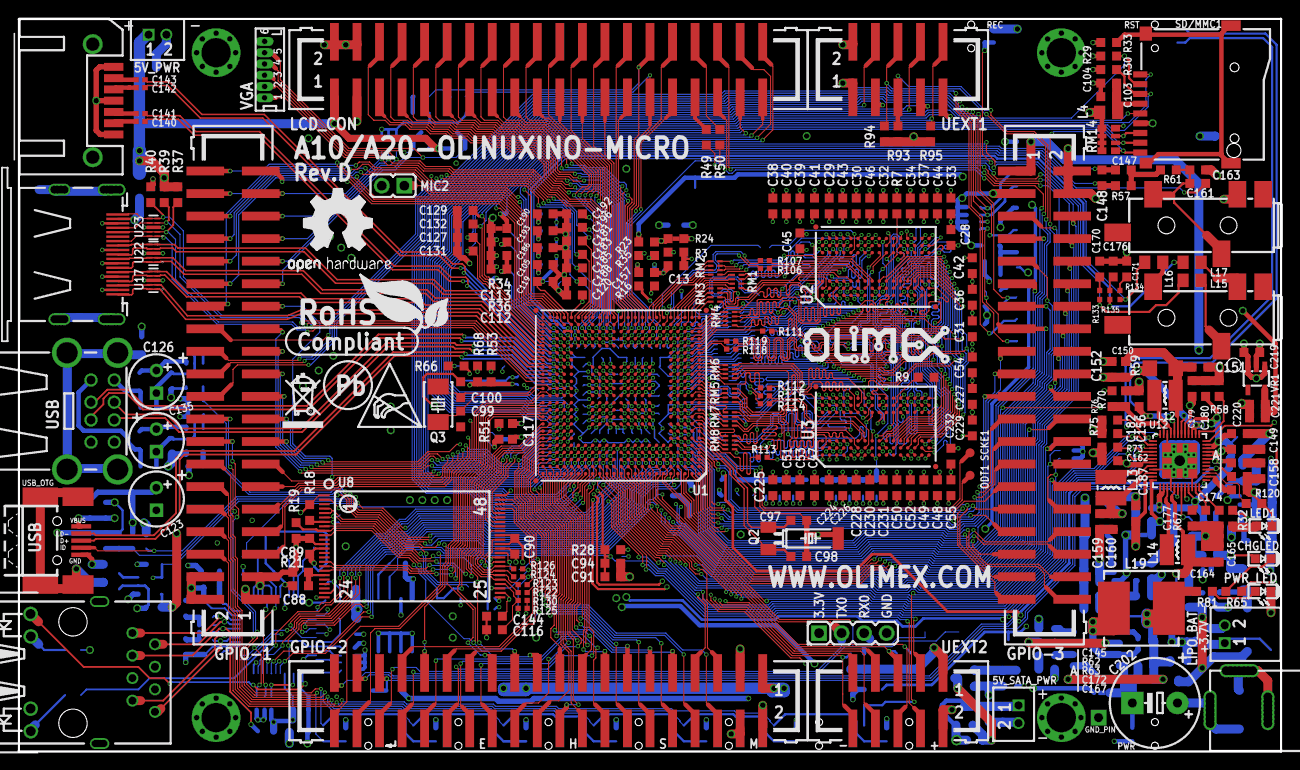
[picture p180: board A10-A20-OLINUXINO-MICRO-4GB_Rev_D.brd from above]

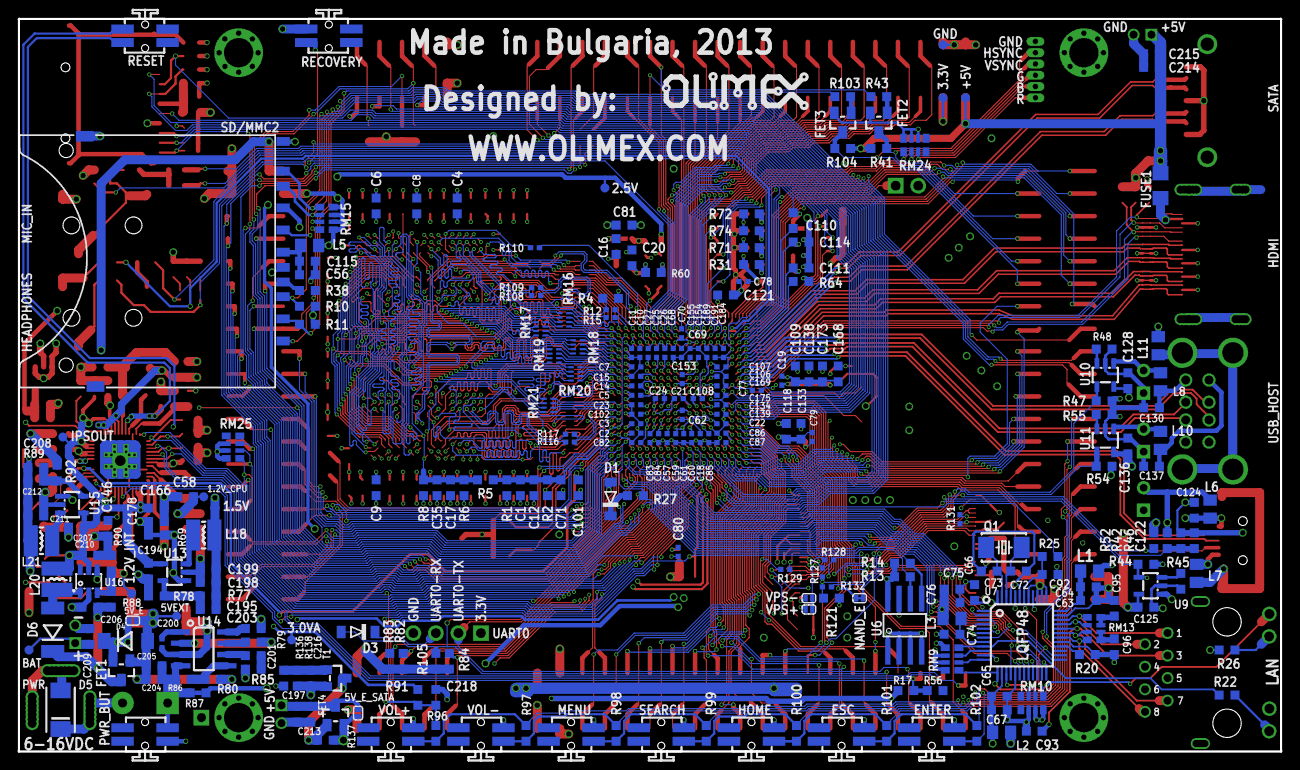
[picture p181: board A10-A20-OLINUXINO-MICRO-4GB_Rev_D.brd from below]

Board: 4 copper layers, 142.2 x 82.6 mm, 501 parts (271 on the bottom side), 539 nets.

Other parts of the board:
U$5: LOGO-OPENHARDWARE_8X8
U$6, U$8: OLIMEX1_V
U$9: PB
U$10: ESD_SYMBOL
U$11: RECYCLE_BIN1/8
U$12: ROHS
