Jonathon-Reilly/Kicad/kicad-resources/kicad-tools/KiField/tests/CAT.sch

## KiCad design kicad-resources/kicad-tools/KiField/tests/CAT.sch (2017-08-08)

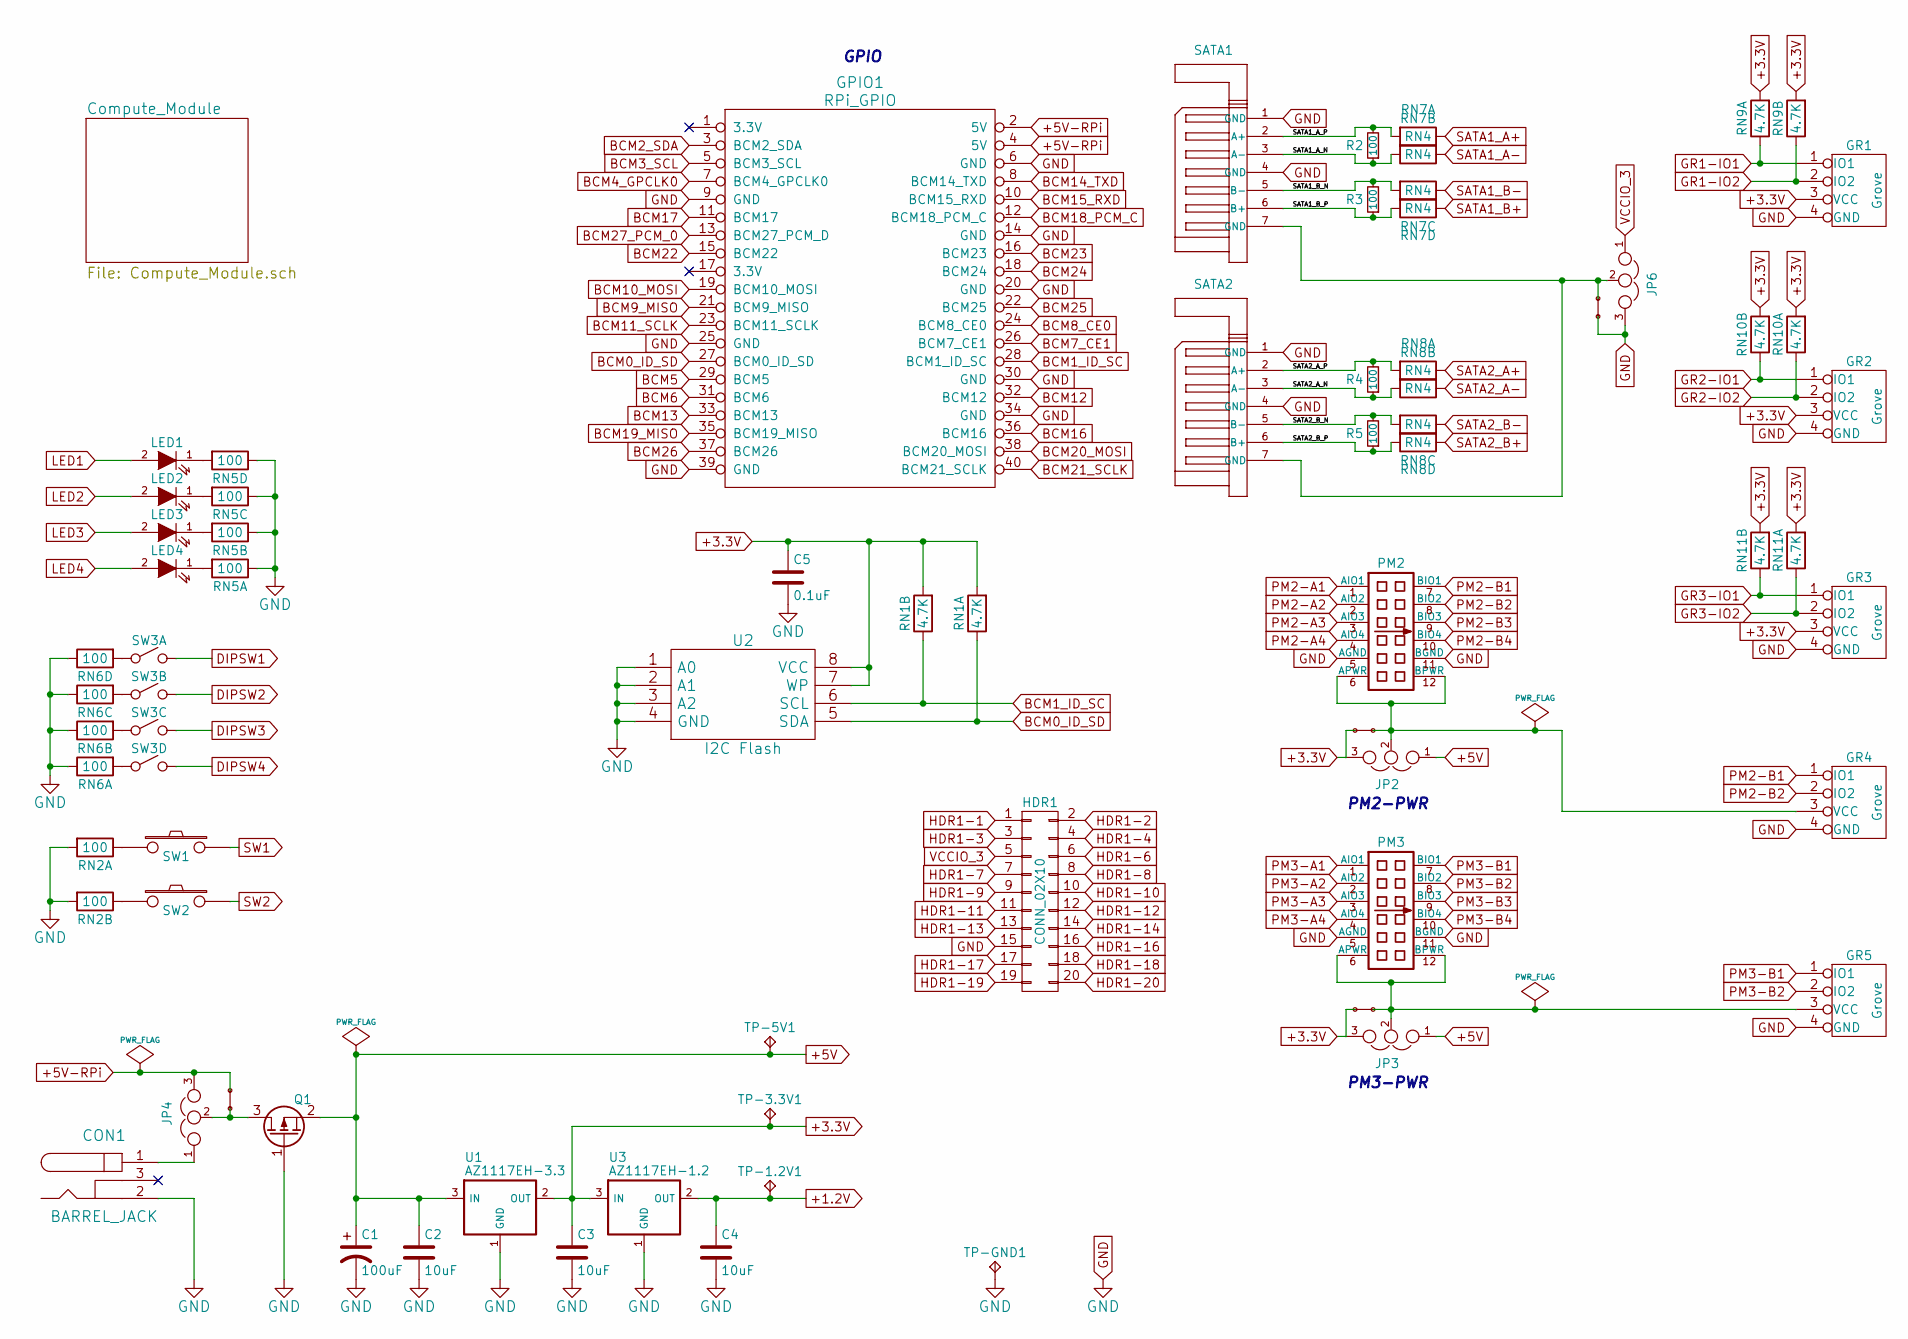
[picture p182: schematic CAT.sch]

Parts:
C1: 100uF; c_elec_6.3x5.3
C2, C3, C4: 10uF; C_0805
C5: 0.1uF; C_0603
CON1: BARREL_JACK
GPIO1: RPi_GPIO; Pin_Header_Straight_2x20
GR1, GR2, GR3, GR4, GR5: Grove; GROVE_MALE
HDR1: CONN_02X10; Pin_Header_Straight_2x10
JP2, JP3, JP4, JP6: JUMPER3; HDR_1x3
LED1, LED2, LED3, LED4: LED; LED-0603
PM2, PM3: PMOD_SCKT-12
Q1: Q_PMOS_GSD; SOT-23
R2, R3, R4, R5: 100; R_0402
RN1, RN9, RN10, RN11: 4.7K; CTS_742C043
RN2: 100; CTS_742C043
RN5, RN6: 100; CTS_742C083
RN7, RN8: RN4; CTS_742C083
SATA1, SATA2: SATA_CONN; xess-MOLEX-67491
SH1, SH2, SH3, SH4: JSHORTNORMAL; xess-JSHORT
SW1, SW2: SW_PUSH; RS-282G05A3-SM_RT
SW3: DIPSW4; xess-DS-04
TP-1.2V1, TP-3.3V1, TP-5V1: TPTP-COMPACT; Measurement_Point_Round-TH_Small
TP-GND1: TPTP-COMPACT; Measurement_Point_Round-TH_Small
U1: AZ1117EH-3.3; SOT-223
U2: I2C Flash; SOIC-8-N
U3: AZ1117EH-1.2; SOT-223

Connections:
+1.2V: C4.1, TP-1.2V1.1, U3.2 (OUT), U3.4 (HS)
+3.3V: C3.1, C5.1, GR1.3 (VCC), GR2.3 (VCC), GR3.3 (VCC), JP2.3, JP3.3, RN1.1, RN1.2, RN9.1, RN9.2, RN10.1, RN10.2, RN11.1, RN11.2, SH3.2, SH4.2, TP-3.3V1.1, U1.2 (OUT), U1.4 (HS), U2.7 (WP), U2.8 (VCC), U3.3 (IN)
+5V: C1.1, C2.1, JP2.1, JP3.1, Q1.2 (S), TP-5V1.1, U1.3 (IN)
+5V-RPi: GPIO1.2 (5V), GPIO1.4 (5V), JP4.3, SH1.2
BCM0_ID_SD: GPIO1.27 (BCM0_ID_SD), RN1.4, U2.5 (SDA)
BCM1_ID_SC: GPIO1.28 (BCM1_ID_SC), RN1.3, U2.6 (SCL)
BCM2_SDA: GPIO1.3 (BCM2_SDA)
BCM3_SCL: GPIO1.5 (BCM3_SCL)
BCM4_GPCLK0: GPIO1.7 (BCM4_GPCLK0)
BCM5: GPIO1.29 (BCM5)
BCM6: GPIO1.31 (BCM6)
BCM7_CE1: GPIO1.26 (BCM7_CE1)
BCM8_CE0: GPIO1.24 (BCM8_CE0)
BCM9_MISO: GPIO1.21 (BCM9_MISO)
BCM10_MOSI: GPIO1.19 (BCM10_MOSI)
BCM11_SCLK: GPIO1.23 (BCM11_SCLK)
BCM12: GPIO1.32 (BCM12)
BCM13: GPIO1.33 (BCM13)
BCM14_TXD: GPIO1.8 (BCM14_TXD)
BCM15_RXD: GPIO1.10 (BCM15_RXD)
BCM16: GPIO1.36 (BCM16)
BCM17: GPIO1.11 (BCM17)
BCM18_PCM_C: GPIO1.12 (BCM18_PCM_C)
BCM19_MISO: GPIO1.35 (BCM19_MISO)
BCM20_MOSI: GPIO1.38 (BCM20_MOSI)
BCM21_SCLK: GPIO1.40 (BCM21_SCLK)
BCM22: GPIO1.15 (BCM22)
BCM23: GPIO1.16 (BCM23)
BCM24: GPIO1.18 (BCM24)
BCM25: GPIO1.22 (BCM25)
BCM26: GPIO1.37 (BCM26)
BCM27_PCM_0: GPIO1.13 (BCM27_PCM_D)
DIPSW1: SW3.8
DIPSW2: SW3.7
DIPSW3: SW3.6
DIPSW4: SW3.5
GND: C1.2, C2.2, C3.2, C4.2, C5.2, CON1.2, GPIO1.6 (GND), GPIO1.9 (GND), GPIO1.14 (GND), GPIO1.20 (GND), GPIO1.25 (GND), GPIO1.30 (GND), GPIO1.34 (GND), GPIO1.39 (GND), GR1.4 (GND), GR2.4 (GND), GR3.4 (GND), GR4.4 (GND), GR5.4 (GND), HDR1.15, JP6.3, PM2.5 (AGND), PM2.11 (BGND), PM3.5 (AGND), PM3.11 (BGND), Q1.1 (G), RN2.1, RN2.2, RN5.5, RN5.6, RN5.7, RN5.8, RN6.5, RN6.6, RN6.7, RN6.8, SATA1.1 (GND), SATA1.4 (GND), SATA2.1 (GND), SATA2.4 (GND), SH2.1, TP-GND1.1, U1.1 (GND), U2.1 (A0), U2.2 (A1), U2.3 (A2), U2.4 (GND), U3.1 (GND)
GR1-IO1: GR1.1 (IO1), RN9.4
GR1-IO2: GR1.2 (IO2), RN9.3
GR2-IO1: GR2.1 (IO1), RN10.3
GR2-IO2: GR2.2 (IO2), RN10.4
GR3-IO1: GR3.1 (IO1), RN11.3
GR3-IO2: GR3.2 (IO2), RN11.4
HDR1-1: HDR1.1
HDR1-2: HDR1.2
HDR1-3: HDR1.3
HDR1-4: HDR1.4
HDR1-6: HDR1.6
HDR1-7: HDR1.7
HDR1-8: HDR1.8
HDR1-9: HDR1.9
HDR1-10: HDR1.10
HDR1-11: HDR1.11
HDR1-12: HDR1.12
HDR1-13: HDR1.13
HDR1-14: HDR1.14
HDR1-16: HDR1.16
HDR1-17: HDR1.17
HDR1-18: HDR1.18
HDR1-19: HDR1.19
HDR1-20: HDR1.20
LED1: LED1.2 (A)
LED2: LED2.2 (A)
LED3: LED3.2 (A)
LED4: LED4.2 (A)
unnamed: CON1.1, JP4.1
unnamed: GR4.3 (VCC), JP2.2, PM2.6 (APWR), PM2.12 (BPWR), SH3.1
unnamed: GR5.3 (VCC), JP3.2, PM3.6 (APWR), PM3.12 (BPWR), SH4.1
unnamed: JP4.2, Q1.3 (D), SH1.1
unnamed: JP6.2, SATA1.7 (GND), SATA2.7 (GND), SH2.2
unnamed: LED1.1 (K), RN5.4
unnamed: LED2.1 (K), RN5.3
unnamed: LED3.1 (K), RN5.2
unnamed: LED4.1 (K), RN5.1
unnamed: RN2.3, SW2.1
unnamed: RN2.4, SW1.1
unnamed: RN6.1, SW3.4
unnamed: RN6.2, SW3.3
unnamed: RN6.3, SW3.2
unnamed: RN6.4, SW3.1
PM2-A1: PM2.1 (AIO1)
PM2-A2: PM2.2 (AIO2)
PM2-A3: PM2.3 (AIO3)
PM2-A4: PM2.4 (AIO4)
PM2-B1: GR4.1 (IO1), PM2.7 (BIO1)
PM2-B2: GR4.2 (IO2), PM2.8 (BIO2)
PM2-B3: PM2.9 (BIO3)
PM2-B4: PM2.10 (BIO4)
PM3-A1: PM3.1 (AIO1)
PM3-A2: PM3.2 (AIO2)
PM3-A3: PM3.3 (AIO3)
PM3-A4: PM3.4 (AIO4)
PM3-B1: GR5.1 (IO1), PM3.7 (BIO1)
PM3-B2: GR5.2 (IO2), PM3.8 (BIO2)
PM3-B3: PM3.9 (BIO3)
PM3-B4: PM3.10 (BIO4)
SATA1_A+: RN7.8
SATA1_A-: RN7.7
SATA1_A_N: R2.1, RN7.2, SATA1.3 (A-)
SATA1_A_P: R2.2, RN7.1, SATA1.2 (A+)
SATA1_B+: RN7.5
SATA1_B-: RN7.6
SATA1_B_N: R3.2, RN7.3, SATA1.5 (B-)
SATA1_B_P: R3.1, RN7.4, SATA1.6 (B+)
SATA2_A+: RN8.8
SATA2_A-: RN8.7
SATA2_A_N: R4.1, RN8.2, SATA2.3 (A-)
SATA2_A_P: R4.2, RN8.1, SATA2.2 (A+)
SATA2_B+: RN8.5
SATA2_B-: RN8.6
SATA2_B_N: R5.2, RN8.3, SATA2.5 (B-)
SATA2_B_P: R5.1, RN8.4, SATA2.6 (B+)
SW1: SW1.2
SW2: SW2.2
VCCIO_3: HDR1.5, JP6.1

Notes on the sheet:
PM2-PWR
PM3-PWR
GPIO
