Jonathon-Reilly/Kicad/kicad-resources/kicad-tools/KiField/tests/FPGA_CFG.sch

## KiCad design kicad-resources/kicad-tools/KiField/tests/FPGA_CFG.sch (2017-08-08)

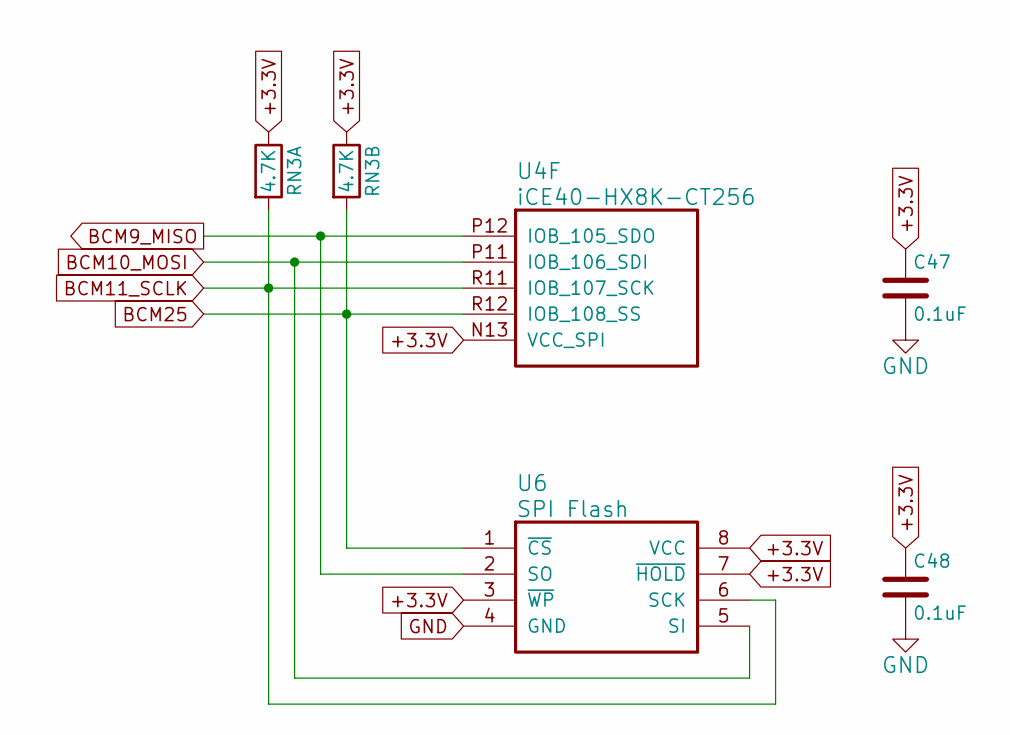
[picture p183: schematic FPGA_CFG.sch]

Parts:
C47, C48: 0.1uF; C_0603
RN3: 4.7K; CTS_742C043
U4: iCE40-HX8K-CT256; Lattice_caBGA_256
U6: SPI Flash; SOIC-8-N

Connections:
+3.3V: C47.1, C48.1, RN3.3, RN3.4, U4.N13 (VCC_SPI), U6.3 (~WP), U6.7 (~HOLD), U6.8 (VCC)
BCM9_MISO: U4.P12 (IOB_105_SDO), U6.2 (SO)
BCM10_MOSI: U4.P11 (IOB_106_SDI), U6.5 (SI)
BCM11_SCLK: RN3.1, U4.R11 (IOB_107_SCK), U6.6 (SCK)
BCM25: RN3.2, U4.R12 (IOB_108_SS), U6.1 (~CS)
GND: C47.2, C48.2, U6.4 (GND)
