Jonathon-Reilly/Kicad/kicad-resources/kicad-tools/KiField/tests/FPGA_IO.sch

## KiCad design kicad-resources/kicad-tools/KiField/tests/FPGA_IO.sch (2017-08-08)

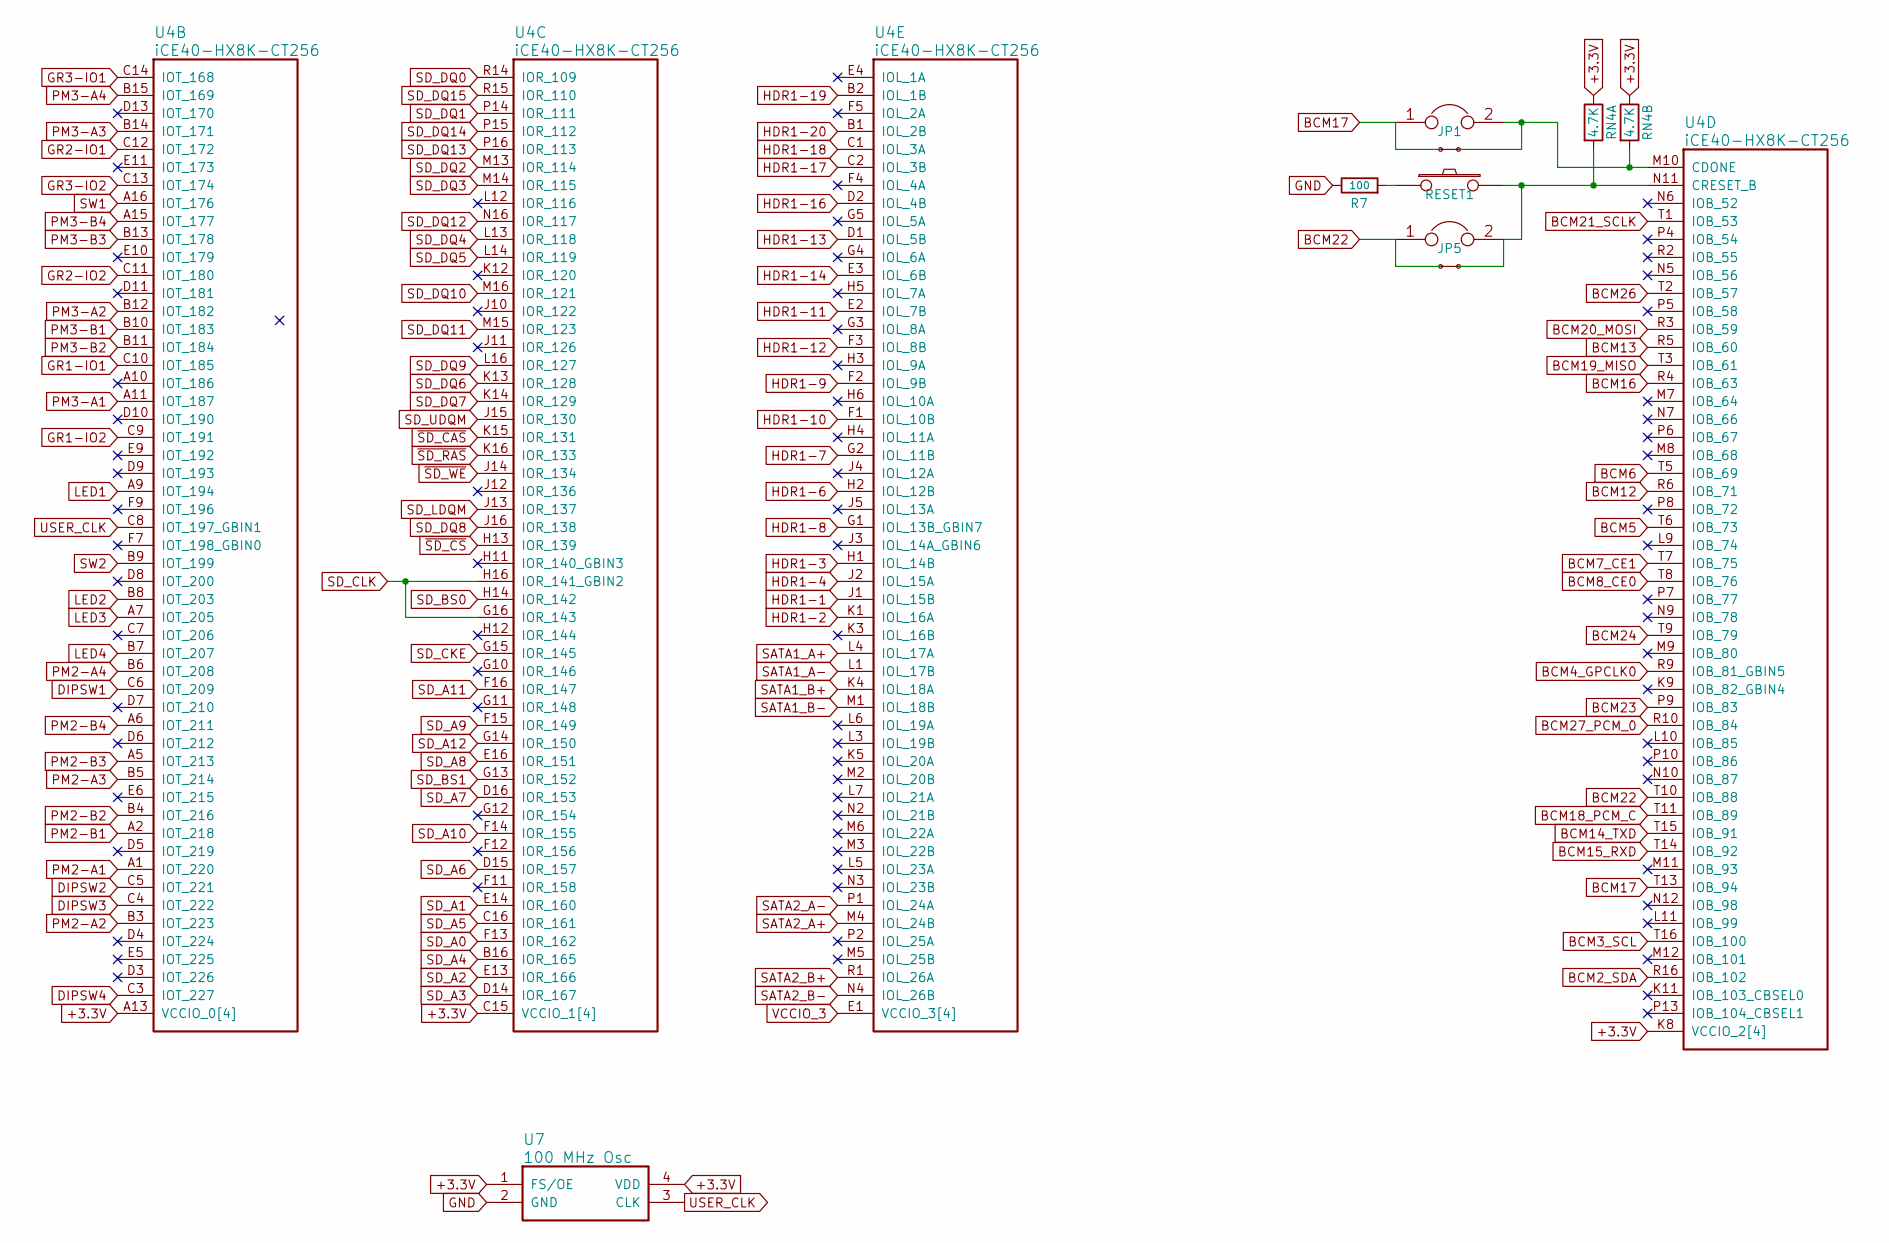
[picture p184: schematic FPGA_IO.sch]

Parts:
JP1, JP5: JUMPER; S_JUMPER_2
R7: 100; R_0603
RESET1: SW_PUSH; RS-282G05A3-SM_RT
RN4: 4.7K; CTS_742C043
SH5, SH6: JSHORTNORMAL; xess-JSHORT
U4: iCE40-HX8K-CT256; Lattice_caBGA_256
U7: 100 MHz Osc; 2.5x3.2

Connections:
+3.3V: RN4.3, RN4.4, U4.A3 (VCCIO_0[4]), U4.A8 (VCCIO_0[4]), U4.A13 (VCCIO_0[4]), U4.C15 (VCCIO_1[4]), U4.F8 (VCCIO_0[4]), U4.H10 (VCCIO_1[4]), U4.H15 (VCCIO_1[4]), U4.K8 (VCCIO_2[4]), U4.N15 (VCCIO_1[4]), U4.P3 (VCCIO_2[4]), U4.R8 (VCCIO_2[4]), U4.R13 (VCCIO_2[4]), U7.1 (FS/OE), U7.4 (VDD)
BCM2_SDA: U4.R16 (IOB_102)
BCM3_SCL: U4.T16 (IOB_100)
BCM4_GPCLK0: U4.R9 (IOB_81_GBIN5)
BCM5: U4.T6 (IOB_73)
BCM6: U4.T5 (IOB_69)
BCM7_CE1: U4.T7 (IOB_75)
BCM8_CE0: U4.T8 (IOB_76)
BCM12: U4.R6 (IOB_71)
BCM13: U4.R5 (IOB_60)
BCM14_TXD: U4.T15 (IOB_91)
BCM15_RXD: U4.T14 (IOB_92)
BCM16: U4.R4 (IOB_63)
BCM17: JP1.1, SH5.2, U4.T13 (IOB_94)
BCM18_PCM_C: U4.T11 (IOB_89)
BCM19_MISO: U4.T3 (IOB_61)
BCM20_MOSI: U4.R3 (IOB_59)
BCM21_SCLK: U4.T1 (IOB_53)
BCM22: JP5.1, SH6.2, U4.T10 (IOB_88)
BCM23: U4.P9 (IOB_83)
BCM24: U4.T9 (IOB_79)
BCM26: U4.T2 (IOB_57)
BCM27_PCM_0: U4.R10 (IOB_84)
DIPSW1: U4.C6 (IOT_209)
DIPSW2: U4.C5 (IOT_221)
DIPSW3: U4.C4 (IOT_222)
DIPSW4: U4.C3 (IOT_227)
GND: R7.1, U7.2 (GND)
GR1-IO1: U4.C10 (IOT_185)
GR1-IO2: U4.C9 (IOT_191)
GR2-IO1: U4.C12 (IOT_172)
GR2-IO2: U4.C11 (IOT_180)
GR3-IO1: U4.C14 (IOT_168)
GR3-IO2: U4.C13 (IOT_174)
HDR1-1: U4.J1 (IOL_15B)
HDR1-2: U4.K1 (IOL_16A)
HDR1-3: U4.H1 (IOL_14B)
HDR1-4: U4.J2 (IOL_15A)
HDR1-6: U4.H2 (IOL_12B)
HDR1-7: U4.G2 (IOL_11B)
HDR1-8: U4.G1 (IOL_13B_GBIN7)
HDR1-9: U4.F2 (IOL_9B)
HDR1-10: U4.F1 (IOL_10B)
HDR1-11: U4.E2 (IOL_7B)
HDR1-12: U4.F3 (IOL_8B)
HDR1-13: U4.D1 (IOL_5B)
HDR1-14: U4.E3 (IOL_6B)
HDR1-16: U4.D2 (IOL_4B)
HDR1-17: U4.C2 (IOL_3B)
HDR1-18: U4.C1 (IOL_3A)
HDR1-19: U4.B2 (IOL_1B)
HDR1-20: U4.B1 (IOL_2B)
LED1: U4.A9 (IOT_194)
LED2: U4.B8 (IOT_203)
LED3: U4.A7 (IOT_205)
LED4: U4.B7 (IOT_207)
unnamed: JP1.2, RN4.2, SH5.1, U4.M10 (CDONE)
unnamed: JP5.2, RESET1.2, RN4.1, SH6.1, U4.N11 (CRESET_B)
unnamed: R7.2, RESET1.1
PM2-A1: U4.A1 (IOT_220)
PM2-A2: U4.B3 (IOT_223)
PM2-A3: U4.B5 (IOT_214)
PM2-A4: U4.B6 (IOT_208)
PM2-B1: U4.A2 (IOT_218)
PM2-B2: U4.B4 (IOT_216)
PM2-B3: U4.A5 (IOT_213)
PM2-B4: U4.A6 (IOT_211)
PM3-A1: U4.A11 (IOT_187)
PM3-A2: U4.B12 (IOT_182)
PM3-A3: U4.B14 (IOT_171)
PM3-A4: U4.B15 (IOT_169)
PM3-B1: U4.B10 (IOT_183)
PM3-B2: U4.B11 (IOT_184)
PM3-B3: U4.B13 (IOT_178)
PM3-B4: U4.A15 (IOT_177)
SATA1_A+: U4.L4 (IOL_17A)
SATA1_A-: U4.L1 (IOL_17B)
SATA1_B+: U4.K4 (IOL_18A)
SATA1_B-: U4.M1 (IOL_18B)
SATA2_A+: U4.M4 (IOL_24B)
SATA2_A-: U4.P1 (IOL_24A)
SATA2_B+: U4.R1 (IOL_26A)
SATA2_B-: U4.N4 (IOL_26B)
SD_A0: U4.F13 (IOR_162)
SD_A1: U4.E14 (IOR_160)
SD_A2: U4.E13 (IOR_166)
SD_A3: U4.D14 (IOR_167)
SD_A4: U4.B16 (IOR_165)
SD_A5: U4.C16 (IOR_161)
SD_A6: U4.D15 (IOR_157)
SD_A7: U4.D16 (IOR_153)
SD_A8: U4.E16 (IOR_151)
SD_A9: U4.F15 (IOR_149)
SD_A10: U4.F14 (IOR_155)
SD_A11: U4.F16 (IOR_147)
SD_A12: U4.G14 (IOR_150)
SD_BS0: U4.H14 (IOR_142)
SD_BS1: U4.G13 (IOR_152)
SD_CKE: U4.G15 (IOR_145)
SD_CLK: U4.G16 (IOR_143), U4.H16 (IOR_141_GBIN2)
SD_DQ0: U4.R14 (IOR_109)
SD_DQ1: U4.P14 (IOR_111)
SD_DQ2: U4.M13 (IOR_114)
SD_DQ3: U4.M14 (IOR_115)
SD_DQ4: U4.L13 (IOR_118)
SD_DQ5: U4.L14 (IOR_119)
SD_DQ6: U4.K13 (IOR_128)
SD_DQ7: U4.K14 (IOR_129)
SD_DQ8: U4.J16 (IOR_138)
SD_DQ9: U4.L16 (IOR_127)
SD_DQ10: U4.M16 (IOR_121)
SD_DQ11: U4.M15 (IOR_123)
SD_DQ12: U4.N16 (IOR_117)
SD_DQ13: U4.P16 (IOR_113)
SD_DQ14: U4.P15 (IOR_112)
SD_DQ15: U4.R15 (IOR_110)
SD_LDQM: U4.J13 (IOR_137)
SD_UDQM: U4.J15 (IOR_130)
SW1: U4.A16 (IOT_176)
SW2: U4.B9 (IOT_199)
USER_CLK: U4.C8 (IOT_197_GBIN1), U7.3 (CLK)
VCCIO_3: U4.E1 (VCCIO_3[4]), U4.G6 (VCCIO_3[4]), U4.J6 (VCCIO_3[4]), U4.N1 (VCCIO_3[4])
~SD_CAS: U4.K15 (IOR_131)
~SD_CS: U4.H13 (IOR_139)
~SD_RAS: U4.K16 (IOR_133)
~SD_WE: U4.J14 (IOR_134)
