Jonathon-Reilly/Kicad/kicad-resources/kicad-tools/KiField/tests/FPGA_PWR.sch

## KiCad design kicad-resources/kicad-tools/KiField/tests/FPGA_PWR.sch (2017-08-08)

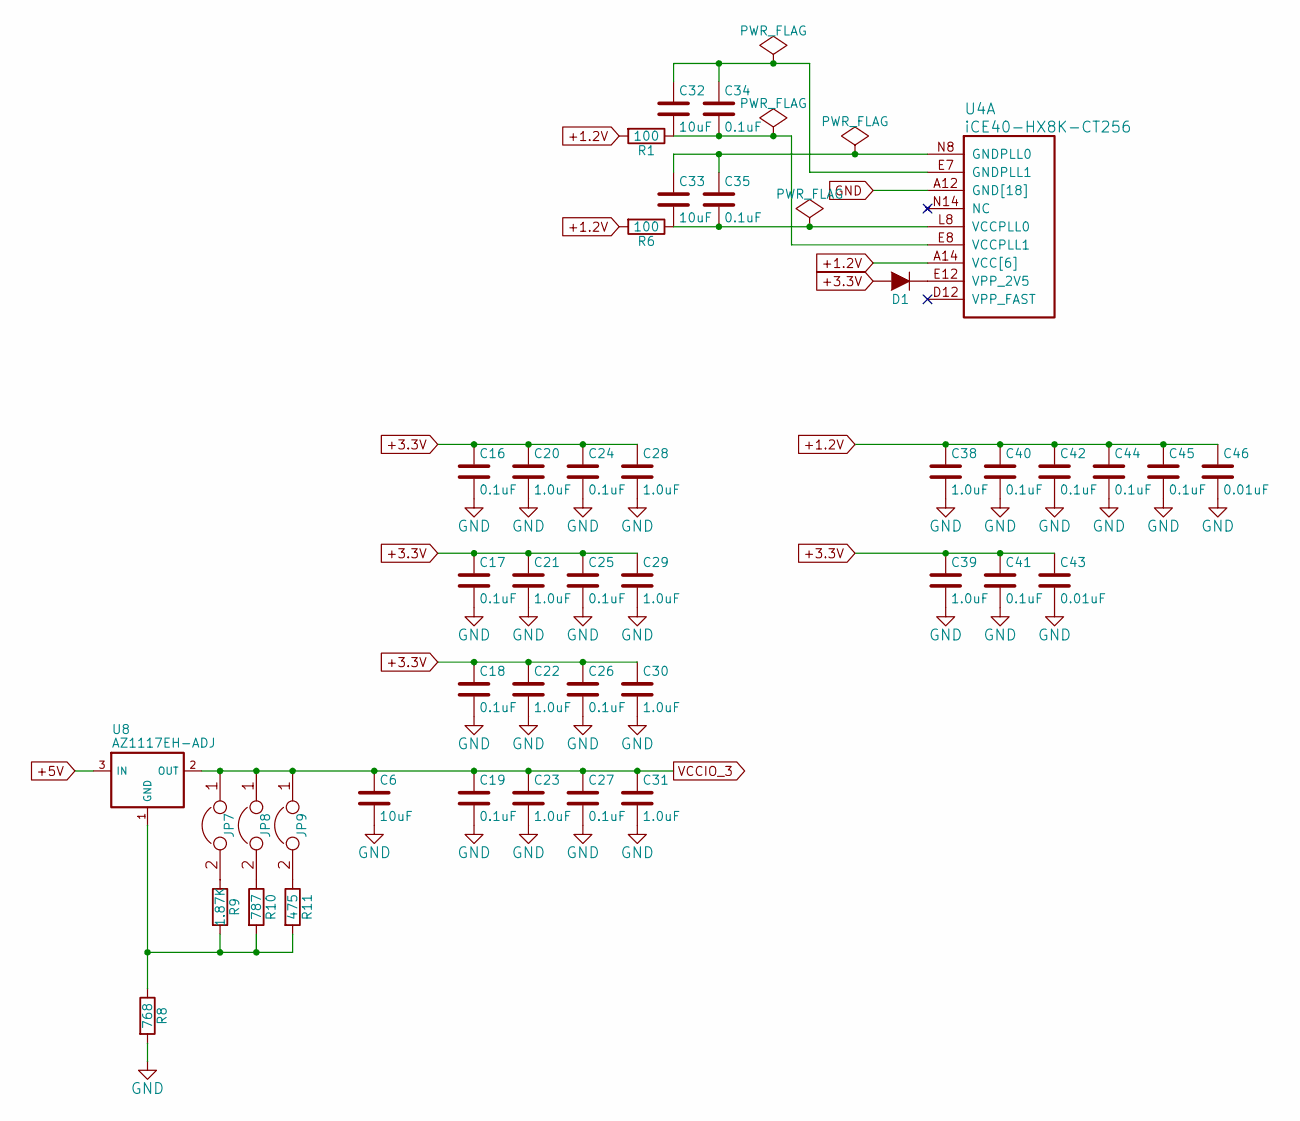
[picture p185: schematic FPGA_PWR.sch]

Parts:
C6, C32, C33: 10uF; C_0805
C16, C17, C18, C19, C24, C25, C26, C27, C34, C35, C40, C41, C42, C44, C45: 0.1uF; C_0603
C20, C21, C22, C23, C28, C29, C30, C31, C38, C39: 1.0uF; C_0603
C43, C46: 0.01uF; C_0603
D1: D; SOD-323
JP7, JP8, JP9: JUMPER; S_JUMPER_2
R1, R6: 100; R_0603
R8: 768; R_0603
R9: 1.87K; R_0603
R10: 787; R_0603
R11: 475; R_0603
U4: iCE40-HX8K-CT256; Lattice_caBGA_256
U8: AZ1117EH-ADJ; SOT-223

Connections:
+1.2V: C38.1, C40.1, C42.1, C44.1, C45.1, C46.1, R1.2, R6.2, U4.A14 (VCC[6]), U4.F6 (VCC[6]), U4.F10 (VCC[6]), U4.K6 (VCC[6]), U4.K10 (VCC[6]), U4.L2 (VCC[6])
+3.3V: C16.1, C17.1, C18.1, C20.1, C21.1, C22.1, C24.1, C25.1, C26.1, C28.1, C29.1, C30.1, C39.1, C41.1, C43.1, D1.2 (A)
+5V: U8.3 (IN)
GND: C6.2, C16.2, C17.2, C18.2, C19.2, C20.2, C21.2, C22.2, C23.2, C24.2, C25.2, C26.2, C27.2, C28.2, C29.2, C30.2, C31.2, C38.2, C39.2, C40.2, C41.2, C42.2, C43.2, C44.2, C45.2, C46.2, R8.2, U4.A4 (GND[18]), U4.A12 (GND[18]), U4.E15 (GND[18]), U4.G7 (GND[18]), U4.G8 (GND[18]), U4.G9 (GND[18]), U4.H7 (GND[18]), U4.H8 (GND[18]), U4.H9 (GND[18]), U4.J7 (GND[18]), U4.J8 (GND[18]), U4.J9 (GND[18]), U4.K2 (GND[18]), U4.K7 (GND[18]), U4.L15 (GND[18]), U4.R7 (GND[18]), U4.T4 (GND[18]), U4.T12 (GND[18])
unnamed: C32.1, C34.1, U4.E7 (GNDPLL1)
unnamed: C32.2, C34.2, R1.1, U4.E8 (VCCPLL1)
unnamed: C33.1, C35.1, U4.N8 (GNDPLL0)
unnamed: C33.2, C35.2, R6.1, U4.L8 (VCCPLL0)
unnamed: D1.1 (K), U4.E12 (VPP_2V5)
unnamed: JP7.2, R9.1
unnamed: JP8.2, R10.1
unnamed: JP9.2, R11.1
unnamed: R8.1, R9.2, R10.2, R11.2, U8.1 (GND)
VCCIO_3: C6.1, C19.1, C23.1, C27.1, C31.1, JP7.1, JP8.1, JP9.1, U8.2 (OUT), U8.4 (HS)
