Jonathon-Reilly/Kicad/kicad-resources/kicad-tools/KiField/tests/Memory.sch

## KiCad design kicad-resources/kicad-tools/KiField/tests/Memory.sch (2017-08-08)

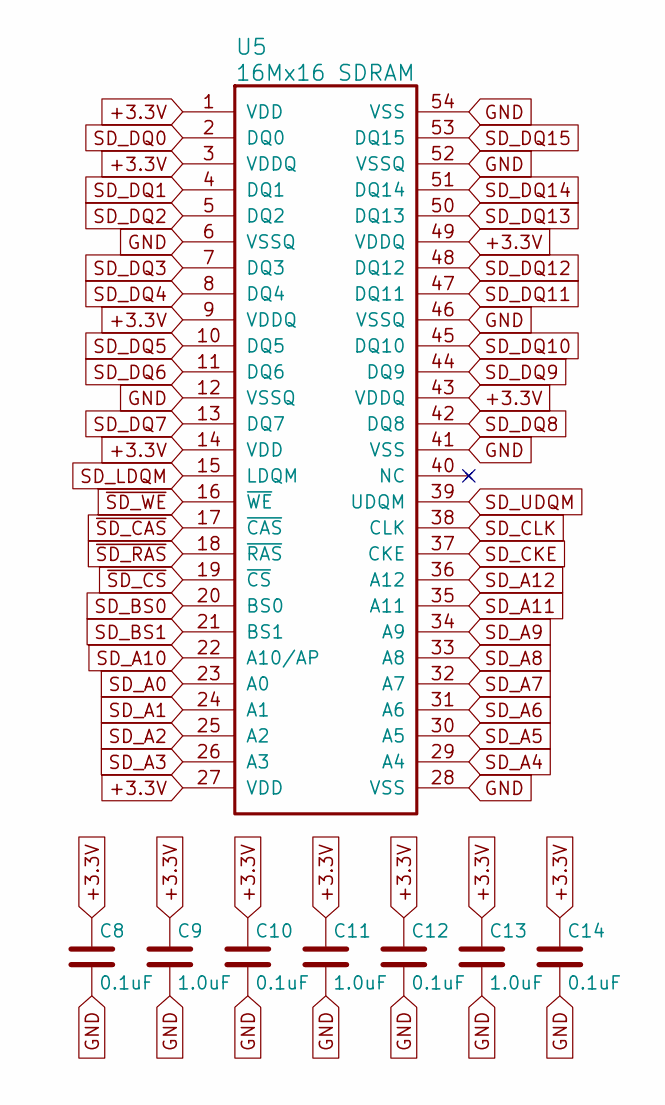
[picture p186: schematic Memory.sch]

Parts:
C8, C10, C12, C14: 0.1uF; C_0603
C9, C11, C13: 1.0uF; C_0603
U5: 16Mx16 SDRAM; TSOPII-54

Connections:
+3.3V: C8.1, C9.1, C10.1, C11.1, C12.1, C13.1, C14.1, U5.1 (VDD), U5.3 (VDDQ), U5.9 (VDDQ), U5.14 (VDD), U5.27 (VDD), U5.43 (VDDQ), U5.49 (VDDQ)
GND: C8.2, C9.2, C10.2, C11.2, C12.2, C13.2, C14.2, U5.6 (VSSQ), U5.12 (VSSQ), U5.28 (VSS), U5.41 (VSS), U5.46 (VSSQ), U5.52 (VSSQ), U5.54 (VSS)
SD_A0: U5.23 (A0)
SD_A1: U5.24 (A1)
SD_A2: U5.25 (A2)
SD_A3: U5.26 (A3)
SD_A4: U5.29 (A4)
SD_A5: U5.30 (A5)
SD_A6: U5.31 (A6)
SD_A7: U5.32 (A7)
SD_A8: U5.33 (A8)
SD_A9: U5.34 (A9)
SD_A10: U5.22 (A10/AP)
SD_A11: U5.35 (A11)
SD_A12: U5.36 (A12)
SD_BS0: U5.20 (BS0)
SD_BS1: U5.21 (BS1)
SD_CKE: U5.37 (CKE)
SD_CLK: U5.38 (CLK)
SD_DQ0: U5.2 (DQ0)
SD_DQ1: U5.4 (DQ1)
SD_DQ2: U5.5 (DQ2)
SD_DQ3: U5.7 (DQ3)
SD_DQ4: U5.8 (DQ4)
SD_DQ5: U5.10 (DQ5)
SD_DQ6: U5.11 (DQ6)
SD_DQ7: U5.13 (DQ7)
SD_DQ8: U5.42 (DQ8)
SD_DQ9: U5.44 (DQ9)
SD_DQ10: U5.45 (DQ10)
SD_DQ11: U5.47 (DQ11)
SD_DQ12: U5.48 (DQ12)
SD_DQ13: U5.50 (DQ13)
SD_DQ14: U5.51 (DQ14)
SD_DQ15: U5.53 (DQ15)
SD_LDQM: U5.15 (LDQM)
SD_UDQM: U5.39 (UDQM)
~SD_CAS: U5.17 (~CAS)
~SD_CS: U5.19 (~CS)
~SD_RAS: U5.18 (~RAS)
~SD_WE: U5.16 (~WE)
