Jonathon-Reilly/Kicad/(commit log)

2017-08-08 Erste dateiversionen
    [317Regler-BuildingBlock-ModE_RevC_19Apr2011.sch, 317Regler-BuildingBlock-ModF_RevC_19Apr2011.sch, 317Regler-BuildingBlock-ModG_RevC_19Apr2011.sch, 317Regler-BuildingBlock-ModH_RevC_19Apr2011.sch, 317Regulator-BuildingBlock-ModA_RevC_19Apr2011.sch, 317Regulator-BuildingBlock-ModB_RevC_19Apr2011.sch, 317Regulator-BuildingBlock-ModC_RevC_19Apr2011.sch, 317Regulator-BuildingBlock-ModD_RevC_19Apr2011.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]
2017-08-08 Removed confict. Added 20-pin header
    [Pixhawk_2-Cube.stp, Pixhawk_2_Cube.csv, Pixhawk_2_Cube.ods, Pixhawk_2_Cube_commented.ods]
2017-08-08 new 3D
    [1212-8-PowerPAK.stp, 1212-8-PowerPAK_wLABEL.stp, 1265.fcstd, 694106106102.step, Conn_HRSE-SH12-10P-0.5-BOT.stp, Conn_HRSE-SH12-11P-0.5-BOT.stp, Conn_HRSE-SH12-12P-0.5-BOT.stp, Conn_HRSE-SH12-13P-0.5-BOT.stp]
2017-08-09 updated 3D and footprints with Kicad repo. Modified standard Template
2017-08-09 corrected kicad-common for windows
2017-08-21 added Unit Tab to Pixhawk-2-Cube-commented
    [Pixhawk_2_Cube.ods, Pixhawk_2_Cube_commented.ods]
2017-08-23 created new footprint library Ideal_Diode_pcb
2017-09-06 corrected pin order in ideal diode footprint
2017-09-21 Added Temperature Sensor TC72
2017-09-27 Added .wrl 3D shape to the Pixhawk_2-Cube footprint
2017-10-05 Added monobloc pixhawk cube schematic
    Here are my add-on for the monobloc cube schematic :)
    Thank for your good work on the 3D model!
2017-10-05 Merged ADC
2017-10-13 Fixed Polarity of XT60 Connector
    [B02B-PAFYK-1A.STEP, B04B-PASK-1.STEP, B07B-PASK-1.STEP, XT60 Stecker.stp]
2017-10-18 push -jst-pa - add 3D part; built B07B, B09B -jst-zh - add B2B, B3B -sod-128 - add direction symbols -xt60 - change pads, add +&-
    [B03B-PASK-1.STEP, B06B-PASK-1.STEP, B08B-PASK-1.STEP, B09B-PASK-1.STEP, B10B-PASK-1.STEP, B2B-ZR-3.4.STEP, B3B-ZR-3.4.STEP]
2017-10-23 - 3D-Modell JST-GH-8 Connector - bearbeiteter Footprint von Jumper-Solder für Flächenanschluss - Footprint von Geekcreit DC-DC - Symbol Geekcreit DC-DC
    [BM08B-GHS-TBT.STEP]
2017-10-25 - neuer footprint piezo-buzzer SMD 9x9mm
2017-10-26 - update Geekcreit.kicad_mod footprint
2017-10-26 -update footprint
2017-10-27 - update footprint
2017-11-06 - erstellen footprint Mini DC-DC Converter Geekcreit (Mini MP1584EN)
2017-11-06 checked and fixed boss holes. Pixhwak 2 Cube
2017-11-21 Reduced Stencil Hole 3mm diameter to 3_125
2017-11-22 cloned Kicad action Plugin by MitjaNemec into Kicad tools
2017-11-23 rearrange the folder integration for the official kicad librarys
    [317Regler-BuildingBlock-ModE_RevC_19Apr2011.sch, 317Regler-BuildingBlock-ModF_RevC_19Apr2011.sch, 317Regler-BuildingBlock-ModG_RevC_19Apr2011.sch, 317Regler-BuildingBlock-ModH_RevC_19Apr2011.sch, 317Regulator-BuildingBlock-ModA_RevC_19Apr2011.sch, 317Regulator-BuildingBlock-ModB_RevC_19Apr2011.sch, 317Regulator-BuildingBlock-ModC_RevC_19Apr2011.sch, 317Regulator-BuildingBlock-ModD_RevC_19Apr2011.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]
2017-11-25 Added Ti driver, Infineon IRL Mosfet
2017-11-26 Added CSSK0612 shunt resistor footprint
2017-11-26 Modified Footprint of DirectFET
2018-02-13 Linked official Kicad repositorys and Digikey librarys with git submodule
2018-02-13 Included all submodules. Updated Windows include file kicad_common. Changed minor writing abnormalies.
2018-02-13 Typing fixes
    [1265.fcstd, 694106106102.step, B02B-PAFYK-1A.STEP, B03B-PASK-1.STEP, B04B-PASK-1.STEP, B06B-PASK-1.STEP, B07B-PASK-1.STEP, B08B-PASK-1.STEP]
2018-02-14 Added official templates via submodule. Added README.md for kicad-library folder. Created user specific templates folder
2018-02-14 Added varibale destinations for kicad_common.txt.
2018-02-22 -liegender SuperCap -Dual P-Channel Mosfet
2018-02-23 -mounting holes bigger
2018-02-26 -false footprint deletet Geekcreit.kicad_mod -modified right footprints/eigene/Power-IC.pretty/Mini_MP1584EN.kicad_mod
2018-02-26 -deleted false symbol Geekcreit from Power-IC-[JS].lib -inserted correct symbol Mini_MP1584EN to Power-IC-[JS].lib
2018-02-26 -created new library for mounting-holes-[MS].pretty/ -added footprint MountingHole_2.5mm_M2.5+washer_ISO4762_Pad.kicad_mod
2018-02-26 -added JST-PA 4-Pin side-entry step model
    [S04B-PASK-2.STEP]
2018-03-06 -Implementation 3D-Step Model LED_0805.stp, Switch.stp, SOD-128.step in web library
    [LED_0805.stp, SOD-128.step, Switch.stp]
2018-03-06 -New 3D-Step Modell JST-PA four Pin top entry in blue colour
    [B04B-PASK.STEP]
2018-03-06 Created footprint for Ideale Diode Gen II rev 00
    [Ideale_Diode_25V_rev-00.stp]
2018-03-06 -corrected 3D-Step Model of Ideale_Diode-GeII_rev00
    [Ideale_Diode_25V_rev-00.stp]
2018-03-09 -created new library Daughter-Boards_[MS].lib for Nucleo-F746ZG with arduino-style connector
2018-03-09 -created new symbol NUCLEO-F746ZG_DaughterBoard in Daughter-Boards_[MS].lib
2018-03-09 -created new footprint library Daughter-Boards_[MS].pretty
2018-03-09 -deleted false Nucleo-F746ZG footprint -added correct footprint NUCLEO-F746ZG_DaughterBoard.kicad_mod
2018-03-12 Updated sym-lib-table and fp-lib-table with latest footprints and symbols.
2018-03-12 -updated footprint and symbol from nucleo-f746zg
2018-03-12 -updated footprint NUCLEO-F746ZG_DaughterBoard.kicad_mod
2018-03-13 -added footprint to symbol
2018-03-27 added library connectors with TE Connectivity BNC THT straight and Shunt resistors with Vishay CSM series
    [c-5-1634503-1-d-3d.stp]
2018-03-31 Renamed the folder structure for the kicad librarys for more diversified between O_Shovas's collection and personal collections of other users. Also changed the Windows kicad_common.txt accordingly.
    [1212-8-PowerPAK.stp, 1212-8-PowerPAK_wLABEL.stp, 1265.fcstd, 694106106102.step, B02B-PAFYK-1A.STEP, B03B-PASK-1.STEP, B04B-PASK-1.STEP, B04B-PASK.STEP]
2018-04-01 Resorted the library contents to new folder stucture accordingly
    [1212-8-PowerPAK.stp, 1212-8-PowerPAK_wLABEL.stp, 1265.fcstd, 694106106102.step, B02B-PAFYK-1A.STEP, B03B-PASK-1.STEP, B04B-PASK-1.STEP, B04B-PASK.STEP]
2018-04-01 Filling new folders.
    [1212-8-PowerPAK.stp, 1212-8-PowerPAK_wLABEL.stp, 1265.fcstd, 694106106102.step, B02B-PAFYK-1A.STEP, B03B-PASK-1.STEP, B04B-PASK-1.STEP, B04B-PASK.STEP]
2018-04-01 Completed kicad_common file. Changed slashes.
2018-04-02 corrected Imported Footprints
2018-04-03 Changed kicad_common for new \\. Fixed errors in symbol librarys.
2018-04-03 Added parts to fp-lib-table and sym-lib-table . Corrected kicad_common.
2018-04-05 added Kicad_Git-library_install.bat script by Bernhard Zengele for manipulating the KiCad config files to include the git branch librarys
2018-04-05 Applied fix for Kicad_Git-library_install.bat script.
2018-04-06 added bugfix for trailing wihtespaces Kicad_Git-library_install.bat
2018-04-18 Added ST33x and similar sensors into Sensor-IC-[JS].lib.
2018-06-18 -added led, schottky and zener symbol to Diodes-[JS]
2018-06-18 -add ACS722LLCTR-40AU-T Current Hall Sensor to Sensor-IC-[JS]
2018-07-24 added voltage translator and TPS7A90 Symbol
2018-07-31 -new footprint Potentiometer Bourns 3312 J
2018-07-31 -new symbol TMC2130-LA in Power-IC
2018-08-02 -added new Footprint SOD-123W in General_smd-[JS]
2018-08-02 -footprint StepStick in functional Groups
2018-08-02 -edited footprints with bigger GND-(Thermal-)Pad; and CoolingPad for external Radiator
2018-08-03 -new symbol Pololu DRV8801 in devices_[JS]
2018-08-03 -new footprint Pololu DRV8801 in Daughter-Boards_[MS]
2018-08-03 -updated footprint NUCLEO-F746ZG_DaughterBoard
2018-08-03 -new footprint Pololu_DRV8801_inv in devices_[JS]
2018-08-03 -add new footprint JST-PA-02_Top-entry-type in JST_PA.pretty
2018-08-06 - added new footprint and symbol of D24VxAxx-Series DC-DC
2018-08-09 -add new footprint JST-PA 05 top entry -updated footprint with radiatorpad -updated symbols pins
2018-08-10 -add new Fan Axial 25x10mm footprint -updated NUCLEO-F746ZG footprint
2018-08-22 -footprint update
2018-09-05 Added THT Pad for mounting 4mm Bueschelstecker through a PCB
2018-09-05 Corrected link to stp. model for BNC_THT_straight_TE-5-1634503-1.kicad_mod. Added 4mm_Gold-Bueschelbuchse_THT.kicad_mod
2018-09-12 -rotated radiator-pad at TQFP footprint -corrected NUCLEO-F746ZG_DaughterBoard footprint
2018-09-25 modified SMB-THT socket for better fitting an smaller size
2018-09-25 updated linux kicad_common and other configuration files to the new folder structure. Removed erronous audio.dcm entrys
