Jonathon-Reilly/Kicad/(notices)

Notices in the files:
kicad-resources/kicad-librarys/thirdparty-3D/web/3D-shapes/Conn_JST-PH-xP-2.0-TOPandSIDE/Conn_PH-2.0_13P_TOP.stp:
Copyright (C) 2016, Joan The Spark
This program is free software: you can redistribute it and/or modify
it under the terms of the GNU General Public License as published by
the Free Software Foundation, either version 3 of the License, or
any later version.
kicad-resources/kicad-librarys/thirdparty-3D/web/3D-shapes/SMD_Devices/MELF.stp:
Copyright (C) 2015, Joan The Spark
kicad-resources/kicad-tools/KiField/tests/FPGA.sch:
CC BY 4.0
kicad-resources/kicad-tools/eagle-to-kicad/examples/PIXHAWK/kicad_files/PX4FMUv2.4.kicad_pcb:
(c) 2013 mjs/lm/jo
